pierrotto12138-code/balance-car-inspection-robot/hardware/eda_export_20261016/README.md

# EDA 制造 / 交付数据（2026-10-16 一次性导出）—— 角色 A1

> **来源**：嘉立创EDA 专业版（工程 `26测控系统设计`，板 `改` = `Schematic2` + `PCB2`）在 **2026-10-16 16:36–16:41**
> 一次性导出的一整套文件，**入档时逐个核对哈希**。
> ⚠️ **本目录是"脱敏版"**：凡含**组员姓名**的文字/图形都已处理（打码 / 删除文本实体 / 等长替换），见 §四；
> **未脱敏原件**在仓库外 `…\260921Task_私有资料\作业补充\A1\_未脱敏原件\`（提交作业用）。
> **与 [`../gerber/`](../gerber/) 的关系**：那里放**下单用的那份 Gerber**（脱敏）；本目录是"同一设计再导出的一整套标准交付/制造格式"，
> 重点是**给人看/给别的角色用**的那几种（PDF/PNG、STEP、DXF、iBOM、坐标、BOM）。

---

## 一、文件清单与"谁能用得上"

| 文件 | 是什么 | **谁能用** | 关键点 |
|---|---|---|---|
| [`Info_PCB_PCB2_2026-10-16.txt`](Info_PCB_PCB2_2026-10-16.txt) | **EDA 自己出的板信息报告** | **A1/A2/评阅** | ★ **"板子尺寸: 100mm x 65mm"** —— 板框口径的**第 5 路独立证据**；另含元件 52、焊盘 221（表贴 106/金属化孔 115）、网络 65（未布线 0）、过孔 76、铺铜 2、导线总长 2035.9 mm |
| [`SCH_Schematic2_2026-10-16.pdf`](SCH_Schematic2_2026-10-16.pdf)（265 KB） | ★ **原理图出图（PDF，矢量）** | **A1 交付 / 报告 / 答辩 / B 核对网络** | **任务书要的"电路原理图"的可读版**（此前只有 EDA 二进制 `.esch2`）。标题栏：原理图 `Schematic2` / 板子 `改` / 创建 2026-10-07 / 更新 2026-10-16；**绘制/审阅栏为空 = 无个人信息**（已核）|
| [`SCH_Schematic2_1-P1_2026-10-16.png`](SCH_Schematic2_1-P1_2026-10-16.png)（773 KB）、[`SCH_Schematic2_1-P1_2026-10-16.svg`](SCH_Schematic2_1-P1_2026-10-16.svg)（427 KB） | ★ **同一页原理图的位图 / 矢量图** | 报告插图（矢量图放大不糊）| 导出源是 `Schematic2_1`（`Schematic2` 的工作副本，**同一块"改"板**；标题栏亦写 `Schematic2`）；**无个人信息**（已核）。若要严格"出图源 = `Schematic2`"，可让 A1 再导一次覆盖 |
| [`PCB_PCB2_2026-10-16_脱敏.png`](PCB_PCB2_2026-10-16_脱敏.png)、[`PCB_PCB2_2026-10-16_脱敏.pdf`](PCB_PCB2_2026-10-16_脱敏.pdf) | **PCB 出图**（图片 / 图片型 PDF） | **A1 交付 / 报告插图 / A2 参考** | 人可读、不必装 EDA；★ **丝印文字块已打码**（姓名不可见）。PDF 由打码后的 PNG 生成（原矢量 PDF 在仓库外）|
| [`Gerber_PCB2_2026-10-16.zip`](Gerber_PCB2_2026-10-16.zip) | Gerber（本次导出） | A1 / 制板复现 | 与 [`../gerber/26测控系统设计_PCB2_20261008_170436.zip`](../gerber/26测控系统设计_PCB2_20261008_170436.zip) 同源；**下单用的是 10-08 那份**；★ 本次导出的 GTO 同样已脱敏 |
| [`FlyingProbeTesting_PCB2_2026-10-16.zip`](FlyingProbeTesting_PCB2_2026-10-16.zip) | 飞针测试点数据 | A1 / 制板 | 嘉立创可据此做飞针测试 |
| [`IPC_PCB2_26测控系统设计_2026-10-16.356a`](IPC_PCB2_26测控系统设计_2026-10-16.356a) | **IPC-356A 网表**（电气测试用） | A1 / 制板 | 与飞针配套的"该通/该断"清单 |
| [`Netlist_PCB2_2026-10-16.tel`](Netlist_PCB2_2026-10-16.tel) | 网表 | **B（核对引脚/网络）**、A1 | 与 [`../../docs/design_hardware/pin_assignment.md`](../../docs/design_hardware/pin_assignment.md) 可三方互证（源码 / PCB `PAD_NET` / 本网表）|
| [`BOM_改_PCB2_2026-10-16.xlsx`](BOM_改_PCB2_2026-10-16.xlsx) | EDA 导出的 BOM | **A1**、采购 | 与 [`BOM表.md`](../../docs/design_hardware/BOM表.md)（脚本离线导出）**互为独立实现** ⇒ 两者一致才敢下单 |
| [`PickAndPlace_PCB2_2026_10_16.xlsx`](PickAndPlace_PCB2_2026_10_16.xlsx) | **贴片坐标**（位号 + X/Y + 层 + 旋转）| A1 / 若将来上 SMT | 本板手焊（`isMadeSmt=false`），此件属留档 |
| [`TestPoint_PCB2_2026-10-16.xlsx`](TestPoint_PCB2_2026-10-16.xlsx) | 测试点表 | A1 | 与 `Info_*.txt` 里"测试点覆盖率 0%"对应（本板未专门放测试点）|
| [`InteractiveBOM_PCB2_2026-10-16.html`](InteractiveBOM_PCB2_2026-10-16.html) | **交互式 BOM**（网页版，点击位号高亮位置）| **A1 焊接 / A2 装配 / 排故** | ★ 手焊与查错时最顺手：浏览器打开即可"按图找件"（12 MB，内嵌器件图与封装图形；**不含丝印文字**，已核对）|
| [`DXF_PCB2_2026-10-16_AutoCAD2007.dxf`](DXF_PCB2_2026-10-16_AutoCAD2007.dxf) | **2D 外形/结构 DXF** | **A2（结构）** | ★ 做**装配图 / 外壳开孔**的二维输入：板框 100 × 65、R5 圆角、3 个 ⌀3.2 安装孔可直接量；★ **含姓名的 TEXT 实体已删除**，几何完整 |
| [`3D_PCB2_2026-10-16.step`](3D_PCB2_2026-10-16.step) | **3D STEP 模型**（整板 3D）| **A2（结构）** | ★ A2 做**外壳 / 干涉检查 / 效果图**的三维输入（31 MB，`Designed by EasyEDA Pro`，Open CASCADE / AP214；**不含丝印文字**，已核对）|
| [`ProPrj_26测控系统设计_2026-10-16.epro2`](ProPrj_26测控系统设计_2026-10-16.epro2) | **立创EDA 工程导出包**（可再导入）| A1 / 交作业 | 一个文件即可在另一台机器导入整个工程（内含 `26测控系统设计.epru`）；★ 工程内文字对象里的姓名已**等长替换**为"组员/组员甲/乙/丙" |

> **仓库外的同批文件**（按 §四 策略移出，**不要**拷进公开仓库）：
> `嘉立创生产稿_8942344A_Y2_未脱敏.zip`、`odb++_pcb_2026-10-16_未脱敏.tgz`、`PCB_PCB2_2026-10-16_未脱敏.pdf`，
> 以及含姓名/电话/地址的 `立创商城下单.png`、`送货单-1.pdf`、`送货单-2.pdf`、`立创商城订单详情-SO26101014446.xls`。
> 位置：`…\260921Task_私有资料\作业补充\A1\`（脱敏前后对照的同名 `_未脱敏*` 件在 `…\A1\_未脱敏原件\`）；
> 其中**非个人信息**的部分已摘录进 [`../bom/采购记录_立创商城_SO26101014446.md`](../bom/采购记录_立创商城_SO26101014446.md)。

> **原理图导出已补齐（2026-10-16 17:07 追加）**：`SCH_Schematic2_*.pdf` / `.png` / `.svg` —— 三件都在本目录，
> 均**不含个人信息**（标题栏"绘制/审阅"为空，已逐件核对）。至此"任务书 §二 A1：电路原理图"既有 EDA 工程源文件、
> 也有**人可读出图**。

---

## 二、这批导出对其它角色的意义（一句话备注）

| 角色 | 直接可用的文件 | 拿来做什么 |
|---|---|---|
| **A2 结构** | **`3D_*.step`** + **`DXF_*.dxf`** + `Info_*.txt` | 外壳建模、装配图、开孔（板框 100 × 65 / R5 / 3×⌀3.2 孔都能直接量）、干涉检查 |
| **B 固件** | `Netlist_*.tel`、`BOM_*.xlsx`、`IPC_*.356a` | 核对引脚与网络（与源码/`pin_check.py` 互证）、确认板上有哪些器件 |
| **C 上位机** | `PCB_*_脱敏.png`（界面/文档配图）、`BOM_*.xlsx` | 报告配图、器件清单引用 |
| **全组** | `InteractiveBOM_*.html`、`PCB_*_脱敏.pdf` | 排故、答辩讲解、交作业的可读附件 |

---

## 三、取材与溯源

| 项 | 位置 |
|---|---|
| 本目录 13 个脱敏件 | `hardware\eda_export_20261016\` |
| 未脱敏原件（提交作业用） | `…\260921Task_私有资料\作业补充\A1\_未脱敏原件\`（含生产稿、ODB++、矢量 PDF、未打码图、未脱敏 DXF/epro2 等）|
| 设计源头（EDA 工程） | `%USERPROFILE%\Documents\LCEDA-Pro\projects\26测控系统设计\`（另有 `参考01_copy` 工作工程）|
| 本地快照（被 gitignore） | [`../硬件工程_完工版_20261008_最终/`](../硬件工程_完工版_20261008_最终/) |
| 下单 Gerber 与工艺参数 | [`../gerber/`](../gerber/)（含 **1.6 mm / 1 oz / 有铅喷锡**）|
| 焊接与测试记录 | [`../../docs/design_hardware/上板测试记录.md`](../../docs/design_hardware/上板测试记录.md)、[`../test_records/`](../test_records/) |

---

## 四、★ 隐私处理（**脱敏双份**策略）

**策略**（用户 2026-10-16 明确）：**凡含组员个人信息的交付物，一律两份 —— 仓库放"脱敏版"，仓库外放"原件"（提交作业用）**。
本目录各件的处理方式与验证手段：

| 脱敏件 | 处理方式 | 验证 | 未脱敏原件 |
|---|---|---|---|
| `PCB_PCB2_2026-10-16_脱敏.png` | 丝印文字块**马赛克**（区域 (205,1255)-(715,1435)，块 34 px）| 目视复核（姓名不可读）| `_未打码原图\PCB_PCB2_2026-10-16_未打码.png` |
| `PCB_PCB2_2026-10-16_脱敏.pdf` | 由**已打码 PNG** 生成图片型 PDF（A4 横向）| 用 LibreOffice/pdfium 渲染回图片目视复核 | `_未脱敏原件\PCB_PCB2_2026-10-16_未脱敏.pdf` |
| `Gerber_PCB2_2026-10-16.zip` | GTO 丝印层移除姓名文字块笔画（4523 点）| **逐行比对**：非姓名行 2732 行完全一致 + bbox 内剩余点 = 0 | `_未脱敏原件\Gerber_PCB2_2026-10-16_未脱敏.zip` |
| `DXF_PCB2_2026-10-16_AutoCAD2007.dxf` | 删除含姓名的 `TEXT` 实体（1 个，其余几何全保留）| 全文再搜姓名为 0 命中 | `_未脱敏原件\DXF_…_未脱敏.dxf` |
| `ProPrj_26测控系统设计_2026-10-16.epro2` | 工程内姓名**等字节长度**替换为"组员/组员甲/乙/丙"（8 处）| zip 完整性 ok + `.epru` 字节数不变（2345729 B）+ 姓名 0 命中 | `_未脱敏原件\ProPrj_…_未脱敏.epro2` |
| `InteractiveBOM_*.html`、`3D_*.step`、`Netlist_*.tel`、`IPC_*.356a`、`FlyingProbeTesting_*.zip`、`BOM_*.xlsx`、`PickAndPlace_*.xlsx`、`TestPoint_*.xlsx`、`Info_*.txt` | **无需处理** | 多编码（UTF-8/GBK/UTF-16）全文检索姓名 **0 命中** | —（同一文件，无未脱敏版本）|
| **不在本目录**：`odb++_pcb_2026-10-16.tgz` | 内含丝印几何、**未脱敏** ⇒ 整体留仓库外（与 Gerber 同数据的另一格式）| — | `_未脱敏原件\odb++_pcb_2026-10-16_未脱敏.tgz` |

> **原件哈希、以及另一个目录（`hardware/gerber/`）里同类处理的完整清单**，统一记在
> [`../gerber/README.md`](../gerber/README.md) §八（含 SHA-256 前 16 位，便于"这份脱敏件对应哪个原件"对账）。

---

> **项目归属**：中国石油大学（华东） 专业生产实习课程项目<br>
> **范围说明**：本项目不涉及 MiniBalance 控制板（STM32F405RGT6 版本）的硬件设计与改版；控制板直接沿用，A1 仅重做主底板。<br>
> **许可**：原创代码与文档采用 MIT License；第三方组件遵循各自原始许可证。
