pierrotto12138-code/balance-car-inspection-robot/hardware/gerber/README.md

# Gerber / 制造数据（主底板「改」板）—— 角色 A1 交付物

> **对象**：MiniBalance V5.0 平衡小车**重做的底板**（EDA 里的板「改」= `Schematic2` + `PCB2`）
> **为什么在这里**：任务书 §二 要求 A1 提交"电路原理图、PCB 设计文件"，项目计划书另列 **Gerber**；
> 本目录把**下单用的那份**留档进仓库，避免"只存在于打样网站账号里"。
> ⚠️ **本目录放的是"脱敏版"**：丝印层里含**组员姓名**的笔画已被移除（见 §八）。
> **提交作业用的未脱敏原件**在仓库外 `…\260921Task_私有资料\作业补充\A1\_未脱敏原件\`。

---

## 一、文件

| 文件 | 出处 | 内容 | 用途 |
|---|---|---|---|
| [`26测控系统设计_PCB2_20261008_170436.zip`](26测控系统设计_PCB2_20261008_170436.zip)（**脱敏版**，141 KB） | **嘉立创EDA 专业版"一键导出 Gerber"**（导出时间 2026-10-08 17:04:35，工程名 `26测控系统设计`） | 14 项：9 个 Gerber 层（GTL/GBL/GTO/GBO/GTS/GBS/GTP/GKO/GDL/GDD）+ 2 个钻孔档 + **飞针测试点 `FlyingProbeTesting.json`** + `PCB下单必读.txt` | **★ 这是下单用的那一份**（与嘉立创工程档里的 `pcbFileName` 同名同源）；交作业的"Gerber"即此件 |

> **本目录不含"嘉立创生产稿"**：那份 9.4 MB 的生产包（`ok/` + `YG/4te.json`）里的丝印层同样含组员姓名，
> 且其内部还有 `.tgz`/`.ddw` 套封，**无法可靠脱敏** ⇒ 按隐私策略**整体留在仓库外**（原件与哈希见 §八）。
> 它提供的信息（**工艺参数**、生产口径钻孔对照）已逐项摘录到本文件 §三/§五，**结论不受影响**。

---

## 二、下单信息（可核对）

| 项 | 值 | 出处 |
|---|---|---|
| 工程/订单号 | **`8942344A_Y2`**（板上丝印亦为 `8942344A_Y2_261008`） | 生产包 `YG/4te.json` 的 `po`；实物丝印 |
| 下单时间 | **2026-10-08 17:28**（北京时间） | `4te.json` 的 `accountDate` |
| 交付时间 | **2026-10-10 20:00**（北京时间） | `achieveTime` |
| 制板费 | **¥53.00**（5 片，非 SMT 贴片） | `paiclMoney`、`isMadeSmt=false` |
| 软件/文件来源 | `softwareType = EasyEDA`，`pcbFileName = 26测控系统设计_PCB2_20261008_170436` | 同上 —— 与 §一 的 zip **同名同源** |
| 订单备注 | "本单 EasyEDA 设计，外形用 GKO 处理；元器件移植全额赔付" | `orderRemark` |
| 元件采购单 | 立创商城 **`SO26101014446`**（2026-10-10，17 项，商品 ¥71.07 + 运费 ¥17.00） | 见 [`../bom/采购记录_立创商城_SO26101014446.md`](../bom/采购记录_立创商城_SO26101014446.md) |

---

## 三、工艺参数（**权威出处：生产包 `YG/4te.json`，原件在仓库外**）

| 项 | 值 | 字段 |
|---|---|---|
| 板材 | **FR-4** | `board_type` |
| 层数 | **2 层** | `layers` |
| **成品板厚** | **1.6 mm** | `thickness` |
| **铜厚** | **1 oz**（内层 1.0 / 外层 1.0） | `cu_inner` / `cu_outer` |
| **表面处理** | **有铅喷锡**（HASL，有铅） | `finished` |
| 阻焊颜色 | **绿色** | `color_sm` |
| 丝印颜色 | **白色** | `color_ss` |
| 过孔处理 | **过孔盖油** | `via` |
| 板框尺寸（下单） | **10.0 × 6.5 cm** = **100 × 65 mm** | `size_x` / `size_y` |
| 拼版/阻抗/盲埋孔等 | 均未启用（`layeredFlag=false`、`blindViaHoleFlag=0`、`camImpedanceList=[]`） | 同上 |

> ★ 这三项（**板厚 1.6 mm、铜厚 1 oz、有铅喷锡**）此前在 [`../../docs/design_hardware/电路设计说明文档.md`](../../docs/design_hardware/电路设计说明文档.md) §10.1 是 `[待补]`，**现由本档闭合**。
> ⚠️ 表面处理是**有铅**喷锡（不是无铅）—— 报告与 BOM 表述按此写。

---

## 四、层清单（脱敏后的 zip）

| 文件 | 层 | 备注 |
|---|---|---|
| `Gerber_TopLayer.GTL` | 顶层线路 | |
| `Gerber_BottomLayer.GBL` | 底层线路 | |
| `Gerber_TopSilkscreenLayer.GTO` | 顶层丝印 | ★ **已脱敏**：移除了含组员姓名的文字块笔画（该块共 4523 个坐标点；其余 2730 行逐行核对与原件**完全一致**）|
| `Gerber_BottomSilkscreenLayer.GBO` | 底层丝印 | 空层（0 个坐标点）|
| `Gerber_TopSolderMaskLayer.GTS` | 顶层阻焊 | |
| `Gerber_BottomSolderMaskLayer.GBS` | 底层阻焊 | |
| `Gerber_TopPasteMaskLayer.GTP` | 顶层钢网 | 本板全手焊，仅作留档 |
| `Gerber_BoardOutlineLayer.GKO` | **板框外形** | 100 × 65 mm、四角 R5、3 个 ⌀3.2 安装孔（见 §五）|
| `Gerber_DocumentLayer.GDL` | 文档层 | 250 个坐标点，均不在姓名块内（未改动）|
| `Gerber_DrillDrawingLayer.GDD` | 钻孔图 | 钻孔标注图（非钻孔数据本身）|
| `Drill_PTH_Through.DRL` | **金属化孔（元件孔）** | 110 个元件孔（⌀0.9×14、⌀1.02×12、⌀1.1×84）|
| `Drill_PTH_Through_Via.DRL` | **过孔** | **76 个过孔**（⌀0.305×53、⌀0.508×23）|
| `FlyingProbeTesting.json` | 飞针测试点 | 嘉立创可据它做飞针测试 |
| `PCB下单必读.txt` | 说明 | EDA 自带的下单指引链接 |

---

## 五、可复核的几何数据（**独立解析本目录的 Gerber**，与 EDA 快照、嘉立创档多方一致）

| 项 | 结论 | 证据 |
|---|---|---|
| **板框** | **100.00 × 65.00 mm**（x ∈ [−6.000, 94.000]、y ∈ [−58.908, 6.092] mm，即 EDA 内部 mil 坐标 x ∈ [−236.22, 3700.79]、y ∈ [−2319.20, 239.85]）| ① `Gerber_BoardOutlineLayer.GKO` 外形坐标极值；② EDA 快照 `PCB2.epcb2` 的 `BOARD_OUTLINE` 路径极值；③ **嘉立创生产档 `ko`** + 下单尺寸 10.0 × 6.5 cm；④ **EDA 官方板信息报告**"板子尺寸: 100mm x 65mm"（[`../eda_export_20261016/Info_PCB_PCB2_2026-10-16.txt`](../eda_export_20261016/Info_PCB_PCB2_2026-10-16.txt)）|
| **四角圆角** | **R5.0 mm** | ① `GKO` 四段圆弧（radius 196.85 mil = 5.0 mm）；② 嘉立创 `ko` 的圆弧 `I/J = 196850`（10⁻⁶ 英寸 ⇒ 5.0 mm）|
| **安装孔** | **3 个 ⌀3.2 mm**（`BOARD_OUTLINE` 圆形图元，半径 62.9921 mil = 1.6 mm）<br>孔心（以板左下角为原点）：**(6.0, 6.1)、(94.0, 6.1)、(6.0, 58.9) mm** —— 即四角布局中**右上角无孔** | ① EDA 快照的 3 条 `path:["CIRCLE",…,62.9921]`；② `GKO` 的 Circle 段 3 个圆；③ 嘉立创钻孔档 ⌀3.25 mm × 3 孔，坐标 (94.0, 6.1) / (6.0, 6.1) / (6.0, 58.91)；④ PCB 渲染图逐孔核对 |
| 元件孔 / 过孔 | 110 个元件孔 + 76 个过孔（孔壁金属化） | `Drill_PTH_Through*.DRL` 逐刀具计数 |
| 走线 / 过孔 / 铺铜 | 523 走线段 / 76 过孔 / 双面实心 GND 铺铜 | 与完工快照的既有核验一致（[`../../docs/design_hardware/电路设计说明文档.md`](../../docs/design_hardware/电路设计说明文档.md) §10.2/§10.3）|

> ⚠️ **与旧文档的口径冲突（已更正）**：`电路设计说明文档` §10.1 与 `交接说明` §3.5 曾写"**100 × 60 mm、圆角 R2.5、4 个 ⌀1.6 mm 安装孔**"，
> 三处口径全错：尺寸把 y 跨度 65 读成 60、圆角把"圆形图元线宽 9.8425 mil"当成了弧半径、
> 孔径把 `path:["CIRCLE",x,y,**r**]` 的**半径** 62.9921 mil 当成了**直径**（1.6 mm 是半径 ⇒ ⌀3.2 mm），
> 孔数则把 4 条 `BOARD_OUTLINE` 记录（3 圆 + 1 个圆角矩形路径）数成了 4 个孔。
> 详见 [`../../docs/决策记录.md`](../../docs/决策记录.md) 决策 81 与 [`../../docs/design_hardware/上板测试记录.md`](../../docs/design_hardware/上板测试记录.md)。

### 嘉立创生产口径 vs EDA 设计口径（钻孔）

| 孔径 | EDA 导出（设计口径，**即本目录**） | 嘉立创 `ok/drl`（生产口径，原件在仓库外）|
|---|---|---|
| 过孔 | ⌀0.305 ×53、⌀0.508 ×23 = **76** | ⌀0.300 ×53、⌀0.500 ×23 |
| 元件孔 | ⌀0.900 ×14、⌀1.020 ×12、⌀1.100 ×84 = **110** | ⌀1.050 ×14、⌀1.150 ×12、⌀1.250 ×84 |
| 安装孔 | **⌀3.200 ×3**（画在外形层，走铣槽） | **⌀3.250 ×3** |
| 其它 | — | 还有**设计档里不存在**的 ⌀0.953 / ⌀1.451 / ⌀2.203 / ⌀2.651 等孔或铣槽（其文件大量使用**模态坐标**，逐孔用途未核对）——**判断"设计要几个孔"时只看 EDA 那份** |

> ⇒ **报孔径时用 EDA 设计口径**（本板元件孔径 0.9/1.02/1.1 mm），生产档的孔径是嘉立创归并到自家标准刀具后的结果。

---

## 六、怎么复现 / 重新导出

| 场景 | 做法 |
|---|---|
| 从 EDA 重新出 Gerber | 打开工程（`…\LCEDA-Pro\projects\26测控系统设计\`）→ 一键导出 Gerber，导出前**必须 `Ctrl+S`**（见 `AGENTS.md` 铁律 1/2）|
| 只想复核几何/网络，不装 EDA | 直接解析本目录的 zip（Gerber 是纯文本）；或解析完工快照 `hardware/硬件工程_完工版_20261008_最终/`（脚本见 [`../../tools/README.md`](../../tools/README.md)）|
| 核对板框/安装孔 | 解析 `Gerber_BoardOutlineLayer.GKO`：外形路径 + `Circle Start/End` 段的 3 个圆 |
| 核对钻孔 | 数 `Drill_PTH_Through.DRL` / `Drill_PTH_Through_Via.DRL` 的刀具表与命中数 |
| 再下一单 | 上传本目录的 zip（嘉立创支持 EDA 导出包），工艺按 §二/§三 选 —— ⚠️ 打出来的板**丝印上不会有组员姓名**（脱敏所致）；要带姓名的版本用 §八 的未脱敏原件 |
| 要"带姓名的完整原件" | 用仓库外 `…\260921Task_私有资料\作业补充\A1\_未脱敏原件\` 里的同名 `…_未脱敏.zip`（提交作业用）|

---

## 七、取材与溯源

| 项目 | 位置 |
|---|---|
| 本目录的脱敏 Gerber | `26测控系统设计_PCB2_20261008_170436.zip` —— **脱敏后 SHA-256 前 16 位 `19DA618BEDEE7DE5`**（原始件 `83352D2AF71EE3D0`，见 §八）|
| 未脱敏原件（提交作业用） | `…\260921Task_私有资料\作业补充\A1\_未脱敏原件\26测控系统设计_PCB2_20261008_170436_未脱敏.zip` |
| EDA 完工快照（设计源头） | [`../硬件工程_完工版_20261008_最终/`](../硬件工程_完工版_20261008_最终/)（`.eprj3` + `Schematic2` + `PCB2`，**被 gitignore，只在本机**）|
| 独立工程副本（交作业用） | `%USERPROFILE%\Documents\LCEDA-Pro\projects\26测控系统设计\` |
| 全套制造/交付导出（同日） | [`../eda_export_20261016/`](../eda_export_20261016/README.md) |
| 焊接与测试记录 | [`../../docs/design_hardware/上板测试记录.md`](../../docs/design_hardware/上板测试记录.md) |
| BOM 与采购记录 | [`../../docs/design_hardware/BOM表.md`](../../docs/design_hardware/BOM表.md)、[`../bom/采购记录_立创商城_SO26101014446.md`](../bom/采购记录_立创商城_SO26101014446.md) |

---

## 八、★ 隐私处理（**脱敏双份**策略，2026-10-16 定）

**策略**（用户 2026-10-16 明确）：**凡含组员个人信息的交付物，一律两份 ——
仓库里放"脱敏版"（供公开与协作），仓库外的 `260921Task_私有资料\作业补充\A1\_未脱敏原件\` 放"原件"（供提交作业）**。

| 仓库内的脱敏件 | 处理方式 | 未脱敏原件（仓库外） | 原件 SHA-256 前 16 位 |
|---|---|---|---|
| `26测控系统设计_PCB2_20261008_170436.zip` | GTO 丝印层**移除姓名文字块笔画**（4523 点），其余 2730 行逐行与原件一致 | `26测控系统设计_PCB2_20261008_170436_未脱敏.zip` | `83352D2AF71EE3D0` |
| [`../eda_export_20261016/Gerber_PCB2_2026-10-16.zip`](../eda_export_20261016/Gerber_PCB2_2026-10-16.zip) | 同上（该次导出同样处理） | `Gerber_PCB2_2026-10-16_未脱敏.zip` | `E15DDB03F4A28005` |
| （本目录不含）嘉立创生产稿 | **不可靠脱敏**（内含 `.tgz`/`.ddw` 套封）⇒ **整体留仓库外**；工艺参数已摘录进 §三 | `嘉立创生产稿_8942344A_Y2_未脱敏.zip` | `C0872833D86AFF16` |
| `…\hardware\photos\新版底板_*.jpg` | 丝印文字块**打码**（各图打码区坐标见 [`../photos/README.md`](../photos/README.md)）| `新版上车正面/俯视/背面.jpg`、`新版焊接重点处.jpg` | 见该 README |
| `…\docs\design_hardware\图\PCB2_最终.png`、`…\eda_export_20261016\PCB_PCB2_2026-10-16_脱敏.png` | 丝印文字块**打码**（马赛克） | `PCB2_最终_未打码.png`（`6E449B39D6D20F7F`）、`PCB_PCB2_2026-10-16_未打码.png`（`A969229ADED59987`）| 仓库内脱敏件：`64691358E7A4BCD6` / `A46FFADEC7EF0C29` |
| `…\eda_export_20261016\DXF_*.dxf` | **删除**含姓名的 `TEXT` 实体（保留全部几何）| `DXF_PCB2_2026-10-16_AutoCAD2007_未脱敏.dxf` | `C1077CEF1C4AB20C` |
| `…\eda_export_20261016\PCB_PCB2_2026-10-16_脱敏.pdf` | 由**已打码 PNG** 生成的图片型 PDF（页面内容同脱敏 PNG）| `PCB_PCB2_2026-10-16_未脱敏.pdf`（EDA 原始矢量出图）| `C2A9246D46A45608` |
| `…\eda_export_20261016\ProPrj_26测控系统设计_2026-10-16.epro2` | 工程内文字对象里的姓名**等字节长度替换**为"组员/组员甲/乙/丙"（8 处；`.epru` 字节数不变）| `ProPrj_26测控系统设计_2026-10-16_未脱敏.epro2` | `1ECA172AB47EF31F` |
| （本目录不含）`odb++_pcb_2026-10-16.tgz` | 内含丝印几何，**未脱敏** ⇒ 整体留仓库外（与 Gerber 同一套数据的另一格式）| `odb++_pcb_2026-10-16_未脱敏.tgz` | `4A6E7347A3019B18` |
| 含姓名/电话/地址的**订单与送货单** | **从不出现在仓库**（`立创商城下单.png`、`送货单-1/2.pdf`、`立创商城订单详情-SO26101014446.xls`）| 同上目录 | 见采购记录 §四 |

> **说明**：姓名在 Gerber/DXF/PDF 里是**图形或文本实体**（不是可搜索的元数据）——本表列的"脱敏"都是**逐个验证过**的：
> Gerber 用"逐行比对 + bbox 内剩余点=0"验证；DXF 用"全文再搜姓名为 0 命中"验证；epro2 用"zip 完整性 + 字节数不变 + 姓名 0 命中"验证。

---

> **项目归属**：中国石油大学（华东） 专业生产实习课程项目<br>
> **范围说明**：本项目不涉及 MiniBalance 控制板（STM32F405RGT6 版本）的硬件设计与改版；控制板直接沿用，A1 仅重做主底板。<br>
> **许可**：原创代码与文档采用 MIT License；第三方组件遵循各自原始许可证。
