pierrotto12138-code/balance-car-inspection-robot/hardware/photos/README.md

# 实物照片（`hardware/photos/`）—— 两批，别混用

> **本目录有两批性质完全不同的照片**：一批是**改板之前用来核对厂商原板**的（2026-09-22），
> 一批是**重做的底板打样回来、焊好、装车之后**的实拍（2026-10-16 入库）。
> A1 的交付证据（"焊接完成的实物板"）指的是**第二批**。

---

## 一、第二批：新版底板实拍（★ A1 交付证据）

拍摄于底板打样到货并焊接、装车之后；四张互补，覆盖"整车 / 焊接细节 / 顶视布局"。

| 文件 | 视角 | 看点 |
|---|---|---|
| [`新版底板_上车正面.jpg`](新版底板_上车正面.jpg) | 整车正前方 | 底板装车后的整机形态；`J1`/`J2` 60 针座上插着控制板；前方 HC-SR04 超声、左侧 MQ 气体模块（立柱抬高）；铜柱支撑 |
| [`新版底板_上车俯视.jpg`](新版底板_上车俯视.jpg) | 整车顶视 | **底板全貌**：电源区（`C1`/`C2` 220µF、`U2` LM2596、`L1` 330 电感、`SW2` 拨动开关、`J17` 电池座）、`J15` 2×6 座、右侧 `J2` 排座、`J18`(蜂鸣器)/`J9`(DHT11)/`J11`/`J14` 座、`J13`/`J10` MQ 座 |
| [`新版底板_上车背面.jpg`](新版底板_上车背面.jpg) | 整车后侧 | 底板背面与**焊点**、电池仓、电机线束 |
| [`新版底板_焊接重点处.jpg`](新版底板_焊接重点处.jpg) | 底板电源区特写 | **焊接重点件的近景**：`U1`(TB6612FNG，SSOP-24 引脚)、`U2`(LM2596S，TO-263)、`D1`(ES2D)、`C1`/`C2` 220µF/35V、`D2`~`D4` LED、`R1`~`R5`、`J15` 排座 —— 用来核"SSOP-24 有没有连锡/虚焊" |

### ⚠ 打码说明（隐私）

底板的**丝印**上有校名/组名/组员姓名（`J15` 旁的文字块）。本仓库是**公开仓库**，
按 `AGENTS.md` 的规定，**上述四张图中凡出现该丝印文字块的区域都做了马赛克处理**：

| 文件 | 打码区域（原图像素坐标，左上-右下） |
|---|---|
| `新版底板_上车俯视.jpg` | (840, 1755) – (1440, 1990) |
| `新版底板_上车背面.jpg` | (855, 835) – (1780, 1005) |
| `新版底板_焊接重点处.jpg` | (480, 3070) – (1610, 3410) |
| `新版底板_上车正面.jpg` | 未打码（该视角看不到丝印文字） |

> **未打码的原图**保存在仓库外：`…\260921Task_私有资料\作业补充\A1\新版上车正面/俯视/背面.jpg`、`新版焊接重点处.jpg`。
> 需要"丝印含姓名"的原图时从那里取，**不要**把原图放进本仓库。
>
> ★ **这是"脱敏双份"策略的一部分**（决策 83）：凡是含组员姓名的交付物（照片、PCB 渲染图、Gerber 丝印层、DXF、PDF、工程导出包）
> 一律**仓库放脱敏版 + 仓库外留原件**，且**两份成对登记哈希**。
> 完整清单（含各类件的脱敏手段、验证方式、原件 SHA-256）见
> [`../gerber/README.md`](../gerber/README.md) §八 与 [`../eda_export_20261016/README.md`](../eda_export_20261016/README.md) §四。

---

## 二、第一批：厂商原板核对照（2026-09-22，改板前）

**用途**：改板前逐项核对"车上这块板/这些模块到底长什么样"（座序、丝印、器件形态）。
**不是**本项目的作品，也**不是**改板后的实物。

| 文件 | 内容 |
|---|---|
| `1790078269895.jpg`、`1790078283359.jpg`、`1790078367419.jpg`、`1790078384616.jpg` | 车上**控制板**（STM32F405RGT6 + MPU6050 + CH340G）正反面与特写（可见 `C0 C15 C14 C13 3V3 GND` 的 OLED 座丝印）|
| `1790078508176.jpg` | **TB6612 拓展板**特写（SSOP-24 封装、`VM/VCC/GND` 丝印）|
| `1790078517444.jpg`、`1790078713292.jpg` | **电源稳压拓展板**（LM2596 + 电感 + 220µF）|
| `1790078728793.jpg`、`1790078829883.jpg` | **电压测量拓展板**（R1/R2/R3 + C1/C2，`L+`/`GND`）|
| `1790078838479.jpg` | 底面丝印 `GND / OUT / 7-13V / GND` 特写 |
| `f405rgt6拓展板正面背面(1).pdf`、`tb6612拓展板正面背面(1).pdf`、`电压测量拓展板正面背面(1).pdf`、`电源稳压拓展板正面背面(1).pdf` | 四块拓展板的正面/背面扫描件（实验室资料）|

> 文件名是**拍摄时间戳**（毫秒）而非描述，因此保留原名不改，靠本表对照。
> 相关结论见 [`../../docs/design_hardware/car_composition.md`](../../docs/design_hardware/car_composition.md)（整车三层解析）
> 与 [`../../docs/design_hardware/pin_assignment.md`](../../docs/design_hardware/pin_assignment.md)（逐脚引脚表）。

---

## 三、其它

- 原理图/模块图纸 PDF 在 [`../schematic/`](../schematic/)；4 块拓展板 PDF 同时存于本目录（实验室给的扫描件）。
- 新版底板的 **Gerber**（含丝印层）在 [`../gerber/`](../gerber/)。
- 新版底板的 **焊接与上板测试记录**在 [`../../docs/design_hardware/上板测试记录.md`](../../docs/design_hardware/上板测试记录.md)。
- 底板渲染图（非照片）：[`../../docs/design_hardware/图/PCB2_最终.png`](../../docs/design_hardware/图/PCB2_最终.png)。

---

> **项目归属**：中国石油大学（华东） 专业生产实习课程项目<br>
> **范围说明**：本项目不涉及 MiniBalance 控制板（STM32F405RGT6 版本）的硬件设计与改版；控制板直接沿用，A1 仅重做主底板。<br>
> **许可**：原创代码与文档采用 MIT License；第三方组件遵循各自原始许可证。
