pierrotto12138-code/balance-car-inspection-robot/docs/design_mechanical/A2_结构设计说明_初稿.md

# A2-11 结构设计说明（初稿 v1.0）

> **角色**：A2（结构）　｜　**日期**：2026-10-17　｜　**状态**：初稿，未标注处为**待确认**
> **依据**：`A2-10_整车装配_A2_v1.0_20261017.step`（253 实体 / 185,785 面）＋ SolidWorks 原色截图（正面/背面/左/右/俯视）
> **说明**：本稿只写能从模型/现有接口数据直接确认的内容；壁厚、公差、材料、开孔位置等**未实测项一律标 `[待确认]`**，不估算。

---

## 1. 任务与范围

A2 负责整车的结构方案、外观与人机界面、装配图与 3D 打印件。本文对应**整车装配**（底盘 + 轮组 + 电池 + 主控板 + 传感器/模块 + 外壳），不含电路原理与固件实现。

## 2. 坐标系与接口（与 A1/B/C 统一）

| 项 | 值 | 出处 |
|---|---|---|
| 基准 | **板左下角为原点，板面为 z = 0，元件面 +z** | A1/A2 统一口径 |
| 板框 | **100.00 × 65.00 mm，四角 R5.0，板厚 1.6** | `A2_接口坐标表_20261016.csv` |
| 安装孔 | **3 × ⌀3.2**，孔心 (6.0, 6.1) / (94.0, 6.1) / (6.0, 58.91)，跨距 **88.00 × 52.81**（对角 102.63）| A1 实测 |
| 第 4 孔 | 厂商原板 PCB1 有，改板取消；壳底留 Φ8 让位 | `A2_底盘接口对照图` |
| 单位 | mm | — |

> ⚠ 本 STEP 的**全局坐标原点不在板左下角**（网格中板面约在 z = −26.4），引用尺寸时以"板左下角 + 板面"重新定位，不要直接抄 STEP 全局坐标。

## 3. 总体尺寸与布局

| 项 | 值 | 说明 |
|---|---|---|
| 整车包围盒 | **181.0 × 134.5 × 90.5 mm**（X × Y × Z）| 网格顶点实测，含轮组 |
| 车轮 | **Φ65 × 27 mm**，两轮共轴（轴沿 X）| 两轮中心 x = −33 / 121，**轮距 154 mm**（外宽 181）|
| 电池包络 | **94.5 × 28.5 × 13.2 mm** | 与 `1900mah` 件一致 |
| 主控板 | **100 × 65 × 1.6 mm** | 水平置于腔内 |
| 外形特征 | **MiniBalance R1 通用车架** + 两侧轮组 + 前部传感器/模块；**无完整外壳** | 见六视图 |

**布局要点**

- 两轮共轴、装在车架两侧（±X）；前进方向按 **+Y**（以模型实际朝向为准，`[待确认]`）。
- 电池低位、居中偏后，降低重心。
- 主控板水平放在车架中下部，板上器件朝上；OLED/按键面朝上。
- 气体传感器（MQ）、超声波、DHT11、蓝牙分布在车架前部/侧部，需保证进气与声路不被遮挡。

## 4. 外壳

> **A2 确认（2026-10-17）：上下壳缺失。** 当前 STEP 只有 **MiniBalance R1 通用车架** + 电控 + 轮组；SolidWorks 截图中的透明圆角壳体是**参考件/包络**，不是本组设计的打印外壳。
> 因此本稿**不给出下壳/上盖尺寸，也不出外壳零件图/STL**。

| 项 | 现状 |
|---|---|
| 上下壳 | **未建模（缺失）** |
| 车架 | **MiniBalance R1 通用车架**（`Bottom` / `Top` / `Core` 等车架件）|
| 参考外壳 | 截图中的透明圆角壳体，仅用于看内部布局，**不作为交付** |
| 后续 | 若要做外壳，需先建下壳/上盖，再按"在对应位置开框"开孔 |

## 5. 装配与紧固

| 项 | 现状 |
|---|---|
| 板固定 | 3 × M3（穿过板 ⌀3.2 孔），柱高按板下净空 `[待确认]` |
| 上下壳 | **缺失**，无对拧结构（若后续补壳，按四角 M3 设计）|
| 轮组 | 两轮共轴，电机/轮轴固定方式 `[待确认]` |
| 电池 | 包络盒/压条 `[待确认]` |
| 拆装 | 换 MQ 模块、拔插 OLED、换电池的拆装层级 `[待确认]` |

## 6. 人机界面（对应 `人机界面设计说明.md §7` 的 12 项）

> **A2 决定（2026-10-17）**：人机开孔**不逐项测量**，统一按"**在对应位置开框**"处理 —— 位置以对应器件中心为准，尺寸在打印前用卡尺复核；因此**不单独出开孔坐标表**。

| # | 项 | 处理方式 |
|---|---|---|
| 1 | OLED 视窗 | 在对应位置开框 |
| 2 | 视窗与屏面 | 在对应位置开框；透明片/遮光不做要求 |
| 3 | OLED 固定 | 在对应位置开框；固定方式不做要求 |
| 4-5 | USER 按键 | 在对应位置开框（RESET & USER）|
| 6 | 蜂鸣器出声孔 | 在对应位置开框 |
| 7 | LED 导光 | 在对应位置开孔 |
| 8 | 丝印/标识 | 不做要求 |
| 9 | 气体进气 | 在对应位置开框/格栅 |
| 10-11 | 维修与公差 | 不做逐项公差；打印前复核 |
| 12 | 面板基准 | 板左下角 + 板面 |

> 原色俯视截图中保留了"此处应有按键 RESET&USER"的注记；按上述决定，**不落具体尺寸，只在对应位置开框**。

## 7. 材料与工艺（建议值，非实测）

| 件 | 建议 | 依据 |
|---|---|---|
| 车架（MiniBalance R1）| 成品/加工件（`[待确认]`）| 模型为通用车架 |
| 上下壳 | **未建模，不打印** | A2 确认 2026-10-17 |
| 轮 | 成品轮/打印轮（`[待确认]`）| 模型为 Φ65×27 |
| 紧固 | M3 不锈钢螺钉 + 铜柱 | 与 3 安装孔/四角柱一致 |
| 电池 | 18650 1900 mAh 组 | 模型 `1900mah` |
| 主控板 | FR-4 1.6 mm | A1 改板 |

## 8. 验证计划

> **A2 确认（2026-10-17）：仅理论设计，不做实物打印/试装**（课程内大家均未做实物）。下表只保留可离线完成的检查。
>
> **★ 2026-10-26 补充**：**仅作为作业提交的要求完成，未实际验证，大概率不支持落地**（即作者在这里有点糊弄，**你直接打印这个建模肯定不行**）——整机 STL 是单网格、上下壳未建模，无壁厚/公差/收缩补偿验证，也没有试印与装板记录。

| 项 | 方法 | 状态 |
|---|---|---|
| 孔位 | 3 安装孔跨距 88.00 × 52.81 与板对照 | ✅ 数据一致 |
| 干涉 | 离线几何求交（11 对关键件，不含公差）| ✅ 无穿透；PCB↔箱体 0 mm/712.94 mm³ 共面、模块 246↔箱体 0.69 mm 偏紧（`检查/`）|
| 试印 | — | —（不要求实物）|
| 装板 | — | —（不要求实物）|
| 强度/散热 | — | —（不要求实物）|

## 9. 遗留问题（按优先级）

1. **上下壳缺失**：当前 STEP 只有 MiniBalance R1 通用车架 + 电控 + 轮组；截图中的透明外壳是参考件，不是本组设计。
2. **人机开孔**：已按"在对应位置开框"处理，不逐项测量、不出坐标表。
3. **零件图/总装图**：不要求 SW `.SLDDRW`；已出 **A3 装配图 PDF 初稿**（原色四视图 + 明细栏草表 + 标题栏），零件图因上下壳缺失暂不出。
4. **明细栏**：已有 16 行草表，件号需与 SW BOM 对齐。
5. **爆炸图**：未做；需先定拆卸方向。
6. 本 STEP 的**装配原点**与"板左下角 + 板面"口径需在 SW 中复核（仅影响出图，不影响渲染）。

---

> **附**：渲染与网格数据见 `hardware/mechanical/A2-10_整车装配_20261017/README.md`；
> 交付清单与缺口见同目录 `00_A2_交付物清单（对照任务书）.md`；
> 原色六视图在仓库 `渲染/A2-10_整车_六视图_原色_20261017.png`（私人提交同名）。

---

> **项目归属**：中国石油大学（华东） 专业生产实习课程项目<br>
> **范围说明**：本项目不涉及 MiniBalance 控制板（STM32F405RGT6 版本）的硬件设计与改版；控制板直接沿用，A1 仅重做主底板。<br>
> **许可**：原创代码与文档采用 MIT License；第三方组件遵循各自原始许可证。
