pierrotto12138-code/balance-car-inspection-robot/docs/design_firmware/architecture.md

# 固件架构设计（角色 B）

> 基线：`Base/高配版平衡小车附送资料（STM32F405RGT6）/MiniBalanceV5.0【高配版】平衡小车库函数版源码（卡尔曼滤波版）`
> 架构决策：**混合式** —— 平衡控制保留在中断中，其余功能进 FreeRTOS 任务
> 更新日期：2026-09-22（**实施情况见下**）

> 📌 **实施情况（2026-10-09）**：本设计已落地到 [`../../firmware/`](../../firmware/)，
> 交付文档见 [`程序说明文档.md`](程序说明文档.md)，执行日志与踩坑见 [`B阶段开工准备.md`](B阶段开工准备.md)。
> 实施中与本文档的两处**偏差已回写**：① §3.3 的"I2C 互斥量"结论被实测推翻（本板 OLED 是软件 SPI、IMU 才是软件 I2C，**不共总线**）；
> ② 中断与任务的共享资源实际按"能分开就分开"处理（ADC1 给中断、ADC2 给任务），细节见程序说明文档 §3.3。

---

## 一、为什么选混合式架构

### 1.1 基线的现状（读源码得出）

| 项目 | 现状 |
|---|---|
| 调度 | **裸机超级循环**，无 RTOS |
| 控制节拍 | 由 **MPU6050 的 INT 引脚触发外部中断**（`EXTI15_10_IRQHandler`），用 `Flag_Target` 交替出两个节拍 |
| 节拍分工 | **5 ms**：读姿态 + 读遥控 + 读电池；**10 ms**：读编码器 + 三环 PID + PWM 输出 |
| 姿态 | `Get_Angle(Way_Angle)`，`Way_Angle=2` 时为卡尔曼 |
| 主循环 | `while(1)`：刷新 APP/OLED 或跑 DataScope，靠 `delay_flag` 等中断给节拍 |

### 1.2 两个方案的取舍

| 方案 | 优点 | 风险 |
|---|---|---|
| **全面 FreeRTOS 化**（控制也进任务） | 架构统一，报告好写 | 控制节拍从**硬件中断**变成 **RTOS 节拍**，抖动变大；现有已调好的 PID 参数可能要重调；调试周期明显变长 |
| **混合式（选定）** | 平衡控制的时序**完全不变**，现有参数可直接沿用；新功能天然并发 | 中断与任务共享数据需加保护 |

**决策理由**：平衡车对控制时序极其敏感，而项目只有三周。**不拿已调好的平衡去冒险**，
把 FreeRTOS 用在它真正有价值的地方（气体采集、通信、状态机、界面这些可以并发等待的功能）。

---

## 二、任务划分

### 2.1 保留不动（中断上下文）

| 功能 | 周期 | 说明 |
|---|---|---|
| **控制中断** | 5 ms / 10 ms 交替 | `EXTI15_10_IRQHandler`：姿态读取、三环 PID、PWM 输出、异常保护 |

> **本部分原则上不改**，只在其中**新增**一件事：把姿态/速度等数据快照到共享结构体，
> 供任务读取（见第三节）。

### 2.2 新增 FreeRTOS 任务

| 任务 | 优先级 | 周期 | 职责 | 依赖 |
|---|---|---|---|---|
| **GasTask** | 中 | 1000 ms 常态 / 200 ms 异常 | 读双路 MQ 的 ADC、读 DHT11、温湿度补偿、超阈值研判、更新采样档位 | ADC、DHT11 |
| **CommTask** | 中 | 20 ms（上行）/ 200 ms（心跳） | 按协议组包上行状态、解包下行指令、入队分发 | USART2（蓝牙） |
| **TaskTask**（状态机） | 中 | 100 ms | 巡检阶段迁移、巡检点管理、避障决策 | 编码器、超声波 |
| **UiTask** | 低 | 100 ms | OLED 刷新、按键扫描、蜂鸣器报警 | OLED、KEY、蜂鸣器 |

> **注**：`TaskTask` 与基线已有的 `Bi_zhang`（避障/跟随模式）逻辑有重叠，改造时应融合而不是并列。

### 2.3 任务间通信

| 通道 | 类型 | 用途 |
|---|---|---|
| `xQueueGas` | 队列 | GasTask → CommTask（气体数据） |
| `xQueueCmd` | 队列 | CommTask → TaskTask（下行指令） |
| `xQueueEvent` | 队列 | 各任务 → CommTask（事件告警上行） |
| `g_state` | **共享结构体 + 临界区** | 控制中断 → 各任务（姿态、速度快照） |
| `xMutexI2C` | 互斥量 | 保护 MPU6050 与 OLED 的 I2C 访问 |

---

## 三、中断与任务的数据共享（关键）

这是混合架构**唯一的风险点**，必须处理好。

### 3.1 问题

控制中断每 5 ms 更新 `Angle_Balance`、`Gyro_Balance`、`Gyro_Turn` 等 **32 位 float**。
任务若在中断写这些变量时读取，可能读到**半更新**的值（高位旧、低位新）。

### 3.2 做法

```c
/* 控制中断内：更新快照（放在中断末尾） */
void snapshot_state(void)
{
    taskENTER_CRITICAL_FROM_ISR();
    g_state.angle   = Angle_Balance;
    g_state.gyro    = Gyro_Balance;
    g_state.gyroTurn= Gyro_Turn;
    g_state.encL    = Encoder_Left;
    g_state.encR    = Encoder_Right;
    g_state.volt    = Voltage;
    g_state.seq++;              /* 序号，供任务判断是否更新 */
    taskEXIT_CRITICAL_FROM_ISR();
}

/* 任务内：整块读取 */
StateSnapshot get_state(void)
{
    StateSnapshot s;
    taskENTER_CRITICAL();
    s = g_state;
    taskEXIT_CRITICAL();
    return s;
}
```

**要点**：
- 快照用**整块结构体**拷贝，不要逐个字段读（逐个读仍可能跨两个节拍）；
- 临界区**必须极短**（只做赋值），否则会拉长中断、破坏控制时序；
- 若某数据更新频率低（如电压），可加**序号**让任务判断是否为新值。

### 3.3 共享资源的互斥（**2026-10-09 按实板核实后重写**）

> ⚠️ **修正**：本节原写"MPU6050 与 OLED 共用软件 I2C，需要 `xMutexI2C`"。
> 经 `firmware/` 源码核实，**这块板子上两者根本不共总线**：
> · OLED = **软件 SPI**（`PC0`(DC) / `PC13`(SCL) / `PC14`(SDA) / `PC15`(RST)，见 `Drivers/BSP/OLED/oled.h`）
> · MPU6050 = **软件 I2C**（`PB10`(SCL) / `PB11`(SDA)，见 `Drivers/BSP/IIC/ioi2c.h`）
> 引脚完全不重叠，**不存在总线冲突**，因此**不需要 I2C 互斥量**。
> （原判断来自旧基底 F103C8T6——那版 OLED 走 I2C，所以确实冲突；换基底后结论已不适用。）

**P4 落地时真正需要保护的共享资源**（已在 `firmware/` 中实现，见 `App/Task/app_tasks.c`）：

| 共享资源 | 谁写 | 谁读 | 保护方式 |
|---|---|---|---|
| USART2 发送 | CommTask（协议帧）、UiTask（`printf`） | — | **互斥量**（`CommLink_LockTx/UnlockTx`），否则两条报文交错成乱码 |
| USART2 接收 | USART2 中断 | CommTask | **SPSC 环形缓冲**（中断只塞字节，任务取；无需关中断） |
| 姿态/编码器/电压全局量 | 控制中断（5/10 ms） | CommTask | **短临界区整块读取**（只用于上报/显示，不参与控制） |
| PID 参数（`Balance_Kp` 等） | CommTask（0x24 调参） | 控制中断 | **短临界区写入**；对齐 float 写在 Cortex-M4 上是单指令，原子 |
| ADC | 控制中断用 **ADC1**（PB1 电池） | GasTask 用 **ADC2**（PA5/PA6） | **物理分开**（见决策 43）—— 任务侧临界区挡不住高优先级中断，只能拆硬件通道 |
| OLED（软件 SPI） | UiTask | — | 仅一个任务访问，无需保护 |

**原则**：能"不共享"就不共享（ADC 拆通道、串口收发分离），
实在要共享的用最短的临界区或一个互斥量；**中断里绝不调用 RTOS API**（由
`tools/fw_prep/check_isr_safety.py` 静态核验）。

---

## 四、改造清单（对照基线代码）

| 模块 | 基线文件 | 改造动作 |
|---|---|---|
| 入口 | `USER/main.c` | 加入 `osKernelInitialize()` / `osKernelStart()`，把 `while(1)` 的内容移入任务 |
| 控制 | `MiniBalance/CONTROL/control.c` | **保留**；末尾加 `snapshot_state()`；PID 参数支持在线修改（协议 0x24） |
| 姿态 | `MiniBalance/filter/filter.c` | **保留**卡尔曼；不改 |
| 显示 | `MiniBalance/show/show.c` | 改为 UiTask 调用；显示内容需扩展（气体浓度、任务阶段） |
| 通信 | `MiniBalance/DataScope_DP/` | **保留**作调试通道；**新增**自研协议组包/解包模块 |
| 蓝牙 | `SYSTEM/usart/usart.c` | `fputc` 重定向需改为**任务安全的发送**；接收改为环形缓冲 + 状态机解帧 |
| 气体采集 | **无** | **新增** `App/Sensor/gas.c`：ADC + DHT11 + 补偿 + 研判 |
| 任务状态机 | **无** | **新增** `App/Task/patrol.c`：巡检阶段管理 |

---

## 五、代码目录（**2026-10-13 按实现更新**）

> 本节原本是"目录建议"，现已按真实落地的结构重写；**唯一的规范来源是
> [`编码规范.md`](编码规范.md) §一（分层与依赖方向）**，这里只列目录。

```
firmware/
├── Drivers/                   # FWLIB 标准外设库 + CMSIS + BSP（各外设驱动）
├── Middlewares/FreeRTOS/      # FreeRTOS V11.1.0 + GCC/ARM_CM4F 移植 + heap_4
├── System/                    # 厂商移植层：sys / delay（已改 DWT + 回调钩子）/ usart
├── App/
│   ├── Board/                 # ★ 新增：**App 访问厂商全局量的唯一出口**
│   │   └── board_state.c      #   Board_ReadRaw / Read|WriteVendorStop / Board_LedSet / PID 同步
│   ├── Config/                # app_config.h：所有"要按实测调整"的量集中在此
│   ├── Control/               # PID 三环（沿用基线）+ param_pack/param_store（调参持久化）
│   ├── Sensor/                # gas / dht11(+_hw) / sensor_adc / sensor_report / MPU6050 / DMP
│   ├── Task/                  # app_tasks（4 个任务）/ patrol（状态机）/ odom（里程）/ app_api.h
│   ├── Comms/                 # protocol / crc16 / ringbuf / comm_link / DataScope
│   ├── Filter/                # 卡尔曼 / 互补滤波（沿用基线）
│   └── Ui/                    # pages（自研页 1/2）/ show（厂商页 0）/ buzzer
└── User/                      # main.c 启动 + stm32f4xx_it.c + FreeRTOSConfig.h + rtos_hooks.c
```

**两条新增的架构约定**（P2 结构整改，都是"防止同一个东西有多个出口"）：

| 约定 | 内容 | 为什么 |
|---|---|---|
| **厂商量单一出口** | App 层只能通过 `App/Board/board_state.h` 访问厂商全局量；App 层**零 `extern`** | 否则"同一个全局量在 N 个文件里各自读" → 换板/换厂商要满仓库找 |
| **依赖单向** | `App → System/BSP`，底层不许回指上层；底层需要上层能力时用**回调注入**（`Delay_SetMsHook()`） | `delay.c` 原先 `extern App_SchedulerRunning()` 属于依赖倒挂 |

> **CRC-16 必须是同一份实现**：上位机侧已实现并通过测试（`host/src/protocol/crc16.cpp`），
> 固件侧照它翻译成 C，并用协议文档第 2.1 节的用例交叉验证。

---

## 六、安全机制（沿用基线已有的）

基线已实现，**必须保留**：

| 机制 | 位置 | 阈值 |
|---|---|---|
| 倾角保护 | `Turn_Off()` | 超过 ±40°（相对机械中值）关电机 |
| 低电压保护 | `Turn_Off()` | 低于 11.1V 关电机 |
| PWM 限幅 | `Xianfu_Pwm()` | ±8200（满幅 8400） |
| 积分限幅 | `velocity()` | ±10000 |
| 拿起检测 | `Pick_Up()` | 三步状态机 |
| 放下检测 | `Put_Down()` | 两步状态机 |

**需新增**：

- **通信失联保护**：500 ms 未收到下行帧 → 安全停车（协议第 5 节）；
- **预热期保护**：气体传感器预热未完成时，不上报浓度真值，只报状态位 → 避免误导。

---

## 七、待确认事项（2026-09-22 晚更新）

### 7.1 ✅ 已确认（不再是阻塞）

- [x] **上位机链路**：蓝牙走 USART2（PA2/PA3），两种常见蓝牙模块（HC-05/HC-06 类）实测均可正常使用
- [x] **MPU6050 走软件 I2C（PB10/PB11），INT=PB15** —— 实物丝印与源码 `IOI2C.h`/`exti.c` 一致
      → 因此 **MPU6050 与 OLED 的 I2C 互斥保护方案（第 3.3 节）成立**
- [x] **底板与控制板接口 = 60 针（2×15 ×2）**，可对插
- [x] **控制板主控为 STM32F405RGT6**
- [x] **用户 LED = PB13，用户按键 = PB14**（实物丝印与源码一致）
- [x] **气体传感器候选引脚**（NRF24L01 座已禁用）：PA5/PA6/PA7/PC4/PC5 五路 ADC 均可物理引出

### 7.2 ⬜ 仍需现场实测（**2026-10-15 更新：多数已收口**）

- [x] ~~**蓝牙模块能否改到 115200**（基线代码为 9600）~~ → ✅ **模块侧已确认 115200**（JDY-33 已配 115200；另一颗 DX-Smart 克隆是老式 HC-06 方言、**纯从机、改不了**）。⚠️ 但 **Windows 蓝牙 SPP 能配对、建不出 COM 口**，`pybluez2` 在 Python 3.13 上编译不过 ⇒ **联调主线改用有线（USART1）**，不再依赖蓝牙
- [x] ~~**超声波接口的实际引脚**~~ → ✅ 改板已定为 **`PC4`(TRIG)/`PB0`(ECHO)（`J5`）**，固件初始化与发脉冲两处都已改（真机测距可用）
- [x] ~~**车上现跑固件是否为原始版本**~~ → ✅ 不是原始版本，且**已被本项目固件取代**（`0x16` 偏移 19 的固件版本字节 `0xAF` 可直接验证"烧的哪一版"）
- [ ] **各插座的实际通断**（排针排母接触是否可靠）
- [ ] **MQ 的 `RL` 与清洁空气 `R0`**、**轮径/编码器线数**（影响 ppm 与 mm/s 的绝对精度；台架目前只有 MQ-135 且插在 `J13`）

### 7.3 已解除的阻塞（存档）

- ~~控制板是沿用原厂还是自研~~ → 车上已有完整控制板，**沿用**；A1 的交付物最终定为**重做底板**（单底板方案，不做传感器转接板 —— 转接板只是早期备选）
- ~~MPU6050 接哪组 I2C~~ → 已确认软件 I2C（PB10/PB11）
- ~~协议能否冻结~~ → **v1.1 已冻结**（决策 57）；**当前版本 v1.2**（两轮真机联调新增 `0x15`/`0x16`，纯增量）

---

## 八、变更记录

| 日期 | 内容 |
|---|---|
| 2026-09-22 | 初版：依据基线源码（卡尔曼版）与混合架构决策，确定任务划分、数据共享方案与改造清单 |
| 2026-10-13 | §五 由"目录建议"改写为**按实现的实际目录**，并补两条架构约定（厂商量单一出口 `App/Board/board_state`、依赖单向 + 回调注入 `Delay_SetMsHook()`）—— 决策 53 |

---

> **项目归属**：中国石油大学（华东） 专业生产实习课程项目<br>
> **范围说明**：本项目不涉及 MiniBalance 控制板（STM32F405RGT6 版本）的硬件设计与改版；控制板直接沿用，A1 仅重做主底板。<br>
> **许可**：原创代码与文档采用 MIT License；第三方组件遵循各自原始许可证。
