pierrotto12138-code/balance-car-inspection-robot/docs/design_firmware/B阶段开工准备.md

# B 阶段开工准备（固件）

> **用途**：B 阶段（STM32 固件）开工前的 **view + prepare 记录**。
> 当时硬件侧已下单等货（**本文写于 2026-10-09**），因此**B 全离线推进** —— 编译、静态核验、协议交叉验证都不依赖实物；
> 到货后只剩"烧录 + 联调"。**板子已于 2026-10-13 / 10-15 完成两轮真机联调**（见 [`真机联调问题清单.md`](真机联调问题清单.md)）。
> 日期：**2026-10-09** ｜ 角色：**B（程序）** ｜ 上游文档：[`architecture.md`](architecture.md)、[`../protocol/communication_protocol.md`](../protocol/communication_protocol.md)、[`../handoff/交接说明.md`](../handoff/交接说明.md)

---

## 一、结论速览（TL;DR）

> **📌 当前状态（2026-10-15 更新）**：**B 阶段的"离线可完成部分"已全部完成** ——
> P0~P4 落地（`firmware/` 可一键构建出 `.hex`，四任务已在镜像里）、P5 文档已产出
> （[`程序说明文档.md`](程序说明文档.md)），并做了**第二轮代码复查与接口完善**（§十五）
> 以及**两轮真机联调修正**（2026-10-13 / 10-15，决策 60~64，见 [`真机联调问题清单.md`](真机联调问题清单.md)）。
> **离线核验 9 项全通过**，占用 **Flash 约 66.5 KB / RAM 约 32.8 KB**。
> ⚠️ 本文档是**执行日志**：§十~§十五 里出现的数字是**当时的实测值**（例如 P0 时的 Flash 50 KB）；
> **当前值**见 §十五-15.4、`firmware/README.md` 与真机联调问题清单。

| 项 | 结论 |
|---|---|
| 本地能不能开发固件 | ✅ **能** —— CubeCLT 1.22.0 的 `arm-none-eabi-gcc 14.3` 已实测可构建 F405 镜像 |
| 没有 Keil 怎么办 | ✅ **不需要 Keil**（决策 34）：本地 **GCC + Makefile**，产物含 **`.hex`**，用板载 CH340G 走 **FlyMcu 串口 ISP** 烧录 |
| 基线源码能不能直接用 | ✅ **57 个源文件里 54 个 arm-gcc 直接编译通过**，只有 **3 处**要改（见 §三-2） |
| FreeRTOS 从哪来 | ✅ 官方 `FreeRTOS-Kernel` **V11.1.0** 可 clone，CM4F 的 GCC port 已实测编译通过，**决定 vendor 入库**（决策 35） |
| 协议能不能冻结 | ✅ **已冻结**（v1.1，决策 57）；**当前版本 v1.2**，由两轮真机联调新增 `0x15`/`0x16`（决策 60/64），**纯增量不改已有帧** |
| 固件做完没有 | ✅ **离线部分完成 + 两轮真机联调修正**：**Flash 约 66.5 KB / RAM 约 32.8 KB**；**离线核验 9 项全通过**（4 套原生单测共 **1,461 条断言** + `tune.py --selftest` + 交叉编译 + 向量表 + 中断安全 + 引脚基线）|
| 有无"必须等人/等货"的阻塞 | ❌ 已无等货阻塞（板子已到货并焊好）。剩余：**PID 整定**、问题清单 §3 的待修项（含 **`USE_RTOS=0` 当前编不过**）|

---

## 二、view：现状与基线（已核实）

### 2.1 仓库与角色

| 位置 | 现状 |
|---|---|
| `firmware/` | **空目录** —— B 的交付物将从零建立（README 里"固件工程"一直指向它） |
| `docs/design_firmware/architecture.md` | 架构设计已定：**混合式**（平衡控制留中断 + 其余进 FreeRTOS） |
| `docs/protocol/communication_protocol.md` | 协议 **v1.0（当时）** —— 现已升到 **v1.2**（v1.1 冻结 + `0x15`/`0x16` 增量，决策 57/60/64）|
| `docs/research/MQ气体传感器开源实现.md` | 气体算法参数已逐行核实（Rs/R0、ppm 幂律、清洁空气系数、补偿公式） |
| `host/` | C 的协议层已完成（`crc16.cpp` / `codec.cpp` / `frame.h`，13 项测试通过）——**B 侧必须与它逐字段对齐** |

### 2.2 固件基线（厂商源码，只读）

`Base/高配版平衡小车附送资料（STM32F405RGT6）/MiniBalanceV5.0【高配版】平衡小车库函数版源码（卡尔曼滤波版）`

| 项 | 实测值 |
|---|---|
| 工程格式 | **Keil 4**（`USER/Minibalance.uvproj`）+ **FWLIB 标准外设库**（非 HAL、无 `.ioc`、无 Makefile） |
| 调度 | **裸机超级循环**，无 RTOS |
| 控制节拍 | `EXTI15_10_IRQHandler()`（MPU6050 INT / PB15）用 `Flag_Target` 交替：<br>**5 ms 分支**：`Get_Angle` + 遥控 + 电池电压（100 次平均）→ `return`；<br>**10 ms 分支**：读编码器 + 超声波 + 直立/速度/转向三环 PID + PWM + 保护 + 按键 |
| 姿态 | `Way_Angle=2` → 卡尔曼 |
| 保护 | `Turn_Off()`（±40°、**电压 < 1110 即 11.10 V**）、`Xianfu_Pwm()`（±8200/8400）、积分限幅 ±10000、拿起/放下检测 |
| 参数掉电保存 | `STMFLASH`（`Flash_Read/Flash_Write`，地址 `0x08020000`）—— **0x24 在线调参可直接复用** |
| 文件编码 | **GBK**（不是 UTF-8）—— 直接改会造成中文注释乱码，需统一转码 |
| 编译器耦合 | `SYSTEM/usart/usart.c` 用 ARMCC 专有 `#pragma import(__use_no_semihosting)` / `_sys_exit` / `FILE`；`SYSTEM/sys/sys.c` 用 ARMCC 专有 `__asm void MSR_MSP()` |

### 2.3 开发环境与工具链（实测）

| 工具 | 状态 |
|---|---|
| `arm-none-eabi-gcc` | ✅ **14.3.1**（随 STM32CubeCLT 一起安装；**装在哪都行**，只要其 `bin` 在 `PATH` 上，或用 `make PREFIX=`、环境变量 `FW_ARM_BIN` 指定 —— 见 `tools/fw_prep/toolchain.py`） |
| `make` / `cmake` / `ninja` | ✅ 4.4 / 4.3.1 / 1.13（同在 CubeCLT） |
| `STM32_Programmer_CLI` | ✅ 2.23（可烧录/读回校验） |
| ST-Link 调试器 | ✅ 可借（决策 22），`STLink-gdb-server` 在 CubeCLT 内 |
| **Keil MDK** | ❌ **不使用**，且按决策 34 **不作为交付形态**（交付 = GCC 工程 + `.hex`） |
| STM32CubeMX | ⚠️ 已装于任意目录，**但本阶段不建议用** —— 见 §五 决策点 3 |
| 网络 | ✅ GitHub 可达（已实测 clone / raw 下载成功） |
| **烧录路径** | ✅ **控制板板载 `CH340G` + MicroUSB，且带 `DTR/RTS` 自动 ISP 电路**；串口接 **USART1 = `PA9`/`PA10`**（读控制板原理图 PDF 核实）。厂商资料里自带 **`FlyMcu`** 与 `OBJ/Minibalance.hex` → **"hex + FlyMcu 串口烧录"本来就是这块板子的原厂流程** |

### 2.4 构建产物与两种烧录方式（已定：**必须出 `.hex`**）

| 产物 | 说明 |
|---|---|
| `firmware/build/*.elf` | 调试/查符号、`arm-none-eabi-size` 看占用 |
| **`firmware/build/*.hex`** | **★ 默认产物** —— 用 `arm-none-eabi-objcopy -O ihex` 生成，起始地址 `0x08000000`，可直接给 FlyMcu |
| `firmware/build/*.bin` | 备用（部分烧录器/OTA 用） |
| `firmware/build/*.map` | 排查"Flash 装不下/RAM 溢出" |

| 烧录方式 | 做法 | 备注 |
|---|---|---|
| **① 串口 ISP（FlyMcu）** | 控制板 **MicroUSB** 线接电脑 → 选 CH340 虚拟串口 → 载入 `.hex` → 开始编程 | 板上 `DTR/RTS` 经 `Q1(8550)` 驱动 **BOOT0**，属**自动 ISP**：正常不用手动拨跳线；若进不去 BootLoader，再手动把 BOOT0 拉高后复位 |
| ② SWD（ST-Link） | `STM32_Programmer_CLI -c port=SWD -d firmware\build\xxx.hex -v` | 该命令行工具随 CubeCLT/CubeProgrammer 提供（实测 2.23），另有可借的 ST-Link；**下载后可 `-v` 校验**，更适合调 PID 时的反复烧录 |

> ⚠️ 用 ST-Link/SWD 时不要占 `PA13`/`PA14`；用串口 ISP 时 `PA9/PA10` 即被占用（原本是 DataScope 调试口，二选一）。

---

## 三、prepare：已完成的 4 项环境核验（可复跑）

> 复跑命令：`python tools\fw_prep\smoke.py`（只读基线源码，不改任何原始文件）

### 3.1 工具链冒烟：最小 F405 镜像能构建 ✅

自写 GCC 启动文件 + 链接脚本（`tools/fw_prep/startup_min.S`、`stm32f405rg_flash.ld`），
配合基线自带的 `USER/system_stm32f4xx.c`：

```
[OK] startup_min.S   [OK] system_stm32f4xx.c   [OK] main.c → 链接成功
text 152 B / data 0 B / bss 1544 B
[OK] arm-none-eabi-objcopy -> smoke.hex  485 B     ← 第 1 行 :020000040800F2（载入地址 0x0800:0000 ✅）
[OK] arm-none-eabi-objcopy -> smoke.bin  152 B
```

**含义**：CubeCLT 的 GCC + 基线 CMSIS 头 + 自写启动/链接 = 能出镜像，**且能直接出 `.hex`**。**本地开发路径打通。**

### 3.2 基线可编译性扫描：**只有 3 处**需要改造 ✅

对基线（剔除 `OBJ/`、`DMP/`、`system_stm32f4xx.c` 后的）共 **57 个 `.c` 文件**逐个用 arm-gcc 编译
（同样的 `-DSTM32F40_41xxx -DUSE_STDPERIPH_DRIVER`）：

| 结果 | 数量 | 文件 |
|---|---|---|
| 直接通过 | **54** | 含 `control.c` / `filter.c` / `MPU6050.c` / `oled.c` / `encoder.c` / `motor.c` / `adc.c` / `stmflash.c` / `timer.c` / `main.c` … |
| 失败 | **3** | `FWLIB/src/stm32f4xx_fmc.c`（**F405 无 FMC 外设**，本来就该剔除，非缺陷）<br>`SYSTEM/sys/sys.c`（ARMCC 专有 `__asm void MSR_MSP`）<br>`SYSTEM/usart/usart.c`（ARMCC 半主机 `#pragma import` + `_sys_exit` + `FILE`） |

> **意义**：把厂商裸机代码搬到 GCC 工具链的成本**极低**（2 个文件各改十几行，或直接用自己的重定向实现替换）。
> 这是"混合式架构 + 保留原 PID 代码"这一决策在**工具链层面的可行性证据**。

### 3.3 FreeRTOS：官方内核可获取且可编译 ✅

| 项 | 实测 |
|---|---|
| 来源 | `https://github.com/FreeRTOS/FreeRTOS-Kernel`（MIT），浅克隆 **V11.1.0** 成功 |
| 需要的文件 | `tasks.c queue.c list.c timers.c event_groups.c stream_buffer.c croutine.c`<br>+ `portable/GCC/ARM_CM4F/port.c` + `portable/MemMang/heap_4.c` |
| 编译结果 | **9/9 全部编译通过**（`-mcpu=cortex-m4 -mfpu=fpv4-sp-d16 -mfloat-abi=hard`） |
| 前提 | 需自备 `FreeRTOSConfig.h`（冒烟用的是极其精简的版本，**不是最终配置**） |

### 3.4 CRC-16/MODBUS：B 侧独立复算通过 ✅

用 **Python 从零实现**（不看固件、也不看 `host/src/protocol/crc16.cpp`，属"独立方法"）复算协议 §2.1：

| 用例 | 输入 | 期望 | 实算 | 结果 |
|---|---|---|---|---|
| 算法自检（标准） | ASCII `123456789` | `0x4B37` | `0x4B37` | ✅ |
| 用例 1 | `10` | `0x8CBE` | `0x8CBE` | ✅ |
| 用例 2 | `10 0C` | `0x750C` | `0x750C` | ✅ |
| 用例 3 | `10 0C 00` | `0x0575` | `0x0575` | ✅ |

> **协议 §七 的第一条冻结条件（B/C 各自实现 CRC 并用 §2.1 用例互验）B 侧已满足**，
> 待 C 侧确认即可冻结。脚本：`tools/fw_prep/check_crc.py`。

---

## 四、★ 引脚与接口基线（**以最终"改"板为准**，与源码的差异在末列）

> 原则：**底板/插座是权威**（实物丝印已核）；源码只作参考。凡与源码不一致的，固件必须按本表改。

| 模块 | 座 | 最终引脚（板上） | 与基线源码的差异 → 固件动作 |
|---|---|---|---|
| **MQ-2** | `J13` | AO→**PA5**（ADC1_IN5，经 `R10/R11` 10k/15k 分压 ×0.6）<br>DO→**PB3** | 源码无 → **新增 ADC 通道**；`PB3` 可作数字阈值输入（可选） |
| **MQ-135** | `J10` | AO→**PA6**（ADC1_IN6，经 `R12/R13` 分压 ×0.6）<br>DO→**PC3** | 同上 |
| **DHT11** | `J9` | **PA7**（`R14` 4.7k 上拉至 +3.3V） | 源码无 → 新增单总线驱动 |
| **HC-SR04** | `J5` | TRIG→**PC4**、ECHO→**PB0**（TIM3_CH3 输入捕获） | ⚠️ **源码 TRIG 是 PC2** → 必须改 `TIM3_Cap_Init()` 里的 GPIO 配置 |
| **蓝牙** | `J7` | **PA2/PA3**（USART2） | ⚠️ 源码 `uart2_init(9600)` → 改 **115200**（并去掉单字节 APP 解释） |
| **蜂鸣器** | `J18` | **PC5**，**有源、低电平响**（直连，不走 `Q1/BZ1`） | 源码用 `BZ1+Q1` 且极性相反 → **改为 GPIO 低电平触发**（决策 26） |
| **红外避障 L/R** | `J11`/`J14` | `PB12` / `PC1`（**DNP：留焊盘不装排针**） | 源码用的是 PA4 等 → **改为 PB12/PC1**，且**默认编译期关闭**（实物未装） |
| 电池电压 | — | **PB1**（ADC1_IN9，`R3/R2` 10k/1k 0.1%） | **不变**；`Voltage` 单位为 **0.01 V**，低压阈值 **1110 = 11.10 V** |
| MPU6050 | 控制板板载 | **PB10/PB11** 软件 I2C，INT→**PB15** | **不变**（控制中断源） |
| OLED | 控制板 6 针座 | `PC0`(DC)/`PC13`(SCL)/`PC14`(SDA)/`PC15`(RST)，**软件 SPI** | **不变**；与 MPU6050 **不共总线**（一个是软件 SPI、一个是软件 I2C） |
| 电机 / 编码器 | `CN1`/`CN2` | PA11/PA8 PWM、PA15/PB5、PA12/PB4、PA0/PA1、PB6/PB7 | **不变**（电机与编码器可原样插新板，固件电机部分不用改） |
| SWD | — | PA13/PA14 | **不可占用** |

**新增 ADC 通道的技术要点**（写代码前必须记住）：

1. 基线 `adc.c` 只做了 **PB1 单通道、非扫描、软件触发、采样时间 480 周期**；要读 3 路（PB1/PA5/PA6），
   最稳的做法是**保留单次转换 + 逐通道切 `ADC_RegularChannelConfig()`**，或改用**扫描 + DMA**。
2. **采样时间必须放长**（MQ 分压源阻抗 ≈ 6 kΩ）—— 480 周期已在基线用过，沿用即可。
3. 分压比 **0.6**，`3.3 V / 4096` 量化；MQ 的 `Rs` 用 `Rs = (VCC·RL)/Vout − RL`（`VCC=5 V`，**RL 必须实测**，默认 10 kΩ）。

---

## 五、★ 开工前需要拍板的决策点

> **2026-10-09 已拍板 2 条**（决策 34/35，见 [`../决策记录.md`](../决策记录.md)）：
> **① 构建形态 = 本地 `arm-none-eabi-gcc` + Makefile，产物必须含 `.hex`（FlyMcu 串口 ISP 烧录），Keil 交付暂不考虑；
> ② FreeRTOS 内核 V11.1.0 vendor 进 `firmware/Middlewares/FreeRTOS/`。**

| # | 决策点 | 结论 / 备选 | 影响 |
|---|---|---|---|
| **1** | **交付与构建形态** | ✅ **已定（决策 34）**：本地 **GCC + Makefile** 开发，**保证出 `.hex`**（配 FlyMcu）；~~Keil `.uvprojx`~~ **暂不考虑**（用户 2026-10-09 明确） | 日常可编译、可复跑核验；报告里只写 GCC 工具链，不必解释 Keil |
| **2** | **FreeRTOS 是否 vendor 入库** | ✅ **已定（决策 35）**：内核 **V11.1.0** 源码放进 `firmware/Middlewares/FreeRTOS/` | 离线可编译、版本可复现（MIT，约 1–2 MB 源码） |
| **3** | **是否用 STM32CubeMX** | 🔶 **建议不用**（待确认） —— 它生成 HAL 工程，与 FWLIB 基线混用会造成 RCC/中断向量/HAL 句柄两套体系并存；`docs/setup/开发环境准备清单.md` A1 写的"CubeMX 生成两个工程"**已与 FWLIB 基线决策不符**，该条应作废 | 决定要不要装 F4 固件包（约 1 GB 下载） |
| **4** | **红外避障的固件处置** | 🔶 **建议**：写驱动但**编译期默认关闭**（实物 `J11`/`J14` 是 **DNP，未装排针**） | 任务书写明"HC-SR04 **与红外模块**负责避障与循迹"——**报告里要说明"座已预留、模块未装"**，别让验收时对不上 |

> 另有 2 个**留给 B/C 会签**的小项（不阻塞开工）：
> ① `0x23` 的**双路告警阈值默认值**与 `ppm×10` 量程是否够（uint16 上限 6553.5 ppm）；
> ② `0x12` 阶段枚举与 `0x13` 事件码是否需要增补（如"返航完成""通信恢复"）。

---

## 六、B 阶段工作分解（建议顺序，每步都有**离线可验证**的产出）

| 步骤 | 内容 | 离线验收判据 |
|---|---|---|
| **P0 骨架** | ✅ **已完成（2026-10-09）** —— 见 §十：GCC 构建跑通、FreeRTOS V11.1.0 入库接入、向量表核验通过、`.hex` 就绪 | `make` 出 **`.elf / .hex / .bin / .map`**；`arm-none-eabi-size` 打印 Flash/RAM 占用；基线裸机版本也能编过；hex 可直接喂 FlyMcu |
| **P1 协议层** | ✅ **已完成（2026-10-09）** —— 见 §十一：`crc16.c` / `protocol.c`（帧编解码 + 状态机 + 超时）/ `ringbuf.c`，**原生测试 97 条断言全过** | 与协议 §2.1 四条用例逐条一致；与 `host/` 的 13 项测试**同源用例**对齐；**可在 PC 上跑纯 C 单元测试** |
| **P2 传感器** | ✅ **已完成（2026-10-09）** —— 见 §十二：`gas.c`（Rs/R0+补偿+标定+迟滞）/ `dht11.c`+`dht11_hw.c` / `sensor_adc.c` / `sensor_report.c`，**原生断言 1235 条全过** | 用**注入的假 ADC 值**在 PC 上跑算法，比对 Python 独立实现；边界值（0、满量程、超时）逐条过 |
| **P3 状态机** | ✅ **已完成（2026-10-09）** —— 见 §十三：`App/Task/patrol.c` 状态机 + **事件队列** + **500 ms 失联安全停车（锁存）**，**脚本化时间线原生测试 67 条全过** | 状态迁移表逐条走查（PC 上跑桩）；失联/恢复、超阈值多帧确认可复现 |
| **P4 任务化** | ✅ **已完成（2026-10-09）** —— 见 §十四：`App/Task/app_tasks.c` 四个任务 + USART2 接环形缓冲 + `delay` 改 DWT + `Group_4`；**中断安全静态核验通过**（9 个 ISR 全不调 RTOS API） | 静态检查临界区长度；`g_state` 快照读写不撕裂（PC 桩可测）；原 5 ms/10 ms 节拍代码零改写 |
| **P5 文档** | ✅ **已完成（2026-10-09）**：[`程序说明文档.md`](程序说明文档.md) —— 总体结构 / 任务划分 / 关键流程图 / 协议实现 / 算法 / 安全机制 / 离线验证 / 编译烧录 / 资源占用 / 未完成项 | 任务书要求的"程序设计说明文档（含流程图、通信协议定义）" |
| **P5 联调** | ✅ **已上板并联调两轮**（2026-10-13 / 10-15）：§14.6 列的内容已完成（逐条结论见 [`真机联调问题清单.md`](真机联调问题清单.md)）；剩余为 PID 整定与待修项 | 问题清单 §3 的 A/B 组条目为验收清单 |

> **P0–P4 全部与实物无关**，等货期间已完整推进；**到货后 P5 已走完两轮联调**。

---

## 七、风险与坑（B 专属，先记下来）

| # | 风险 | 处置 |
|---|---|---|
| 1 | **基线文件是 GBK** | 入库/改造时**统一转 UTF-8**（或在 Makefile 里显式 `-finput-charset=GBK`）；避免中文注释乱码 |
| 2 | ARMCC 专有两处（`sys.c`、`usart.c`） | 用 GCC 版替换：`__asm` 改内联汇编；`printf` 重定向改 `_write`/自定义发送函数 |
| 3 | **`printf` 与协议抢 USART2** | 协议**必须有自己的组包发送函数**，不依赖 `printf`（协议 §六 已写明） |
| 4 | 蓝牙默认 **9600** | 协议要 115200：到货后用 AT 指令改实测；**若改不了，协议波特率要回退**（需同步 C） |
| 5 | 蜂鸣器文档曾自相矛盾 | 已按**决策 26（实测有源、低电平响）**为准；`交接说明` §1.2 第 9 条已修正（见其变更记录） |
| 6 | 任务书写"FreeRTOS 移植 + HAL"，实际是 FWLIB | **报告里说明**（交接说明 §3.6 已列 7 处不符，B 占其中 2 处） |
| 7 | ~~Keil 工程本地无法验证~~ | ✅ **已消解**：交付不做 Keil 工程（决策 34），本地 **GCC + `.hex`** 一条路走到底；烧录用 FlyMcu（串口 ISP）或 ST-Link |
| 8 | 硬件未到货，传感器无实测 | 所有阈值/PID/量程**先按文档默认值**，留出**在线可调**（0x24）与**可标定**（R0 存 Flash）接口 |

---

## 八、交付物清单（B 角色，对照任务书）

| 交付物 | 状态 |
|---|---|
| 完整源代码工程（`firmware/`） | ✅ **已完成** —— 197 个文件（含 FreeRTOS 与厂商基线）；本次新写 35 个文件 / 4,816 行 |
| 程序说明文档（流程图 / 任务划分 / 协议实现说明） | ✅ **已完成** —— [`程序说明文档.md`](程序说明文档.md)（12 章，含流程图与协议实现说明） |
| （本文件）开工准备、执行日志与核验记录 | ✅ 本文（P0~P4 见 §十~§十四，复查见 §十五） |

---

## 九、变更记录

| 日期 | 内容 |
|---|---|
| 2026-10-09 | 初版：B 阶段 view + prepare。含 4 项环境核验实测结果（工具链冒烟 / 基线可编译性扫描 / FreeRTOS 编译 / CRC 独立复算）、引脚基线差异表、4 个待拍板决策点、6 步工作分解与风险清单 |
| 2026-10-09 | 补：核实**烧录路径**（控制板板载 `CH340G` + 自动 ISP → 串口 ISP 烧 `.hex`，FlyMcu 即原厂流程）；冒烟测试加出 `.hex/.bin` 验证；**决策 34/35 拍板**（GCC+Makefile+hex；FreeRTOS V11.1.0 vendor 入库）；基线可编译性统计修正为 **57 个文件 / 54 通过 / 3 需改造**（原先 114/117 未去重） |
| 2026-10-09 | 补：**引脚基线文件层交叉核验**（PCB 的 `PAD_NET`）+ **协议测试向量三方交叉核验**（Python ↔ C 侧真实 C++ 代码），发现并修正协议 `0x11` 长度错误与 `J1/J2` 位号转置；**P0 完成**（见 §十） |

---

## 十、P0 执行记录（2026-10-09）：从厂商裸机源码移植到 GCC 工程

> 结果：`firmware/` 已可一键 `make` 出 `.hex`；细节见 [`../../firmware/README.md`](../../firmware/README.md)。

### 10.1 做了什么

| 步 | 内容 | 产物 |
|---|---|---|
| 1 | 把厂商基线 **129 个源文件** vendor 进 `firmware/`，同时 **GBK → UTF-8** 转码并统一文件名大小写 | `tools/fw_prep/vendor_baseline.py`（可复跑） |
| 2 | 新写 **GCC 启动文件**（98 个向量）—— 由 `User/stm32f4xx.h` 里的 **IRQn 枚举自动生成**，杜绝手抄中断名 | `Drivers/CMSIS/startup_stm32f405.S` + `tools/fw_prep/gen_startup.py` |
| 3 | 新写**链接脚本**（1 MB Flash / 128 KB RAM / 64 KB CCM，起始 `0x08000000`） | `Drivers/CMSIS/stm32f405rg_flash.ld` |
| 4 | 移植 2 个 ARMCC 专有文件：`sys.c`（`__asm` → CMSIS 内联）、`usart.c`（半主机 `fputc` → newlib `_write`） | 见 README §三 |
| 5 | 新增 newlib 系统调用桩，消掉 `nosys` 的 5 条链接警告 | `System/retarget/syscalls.c` |
| 6 | 写 **Makefile**（默认 `USE_RTOS=1`，可 `make USE_RTOS=0` 切纯裸机对照） | `firmware/Makefile` |
| 7 | FreeRTOS **V11.1.0** 子集 vendor 入库 + `FreeRTOSConfig.h` + 故障钩子 | `Middlewares/FreeRTOS/`、`User/FreeRTOSConfig.h`、`User/rtos_hooks.c` |
| 8 | 给 `it.c` 的 SVC/PendSV/SysTick 加 `USE_FREERTOS` 保护（否则与 `port.c` **重复定义**） | `User/stm32f4xx_it.c` |
| 9 | 写**向量表核验脚本**并跑通 | `tools/fw_prep/check_vector_table.py` |

### 10.2 实测结果

| 项 | 结果 |
|---|---|
| `make`（RTOS=1） | ✅ **Flash 50,084 B（4.78%）/ RAM 5,368 B（4.10%）**，链接近乎无警告（25 条告警全在厂商代码里，见 README §三） |
| `make USE_RTOS=0` | ✅ Flash 49,252 B / RAM 5,168 B（裸机对照） |
| `.hex` | ✅ 数据区 `0x08000000 ~ 0x0800C3A4`，首行 `:020000040800F2`、末行 `:00000001FF` → **可直接喂 FlyMcu** |
| 向量表核验 | ✅ 栈顶 `0x20020000`、入口 = `Reset_Handler`；`EXTI15_10_IRQHandler`（命脉）来自 `control.o`，`USART2` 来自 `usartx.o`，`TIM3/TIM8` 来自 `timer.o`；RTOS 模式下 SVC/PendSV/SysTick 来自 **`port.o`** |

### 10.3 本轮新发现（都已处置或记入待办）

| # | 发现 | 处置 |
|---|---|---|
| 1 | **协议 `0x11` 长度自相矛盾**：文档写 N=11，字段清单算出来是 **9**（2+2+2+2+1） | ✅ **已改文档为 9**（由 `gen_test_vectors.py` 的文档自洽性检查发现；这类错会让 B/C 互通直接崩） |
| 2 | **`交接说明` §3.2 的 `J1`/`J2` 位号与完工 PCB 是反的**（内容一致、只是名字对调；PCB 里 `J1` = 带 `+5V/PC13/PA5…` 的那个 30 针座） | ⚠️ **记入待办**：固件按**网络名**编程不受影响；但若照文档说"插 J1"会有歧义，建议 A1 对丝印确认后统一命名 |
| 3 | **FreeRTOS 与 ST 模板抢 SVC/PendSV/SysTick** | ✅ 已加 `USE_FREERTOS` 保护；核验脚本会专门检查这三条向量的归属 |
| 4 | **`delay_us/delay_xms` 直接用 SysTick** 与 FreeRTOS 节拍冲突 | ✅ **P4 已处理**：改用 **DWT CYCCNT**（见 §十四） |
| 5 | 基线 `NVIC_PriorityGroup_2`（2 位抢占）不满足 FreeRTOS | ✅ **P4 已处理**：改 `Group_4`，控制中断保持不调用 RTOS API（有静态核验脚本）|
| 6 | `main.c` 仍调用 `DMP_Init()`（`Way_Angle=2` 用卡尔曼，DMP 实际不用） | 🔶 **保留不动**（先与基线保持一致，避免引入未知差异）；若要剔除必须在到货后单独验证 |

### 10.4 协议冻结进展（§七 条件）

| 冻结条件 | 状态 |
|---|---|
| B/C 各自实现 CRC 并用 §2.1 用例互验 | ✅ **B 侧已过**：Python 独立实现 + **C 侧真实 C++ 代码**（编译 `host/src/protocol/*.cpp` 跑）双方与文档**完全一致** |
| 测试向量共享 | ✅ 新增 [`test_vectors.json`](../protocol/test_vectors.json) / [`.tsv`](../protocol/test_vectors.tsv)（CRC 4 + 帧 12 + 流式 6），B/C 都拿它自测 |
| 确认蓝牙可改 115200 | ⬜ 到货实测（P5） |
| 单位量程 / 枚举无遗漏 | 🔶 见 §五 会签项 |

---

## 十一、P1 执行记录（2026-10-09）：协议层落地 + 三方交叉验证

> 目标（对应决策 36）：把"协议"从文档变成**两端都跑得起来、且互相验得了**的代码。

### 11.1 写了什么

| 文件 | 内容 | 关键设计 |
|---|---|---|
| `firmware/App/Comms/crc16.c/.h` | CRC-16/MODBUS，并额外提供**增量版** `crc16_modbus_update()` | 增量版让解帧时**不必为"命令字+长度+数据"再开一块拼接缓冲**（省 259 B RAM，且没有 static 状态） |
| `firmware/App/Comms/protocol.c/.h` | 帧常量、命令字、阶段/事件/档位枚举 + `Proto_Encode()` + `Proto_Feed()` 流式解帧状态机 + 8 组字段打包/解包 | ① 时间基**由调用方注入**（`nowMs` 参数）→ 100 ms 超时逻辑**能在 PC 上被测到**；② 解帧用**回调投递**，不动态分配；③ 容错规则与上位机逐条一致（`AA AA 55`、校验失败丢整帧但保留 0xAA 候选、长度超限整帧作废） |
| `firmware/App/Comms/ringbuf.c/.h` | **SPSC 环形缓冲**（512 B，2 的幂）：中断里 `Push`、任务里 `Pop`，满时丢新字节并计数 | 单生产者/单消费者 + 16 位对齐读写原子 → **无需关中断**；索引最后发布，避免消费者看到半成品 |
| `firmware/tests/proto_test.c` | 原生（PC）单元测试：向量复现 + 超时/边界/环形缓冲 | **不依赖 STM32**（三个模块只 include `<stdint.h>`），因此可以在 PC 上秒级回归 |
| `tools/fw_prep/run_proto_test.py` | 用 PC 端 gcc（自动探测，见 `toolchain.py`）编译并运行上面那套测试 | 一条命令跑完，失败数 = 退出码 |

### 11.2 三方交叉验证结果（协议冻结的核心证据）

| 路径 | 实现 | 结果 |
|---|---|---|
| ① **Python 独立实现** | `gen_test_vectors.py`（不看固件、也不看上位机代码） | 生成 CRC 4 + 帧 12 + 流式 6；并检查协议文档 N 与字段清单自洽 ✅ |
| ② **C 侧真实代码** | `host/src/protocol/{crc16,codec}.cpp`（编译后运行） | **CRC 4 条、帧 12 条、流式 6 条全部一致** ✅ |
| ③ **固件侧实现** | `firmware/App/Comms/*`（MinGW 原生编译运行） | **97 条断言全过、0 失败** ✅ |

覆盖到的边界：逐字节喂入、一包多帧、垃圾字节+伪帧头重同步、坏 CRC 丢整帧、长度 32767 整帧作废、
`AA AA 55` 前缀容错、**100 ms 超时复位**、正常流不误触超时、增量 CRC ≡ 一次性 CRC、
环形缓冲写满丢弃/环绕顺序/`PushBuf-PopBuf` 计数、`Proto_Encode` 参数非法返回 0。

### 11.3 ★ 测试当场抓到的 bug（说明"可执行验证"的价值）

| # | 现象 | 根因 | 处置 |
|---|---|---|---|
| 1 | 12 条帧用例的**组帧字节全错**（数据段整体错位 1 字节） | `Proto_Encode()` 把数据段写在偏移 **4**，正确是 **5**（帧头2+命令字1+长度2）—— 长度字段被数据首字节覆盖 | ✅ 已修；这类错在板上只会表现为"上位机一直收不到帧"，极难查 |
| 2 | C 侧交叉验证程序**崩溃**（`std::stoul` 抛异常） | 向量文件新增 `STREAM` 分节后，C++ 解析器把中文名字段当十六进制解析 | ✅ 已修（按列内容判别分节，并容错空列）；顺带把流式用例也纳入 C 侧复算 |
| 3 | C 侧复算少算了 2 条流式用例 | `std::getline` 会丢掉**行尾的空列**（期望命令字为空的两条被跳过） | ✅ 已修（缺列按空串处理） |

### 11.4 固件交叉编译状态

`make` 后 `App/Comms/*.o` 均已生成、**零告警**；因业务代码尚未调用，链接器按 `--gc-sections`
把它们剔除了（Flash/RAM 占用与 P0 相同：50,084 B / 5,368 B）。P4 把 CommTask 接上后即进入镜像。

---

## 十二、P2 执行记录（2026-10-09）：传感器层 + 算法交叉验证

### 12.1 写了什么

| 文件 | 层次 | 内容 |
|---|---|---|
| `App/Sensor/gas.c/.h` | **纯算法**（可在 PC 测） | ADC→反分压电压→Rs→Rs/R0→温湿度补偿→ppm；R0 标定（多次平均）；8 点滑动平均；**多帧确认 + 90% 迟滞**的阈值研判 |
| `App/Sensor/dht11.c/.h` | **纯算法** | 40 bit 帧的**可信度判定**（校验和 / 全 0 / 全 0xFF / 超量程）与换算；**不碰硬件** |
| `App/Sensor/dht11_hw.c/.h` | STM32 硬件 | 单总线时序（18 ms 起始 → 响应 → 40 bit 按时长判 0/1），**读失败自动重试 3 次**，每步都有超时上限（传感器不在也不会死等） |
| `App/Sensor/sensor_adc.c/.h` | STM32 硬件 | 复用厂商 `Adc_Init()/Get_Adc()`，只补 **PA5/PA6** 的模拟输入配置（PB1 电池那路不动）；采样时间保持 **480 周期**（MQ 分压源阻抗 ≈ 6 kΩ） |
| `App/Sensor/sensor_report.c/.h` | **纯算法** | 组装协议 0x14 载荷 + **ppm×10 饱和钳位** + 采样档位决策（预热/常态/异常） |
| `firmware/tests/sensor_test.c` | 测试 | 读 CSV 逐级比对 + 不变量（参考点系数≈1.0、除零、未标定、迟滞、钳位…） |
| `tools/fw_prep/gen_sensor_vectors.py` | 参考实现 | **Python 独立实现**算出每一级中间量 → `firmware/tests/sensor_vectors.csv` |
| `tools/fw_prep/run_sensor_test.py` | 驱动 | 一条命令：生成向量 → MinGW 编译 → 运行 |

### 12.2 结果：**1235 条断言全过**

| 分节 | 条数 | 校验内容 |
|---|---|---|
| `GAS` | 280 | 两通道 × 量程两端与随机点 × 5 组温湿度/补偿组合：**AO 电压、Rs、ratio、补偿后 ratio、ppm 五级逐一比对**（相对误差 <1e-4，ppm <1e-3） |
| `CALIB` | 2 | R0 标定：多次采样平均 → `R0 = Rs_air / (Rs/R0)_clean` |
| `AVG` | 22 | 滑动平均窗口：逐次喂入 11 个值，逐次校验窗口均值（含窗口滚动） |
| `CORR` | 7 | 补偿系数公式（含参考点 ≈19.37 ℃/33 %RH 时 ≈1.0） |
| `PARSE` | 9 | DHT11：正常 / 校验错 / 全 0 / 全 0xFF / 超量程 / 湿度为 0（合法） |
| `ALARM` | 5 | 多帧确认（=阈值不算超）+ 90% 迟滞（含"掉到 27 不解除、掉到 20 解除"） |
| `REPORT`+不变量 | 其余 | ppm×10 四舍五入与**饱和钳位**、就绪位组合、DHT 无效时不置补偿位、档位决策、除零/未标定边界 |

### 12.3 ★ 测试抓出的问题（连"我自己写的断言"也一起抓了）

| # | 现象 | 根因 | 处置 |
|---|---|---|---|
| 1 | 两条不变量断言失败：以为"湿度越高补偿系数越大" | **断言的物理方向写反了**。公式是 `… − (h−33)·D`，湿度越高系数**越小**；除法修正后 ratio **变大**，正好抵消"湿度升高 → MQ 的 Rs/R0 下降"这一漂移。向量里的 7 条 CORR 全对，说明**实现是对的、我的断言是错的** | ✅ 改断言，并把"方向别记反"写进注释 |
| 2 | 固件交叉编译失败：`protocol.h: No such file` | Makefile 的 include 路径只加了 `App/Comms/DataScope`，没加 `App/Comms` | ✅ 补 `-IApp/Comms`（并顺手补 `-IApp/Sensor -IApp/Task` 备用） |

### 12.4 两个工程决策（已记入决策记录 39/40）

1. **温湿度补偿用"除法"而不是"叠加"**：两套开源用法（MQUnifiedsensor 叠加 / GeorgK 除法）用的是**同一个公式**，而该公式在参考点≈1.0 —— 按叠加用等于凭空给 ratio 加 1.0（MQ-135 清洁空气才 3.6，等于 +28%），物理上讲不通。故采用除法，且**默认关闭**（由 0x23 的"补偿使能"控制），打开前必须实测复核。
2. **ppm×10 必须饱和钳位**：`ppm = a·ratio^b` 是幂律，ratio 很小时 ppm 可到千万级；协议字段是 uint16，**不钳位会回绕成小数字 —— 恰好把危险工况报成"浓度很低"**。已钳到 65535 并单测。

---

## 十三、P3 执行记录（2026-10-09）：巡检状态机 + 事件上报 + 失联安全停车

### 13.1 写了什么

| 文件 | 内容 |
|---|---|
| `App/Task/patrol.c/.h` | 巡检状态机（**纯逻辑，时间由外部注入**）：阶段用协议 `PROTO_PHASE_*`；维护进度/巡检点/异常标志；**待发事件环形队列**（8 条，供 0x13 上报）；`Patrol_Command()` 处理 0x21/0x20/0x22/0x2F；`Patrol_FillTaskState()` 组 0x12 载荷 |
| `firmware/tests/patrol_test.c` | **脚本化时间线测试**：P3 时为 5 个场景 / 67 条断言（**现已增至 6 个场景 / 76 条**，新增里程计场景见 §十六）（完整任务链 / 失联 / 急停 / 硬件故障与超时 / 迁移表与上报） |
| `tools/fw_prep/run_patrol_test.py` | 一条命令编译并运行 |
| `tools/fw_prep/run_all_tests.py` | **一键跑完 B 阶段全部离线核验**（三个原生单测 + 交叉编译 + 向量表 + 引脚基线），输出汇总表 |

### 13.2 三条安全设计（决策 41）

| # | 设计 | 理由 |
|---|---|---|
| 1 | **500 ms 未收到任何下行帧 → 安全停车**（协议 §5） | 只在"曾经收到过下行帧"之后才判失联 —— 否则上电瞬间就停车，车根本没法用 |
| 2 | 安全停车**锁存**：链路恢复**不自动起步**，必须由指令（0x21 任务 / 0x20 使能）显式解除 | "信号一抖车就自己冲出去"在仓库里不可接受 |
| 3 | 急停（0x2F）与硬件故障（低电压/倾角）走**同一条**安全停车通道，且急停不能被 0x20 解除 | 一条通道好验证；急停需要更强的解除条件（重下任务，即人工确认） |

### 13.3 测试结果：**67 条全过**

| 场景 | 覆盖内容 |
|---|---|
| ① 完整任务链 | 初始化→（自检事件 0x01）→预热（时长未到不出）→待机（0x07）→收到 0x21 进巡航（0x02）→抵达巡检点累计进度 33%→**气体超阈值进研判（0x06）并请求 5 Hz**→报警未解除继续驻留→解除后回巡航并恢复 1 Hz→走完巡检点返航→到位完成（0x03、进度 100%） |
| ② 失联 | 从未收到下行帧**不误判**；349 ms 不停、501 ms 必停；停车原因=失联、电机禁用；**链路恢复仍停**；0x20 使能可解除；重下任务可再起步 |
| ③ 急停 | 立即停车并锁存；连发急停**不重复报事件**；0x20 **不能**解除；重下任务可解除 |
| ④ 故障/超时 | 低电压/倾角 → 停车 + 事件 0x05；任务总超时 → 任务失败停车；**DHT 一直无效不阻塞任务**（只置传感器失效标志）；每 400 ms 有下行帧则永不误判失联 |
| ⑤ 迁移表/上报 | 8 个阶段枚举与协议 §3.2 顺序一致；0x12 载荷字段正确；电机禁用逻辑（待机/完成不禁、故障禁）；事件队列**不溢出** |

### 13.4 ★ 测试抓到的问题

| # | 现象 | 根因 | 处置 |
|---|---|---|---|
| 1 | 报警解除的那一拍：阶段已回到"巡航"，但**异常标志仍是气体位** | 清标志的条件里多写了 `lastGasAlarm == 0`，导致要等到**下一拍**才清 | ✅ 改为当拍清除（去抖本来就由 `gas` 模块的 90% 迟滞负责）。否则上位机会看到"巡航 + 气体异常"这种自相矛盾的一拍，采样档位也会多保持 5 Hz 一个周期 |
| 2 | 编译不过：`&base_input(0)` 取函数返回值地址 | C 语言不允许 | ✅ 加 `tick_at()` 小helper（顺带让时间线更好读） |

### 13.5 留给 B/C 会签的一项（协议 §七 的小项之一）

**失联事件没有专用事件码**：现在失联时上报 0x04（任务失败/超时）+ 0x12 的异常标志 `PATROL_FLT_LINK`。
建议 C 侧确认是否**新增事件码**（如 `0x08 = 通信失联/恢复`），若要加则协议升版本并同步测试向量。
（本固件不强加：加了必须两端同时改，不然上位机会收到未知码。）

---

## 十四、P4 执行记录（2026-10-09）：FreeRTOS 任务化 —— 真正动到运行时的那一步

> 目标：把"可以并发等待"的部分（采集/通信/状态机/界面）交给 FreeRTOS，
> 同时**让 5 ms/10 ms 的控制中断时序一字不改**。

### 14.1 四个任务与两条中断的分工

| 上下文 | 频率 | 职责 | 约束 |
|---|---|---|---|
| `EXTI15_10_IRQHandler`（抢占优先级 **1**） | 5/10 ms | 姿态 + 三环 PID + PWM + 保护 | **代码零改动**；不调用任何 RTOS API |
| `USART2_IRQHandler`（抢占优先级 **0**） | 字节到达 | **只把字节推进环形缓冲** | 同样不调用 RTOS API；解帧交给 CommTask |
| `CommTask`（优先级 3，384 字栈） | 20 ms | 解帧下行 → 处理指令；排空事件队列（0x13）；20 Hz 上行姿态/运动/任务 + 5 Hz 心跳 | 唯一碰串口发送的任务 |
| `GasTask`（2，384） | 50 ms 轮询 / 1 s 或 200 ms 采样 | 双路 ADC + DHT11 + 换算 + 研判 | 采样周期由档位决定 |
| `TaskTask`（3，320） | 100 ms | 状态机推进（含 500 ms 失联停车） | 输入全部来自任务侧变量 |
| `UiTask`（1，512） | 100 ms | OLED 刷新 + 蜂鸣器报警 | 低优先级，慢也安全 |

### 14.2 ★ 共享资源清单与保护方式（"临界区/互斥保护"的落地）

| 共享资源 | 写 | 读 | 保护 |
|---|---|---|---|
| USART2 **发送** | CommTask（协议帧）、UiTask（`printf`） | — | **互斥量** `CommLink_LockTx/UnlockTx`（否则两条报文交错成乱码）|
| USART2 **接收** | USART2 中断 | CommTask | **SPSC 环形缓冲**（512 B，中断只塞字节，无需关中断）|
| 姿态/编码器/电压全局量 | 控制中断 | CommTask | **短临界区整块读取**（仅用于上报/显示；对齐 32 位读写本身原子）|
| PID 参数 | CommTask（0x24 调参） | 控制中断 | **短临界区写入** |
| ADC1（PB1 电池） | 控制中断 | — | 与任务**物理分开** |
| ADC2（PA5/PA6 气体） | — | GasTask | 同上（见 14.3 的坑）|
| OLED（软件 SPI） | UiTask | — | 仅一个任务访问，无需保护 |

> **修正了架构文档的一处旧结论**：原 `architecture.md` §3.3 说"MPU6050 与 OLED 共用软件 I2C，需要互斥量"。
> 实板核实：**OLED 是软件 SPI（PC0/13/14/15），MPU6050 才是软件 I2C（PB10/11）**，两者不共总线 →
> **不需要 I2C 互斥量**（旧结论来自 F103C8T6 那版基底）。已改写该节。

### 14.3 ★★ 本轮最要紧的一个发现：ADC 不能中断/任务共用

厂商的电池采样 `Get_battery_volt()` 是在**控制中断里**跑的，它每次都会重设 **ADC1** 的通道并软件触发。
如果 GasTask 也拿 ADC1 读 PA5/PA6，两者会互相打断：中断改了通道 → 任务拿到的转换结果属于另一个通道，
`Get_Adc()` 里"等 EOC"的循环也会被对方吃掉标志。
**任务侧的临界区挡不住它** —— 控制中断的优先级高于 FreeRTOS 的屏蔽阈值，临界区拦不住。

**处置（决策 43）**：利用 PA5/PA6 同时挂在 `ADC12_IN5/IN6` 这一事实，**把气体两路改到 ADC2**：
`ADC1 → PB1（电池，中断专用）`、`ADC2 → PA5/PA6（气体，任务专用）`。彻底不共享，比任何加锁都可靠。

### 14.4 其它关键改动

| 位置 | 改动 | 原因 |
|---|---|---|
| `System/delay/delay.c` | `delay_us/xms` 改 **DWT CYCCNT** 忙等；`delay_ms` 在调度器运行时用 `vTaskDelay` | 原版直接读写 **SysTick**，与 FreeRTOS 节拍互相破坏（任务里一次 `delay_us(40)` 就把内核节拍改了）|
| `User/main.c` | `Group_2 → Group_4`；`uart2_init(9600 → **115200**)`；末尾 `App_Start()` 启动调度器 | FreeRTOS 要求 4 位全作抢占优先级；协议要求 115200 |
| `Drivers/BSP/EXTI|USARTX` | ISR 保持原优先级（1 / 0）不变 | 这样它们**永远不会被调度器延迟**，控制节拍不受影响 |
| `App/Ui/buzzer.c` | 新增：PC5 **低电平响**（有源模块，决策 26） | 任务书要求超阈值声光报警 |
| `App/Control/control.c` | `turn()` 的局部常量 `Kp=52 / Kd=0.5` 改为全局 `Turn_Kp / Turn_Kd`（**默认值完全相同**） | 协议 0x24 要能在线调转向环；未调参时行为与基线逐位一致（决策 44）|

### 14.5 离线核验（不需要板子）

| 检查 | 结果 |
|---|---|
| 交叉编译 | ✅ **Flash 60,020 B（5.73%）/ RAM 31,256 B（23.85%）**（RAM 涨是因为 FreeRTOS 的 24 KB 堆 + 任务栈现在真的被链接进来了）|
| 内核真的进镜像 | ✅ `nm` 可见 `vTaskStartScheduler` / `xTaskCreate` / 四个任务函数 / `prvIdleTask` |
| 向量表 | ✅ SVC / PendSV / SysTick 均来自 **`port.o`**（FreeRTOS），控制中断来自 `control.o` |
| **中断安全静态检查**（新脚本） | ✅ **9 个中断处理函数全部不调用 FreeRTOS API**；并列出各中断抢占优先级，标明"高于 syscall 阈值 → 绝不能调 RTOS API（含 FromISR）" |
| 三个原生单测 | ✅ 协议 97 / 传感器 1235 / 状态机 76 条断言全过 |
| `USE_RTOS=0` 裸机对照 | ✅ 仍可编译（厂商超级循环与 APP 解析在 `#else` 分支里原样保留）|

> 新增脚本：[`tools/fw_prep/check_isr_safety.py`](../../tools/fw_prep/check_isr_safety.py) ——
> 从 `.map` 找出真正参与链接的 ISR，定位源码函数体，搜索 FreeRTOS API 名单。
> 这类错误**编译器不报、上板才炸**，所以必须做成可复跑的检查。

### 14.6 到货后必须实测的（P5）

1. 烧录后先看**能否正常平衡**（验证"未调参时与基线等价"这一承诺）；
2. 蓝牙波特率 115200 是否正常（基线原为 9600，模块需 AT 改）；
3. DHT11 单总线在任务上下文里能否稳定读到（20 ms 读窗会被控制中断打断，靠重试）；
4. MQ 的 `RL` 实测 + 清洁空气标定 `R0`；
5. 编码器 → 巡检点里程标定（`waypointReached` 目前恒为 0，是**已知待接线项**）。

---

## 十五、第二轮代码复查与接口完善（2026-10-09）

> 起因：用户要求"再检查一遍代码，确保理论上无误；尽可能规范；并为后续上位机开发与 PID 动态调参留出接口"。
> 本轮**通读了 P0~P4 的全部新代码**，抓到 4 个真实缺陷（其中 1 个会让整个巡检功能不可用），
> 并把"给上位机的数据接口"与"调参接口"补齐。

### 15.1 ★ 复查抓到的问题（都已修）

| # | 问题 | 后果 | 根因 |
|---|---|---|---|
| 1 | **R0 标定永远收不了尾 → 状态机卡在"预热"** | 车永远进不了待机，**整个巡检功能不可用** | 标定的收尾调用写在"已离开预热"的分支里，而离开预热又要求"标定完成" —— **逻辑死锁**。已改为：GasTask 按"采样次数够 或 预热时长到"自行收尾，状态机的 `calibrating` 由该标志驱动 |
| 2 | **超声波 TRIG 仍是 PC2**（初始化与发脉冲两处） | 新底板上超声波**永远测不到距离** | 基线源码是 PC2，改板把 TRIG 挪到了 PC4；此前只改了文档没改代码 |
| 3 | **0x11 上报的不是协议定义的量**：轮速给的是编码器脉冲、PWM 给常数 0 | 上位机画出的速度/占空比没有物理意义 | 首版只求"帧能发出去"，没对照协议字段定义 |
| 4 | **0x23 收到后没回 0x12 确认** | 上位机无法确认参数是否生效 | 协议 §4.1 明确要求"写入并回 0x12 确认"，实现时漏了 |

> 另修 2 处**接口/规范**问题：`0x14`（环境与气体）此前**根本没在周期上报里发送**；
> 配置量（轮径、线数、阈值、周期、栈、默认 PID、Flash 地址）散落各处 → 收进 `App/Config/app_config.h`。

### 15.2 给上位机（C）新增的接口

| 新增 | 内容 |
|---|---|
| **有线调试链路**（决策 45） | USART1（PA9/PA10）跑**同一套协议**，与蓝牙对等：收到帧就处理、**回复原路返回**；周期上报与事件告警**两条链路都发** |
| **`App/Task/app_api.h`** | 只读 getter：遥测（姿态/轮速/PWM/超声/电压）、气体（原始值、**Rs/R0**、R0、ppm×10、报警、就绪位、档位）、状态机（阶段/进度/停车原因）、**诊断**（两链路收字节/丢弃/ORE、解帧统计、**四任务心跳**、**FreeRTOS 剩余堆与历史最小值**）|
| **0x24 调参扩展**（决策 46） | `0xFF` 全量回读 7 个参数 / `0x00` 存 Flash / `0xFE` 重新载入 / `0xFD` **调参观测模式**（有线链路 **100 Hz** 上报 0x10+0x11）。**帧格式不变**，对 C 兼容 |
| **参数持久化** | `param_pack.c`（纯逻辑、**float 位型存储** + magic + 数值合理性校验）+ `param_store.c`（扇区 6 写入 + **当场回读校验**）；**不复用**厂商 `0x08020000` 的存储区 |

### 15.3 代码规范方面的整理

- 可调量集中到 `App/Config/app_config.h`（含 `[待实测]` 标注），联调只改一个文件；
- 任务周期/栈改为具名常量（不再有魔数 `20/50/100/384...`）；
- `param_pack.c` 拆成**不依赖任何厂商全局量**的纯逻辑（否则无法离线测）；
- 缓冲区用途与生命周期在注释里写明（`s_dec[]` 每链路一个解帧器、`payload` 与 `out` 分离）。

### 15.4 核验结果

| 检查 | 结果 |
|---|---|
| 协议层原生单测 | ✅ **117 条**（帧用例 12 → **16**，含 4 个扩展参数 ID）|
| 传感器算法原生单测 | ✅ 1235 条 |
| 巡检状态机原生单测 | ✅ 76 条 |
| **PID 参数打包原生单测（新增）** | ✅ **24 条**（往返逐位一致 / magic 与个数校验 / 离谱值拒绝 / 7 个 ID 无串位）|
| 固件交叉编译 | ✅ **Flash 62,968 B（6.01%）/ RAM 32,792 B（25.02%）** |
| 向量表 / 中断安全 / 引脚基线 | ✅ 全部通过（USART1 现为真实链路，ISR 同样**不调用 RTOS API**）|
| 三方交叉验证 | ✅ Python ↔ C 侧 ↔ 固件：CRC 4 + 帧 **16** + 流式 6 全部一致 |

### 15.5 当年"需要 C 会签的两项"（协议 v1.0-b）—— ✅ 均已关闭

1. **`0x24` 的 4 个扩展参数 ID**（`0xFF/0x00/0xFE/0xFD`）—— 帧格式不变，B 侧已实现并进了测试向量 →
   ✅ **已在 v1.1 会签通过并冻结**（决策 57，B 代拟）；
2. **失联事件是否新增专用事件码**（当时复用 0x04 + 0x12 异常标志）→
   ✅ **已新增 `0x08` 失联停车 / `0x09` 解除 / `0x0A` 急停**（决策 57）。

> 📌 **此后又发生的变化（2026-10-13 / 10-15）**：协议升 **v1.2**（新增 `0x15` 诊断帧、`0x16` 三环实况
> 与固件版本字节、`0x20` 运动实现 + 500 ms 看门狗、`0x24` 范围校验）；
> **当前核验值**：4 套原生单测 **117 / 1235 / 80 / 29 = 1,461 条断言**，
> 加 `tune.py --selftest`、交叉编译、向量表、中断安全、引脚基线 ⇒ **离线核验 9 项全通过**；
> 占用 **Flash 约 66.5 KB / RAM 约 32.8 KB**。逐条结论见 [`真机联调问题清单.md`](真机联调问题清单.md)。

---

## 十六、变更记录

> 本文档的逐条变更记录在 §九；P0 见 §十、P1 见 §十一、P2 见 §十二、P3 见 §十三、P4 见 §十四、复查见 §十五。

| 日期 | 内容 |
|---|---|
| 2026-10-09 | **P0 完成**：GCC 工程跑通（Flash 50 KB / RAM 5.4 KB）、FreeRTOS V11.1.0 接入、GCC 启动文件与链接脚本生成、`.hex` 核验可烧、向量表逐条核验通过；发现并处置 6 项问题（见 §10.3） |
| 2026-10-09 | **P1 完成**：协议层三模块（`crc16` / `protocol` / `ringbuf`）落地，**原生测试 97 条断言全过**；Python ↔ C 侧 ↔ 固件**三方交叉验证一致**（CRC 4 + 帧 12 + 流式 6）；测试当场抓到"组帧数据段错位 1 字节"的 bug（见 §11.3） |
| 2026-10-09 | **P2 完成**：传感器层（`gas` / `dht11` / `dht11_hw` / `sensor_adc` / `sensor_report`）落地，**原生断言 1235 条全过**（五级中间量逐一比对 Python 独立实现）；新增决策 39/40（补偿用除法且默认关、ppm×10 必须饱和钳位）；抓到"补偿方向断言写反"与"include 路径缺失"两处问题 |
| 2026-10-09 | **P3 完成**：巡检状态机（`App/Task/patrol.c`）+ 事件队列 + **500 ms 失联安全停车（锁存、不自动起步）**，**脚本化时间线测试 67 条全过**（完整任务链 / 失联 / 急停 / 硬件故障与超时 / 迁移表）；新增决策 **41**（安全停车策略）；新增 `run_all_tests.py` 一键核验；抓到"异常标志晚一拍清除"的问题 |
| 2026-10-09 | **P4 完成**（任务化）：新增决策 **42/43/44**（运行时共享资源策略、ADC 拆通道、转向环增益全局化）；四个任务 + USART2 环形缓冲 + `delay` 改 DWT + `Group_4` 落地；**Flash 60 KB / RAM 31.2 KB**，内核与四任务确认进镜像；新增 `check_isr_safety.py`，**9 个中断静态核验全部不调 RTOS API**；修正 `architecture.md` §3.3（OLED 是 SPI，不需要 I2C 互斥量）|
| 2026-10-09 | **P5 文档完成**：产出任务书要求的 [`程序说明文档.md`](程序说明文档.md)（12 章：需求对应 / 总体结构 / 任务划分 / **流程图** / **协议实现说明** / 算法 / 安全 / 离线验证 / 编译烧录 / 资源占用 / 未完成项 / 附录）。**B 阶段的"离线可完成部分"到此收尾**，其余为到货实测 |
| 2026-10-09 | **第三轮复查（本轮）**：抓到并修复 **安全停车没接到电机**（`Patrol_MotorsDisabled()` 无人调用 → 500 ms 失联时电机照转）、**两条绕过安全锁存的旁路**（按键启停、放下自动使能）；新增 **USER 按键双击切 OLED 页**（页 1 环境气体 / 页 2 巡检通信，决策 48）与 **有线调参工具 `tune.py`**（决策 47/48 见决策记录）；仓库通用化收尾（`.gitattributes` 统一 LF + `README.en.md`）|
| 2026-10-13 | **真机联调第一轮（决策 60/61）**：新增 `0x15` 诊断帧（任务 tick / OLED 写计数 / 电压 / 页号 / 剩余堆）；修低压误触发（三级判据）与厂商 `APP_Show()` 污染链路；DTR/RTS 陷阱；安全通道事件码 `0x08/0x09/0x0A`（状态机断言 76 → **80**）；**协议升 v1.2**；新增端口自动识别工具 `bt_scan.py`（决策 61）|
| 2026-10-15 | **真机联调第二轮（决策 62/63/64）**：修 `control.c` 缺 `app_config.h` 导致条件编译**静默失效**（AGENTS 铁律 35）、编码器**分侧**极性开关；`0x20` 运动链路真正实现 + **500 ms 无指令自动停**；`0x24` **范围校验**；新增 **`0x16` 三环实况**与**固件版本字节**（`0xAF`）；新增蓝牙 AT 工具 `bt_at.py`。**本文档 §一/§二/§15.4/§15.5 刷新为"当前值"口径**（离线核验 9 项全通过、约 66.5 KB / 32.8 KB），**§十~§十五 的当时实测数字原样保留** |
| 2026-10-09 | **第二轮复查 + 接口完善**：新增决策 **45/46**（USART1 有线调试链路；0x24 调参扩展与 Flash 持久化）；修 4 个真实缺陷（**R0 标定死锁**、超声波 TRIG PC2→PC4、0x11 上报的不是 mm/s/PWM、0x23 未回 0x12 确认）；补 `0x14` 周期上报、`app_api.h` 只读接口、`app_config.h` 集中配置；原生单测增至 4 套（117/1235/67/24），Flash 62,968 B / RAM 32,792 B |

---

> **项目归属**：中国石油大学（华东） 专业生产实习课程项目<br>
> **范围说明**：本项目不涉及 MiniBalance 控制板（STM32F405RGT6 版本）的硬件设计与改版；控制板直接沿用，A1 仅重做主底板。<br>
> **许可**：原创代码与文档采用 MIT License；第三方组件遵循各自原始许可证。
