pierrotto12138-code/balance-car-inspection-robot/docs/design_firmware/编码规范.md

# 编码规范（B 阶段固件）

> **为什么要有这份文件**：这个工程的"优雅"不是排版好看，而是三条硬约束 ——
> **① 同一件事只有一个真相；② 依赖单向；③ 能被 PC 单测**。
> 下面的规则都是从**实际踩过的坑**里总结的（每条都指向一个具体事故或复查发现），
> 新人照它写，就不会重复踩。
>
> 适用范围：`firmware/App/`、`firmware/User/`、`firmware/System/`、`firmware/tests/`
> （厂商 `Drivers/FWLIB`、`Middlewares/FreeRTOS` 保持原样，只做必要的移植改动并标 `★`）。
> 校验手段：`make strict`（严格告警，0 条）、`python tools/fw_prep/run_all_tests.py`（断言全过）。

---

## 一、分层与依赖方向（谁能 include 谁）

```
User/            启动、中断入口、内核配置           → 可以 include 任何层
App/Task/        任务编排与状态机                   → App/Board, App/Comms, App/Sensor, App/Control, App/Ui, System, Drivers/BSP
App/Board/       ★ 访问厂商全局量的唯一适配层        → System/sys（厂商量的声明处）、Drivers/BSP；**不允许被 System/Drivers 反向引用**
App/Comms/       协议、环形缓冲、串口胶水            → App/Config, System（不得反向依赖 App/Task）
App/Sensor/      气体/DHT11/ADC/组包                → App/Config, Drivers/BSP
App/Control/     PID 与参数持久化                   → App/Config, App/Board, Drivers/BSP
App/Ui/          显示页、蜂鸣器                     → App/Config, App/Task/app_api.h（只读接口）, Drivers/BSP
App/Config/      纯宏定义                           → 不 include 任何东西
System/          厂商移植层（sys/delay/usart）       → 不得 include App/**（见第四节"反例"）
Drivers/BSP/     外设驱动                           → 不得 include App/**
```

**规则 1（单向）**：箭头只能往下，**不许回指**。底层需要"上层才知道的事"时，用**回调/钩子注入**
（已落地：`System/delay/delay.c` 需要"让出 CPU 的延时" → 由 `App_Start()` 调
`Delay_SetMsHook(app_delay_ms)` 注入函数指针，`delay.c` 只认 `DelayMsHook` 类型，**不认识 App**）。

**规则 2（厂商全局量只有一个出口）**：厂商全局量（`Angle_Balance`、`Moto1/2`、`Voltage`、
`Flag_Stop`、PID 增益、`Zhongzhi`…）**对 App 层只能通过 `App/Board/board_state.h` 访问**：
`Board_ReadRaw()` / `Board_Read|WriteVendorStop()` / `Board_Sync|CapturePidParams()`。
`board_state.c` 是**唯一** include `sys.h` 去碰这些量的 App 文件。
> 为什么不是"每个文件各自 include sys.h 就行"：那样"同一个量在 N 处被读"依然存在 ——
> 表现在 `app_tasks.c` 用 `Voltage` 判低电压、`param_store.c` 写 `Balance_Kp`，
> 换板/换厂商实现时要满仓库找。收敛到一个出口后，**只改 `board_state.c`**。
> 代价：读一次姿态要经过一层函数调用（约十几条指令），对"上报/显示"这类 20 Hz 的用途可忽略。

---

## 二、"只有一个真相"（本项目最容易犯的错）

| 规则 | 说明与事故 |
|---|---|
| **同一计算只留一份实现** | 0x14 载荷（就绪位 + ppm×10）只由 `SensorReport_FillEnvGas()` 算；`App_GetGas()` **复用它**，不许另写一套。<br>事故：曾有两套等价实现，测试只覆盖了"没人调用"的那份 → **给死代码写了测试**。 |
| **校验必须真的比对** | 任何"写入后回读校验"都要**逐字段比较**，不能只判断"读得回来"。<br>事故：`ParamStore_Save()` 只 `Unpack` 一次、从不与源数据比对 —— 与铁律 29 同型的**假校验**。 |
| **使能/停车只有一个权威** | `App_MotorDisable`（任务侧锁存）是唯一权威，厂商 `Flag_Stop` 只是**执行器**（中断据前者强制置位）。<br>事故：`Put_Down()` 的"放下自动使能"曾能绕过安全锁存。 |
| **接口承诺必须兑现** | `app_api.h` 说"getter 自带短临界区"，那每个 getter 就都得有。<br>事故：4 个 getter 里只有 1 个加了临界区，属于**文档骗人**。 |
| **死代码零容忍** | 没人调用的函数：**要么删，要么在头文件注明它是"工具/调试器入口"**。<br>事故：`ParamStore_Current()`（参数镜像指针）与 `Buzzer_IsOn()`（影子状态）无人调用却被当成接口留着 → 已删（2026-10-13）。<br>反例（**保留**）：`App_GetTelemetry()`、`App_TaskTicks()` 固件内确实没人调，但它们是**上位机/调试器入口**，已在 `app_api.h`/`app_tasks.h` 注明用途 —— 关键差别是**有没有写清"给谁用"**。 |

---

## 三、可测试性（这是本项目最有价值的习惯）

1. **算法与硬件分离**：协议、气体换算、状态机、里程计、参数打包一律写成**只依赖 `<stdint.h>`** 的纯 C；
   时间由调用方注入（`Proto_Feed(..., nowMs, ...)`）、标定系数由外部注入（`Odom_SetScaleUmPerCount()`）。
2. **凡是"决策逻辑"都要有断言**：新增分支必须在 `firmware/tests/*.c` 里补断言，
   并且**同时覆盖边界与最坏值**（例如 ppm 饱和钳位 1e6 → 65535）。
3. **不用自己写的解析器验证自己的改动**（AGENTS 铁律 23）：协议正确性靠
   Python 独立实现 ↔ host C++ ↔ 固件 三方交叉验证（`docs/protocol/test_vectors.json`）。
4. **改完必须跑**：`python tools/fw_prep/run_all_tests.py` + `make strict`，两条都绿才算完。

---

## 四、中断与并发（混合式架构的命门）

1. **高于 `configLIBRARY_MAX_SYSCALL_INTERRUPT_PRIORITY`(5) 的中断里，绝不调用任何 FreeRTOS API**
   （含 `...FromISR`）。本项目 `EXTI15_10`(1)、`USART1/2`(0) 都属于这一类。
   校验：`python tools/fw_prep/check_isr_safety.py`。
2. **中断里只做"塞缓冲 / 读一个变量 / 纯整数加"**：解帧、格式化、字符串、浮点、除法一律留给任务。
3. **中断与任务不共用外设**（本项目把气体挪到 ADC2；临界区**挡不住**高优先级中断）。
4. **getter 要么加短临界区、要么只读单写者的原子量**；共享结构体跨任务读必须按前者。
5. **临界区里不调用函数**（除纯计算）：`App_GetDiag()` 把 `xPortGetFreeHeapSize()` 放在临界区外。
6. **临界区分两种，别把中断里的写法搬到任务里**（2026-10-13 补充）：
   - **中断上下文**（`EXTI15_10`/`USARTx`）→ 只能"读写单个 `volatile` 标量"（32 位对齐读写原子）；
     绝不能进临界区、绝不能调任何会切换上下文的接口。
   - **任务上下文**（含被任务调用的 getter）→ 共享**结构体/多字段**快照用 `taskENTER_CRITICAL()`；
     它保存并恢复 `BASEPRI`，**可以嵌套**（本项目 `Board_ReadRaw()` 与 `Board_WriteVendorStop()`
     内部各带一次，调用方即使在临界区里调用也安全）。
   - 判据：**"这一组数据必须来自同一拍吗？"** 是 → 任务侧上临界区；只读一个标量 → 不用。

---

## 五、命名与文件组织

| 对象 | 规范 | 例 |
|---|---|---|
| 模块前缀 | 与模块名一致，动词在前 | `Gas_Update`、`Patrol_Tick`、`Proto_Encode`、`Odom_AddCounts` |
| 文件内静态量 | `s_` 前缀 | `s_patrol`、`s_mq2RawAvg` |
| 常量/配置 | `CFG_` 前缀，集中在 `App/Config/app_config.h` | `CFG_WARMUP_MS`、`CFG_TX_ENV_FAST_MS` |
| 协议字面量 | `PROTO_` 前缀 | `PROTO_DOWN_PID_TUNE` |
| 公开接口 | 头文件成对，放对应模块目录 | `App/Task/app_api.h` |
| 类型 | `XxxCfg`（配置）/ `XxxState`（状态） | `PatrolCfg`、`GasChannelCfg` |

- **头文件守卫用 `模块前缀_文件名_H` 风格**（例：`APP_SENSOR_GAS_H`、`BSP_OLED_H`、`SYS_DELAY_H`）。
  - **不要 `__XXX_H`**：`__` 开头是 C 保留标识符（未定义行为）；而且本项目历史上真撞过名
    （`App/Sensor/MPU6050/mpu6050.h` 与 `System/usart/usart.h` 都写 `__USART_H`）——
    后果是**后 include 的那个头文件被整体静默跳过**。
  - 前缀规则：`App/**` → `APP_`、`Drivers/BSP/**` → `BSP_`、`System/**` → `SYS_`，
    其后接"相对路径去掉 `.h`"，非字母数字换 `_`、逐段大写。
  - ★ `User/stm32f4xx*.h` 是 **ST 官方文件**，守卫保持原样（不跟我们的规范走，便于将来对表 ST 版本）。
### 5.1 格式规范：**实际执行的是下面这张表**（不是 `.clang-format`）

> 仓库根有 `.clang-format`，但**当前不执行**（决策 55）：即使按 clang-format 23 校准过，
> 对既有文件跑一次仍会产生**数百处真实重排**，会把真实逻辑改动淹没在格式 diff 里。
> 所以"排版统一"的落点是**下面这些已落地、有工具保证的规则**：

| 规则 | 现状 | 谁保证 |
|---|---|---|
| 行尾 **LF** | ✅ 已统一 | `.gitattributes`（`text eol=lf`）+ `normalize_whitespace.py` |
| 行尾空白删除 / 文件末尾恰好一个换行 | ✅ 已统一 | 同上（幂等，可反复跑） |
| 混合缩进（Tab 后又跟空格）→ 纯 Tab | ✅ 已统一（37 个文件） | 同上；**纯空格缩进的行原样保留**，不动别人刻意对齐的地方 |
| 缩进用 **Tab**（显示宽度 4） | ✅ 既有代码即如此，新代码照办 | 人工遵守（评审时看） |
| 大括号 **Allman**（函数与控制语句另起一行） | ✅ 既有代码即如此 | 人工遵守 |
| 头文件守卫 `模块前缀_文件名_H` | ✅ 已全仓改名（46 个） | 人工 + 编译（同名守卫会导致头文件被静默跳过） |
| **行宽** | 🔶 **不强制**（建议新代码 ≤110 列） | 人工：长行多是注释里的推导依据，自动折行反而难读 |
| 括号前空格（`f (a)` vs `f(a)`） | 🔶 **不统一**（厂商风格是 `f (a)`，保留原样） | 不做改动 |
| include 排序 | 🔶 不强制 | 不做改动 |

> **一句话**：能机器保证的（空白/行尾）已经做了；需要审美判断的（折行、括号空格）**不做**，
> 代价是"看着不齐"，收益是 diff 干净、控制代码不被搅动。

- **空白统一**（2026-10-13 起交给脚本，不要手工纠结）：

  | 规则 | 做法 |
  |---|---|
  | 行尾 | 一律 **LF**（与仓库 `.gitattributes` 的 `*.c/*.h/Makefile text eol=lf` 一致） |
  | 行尾空白 | **删除**（Tab / 空格都不留） |
  | 文件结尾 | 恰好**一个**换行 |
  | 混合缩进 | "Tab 后面又跟空格"的行 → 折算成纯 Tab（`Tab 数 + ⌈空格数/4⌉`）；**纯空格缩进的行原样保留** |
  | 更细的排版 | 见仓库根 [`.clang-format`](../../.clang-format)（本机未装 clang-format，装了再跑） |

  执行（**作用域由脚本内的白名单硬限定**，绝不会碰到厂商目录；重复执行幂等）：
  ```powershell
  python tools\fw_prep\normalize_whitespace.py
  ```
  > 脚本自带安全阀：改写后会把"去掉所有空白字符"的内容与原文件比对，**只要有一个非空白字符变了就拒绝写入**。
  > 事故对照组：本脚本第一版**误把 `Drivers/FWLIB`、`App/Sensor/DMP` 等厂商目录也格式化了 136 个文件**
  > （违反"厂商代码保持原样"），已从快照整体回滚，并把白名单写进脚本 ——
  > **凡是批量改写脚本，第一件事是显式限定作用域，第二件事是加"非目标内容零变化"的校验。**
- **文件头写"这个文件负责什么、为什么这么设计"**，不要写"本文件实现了 X"这种废话。
- **注释写"为什么"，不写"是什么"**：`/* 用 ADC2 是因为中断占用 ADC1，临界区挡不住中断 */` ✅。

---

## 六、注释与文档同步

1. 改了行为 → 同步改注释与文档（`程序说明文档.md`/`README.md`），**注释与实现不一致按 bug 处理**。
2. 数值型参数（阈值、预热、周期）**必须在注释里写清"为什么是这个数"**（见 `app_config.h` §四/§五）。
3. 厂商文件被我们改过的地方，一律用 **`★ B yyyy-mm-dd（决策 N）`** 标注，便于区分原文与改动。

---

## 七、提交前自检（照抄执行）

### 7.0 大改动前先留"回滚点"（快照策略）

任何"结构性/大范围排版"改动之前，先把 `firmware/` 整目录快照到 `hardware/固件快照_<日期>_<时刻>/`
（已 gitignore，不进版本控制），并附一份 MD5 清单。保留策略（决策 56）：

- **只保留"最近一次大改之前"的那一份**（更早的、以及每个中间步骤的都删掉，避免堆积）；
- **上板验证通过后即可删除** —— 它的唯一用途是"改坏了能一键回滚"；
- 回滚后必须重跑 `make strict` + `python tools/fw_prep/run_all_tests.py` 再继续。

```powershell
cd <仓库根>/firmware
make                 # 正常构建（应无 error；厂商代码的历史告警允许存在）
make strict          # 严格告警：**自研代码必须 0 条**
cd ..
python tools\fw_prep\normalize_whitespace.py  # 空白/行尾规范化（幂等，只作用于白名单）
python tools\fw_prep\run_all_tests.py    # 4 套断言 + 交叉编译 + 向量表 + 中断安全 + 引脚基线
python tools\fw_prep\check_isr_safety.py # 动过中断/内核配置时
```

> 严格告警为什么重要：`-Wall -Wextra` 挡不住**类型窄化、隐式符号转换、缺原型**这类问题，
> 而它们往往在换编译器、换优化等级、或上板后才暴露。我们把它固化成 `make strict`（厂商头用 `-isystem` 屏蔽）。

---

## 八、变更记录

| 日期 | 内容 |
|---|---|
| 2026-10-09 | 初版：依据一次通读复查（发现假校验、重复实现、接口承诺未兑现、重复 extern、double 窄化等）总结成文，并把校验手段固化为 `make strict` |
| 2026-10-13 | 复查收尾（P0~P2 规整化）：删除 `ParamStore_Current()`/`Buzzer_IsOn()` 两处死代码与蜂鸣器的影子状态；把"工具入口 vs 死代码"的判定标准写进 §二；§一 补上 `App/Board/` 分层与 `Delay_SetMsHook()` 回调注入的落地结论；§四 补"中断侧 vs 任务侧临界区"的判据（P2.1~P2.4） |
| 2026-10-13 | **P3 排版统一**：① 46 个头文件守卫改成 `模块前缀_文件名_H`（`__` 开头是保留标识符，且本项目真撞过名）；② 新增空白规范化脚本 `tools/fw_prep/normalize_whitespace.py`（行尾 LF + 去尾随空白 + 混合缩进折算；白名单限定作用域 + "非空白零变化"安全阀），作用域内 37 个文件收敛为 0 尾随空白 / 0 混合缩进；③ 新增仓库根 `.clang-format` 作为更细排版的单一真相；④ 教训入库：第一版脚本误格式化厂商目录 136 个文件，已从快照回滚 |

---

> **项目归属**：中国石油大学（华东） 专业生产实习课程项目<br>
> **范围说明**：本项目不涉及 MiniBalance 控制板（STM32F405RGT6 版本）的硬件设计与改版；控制板直接沿用，A1 仅重做主底板。<br>
> **许可**：原创代码与文档采用 MIT License；第三方组件遵循各自原始许可证。
