pierrotto12138-code/balance-car-inspection-robot/docs/design_hardware/pin_assignment.md

# 引脚分配表（MiniBalance V5.0 高配版 / STM32F405RGT6）

> **数据来源与优先级**：小车有多个版本，原理图 PDF（2020 年）与源码（2016–2017 年）不完全一致
> （已实测到超声波引脚就对不上）。**本表以源码为准**，仅把原理图作为"引脚是否引出"的参考，
> 并明确标注哪些需要实物复核。
>
> 依据源码：`Base/高配版平衡小车附送资料（STM32F405RGT6）/MiniBalanceV5.0【高配版】平衡小车库函数版源码（卡尔曼滤波版）`
> 更新日期：2026-09-22

---

## 一、硬件与技术栈概况

| 项目 | 内容 |
|---|---|
| 主控 | **STM32F405RGT6**（Cortex-M4F，LQFP64，1MB Flash / 192KB RAM）<br>同一块板可换焊 STM32F103RC（**两者 pin-to-pin 兼容**） |
| 系统时钟 | 168 MHz（`delay_init(168)`） |
| 固件库 | **ST 标准外设库（FWLIB）**，非 HAL 库 |
| 工程格式 | **Keil 4 工程（`Minibalance.uvproj`）**，无 `.ioc`、无 CMake/Makefile |
| 调度方式 | **裸机超级循环（无 FreeRTOS）**；控制逻辑跑在 MPU6050 的 INT 外部中断里，10 ms 周期 |
| IMU | **MPU6050（板载集成）**，经**软件 I2C** 访问；INT 接 EXTI |
| 姿态算法 | 默认卡尔曼滤波（另有 DMP / 互补滤波版本源码） |
| 显示 | OLED，**软件 SPI**（4 线） |
| 通信 | 蓝牙 = USART2；调试/上位机 = USART1；另有 CAN、NRF24L01（源码中已注释禁用） |
| 上位机协议 | 厂商自有 **DataScope** 协议（`$` 帧头 + float 数组 + 长度尾字节） |

### 1.1 控制周期（源码实测）

`control.c` 的 `EXTI15_10_IRQHandler()` 由 MPU6050 INT 触发，内部用 `Flag_Target` 交替：

- **5 ms**：读姿态（`Get_Angle`）+ 读遥控 + 读电池电压
- **10 ms**：读编码器 + 平衡 PID + 速度 PID + 转向 PID + PWM 输出

> ⚠️ 这与旧基底（FreeRTOS + 5 ms 任务）完全不同，改造方案需相应调整。

---

## 二、已被占用的引脚（源码实测，勿动）

| 功能 | 引脚 | 外设/类型 | 源码出处 |
|---|---|---|---|
| 左编码器 A 相 | **PA0** | TIM2_CH1（编码器模式） | `ENCODER/encoder.c` |
| 左编码器 B 相 | **PA1** | TIM2_CH2 | 同上 |
| 蓝牙 RX（模块 RX ← MCU TX） | **PA2** | USART2_TX | `USARTX/usartx.c` |
| 蓝牙 TX | **PA3** | USART2_RX | 同上 |
| 电机 B 路 PWM | **PA8** | TIM1_CH1（`PWMB = TIM1->CCR1`） | `MOTOR/motor.c` |
| 调试/上位机 TX | **PA9** | USART1_TX | `SYSTEM/usart/usart.c` |
| 调试/上位机 RX | **PA10** | USART1_RX | 同上 |
| 电机 A 路 PWM | **PA11** | TIM1_CH4（`PWMA = TIM1->CCR4`） | `MOTOR/motor.c` |
| 电机 B 方向 | **PA12** | GPIO 输出（`BIN2 = PAout(12)`） | `MOTOR/motor.h` |
| 电机 A 方向 | **PA15** | GPIO 输出（`AIN2 = PAout(15)`） | 同上 |
| 超声波 ECHO | **PB0** | TIM3_CH3（输入捕获） | `TIMER/timer.c` |
| **电池电压 ADC** | **PB1** | **ADC1_IN9** | `ADC/adc.c` |
| 电机 B 方向（反相） | **PB4** | GPIO 输出（`BIN1 = PBout(4)`） | `MOTOR/motor.h` |
| 电机 A 方向（反相） | **PB5** | GPIO 输出（`AIN1 = PBout(5)`） | 同上 |
| 右编码器 A 相 | **PB6** | TIM4_CH1 | `ENCODER/encoder.c` |
| 右编码器 B 相 | **PB7** | TIM4_CH2 | 同上 |
| CAN1 RX | **PB8** | CAN1（`CAN1_Mode_Init(1,...)`，main 中已启用） | `CAN/can.c` |
| CAN1 TX | **PB9** | CAN1 | 同上 |
| **软件 I2C SCL**（MPU6050） | **PB10** | GPIO（`IIC_SCL = PBout(10)`） | `IIC/IOI2C.h` |
| **软件 I2C SDA**（MPU6050） | **PB11** | GPIO（`IIC_SDA = PBout(11)`） | 同上 |
| 板载 LED | **PB13** | GPIO 输出 | `LED/LED.H` |
| 用户按键 | **PB14** | GPIO 输入 | `KEY/key.h` |
| **MPU6050 INT** | **PB15** | EXTI15（控制中断源） | `EXTI/exti.c` |
| **OLED DC** | **PC0** | GPIO 输出 | `OLED/oled.h` |
| 超声波 TRIG | **PC2** | GPIO 输出 | `TIMER/timer.c` |
| 航模遥控 CH1 | **PC6** | TIM8_CH1（输入捕获） | `TIMER/timer.c` |
| 航模遥控 CH2 | **PC7** | TIM8_CH2 | 同上 |
| **OLED SCL** | **PC13** | GPIO 输出（软件 SPI） | `OLED/oled.h` |
| **OLED SDA** | **PC14** | GPIO 输出（软件 SPI） | 同上 |
| **OLED RST** | **PC15** | GPIO 输出 | 同上 |
| SWD 调试口 | **PA13 / PA14** | SWDIO / SWCLK | **不可占用** |

> **OLED 用的是软件 SPI（4 线）**，不是 I2C —— 这与旧基底（OLED 走 I2C）不同。
> MPU6050 才是走软件 I2C（PB10/PB11）。

---

## 三、★ 空闲资源（外挂模块的接入点）

### 3.1 空闲且支持 ADC 的引脚 —— 气体传感器必须用这些

以下 8 个引脚**源码中未被任何启用路径引用**，且具备 ADC 功能：

| 引脚 | ADC 通道 | 备注 |
|---|---|---|
| **PA4** | ADC12_IN4 | 空闲 |
| **PA5** | ADC12_IN5 | 仅出现在**已禁用**的 SPI1（NRF24L01）路径 |
| **PA6** | ADC12_IN6 | 仅出现在**已禁用**的 SPI1 路径 |
| **PA7** | ADC12_IN7 | 仅出现在**已禁用**的 SPI1 路径 |
| **PC1** | ADC123_IN11 | 空闲 |
| **PC3** | ADC123_IN13 | 空闲 |
| **PC4** | ADC12_IN14 | 仅出现在**已禁用**的 NRF24L01 路径 |
| **PC5** | ADC12_IN15 | 仅出现在**已禁用**的 NRF24L01 路径 |

> **为什么可用**：`main.c` 中 `NRF24L01_Init()` 与模块自检**均被注释掉**，SPI1 也随之不启用。
> 因此 PA5/PA6/PA7 与 NRF 的 PC4/PC5 实际处于空闲状态。

### 3.2 空闲的数字 IO

| 端口 | 空闲引脚 |
|---|---|
| GPIOA | PA4, PA5, PA6, PA7（**PA13/PA14 为 SWD，保留**） |
| GPIOB | PB2, PB3, PB12 |
| GPIOC | PC1, PC3, PC4, PC5, PC8–PC12 |
| GPIOD | PD0, PD1, PD2 |

### 3.3 原理图上的物理接口（**供参考，需实物复核**）

从主板原理图读到以下预留接口（该 PDF 为 2020 年版，与源码版本可能不一致）：

| 接口 | 丝印 | 引出信号 |
|---|---|---|
| **NRF24L01 无线模块接口** | Header 4X2 | **PC4、PA7、PB12、3V3** / **PA6、PA5、PC5、GND** |
| 超声波接口 | J2 | 5V、PB1、PB0、GND |
| 蓝牙接口 | Header 4 | 5V、PA3、PA2、GND |
| 拓展电源 | Header 4X2 | 5V / GND 多路 |
| PC6~9 | Header 4 | PC9、PC8、PC7、PC6 |
| 电机编码器接口 1 / 2 | J10 / J8 | 电机相线 + 编码器 + 5V + GND |
| SWD（STLINK/JLINK） | — | GND、IO、SCK、3V3 |
| CAN | Header 2 | CANH、CANL |
| 拓展 Arduino nano 接口 | — | 大量引脚（仅在改用 Arduino 控制时才用） |

> ⭐ **最重要的发现**：**NRF24L01 接口（2×4 排针）同时引出了 PA5、PA6、PA7、PC4、PC5 五路空闲
> ADC 引脚 + 3V3 + GND**。由于 NRF24L01 在源码中已禁用、本项目也不需要，**这个接口是两路气体
> 传感器模拟信号最理想的接入点**——插上杜邦线即可，**不需要改板**。

---

## 四、本项目外挂模块的引脚分配建议

| 模块 | 数量 | 信号 | 建议引脚 | 备注 |
|---|---|---|---|---|
| **MQ-2 气体传感器** | 1 | AO（模拟） | **PA5** | 经分压后接入；可选 NRF 接口第 4 脚 |
| **MQ-135 气体传感器** | 1 | AO（模拟） | **PA6** | 经分压后接入；可选 NRF 接口第 2 脚 |
| **DHT11 温湿度** | 1 | 单总线 | **PB3** 或 **PC1**（纯 GPIO） | 需 4.7k 上拉至 3.3V |
| **红外避障（左/右）** | 2 | GPIO 输入 | **PA4**、**PA7** | 或 PC3、PC8 |
| **蜂鸣器** | 1 | GPIO 输出 | **PB12** | 5V 蜂鸣器需三极管驱动 |
| 备用 | — | 模拟/数字 | **PC3、PC4、PC5、PC8–PC12** | 余量充足 |

**占用统计**：气体占用 PA5/PA6，数字占用 PB3、PA4、PA7、PB12，**仍余 PC1/PC3/PC4/PC5/PC8–PC12 等 8 个以上**。

### 4.1 供电

| 需求 | 方案 |
|---|---|
| 气体传感器加热丝 **5V / 约 300mA（两路）** | 从**拓展电源接口**或**超声波接口的 5V 脚**取电；**不可用 NRF 接口的 3V3**（电流与电压都不够） |
| 信号参考地 | 与主板共地（NRF 接口第 8 脚即为 GND） |

> **务必现场核算**：该车为 2S/3S 锂电 + 12V→5V 稳压模块。两路 MQ 加热丝约 300mA，
> 需确认 5V 稳压模块与走线的余量（见 `sensor_interface_notes.md` 的供电注意）。

---

## 五、实物复核进度（2026-09-22 更新）

### 5.1 ✅ 已确认（由实物照片与组员现场核对）

- [x] **主控**：车上为 **STM32F405RGT6**（照片可见主控丝印）
- [x] **底板控制板插座 = 60 针（2×15 ×2）**（组员实物确认）
- [x] **控制板对接排针 = 60 针（2×15 ×2）**（照片丝印 15 行 ×2 列 ×2 侧）
      → **两者可对插**，此前"48 针"的疑点解除（详见 `car_composition.md` 第 6.4 节）
- [x] **MPU6050 走软件 I2C**：实物丝印明确标注 `SCL=PB10` / `SDA=PB11` / `INT=PB15`
      ← 与源码 `IOI2C.h`（`IIC_SCL=PBout(10)`、`IIC_SDA=PBout(11)`）、`exti.c`（PB15）**完全一致** ✅
- [x] **用户 LED = PB13、用户按键 = PB14**（实物丝印 `USERLED-B13` / `USERKEY-B14`）← 与源码一致 ✅
- [x] **底板上未被启用的插座**（组员现场确认）：
      FOR NANO 排针、左下 4×2（J6）、蓝牙旁空位（推测可放 MPU6050）、右上"串口 4"、
      左上 IIC、开关右侧 J2（可插超声波）
- [x] **拓展板与底板通过排针排母连接**（非焊接）

> **重要结论**：源码的引脚分配与实物丝印**逐项吻合**，因此本文件第二节的"已占用引脚表"**可信**。

### 5.2 ✅ 已确认（2026-10-15 现场实测补齐）/ ⬜ 仍需确认

**✅ 已在真机上收口**（详见 [`../design_firmware/真机联调问题清单.md`](../design_firmware/真机联调问题清单.md) §6/§7）：

- [x] **蓝牙模块的实际波特率** → **115200 可用**（JDY-33 已配名 `Pie` / 密码 `6667` / 115200、当前从机 `AT+TYPE0`；另一颗是 DX-Smart 克隆、老式 HC-06 方言、**纯从机、改不了**）。
      ⚠️ 但 **Windows 蓝牙 SPP 能配对、建不出 COM 口**，`pybluez2` 在 Python 3.13 上编译不过 ⇒ **联调主线走有线（USART1）**
- [x] **NRF24L01 接口就是底板左下角的 `J6`（4×2）**，引脚定义与实物丝印逐项吻合（`PC4/PA7/PB12/3V3` + `PA6/PA5/PC5/G`）——**本项目已用它引出 PA5/PA6 做两路气体**
- [x] **车上现跑固件不是原始版本**（照片里 OLED 显示 `Angle_Balance/Gyro_*` 而非原版 Kalman 界面）→ 已由本项目自己的固件取代

**⬜ 仍需现场实测**：

- [ ] **NRF24L01 接口是否焊有排针**（照片中该位置需再看清；有座但未焊针的情况常见）
- [ ] **具体 5V 取电点的位置**（拓展电源口 / 超声波口的 5V 脚哪个更好接）
- [ ] **控制板 60 针接口的完整信号映射**（已按照片丝印整理，见 `car_composition.md` 第 5.4 节，需交叉验证）
- [ ] **MQ 模块的 `RL` 与清洁空气 `R0`**（关系到 ppm 精度；`Rs/R0` 相对量不受 `RL` 影响）
- [ ] **轮径与编码器线数**（`app_config.h` 暂定 ⌀67 mm / 1560 counts-per-rev，不实测则"轮速 mm/s"只是按假设换算）

> ⚠️ **第四节（外挂分配建议）是开工前的"建议值"，不是最终引脚** ——
> **最终引脚请看 [`../../AGENTS.md`](../../AGENTS.md) §7「关键网络与引脚（速查）」**（与完工快照一致）：
> 气体 `PA5`/`PA6`、DHT11 **`PA7`（`J9`）**、红外 L/R **`PB12`/`PC1`（`J11`/`J14`，DNP）**、
> 蜂鸣器 **`PC5`（`J18`，有源低电平响）**、超声波 **`PC4`(TRIG)/`PB0`(ECHO)（`J5`）**。

---

## 六、与立项文档的差异（需同步修订）

本项目任务书（已提交）中关于 B 角色的描述与本基底存在一处**实质差异**：

| 项目 | 任务书中的描述 | 本基底实际情况 | 处置 |
|---|---|---|---|
| RTOS | "Keil 开发环境搭建、**FreeRTOS 移植**" | **无 FreeRTOS**，为裸机超级循环 | **已决策**：采用**混合架构**——平衡控制保留在 MPU6050 中断中（5ms/10ms 节拍不变），新增气体采集、通信、任务状态机、界面进 FreeRTOS 任务。详见 `design_firmware/architecture.md` |
| 固件库 | 未明确 | **标准外设库**（非 HAL） | 报告技术选型需相应表述 |
| 姿态算法 | 未明确 | 默认**卡尔曼滤波**（已选定沿用） | 与用户决定一致 ✅ |
| IMU | MPU6050 | **MPU6050 板载** | 一致 ✅ |
| 上位机 | Qt C++ 自行开发 | 本基底自带 DataScope 协议与厂商上位机 | 可参考其协议，但 C 仍自研（维持原决定） |

---

## 七、变更记录

| 日期 | 内容 |
|---|---|
| 2026-09-22 | 初版：以 MiniBalance V5.0 高配版（F405RGT6）**卡尔曼滤波版源码**为准，逐脚扫描全部用户代码；原理图仅作物理接口参考 |

---

> **项目归属**：中国石油大学（华东） 专业生产实习课程项目<br>
> **范围说明**：本项目不涉及 MiniBalance 控制板（STM32F405RGT6 版本）的硬件设计与改版；控制板直接沿用，A1 仅重做主底板。<br>
> **许可**：原创代码与文档采用 MIT License；第三方组件遵循各自原始许可证。
