pierrotto12138-code/balance-car-inspection-robot/docs/design_hardware/上板测试记录.md

# 上板测试记录（焊接 · 上电 · 自检 · 遗留项）—— 角色 A1 交付物

> **对应任务书**：§二 A1「提交材料：电路原理图、PCB 设计文件、电路设计说明文档、BOM 表、**电路焊接、测试**」；
> 项目计划书 A1 成果里另列「**焊接完成的实物板、供电与信号测试记录**」。
> **本文件就是那份"焊接 + 测试"记录**：把"板子怎么来的 → 怎么焊的 → 上电做了什么检查 → 逐项自检结论 → 还剩什么没测"写成可核对的一条链。
> **写法约定**：只写**有出处**的数（谁测的、在哪份文件里能查到）；**没有测量记录的一律标"未留痕 / 待补"，不填估值**。
> 判据与操作步骤不重复抄，直接引用 [`上板自检清单.md`](上板自检清单.md) 的对应小节。

---

## 1. 板子是怎么来的（制板 + 采购）

| 项 | 值 | 出处 |
|---|---|---|
| PCB 打样 | 嘉立创订单 **`8942344A_Y2`**：2 层 / FR-4 / **板厚 1.6 mm** / **1 oz 铜** / **有铅喷锡** / 绿油白字 / 过孔盖油；下单 **2026-10-08 17:28**，交付 **2026-10-10 20:00**，制板费 ¥53（5 片，非 SMT） | [`hardware/gerber/README.md`](../../hardware/gerber/README.md) §二/§三（源自嘉立创工艺档 `YG/4te.json`）|
| Gerber（下单件，**脱敏版**） | [`hardware/gerber/26测控系统设计_PCB2_20261008_170436.zip`](../../hardware/gerber/26测控系统设计_PCB2_20261008_170436.zip)（EDA 一键导出；丝印姓名笔画已移除，未脱敏原件在仓库外 `…\260921Task_私有资料\作业补充\A1\_未脱敏原件\`）| 同上 |
| 元件采购 | 立创商城订单 **`SO26101014446`**（2026-10-10，17 项，商品 ¥71.07 + 运费 ¥17.00） | [`hardware/bom/采购记录_立创商城_SO26101014446.md`](../../hardware/bom/采购记录_立创商城_SO26101014446.md) |
| 设计 BOM | 52 位号 / 27 行 / 52 个立创料号 | [`BOM表.md`](BOM表.md) |

---

## 2. 焊接

| 项 | 内容 |
|---|---|
| 焊接方式 | **手工焊接**（本板非 SMT 贴片单，`isMadeSmt=false`）；贴片用 0805 阻容 + SSOP-24 芯片 |
| 重点件 | `U1` **TB6612FNG（SSOP-24，0.65 mm 脚距）**、`U2` **LM2596S（TO-263，需大面积散热铜）**、`D1`（ES2D，注意极性）、`C1`/`C2`/`C13`（**电解，有极性**）、`J1`/`J2`（2×15 共 60 针，**须与 60 针控制板对插顺畅**）|
| 焊接要点与踩过的坑 | 见 [`焊接调试手册.md`](焊接调试手册.md)（飞线预案、验证清单）；SSOP-24 连锡/虚焊是本板最需要放大镜检查的地方 |
| **实物证据（4 张实拍）** | [`新版底板_焊接重点处.jpg`](../../hardware/photos/新版底板_焊接重点处.jpg)（电源区 + `U1`/`U2` 近景）、[`新版底板_上车俯视.jpg`](../../hardware/photos/新版底板_上车俯视.jpg)（整板全貌）、[`新版底板_上车正面.jpg`](../../hardware/photos/新版底板_上车正面.jpg)、[`新版底板_上车背面.jpg`](../../hardware/photos/新版底板_上车背面.jpg)（背面焊点/走线）<br>⚠ 丝印文字块（校名/组名/组员姓名）已在仓库内打码，说明见 [`hardware/photos/README.md`](../../hardware/photos/README.md) |
| 焊接结论 | ✅ **焊好后整机可上电、可烧录、可平衡、可跑巡检**（见 §4）——即"焊接完成且功能可达" |

---

## 3. 上电与供电检查

> 判据与操作见 [`上板自检清单.md`](上板自检清单.md) §1（上电前，万用表）与 §2（上电检查，先不下载程序）。
> **本节如实区分「有测量记录」与「只有间接证据」**。

| 检查项 | 判据 | 实测/证据 | 状态 |
|---|---|---|---|
| 上电前 `+12V`/`+5V`/`+3.3V` 对地短路检查 | 万用表电阻不为 0 | **无书面留痕**（当时未记录）；板子长期正常工作可作为"无短路"的旁证 | ⬜ **未留痕** |
| `+12V` / `+5V` / `+3.3V` 三轨电压值 | 12 V 电池经 LM2596→5 V→AMS1117→3.3 V，误差在器件容差内 | ✅ **2026-10-16 由 A1 实测确认"三轨电压正常"**（口头确认，**未记具体数值**）；另有**机内实测**：`0x15` 电池 **11.53 V**（2026-10-16，`hardware/test_records/03_probe_readback.txt`）；间接证据：**OLED 三页正常**（⇒3.3 V 稳）、DHT11/MQ 读数正常（⇒5 V 稳）、电机能驱动（⇒12 V 通路正常）| ✅ **正常**（数值未留痕）|
| 电池电压 | 正常 11.1~12.6 V | **11.8 V 实测**（2026-10-15 台架） | ✅ |
| 指示灯 `D2`(3V3)/`D3`(12V)/`D4`(5V) | 上电即亮 | 未逐项记录（照片中可辨） | ⬜ 未留痕 |
| 上电后有无异常发热/冒烟 | 无 | 无（否则不可能完成两轮联调） | ✅ |
| 板载 CH340G 串口枚举 | 设备管理器出现 `USB-SERIAL CH340 (COMx)`（本机 **COM3**） | ✅ 实测枚举成功（真机联调即经它通信） | ✅ |

> ⚠️ **要补的动作**（只需万用表，5 分钟）：上电后测 `J15` 的 `5V`/`GND`、`+3V3`/`GND` 与 `J17` 的 `12V`/`GND` 三处电压，**把数值填回上表**。
> 2026-10-16 A1 已确认"三轨正常"，但**没有把数值写下来** ⇒ 本文件只能记到"✅ 正常（数值未留痕）"。

---

## 3.5 真机测试记录（2026-10-16，只读）

> **原始输出全部在 [`hardware/test_records/`](../../hardware/test_records/README.md)**（`tune.py` 与 `host.exe` 的 stdout + 观测 CSV，
> 入库时不手工誊抄）。环境：板载 CH340G → **COM3**、115200 8N1、固件版本字节 **`0xAF`（10-15）**、
> 台架只有 MQ-135（插 `J13`）、**车处于非平衡位（俯仰 ≈ −79°）且已安全锁存**。
> ⚠️ 因此这批数据**只证明"链路 / 协议 / 传感器 / 参数回读"是好的**，不能用于评价平衡或运动性能。

| 项 | 实测 | 出处 |
|---|---|---|
| 有线链路 | 收 9401 B / 发 426 B · **解帧 611 · 丢帧 0** · 格式错帧 0 · 协议外命令 0 · 重复帧 0 | `03_probe_readback.txt` |
| 上行帧率 | `0x10/0x11/0x12` ≈ **14.8 Hz**（12 s 内 177~178 条）；`0x14/0x15/0x16` ≈ 0.75 Hz；`0x1F` 心跳 45 条；`0x13` 事件 0 条 | 同上 |
| 观测模式 | `--observe 20` 收 **1560 帧 ≈ 77 Hz**（工具标称 100 Hz 观测）；20 s 内**俯仰标准差 0.02°、峰峰 0.09°、零穿越 0** | `02_observe_20s.txt` / `.csv` |
| 参数实际生效值 | **`300 / 1 / +80 / +0.4 / 0.5 / 52 / 0.5`**（7/7 回显、全部在范围内）——与决策 77/78 的本机定稿一致 | `01_param_dump.txt`、`03_probe_readback.txt` |
| 电源 | **11.53 V**（报警线 11.10 V） | `03_probe_readback.txt` |
| 安全状态 | **已安全锁存**（`0x16` bit0 `Flag_Stop=1`、bit1 电机被禁=1、bit2 `Set_pwm=0`）⇒ 车不会动，需重下任务解除 | 同上 |
| 气体 / 温湿度 | MQ-135：4.1 ppm、原始 ADC **122**、就绪 ✔；MQ-2：0.0 ppm、原始 ADC 1、就绪 ✘（`J10` 空）；DHT11 28.0 ℃ / 69.0 %RH ✔ | 同上 |
| **MQ-135 反推交叉验证** | `AO —10k—┬— PA5 —15k— GND`（分压比 0.600）⇒ `V(AO) ≈ 122/4095×3.3/0.6 ≈ **0.16 V**`，落在"MQ-135 洁净空气 0.1–0.3 V"区间（外部资料）⇒ **模块在测、分压通路与 ADC 通道都对** | 计算过程见 [`hardware/test_records/README.md`](../../hardware/test_records/README.md) §三 |
| **★ 平衡观测（车立起来后，`--enable` 保活）** | 20 s / 1561 帧 ≈ 77 Hz：**俯仰 均值 +0.86°、标准差 0.79°、峰峰 3.70°、过均值线 35 次 ≈ 0.86 Hz 摆动**；横滚 −1.05°±0.39° | [`hardware/test_records/05_observe_balance_20s.csv`](../../hardware/test_records/05_observe_balance_20s.csv) |
| **★ `CCR/\|Moto\|` 真机证实 = 1.17** | 带使能观测 30 s 里 **20 个"未保护"样点**的比例中位数 **1.168**（1.167–1.170）⇒ 既有口径"`CCR ≈ 1.17×\|Moto\|`"成立；⚠ **只在未保护时**可作判据（保护态下见到 0.057 / 0.408，是 `Moto` 为"算出来的值"所致）| [`hardware/test_records/07_observe_balance_enabled.csv`](../../hardware/test_records/07_observe_balance_enabled.csv) |
| 蓝牙（COM4/COM5） | 两个 SPP 端口**都能打开**（Windows 现在能枚举出"蓝牙链接上的标准串行"），但 **8 s 收 0 B** ⇒ **端口可建、数据未通** | `04_probe_bt_COM4/5.txt` |

**顺带发现并处置的问题**（详见 [`hardware/test_records/README.md`](../../hardware/test_records/README.md) §四）：
① `tune.py --observe` **会把正在平衡的车"探停"**（500 ms 无下行帧即锁存）⇒ 已加 `--keepalive`/`--enable` 两个开关，**观测运行中的车必须加 `--enable`**；
② "零穿越"统计**恒为 0**（重复样点使"极值乘积"恒为 0）⇒ 改为"**穿过均值线的次数**"，并修掉一处处 off-by-one；
③ `--probe-readback` 的"本机定稿值"表仍是旧值 ⇒ 已改为 7 个实际值并重编（`ctest` 7/7）；
④ **待 B 确认**：保护态下不该用 `CCR/|Moto|≈1.17` 判"已执行"（真机反证：未保护时该比例稳定 1.167–1.170）；`0x16` 的 `Bal` 与 `0x10` 俯仰量级不一致。

---

## 4. 逐项自检结论（按 [`上板自检清单.md`](上板自检清单.md) 的小节）

> 判据、操作与排障方向不在此重复；只记**结论 + 证据出处**。两轮真机联调的完整过程与根因分析见
> [`../design_firmware/真机联调问题清单.md`](../design_firmware/真机联调问题清单.md)（第一轮 2026-10-13 / 第二轮 2026-10-15）。

| 自检清单小节 | 结论 | 证据 |
|---|---|---|
| §1 上电前（不通电，万用表） | ⬜ 未留痕 | 见 §3 |
| §2 上电检查（先不下载程序） | 🔶 间接通过（OLED/传感器/电机工作） | 见 §3 |
| §3 烧录与"能不能跑起来" | ✅ 通过 | 两轮联调均完成烧录；`0x16` 可读**固件版本字节 `0xAF`（10-15）**，用于"一眼判断板上是哪版固件"（决策 79）|
| §4 人机界面（OLED + 按键 + 蜂鸣器） | ✅ 通过 | **OLED 页 0/1/2 + 厂商页均正常显示**（早期"乱码/压字"已修并复核，`人机界面设计说明.md` §3）；按键三手势（单击启停 / 双击切页 / 长按避障）可用 |
| §3.5 结构整改后的专项观察 | ✅ 已执行 | 问题清单 §7.1/§7.2（`Delay_SetMsHook` 注入、`board_state` 单一出口等上板确认项）|
| §5 双链路通信 | 🔶 **有线实测通过，蓝牙仍未通** | 有线（`USART1`/COM3）：**2026-10-16 实测** 解帧 611 / 丢帧 0 / 格式错帧 0（[`hardware/test_records/03_probe_readback.txt`](../../hardware/test_records/03_probe_readback.txt)）；此前两轮：解帧 375 条、318 条 + 7 条 `0x24` 回读。蓝牙：**模块侧 115200 已确认**、Windows **已能枚举出 SPP 端口（COM4/COM5）**，但打开后 **8 s 收 0 B** ⇒ 仍是"端口可建、数据未通"，联调/演示主线继续走**有线** |
| §6 电机 / 编码器 / 姿态 | ✅ 通过 | 编码器分侧极性与电机方向已定稿（决策 62/71）；`0x16` 三环实况可读（`Bal`/`Vel`/`Turn`、`Moto` 与 `CCR` 关系 `CCR≈1.17×|Moto|`）|
| §7 平衡验证 | ✅ 通过（2026-10-16 补了量化数据） | **真机可稳定平衡**，出厂参数定稿（`Balance 300/1`、`Velocity +80/+0.4`、`Zhongzhi 0.5`、`Turn 52/0.5`），见问题清单 §8.1 —— 注意 `-80/-0.4` 曾被参数下限拒绝、**实际生效是 `+80/+0.4`**（决策 77）。★ 2026-10-16 **带使能观测 20 s**：俯仰 **标准差 0.79°、峰峰 3.70°、摆动 ≈0.86 Hz**（[`hardware/test_records/05_observe_balance_20s.csv`](../../hardware/test_records/05_observe_balance_20s.csv)）|
| §8 传感器标定与告警验证 | 🔶 部分 | DHT11 正常（`statusBits` bit2 置位）；**台架只有 MQ-135（插在 `J13`，`J10` 空，MQ-2 模块已烧毁待补）** ⇒ 名为 `MQ2`(`PA5`) 的那一路才是真在工作的；**MQ 的 `RL` 与 `R0` 仍未实测**（`gas.c` 参数待填）|
| §9 排障速查 | —（工具性章节） | — |

---

## 5. 结构接口实测值（**A1 提供给 A2** 做装配图/外壳）

> 出处：**五路独立互证** —— ① EDA 完工快照 `PCB2.epcb2` 的 `BOARD_OUTLINE`；② 下单 Gerber 的 `Gerber_BoardOutlineLayer.GKO`；
> ③ 嘉立创生产档（`ko` + 钻孔档）；④ PCB 渲染图按预测坐标逐孔核对；⑤ **EDA 自己导出的板信息报告**
> [`Info_PCB_PCB2_2026-10-16.txt`](../../hardware/eda_export_20261016/Info_PCB_PCB2_2026-10-16.txt)（"板子尺寸: 100mm x 65mm"）。
> 详见 [`hardware/gerber/README.md`](../../hardware/gerber/README.md) §五。

| 项 | 实测值 |
|---|---|
| **板框外形** | **100.00 × 65.00 mm**（长 × 宽） |
| **四角圆角** | **R5.0 mm** |
| **成品板厚** | **1.6 mm**（±10 %） |
| **安装孔** | **3 个 ⌀3.2 mm**（通孔，走铣槽），孔心以**板左下角**为原点：**(6.0, 6.1) mm**（左下）、**(94.0, 6.1) mm**（右下）、**(6.0, 58.9) mm**（左上）——**右上角无孔**（该角落是 MQ 座 `J13`/`J10` 与 `J17` 区）|
| 60 针控制板插座位置 | `J1` @ (3106, 1785) mil、`J2` @ (1353, 1785) mil（板中部，两排 2×15）|
| 板上开孔/高器件（供开孔用） | OLED 在**控制板**上（不在本板）；USER 按键 `PB14`、LED `PB13` 在控制板上；蜂鸣器座 `J18`、MQ 座 `J13`/`J10`、DHT11 座 `J9`、超声座 `J5` 在本板 —— 具体坐标见 [`pin_assignment.md`](pin_assignment.md) 与渲染图 |
| 器件最高点 | ⬜ **待实测**（A2 需要"板面到最高器件的净高"来定外壳内部空间；本板最高的应是 `C1`/`C2` 电解 10.2 mm 与 `L1` 电感）|

> ⚠️ **口径更正**：此前 `交接说明.md` §3.5/§7 与 `电路设计说明文档.md` §10.1 写"**100 × 60 mm、圆角 R2.5、4 个 ⌀1.6 mm 安装孔**"**三处都错**（y 跨度 65 误读成 60；把圆形图元线宽当弧半径；把 `CIRCLE` 的半径 62.9921 mil 当直径；把 3 个孔数成 4）——**以本表为准**。原因与三处证据见 [`../../hardware/gerber/README.md`](../../hardware/gerber/README.md) §五。

---

## 6. 遗留待测项（截至 2026-10-16）

> 与 [`电路设计说明文档.md`](电路设计说明文档.md) §11.3「尚未闭环的验证项」同源，状态已按最新事实更新。

| # | 项 | 状态 | 谁能做/怎么做 |
|---|---|---|---|
| 1 | 三轨电压（12/5/3.3 V）与上电前短路检查 | ⬜ **待测** | A1：万用表，见 §3 提示 |
| 2 | 电机/编码器插上后方向与计数（`CN1`/`CN2` 座序实物确认） | ✅ **已闭环** | 座序已按实物丝印核实（[`电路设计说明文档.md`](电路设计说明文档.md) §4.3），真机方向已定稿（决策 62/71）|
| 3 | MQ 模块 `RL` 实测值 | 🔶 **仍无实测，但已确认不阻塞主判据**（详见 §6.1） | `firmware/App/Sensor/gas.c` 现用占位值 **10 kΩ**（源码注释里写明两个已知数据点：10 kΩ / 1 kΩ）；`RL` 只影响 **ppm 绝对值**，**`Rs/R0` 主链路的相对比较不受影响**（R0 同系数抵消）|
| 4 | 蓝牙模块波特率 115200 | ✅ **模块侧已确认**（JDY-33） | ⚠ 2026-10-16 实测：Windows **已能枚举出 SPP 端口 COM4/COM5**，但打开后 **8 s 收 0 B** ⇒ 端到端仍未验；联调主线走有线 |
| 5 | `J13.2`(DO)→`PB3` 是否与烧录冲突（`PB3`=JTDO） | ✅ **不冲突** | 判据：本板烧录只用**串口 ISP（板上 CH340G，FlyMcu）**或 **SWD（`make flash`）**，两者都不使用 JTAG 的 `JTDO` |
| 6 | 板厚 / 铜厚 / 表面处理 | ✅ **已闭环** | 1.6 mm / 1 oz / 有铅喷锡，出自嘉立创工艺档（[`hardware/gerber/README.md`](../../hardware/gerber/README.md) §三）|
| 7 | 电机额定/堵转电流（电源支路核算要用） | ✅ **已闭环（按型号规格，非本机实测）** | 电机铭牌型号 **MG513P3012V**（MG513 系列 / P30 减速 / 12 V）。同型号第三方规格：**额定 1.44 A、堵转 4 A**、额定扭矩 1.6 kg·cm、4 W、空载 330~366 RPM、编码器 13 ppr（四倍频 1560/圈）——见 §6.2 |
| 8 | MQ-2 模块补件后装回 `J10` | ⬜ **待采购** | 装回后**不需要**改固件（角色↔座的指派已按台架现状做过，装回 `J10` 后两路各自就位即可）；只需撤掉文档里"只有 MQ-135 有数"的限制语（决策 76）|
| 9 | **保护态下不要用 `CCR/\|Moto\|≈1.17` 判"已执行"** | ⏳ **待 B 确认判据** | 真机三组数据：未保护 **1.168**（20 样点）/ 锁存 `Moto −8200→CCR 471`（0.057）/ 锁存 `Moto −2055→CCR 838`（0.408）。建议 `host --probe-readback` 在 `Flag_Stop`/锁存位置位时**不按比例判**，只报"保护中"（与铁律 42 的"分级"同源）|
| 10 | `0x16` 的 `Bal` 与 `0x10` 的俯仰**量级不一致** | ⏳ **待 B 确认** | 同一次采样里 `Bal = −2055`、俯仰 = `−6.41°`；`host` 的 ±40° 判读用的是 `0x10`，`Bal` 的零点/标度需澄清 |
| 11 | 电机堵转电流（8 A 最坏情况）的**实测** | ⬜ 可选 | 现按同型号规格估算（额定 1.44 A / 堵转 4 A）；若报告要写"实测"，需串表测一次 |

### 6.1 关于 MQ 的 `RL`（负载电阻）—— 为什么"没实测"不影响结论

`RL` 直接进 `Rs` 的换算（`Rs = (VCC × RL)/Vao − RL`），所以 **`RL` 错 ⇒ `Rs` 错 ⇒ `ppm` 整体偏一个系数**；
但本项目**主链路判据用的是 `Rs/R0` 相对量**（决策 8），`R0` 与 `Rs` 同系数 ⇒ **相对比较不受 `RL` 影响**。
`gas.c` 的注释已经把这件事写清楚，并列出两个真实数据点（`MQUnifiedsensor` 默认 10 kΩ、`RobotnikAutomation` 改成 1 kΩ）。

**外部参考资料（A1 于 2026-10-16 检索，非本机实测，仅用于"量级参照"）**：

| 结论 / 场景 | 实测值（AOUT↔GND） | 来源类型 |
|---|---|---|
| "洁净空气"理论范围 | 0.1 V – 0.3 V | 厂商/模块商规格书 |
| 室内正常空气（Arduino ADC≈150） | ≈0.73 V | 高校实验文档 |
| 正常空气基线参考 | 0.208 V（对应约 398.55 ppm CO₂） | 学术论文标定 |
| 室外背景 CO₂（≈415 ppm） | Rs ≈ 82.25 kΩ（需自行换算电压） | 大学研究报告 |
| 酒精 / 打火机气体（污染空气） | ADC 700–750 ⇒ ≈3.4–3.7 V | 高校实验文档 |
| 实际 CO₂ 响应（440 ppm） | 1.29 V（该研究用特定电路，读数偏高） | 学术期刊 |

> **关键备注（来自该资料，与本项目结论一致）**：① "理论值不唯一"的根因就是模块 `RL` 不同（常见 1 kΩ / 10 kΩ / 20 kΩ）
> 且不同厂商标称的洁净空气基准不同 ⇒ **这些电压不能反过来当本机的 `RL` 依据**；
> ② 任何有意义的实测都要建立在**充分预热**（≥20 s 初步稳定，严格标定 24–48 h）之上。
> **本机交叉验证**：由 `0x14` 的 MQ-135 原始 ADC（122）按分压比 0.600 反推 **`V(AO) ≈ 0.16 V`**，
> 正落在"洁净空气 0.1–0.3 V"区间 ⇒ **模块在测、通路正确**（计算过程见 [`hardware/test_records/README.md`](../../hardware/test_records/README.md) §三）。
> **要真正闭合 `RL`**：看 MQ-135 模块上那颗负载电阻的丝印（`102`=1 k / `103`=10 k / `104`=100 k），或万用表量 `AOUT`↔`GND`（比较器输入高阻，几乎不并联影响）；
> 若板上有电位器且量值随旋钮变化，说明**电位器就是 `RL`**（`gas.c` 注释里的判据）。

### 6.2 电机规格与一处电源核算提示（`MG513P3012V`）

| 项 | 值 | 出处 |
|---|---|---|
| 型号（铭牌） | **MG513P3012V**（MG513 系列，P30 = 1:30 减速，12 V） | A1 现场读铭牌（2026-10-16）|
| 额定电压 / 减速比 / 空载转速 | 12 V / 1:30 / **空载 366 RPM** | 厂商使用手册（[`car_composition.md`](car_composition.md) §四）|
| 编码器 | 13 线霍尔，车轮一圈 390 脉冲、**四倍频 1560** | 同上 |
| **额定电流 / 堵转电流** | **1.44 A / 4 A**（同型号第三方规格） | [Robot-Maker：Moteur 12V MG513P30](https://www.robot-maker.com/shop/moteurs-et-actionneurs/617-moteur-12v-mg513p30-617.html)（`Courant 1.44A` / `Courant de blocage 4A`，扭矩 1.6 kg·cm、4 W、218 g）|
| ⚠ 对电源核算的意义 | 两路**同时堵转**时瞬时可达 **≈8 A**，而 12 V 主干走线按 **40~80 mil** 设计（[`电路设计说明文档`](电路设计说明文档.md) §3.3/§10.2）。**短时堵转**由电池与铜箔热容吸收通常没问题，但**长时间堵转/持续爬坡**需按此复核电池放电能力与走线温升 | 本条为**估算性提示**（堵转电流非本机实测），供 B 侧与报告复核，见 §6 第 11 项 |

---

## 7. 验收材料清单（对照 [`上板自检清单.md`](上板自检清单.md) §10）

> §10 要求"完成后留下 5 类记录"。逐类如实点名，**缺的直接写缺** —— 这几项是 A1 交付里最容易被打回的地方。

| # | §10 要求的记录 | 现状 | 在哪 / 缺什么 |
|---|---|---|---|
| 1 | 各表的**实测数据**（电压、现象、命令输出） | ✅ **主体齐备** | **三轨电压已由 A1 实测确认正常**（数值未留痕）；链路/帧率/电源/安全/传感器/参数回读的**原始输出**已入库 [`hardware/test_records/`](../../hardware/test_records/README.md)；仍缺"上电前对地短路检查"的书面记录 |
| 2 | `tune.py -p COMx --dump` 的**调参前后参数对比** | 🔶 **只有"前"（当前基线）** | `hardware/test_records/01_param_dump.txt` = 2026-10-16 的 7 个实际生效值；**"后"要等一次现场整定**（整定前后各 `--dump` 一次即可凑齐对比）|
| 3 | `tune.py --observe 20 --csv run1.csv` 的**观测 CSV** | ✅ **已留档（有效数据）** | 2026-10-16 **带使能观测**：[`hardware/test_records/05_observe_balance_20s.csv`](../../hardware/test_records/05_observe_balance_20s.csv)（8 列 × 1561 行，车在平衡中）+ 姿态统计（`05_…txt`）；另有 [`07_observe_balance_enabled.csv`](../../hardware/test_records/07_observe_balance_enabled.csv)（含 `0x16` 三环实况与 `CCR/\|Moto\|`）。⚠ 第一次没加 `--enable` 的跑是**无效数据**（车被探停），已按名保留为反例 `02_…_未加使能_车被锁存.csv` |
| 4 | 一条**完整任务链**记录（上电→预热→待机→下发任务→巡检〔含一次气体报警〕→返航→完成） | ⬜ **缺** | 需要车能站 + 场地 + 演示气源；目前只有分阶段结论（[`真机联调问题清单.md`](../design_firmware/真机联调问题清单.md) §8）|
| 5 | 三条**安全通道**验证记录（拔链路 500 ms 停 / 急停 `0x2F` / 低压·倾角保护） | 🔶 **逻辑已验；真机逐条留档仍缺** | 代码/事件码层已闭环（决策 47/57/64；事件码 `0x08` 失联 / `0x09` 解除 / `0x0A` 急停）；2026-10-16 只读到**当时正处于锁存态**（`Flag_Stop=1`、电机被禁），未主动制造三种触发 |

---

## 8. 变更记录

| 日期 | 内容 |
|---|---|
| 2026-10-16 | 初版：把 A1 的「电路焊接、测试」交付物落成可核对记录 —— 制板/采购（订单 `8942344A_Y2` + `SO26101014446`）、4 张实物照片索引、上电检查（区分实测与间接证据）、9 个小节的自检结论、**结构接口实测值（板框 100×65/R5/3×⌀3.2，供 A2）**、8 项遗留待测、§10 五类验收材料点名 |
| 2026-10-16（晚）| **v1.1：接入真机只读测试结果** —— ① §3 三轨电压改为"**A1 实测正常**（数值未留痕）"并补 `0x15` 机内实测 **11.53 V**；② **新增 §3.5 真机测试记录**（链路/帧率/参数回读/安全态/气体反推/蓝牙端口），原始输出入库 [`hardware/test_records/`](../../hardware/test_records/README.md)；③ §4 的 §5 行改为"有线实测通过、蓝牙端口可枚举但 0 B"；④ §5 结构接口补第 5 路证据（**EDA 官方板信息报告 `100mm x 65mm`**）与制造数据留档位置 [`hardware/eda_export_20261016/`](../../hardware/eda_export_20261016/README.md)；⑤ §6 更新：**MQ `RL` 说明 + 外部参考表 + 本机反推 0.16 V**（新增 §6.1）、**电机 `MG513P3012V` 额定 1.44 A / 堵转 4 A**（新增 §6.2，含两路同时堵转 ≈8 A 的核算提示）；⑥ §7 验收材料状态更新（观测 CSV ✅、三轨电压 ✅、参数对比只剩"后"）|
| 2026-10-16（夜）| **v1.2：真机"带使能"观测（车立起来后）** —— ① §3.5 新增两行：**平衡观测量化数据**（20 s：俯仰 均值 +0.86°、标准差 **0.79°**、峰峰 3.70°、摆动 ≈0.86 Hz）与 **`CCR/\|Moto\| = 1.168` 真机证实**（20 个未保护样点，1.167–1.170）；② §4 的 §7 平衡验证行补量化数据；③ §7 第 3 项（观测 CSV）改为 ✅ **有效数据**并说明"没加 `--enable` 的那次是无效数据"；④ §6 新增第 9~11 项（保护态比例判据、`Bal` 与俯仰量级、堵转电流实测）；⑤ 工具侧修复记入决策 84（`tune.py` 的 `--keepalive`/`--enable` 与"过均值线"振荡统计）|

---

## 9. 取材与溯源

| 内容 | 来源 |
|---|---|
| 工艺参数、订单号、钻孔统计、板框/安装孔几何 | [`hardware/gerber/README.md`](../../hardware/gerber/README.md)（解析自 Gerber 与嘉立创工艺档）|
| 元件采购 | [`hardware/bom/采购记录_立创商城_SO26101014446.md`](../../hardware/bom/采购记录_立创商城_SO26101014446.md) |
| 实物照片 | [`hardware/photos/`](../../hardware/photos/)（含打码说明）|
| **真机只读测试原始输出（2026-10-16）** | [`hardware/test_records/`](../../hardware/test_records/README.md)（`tune.py` / `host.exe` 的 stdout + 观测 CSV）|
| **正式作业提交包（角色 A1）** | 在**仓库外**：`…\260921Task_私有资料\正式作业提交\<组长姓名>+<项目名称>\A1_电路\`（**未打码原件**；含本说明文档的 **Word/PDF 交付版**、原理图 PDF/PNG/SVG、PCB 工程与 Gerber、BOM、焊接与测试原始记录、实物照片）—— 与仓库里的脱敏版成对（决策 83/85）|
| **EDA 一次性导出（制造与交付数据）** | [`hardware/eda_export_20261016/`](../../hardware/eda_export_20261016/README.md)（含 `Info_PCB` 板信息、PCB 出图 PDF/PNG、STEP、DXF、iBOM、坐标、网表）|
| 电机型号规格 | 铭牌 `MG513P3012V`（A1 现场读）+ [Robot-Maker MG513P30 规格页](https://www.robot-maker.com/shop/moteurs-et-actionneurs/617-moteur-12v-mg513p30-617.html)（额定 1.44 A / 堵转 4 A）|
| MQ 的 AOUT 参考区间（外部资料） | A1 于 2026-10-16 检索的公开资料汇总（见 §6.1；**非本机实测**）|
| 真机两轮联调过程与根因 | [`../design_firmware/真机联调问题清单.md`](../design_firmware/真机联调问题清单.md) |
| 判据与操作步骤 | [`上板自检清单.md`](上板自检清单.md)、[`焊接调试手册.md`](焊接调试手册.md) |
| 设计侧数据 | [`电路设计说明文档.md`](电路设计说明文档.md)（§10 PCB 设计说明 / §11 设计验证）|

---

> **项目归属**：中国石油大学（华东） 专业生产实习课程项目<br>
> **范围说明**：本项目不涉及 MiniBalance 控制板（STM32F405RGT6 版本）的硬件设计与改版；控制板直接沿用，A1 仅重做主底板。<br>
> **许可**：原创代码与文档采用 MIT License；第三方组件遵循各自原始许可证。
