pierrotto12138-code/balance-car-inspection-robot/docs/design_hardware/人机界面设计说明.md

# 人机界面设计说明

> 角色：**A2（结构）** —— 任务书要求的提交材料之一（依据：`../任务书_提取全文.md`
> 「外观与人机界面设计（造型、按键、显示器/语音界面）」→「…人机界面设计说明…」）。
> **写法**：软件侧**写实**（显示内容、页排布、按键语义、声光报警策略全部来自已实现的固件源码 `../../firmware/App/`，
> 坐标与代码逐条可查证）；硬件侧**留空**（开孔、视窗、按键实体布局、丝印见 §7 待补表，由 A2 实测/设计后填写）。
> 凡代码里查不到的尺寸/型号一律写 `[待补]`，**不做估算**（§7 结构项例外：2026-10-17 A2 已定统一按"在对应位置开框"处理）。

---

## 1. 概述

### 1.1 人机界面的三个通道

现场人机界面三条通道，全部由 STM32 固件独立完成，不依赖上位机：

| 通道 | 器件与位置（引脚） | 承担的职责 |
|---|---|---|
| **OLED 显示** | 0.96 寸 128×64 单色模块，**软件 SPI（4 线）**：`PC0`=DC、`PC13`=SCL、`PC14`=SDA、`PC15`=RST | 就地显示环境（双路气体浓度、Rs/R0、温湿度、报警标志）与巡检状态（阶段/任务/巡检点/通信统计） |
| **按键交互** | 板上 **USER 按键**（1 个），`PB14`（输入，上拉；丝印 `USERKEY-B14`） | 单击 = 启停；双击 = 切换 OLED 页；长按 = 普通/避障模式 |
| **声光报警** | 蜂鸣器 `PC5`（`J18`，**有源，低电平响**）；LED `PB13`（丝印 `USERLED-B13`） | 气体确认超阈值 / 进入故障阶段 → 蜂鸣器连续响；LED 指示避障模式 |

**边界**：PC 端界面（历史曲线、远程控制、数据落盘）由**角色 C** 负责，不属本文档范围；本机 OLED
是"现场界面"、C 的界面是"远程/历史界面"，两者**数据来源是同一套协议**（见 §6）。

---

## 2. 交互总体设计

"用户想做什么 → 怎么操作 → 得到什么反馈"：

| 我想…… | 操作 | 反馈 | 数据/实现来源 |
|---|---|---|---|
| 知道现场有没有气体异常 | 看页 1（双击切页） | 双路 ppm、`Rs/R0`、`ALM`/`A` 报警标志；蜂鸣器同时响 | `pages.c` `show_gas_page()`；`app_tasks.c` UiTask |
| 知道巡检跑到哪一步了 | 双击切到页 2 | 阶段文本、任务号、进度 %、巡检点、停车原因 | `pages.c` `show_patrol_page()` |
| 知道车为什么停着不动 | 看页 2 第 3 行的 `STOP nn` 与 `LOCK` | 停车原因位图 + 安全停车锁存标志 | `patrol.h` `PATROL_STOP_*`；`app_api.h` |
| 排查"上位机连不上" | 看页 2 第 4~6 行 | 两条链路各自的收字节数、有线丢弃数、`FR` 解帧数、`Hp` 剩余堆 | `app_api.h` `AppDiag` |
| 启停小车 | USER 按键**单击** | 电机使能状态翻转（`Flag_Stop`）；**安全停车锁存期间该操作无效** | `control.c` `Key()` |
| 切换显示页 | USER 按键**双击** | 页序 0 → 1 → 2 → 0 循环，右上角页码随之变化 | `pages.h` `Pages_Next()`；`pages.c` |
| 切普通/避障模式 | USER 按键**长按** | `Bi_zhang` 翻转（0 普通 ↔ 1 避障）；页 0 模式文本变化，LED 常亮 | `control.c` `Key()`；`led.c` `Led_Flash()` |
| 看历史曲线、远程下发任务 | 交上位机（角色 C），本机做不到 | 见 §6 | `../protocol/communication_protocol.md` |

**刷新节奏**（`app_config.h`）：UI 任务周期 `CFG_UI_TICK_MS = 100` ms（OLED 每 100 ms 重绘一次）；
气体每 `CFG_GAS_POLL_MS = 50` ms 采样，巡检状态每 `CFG_STATE_TICK_MS = 100` ms 推进
—— 页面上看到的数值最多滞后约 100 ms。

---

## 3. OLED 显示设计

### 3.1 硬件与绘制约定

| 项目 | 值 | 依据 |
|---|---|---|
| 屏 | 0.96 寸，**128×64** 单色，SSD1306 兼容（`OLED_Init()` 初始化序列）；刷新时全部写入显存 `OLED_GRAM[128][8]`，最后 `OLED_Refresh_Gram()` 一次性送出 | `Drivers/BSP/OLED/oled.c` |
| 接口 | **软件 SPI（4 线）**：`PC0`=DC、`PC13`=SCL、`PC14`=SDA、`PC15`=RST | `Drivers/BSP/OLED/oled.h` |
| 字形与行距 | `OLED_ShowChar()` 用 **6×12** 点阵（`oled_asc2_1206`）；6 行文本固定在 **y = 0/10/20/30/40/50**（行距 10 px） | `oled.c`、`pages.c` |
| 每行字符数 | **21 个字符**（128 ÷ 6 = 21.3，取整 21）；本设计按每行 ≤ 21 字符排布 | `pages.c` 注释 |
| 步距 | 字符串 `OLED_ShowString()` 每字符 **x += 8**（写死 8，不是 6）；数字 `OLED_ShowNumber(x,y,num,len,12)` 每位 **x += 6**，前导零显示为**空格** | `oled.c` |
| 排布口径 | 示意图以 **像素 x 为列号**逐格画出（`x` = 列号），所以图上的位置可以直接与代码里的 x 参数对照；图分两段（x=0~79 与 x=80~127）以便排版 | §3.6 |

### 3.2 页 0：厂商原始界面（`show.c` / `oled_show()`）

页 0 是厂商基线界面，RTOS 模式下**内容未改动**（用于显示姿态算法、平衡模式、编码器、电压、角度）；第 5 行末尾的 `F4` 为固定文本。

```
        x=0                  x=40                 x=80                 x=120
        |                    |                    |                    |
y=0 | DMP`````````````````````````````````````````````````````````PU TONG             
   |                                                 
y=10| T```````````25.`3`````C```````````````70`12345`mm                               
   |                                                 
y=20| EncoLEFT````````````````````````````````````````````````````````````````````````
   | +``````````````1234                             
y=30| EncoRIGHT```````````````````````````````````````````````````````````````````````
   | -``````````````1234                             
y=40| Volta````````````````````````````````````````12```````````.`````````34``````````
   | V````````````````````````F4                     
y=50| Angle````````````````````````````````````````123````````````````````````````````
   | XT-N                                            
```

每行分两段：第一段是 **x=0~79 像素**、第二段是 **x=80~127 像素**（`x` 就是列号）。
x 坐标速查：**(A)** 算法名 x=0、模式名 x=60；**(B)** 温度 x=0(2 位)/`.` x=14/小数 x=16、`` `C `` x=21、距离 x=38、`mm` x=47；
**(C)** 标题 x=0、符号 x=80、计数 x=95；**(D)** 整数 x=45、`.` x=58、小数 x=68、`V` x=80、`F4` x=105；**(E)** `Angle` x=0、角度 x=45、`XT-Y/N` x=80。

| 行 | 字段（代码位置） | 含义 | 数据来源 |
|---|---|---|---|
| A | 算法名 x=0、模式名 x=60 | `DMP`/`Kalman`/`Hubu`；`GEN SUI`/`BIZHANG`/`PU TONG` | `Way_Angle`(1/2/3)、`Bi_zhang`(2/1/0) |
| B | 温度 x=0（2 位）/`.` x=14/小数 x=16、`` `C `` x=21、距离 x=38、`mm` x=47 | MPU6050 内置温度（0.1 ℃）；超声波距离（mm） | `Temperature`、`Distance` |
| C | 标题 x=0、符号 x=80、计数 x=95（4 位） | 左/右编码器计数，带 `+`/`-` | `Encoder_Left`/`Encoder_Right` |
| D | `Volta` x=0、整数 x=45、`.` x=58、小数 x=68、`V` x=80、`F4` x=105 | 电池电压（0.01 V，如 `12.34V`）；行尾固定文本 `F4` | `Voltage` |
| E | `Angle` x=0、角度 x=45（3 位）、`XT-Y/N` x=80 | 平衡倾角（负值加 360）；斜坡悬停开关 | `Angle_Balance`、`Flag_Hover` |

### 3.3 页 1：环境与气体（`pages.c` `show_gas_page()`）

触发进入：USER 按键双击 1 次（页 0 → 页 1）；若 `App_GetGas()` 读取失败，则在 (x=0, y=10) 显示 `READ ERR` 并中止本页绘制。

```
        x=0                  x=40                 x=80                 x=120
        |                    |                    |                    |
y=0 | GAS ENV`````````````````````````````````````````````````````````````````````````
   | ````WARM````````````````````````````````1       
y=10| MQ2`````````````````````30``````````.```````0```````````````ppm`````````````````
   | ``````````ALM                                   
y=20| MQ135```````````````````````````````````````50``````````.```````0`````````````pp
   | m```````````````````````````A                   
y=30| T```````````25``````````.```````3```````````C```````````H```````````60``````````
   | .```````1```````%                               
y=40| Rs/R0```````````````````````````````````````9```````````.```````83``````````````
   | 3```````````.```````60                          
y=50| CAL OK``````````````````````````````````````````````````COMP OFF                
   |                                                 
```

图上**列号 = 像素 x**（第一段 x=0~79，第二段 x=80~127）；` ` 表示该格不显示。档位三种取值的坐标：`WARM` x=84 / `FAST` **x=88** / `1HZ` x=96（三者右边界都 ≤119，给页码 x=120 让位）。

> ✅ **已修正（2026-10-09）**：复核曾发现档位取 `FAST` 时占 x=90~121，与页码（x=120~127）**重叠 2 px**。
> 已把 `FAST` 由 x=90 改为 **x=88**（占 88~119），**页 1 现在无任何重叠**；属软件微调，不影响结构开孔尺寸。

| 行 | 字段（代码位置） | 含义 / 单位 | 数据来源 |
|---|---|---|---|
| 1 | 标题 x=0；档位 x=84/90/96；页码 `1` x=120（宽 8 px） | 气体采样档位：预热 / 异常加密 5 Hz / 常态 1 Hz | `AppGasSnapshot.gear`（`PROTO_GEAR_*`）、`Flag_Page` |
| 2 | `MQ2` x=0（3×8=24）；值 x=24、**宽 26 px**（整数 2 位 12 px → `.` x=36 → 小数 1 位 x=44）；`ppm` x=60（24 px，到 83）；`ALM` x=90（到 113，仅报警时显示） | MQ-2 估计浓度（ppm×10，用 `show_x1()` 拼小数点）；`ALM` = **已确认**超阈值 | `mq2PpmX10` / `mq2Alarm` |
| 3 | `MQ135` x=0（5×8=40）；值 x=44、宽 26（`.` x=56、小数 x=64）；`ppm` x=78（到 101）；报警 `A` x=108（仅报警时） | MQ-135 浓度与报警标志（该行位置紧张，报警只显示 1 个字符 `A`） | `mq135PpmX10` / `mq135Alarm` |
| 4 | `T` x=0；温度值 x=12、宽 26（`.` x=24、小数 x=32）；`C` x=44；`H` x=56；湿度值 x=68、宽 26（`.` x=80、小数 x=88）；`%` x=96；DHT 无效时整行改为 `T/H  N/A` x=0 | 温度 0.1 ℃ / 湿度 0.1 %RH；DHT 无效时明确显示 N/A，不含糊为 0 | `tempX10` / `humiX10` / `dhtValid` |
| 5 | `Rs/R0` x=0（5×8=40）；MQ-2 比值 x=44、**宽 32 px**（12+8+12）；MQ-135 比值 x=80、宽 32（到 111，各两位小数，用 `show_x2()`） | **主链路量**（未定标，反映敏感体电阻相对变化），比 ppm 更可靠 | `mq2Ratio` / `mq135Ratio`（浮点 ×100 取整） |
| 6 | `CAL OK`/`CAL...` x=0（6×8=48）；`COMP ON`/`COMP OFF` x=56（8×8=64，到 119） | R0 是否已标定完成；温湿度补偿是否启用 | `mq2R0 > 0.0f`、`readyBits & PROTO_RDY_COMP` |

### 3.4 页 2：巡检与通信（`pages.c` `show_patrol_page()`）

触发进入：USER 按键双击 2 次（页 1 → 页 2）；`App_GetPatrol()` / `App_GetDiag()` 读取失败时，对应整段留空（不显示错数据）。

```
        x=0                  x=40                 x=80                 x=120
        |                    |                    |                    |
y=0 | PATROL``````````````````````````````````````````PATROL``````````````````````````
   | ````````````````````````````````````````2       
y=10| TASK````````````````````````````1```````````````````PROG````````````````````````
   | ````40``````````````````%                       
y=20| WP``````````````2`````````````STOP``````````````````````````````04``````````````
   | ````````LOCK                                    
y=30| BT rx```````````````````````````````````````12345                               
   |                                                 
y=40| WR rx```````````````````````````````````````12345`````````````````````````````dr
   | ````````````````0                               
y=50| FR````````````````1234````````````````````````````````Hp````````````````8000````
   | ````````````````````K                           
```

图上**列号 = 像素 x**（第一段 x=0~79，第二段 x=80~127）。

| 行 | 字段（代码位置） | 含义 / 单位 | 数据来源 |
|---|---|---|---|
| 1 | 标题 `PATROL` x=0（6×8=48）；阶段文本 x=48（最长 6 字符 → 到 95）；页码 `2` x=120 | 阶段：`INIT`/`WARMUP`/`IDLE`/`PATROL`/`ANALY`/`RETURN`/`DONE`/`FAULT`（未知值 `?`） | `phase` 经 `phase_text()` 映射（`PROTO_PHASE_*`）、`Flag_Page` |
| 2 | `TASK` x=0（到 31）；任务号 x=32（2 位，到 43）；`PROG` x=52（到 83）；进度 x=84（3 位，到 101）；`%` x=104 | 任务号（0 空闲 / 1 巡检 / 2 返航）；进度 0~100 | `taskId`（`PROTO_TASK_*`）、`progress` |
| 3 | `WP` x=0（到 15）；点号 x=16（1 位）；`STOP` x=30（到 61）；原因 x=64（2 位，到 75）；`LOCK` x=88（到 119，仅安全停车锁存时显示） | 巡检点序号；停车原因位图（`0x01` 失联 / `0x02` 急停 / `0x04` 硬件故障，可组合）；`LOCK` = **安全停车锁存中**（人工确认前不自动恢复） | `waypoint`、`stopReason`（`PATROL_STOP_*`）、`safetyStop` |
| 4 | `BT rx` x=0（5×8=40）；字节数 x=44（5 位，到 73） | 蓝牙链路（USART2）累计收到字节数 | `AppDiag.rxBytesBt` |
| 5 | `WR rx` x=0（40）；字节数 x=44（5 位）；`dr` x=78（到 93）；丢弃数 x=96（3 位，到 113） | 有线链路（USART1）累计收到字节数；环形缓冲**丢弃**字节数（诊断缓冲够不够用） | `rxBytesWire` / `rxDroppedWire` |
| 6 | `FR` x=0（到 15）；解帧数 x=18（5 位，到 47）；`Hp` x=54（到 69）；剩余堆 x=72（4 位，到 95）；`K` x=100（到 107） | 协议解帧成功帧数；FreeRTOS 剩余堆 KB（`heapFreeBytes/1024`）—— 排障两件套 | `framesOk` / `heapFreeBytes` |

### 3.5 页切换机制

| 项目 | 设计 |
|---|---|
| 手势与页序 | USER 按键**双击**：`PAGE_VENDOR(0)` → `PAGE_GAS(1)` → `PAGE_PATROL(2)` → 回到 0（`PAGES_COUNT = 3`）；每页右上角写页码（`x=120, y=0`），页 0 是厂商页、无页码。原双击切 `Flag_Show`（APP ↔ DataScope），但 RTOS 模式下 USART1 已改作有线协议链路、该手势已无用途（决策 48） |
| 实现 | 中断里调 `Pages_Next()` **只自增 `volatile u8 Flag_Page`**（不碰 OLED、不调 RTOS API）；绘制在 UI 任务里由 `Pages_Show()` 完成（清屏 → 按页绘制 → 写页码 → `OLED_Refresh_Gram()`）；遇到 `PAGE_VENDOR` 直接 `return`，由 UiTask 调 `APP_Show()`+`oled_show()` 画厂商界面 |

### 3.6 排布约束与核算结论

1. **两条步距不一样**（照 `oled.c` 源码）：`OLED_ShowString()` 每字符 **8 px**（函数内 `x += 8`，`MAX_CHAR_POSX = 122`）→
   一行最多 **16 个字符**（0, 8, 16 … 120）；`OLED_ShowNumber(...,12)` 每个数字 **size/2 = 6 px**，前导零显示为空格。
   "每行 21 字符"（128 ÷ 6）只在"用满 128 像素"的意义上成立，**数字字段**能这么密，字符串字段不能。
2. **★ 2026-10-09 复核后已修正**：本次核对称发现 `pages.c` 的 `show_x1()`/`show_x2()` 把 `.` 与小数位**按"每字符 6 px"排**（`.` 压到数字上）、页 2 也有几处压字；现已改掉并同步到本文档。修正后的口径：整数 2 位（12 px）→ `.` 在 x+12（8 px）→ 小数从 x+20 起（每数字 6 px），即 `show_x1` 宽 **26 px**、`show_x2` 宽 **32 px**。
3. **核算结论**：逐字段相加后，页 1/页 2 **所有右边界最大 120 px（无越界）**、**无重叠** ——
   页 1 第 1 行的 `FAST` 已由 x=90 调至 **x=88**（88~119），与页码（x=120）不再相交（见 §3.3 提示）；
   其余均已排开：页 2 第 2 行 `PROG`(52..83) 与进度(84..101) 相邻、第 3 行原因值(64..75) 与 `LOCK`(88..119) 留 13 px 空档。
4. **不越界的前提**：各数字字段的**位数固定**（任务号 2 位、进度 3 位、字节数 5 位、剩余堆 4 位、丢弃 3 位、巡检点 1 位）
   —— 数值超过位数时 `OLED_ShowNumber` 只显示**低位**（丢弃高位），不会写出屏幕；若以后要显示更大的数，需 B 侧加位数。
5. **页 0（厂商页）未动**，其排布仍按厂商原始坐标（`show.c`），本文档 §3.2 只是记录现状。

---

## 4. 按键交互设计

### 4.1 语义表

| 操作 | 语义（RTOS 模式） | 反馈 | 实现位置 |
|---|---|---|---|
| **单击** | 启停（`Flag_Stop` 翻转），**厂商原语义** | 电机使能/关闭；页 2 的 `LOCK` 与 `STOP` 反映相关状态 | `control.c` `Key()`：`if(tmp==1 && App_MotorDisable==0) Flag_Stop=!Flag_Stop;` |
| **单击（安全锁存期间）** | **无效** —— 禁止用按键绕过安全停车锁存 | 无任何变化 | 同上，条件里的 `App_MotorDisable==0`（决策 47） |
| **双击** | **切换 OLED 显示页**（页 0/1/2 循环） | 整屏换页 + 右上角页码变化 | `control.c`：`if(tmp==2) Pages_Next();` |
| **长按** | 普通 ↔ 避障模式（`Bi_zhang` 翻转），**厂商原语义不变** | 页 0 的模式文本变化；LED 变为常亮 | `control.c`：`if(tmp2==1) Bi_zhang=!Bi_zhang;` |

> 裸机（`USE_RTOS=0`）对照：双击是切 `Flag_Show`、单击无安全锁存判断，长按相同（页 1/2 只在 RTOS 模式下编译）。

### 4.2 与安全策略、扫描实现的关系

- **安全停车是锁存的**：500 ms 失联 / 急停（0x2F）/ 硬件故障 / 任务超时都会置位锁存（`Patrol_MotorsDisabled()` → `App_MotorDisable`），
  控制中断每拍据此**强制** `Flag_Stop = 1`；**解除锁存的唯一人工路径是上位机重新下发任务或显式使能，不是按键**（决策 47）。
- 长按与双击在锁存期间**仍有效**（不改电机使能，只改显示/运动模式，属"查看/配置"类操作）；`Key()` 由 `EXTI15_10_IRQHandler()`
  在**每条控制拍**里调用，中断内不调 FreeRTOS API、不碰 OLED（只改变量），符合中断安全约束。
- **操作手感提示（给结构/演示）**：单击约 0.25 s 后才被确认 → **双击必须"快按两下"**；长按需**持续按住**（约 200 次扫描），松手过早会判成单击。

### 4.3 判定方式与阈值（`key.c`）

| 手势 | 判定方式 | 阈值（代码中的原始值） |
|---|---|---|
| 单击 | `click_N_Double(time)`：检测按下沿（`double_key`），松开后累计 `count_single`；超过 `time` 且期间未长按 → 返回 1 | 调用处 `time = 50`（扫描次数）→ 约 **0.25 s** 后确认单击 |
| 双击 | 同函数：检测到**第 2 次按下沿**立即返回 2（`double_key == 2`） | 两次按下沿的间隔必须小于上面的单击确认窗 |
| 长按 | `Long_Press()`：按住期间 `Long_Press_count` 累加；`> 200` 返回 1 | **200 次扫描**（连续按住，百 ms 量级）；长按期间单击计数被清掉（`Forever_count > time`），不会误判成单击 |
| 消抖 | 以"扫描周期判定"代替软件延时：同一按下沿只计一次（`flag_key`），松开（`KEY == 1`）才复位 | 无额外 RC / 延时消抖 |

---

## 5. 声光报警设计

### 5.1 蜂鸣器

| 项目 | 值 |
|---|---|
| 位置与类型 | 板上 `J18`（3 针 `+5V / PC5 / GND`），**PC5 直连**（不用三极管 `Q1`）；**有源**模块（自带振荡，**不需要 PWM**），5 V |
| 极性 | **低电平响**：`Buzzer_On()` → `PC5 = 0`；`Buzzer_Off()` → `PC5 = 1`；上电即置高，避免上电乱叫 |
| 驱动节拍 | UI 任务每 `CFG_UI_TICK_MS = 100` ms 判断一次并设置 GPIO |

**响的条件**（`app_tasks.c` UiTask，与源码逐字对应）：`beepOn = (s_mq2.alarm || s_mq135.alarm || s_patrol.phase == PROTO_PHASE_FAULT); Buzzer_Set(beepOn);`

即 **① MQ-2 确认超阈值，或 ② MQ-135 确认超阈值，或 ③ 状态机进入 `FAULT` 阶段** → 蜂鸣器**连续响**，否则停。
实现上是"电平跟随"，**没有软件间歇/变频鸣叫**（不是"滴滴"声，而是持续声）。

### 5.2 LED

| 项目 | 值 |
|---|---|
| 位置 | 板载 LED，`PB13`（**低电平点亮**：初始化时 `GPIO_SetBits(PB13)` = 灯灭） |
| 语义（普通模式 `Bi_zhang == 0`） | `Led_Flash(100)`：每 **100 次控制中断调用**翻转一次（源码注释表述为"1 s 改变一次状态"），做"程序在跑"的指示 |
| 语义（避障模式 `Bi_zhang == 1`） | `Led_Flash(0)`：`LED = 0` **常亮**，提示当前处于避障模式 |
| 故障指示（RTOS 钩子） | 任务栈溢出 / 堆耗尽时 **LED 常亮 + 关中断停住**，便于调试器定位（见 `../design_firmware/程序说明文档.md` §7 第 10 条） |

### 5.3 报警的现场含义（给装配/演示用）

| 现象 | 含义 / 现场处置 |
|---|---|
| 蜂鸣器连续响 + 页 1 出现 `ALM`/`A` | 气体确认超阈值（默认 MQ-2 30.0 ppm / MQ-135 50.0 ppm）→ 看 `Rs/R0` 趋势判断是尖峰还是持续上升 |
| 蜂鸣器连续响 + 页 2 阶段 `FAULT` | 状态机故障（硬件故障/任务超时等）→ 看 `STOP nn` 定位、看 `LOCK` 确认已锁存 |
| 蜂鸣器不响但有 `LOCK`；或 LED 常亮 | 锁存未进 `FAULT`（如 500 ms 失联）→ 查 `BT rx`/`WR rx` 是否还在增长；LED 常亮 = 避障模式（长按切回） |

---

## 6. 与上位机界面的分工

| 维度 | 本机 OLED（本文档，A2/B 侧现场界面） | 上位机 PC 界面（角色 C） |
|---|---|---|
| 屏幕 | 0.96 寸 128×64 单色，6 行 × 21 字符 | PC 显示器，图形化 |
| 内容 | 当前时刻的**实时值**：双路 ppm、`Rs/R0`、温湿度、阶段/任务/巡检点/链路统计 | **历史曲线、多通道趋势、日志与回放**、远程控制面板、参数设置 |
| 操作 | 1 个按键（单击/双击/长按） | 鼠标键盘：任务下发、使能、急停、在线调参 |
| 数据通道 | 无（本地显示，数据来自 `app_api.h` 只读接口） | 蓝牙 SPP（USART2，115200）/ 有线（USART1，115200），**同一套协议帧**（协议见 `../protocol/communication_protocol.md`） |

要点：OLED 上每个量都能在协议上行帧里找到对应字段（角度/浓度/状态/诊断），不会"口径不同"（接口约定见 `../design_firmware/程序说明文档.md` §5.5）；页 1/2 数据全部走 `app_api.h` 只读快照接口（`App_GetGas/GetPatrol/GetDiag`），**显示与业务解耦**；上位机侧的界面设计与操作手册由 C 负责，**不在本文档内**。

---

## 7. 结构与人机布局待补项（A2 已定：在对应位置开框）

> **2026-10-17 A2 定稿**：本节**不再逐项测量**。12 项统一按「**在对应位置开框**」处理 —— 开孔位置以对应器件中心为准，尺寸在打印前用卡尺复核；因此不单独出开孔坐标表，也不填具体尺寸。
> 下表保留为**设计输入清单**（约束条件仍有效），"处理方式"一列已按上述决定改写。

| # | 项目 | 需要的信息 | 备注 / 已知约束（来自代码或计划书） |
|---|---|---|---|
| 1 | OLED 视窗开孔 | 开孔尺寸（长×宽，mm）、圆角半径、开孔中心相对外壳基准的 X/Y | 按"在对应位置开框"处理。约束：屏为 0.96 寸、显示区 128×64（像素）；模块**外形尺寸待 A2 实测** |
| 2 | 视窗与屏面关系 | 是否加亚克力/透明片、厚度、屏面到视窗距离、遮光方式（防侧面漏光与眩光） | 在对应位置开框；透明片/遮光不做要求 |
| 3 | OLED 模块固定 | 固定方式（螺柱/卡扣/双面胶）、固定柱位置与高度、模块背面净空 | 按"在对应位置开框"处理。屏用 4 线接主板座，**线束需留弯折半径** |
| 4、5 | USER 按键开孔与可达性 | 开孔直径/形状与中心位置；按压行程（帽顶到外壳面）、是否加帽、是否防误触（凹陷/围边） | 按"在对应位置开框"处理。按键在**主板上**（`PB14`，丝印 `USERKEY-B14`），型号/高度待实测；三种手势都要能稳定复现，建议帽面 ≥ 孔径且外露 ≥ 1 mm |
| 6 | 蜂鸣器出声孔 | 孔径、孔数、排布与开孔区域位置；是否有防尘网 | 按"在对应位置开框"处理。模块在 `J18`（`+5V/PC5/GND`）上，**出声面朝向待 A2 定**（模块外形待实测） |
| 7 | LED 可见性 | 板载 LED（`PB13`）是否需要导光柱或开孔；导光柱尺寸与位置 | 按"在对应位置开框"处理。LED 用于模式与故障指示（§5.2），建议从外壳正面可见 |
| 8 | 丝印/标识 | 按键旁标注文字、蜂鸣器与视窗的标识符号、字号与工艺（丝印/贴纸/雕刻） | 按"在对应位置开框"处理。建议按键旁标注三种手势，避免演示时靠记忆 |
| 9 | 气体进气口 | 进气格栅/开孔位置与开孔率、与 MQ 敏感体的距离、是否加防尘网 | 按"在对应位置开框"处理。传感器在 `J13`(MQ-2)/`J10`(MQ-135)，**低位布置**（计划书要求降低重心） |
| 10、11 | 维修可达性与装配公差 | 换 MQ 模块 / 拔插 OLED / 换电池是否需拆壳、拆装顺序与螺钉规格；3D 打印收缩与装配间隙、视窗与按键的偏置公差 | 按"在对应位置开框"处理。功能模块走**插座**应保证免焊可换；视窗中心与显示区同轴度决定"字会不会被挡角" |
| 12 | 面板基准 | 以上所有尺寸的**基准面/基准边**（便于出图与检验） | 按"在对应位置开框"处理。建议以主板安装平面 + 主板定位孔为基准 |

> 与 A1 的接口：`OLED`、`J18`（蜂鸣器）、USER 按键、LED 都是**板载器件/座**（位置由 PCB 决定，
> 见 `pin_assignment.md` 与 `改板规格书_单底板方案.md`），结构开孔必须与**主板装配后的实际坐标**
> 对齐 —— 建议 A1 提供主板安装孔与器件高度的实测值。

> ★ **A1 已提供的结构输入（2026-10-16，可直接用于 §7 各行的基准）**：
> **板框 100.00 × 65.00 mm、四角 R5.0 mm、成品板厚 1.6 mm**；
> **安装孔 3 个 ⌀3.2 mm**，孔心以**板左下角**为原点 = **(6.0, 6.1) / (94.0, 6.1) / (6.0, 58.9) mm**（**右上角无孔**，该角落是 `J13`/`J10`/`R10`~`R13` 区）。
> 证据：EDA 快照 + 下单 Gerber 外形层 + 嘉立创生产档（[`../../hardware/gerber/README.md`](../../hardware/gerber/README.md) §五）；
> 单页版见 [`上板测试记录.md`](上板测试记录.md) §5。**§7 的"基准面/基准边"建议就以"板左下角 + 板面"为基准。**
> ⬜ **仍需 A1 实测**：板面上**最高器件的高度**（决定外壳内部净高；候选 `C1`/`C2` 电解 ≈10.2 mm、`L1` 电感）。

---

## 8. 变更记录

| 日期 | 版本 | 内容 | 作者 |
|---|---|---|---|
| 2026-10-09 | v1.0 | 初版：三条人机通道概述、交互总表、OLED 页 0/1/2 示意图（照 `pages.c` / `show.c` 坐标推导）、按键语义与判定阈值、声光报警条件、与上位机分工、结构待补表 | A2（结构），软件侧内容依据 B 的实现（决策 47/48） |
| 2026-10-09 | v1.1 | **排布复核**：核对发现 `OLED_ShowString()` 是 **8 px/字符**（不是 6），据此指出 `pages.c` 的 `show_x1/x2` 小数点重叠与页 2 字段压字；B 侧改好坐标后，本文档 §3.3/§3.4 示意图与字段表**同步到修正后的坐标**，§3.6 改为"核算结论"（右边界最大 121 px、无越界；**仅剩 1 处**：档位 `FAST` 与页码重叠 2 px） | A2（结构）复核、B（固件）修改 |
| 2026-10-15 | v1.2 | **真机确认**：**OLED 三页（页 0 厂商 / 页 1 环境气体 / 页 2 巡检通信）均正常显示**，早期"乱码/压字"现象未复现（见 [`../design_firmware/真机联调问题清单.md`](../design_firmware/真机联调问题清单.md) §6/§7）；**台架目前只有 MQ-135，插在 `J13`**（`J10` 空）⇒ §3.3 里"MQ2/MQ135 两行"当前只有 `MQ2` 行有真实读数 | B（固件）联调实测 |

> **遗留项（软件侧，非结构）**：① ~~档位 `FAST` 与页码重叠 2 px~~ → **已修**（`FAST` 改 x=88，见 §3.3 提示、§3.6 第 3 条）；
> ② 页 2 巡检点号为 **1 位数字**（`show_num(...,1)`），当前 4 个巡检点够用，扩容需 B 侧改位数；
> ③ 数字字段位数固定（超出只显示低位，见 §3.6 第 4 条）。三项都不影响结构开孔。

> **口径提醒**：`pin_assignment.md` §5"待确认引脚分配"表里蜂鸣器仍写 `PB12`（走三极管），那是**改板前的旧方案**；
> 本设计以 `改板规格书_单底板方案.md` §J18 与决策 26 为准 = **`PC5` 直连、低电平响**。

---

> **项目归属**：中国石油大学（华东） 专业生产实习课程项目<br>
> **范围说明**：本项目不涉及 MiniBalance 控制板（STM32F405RGT6 版本）的硬件设计与改版；控制板直接沿用，A1 仅重做主底板。<br>
> **许可**：原创代码与文档采用 MIT License；第三方组件遵循各自原始许可证。
