pierrotto12138-code/balance-car-inspection-robot/docs/design_hardware/原理图完善计划.md

# "改"板原理图完善计划

> **对象**：`%USERPROFILE%\Documents\LCEDA-Pro\projects\参考01_copy` → board **改**（Schematic2 + PCB2）
> **目标**：把"改"板原理图补成**完整、可生成网表、可直接同步到 PCB** 的状态，覆盖本项目全部功能接口
> **日期**：2026-09-29 制定 / 同日按 A1 拍板与模块实测更新 ｜ **负责人**：A1（电路）
>
> 📖 配套文档： [`改板规格书_单底板方案.md`](改板规格书_单底板方案.md) ·
> [`焊接调试手册.md`](焊接调试手册.md) ·
> [`../handoff/交接说明.md`](../handoff/交接说明.md)（总纲）

---

## 〇、★ 现状实测（2026-09-29，EDA 关闭时直接解析工程文件）

用只读脚本 `hardware/sch_netlist.py` 核对，**"改"板原理图与"原"板的差异**：

```
对方有、本图【缺】的位号（15）：
    BZ1  J6  J8  J9  J10  J11  J12  J13  J14  J15  J16  Q1  R6  R7  R8
本图有、对方没有的位号：无
网络名差异：无（58 个网络名两张图完全一致）
```

| 项 | "原"板 Schematic1 | "改"板 Schematic2 |
|---|---|---|
| 有位号元件 | 49 | **34**（★这是**开工时**的状态）|
| 现有位号 | — | C1–C13、D1–D4、J1、J2、J3、J4、J5、J7、J17、L1、R1–R5、SW2、U1、U2、U3 |

> **⚠️ 本节是"开工时"的现状快照，保留作为"缺口清单"的依据。**
> **终态请看 §6.5**：52 个位号、全部有封装与料号、DRC 致命错误 0。
> 其中 `J3/J4` 已更名为 **`CN1/CN2`**；`Q1/R7/R8` **最终不需要**（蜂鸣器走方案 A：`J18` + `PC5` 直连）。

### 缺口分类

| 类别 | 缺什么 | 后果 |
|---|---|---|
| 🔴 **功能必需** | **J9**(DHT11)、**J10**(MQ-135)、**J11**(红外L)、**J13**(MQ-2)、**J14**(红外R)、**J15**(传感器取电排) | 双路气体、温湿度、避障**全部接不上** |
| 🔴 **功能必需** | **Q1 + R7 + R8**（蜂鸣器驱动级） | **声光报警做不出来**（任务书明确的交付功能） |
| 🔴 **规格书要求新增** | **R10–R14**（2 路分压 + 1 路上拉）、C14–C19（去耦） | MQ 的 5V 模拟量直连 3.3V ADC → **会击穿引脚** |
| 🔴 **已存在但要改** | **J5**（TRIG/ECHO 反了）、**J7**（整体反了，直插会把 5V 灌进 PA2）、**J11**（OUT 从 `PA4` 换到 5V 容忍的 `PB12`） | 与实际模块不符，见 §〇之二 与 S1 |
| ⬜ 确定不要 | J6（循迹）、J8（串口 4/5）、J12（PC2 备用）、J16（PB8/9/13/14/12）、BZ1/R6（原 2 针蜂鸣器方案） | 已拍板删除 |

### ⚠️ 两处需要订正的文档（本计划执行时一并改）

1. **`改板规格书` §三 把 J8/J12/J15/J16 记为"保留"，实际精简时被一并删掉了**——文档与工程不一致。
2. **`交接说明` §3.5 与 §2.1 记有"底板已有 BZ1+Q1（蜂鸣器已集成）"，实际"改"板没有**
   （"原"板才有）。**这一条最危险**：若照文档做 PCB，会出现"以为有报警电路、实际没有"。

---

## 〇之二、★★ 模块引脚实测 —— 五处插座顺序与实际模块不符

**A1 实测的模块引脚丝印顺序**：

| 模块 | 实物引脚顺序（丝印） | 引脚数 |
|---|---|---|
| **MQ-2** | `AO` / `DO` / `G` / `VCC` | **4** |
| **MQ-135** | `AO` / `DO` / `G` / `VCC` | **4** |
| **DHT11** | `G` / `VDD` / `DO` | 3 |
| **ST018 红外避障** | `VCC` / `G` / `OUT` | 3 |
| **HC-SR04 超声波** | `VCC` / `TRIG` / `ECHO` / `GND` | 4 |
| **蓝牙模块** | `STATE` / `RXD` / `TXD` / `GND` / `VCC` / `PWRC` | **6** |
| **蜂鸣器模块**（**有源**、低电平触发） | `VCC` / `I/O` / `G` | 3 |

**把这些顺序与"原"板插座定义逐脚对齐**：

> 下表按"网表脚号 = 模块丝印从脚 1 数起"的对应关系比对。
> 实际插入方向还取决于插座在板上的摆放（可转 180°），
> **这正是下面那条"PCB 丝印必须印脚名"硬约束存在的原因。**

| 座 | "原"板插座定义 | 对上实际模块会怎样 | 判定 |
|---|---|---|---|
| **J13** (MQ-2) | `+5V / GND / PB3 / PA5` | 直插 → **VCC 撞上 PA5**；只有 180° 反插才对 | ❌ **必须重定义** |
| **J10** (MQ-135) | `+5V / GND / PA6`（**3 针**） | 模块是 **4 针**，3 针座**物理上插不了** | ❌ **必须改 4 针座** |
| **J9** (DHT11) | `+3.3V / PA7 / GND` | 直插 → **G 撞上 +3.3V**（反极性）；反插也错 | ❌ **必须重定义** |
| **J5** (HC-SR04) | `+5V / PB0(ECHO) / PC4(TRIG) / GND` | 与模块 `VCC/TRIG/ECHO/GND` 相比，**中间两脚 TRIG/ECHO 反了**（见 S2，且会造成两路输出顶在一起） | ❌ **必须重定义** |
| **J7** (蓝牙) | `NC / +5V / GND / PA3 / PA2 / NC` | 与模块 `STATE/RXD/TXD/GND/VCC/PWRC` 相比，**整体是反的**：直插会把 **5V 灌进 MCU 的 PA2、把 GND 灌进 PA3** | ❌ **必须重定义**（详见下节） |
| **J11** (红外 L) | `+5V / GND / PA4` | 顺序与 `VCC/G/OUT` **完全一致**；但 OUT 落在 `PA4`（`TC`，非 5V 容忍） | ⚠️ **顺序不动，只把 OUT 改接 `PB12`**（见 S1） |
| **J14** (红外 R) | `+5V / GND / PC1 / PC3` | 3 针模块插前 3 脚即可用（第 4 脚 PC3 空）；OUT 落在 `PC1`（`FT`，5V 容忍） | ✅ 保持 |

### ★ 设计原则（本次改板的定调）

> **底板是重做的，插座引脚顺序就按模块丝印来定义 —— 做到"直插、不用转接、不会插反"。**

"原"板是往届组按他们手上的模块定的，与我们的模块不一致。
既然我们从零画这块板，就没有必要迁就旧顺序，更不该留下"必须反插"这种隐患
（1×N 排针没有防呆，插反就是 5V 直进 MCU）。

#### ⚠️ 但"直插就对"必须配一条硬约束：**PCB 丝印要印出每脚的功能名**

蓝牙模块这一例说明问题：**1×N 排针没有防呆，"脚 1 在哪一端"完全取决于插座在板上的摆放方向**。
只看网表顺序无法判断"插进去对不对"，因为插座可以转 180° 摆放。

> **因此定一条规矩**：所有新增/改动的插座，
> **必须在 PCB 丝印上把每个脚的功能名印出来**（如 `VCC` / `G` / `OUT` / `TRIG` / `ECHO`），
> 而不是只印一个 `J11`。**方向由丝印决定，不靠记忆。**
>
> 顺带：也建议在插座旁留一个 `▲` 或 `1` 标记，标出模块丝印的第 1 脚那一侧。

### 修订后的插座引脚定义（**A1 按这张表放座、连线**）

| 座 | 模块 | 脚 1 | 脚 2 | 脚 3 | 脚 4 | 脚 5 | 脚 6 |
|---|---|---|---|---|---|---|---|
| **J13** | MQ-2 | **AO** → `MQ2_AO` | **DO** → `PB3` | **G** → `GNDREF` | **VCC** → `+5V` | — | — |
| **J10** | MQ-135 | **AO** → `MQ135_AO` | **DO** → `PC3`（可留空） | **G** → `GNDREF` | **VCC** → `+5V` | — | — |
| **J9** | DHT11 | **G** → `GNDREF` | **VDD** → `+3.3V` | **DO** → `PA7` | — | — | — |
| **J11** | 红外 L（ST018） | **VCC** → `+5V` | **G** → `GNDREF` | **OUT** → **`PB12`**（原 `PA4`，见下） | — | — | — |
| **J14** | 红外 R | **VCC** → `+5V` | **G** → `GNDREF` | **OUT** → `PC1` | — | — | — |
| **J5** | HC-SR04 | **VCC** → `+5V` | **TRIG** → **`PC4`** | **ECHO** → **`PB0`** | **GND** → `GNDREF` | — | — |
| **J7** | 蓝牙 | **STATE** → 空（可选接空闲 IO） | **RXD** → **`PA2`**（MCU TX） | **TXD** → **`PA3`**（MCU RX） | **GND** → `GNDREF` | **VCC** → `+5V` | **PWRC** → 空 |
| **J15** | 取电排 | `+5V/GND` 交替 ×6 | | | | | |

> **J5 相对"原"板的改动**：把中间两脚**互换** —— `PC4(TRIG)` 挪到脚 2、`PB0(ECHO)` 挪到脚 3。
> 这一步**必须做**，否则直插时 MCU 的 `PC4`（推挽输出）会与模块的 `ECHO`（输出）**顶在一起**，
> 两边对灌电流，有损坏风险。

> **J7 相对"原"板的改动**：整表按模块丝印重排。
> 原定义直插会把 **`+5V` 灌进 MCU 的 `PA2`、`GND` 灌进 `PA3`** —— 属于会烧板子的错误。

> **J7 的两个空脚可以顺手利用**（可选，不做也行）：
> `STATE` 是模块的连接状态输出，接一个空闲 IO（如 `PB12`）可以让固件知道"手机连上没有"；
> `PWRC`（使能/KEY 脚）接 IO 可用于进 AT 模式改波特率——**正好能解决"蓝牙默认 9600、协议要 115200"那个待确认项**。
> 若要用，请在阶段 1 一并把线连上；不用就留空。

> **J10 由 3 针升级为 4 针**（BOM 里把 3 针座换成 4 针座）。
> **J14 用 3 针座**（与 J11 同款）—— 两个红外座**可互换**，模块不悬空。

> ### ★ 复制来源小技巧（省事且不易错）
>
> 阶段 1 从"原"板复制时，**不要照位号一一对应地复制**，而是按"要的针数"挑来源：
>
> | 新座 | 要几针 | **从"原"板复制谁** |
> |---|---|---|
> | J9  | 3 | 原 **J9**（3 针，直接用） |
> | **J10** | **4** | **复制原 J13**（4 针）→ 粘贴后改名 J10 ⭐ |
> | J11 | 3 | 原 **J11**（3 针，直接用） |
> | J13 | 4 | 原 **J13**（4 针，直接用） |
> | **J14** | **3** | **复制原 J11**（3 针）→ 粘贴后改名 J14 ⭐ |
> | J15 | 12 | 原 **J15**（12 针，直接用） |
>
> 原因："原"板的 J10 是 3 针、J14 是 4 针，与我们要的针数相反；
> 直接复制它们还得换器件。**复制同针数的座**能直接继承已验证的库器件与封装。

### ⚠️ 两个安全项（画板前必须弄清）

> **依据**：`Base/高配版平衡小车附送资料（STM32F405RGT6）/STM32F4技术文档/STM32F405_datasheet.pdf`
> Table 6「STM32F40x pin and ball definitions」逐脚查证。I/O 结构含义：
> **`FT` = 5V 容忍**；**`TC` = 标准 3.3V I/O**；**`TTa` = 3.3V 容忍、直连 ADC**（两种写法都不是 5V 容忍）。

**查证结果（与本次设计相关的引脚）**：

| 引脚 | I/O 结构 | 5V 容忍 | 本项目用途 |
|---|---|---|---|
| **PA4** | **TC** | ❌ **否** | 红外 L 的 OUT |
| **PA5** | **TC** | ❌ 否 | MQ-2 AO（ADC） |
| PA6 | FT | ✅ 是 | MQ-135 AO（ADC） |
| PA7 | FT | ✅ 是 | DHT11 DATA |
| **PC1** | **FT** | ✅ **是** | 红外 R 的 OUT |
| PC3 | FT | ✅ 是 | 备用（MQ-135 DO） |
| PC4 / PC5 | FT | ✅ 是 | 超声波 TRIG / 蜂鸣器 |
| PB3 | FT | ✅ 是 | MQ-2 DO |
| PB12 | FT | ✅ 是 | 空闲 |

| # | 项 | 为什么要紧 | 处置 |
|---|---|---|---|
| **S1** | **红外模块 OUT 电平 vs `PA4`** | 红外模块（实验室清单里的 **ST018**，3 针 `VCC/G/OUT`）工作电压 **3.3–5V**，输出为 **TTL 电平**。这类模块是 **LM393 开集输出**，板上必然有一颗上拉电阻把 OUT 拉到 **模块自己的 VCC** —— 所以**模块接 5V，OUT 高电平就是 5V**，这是电路决定的，不必通电测量。<br>而 **`PA4` 是 `TC`，不是 5V 容忍引脚**（⚠️ 上一版我误写成"PA4–PA7、PC0–PC3 都不是 5V 容忍"，**经查手册这是错的**：`PC1` 是 `FT`，安全） | **★ 不必测量，直接从设计上消除**：把红外 L 的 OUT 从 `PA4` **改接到 `PB12`**（`J2.24`，数据手册确认 `FT` = 5V 容忍）。<br>这样**无论模块 OUT 是 3.3V 还是 5V 都安全**，不需要电源、不需要万用表。<br>红外 R 的 `PC1` 本身就是 `FT`，**保持不动**。 |
| **S2** | **J5 的 TRIG/ECHO 顺序（已确认需要改）** | A1 已确认 HC-SR04 实物顺序为 `VCC/TRIG/ECHO/GND`，而"原"板 J5 是 `+5V/ECHO/TRIG/GND` —— **中间两脚反了**。直插会让 MCU 的 `PC4`（推挽输出）与模块的 `ECHO`（输出）**顶在一起**，两边对灌电流 | **按 §〇之二 的表重定义 J5**：脚 2 = `PC4`(TRIG)、脚 3 = `PB0`(ECHO)。**只改插座连线，不动 MCU 引脚**（固件仍用 PC4） |

> **顺带的好处**：红外 L 挪走后 **`PA4` 就空出来了** —— 它是一路空闲 ADC，
> 将来若要加第三路气体传感器（实验室清单里有 **MQ-7 一氧化碳**、**MQ-5 液化气**，免费），
> 现成的位置。（**属于扩大范围，本次不做**，只是记一笔。）

> ⚠️ **一个必须澄清的误区**：`PA6`/`PA7` 虽然是 `FT`（5V 容忍），
> 但**做 ADC 模拟输入时仍然绝对不能超过 `VDDA`（3.3V）**。
> "5V 容忍"是**数字输入**的指标，模拟通道不受此保护 ——
> 所以 **MQ-135 的分压电阻（R12/R13）一只都不能省**，与 MQ-2 同样处理。

---

## 一、总原则（三条，先记住）

1. **"原"板只读**：Schematic1 / PCB1 是本项目的**基线参照与回退点**，全程不动。
2. **优先"复制"，不要从库里新建**：
   AI 自动改板失败的根因正是 **API 新建的元件缺 `DeviceName` / `FootprintName` 字段**（见 `决策记录.md` §六之补）。
   从"原"板选中现成元件**复制粘贴**过来，可保留库链接与封装，从源头避开这个坑。
   （座子顺序要改的，复制过来后**改连线网名**即可，不必换器件。）
3. **靠网名连接，不靠长线**：本图网络由导线上的网名（记录 `ATTR key="NET"`）决定，**同名即同网**。
   新增元件只需画**短导线 + 设网名**，不必把线拉到控制板座子上。

---

## 二、分阶段执行（共 7 阶段）

> ✅ **本节 7 个阶段已于 2026-10-05 全部执行完毕。**
> 完整施工过程（每阶段的判断依据、当时的截图与核对结果）已归档到
> [`../archive/原理图完善_施工过程.md`](../archive/原理图完善_施工过程.md)。
> 
> **当前状态请看 [§6.5 终态表](#65--原理图已完工2026-10-05-终态)。**

## 三、验收判据（原理图"完成"的定义）

全部满足才算完成：

- [ ] 有位号元件数 = **34 + 6（座）+ 3（Q1/R7/R8）+ 5（R10–R14）= 48**
      （+ J18 蜂鸣器座 = 49；再加 C14–C19 共 6 只去耦 = **54**）
- [ ] 全图无未标注位号（无 `?`）
- [ ] **§〇之二 的插座引脚定义逐脚吻合**（拿实物模块核对过）
- [ ] §二阶段 6 的连接点计数表**逐项吻合**
- [ ] `MQ2_AO` / `MQ135_AO` 与 `PA5` / `PA6` **确为不同网络**
- [ ] DRC 无新增错误、无新增单端网络
- [ ] 与"原"板对照，"本图缺"只剩**有意删除**的位号
- [ ] 原理图 PDF 已导出存档

---

## 四、风险与坑

| # | 风险 | 应对 |
|---|---|---|
| 1 | **★ 插座顺序按旧定义做 → 插上模块就烧** | 严格按 §〇之二 的表；做完拿实物比一比 |
| 2 | 红外 OUT 若是 5V，**`PA4` 不是 5V 容忍脚** | **已从设计上消除**：红外 L 的 OUT 改接 `PB12`（`FT`，5V 容忍）；红外 R 的 `PC1` 本身是 `FT` |
| 3 | 跨 board 复制粘贴**自动重编号位号** | 粘贴后逐个复查位号 |
| 4 | 粘贴带来**重复网名**造成意外短路 | 重点查 `PA5`/`PA6`/`PA7`/`PC5`/`+5V` 的连接点计数 |
| 5 | **EDA 覆写磁盘文件** | 改板在界面里做；跑核查脚本时先关 EDA |
| 6 | 误改"原"板 | 改板前确认当前 board 是**改**（Schematic2/PCB2） |
| 7 | `J15` 12 针占位大 | 放在图纸边缘；PCB 阶段再挪 |
| 8 | 分压电阻阻值填错 | R10/R12 = **10k（串入）**，R11/R13 = **15k（对地）** |
| 9 | 蜂鸣器模块接线错 | 模块 **VCC → `+5V`**、G 共地、**I/O → `PC5`**（★ 2026-10-09 订正：终态是**方案 A `PC5` 直连**，不是经 `Q1` 集电极；`Q1` 已删除）|

---

## 五、已拍板事项（2026-09-29）

| # | 事项 | 结论 |
|---|---|---|
| **D1** | `J8` / `J12` / `J16` 是否补回？ | **全部不补**。J8 = 蓝牙已足够；J12 = 无用途（PC2 在 `J2.8` 上）；J16 = A1 暂无用途（PB8/9 在基线源码里是 CAN1，PB13/14 是控制板 LED/按键） |
| **D2** | MQ-135 接口 | **改为 4 针座**（模块实际是 `AO/DO/G/VCC` 四针）；`DO` 可接 `PC3` 或留空 |
| **D3** | 蜂鸣器 | **有源、低电平触发、5V** 模块（已上电实测）；接法用阶段 2「**方案 A：`PC5` 直连**」（省掉 Q1/R7/R8）；新增 `J18`（`+5V`）作模块座；**固件只需 GPIO 开关，PWM 作废**，极性为**低=响** |
| **D7** | **J9 给谁** | **维持给 DHT11**（详见 §6.3）：J9 只有 `+3.3V`，而 DHT11 正好要 3.3V；5V 蜂鸣器模块插 J9 会供电不足 |
| **D4** | 去耦电容 | **C16–C19 做**；C14/C15 视 PCB 空间 |
| **D5** | 封装 | 电阻/小电容 = **0805**；100 µF = **直插电解 φ6.3×7** |
| **D6** | 插座引脚顺序 | **一律按模块丝印定义**（见 §〇之二），做到直插不错 |
| **D8** | **`U1` TB6612：芯片还是模块座？** | **保留 SSOP-24 芯片**（A1 定案）。理由：课程要求"**把 TB6612 功能集成到底板**"，改成外插模块座就**违背了这条初心**；与"电源（U2/U3）集成到底板"是同一条要求，不能自相矛盾。<br>**连带含义**：SSOP-24 手焊难度大 ⇒ **贴片（SMT）成为值得考虑的路线**，且至少 `U1` 需要补立创料号 |

> **J16 备注**（留档，暂不做）：若将来要**独立于 IMU 的第二路 I2C**，
> `J16` 的 `PB8/PB9` 是 STM32F405 的 `I2C1`，配上 **2 只 4.7 kΩ 上拉到 +3.3V** 即可用
> （I2C 是开漏，**上拉是必需项，不是优化**）。
> 若只是想再挂一个 I2C 器件，优先**复用 `J2.22`/`J2.23`（PB10/PB11，MPU6050 那条总线）**更省。

---

## 六、协作方式建议（人机分工）—— 已按 2026-09-29 干跑实测校正

先说结论（实测依据见 [`../research/Agent接入EDA实测验证.md`](../research/Agent接入EDA实测验证.md) §九）：

> ### **人放件，机器接线。**

| 谁 | 做什么 | 为什么 |
|---|---|---|
| **你（A1）· EDA 界面** | **放置元件**：6 个座、蜂鸣器支路、R10–R14、C14–C19 | **API 放不了件** —— `sch_PrimitiveComponent.create()` 四种参数写法**全部 30 s 超时**，`lib_Device.get()` 对工程内嵌元件返回 `null`。而界面原生复制粘贴**已证明有效**（你贴的 J9，`devUuid` 与原板 J9 完全相同） |
| **我 · EDA API** | **接线与改网名**：把每个座的各脚改到正确网络、补/删电源符号、批量核对 | `sch_PrimitiveWire.create(line, net)` 与 `modify(wire,{net})` **实测可用，约 200 ms 完成**。这正是最容易漏、最费眼的部分 |
| **我 · 离线脚本** | 用 `hardware/sch_netlist.py` + `tools/sch_watch.py` 解析 `.esch2` 做**独立核验** | 两条路径互证，避免"以为连上了" |

**流程**：你放件 → 我用 API 接线 → 我用文件解析复核 → 你关 EDA 我终检。

> **纪律**（上次 API 改板坏过工程）：**先备份 → 在废板干跑 → 才动真板**。
> 本次干跑已做，**零残留**（核验：板卡 2 / 原理图 2 / PCB 2）。

### 6.1 基线快照

| 时间 | 位置 | 内容 |
|---|---|---|
| 2026-09-29 **22:27** | `hardware/_备份_参考01_copy_20260929-2227/` | 改板 35 位号（**只有 J9**，早于其余 5 个座的复制） |
| 2026-09-29 **22:50** | `hardware/_备份_参考01_copy_20260929-2250/` | **★ 接线整改完成后的正确状态**：40 位号 / 60 网络 |

> **回退提示**：若要回退，须**先关闭 EDA**（EDA 打开工程时会覆写磁盘文件），再复制备份覆盖工程目录。

### 6.2 ★ 接线体检与整改结果（2026-09-29）

**6 个座放入后，用 API 逐脚解算，发现接线有两处短路 + 一处 5V 直连隐患。**

#### ✅ 整改完成 —— 8 个座逐脚全部吻合（2026-09-29 22:50 复核通过）

| 座 | 脚 1 | 脚 2 | 脚 3 | 脚 4 |
|---|---|---|---|---|
| **J9** DHT11 | `GNDREF` | `+3.3V` | `PA7` | — |
| **J13** MQ-2 | `MQ2_AO` | `PB3` | `GNDREF` | `+5V` |
| **J10** MQ-135 | `MQ135_AO` | `PC3` | `GNDREF` | `+5V` |
| **J11** 红外L | `+5V` | `GNDREF` | `PB12` | — |
| **J14** 红外R | `+5V` | `GNDREF` | `PC1` | — |
| **J5** HC-SR04 | `+5V` | `PC4`(TRIG) | `PB0`(ECHO) | `GNDREF` |
| **J7** 蓝牙 | 空 | `PA2` | `PA3` | `GNDREF` ｜ `+5V` ｜ 空 |
| **J15** 取电排 | `+5V/GND` 交替 ×6（原本就对，未动） | | | |

> **复核方式（两条独立路径）**：
> ① API 连通性解算（导线网名 + 电源符号，按几何走线）；
> ② 离线解析 `.esch2`（`hardware/sch_netlist.py`）—— 位号 40、网络名 60（新增 `MQ2_AO`/`MQ135_AO`）。
> 另做**全局防短路检查**：35 个电源符号两两之间无 `+5V ↔ GNDREF` 串通 ✅

#### 整改前查出的问题（留档）

1. J10 与 J13 撞网（`PB3`/`PA5` 完全相同）—— J10 是从"原"板 J13 复制的，老网一并带了过来
2. J11 与 J14 撞网（OUT 都是 `PA4`）
3. `J13.4 = PA5` / `J10.4 = PA5` —— MQ 的 5V 模拟输出当时**直连在 MCU 的 `PA5` 上**

#### ★★ 本次踩到的坑（写下来避免重犯）

**用 API 建导线时，两条规则必须遵守：**

| # | 规则 | 为什么 |
|---|---|---|
| 1 | **先删旧导线，再建新导线** | `create(line, net)` 传空网名时，新导线会**继承落在其坐标上的既有图元的网名**。旧线没删干净 → 新线继承了错网名 |
| 2 | **不要让多条新建导线共享端点** | EDA 会把它们**合并成一条导线**。我第一次把 4 条 +5V 走线都汇聚到同一个电源符号，结果 4 条被合并成一条 **42 个顶点的导线**，并继承了错误的网名（`PB3`），造成 `GND`/`+5V`/`PB3` 串接 |

> **正确做法**：删除区域内全部旧线 → 每条走线用**独立车道**（不同 x）→ 建完立即用连通性解算复核。
> 合并本身不是错（同网合并无害），**错的是合并后继承了别的网的网名**。

#### 网络规约（本次查明）

| 类型 | 由什么承载 | 网络名 |
|---|---|---|
| 信号网 | **带网名的导线** | `PA5`、`PB3`、`MQ2_AO`… |
| 电源网 | **电源符号**（元件，`componentType = netflag`） | `POWER_+5V`、`POWER_GNDREF`、`POWER_+3.3V`、`POWER_+12V` |

> ⚠️ **`createNetFlag('Power', net, x, y)` 可用**，但它产出的是 EDA 自带符号（`Power-5V`/`Ground-GND`），
> 与工程原有的 `power_+5V`/`power_GNDREF` **不是同一个库器件**，视觉不一致；
> 而 `setNetFlagComponentUuid_*` 想指定原器件时又会报"获取器件详情失败"。
> **所以电源符号挪不动也换不了库器件** —— 只能"保留原符号，改导线去接它"。
>
> ⚠️ 电源符号（网标）**不能用 `sch_PrimitiveComponent.modify` 移动**：
> 报错"仅当器件类型为元件时允许使用该函数进行修改"。**只能删（`delete` 可以）或新建。**

### 6.3 ⚠️ 「原」板丝印标注 —— 与我们的分配有冲突（J9）

**2026-09-29 用 API 读出"原"板（Schematic1）上的 15 条模块标注**（`sch_PrimitiveText.getAll()`）：

| 标注文字 | 位置 | 最近的座 | 距离 |
|---|---|---|---|
| **蜂鸣器** | 170,190 | **J9** | **90** |
| MQ传感器阵列 | 360,315 | J14（370,370 那一摞） | 65 |
| 蓝牙 | 590,190 | J7 | 70 |
| 超声波 | 575,450 | J6 / J5（两者都在 80 内，**有歧义**） | 75 |
| 六路接口 | 560,315 | J7 | 85 |
| 开关 | 430,10 | J17 | 95 |
| 电机驱动A / B | 155,10 / 225,10 | J3 / J4 | 100 / 120 |
| 拓展电源 | 810,190 | J15 | 105 |
| ex接口 | 695,190 | J16 | 105 |
| 电压采样 | 810,385 | — | 110 |
| 60pinRGT6拓展板 | 275,580 | J1 | 120 |
| 串口4、5 | 395,190 | J8 | 120 |
| TB6612 / 12Vto5V&5Vto3V3 | — | U1 / U2,U3 | 远 |

#### ★ 冲突点

| 项 | 「原」板丝印 | 本项目文档的分配 |
|---|---|---|
| **J9**（3 针，`+3.3V/PA7/GND`） | **蜂鸣器** | **DHT11**（`改板规格书` §三 写的是"**改用途** + 加上拉"） |
| MQ 座（J10~J14 那一摞） | MQ传感器阵列 | J13/J10 → MQ-2/MQ-135；**J11/J14 → 红外避障**（也是"改用途"） |

> **结论**：J9 在"原"板上**本来就是蜂鸣器座**，我们的方案把它改成了 DHT11。
> 这**不是错误**（底板是重做的，可以重新分配），但需要 A1 明确拍板。

#### ✅ 已拍板（2026-09-29）：J9 维持给 DHT11，蜂鸣器另用 +5V 座

**决定性的理由是电压**：

| 模块 | 需要 | J9 能提供 | 结论 |
|---|---|---|---|
| **DHT11** | `3.3V` + 1 路 GPIO | `+3.3V / PA7 / GND` | ✅ **正好** |
| **蜂鸣器模块** | **`5V`**（A1 已上电实测：5V 下"挺响亮"） | 只有 `+3.3V` | ❌ **供电不足**，必须另给 +5V 座 |

> **旁证**：往届把 J9 做成蜂鸣器座、且板上 `BZ1` 也是经 `R6` 接 **`+3.3V`** ——
> 说明**他们用的是 3.3V 蜂鸣器**。我们手上是 5V 模块，所以两者不通用。
> **J9 保持现状（已按 DHT11 接好），无需返工。**

#### 蜂鸣器接法：两条路（现在信息齐了，推荐改选 A）

模块引脚 `VCC / I/O / G`，**有源、低电平触发、5V**。新增 3 针座 `J18`（`+5V` / `Q1(C)` 或 `PC5` / `GNDREF`）。

| | 接法 | 固件语义 | 需焊元件 | 复位安全性 |
|---|---|---|---|---|
| **方案 A（现推荐）** | **`PC5` 直连模块 I/O** | **低 = 响**、高 = 静音 | **0 件**（可选 1 只 10 kΩ 上拉到 `+3.3V`） | 复位时 `PC5` 浮空 → 模块内部上拉 → 高 → **静音** ✅ |
| 方案 B（原推荐） | 经 `Q1` 反相级 | 高 = 响 | `Q1`(SOT-23) + `R7` + `R8` | `R8` 把 `PC5` 拉低 → `Q1` 截止 → 静音 ✅ |

> **为什么现在改推方案 A**：查数据手册确认 **`PC5` 是 `FT`（5V 容忍）**，
> 所以模块 I/O 上的 5V 上拉**不会伤到 `PC5`**（倒灌约 0.17 mA）。
> 模块自带驱动，**不必再加 Q1 反相级** —— 省掉 3 个件（其中 Q1 是 SOT-23，不好焊）。
>
> **代价**：固件极性反过来（`低 = 响`）。给 B 说一声即可。
>
> 若希望固件保持"高 = 响"的直观语义，就用方案 B，多焊 3 件。

### 6.4 封装与料号现状 —— 能不能"打板时顺带贴片"？

> 问题由 A1 提出："现在的原理图是不是没有封装，不能打板下单时顺带一起买？"
> **2026-09-29 用 API 实测（`tools/eda_parts_stats.js`）**：

| 检查项 | 结果 |
|---|---|
| 有位号元件 | 82（含 42 个电源符号 ⇒ **实体元件 40 个**） |
| **元件级"封装"字段**（`getState_Footprint`） | **0 个**（全为空） |
| **`Origin Footprint` 属性** | **40 / 40 全部有** ✅ |
| **供应商料号**（立创商城 C 编号，`getState_SupplierId`） | **0 个** ❌ |

#### 结论

| 问题 | 答案 |
|---|---|
| **有没有封装？** | **有。** 封装记在每个元件的 `Origin Footprint` 属性里（KiCad 命名），且 PCB1 里已是实际焊盘。**EDA 能正常同步到 PCB，这一步没问题。** |
| **能不能随板一起贴片？** | **不能一键下单。** 嘉立创 SMT 要求 BOM 带**立创编号（C 开头）**，而当前 **0/40 个元件有料号** —— 得先在 EDA 里逐个指定商品，或用下单页的"BOM 匹配"人工对。 |

**实测到的封装（节选，KiCad 命名）**：

| 位号 | Origin Footprint | 类型 |
|---|---|---|
| R1/R2/C3… | `Resistor_SMD:R_0603_1608Metric`、`Capacitor_SMD:C_0603_1608Metric` | 0603 贴片 |
| C1/C2 | `Capacitor_SMD:CP_Elec_8x5.4` | 贴片电解 |
| C13 | `Capacitor_THT:CP_Radial_D8.0mm_P2.50mm` | **直插**电解 |
| U1 | `Package_SO:SSOP-24_5.3x8.2mm_P0.65mm` | **0.65 mm 间距，最难焊** |
| U2 | `Package_TO_SOT_SMD:TO-263-5_TabPin3` | 贴片 |
| U3 | `Package_TO_SOT_SMD:SOT-223-3_TabPin2` | 贴片 |
| J3/J4 | `Connector_JST:JST_EH_B6B-EH-A_1x06_P2.50mm_Vertical` | JST EH 2.5 mm 座 |
| J7 | `Connector_PinSocket_2.54mm:PinSocket_1x06_P2.54mm_Horizontal` | 卧式排母 |
| J9/J13 | `Connector_PinHeader_2.54mm:PinHeader_1x03/1x04_P2.54mm_Vertical` | 2.54 排针 |

#### 建议（学生项目 / 自费 / 小批量）

1. **板上的大头是直插件** —— J 系列排针排母、J17、SW2、C13 直插电解。
   **SMT 只贴贴片**，这些直插件要么自己焊，要么另选"插件焊接"（人工报价，另收费）。
2. **贴片里只有 `U1`(TB6612, SSOP-24 / 0.65 mm) 手焊难度大**；
   其余是 0603 阻容 + TO-263/SOT-223，手焊不难。
   所以务实的路线是：**要么全自己焊**（省贴片工程费），**要么只把 `U1` 拿去做贴片**。
3. **现在就能做的一件事**：新增元件（`R10~R14`、`C14~C19`、`J18`）**从"立创商城"库里挑**，
   而不是从通用器件库挑 —— 这样它们**自带立创料号**，将来想贴片随时能导出合规 BOM。

> ✅ **`U1` 芯片 vs 模块座 —— 已定案：保留 SSOP-24 芯片**（见 §五 D8）。
> A1 的理由：课程要求"**把 TB6612 功能集成到底板**"，改成外插模块座就违背了这条初心
> （与"电源 U2/U3 集成到底板"是同一条要求）。
>
> **连带结论**：SSOP-24（0.65 mm 间距）手焊难度大 ⇒
> **贴片（SMT）从"可选项"变成"值得认真考虑的路线"**，至少应给 `U1` 补立创料号。

### 6.5 ✅✅ 原理图**已完工**（2026-10-05 终态）

> **★ 一句话结论**：`"改"板原理图 = 104 元件 / 52 位号 / 65 网络，全部有封装、全部有立创料号，
> DRC 致命错误 0，已经可以导入 PCB。**（网络数按完工快照 `Schematic2/P1.esch2` 实测口径为 65；
> 早前正文写的 60 是开工期中间口径，见 §〇 的说明。）**

| 终态指标 | 数值 |
|---|---|
| 元件总数 | **104**（52 位号 + 49 电源符号 + 1 A4 图框 + 2 当前无名） |
| 位号数 | **52** |
| 网络名 | **65** |
| **有封装的位号** | **52 / 52** ✅ |
| **有立创料号的位号** | **52 / 52** ✅ |
| **DRC 致命错误** | **0** ✅（仅剩 29 条警告：3 个"不用的空脚" + 单端网络一类，**不拦导入**）|
| 悬空引脚 | 3 个，**全部是该空着的**：`J7.1`(STATE)、`J7.6`(PWRC)、`SW2.3`(不用的档位) |
| 全局防短路 | 42 个电源符号，**零串通** ✅ |
| 8 个模块座逐脚 | `J5/J7/J9/J10/J11/J13/J14/J18` **全部吻合** ✅ |

**本轮（9-30 ~ 10-05）新增/变更的元件**：

| 位号 | 器件（立创商城库） | 封装 | 值 | 立创编号 | 来源 |
|---|---|---|---|---|---|
| **J18** | 3 针排针座 | `HDR-TH_3P-P2.54-V-F` | — | `C54973828` | A1 手工放置 |
| **R10 / R12** | `RC0805BR-0710KL`（YAGEO） | `R0805` | 10 kΩ | `C6752026` | **Agent 用 API 放置** |
| **R11 / R13** | `CRG0805F15K`（TE） | `R0805` | 15 kΩ | `C3929039` | 同上 |
| **R14** | `RMC08054.7K1%N` | `R0805` | 4.7 kΩ | `C269746` | 同上 |
| **C14–C17** | `CT41G-0805-2X1-50V-0.1uF` | `C0805` | 0.1 µF | `C126469` | 同上 |
| **C18 / C19** | 100 µF/25V 贴片电解 | `CAP-SMD_BD6.3` | 100 µF | `C9900004126` | 同上 |
| **D1**（替换） | `ES2D_C212758`（DIOTEC） | `SMB_L4.6-W3.6` | ES2D | `C212758` | A1 替换（封装原来是错的）|
| **C1 / C2**（替换） | `RVT220UF35V67RV0024` | `CAP-SMD_BD8.0` | 220µF/35V | `C2836441` | A1 替换 |
| **C6 / C10**（替换） | `CA45A-B-25V-10uF-M` | `CAP-SMD_L3.5-W2.8` | 10 µF | `C20617242` | A1 替换 |
| **C13**（替换） | `220uF35V6.3x14GF` | `CAP-TH_BD6.3-P2.50` | 220 µF | `C49332886` | A1 替换 |
| **L1**（替换） | `STWRH105R-330MT` | `IND-SMD_L10.2-W10.0` | 33 µH | `C9900014639` | A1 替换 |
| **SW2**（替换） | `SS-12D10L5` | `SW-TH_SS-12D10L5` | — | `C319012` | A1 替换 |
| **J17**（替换） | `AM-1015B-M` | `CONN-TH_AM-1015B-M` | — | `C90631` | A1 替换 |
| **U1**（替换） | `TB6612FNG(O,C,8,EL` | `SSOP-24_L8.3` | — | `C141517` | A1 替换（**保留实芯 SSOP-24**）|
| **U2**（替换） | `LM2596S-5.0` | `TO-263-5_L10.1` | — | `C2980820` | A1 替换 |
| **U3**（替换） | `AMS1117-3.3` | `SOT-223-3_L6.5` | — | `C2891839` | A1 替换 |
| **CN1 / CN2** | `LAIL-PHC2.54-6P-01-XH-L` | `CONN-TH_AXH-6A-11` | — | `C54905977` | **原 `J3`/`J4` 更名** |

> §6.5.1 / §6.5.2 / §6.5.3 里那些"候选替换件"（`D5`、`C20~C24`、`L2`、`SW3`）
> **已全部被 A1 消化并删除**，现工程里**没有候选件残留** ✅

#### 6.5.0 元件已补齐（2026-09-30 00:19，历史记录）

**"改"板原理图元件已全部到位，接线全部核验通过。**

| 位号 | 器件（立创商城库） | 封装 | 值 | 来源 |
|---|---|---|---|---|
| **J18** | `Connector_Conn_01x03_Socket` | 2.54 排针 | — | A1 手工放置 |
| **R10 / R12** | `RC0805BR-0710KL`（YAGEO） | `R0805` | 10 kΩ | **Agent 用 API 放置** |
| **R11 / R13** | `CRG0805F15K`（TE） | `R0805` | 15 kΩ | 同上 |
| **R14** | `RMC08054.7K1%N`（Tyohm） | `R0805` | 4.7 kΩ | 同上 |
| **C14–C17** | `CT41G-0805-2X1-50V-0.1uF` | `C0805` | 0.1 µF | 同上 |
| **C18 / C19** | `100uF25v电解电容` | `CAP-SMD_BD6.3` | 100 µF | 同上 |

**终态核验（三条独立路径）**：

| 检查 | 结果 |
|---|---|
| 元件总数 | **109** = 52 有位号 + 43 电源符号 + 14 无名（A4 图框 + 13 个新建电源符号） |
| 网络名 | **62** |
| 逐脚网络（API 连通性解算） | 8 个座 + R10~R14 + C14~C19 + J18 **全部吻合** |
| 全局防短路（36 个电源符号） | **`+5V ↔ GND` 零串通** ✅ |
| 文件层解析（`hardware/sch_netlist.py`） | 与 API 结果一致 ✅ |

> **蜂鸣器按方案 A（`PC5` 直连）**，所以 **`Q1`/`R7`/`R8` 都不需要**。
> 原理图元件层面**已无缺口**。

#### ★★ 本轮新踩的四个坑（都已解决，写下来避免重犯）

| # | 坑 | 正确做法 |
|---|---|---|
| 1 | **API 放元件一直超时** | 传 `{libraryUuid, uuid}` **引用**会卡死；必须传 **`lib_Device.search()` 返回的完整器件对象** —— 这样不仅成功，**封装也齐全** |
| 2 | **按引脚端点删导线会误伤** | 一条"导线"可能已被 EDA **合并**成含多个插座的多分支折线；按端点匹配删除会连带干掉别人的线。**必须要求"所有顶点都落在指定区域内"才删** |
| 3 | **桥有 30 秒超时** | 一次请求里塞 30+ 个 create 会超时（**但 EDA 侧其实已经执行完**）。**每批控制在 ~10 个操作** |
| 4 | **`PCB1` 标签打开时，原理图写入全部失败** | 表现为 `create failed!` 或 30 s 挂起，而**读仍正常**。**改原理图前先关掉 PCB 标签** |

> 另有两条早前已记录：① 建导线**先删旧线**，否则新线会继承落在其坐标上的既有网名；
> ② **多条新线不要共享端点**，否则被合并后可能继承错误网名。

> ③ **挪动元件会弄断接线**：A1 手工挪动 R11/R13/R14 后，
> 出现 `PA5 短接到 GND`、`R13 接错到 PA5`、`R14 两脚被短路`（PA7 直吊 3.3V）。
> **挪完元件务必重跑逐脚核验**（`tools/eda_verify_all.js`）。

#### 6.5.1 封装统一为 0805 —— 只能在 EDA 界面做（2026-09-30）

A1 要求把 0603 换成 0805（0603 手焊太小）。**API 做不到**，两条路都试过：

| 路径 | 结果 |
|---|---|
| 直接改封装属性 | ❌ 原理图与 PCB 的组件接口**都只有 `getState_Footprint()`，没有 setter** |
| 用 0805 器件**原位替换** | ❌ 引脚几何不同，替换会把导线全弄断 |

**实测引脚几何**：

| 元件 | 引脚偏移 | 间距 |
|---|---|---|
| 0603 电阻（`Device_R`） | `(0,−15) (0,+15)` → **垂直** | 30 |
| **0805 电阻** | `(-20,0) (+20,0)` → **水平** | **40** |
| 0603 电容 | `(0,+15) (0,−15)` → 垂直 | 30 |
| **0805 电容** | `(0,−20) (0,+20)` → 垂直 | **40** |

**需要改的 16 件**（其余本来就够大）：

| 现封装 | 位号 | 数量 |
|---|---|---|
| `Resistor_SMD:R_0603_1608Metric` | R1 R2 R3 R4 R5 | 5 |
| `Capacitor_SMD:C_0603_1608Metric` | C3 C4 C5 C7 C8 C9 C11 C12 | 8 |
| `LED_SMD:LED_0603_1608Metric` | D2 D3 D4 | 3 |

**不用动的**：`R10~R14`(R0805)、`C14~C17`(C0805)、`C18/C19`(贴片电解 6.3)、
`C1/C2`(CP_Elec_8x5.4)、`C6/C10`(钽 3528)、`C13`(直插 8 mm)、`L1`、`U1/U2/U3`、各连接器。

> **操作**：界面里选中元件 → 右侧「属性」面板的**封装**一行 → 替换为 0805 封装。
> （或右键「替换器件」选一个 0805 器件。）
> 改完可用 `tools/eda_fp_list.js` 复核封装是否都对了、并重跑核验确认接线没被碰坏。

#### 6.5.2 ⚠️ `D1` 的封装是错的 —— 已备好替换件 `D5`

**问题**：`D1` 是 `ES2D` 二极管（LM2596 的续流二极管），但封装写的是
**`Capacitor_Tantalum_SMD:CP_EIA-6032-15_Kemet-U`（钽电容焊盘）** ——
ES2D 实际是 **SMB / DO-214AA（4.3×3.6 mm）**，与 6032 钽电容焊盘**脚距不同，装不上**。
（往届板带来的问题。）

**已在原理图空白处放好替换件**（2026-09-30，供手工替换）：

| 位号 | 器件（立创商城库） | 封装 | 立创编号 | 位置 |
|---|---|---|---|---|
| **D5** | **`ES2D_C212758`**（DIOTEC 德欧泰克） | **`SMB_L4.6-W3.6-LS5.3-L-FD`** | **`C212758`** | 图纸 (526, 650) |

**★ 极性（务必按这个接）**：实测 `D5` 的 **pin 1 = `A`（阳极）**、**pin 2 = `K`（阴极）**。
而原 `D1` 是 **pin 1 → 开关节点**（网名 `NET-(D1A-K)`，即 `L1.1`/`U2.2` —— 续流二极管的**阴极**侧）、
**pin 2 → `GNDREF`**（阳极）。

> **所以替换时是"反"的**：
> `D5` 的 **pin 2（K／阴极）→ 开关节点**，`D5` 的 **pin 1（A／阳极）→ `GNDREF`**。

**替换步骤（手工）**：
1. 删掉 `D1`
2. 把 `D5` 拖到 `D1` 的位置 **(690, 710)**，旋转到引脚竖直
3. 位号改成 **`D1`**
4. 接线：**阴极端 → 开关节点那根线**（原来 `D1.1` 的 `690,725` 处），**阳极端 → `GNDREF`**（原来 `D1.2` 的 `690,695` 处）

> 也可以右键 `D1` →「替换器件」搜 `ES2D_C212758`。但符号会从 3 脚变 2 脚，
> **导线可能脱开，改完必须重跑核验**（`tools/eda_verify_all.js`）。

> **备选器件**（同为 SMB，若想用肖特基效率更好）：
> `1N5824-SMB`(C9900006358, 5A/40V，LM2596 手册推荐) · `SS34-B`(C9900002114, 3A/40V)。

#### 6.5.3 大件替换候选件（已放好，供手工替换）—— 2026-09-30

原来没有立创料号的 7 个"大件"，已在各自原件旁边放好带料号的候选件，
**脚数已逐一核对一致**，供 A1 手工替换（与 `D5 → D1` 同样的做法）。

| 候选位号 | 用途 | 器件（立创商城库） | 封装 | **立创编号** | 位置 |
|---|---|---|---|---|---|
| **C20** | 替 `C1` | `RVT220UF35V67RV0024`（科尼盛）**＝原板 PCB1 同款** | `CAP-SMD_BD8.0-L8.3-W8.3` | **`C2836441`** | (419,755) |
| **C21** | 替 `C2` | 同上 | 同上 | **`C2836441`** | (809,588) |
| **C22** | 替 `C6` | `CA45A-B-25V-10uF-M` | `CAP-SMD_L3.5-W2.8-FD`（B型/3528） | **`C20617242`** | (1000,633) |
| **C23** | 替 `C10` | 同上 | 同上 | **`C20617242`** | (855,414) |
| **C24** | 替 `C13` | `220uF35V6.3x14GF`（米朗电子） | `CAP-TH_BD6.3-P2.50` | **`C49332886`** | (270,150) |
| **L2** | 替 `L1` | `STWRH105R-330MT`（33 µH） | `IND-SMD_L10.2-W10.0`（原设计 10.4×10.4 ✅） | **`C9900014639`** | (769,651) |
| **SW3** | 替 `SW2` | `SS12D00G3`（3 脚拨动开关） | `SW-TH_SS-12D01-GX` | **`C9900018735`** | (400,171) |

##### ★ 顺带查实的一件事：**电机不走 5V，`L1` 的"5A"是过设计**

实测 `U1`(TB6612) 的电源脚：

| 脚 | 名 | 接到 |
|---|---|---|
| 13 / 14 / 24 | `VM2` / `VM3` / `VM1` | **`+12V`**（电机功率直接走 12V，不经 LM2596）|
| 20 / 19 | `VCC` / `STBY` | `+5V`（只有逻辑）|

**接在 `+5V` 上的负载**（共 34 个脚）：MCU 拓展座(J1/J2)、蓝牙、超声波、
4 个 MQ/红外座、蜂鸣器座、AMS1117 输入、TB6612 的 VCC/STBY 与去耦电容 ——
**全部是逻辑/传感器，合计约 0.5 A**。

> 所以 `L1` 的电流规格**不需要 5 A**：0.5 A 负载 + 0.6 A 纹波 → 峰值约 **1.1 A**，
> **2 A 电感已够，3 A 有充裕余量**。`L2` 若标称电流偏低也不用担心。
> 想更稳的话可换 `33uH/3A,CD1005,10X10`（**C9900018751**，10×10 mm，明确标 3 A）。
>
> **面积代价**：16 件从 0603 换 0805，占板面积约增加 **1%** —— 可以忽略。

---

## 七、待确认项（开工前最好弄清）

| # | 项 | 影响 |
|---|---|---|
| 1 | ~~红外模块 OUT 的高电平~~ | ✅ **已在设计上消除**：红外 L 改接 `PB12`（5V 容忍），R 的 `PC1` 本身安全 —— **不需要测量、不需要电源** |
| 2 | ~~蜂鸣器有源/无源~~ | ✅ **已确认有源**（上电实测）→ 固件 GPIO 开关，`决策记录` 第 9 条要改 |
| 3 | **插座在板上的摆放方向** | 决定 PCB 丝印上"脚 1"标在哪一端。**必须在 PCB 丝印上印出每脚功能名**（见 §〇之二 的硬约束） |
| 4 | 蓝牙 `STATE` / `PWRC` 两个空脚是否利用 | 利用 `PWRC` 可进 AT 模式改波特率（解决"默认 9600 vs 协议 115200"）；`STATE` 可让固件知道连接状态。不用就留空 |
| 5 | 控制板 `PB10/PB11` 是否已有 I2C 上拉 | 只影响将来扩 I2C |
| 6 | `J13.2`(DO) → `PB3`：烧录是否用 SWD（PB3 = JTDO） | 若用 JTAG 则冲突；用 SWD 则无问题（`PB3` 本身是 5V 容忍的 `FT`） |

---

## 八、变更记录

| 日期 | 内容 |
|---|---|
| 2026-09-29 | 初版：实测"改"板原理图缺口（15 个位号，含被漏记的蜂鸣器支路），给出 7 阶段完善计划、连接点验收表与待决事项 |
| 2026-09-29 | 按 A1 拍板更新：`J8`/`J12`/`J16` 不补；蜂鸣器改为"低电平触发模块"方案 A/B；新增件封装定 **0805**、大电容定 **直插电解** |
| 2026-09-29 | **按 A1 实测的模块引脚顺序重做插座定义**：查出 J13/J10/J9 三处顺序与实际模块不符（直插会烧器件）；J10 由 3 针升为 4 针；确立"插座按模块丝印定义"原则；新增 S1（红外 OUT 电平）/S2（J5 顺序）两个安全项；蜂鸣器确认**有源** |
| 2026-09-29 | **按 STM32F405 数据手册 Table 6 逐脚查证 5V 容忍度**：更正上一版误判 —— `PA4`=`TC`（非 5V 容忍）但 `PC1`=`FT`（5V 容忍），故风险只在红外 L 一路；补充"FT 引脚做 ADC 仍不得超 3.3V"的澄清 |
| 2026-09-29 | **补入 HC-SR04 与蓝牙模块的引脚顺序**：确认 J5 中间两脚（TRIG/ECHO）反了、J7 整体反了（直插会把 5V 灌进 `PA2`），两者均列入必修项并给出新定义；因 J7 一例发现"必须靠 PCB 丝印标脚名"这条硬约束 |
| 2026-09-29 | **消除红外电平的不确定性（不需要电源测量）**：红外 L 的 OUT 由 `PA4`（`TC`）改接 **`PB12`**（`FT`，5V 容忍），红外 R 的 `PC1` 本身安全；查实验室模块清单确认红外为 **ST018**（3.3–5V / TTL 输出） |
| 2026-09-29 | **蜂鸣器上电实测确认「有源」**（此前与实验室清单 ST042"无源"冲突，已澄清）→ 固件用 GPIO 开关、**PWM 作废**，`决策记录` 第 9 条列为待改 |
| 2026-09-29 | **API 干跑实测（在临时废板，零残留）**：`create()` 放件 4 种写法全部 30 s 超时、`lib_Device.get()` 返回 null → **API 不能放件**；但**导线与网名的建/改完全可用（约 200 ms）**。据此把分工校正为「**人放件、机器接线**」；确认已备份基线（35 位号/58 网络，J9 已补齐）；用 API 查出 **J9 引脚仍是老顺序、需重排** |
| 2026-09-29 | **6 个座已全部放入**（J10/J11/J13/J14/J15 到位）。API 逐脚解算接线，查出 **J10↔J13 撞网（PB3/PA5）、J11↔J14 撞网（PA4）** 两处短路，以及 `J13.4=PA5` 的 5V 直连隐患（**改完前勿通电**）；查明网络规约：**电源网靠电源符号承载（`POWER_+5V`），不能用导线网名代替**；新增 §6.2 接线体检表 |
| 2026-09-29 | **★ 接线整改完成**：8 个座逐脚全部吻合（API 连通性解算 + 离线解析双路径复核），全局防短路检查通过（35 个电源符号无 `+5V↔GND` 串通）。过程中踩到 **EDA 合并新建导线** 的坑（4 条 +5V 走线汇聚同一端子 → 合并成 42 顶点导线并继承错网名 `PB3` → 造成短路），已修复并沉淀两条 API 使用规则到 §6.2；新增 22:50 正确状态备份 |
| 2026-09-29 | **A1 发现 J9 原本是蜂鸣器座**（读"原"板 15 条丝印标注证实）。查电压后定案：**J9 维持给 DHT11**（只有 `+3.3V`，正合 DHT11；5V 蜂鸣器插它会供电不足；旁证：往届 `BZ1` 也是 +3.3V 供电，说明他们用的是 3.3V 蜂鸣器）。蜂鸣器改用新增 `J18`（`+5V`）；因确认 **`PC5` 是 5V 容忍 `FT`**，接法**改推方案 A（`PC5` 直连模块 I/O，省掉 Q1/R7/R8）**，固件极性为**低 = 响**。新增 §6.3 |
| 2026-09-29 | **实测封装与料号现状**（回应"能否打板顺带贴片"）：`Origin Footprint` **40/40 齐全**（封装没问题），但**立创料号 0/40** → **不能一键贴片下单**，需先指定商品或用 BOM 匹配。记录封装清单与务实建议。新增 §6.4 |
| 2026-09-29 | **`U1` 定案：保留 SSOP-24 芯片**（A1：课程要求"把 TB6612 集成到底板"，改模块座违背初心；与"电源集成到底板"同一条要求）。连带：**SMT 从可选项变为值得考虑的路线**，至少 `U1` 需补立创料号。新增 §五 D8；§6.4 相应改为已定案 |
| 2026-09-30 | **★ 原理图元件补齐、接线全部核验通过**：Agent 用 API 放入 R10~R14（0805）、C14~C19（0805/贴片电解），与 A1 放入的 J18 一并接线；逐脚解算 + 全局防短路 + 文件层解析**三路径复核通过**（109 元件 / 52 位号 / 62 网络 / 零短路）。过程中修掉两处自己造成的缺陷（J13/J10/J11/J14 断路、C18/C19 的 `+5V` 与地短路），并沉淀四个新坑到 §6.5 |
| 2026-09-30 | **A1 挪动元件后复核**：查出 `PA5 短接 GND`（R11）、`R13 接错到 PA5`、`R14 两脚短路`（PA7 直吊 +3.3V），**已全部修复**并复核通过（防短路检查 41 个电源符号无串通）。补充坑 #3「挪动元件会弄断接线」。另：**封装统一 0805 一事确认 API 无法完成**（无 footprint setter；原位替换会因引脚几何不同而弄断导线），改为界面操作，清单见 §6.5.1 |
| 2026-09-30 | 16 个封装全部换成 0805（A1 界面操作），悬空引脚普查通过（仅 3 个应空脚），**补 `U1/U2/U3` 立创料号**（`C88224`/`C2980820`/`C2891839`，用 `modify` 写 `supplierId`，**不换器件所以不弄断导线**）|
| 2026-10-05 | **★ 原理图完工**：A1 补齐 18 个缺封装（DRC 致命错误 18→0）；替换 `D1`（原封装是钽电容焊盘，已改 SMB）、`C1/C2/C6/C10/C13/L1/SW2/J17/U1/U2/U3`；`J3/J4` → **`CN1/CN2`**。Agent 复核并改名 `U5→U2`、`U6→U3`。终态 **104 元件 / 52 位号 / 65 网络 / 52 个封装齐全 / 52 个料号齐全 / DRC 致命 0 / 零短路**。文档全面对齐 |

---

> **项目归属**：中国石油大学（华东） 专业生产实习课程项目<br>
> **范围说明**：本项目不涉及 MiniBalance 控制板（STM32F405RGT6 版本）的硬件设计与改版；控制板直接沿用，A1 仅重做主底板。<br>
> **许可**：原创代码与文档采用 MIT License；第三方组件遵循各自原始许可证。
