pierrotto12138-code/balance-car-inspection-robot/docs/design_hardware/改板规格书_单底板方案.md

# 改板规格书 —— 单底板方案（方案 2）

> 📖 **动手改板请看** → [`焊接调试手册.md`](焊接调试手册.md)（原理图 3 步 + PCB 4 步 + 飞线预案）
> 📌 **完整背景与现状** → [`../handoff/交接说明.md`](../handoff/交接说明.md)
>
> ⚠️ **AI 自动改板已实测失败**（2026-09-24）：通过 EDA API 创建的原理图元件缺少
> `DeviceName`/`FootprintName` 字段，且新走线难以收敛 DRC。**结论：改板请手工做。**
>
> **进度（2026-10-15）**：`参考01_copy` 工程下"改"板（Schematic2 + PCB2）**已完工**、
> 已打样、**已焊好并完成两轮真机联调**（2026-10-13 / 10-15，见
> [`../design_firmware/真机联调问题清单.md`](../design_firmware/真机联调问题清单.md)）。
> 早前"已精简掉用不上的座（J6/J8/J9~J16）、**尚未加入 MQ 分压与 DHT11 上拉**"的说法
> 是 2026-09-29 的中间状态：**`J9`/`J10`/`J11`/`J13`/`J14`/`J15`/`J18` 已全部补回**，
> `R10~R14` 分压/上拉与 `C14~C19` 去耦**均已加入**（终态见
> [`原理图完善计划.md`](原理图完善计划.md) §6.5）。

> **基线工程**：`%USERPROFILE%\Documents\LCEDA-Pro\projects\参考01_copy`（`.eprj3` 文件夹格式）
> **原始蓝本**：中国石油大学（华东）第 14 组往届底板（`.eprj2` → 已转 `.eprj3` 并清理）
> **方案**：**只改这一块底板**，把气体分压网络与 DHT11 直接做在底板上，不另做转接板
> **平台**：保留车上 STM32F405RGT6 控制板 + TB6612/电压检测拓展板，仅重做底板
> **日期**：2026-09-24（2026-09-29 更新进度）
>
> ⚠️ **与任务书的偏差**：任务书写的是"主板 + 传感器转接板两块板"，本方案是**单底板**。
> 已决定**不动任务书**，在最终报告与答辩中说明基底复用情况。

## ✅ 接口兼容性已核实（2026-09-29）

改板前的三项核对**全部通过**，可以放心改：

| 检查项 | 结论 |
|---|---|
| **电机控制信号**（PWMA/方向/STBY/VM/VCC） | ✅ 与车上 OEM 底板**完全一致** |
| **编码器接口**（6 针顺序 + 引脚） | ✅ **完全一致** |
| **60 针核心板接口** | ✅ 与 OEM 底板 **STM1/STM2 逐行 30 行全对** |

> ⚠️ **编号陷阱**：OEM 底板用**顺序编号**（1→60），参考01 用 `Conn_02x15_Odd_Even` **奇偶交错**（1,2 / 3,4 / …）。
> **物理位置一致，但脚号叫法不同**——核对时**按行（物理位置）对，不要按脚号对**。
> 网络名（PB9/PA13/PA5…）是准的。

---

## 一、设计目标（对照任务书）

| 任务书要求 | 本方案落实 |
|---|---|
| 双路气体（MQ-2 + MQ-135）模拟量采集 | 底板新增 2 路分压网络 + 接口（**J13/J10 座序也改了**）|
| DHT11 温湿度（含在线补偿） | 底板新增单总线接口 + 上拉（**J9 座序改了**）|
| 红外避障 | **J11 改接 PB12**（原 PA4 非 5V 容忍）+ **J14 改序** |
| HC-SR04 超声波 | **J5 改序**（`+5V/PC4/PB0/GND`，原 TRIG/ECHO 是反的）|
| 蜂鸣器声光报警 | **新增 J18**，有源模块 **PC5 直连**（不用 Q1/BZ1/R7/R8）|
| 12V→5V→3.3V 电源集成 | **复用底板现有 U2 + U3**（正是老师要求集成的部分）|
| 60 针控制板接口 | 复用 J1 + J2（已三方互证） |
| 电机/编码器 | **`CN1`/`CN2`（原 J3/J4 更名）** + U1(TB6612 **实芯 SSOP-24**)|

---

## 二、★ 两处需要澄清的引脚问题（结论：都不必改板）

### 问题 1：超声波 TRIG —— 用 PC4 还是 PC2？

| | 往届底板 J5 | 我们控制板 | 我们源码 |
|---|---|---|---|
| ECHO | PB0 | J2.20 = **PB0** ✅ | PB0 |
| TRIG | **PC4** | J2.18 = **PC4** ✅ | PC2 |

**实测网表**：`/PC4` 同时连到 **J2.18 与 J5.3** —— 也就是说，
底板 J5 的 TRIG 脚**已经直连到控制板的 PC4 引脚**，通路现成。

**处置**：**不改板**。固件里把 TRIG 定义成 **PC4** 即可
（我们的 B 角本来就要重写固件；PC4 也是空闲的 ADC/GPIO）。
这比"改成 PC2 再删 J12"更省事、风险更低。

> 若将来确实要用 PC2，则需把 J5.3 的网络从 `/PC4` 改为 `/PC2`，
> 并处理 J12（其第 3 脚也是 `/PC2`）——**本方案不做**。

### 问题 2：J12 与 PC2

`/PC2` 连到 **J2.8（控制板 PC2）与 J12.3**。J12 是 **3 针备用座**（`+5V/GND/PC2`）。

**处置**：**保留**。它等于把 PC2 引出来备用（红外避障 R 若嫌 PC1 不够用，可改用此座）。

---

## 三、改后接口总表

> **★ 本节已于 2026-10-05 按"改"板 EDA 工程实测重写。**
> 本文其余章节是**早期方案稿**（当时结论是"不必改板"），
> 而实际执行中为了**安全**（避免 5V 直灌非容忍脚）**改了 8 个座的引脚顺序**。
> **引脚定义的最终依据 = EDA 工程 `Schematic2` + 《原理图完善计划》§6.5。**

| 位号 | 脚数 | 用途 | 引脚 1→n 的网络 | 处置 |
|---|---|---|---|---|
| **J1** | 30 | 控制板插座（上） | 见 §六 | 保留原样 |
| **J2** | 30 | 控制板插座（下） | 见 §六 | 保留原样 |
| **CN1** | 6 | 电机 A + 编码器 | `MA_OUT1 / GND / PB6 / PB7 / +5V / MA_OUT2` ★ | **原 J3 更名 + 座序按实物修正** |
| **CN2** | 6 | 电机 B + 编码器 | `MB_OUT1 / GND / PA0 / PA1 / +5V / MB_OUT2` ★ | **原 J4 更名 + 座序按实物修正** |
| **J5** | 4 | 超声波 HC-SR04 | `+5V / PC4(TRIG) / PB0(ECHO) / GND` | ★ **改序**（原为 `+5V/PB0/PC4/GND`，TRIG·ECHO 是反的）|
| **J7** | 6 | 蓝牙串口 | `NC / PA2 / PA3 / GND / +5V / NC` | ★ **改序**（原直插会 5V→PA2、GND→PA3）|
| **J9** | 3 | DHT11 温湿度 | `GND / +3.3V / PA7` | ★ **改序**（原直插会反极）+ R14 4.7k 上拉 |
| **J10** | 4 | MQ-135 | `MQ135_AO / PC3 / GND / +5V` | ★ **改序**（原为 3 针）+ R12/R13 分压 |
| **J11** | 3 | 红外避障 L | `+5V / GND / PB12` | ★ **改序 + 改引脚**（原 PA4 非 5V 容忍）|
| **J13** | 4 | MQ-2 | `MQ2_AO / PB3 / GND / +5V` | ★ **改序**（原直插会把 VCC 灌到 PA5）+ R10/R11 分压 |
| **J14** | 3 | 红外避障 R | `+5V / GND / PC1` | ★ **改序** |
| **J15** | 12 | 电源引出排（6 组 5V/GND） | `+5V/GND` 交替 ×6 | 保留原样 |
| **J18** | 3 | 蜂鸣器（**有源 5V 模块**） | `+5V / PC5 / GND` | **新增**（方案 A：PC5 直连，不用 Q1/R7/R8）|
| **J17** | 2 | **12V 电源输入座**（`AM-1015B-M`, `C90631`） | 电源正 / GND | 保留（**用途澄清**：是**输入**不是输出）|
| **SW2** | 3 | 电源总开关（`SS-12D10L5`, `C319012`） | `J17.1 / +12V(公共) / NC` | 保留（中间脚=公共端→`+12V`）|

**已删除/替换的座**：`J3`→`CN1`、`J4`→`CN2`；`J6`/`J8`/`J12`/`J16` 未保留（原方案即不补）。
**已删除的器件**：`BZ1`、`Q1`、`R6`、`R7`、`R8`（蜂鸣器走方案 A）。

### 传感器 → 引脚 对应（最终，按实测）

| 模块 | 座 | VCC | GND | 信号 |
|---|---|---|---|---|
| MQ-2 | J13 | +5V(4) | GND(3) | AO→**PA5**（经 R10/R11 分压）、DO→PB3(2) |
| MQ-135 | J10 | +5V(4) | GND(3) | AO→**PA6**（经 R12/R13 分压）、DO→PC3(2) |
| DHT11 | J9 | +3.3V(2) | GND(1) | DATA→**PA7**(3)（R14 4.7k 上拉） |
| 红外避障 L | J11 | +5V(1) | GND(2) | OUT→**PB12**(3) |
| 红外避障 R | J14 | +5V(1) | GND(2) | OUT→PC1(3) |
| 超声波 | J5 | +5V(1) | GND(4) | TRIG→**PC4**(2)、ECHO→PB0(3) |
| 蜂鸣器 | J18 | +5V(1) | GND(3) | I/O→**PC5**(2)（有源，低电平响） |

---

## 四、新增电路

### 4.1 气体传感器分压网络 ×2

MQ 模块在 **5V** 供电下 AO 最高接近 5V，而 STM32 ADC 上限 **3.3V**，**直连会击穿引脚**。

| 位置 | R 上（串入） | R 下（对地） | 分压比 | 5V 时输出 |
|---|---|---|---|---|
| PA5（MQ-2） | 10 kΩ | 15 kΩ | 0.600 | **3.00 V** ✅ |
| PA6（MQ-135） | 10 kΩ | 15 kΩ | 0.600 | **3.00 V** ✅ |

**接线（以 MQ-2 为例）**：
```
J13.pin4 ──[R 10k]──┬── PA5
        (MQ2_AO)    │
                  [R 15k]
                    │
                   GND
```
> 即：切断 J13.pin4 → PA5 的直连，串入 10k；PA5 对地接 15k。
> 网络名建议：座侧叫 `MQ2_AO` / `MQ135_AO`，MCU 侧保持 `PA5` / `PA6`。

**就近去耦**：PA5、PA6 各加 **0.1µF** 陶瓷电容对地（靠近 MCU 端）。

### 4.2 加热丝供电去耦 ×2

MQ 加热丝约 **150 mA/路**（两路 300 mA），是**脉冲负载**，会污染 ADC 与 IMU。

- 在 J10、J13 的 `+5V–GND` 就近各加 **100µF 电解 + 0.1µF 陶瓷**；
- 加热丝走线加宽（每路 300 mA 建议 ≥40 mil）；
- 加热丝供电线**避免与 I2C / 编码器线并行**。

### 4.3 DHT11 上拉

- `+3.3V ──[4.7k]── PA7`（单总线上拉，必需）；
- 数据线尽量短，远离电机走线。

---

## 五、BOM 增量（自费项）

| 位号（建议） | 器件 | 封装 | 数量 | 用途 |
|---|---|---|---|---|
| R10 | 10 kΩ | **0805** | 1 | MQ-2 分压（串入） |
| R11 | 15 kΩ | **0805** | 1 | MQ-2 分压（对地） |
| R12 | 10 kΩ | **0805** | 1 | MQ-135 分压（串入） |
| R13 | 15 kΩ | **0805** | 1 | MQ-135 分压（对地） |
| R14 | 4.7 kΩ | **0805** | 1 | DHT11 上拉 |
| C14 / C15 | 0.1 µF | **0805** | 2 | ADC 就近去耦 |
| C16 / C17 | 0.1 µF | **0805** | 2 | 加热丝去耦 |
| C18 / C19 | 100 µF | 电解（贴片/直插） | 2 | 加热丝储能 |

> 现有位号已用到 R8、C13，故新增从 **R10**、**C14** 起编（R9 留空，避免与后续调整冲突）。

> 座子全部复用现有（J9/J10/J11/J13/J14），**不新增接插件**。
> 自费总计约 **11 个无源件**，成本极低。

---

## 六、60 针控制板接口（J1 + J2，已互证，勿改）

### J1（30 脚）
| 脚 | 网络 | 脚 | 网络 | 脚 | 网络 |
|---|---|---|---|---|---|
| 1 | PB9 | 11 | PC10 | 21 | PA8 |
| 2 | PB8 | 12 | PA15 | 22 | PC9 |
| 3 | PB7 | 13 | PA14 | 23 | PC8 |
| 4 | PB6 | 14 | CANL | 24 | PC7 |
| 5 | PB5 | 15 | CANH | 25 | PC6 |
| 6 | PB4 | 16 | PA13 | 26 | PB15 |
| 7 | PB3 | 17 | PA12 | 27 | PB14 |
| 8 | PD2 | 18 | PA11 | 28 | PB13 |
| 9 | PC12 | 19 | PA10 | 29 | +5V |
| 10 | PC11 | 20 | PA9 | 30 | +5V |

### J2（30 脚）
| 脚 | 网络 | 脚 | 网络 | 脚 | 网络 |
|---|---|---|---|---|---|
| 1 | +5V | 11 | PA1 | 21 | PB1 |
| 2 | +5V | 12 | PA2 | 22 | PB10 |
| 3 | PC13 | 13 | PA3 | 23 | PB11 |
| 4 | PC14 | 14 | PA4 | 24 | PB12 |
| 5 | PC15 | 15 | PA5 | 25 | GND |
| 6 | PC0 | 16 | PA6 | 26 | +3.3V |
| 7 | PC1 | 17 | PA7 | 27 | GND |
| 8 | PC2 | 18 | PC4 | 28 | +3.3V |
| 9 | PC3 | 19 | PC5 | 29 | GND |
| 10 | PA0 | 20 | PB0 | 30 | +3.3V |

---

## 七、供电核算

| 负载 | 电流 | 来源 |
|---|---|---|
| MQ-2 + MQ-135 加热丝 | ~300 mA @5V | 底板 +5V |
| 控制板 + OLED + 蓝牙 + 超声波 + 编码器 | ~100 mA | 底板 +5V |
| DHT11 + 红外 ×2 | ~5 mA @3.3V | 底板 +3.3V |
| **5V 合计** | **~400 mA** | U2(LM2596S) 输出能力充足 |

> 底板 5V 走线容量约 0.9–1.2 A（1 oz 铜），现有负载 + 新增气体传感器仍在 **50% 以内**，
> **无需独立降压支路**。

---

## 八、⚠️ 待核实（写入报告前必须确认）

| # | 项 | 说明 |
|---|---|---|
| 1 | ~~L1 实际电感量~~ | ✅ **已确认 = 33µH 5A**（文档此前误记 10µH，已订正） |
| 2 | ~~D1 实际型号~~ | ✅ **已确认 = ES2D**（文档此前误记 SS34，已订正） |
| 3 | ~~U2 实际器件~~ | ✅ **已确认 = LM2596S-5.0(UMW)**，3A / 7–40V 入 / 5V 出 |
| 4 | **J13 的 PB3 是否被 SWO/JTAG 占用** | 若用 SWD 调试则 PB3 空闲；若用 JTAG 则 PB3=JTDO 会冲突 → **需确认烧录方式** |
| 5 | **红外避障模块电平** | 若 OUT 为 5V 电平，需确认 PA4/PC1 可容忍（STM32 多数 IO 为 5V 容忍，仍建议核对） |
| 6 | **MQ 模块引脚顺序** | VCC/GND/DO/AO 的实际排列，需与 J13/J10 逐脚对上 |
| 7 | **板框尺寸与安装孔** | 需与车架实测比对（往届板未必与我们车架完全一致） |
| 8 | **MQ-135 是否需要 DO** | 本方案 MQ-135 只走 AO（J10 是 3 针）；若要用 DO 需换 4 针座 |

> 已确认的实测参数（来自 `参考01_copy` PCB 元件属性）：
> **U1** = TB6612FNG(O,C,8,EL)、**U2** = LM2596S-5.0(UMW)、**U3** = AMS1117、
> **L1** = 33µH 5A、**D1** = ES2D、
> **R1** = 1.5K、**R2** = 1K/0.1%、**R3** = 10K/0.1%、
> **C1/C2/C13** = 220µF 35V、**C6/C10** = 10µF、**D2/D3/D4** = **0805** 红色 LED（`GL0805UR01`）。
>
> ⚠️ **订正（2026-10-09）**：本行原列 `Q1`/`BZ1`/`R6`/`R7`/`R8` —— 这些**在"改"板中已删除**
> （蜂鸣器走方案 A：`J18` + 有源模块 `PC5` 直连，见决策 26）；`D2/D3/D4` 原写 `0603`，
> 实测为 **0805**（见 [`BOM表.md`](BOM表.md)）。位号以 `BOM表.md` 的实测导出为准。

---

## 九、⚠️ 改板必须在 EDA 里进行（实测结论）

**实测（2026-09-24）**：把 `参考01_copy` 在 EDA 中打开后，直接修改其 `.eprj3` 源文件**会被 EDA 覆写**：

```
① 关闭 EDA 里的文档标签（Schematic + PCB）
② 直接改文件（加一个换行）
③ 8 秒后复查 → 我加的换行消失了，文件被 EDA 按内存状态重写
```

**原因**：`.eprj3` 虽然是纯文本，但 EDA 对该工程启用了**文件夹监听 + 持久化**
（日志里可见 `[folder-watch] chokidar degraded, snapshot takes over`）。
只要工程在 EDA 中处于打开状态，磁盘文件就是 EDA 的**输出**，不是输入。

**推论（对改板方式的影响）**：

| 方式 | 可行性 |
|---|---|
| 关 EDA → 脚本改文件 → 开 EDA | ✅ 可行（但每次都要关 EDA） |
| EDA 开着 → 脚本改文件 | ❌ **会被覆写** |
| 在 EDA 界面里手动改 | ✅ 推荐（A1 的画板工作） |
| 通过 EDA API 改（`eda.sch_Primitive*`） | ✅ 可行（EDA 负责落盘） |

> **给 A1 的建议**：正常用 EDA 界面改（放置元件、连线、铺铜），
> 这是最直观也最不易出错的方式；本规格书就是给这个界面操作做的图纸。

---

## 十、原理图改动清单（按顺序执行）—— 📜 历史作业稿

> ⚠️ **本节是完工前的作业稿**（板子已是终态、已焊好并完成两轮真机联调），
> **保留仅为理解当时的判断依据**；终态请对照 [`原理图完善计划.md`](原理图完善计划.md) §6.5。

> **关键机制**：本原理图的网络**靠名字连接**，不是靠物理连续性 ——
> 每段导线上挂一个 `ATTR key="NET"`，同名即同网。
> 因此"插入分压"只需**改网络名 + 新增元件与短导线**，不必切断既有连线。

### 步骤 1：改网名（把直连拆成两段网）

| 位置 | 原网名 | 改为 | 说明 |
|---|---|---|---|
| J13 第 4 脚那一段导线 | `/PA5` | **`/MQ2_AO`** | 座子侧改名 |
| J10 第 3 脚那一段导线 | `/PA6` | **`/MQ135_AO`** | 座子侧改名 |

> 控制板侧（J2.15、J2.16）的网名**保持 `/PA5`、`/PA6` 不变**。
> 这样 ADC 引脚仍是 `/PA5`、`/PA6`，而座子侧变成原始信号网。

### 步骤 2：新增 MQ-2 分压（2 只电阻）

| 元件 | 值 | 一端接 | 另一端接 |
|---|---|---|---|
| R10 | 10 kΩ | `/MQ2_AO`（J13.4 侧） | `/PA5`（ADC 侧） |
| R11 | 15 kΩ | `/PA5` | `GNDREF` |

### 步骤 3：新增 MQ-135 分压（2 只电阻）

| 元件 | 值 | 一端接 | 另一端接 |
|---|---|---|---|
| R12 | 10 kΩ | `/MQ135_AO`（J10.3 侧） | `/PA6`（ADC 侧） |
| R13 | 15 kΩ | `/PA6` | `GNDREF` |

### 步骤 4：新增 DHT11 上拉（1 只电阻）

| 元件 | 值 | 一端接 | 另一端接 |
|---|---|---|---|
| R14 | 4.7 kΩ | `/PA7`（J9.2 侧） | `+3.3V` |

> DHT11 是开漏单总线，必须上拉。J9 已提供 `+3.3V / PA7 / GND`。

### 步骤 5：新增去耦（可选但建议）

| 元件 | 值 | 位置 |
|---|---|---|
| C14 / C15 | 0.1 µF | `/PA5`→GND、`/PA6`→GND（就近去耦） |
| C16 / C17 | 0.1 µF | J10、J13 的 `+5V`→GND（加热丝去耦） |
| C18 / C19 | 100 µF | J10、J13 的 `+5V`→GND（加热丝储能） |

### 步骤 6：PCB 侧

1. 把新增元件同步到 PCB（`设计 → 更新/转换 PCB`）；
2. 布置在 J10/J13/J9 附近（分压电阻**尽量靠近 MCU 端**）；
3. 走线：`+5V` 加宽（≥40 mil）、`GND` 就近打过孔到底层地平面；
4. `MQ2_AO`/`MQ135_AO` 与 `I2C`/编码器线**分开走**；
5. 重新铺铜（底层 GNDREF）；
6. **DRC** → 导出 Gerber。

---

## 十一、变更记录

| 日期 | 内容 |
|---|---|
| 2026-09-24 | 初版：确定单底板方案；实测网表确认超声波 TRIG 已通 PC4（不必改板）；给出 5 路传感器接口分配、2 路分压网络与 BOM 增量 |
| 2026-09-24 | 补：实测确认 EDA 会覆写文件（改板須在 EDA 内进行）；补原理图 6 步改动清单与 PCB 侧要求 |

---

> **项目归属**：中国石油大学（华东） 专业生产实习课程项目<br>
> **范围说明**：本项目不涉及 MiniBalance 控制板（STM32F405RGT6 版本）的硬件设计与改版；控制板直接沿用，A1 仅重做主底板。<br>
> **许可**：原创代码与文档采用 MIT License；第三方组件遵循各自原始许可证。
