pierrotto12138-code/balance-car-inspection-robot/docs/design_hardware/电路设计说明文档.md

# 电路设计说明文档

> **角色 / 交付物**：A1（电路）—— 任务书要求的《电路设计说明文档》。
> **对象**：重做的 MiniBalance V5.0 **底板**（EDA 板「改」= `Schematic2` + `PCB2`）。
> **性质**：**统稿**文档 —— 内容来自本仓库既有材料（改板规格书 / 模块功能与原理说明 /
> 原理图完善计划 / 焊接调试手册 / pin_assignment / sensor_interface_notes / car_composition /
> 交接说明 / 决策记录 / BOM 表 / AGENTS §7），并标注来源以便回溯。**不含新创作的数字。**
> **数据基线**：完工快照 `hardware/硬件工程_完工版_20261008_最终/`（MD5 与工程一致）—— 2026-10-08 完工态。
> 版本：v1.1（2026-10-16）
> 📌 **A1 交付物一览（四件套 + 两附件）**：本文档（设计说明）· [`BOM表.md`](BOM表.md) ·
> [`上板测试记录.md`](上板测试记录.md)（焊接与测试）· [`../../hardware/gerber/`](../../hardware/gerber/)（Gerber/制造数据）；
> 附件：[`../../hardware/bom/采购记录_立创商城_SO26101014446.md`](../../hardware/bom/采购记录_立创商城_SO26101014446.md)（实际下单）、
> [`../../hardware/photos/`](../../hardware/photos/)（实物照片）。
> 📌 **硬件层后续状态（2026-10-15）**：板子**已打样、已焊好并完成两轮真机联调**；
> 本文档描述的是**板级设计（完工态）**，因此内容仍然有效，不受联调固件改动影响。
> 联调中确认的两点与"读本板信号"有关，照抄判读时注意：
> ① **台架目前只有 MQ-135，插在 `J13`**（`J10` 空、MQ-2 已烧毁待补）⇒ 名为 `MQ2`（`PA5`）的那一路
> 才是真在工作，`MQ135`（`PA6`/`J10`）是空输入；
> ② **OLED 显示正常**（页 1 / 页 2 / 厂商页）。联调结论见
> [`../design_firmware/真机联调问题清单.md`](../design_firmware/真机联调问题清单.md)。

---

## 1. 概述

**项目一句话**：基于平衡小车的仓储环境安全巡检机器人（课程：测控系统综合设计，第 1 组，4 人）。

**本板定位**：**把 MiniBalance V5.0 的底板重做**（原理图 + PCB + 制板），并把课程要求
"集成到底板"的电源与电机驱动等功能一并做进去；**控制板与拓展板沿用原车**，车架 / 电机 / 电池 / 车轮不变。

| 层 | 是否复用 | 说明 |
|---|---|---|
| **底板（本板 ★）** | **重做** | A1 的 PCB 交付物 |
| 控制板（STM32F405RGT6 + MPU6050 + CH340G） | 复用 | 插在本板的 `J1`+`J2` 60 针座上（见 `car_composition.md` §三） |
| 车架 / 电机 / 电池 / 车轮 | 复用 | 组员实测尺寸匹配（`决策记录.md` 决策 5） |

**与任务书的偏差（已知、需在报告中说明）**：任务书写的是"主板 + 传感器转接板两块板"，
本方案是**单底板**（不另做转接板，分压/上拉直接做在底板上）。
已决定**不重新提交任务书**，在报告与答辩中说明基底复用情况（见 `../handoff/交接说明.md` §1.2 决策 1、§3.6）。

**完工态数据（本板）**：

| 项 | 数值 | 来源 |
|---|---|---|
| 原理图 | **104 元件 / 52 位号 / DRC 致命错误 0**，52/52 有封装、52/52 有立创料号 | `原理图完善计划.md` §6.5；`BOM表.md` |
| PCB | **523 走线段 / 76 过孔 / 双面实心 GND 铺铜 / DRC 零错误零未连接** | `../handoff/交接说明.md` §1.3 |
| 板框 | **100.00 × 65.00 mm**（圆角 **R5.0 mm**），**3 个 ⌀3.2 mm 安装孔** | ★ 三方互证：EDA 完工快照 `PCB2.epcb2` 的 `BOARD_OUTLINE` 路径/圆形图元、**Gerber 外形层 `GKO`**、嘉立创生产档 `ko` + 钻孔档 —— 详见 [`../../hardware/gerber/README.md`](../../hardware/gerber/README.md) §五 |
| 层数 | **双层**（Top / Bottom） | 完工快照 `PCB2.epcb2` 层配置（`LAYER_PHYS` 仅 L1/L2 铜层）|
| 板厚 / 铜厚 / 表面处理 | **1.6 mm / 1 oz（内外各 1.0 oz）/ 有铅喷锡**；阻焊绿色、丝印白色、过孔盖油 | 嘉立创打样订单 `8942344A_Y2` 的工艺档 `YG/4te.json`（`thickness`/`cu_inner`/`cu_outer`/`finished`/`color_sm`/`color_ss`/`via`）|

> **PCB 渲染图**：见 [`图/PCB2_最终.png`](图/PCB2_最终.png)。

---

## 2. 系统框图

```
                    ┌──────── 控制板（复用，插 J1+J2 共 60 针）────────┐
                    │  STM32F405RGT6 · MPU6050 · CH340G · AMS1117    │
                    │  OLED 6 针座 · USER 按键(PB14) · LED(PB13)     │
                    └───────────────────┬───────────────────────────┘
                                        │ 2×15 + 2×15 = 60 pin
  ╔═════════════════════════════════════▼═════════════════════════════════════╗
  ║                      底板（本板 · 100 × 65 mm · 双层）                     ║
  ║                                                                           ║
  ║   ┌── 电源树 ───────────────────────────────────────────────────────────┐  ║
  ║   │ J17(12V输入) ─> SW2(总开关) ─> C13/C1 ─> U2(LM2596S) ─> L1 ─> +5V   │  ║
  ║   │                                            └ D1(ES2D 续流)          │  ║
  ║   │ +5V ─> U3(AMS1117-3.3) ─> +3.3V                                     │  ║
  ║   │ 指示：R4+D2(12V) · R5+D4(5V) · R1+D3(3.3V)                          │  ║
  ║   └─────────────────────────────────────────────────────────────────────┘  ║
  ║                                                                           ║
  ║   ┌── 电机驱动 ────────────────┐   ┌── 电池电压采样 ────────────────┐      ║
  ║   │ U1 TB6612FNG(SSOP-24 实芯) │   │ +12V─R3(10k)─┬─PB1(ADC1_IN9)  │      ║
  ║   │  VM1/2/3 ← +12V            │   │              R2(1k)  C12(0.1µF) │      ║
  ║   │  VCC/STBY ← +5V            │   │              └ GND            │      ║
  ║   │  MA_OUT1/2 → CN1(电机A)    │   └───────────────────────────────┘      ║
  ║   │  MB_OUT1/2 → CN2(电机B)    │                                          ║
  ║   └────────────────────────────┘                                          ║
  ║                                                                           ║
  ║   ┌── 外挂模块座（8 个，座序按模块丝印定义）──────────────────────────────┐  ║
  ║   │ J13 MQ-2   ─ R10/R11 分压 ─> PA5(ADC2)      C14 去耦                 │  ║
  ║   │ J10 MQ-135 ─ R12/R13 分压 ─> PA6(ADC2)      C15 去耦                 │  ║
  ║   │ J9  DHT11  ─ R14 4.7k 上拉 ─> PA7                                   │  ║
  ║   │ J5  HC-SR04 → PC4(TRIG) / PB0(ECHO)                                 │  ║
  ║   │ J7  蓝牙    → PA2(USART2_TX) / PA3(USART2_RX)                       │  ║
  ║   │ J18 蜂鸣器  → PC5（有源模块，低电平响）                              │  ║
  ║   │ J11 红外 L  → PB12 ┐  两座 DNP：留焊盘、不装排针                     │  ║
  ║   │ J14 红外 R  → PC1  ┘                                                │  ║
  ║   └─────────────────────────────────────────────────────────────────────┘  ║
  ║   J15 取电排(+5V/GND ×6)        CAN(H/L 走 J1/J2)      NRF 预留(未做座)     ║
  ╚═══════════════════════════════════════════════════════════════════════════╝
```

**设计原则**（本次改板的定调，见 `原理图完善计划.md` §〇之二）：
**底板是重做的，插座引脚顺序就按模块实物丝印来定义 —— 做到"直插、不用转接、不会插反"。**
配套硬约束：所有新增/改动的插座**必须在 PCB 丝印上印出每脚功能名**（`VCC`/`G`/`OUT`/`TRIG`/`ECHO`…），
方向由丝印决定，不靠记忆。

---

## 3. 电源设计

### 3.1 电源树

`J17`(12V 输入) → `SW2`(总开关) → `C13`/`C1` → `U2`(LM2596S) → `L1` → **+5V** → `U3`(AMS1117) → **+3.3V**
（见 `AGENTS.md` §7）

| 环节 | 位号 / 器件 | 立创料号 | 说明 |
|---|---|---|---|
| 12V 输入座 | **`J17` = `AM-1015B-M`** | `C90631` | **是输入座**（不是"开关输出"，见 §11 偏差 3）|
| 总开关 | **`SW2` = `SS-12D10L5`**（三脚拨动） | `C319012` | 中间脚 = 公共端 → 板内 `+12V`；`SW2.3` 空（不用的档位）|
| 输入储能 | `C13` 220µF/35V（直插）· `C1` 220µF/35V | `C49332886` · `C2836441` | 大电容储能 + 小电容滤高频 |
| 12V→5V | **`U2` = `LM2596S-5.0`**（Buck） | `C2980820` | 3 A / 7–40 V 输入 / 5 V 输出 |
| 储能电感 | **`L1` = `STWRH105R-330MT`，33 µH** | `C9900014639` | Buck 必需功率元件 |
| 续流二极管 | **`D1` = `ES2D`**（肖特基，DO-214AA/SMB） | `C212758` | 开关断开时经 `D1` 续流 |
| 5V→3.3V | **`U3` = `AMS1117-3.3`**（LDO） | `C2891839` | 压差 1.7 V 以热量耗散 |

**原理（开关降压）**：`U2` 内部开关管约 **150 kHz** 通断，把 12 V 斩成方波；导通时经 `L1` 向输出供电并储能，
断开时 `L1` 靠自感电动势经 `D1` 续流；`L1`+输出电容把方波平滑成 5 V；FB 脚采样输出自动调整占空比稳压。
效率约 **80%**，代价是纹波较大。

**原理（线性稳压）**：`U3` 内部调整管工作在线性区，等效自动可调电阻，
把 (5 − 3.3) = 1.7 V 以热耗散掉 —— 效率 3.3/5 ≈ **66%**，但**纹波极小、无高频开关噪声**。
（以上原理与效率数值见 `模块功能与原理说明.md` §二）

### 3.2 为什么要"两级"

| 轨 | 供电对象 | 为什么这样供 |
|---|---|---|
| **+12V** | 电机、`U1`(TB6612) 的 `VM1/VM2/VM3` | 电池直供，功率大，不经 LM2596 |
| **+5V** | 控制板、OLED、蓝牙、超声波、编码器、**MQ 加热丝**、TB6612 的 `VCC`/`STBY` | 开关电源效率高、电流足 |
| **+3.3V** | MCU 内核、MPU6050、DHT11、红外、蜂鸣器座 | LDO 纹波小，ADC 更准 |

> ★ **电机走 `+12V`，不走 `+5V`**（实测 `U1` 的 `VM1/VM2/VM3` 全接 `+12V`，只有 `VCC`/`STBY` 接 `+5V`）；
> 由此得出 `L1` 的 "5 A" 是**过设计**（见 `决策记录.md` 决策 29、`原理图完善计划.md` §6.5.3）。

### 3.3 各支路电流估算与裕量

| 负载 | 电流 | 来源轨 | 依据 |
|---|---|---|---|
| MQ-2 + MQ-135 加热丝 | ~300 mA（150 mA/路） | +5V | `sensor_interface_notes.md` §1.2；`改板规格书` §七 |
| 控制板 + OLED + 蓝牙 + 超声波 + 编码器 | ~100 mA | +5V | 同上 |
| `+5V` 合计 | **~400 mA** | — | 同上 |
| 挂在 `+5V` 上的全部逻辑/传感器负载（含 TB6612 的 VCC/STBY 与去耦） | **约 0.5 A** | +5V | `原理图完善计划.md` §6.5.3（逐脚统计）|
| DHT11 + 红外 ×2 | ~5 mA | +3.3V | `改板规格书` §七 |
| 电机（A/B 两路） | **额定 1.44 A / 堵转 4 A（每路）**；额定扭矩 1.6 kg·cm、4 W | +12V | 电机铭牌型号 **`MG513P3012V`**（2026-10-16 由 A1 现场读）；电流取同型号第三方规格 [Robot-Maker MG513P30](https://www.robot-maker.com/shop/moteurs-et-actionneurs/617-moteur-12v-mg513p30-617.html)（`Courant 1.44A` / `Courant de blocage 4A`）。⚠ **非本机实测**；**两路同时堵转瞬时 ≈8 A** —— 短时由电池与铜箔热容吸收，长时间堵转需复核（见 [`上板测试记录.md`](上板测试记录.md) §6.2）|

**裕量结论**：`U2`（LM2596）额定输出 **3 A**，实际 5V 负载 ~0.4–0.5 A ⇒ **余量充足，不需要独立降压支路**。
底板 5V 走线容量约 **0.9–1.2 A**（1 oz 铜、0.5 mm 宽），现有负载仍在 50% 以内（`sensor_interface_notes.md` §1.2）。
`L1` 电流需求：0.5 A 负载 + 0.6 A 纹波 ⇒ 峰值约 **1.1 A ⇒ 2 A 电感已够、3 A 充裕**（`原理图完善计划.md` §6.5.3）。

### 3.4 保护、滤波与去耦

| 项 | 做法 | 来源 |
|---|---|---|
| 输入储能 | `C13`/`C1` = 220 µF/35V 大电容 + 0.1 µF 小电容 | `模块功能与原理说明.md` §2.1 |
| 5V 输出滤波 | `C2` = 220 µF/35V + 0.1 µF | 同上 |
| 3.3V 侧滤波 | `C6`/`C10` = 10 µF + 0.1 µF | `模块功能与原理说明.md` §2.2 |
| 续流 | `D1` = `ES2D` 肖特基（`D1` 阴极→开关节点 `SW_NODE`，阳极→`GNDREF`，已实测） | 完工快照逐脚网络 |
| 电源指示 ×3 | 12V：`R4`(5.1 k)+`D2`；5V：`R5`(4.7 k)+`D4`；3.3V：`R1`(1.5 k)+`D3`（LED 正向压降约 2 V，串联限流） | `模块功能与原理说明.md` §2.4；BOM 阻值反推（`0805W8F5101T5E`/`0805W8F1501T5E`）|
| 全局防短路 | 原理图侧 42 个电源符号两两之间 **`+5V ↔ GND` 零串通** | `原理图完善计划.md` §6.5 |

> **`+12V` 网上没有任何其他电源来源** ⇒ **`SW2` 断开即全板断电** ✅（`模块功能与原理说明.md` §八实测）。

---

## 4. 电机驱动

### 4.1 为什么把 TB6612 集成到底板

课程要求"**把 TB6612 功能集成到底板**"，与"电源（`U2`/`U3`）集成到底板"是同一条要求。
改成外插模块座会**违背这条初心**，故 **`U1` 保留 `SSOP-24` 实芯芯片**（A1 定案，`决策记录.md`；`原理图完善计划.md` §五 D8）。
连带结论：SSOP-24（0.65 mm 间距）**手焊难度大** ⇒ 贴片（SMT）成为值得认真考虑的路线，`U1` 必须补立创料号。

| 项 | 内容 |
|---|---|
| 器件 | **`U1` = `TB6612FNG(O,C,8,EL)`**，封装 `SSOP-24`，立创料号 **`C141517`** | 
| 作用 | 驱动**两个**直流减速电机（正转/反转/调速）|
| 电源 | `VM1/VM2/VM3`（脚 13/14/24）= **+12V**；`VCC`（脚 20）= **+5V**；`STBY`（脚 19）= **+5V**（常使能）|

### 4.2 引脚与信号（实测网络，与源码逐项吻合）

| 功能 | `U1` 脚位 | 来自 MCU | 源码出处 |
|---|---|---|---|
| A 路 PWM | 23 (`PWMA`) | **PA11** | `motor.c`（TIM1_CH4）|
| B 路 PWM | 15 (`PWMB`) | **PA8** | `motor.c`（TIM1_CH1）|
| A 路方向 | 21 (`AIN1`) / 22 (`AIN2`) | **PB5** / **PA15** | `motor.h` |
| B 路方向 | 17 (`BIN1`) / 16 (`BIN2`) | **PB4** / **PA12** | `motor.h` |
| 电机 A 输出 | 1/2 = `MA_OUT1`、5/6 = `MA_OUT2` | → `CN1` | 完工快照逐脚 |
| 电机 B 输出 | 11/12 = `MB_OUT1`、7/8 = `MB_OUT2` | → `CN2` | 完工快照逐脚 |
| 地 | 3/4/9/10/18 = `GNDREF` | — | 完工快照逐脚 |

**原理**：每个电机由 4 个 MOS 管组成 H 桥；对角线两个导通 → 正转，换一对 → 反转，所以**方向由 `AIN/BIN` 决定**；
PWM 不改方向，只让管子快速通断，**占空比 × 12 V = 平均电压** ⇒ 调速（50% ≈ 6 V ≈ 半速）。
`STBY` 高电平工作、低电平全部输出关闭。
**为什么用 TB6612 而不是 L298N**：MOS 输出导通电阻小、效率高、发热小，且内置续流二极管，外围元件少。
（以上原理见 `模块功能与原理说明.md` §三）

### 4.3 与编码器接口 `CN1`/`CN2` 的座序 —— ★ 踩过的坑

> **★ 座序必须对着实物丝印核，不能只信往届工程的网络表。**
> 原板 `J3`/`J4` 的 **pin2/pin5 与实物是反的**（实物 `AO1 / G / PB6 / PB7 / 5V / AO2`，
> 原板为 `MA_OUT1 / +5V / PB6 / PB7 / GND / MA_OUT2`）。
> **照原板座序插电机会把编码器的 `G` 接到 `+5V`、`5V` 接到 `GND` → 反极，霍尔编码器很可能烧毁。**
> 已在"改"板按实物修正（`决策记录.md` 决策 32；`AGENTS.md` §3.3 铁律 22）。

| 座 | pin1 | pin2 | pin3 | pin4 | pin5 | pin6 |
|---|---|---|---|---|---|---|
| **`CN1`**（电机 A）| `MA_OUT1` | **GND** | `PB6` | `PB7` | **+5V** | `MA_OUT2` |
| **`CN2`**（电机 B）| `MB_OUT1` | **GND** | `PA0` | `PA1` | **+5V** | `MB_OUT2` |

- 座子器件：`LAIL-PHC2.54-6P-01-XH-L`（6P XH），立创 `C54905977`；位号由原 `J3`/`J4` **更名为 `CN1`/`CN2`**。
- **编码器测速原理**：电机尾部 13 线霍尔编码器输出 A/B 两相正交方波 ——
  **脉冲数**算转速与里程、**A/B 相位先后**判转向；MCU 用定时器**编码器模式**硬件解码
  （A 相 → TIM4/`PB6`、B 相 → TIM4/`PB7`；另一路 → TIM2/`PA0`、`PA1`），**不占 CPU**。
- 电机规格：额定 12 V，减速比 1:30，空载约 366 RPM，车轮一圈 390 脉冲（四倍频后 **1560**）。
  （`模块功能与原理说明.md` §四、`car_composition.md` §四）

> **结论**：电机与编码器可**原样插上新板**，固件电机部分不用改（`../handoff/交接说明.md` §3.3）。

---

## 5. 电压采样电路

| 器件 | 参数 | 作用 | 实测网络（完工快照）|
|---|---|---|---|
| **`R3`** | 10 kΩ 0.1%（`RT0805BRD0710KL` / `C110775`） | 分压上臂 | `+12V` → `PB1` |
| **`R2`** | 1 kΩ 0.1%（`RT0805BRD071KL` / `C110774`） | 分压下臂 | `PB1` → `GNDREF` |
| **`C12`** | 0.1 µF | RC 低通滤波 | `PB1` → `GNDREF` |

```
  +12V ──[R3 10k]──┬── PB1 (ADC1_IN9)
                   │
              [R2 1k]
                   │
                  GND
```

**分压比**：`R2 / (R2 + R3) = 1k / 11k ≈ 0.0909`（即 **1/11**）。
12.6 V（满电 3S）→ ADC 端约 **1.145 V**，安全（ADC 上限 3.3 V）。

**软件反算与单位（0.01 V）**：固件 `Get_battery_volt()` = `Get_Adc(ch)*3.3*11*100/4096`
（`firmware/Drivers/BSP/ADC/adc.c`）—— 采样 480 周期、100 次求平均（`control.c`），
结果单位即 **0.01 V**（`Voltage = 1234` 表示 12.34 V）。

**低压阈值 11.10 V 的来历**：`Voltage < 1110` 即 11.10 V 时**强制关闭电机**保护电池
—— 见 `firmware/App/Control/control.c:253` 与 `firmware/App/Task/app_tasks.c:507`
（`hwFault = (Voltage > 0 && Voltage < 1110)`）。该数值来自厂商基线固件，**不是本项目新定的**。

> **⚠️ 文档间不一致**：`模块功能与原理说明.md` §六写"低于 **11.1 V** 关闭电机、低于 **11.5 V** 提示充电"，
> 而 `car_composition.md` §四写"低于 **11.1 V** 关电机、低于 **11.5 V** 建议充电"，
> 与**源码里只存在 1110 这一个硬件保护阈值**并不完全一致（固件未见 11.5 V 充电提示的实现）。
> **本设计以源码为准**：硬件保护阈值 = **11.10 V**；11.5 V 的"提示"来源 `[待补]`（需 B 提供）。

---

## 6. 传感器接口

### 6.1 气体传感器 MQ-2 / MQ-135 —— 分压网络（安全必需）

**问题**：MQ 模块在 **5 V** 供电下 AO 最高接近 5 V，而 STM32 ADC 上限 **3.3 V**，**直连会击穿引脚**。
**处置**：每路 AO 先**串 10 kΩ**、再**对地 15 kΩ**，把信号压到 3.0 V 以内再送 ADC
（`决策记录.md` 决策 14；`sensor_interface_notes.md` §1.1）。

```
J13.pin1 ──[R10 10k]──┬── PA5 (ADC2_IN5)  ← J2.16
 (MQ2_AO)             │
                   [R11 15k]   C14 0.1µF → GND
                      │
                     GND
（MQ-135 同构：J10.pin1 = MQ135_AO ─[R12 10k]─┬─ PA6 ─[R13 15k]─ GND，C15 0.1µF）
```

| 位置 | 串入（上臂） | 对地（下臂） | 分压比 | 5 V 时输出 | 就近去耦 |
|---|---|---|---|---|---|
| `PA5`（MQ-2） | `R10` 10 kΩ | `R11` 15 kΩ | 0.600 | **3.00 V** ✅ | `C14` 0.1 µF（`PA5`→GND）|
| `PA6`（MQ-135） | `R12` 10 kΩ | `R13` 15 kΩ | 0.600 | **3.00 V** ✅ | `C15` 0.1 µF（`PA6`→GND）|

> **★ 一个必须澄清的误区**：`PA6` 是 `FT`（数字 5 V 容忍），但**做 ADC 模拟输入时仍绝对不能超过 `VDDA`(3.3 V)** ——
> "5 V 容忍"是**数字输入**指标，模拟通道不受此保护。**所以 `R12`/`R13` 一只都不能省**（`原理图完善计划.md` §〇之二）。

**为什么保留两个网名**（改法要点，`焊接调试手册.md` §五）：座子侧改名、控制板侧不改名。
**两侧都改名** → `PA5` 网消失、读不到值；**都不改** → 电阻被短路、分压失效 → 5 V 直进 MCU 烧引脚。

### 6.2 加热丝供电与去耦

| 项 | 做法 | 实测网络 |
|---|---|---|
| 加热丝电流 | 单路约 **150 mA @5V**，两路约 **300 mA**，是**脉冲负载**，会污染 ADC 与 IMU | `sensor_interface_notes.md` §1.2 |
| 供电走线 | 加宽（每路 300 mA 建议 **≥40 mil**）；**避免与 I2C/编码器线并行** | 同上 |
| 模块就近去耦 | 每个模块 `VCC–GND` 就近加 **100 µF 电解 + 0.1 µF 陶瓷** | 同上 |
| **本板实现** | `C16`/`C17`（0.1 µF）+ `C18`/`C19`（100 µF/25V）—— 四只**都接在 `+5V` ↔ `GNDREF`** 上（实测），即"5 V 轨就近去耦" | 完工快照逐脚 |

> **⚠️ 与早期方案的差别**：`改板规格书` §4.2 原写"在 `J10`、`J13` 的 `+5V–GND` **各自**就近各加 100 µF + 0.1 µF"。
> 实际实现是**两只 0.1 µF + 两只 100 µF 全部挂在同一 5 V 轨**，并未按"每座一套"布置。**以实测为准**。

### 6.3 DHT11 温湿度 —— 上拉必需

| 项 | 内容 |
|---|---|
| 座 | **`J9`**（3 针）：`GNDREF / +3.3V / PA7` |
| 上拉 | **`R14` 4.7 kΩ，`PA7` → `+3.3V`**（实测网络一致） |
| 为什么必需 | DHT11 是**开漏单总线**，无上拉读不出数据（`决策记录.md` 决策；`改板规格书` §4.3）|
| 为什么不用 5 V | `J9` 只有 `+3.3V`，而 DHT11 正好要 3.3 V；**5 V 蜂鸣器模块插 `J9` 会供电不足**（`决策记录.md`）|
| 布线 | 数据线尽量短、远离电机走线（`改板规格书` §4.3）|

### 6.4 超声波 HC-SR04

| 项 | 内容 |
|---|---|
| 座 | **`J5`**（4 针）：`+5V / PC4(TRIG) / PB0(ECHO) / GND` |
| 改动 | ★ **原板中间两脚 TRIG/ECHO 是反的**（原为 `+5V/PB0/PC4/GND`），已改序 |
| 为什么必须改 | 直插时 MCU 的 `PC4`（推挽输出）会与模块的 `ECHO`（输出）**顶在一起**，两边对灌电流，有损坏风险（`原理图完善计划.md` §〇之二 S2）|
| 测距原理 | TRIG 给 >10 µs 脉冲 → 模块发 8 个 40 kHz 脉冲 → `ECHO` 高电平宽度 = 声波往返时间 t → **距离 = 340 m/s × t / 2**；MCU 用定时器**输入捕获**测宽 |

### 6.5 红外避障 `J11`/`J14` —— DNP 说明

| 项 | 内容 |
|---|---|
| 座序 | `J11` = `+5V / GND / PB12`；`J14` = `+5V / GND / PC1` |
| **DNP** | **保留焊盘与走线，不装排针**（BOM 里仍保留两座，`决策记录.md` 决策 30）|
| 为什么保留而不删 | ① 任务书明确写了"**HC-SR04 与红外模块**负责避障与循迹"，删掉有合规风险；② **删掉容易、加回来贵** —— PCB 删除后要用就得改原理图 + 重画 PCB + 重新打板；**保留焊盘零成本、可逆** |
| 安全考虑 | 红外 L 的 OUT 由 `PA4` **改接 `PB12`** —— `PA4` 是 `TC`（**非 5 V 容忍**），而红外模块（ST018，`VCC/G/OUT`）在 5 V 供电下 OUT 高电平就是 5 V，**直连会击穿**；`PB12` 与 `PC1` 都是 `FT`（5 V 容忍）（`决策记录.md` 决策 25）|
| 副作用 | `PB12`/`PC1` 两个 IO 因此**空闲**，可用于后续扩展；`J15` 取电排也可先不焊 |

---

## 7. 通信接口

| 链路 | 座 / 引脚 | 说明 | 来源 |
|---|---|---|---|
| **蓝牙（主链路）** | `J7` 6 针：`NC / PA2 / PA3 / GND / +5V / NC` | **USART2**；`PA2` = MCU TX → 模块 RXD，`PA3` = MCU RX ← 模块 TXD；经典蓝牙 SPP，**115200 8N1**，上位机被枚举为虚拟串口 | `../handoff/交接说明.md` §2.1、`决策记录.md` 决策 11 |
| **有线（调试/上位机）** | 控制板板载 **CH340G**（MicroUSB）→ `PA9`/`PA10` = **USART1** | 115200 8N1，与蓝牙**同协议、对等**；也是 **FlyMcu 串口 ISP 烧录**通道（DTR/RTS 自动拉 BOOT0） | `决策记录.md` 决策 34/45、`上板自检清单.md` §3.1 |
| **CAN** | 走 `J1`/`J2`：`CANH`(J2.15) / `CANL`(J2.14) | 源码中 `CAN1` 用 `PB8`/`PB9`（`can.c`）；本板仅把线引到 60 针座，**未在本板加收发器** | `改板规格书` §六、`pin_assignment.md` §二 |
| **NRF24L01（预留）** | **本板未做该座** | 源码中 NRF 初始化已注释禁用；其占用的 `PA5/PA6/PA7/PC4/PC5` 五路空闲 ADC 已被本项目改作他用 | `决策记录.md`（"从 NRF 座飞线接传感器"已废弃）|
| **航模遥控** | `PC6`/`PC7`（TIM8 输入捕获） | 走 60 针座，本项目不使用 | `pin_assignment.md` §二 |

> **蓝牙座序是为安全而改的**：原板 `J7` 定义为 `NC/+5V/GND/PA3/PA2/NC`，
> 与模块 `STATE/RXD/TXD/GND/VCC/PWRC` 相比**整体是反的** —— 直插会把 **5 V 灌进 MCU 的 `PA2`、GND 灌进 `PA3`**，
> 属"会烧板子"的错误（`原理图完善计划.md` §〇之二）。
> `J7.1`(STATE) 与 `J7.6`(PWRC) 有意留空（它们是原理图上仅有的 3 个"应空脚"中的两个）；
> 若将来要用 `PWRC` 接 IO 进 AT 模式改波特率，可解决"蓝牙默认 9600 vs 协议 115200"的待确认项。

---

## 8. 人机接口

> 本节内容以 `人机界面设计说明.md`（A2）与固件源码为准，**板上硬件部分**只列与本板有关的座与引脚。

### 8.1 OLED —— 在控制板上，不在本板

| 项 | 内容 |
|---|---|
| 位置 | **控制板上的 6 针座**，**本板无此座**（`模块功能与原理说明.md` §九）|
| 接口 | **软件 SPI（4 线）**：`PC0` = DC、`PC13` = SCL、`PC14` = SDA、`PC15` = RST |
| 屏 | 0.96 寸 128×64 单色，SSD1306 兼容 |
| 注意 | **不是 I2C** —— 与旧基底的 OLED 走 I2C 不同；MPU6050 才是软件 I2C（`PB10`/`PB11`） |

### 8.2 蜂鸣器 —— `J18`，有源模块，低电平响

| 项 | 内容 |
|---|---|
| 座 | **`J18`（新增，3 针）**：`+5V / PC5 / GNDREF` |
| 模块 | **有源**（自带振荡）、**低电平触发**、**5 V** —— A1 上电实测确认（`决策记录.md` 决策 26）|
| 接法 | **`PC5` 直连模块 I/O**，**不用** `Q1`/`R7`/`R8`/`BZ1`（省 3 个件，其中 `Q1` 是 SOT-23 不好焊）|
| 极性 | **低电平响**：`Buzzer_On()` → `PC5 = 0`；`Buzzer_Off()` → `PC5 = 1`；上电即置高，避免上电乱叫 |
| 为什么不用反相级 | 查数据手册确认 **`PC5` 是 `FT`（5 V 容忍）**，模块 I/O 上的 5 V 上拉不会伤 `PC5`（倒灌约 0.17 mA）|
| 复位安全性 | 复位时 `PC5` 浮空 → 模块内部上拉 → 高 → **静音** ✅ |
| 响的条件 | ① MQ-2 确认超阈值，或 ② MQ-135 确认超阈值，或 ③ 状态机进入 `FAULT` → 连续响（`app_tasks.c` UiTask）|

> **⚠️ 与 `模块功能与原理说明.md` §五 的冲突**：该文描述的是**旧方案**（`BZ1`+`Q1`+`R6`/`R7`/`R8`，
> 经三极管低边开关、接 `+3.3V`、高电平响、且提示"实验室是无源蜂鸣器需 PWM"）。
> **该节已过时**：`BZ1`/`Q1`/`R6`/`R7`/`R8` **在"改"板中已删除**，**以本节（决策 26）为准**。

### 8.3 USER 按键与 LED —— 在控制板上

| 项 | 引脚 | 语义 |
|---|---|---|
| **USER 按键** | **`PB14`**（输入，上拉；丝印 `USERKEY-B14`） | 单击 = 启停（**安全锁存期间无效**）；**双击 = 切 OLED 页**（页 0/1/2 循环，决策 48）；长按 = 普通/避障模式（厂商原语义）|
| **板载 LED** | **`PB13`**（丝印 `USERLED-B13`，**低电平点亮**） | 普通模式：按 `Led_Flash(100)` 闪烁（"程序在跑"）；避障模式：常亮；RTOS 钩子（栈溢出/堆耗尽）：常亮 |

> 按键与 LED **都在控制板上**，本板只通过 60 针座把 `PB13`/`PB14` 引出（`J2.28`/`J2.27`）。

---

## 9. 接口定义表（14 个连接器逐脚网络）

> **数据来源**：完工快照 `hardware/硬件工程_完工版_20261008_最终/pcb/PCB2.epcb2`
> 按 `Designator` + `PAD_NET` **逐脚解算**（52 位号 / 221 个带网焊盘全部对上），
> 与 `../handoff/交接说明.md` §2.1、`AGENTS.md` §7、`原理图完善计划.md` §6.5 **逐脚一致**。
> 网络名前缀 `POWER_` 为电源符号承载的电源网（`POWER_+5V` / `POWER_+3.3V` / `POWER_+12V` / `POWER_GNDREF`），
> 下表中简写为 `+5V` / `+3.3V` / `+12V` / `GND`。

板上共 **14 个连接器**，其中 **8 个是"模块座"**，另 6 个是结构/电源/电机接口（`../handoff/交接说明.md` §2.1.1）。

### 9.1 控制板插座（2 个，共 60 针）

> **表头命名以完工快照的实际位号为准**（见 §11 偏差 2）。
> **脚号陷阱**：OEM 底板用**顺序编号**（1→60），本板 `J1`/`J2` 用 `Conn_02x15_Odd_Even` **奇偶交错**；
> **物理位置一致，但"第几脚"叫法不同 —— 核对时按行（物理位置）对，不要按脚号对。**

**`J1`（2×15，30 针）**

| 脚 | 网络 | 脚 | 网络 | 脚 | 网络 |
|---|---|---|---|---|---|
| 1 | **+5V** | 11 | PA1 | 21 | PB1 |
| 2 | **+5V** | 12 | PA2 | 22 | PB10 |
| 3 | PC13 | 13 | PA3 | 23 | PB11 |
| 4 | PC14 | 14 | PA4 | 24 | PB12 |
| 5 | PC15 | 15 | PA5 | 25 | **GND** |
| 6 | PC0 | 16 | PA6 | 26 | **+3.3V** |
| 7 | PC1 | 17 | PA7 | 27 | **GND** |
| 8 | PC2 | 18 | PC4 | 28 | **+3.3V** |
| 9 | PC3 | 19 | PC5 | 29 | **GND** |
| 10 | PA0 | 20 | PB0 | 30 | **+3.3V** |

**`J2`（2×15，30 针）**

| 脚 | 网络 | 脚 | 网络 | 脚 | 网络 |
|---|---|---|---|---|---|
| 1 | PB9 | 11 | PC10 | 21 | PA8 |
| 2 | PB8 | 12 | PA15 | 22 | PC9 |
| 3 | PB7 | 13 | PA14 | 23 | PC8 |
| 4 | PB6 | 14 | CANL | 24 | PC7 |
| 5 | PB5 | 15 | CANH | 25 | PC6 |
| 6 | PB4 | 16 | PA13 | 26 | PB15 |
| 7 | PB3 | 17 | PA12 | 27 | PB14 |
| 8 | PD2 | 18 | PA11 | 28 | PB13 |
| 9 | PC12 | 19 | PA10 | 29 | **+5V** |
| 10 | PC11 | 20 | PA9 | 30 | **+5V** |

### 9.2 外挂模块座（8 个）

| 位号 | 脚数 | 模块 | pin1 | pin2 | pin3 | pin4 | pin5 | pin6 |
|---|---|---|---|---|---|---|---|---|
| **`J13`** | 4 | MQ-2 | `MQ2_AO` | `PB3`(DO) | **GND** | **+5V** | — | — |
| **`J10`** | 4 | MQ-135 | `MQ135_AO` | `PC3`(DO) | **GND** | **+5V** | — | — |
| **`J9`** | 3 | DHT11 | **GND** | **+3.3V** | `PA7` | — | — | — |
| **`J5`** | 4 | HC-SR04 | **+5V** | `PC4`(TRIG) | `PB0`(ECHO) | **GND** | — | — |
| **`J7`** | 6 | 蓝牙 | NC | `PA2` | `PA3` | **GND** | **+5V** | NC |
| **`J18`** | 3 | 蜂鸣器（有源） | **+5V** | `PC5` | **GND** | — | — | — |
| **`J11`** | 3 | 红外 L（**DNP**） | **+5V** | **GND** | `PB12` | — | — | — |
| **`J14`** | 3 | 红外 R（**DNP**） | **+5V** | **GND** | `PC1` | — | — | — |

### 9.3 电机 / 电源接口（4 个）

| 位号 | 脚数 | 用途 | pin1 | pin2 | pin3 | pin4 | pin5 | pin6 |
|---|---|---|---|---|---|---|---|---|
| **`CN1`** | 6 | 电机 A + 编码器 | `MA_OUT1` | **GND** | `PB6` | `PB7` | **+5V** | `MA_OUT2` |
| **`CN2`** | 6 | 电机 B + 编码器 | `MB_OUT1` | **GND** | `PA0` | `PA1` | **+5V** | `MB_OUT2` |
| **`J17`** | 2 | **12V 电源输入座** | `VIN_SW` | **GND** | — | — | — | — |
| **`J15`** | 12 | 5V/GND 取电排 | `+5V`/`GND` 交替 ×6（1=+5V, 2=GND … 12=GND） | | | | | |

### 9.4 未保留的座（有意删除）

`J6`（循迹 4 路）、`J8`（串口 4/5）、`J12`（`PC2` 备用）、`J16`（备用 IO）——
`J3`/`J4` → 更名 `CN1`/`CN2`；`J18` 新增。
**17 − 4 − 2 + 2 + 1 = 14**（`../handoff/交接说明.md` §2.1.1）。

### 9.5 关键器件料号速查（外挂座与主要芯片）

| 位号 | 器件 / 型号 | 封装 | 立创料号 |
|---|---|---|---|
| `J1` `J2` | `HC-PM254-8.5H-2x15PZ`（2×15 排母） | 插件 P=2.54 | `C22373920` |
| `J5` `J10` `J13` | `LAIL-PM2.54-4P-L`（4P 排针） | 插件 P=2.54 | `C54973823` |
| `J9` `J11` `J14` `J18` | `LAIL-PM2.54-3P-L`（3P 排针） | 插件 P=2.54 | `C54973828` |
| `J7` | `X6511FRS-06-C85D30`（6P 卧贴） | SMD P=2.54 | `C5142239` |
| `J15` | `DS1023-2*6SF11` | 插件 P=2.54 | `C92269` |
| `J17` | `AM-1015B-M` | — | `C90631` |
| `SW2` | `SS-12D10L5` | 插件 13×6.8 mm | `C319012` |
| `U1` | `TB6612FNG(O,C,8,EL)` | SSOP-24 | `C141517` |
| `U2` | `LM2596S-5.0` | TO-263-5 | `C2980820` |
| `U3` | `AMS1117-3.3` | SOT-223-3 | `C2891839` |
| `L1` | `STWRH105R-330MT`（33 µH） | 33UHSMD-1010 | `C9900014639` |
| `D1` | `ES2D`（DO-214AA/SMB） | SMB | `C212758` |

> 完整 52 位号 BOM（27 行合并，**52/52 均有立创料号**）见 [`BOM表.md`](BOM表.md)。

---

## 10. PCB 设计说明

### 10.1 层数与板框

| 项 | 值 | 依据 |
|---|---|---|
| 层数 | **双层**（Top = layer 1，Bottom = layer 2） | 完工快照 `PCB2.epcb2`：`LAYER_PHYS` 仅 L1/L2 有铜厚定义 |
| 板框尺寸 | **100.00 × 65.00 mm** | 板框 polyline 实测：x ∈ [−6.000, 94.000] mm、y ∈ [−58.908, 6.092] mm（跨度 100.00 × 65.00）；**EDA 官方板信息报告亦写"板子尺寸: 100mm x 65mm"**（[`Info_PCB_PCB2_2026-10-16.txt`](../../hardware/eda_export_20261016/Info_PCB_PCB2_2026-10-16.txt)）|
| 圆角 | **R5.0 mm**（四角圆弧） | `BOARD_OUTLINE` 路径的 `ARC` 段：端点偏移 196.85 mil = **5.0 mm**；嘉立创 `ko` 的圆弧 `I/J=196850`（10⁻⁶ in）互证 |
| 安装孔 | **3 个 ⌀3.2 mm**（画在外形层，制板走铣槽），孔心以板左下角为原点：**(6.0, 6.1) / (94.0, 6.1) / (6.0, 58.9) mm**（**右上角无孔**）| `BOARD_OUTLINE` 圆形图元 `path:["CIRCLE",cx,cy,r]` 中 **r = 62.9921 mil = 1.6 mm ⇒ ⌀3.2 mm**，共 **3 个**；嘉立创钻孔档 ⌀3.25 mm × 3 孔，坐标 (94.0, 6.1)/(6.0, 6.1)/(6.0, 58.91) **逐孔吻合** |
| **成品板厚** | **1.6 mm** | 嘉立创订单 `8942344A_Y2` 工艺档 `YG/4te.json` 的 `thickness = 1.6`（[`../../hardware/gerber/README.md`](../../hardware/gerber/README.md) §三）|
| **铜厚** | **1 oz**（内层 1.0 oz / 外层 1.0 oz） | 同档 `cu_inner`/`cu_outer` = 1.0 |
| **表面处理 / 油墨** | **有铅喷锡（HASL，有铅）**；阻焊**绿色**、丝印**白色**、**过孔盖油** | 同档 `finished`/`color_sm`/`color_ss`/`via` |
| 元件孔 / 过孔（钻孔设计口径） | 元件孔 **110** 个（⌀0.9×14、⌀1.02×12、⌀1.1×84）；过孔 **76** 个（⌀0.305×53、⌀0.508×23） | Gerber 钻孔档 `Drill_PTH_Through.DRL` / `Drill_PTH_Through_Via.DRL` 逐刀具计数（生产档孔径经嘉立创归并，见上引 §五）|

> **⚠️ 口径更正（2026-10-16，三处都改）**：本节此前写"**100 × 60 mm、圆角 R2.5 mm、4 个 ⌀1.6 mm 安装孔**"，**三项全错**：
> ① 尺寸 —— 把 y 跨度 65.00 mm 读成 60（同一行的坐标区间 `[−58.908, 6.092]` 本来就是 65.00）；
> ② 圆角 —— 把圆形图元的**线宽** `9.8425 mil (0.25 mm)` 当成了弧半径（真实弧半径 196.85 mil = **5.0 mm**）；
> ③ 安装孔 —— 把 `path:["CIRCLE",x,y,r]` 的**半径** 62.9921 mil 当成了**直径**（⇒ ⌀3.2 mm，不是 ⌀1.6 mm），
>    并把 4 条 `BOARD_OUTLINE` 记录（**3 个圆 + 1 个圆角矩形路径**）数成了 4 个孔。
> **以本节为准**；证据链（Gerber 外形层 + EDA 快照 + 嘉立创生产档 + 渲染图逐孔核对）见
> [`../../hardware/gerber/README.md`](../../hardware/gerber/README.md) §五，决策见 [`../决策记录.md`](../决策记录.md) 决策 81。
> ⚠️ **A2 做装配图/外壳必须按 100 × 65 mm + R5 + 3 孔布局**（`../design_hardware/上板测试记录.md` §5 已把这组值单列给 A2）。

> **⚠️ 与早期文档的差异**：`../handoff/交接说明.md` §3.5 与 §6 曾记"板框约 **87.8 × 63.2 mm**，需与车架实测比对"。
> 该数值是**往届原板**的量取结果；**"改"板实测为 100.00 × 65.00 mm**（本节与快照、Gerber、嘉立创档一致）。**以 100 × 65 mm 为准。**

### 10.2 线宽约定（实测分布）

**设计约定**（`AGENTS.md` §7）：电机/12V 主干 **40~80 mil** · +5V/+3.3V **25 mil** ·
模拟（`PA5`/`PA6`/`PB1`/`MQ*_AO`）**12 mil** · 一般信号 **10 mil** · **GND 靠铺铜**。

**完工实测分布**（完工快照 `PCB2.epcb2`，共 **523** 条走线段）：

| 线宽 (mil) | 条数 | 用途 |
|---|---|---|
| 10 | 245 | 一般信号 |
| 12 | 9 | 模拟（`PA5`/`PA6`/`MQ*_AO` 等）|
| 25 | 173 | +5V / +3.3V 电源 |
| 40 | 80 | 电机 / 12V 主干 |
| 60 | 14 | 电机 / 12V 主干 |
| 80 | 2 | 电机 / 12V 主干 |

> 合计 523 条，与"523 走线段"记录一致；**无低于 10 mil 的走线**。

### 10.3 过孔与铺铜

| 项 | 值 | 依据 |
|---|---|---|
| 过孔总数 | **76** | 完工快照 `VIA` 有效记录计数 = 76（与记录一致）|
| 过孔尺寸 | 35 只 ⌀12/24 mil（hole/via）· 18 只 ⌀12.01/24.02 mil · **23 只 ⌀20/40 mil**（GND 缝合与电源用）| 完工快照实测 |
| 铺铜 | **双面实心 GND 铺铜**：`GND_L1`（layer 1）+ `GND_L2`（layer 2），网络均为 `POWER_GNDREF`，`pourType = SOLID` | 完工快照 `POUR` 记录实测 |
| 铺铜边界 | 覆盖全板并外扩约 6 mm（多边形边界大于板框），`keepIsland = false` | 同上 |

> **★ 为什么必须"实心"**：`pourFillMethod` 传 `'90grid'`/`'45grid'` 会铺成**网格状**；
> 本项目在 `PCB2_1` 上出过 **246 处间距违规**，根因是**布线后没有 `rebuildCopperRegion()`**
> —— 铜皮不避让新走线会直接**短路**（`AGENTS.md` §3.2 铁律 14/15）。

### 10.4 DRC 结果

| 检查 | 结果 |
|---|---|
| **PCB DRC** | **零错误、零未连接**（间距违规 0 · 未连接 0） |
| 原理图 DRC | **致命错误 0**（仅剩 29 条警告：3 个"不用的空脚" + 单端网络一类，**不拦导入 PCB**）|
| 应空脚 | 仅 3 个，且都是**该空着的**：`J7.1`(STATE)、`J7.6`(PWRC)、`SW2.3`(不用的档位) |
| 全局防短路 | 42 个电源符号两两之间 **零串通** ✅ |
| 8 个模块座逐脚 | `J5`/`J7`/`J9`/`J10`/`J11`/`J13`/`J14`/`J18` **全部吻合** ✅ |

> **⚠️ 判读提醒**：不要相信 `pcb_Drc.check()` 的返回 —— 它读的是 **DRC 面板缓存**，常常是旧的。
> 连通性要用**几何算法**（焊盘/走线端点/过孔并查集）独立复核（`AGENTS.md` §3.2 铁律 5）。
> 本板的"零未连接"结论同时由 `tools/eda_pcb_overview.js`（几何连通性）与
> `tools/fw_prep/pin_check.py`（PCB `PAD_NET` 逐脚基线比对，0 不符）两条独立路径得出。

### 10.5 丝印要求（硬约束）

所有新增/改动的插座，**PCB 丝印必须印出每个脚的功能名**（如 `VCC`/`G`/`OUT`/`TRIG`/`ECHO`），
而不是只印一个 `J11`；建议在插座旁留 `▲` 或 `1` 标记标出模块丝印第 1 脚那一侧。
**原因**：1×N 排针**没有防呆**，"脚 1 在哪一端"完全取决于插座在板上的摆放方向（可转 180°）——
**方向由丝印决定，不靠记忆**（`原理图完善计划.md` §〇之二）。

---

## 11. 设计验证与已知偏差

### 11.1 完工验证数据（三方/多路径复核）

| 检查项 | 结果 | 方法 |
|---|---|---|
| 元件总数 | **104**（52 位号 + 电源符号 + A4 图框 + 无名项） | 原理图文件解析 |
| 位号数 | **52**（`C1–C19`/`CN1`/`CN2`/`D1–D4`/`J1`/`J2`/`J5`/`J7`/`J9`–`J11`/`J13`–`J15`/`J17`/`J18`/`L1`/`R1–R5`/`R10–R14`/`SW2`/`U1–U3`）| 完工快照 `Designator` 去重计数 |
| 封装 / 料号覆盖 | **52/52 有封装**、**52/52 有立创料号** | `原理图完善计划.md` §6.5；`BOM表.md` |
| 带网焊盘 | **221** 个（52 位号）| 完工快照 `PAD_NET` 计数 |
| 走线 / 过孔 | **523 / 76** | 完工快照 `LINE`/`VIA` 有效记录 |
| 网络名 | **62** 个（原理图 `NET` 属性去重）| 原理图文件解析（与 `原理图完善计划.md` §6.5.0 记的 62 一致）|
| 逐脚网络 | 14 个连接器 + `R10–R14` + `C14–C19` **全部吻合** | API 连通性解算 + 离线文件解析**双路径互证** |
| DRC | PCB 零错误零未连接；原理图致命 0 | `AGENTS.md` §8 提交前自检 |
| **Gerber / 制造数据（制造侧）** | 外形 **100.00 × 65.00 mm**、四角 **R5.0**、**3 个 ⌀3.2 安装孔**；元件孔 **110**、过孔 **76**（与设计口径一致） | 逐文件解析下单 Gerber：[`../../hardware/gerber/README.md`](../../hardware/gerber/README.md) §四/§五（`GKO` + 两个 `.DRL`）|
| **EDA 官方板信息报告** | **"板子尺寸: 100mm x 65mm"**；元件 **52**、焊盘 **221**（表贴 106 / 金属化孔 115）、网络 **65（未布线 0）**、过孔 **76**、铺铜 **2**、导线总长 **2035.9 mm** | [`../../hardware/eda_export_20261016/Info_PCB_PCB2_2026-10-16.txt`](../../hardware/eda_export_20261016/Info_PCB_PCB2_2026-10-16.txt)（2026-10-16 EDA 导出）—— 与 §11.1 的既有统计**逐项吻合**，且是**板框口径的第 5 路独立证据** |
| **制造 / 交付数据已导出留档** | PCB 出图（PDF+PNG，**丝印姓名已打码**）、Gerber（**已脱敏**）、飞针测试点、IPC-356A、网表、BOM、贴片坐标、测试点、**交互式 BOM**、**DXF（给 A2）**、**3D STEP（给 A2）**、工程导出包 `.epro2` | [`../../hardware/eda_export_20261016/`](../../hardware/eda_export_20261016/README.md)（入档时逐个核对哈希）；含组员姓名的件一律**双份**：仓库放脱敏版、未脱敏原件在仓库外（见 [`../../hardware/gerber/README.md`](../../hardware/gerber/README.md) §八 与决策 83）|
| **实际制造的板（实物）** | 2026-10-08 下单、10-10 交付（嘉立创 `8942344A_Y2`），**已焊好并装车** | [`上板测试记录.md`](上板测试记录.md) §1–§2（含 4 张实物照片索引）|

**其中 5 条无名网络已补名**（`决策记录.md` 决策 33）：`SW_NODE`（`D1.2`/`L1.1`/`U2.2`，开关节点）、
`VIN_SW`（`J17.1`/`SW2.1`）、`LED_3V3`（`D2.1`/`R1.1`）、`LED_5V`（`D4.1`/`R5.1`）、`LED_12V`（`D3.1`/`R4.1`）。

### 11.2 已知偏差 / 与早期文档不一致之处（本节比正文更重要）

| # | 偏差 | 处置 |
|---|---|---|
| 1 | **红外 `J11`/`J14` 为 DNP**（留焊盘、不装排针），但任务书明确写了"红外模块负责避障与循迹" | **保留焊盘与走线**，零成本可逆；报告中说明"焊盘已留、本批次未装"（决策 30）|
| 2 | **超声波 TRIG 由 `PC2` 改 `PC4`** —— 板上实际是 `PC4`（`J5.2` 直连 `J1.18`），源码/早期文档用 `PC2`（`J1.8`） | **不改板**，固件按 `PC4` 实现；改引脚时**发脉冲处（`PCout(4)`）也要一起改**，否则现象是"编译没问题、测距恒为 0"（`AGENTS.md` §3.4 铁律 26）|
| 3 | **`J17` 曾被写成"开关输出"** | **勘误：`J17` 是 12V 电源输入座**；`SW2` 的公共端才接板内 `+12V`（`模块功能与原理说明.md` §八）|
| 4 | **`J1`/`J2` 位号命名有历史歧义** | **各文档中哪张表叫 `J1` 不一致**：`改板规格书` §六、`../handoff/交接说明.md` §3.2 把 `+5V/PC13…PA0/PA1…` 那张表标为 **`J2`**；而**完工快照**里该组位号是 **`J1`**（另一组 `PB9/PB8/…/+5V` 是 `J2`）。**两张表的网络内容都正确，只是表头标签互换。核对接线时认网络名，不要认位号名**（`上板自检清单.md` §1.4 也提示了这条）。|
| 5 | **"原"板 `J9` 的丝印标注原本是"蜂鸣器"**，本项目把它改成 DHT11 | 已拍板：`J9` 维持 DHT11（只有 `+3.3V`，正合 DHT11）；蜂鸣器另用 `+5V` 的 `J18`（决策；`原理图完善计划.md` §6.3）|
| 6 | **`BZ1`/`Q1`/`R6`/`R7`/`R8` 在本板已删除**（蜂鸣器走 `PC5` 直连） | `模块功能与原理说明.md` §五 描述的是旧方案，**以 §8.2 为准** |
| 7 | **`C16`–`C19` 未按"每座一套"布置**，四只都挂在 5V 轨上 | 以实测为准（§6.2）|
| 8 | **`L1` 标称 "5 A" 是过设计** | 电机走 12V，5V 侧只需约 1.1 A 峰值；现有器件保留，仅作记录（决策 29）|
| 9 | **`D1` 原封装是错的**（写成钽电容焊盘 `CP_EIA-6032-15`，而 ES2D 是 SMB/DO-214AA）| 2026-10-05 已替换为 `ES2D_C212758`（SMB，`C212758`）；替换时**极性是"反"的**：`D1` 阴极 → 开关节点 `SW_NODE`，阳极 → `GNDREF`（实测已按此接线）|

### 11.3 尚未闭环的验证项（需实物/测点才能确认）

> **状态已按 2026-10-16 的事实更新**；逐项的操作、判据与"还剩什么"在
> [`上板测试记录.md`](上板测试记录.md) §3/§6 有更详细的版本（含"只有间接证据"的区分）。

| # | 项 | 谁来做 | 状态 |
|---|---|---|---|
| 1 | 上电前 `+12V`/`+5V`/`+3.3V` 对地短路检查、上电后三轨电压与指示灯 | A1（按 [`上板自检清单.md`](上板自检清单.md) §1–§2）| ✅ **三轨电压 2026-10-16 实测正常**（数值未留痕；`0x15` 机内实测电池 11.53 V）；⬜ 上电前对地短路检查仍无书面记录 |
| 2 | 电机/编码器插上后方向与计数是否正确（`CN1`/`CN2` 座序的实物最终确认）| A1 + B | ✅ **已闭环**：座序按实物丝印核实（§4.3），真机方向已定稿（决策 62/71）|
| 3 | MQ 模块 `RL` 实测值 | A1（量 `AOUT`↔`GND`）→ 填 `firmware/App/Sensor/gas.c` | ⬜ **仍未实测**（台架只有 MQ-135 在 `J13`，`J10` 空）|
| 4 | 蓝牙模块实际波特率能否改到 115200 | A1/B（可借 `J7.6`(PWRC) 接 IO 进 AT 模式）| ✅ **模块侧已确认**（JDY-33 配到 115200）；⚠ 但 Windows SPP 建不出 COM 口 ⇒ 端到端未验，联调主线走有线 |
| 5 | `J13.2`(DO)→`PB3` 是否与烧录方式冲突（`PB3` = JTDO，用 SWD 则空闲）| A1 确认烧录方式（SWD/串口 ISP）| ✅ **不冲突**：本板烧录只用**串口 ISP（板载 CH340G，FlyMcu）**或 **SWD（`make flash`）**，二者都不占用 JTAG 的 `JTDO` |
| 6 | 板厚 / 铜厚 / 表面处理 | A1（按下单记录）| ✅ **已闭环**：**1.6 mm / 1 oz / 有铅喷锡**（嘉立创工艺档，[`../../hardware/gerber/README.md`](../../hardware/gerber/README.md) §三）|
| 7 | 电机额定/堵转电流（电源支路裕量核算）| A1 | ✅ **已闭环（按铭牌型号规格，非本机实测）**：`MG513P3012V` ⇒ 额定 **1.44 A** / 堵转 **4 A**（每路）；两路同时堵转瞬时 ≈8 A 的核算提示见 [`上板测试记录.md`](上板测试记录.md) §6.2 |
| 8 | Gerber/制造数据的留档与可读导出 | A1 | ✅ **已闭环（2026-10-16）**：Gerber 两份原件入 [`../../hardware/gerber/`](../../hardware/gerber/README.md)；PCB 出图 PDF/PNG、STEP、DXF、iBOM、坐标、网表等入 [`../../hardware/eda_export_20261016/`](../../hardware/eda_export_20261016/README.md)；✅ **原理图出图（PDF/PNG/SVG）也已补入同目录**（2026-10-16 17:07，标题栏无个人信息）|

---

## 12. 变更记录

| 日期 | 内容 |
|---|---|
| 2026-10-09 | 初版（v1.0）：统稿形成《电路设计说明文档》—— 概述/框图/电源/电机/电压采样/传感器/通信/人机/接口表/PCB/验证与偏差/变更记录共 12 节；完工数据以 2026-10-08 快照逐项复核；新增"已知偏差"一节记录 9 项文档间不一致 |
| 2026-10-15 | **补"硬件层后续状态"**：板子已打样、已焊好并完成两轮真机联调；记明**台架只有 MQ-135（插在 `J13`）**、**OLED 正常显示**两项与"读本板信号"有关的判读提醒。板级设计内容不变（联调只改固件）|
| 2026-10-16 | **v1.1：★ 板框/圆角/安装孔口径更正 + 工艺参数回填 + Gerber 留档**。① §1 与 §10.1 把"100 × 60 mm / R2.5 / 4 个 ⌀1.6 mm 孔"更正为 **100.00 × 65.00 mm / R5.0 / 3 个 ⌀3.2 mm 孔（坐标 6.0,6.1 / 94.0,6.1 / 6.0,58.9，右上角无孔）**，证据为 Gerber 外形层 + EDA 快照 + 嘉立创生产档 + 渲染图逐孔核对（决策 81）；② §10.1 的 `[待补]`（**板厚 1.6 mm / 铜厚 1 oz / 有铅喷锡 / 绿油白字 / 过孔盖油**）由嘉立创订单 `8942344A_Y2` 工艺档闭合；③ §11.1 增 "Gerber/钻孔" 与 "实际制造实物" 两行核验；④ §11.3 六项状态更新（2/4/5/6 已闭环，1/3 仍待测，新增第 7 项电机电流）；⑤ 新增交付文档 [`上板测试记录.md`](上板测试记录.md)，Gerber 原件入 [`../../hardware/gerber/`](../../hardware/gerber/) |
| 2026-10-16（晚）| **v1.2：真机复核 + EDA 全套制造数据导出**。① §3.3 的**电机电流 `[待补]` 闭合**：铭牌 `MG513P3012V` ⇒ 额定 **1.44 A** / 堵转 **4 A**（同型号第三方规格，⚠ 非本机实测），并给出"两路同时堵转 ≈8 A"的核算提示；② §11.1 增 **EDA 官方板信息报告**行（**"板子尺寸 100mm x 65mm"** + 元件 52/焊盘 221/网络 65/过孔 76/铺铜 2/导线 2035.9 mm，与既有统计逐项吻合）与 **制造数据留档**行；③ §11.3 第 1 项改为"三轨电压实测正常（数值未留痕）"、第 7/8 项闭环（新增第 8 项"制造数据留档/原理图导出"）；④ 原件入库 [`../../hardware/eda_export_20261016/`](../../hardware/eda_export_20261016/README.md) 与 [`../../hardware/test_records/`](../../hardware/test_records/README.md) |

### 取材与溯源

| 内容 | 主要来源 |
|---|---|
| 接口总表、60 针映射、BOM 增量 | [`改板规格书_单底板方案.md`](改板规格书_单底板方案.md) |
| 各模块功能与原理 | [`模块功能与原理说明.md`](模块功能与原理说明.md) |
| 座序重排、5V 容忍校验、终态数据、踩坑 | [`原理图完善计划.md`](原理图完善计划.md) |
| 焊接、飞线预案、验证清单 | [`焊接调试手册.md`](焊接调试手册.md)、[`上板自检清单.md`](上板自检清单.md) |
| **焊接与上板测试记录（A1 交付物）** | [`上板测试记录.md`](上板测试记录.md) |
| **Gerber / 制造数据、板厚铜厚表面处理、板框与安装孔几何** | [`../../hardware/gerber/README.md`](../../hardware/gerber/README.md)（本目录原件 + 嘉立创工艺档 `4te.json`）|
| **实际元件采购（与 BOM 的差异判定）** | [`../../hardware/bom/采购记录_立创商城_SO26101014446.md`](../../hardware/bom/采购记录_立创商城_SO26101014446.md) |
| 实物照片（含打码说明） | [`../../hardware/photos/README.md`](../../hardware/photos/README.md) |
| 引脚分配（源码为准） | [`pin_assignment.md`](pin_assignment.md) |
| 传感器电气通用约束 | [`sensor_interface_notes.md`](sensor_interface_notes.md) |
| 整车三层结构、电机规格 | [`car_composition.md`](car_composition.md) |
| 人机界面（OLED/按键/蜂鸣器语义） | [`人机界面设计说明.md`](人机界面设计说明.md) |
| 已核实事实与现状 | [`../handoff/交接说明.md`](../handoff/交接说明.md) |
| 决策依据（逐条编号） | [`../决策记录.md`](../决策记录.md) |
| 位号/封装/料号 | [`BOM表.md`](BOM表.md) |
| EDA 原始记录（逐脚网络、走线/过孔/铺铜、板框） | `hardware/硬件工程_完工版_20261008_最终/`（`sch/Schematic2/P1.esch2`、`pcb/PCB2.epcb2`）|

---

> **项目归属**：中国石油大学（华东） 专业生产实习课程项目<br>
> **范围说明**：本项目不涉及 MiniBalance 控制板（STM32F405RGT6 版本）的硬件设计与改版；控制板直接沿用，A1 仅重做主底板。<br>
> **许可**：原创代码与文档采用 MIT License；第三方组件遵循各自原始许可证。
