pierrotto12138-code/balance-car-inspection-robot/docs/design_host/C部分方案与计划.md

# C 部分（Qt 上位机）方案调研与实施计划

> **角色 C 的交付物**（任务书）：完整源代码工程 · 可执行程序 · 软件设计说明文档 · 用户操作手册
> **本文档解决三件事**：① 摸清可借鉴的成熟方案（GitHub 调研）；② 定下技术选型与架构（含依据）；
> ③ 给出分阶段计划与验收判据。
> **上游输入（已冻结）**：[`../protocol/communication_protocol.md`](../protocol/communication_protocol.md) **v1.2**
> （v1.1 为冻结基线，`0x15` 诊断帧 / `0x16` 三环实况为向后兼容增量）
> + [`../protocol/test_vectors.json`](../protocol/test_vectors.json)（Python ↔ 上位机 ↔ 固件三方共用）。
> 版本：v1.1（2026-10-15，B 代拟，供 C 执行）

---

## 一、现状盘点（C 已经有什么）

| 已有 | 内容 | 状态 |
|---|---|---|
| [`host/src/protocol/`](../../host/src/protocol/) | CRC-16/MODBUS、组帧/解帧（流式状态机）、`frame.h` 字段定义 | ✅ 完成，**13 项单元测试通过** |
| [`host/src/ui/mainwindow.cpp`](../../host/src/ui/mainwindow.cpp) | 主窗口骨架（90 行） | 🔶 仅占位 |
| [`host/CMakeLists.txt`](../../host/CMakeLists.txt) | Qt 6.11.2 + MinGW + CMake + Ninja | ✅ 可构建 |
| `host/tests/test_codec.cpp` | 协议向量比对 | ✅ |

**结论**：C 的地基（协议层）已经打好且经过验证，**剩下的是"数据 → 领域 → 界面"这三层**。这很关键 —— 因为它决定了计划的重点不是"怎么解帧"，而是"怎么组织实时数据、怎么把状态讲清楚、怎么好看"。

---

## 二、调研：可借鉴的成熟方案（GitHub / 公开资料）

### 2.1 首要参考：[Serial Studio](https://github.com/Serial-Studio/Serial-Studio)（开源遥测仪表盘，Qt6）

**为什么它是本项目的头号参考**：目标和我们的几乎一样 —— "把串口/蓝牙来的数据变成实时仪表盘"，而且它的**分层方式已经被大规模使用验证过**（官方文档自述解析流水线可跑 256,000 帧/秒、渲染 60 FPS，且以 CI 基准门约束）。

| 借鉴点 | 它的做法 | 我们怎么用 |
|---|---|---|
| **数据流分层** | 驱动层（UART/BLE/TCP）→ 帧解析器 → 逐数据集变换（EMA/标定/单位换算）→ 部件（plots/gauges/maps）见 [Data Flow](https://serial-studio.com/help/data-flow) | 我们**照这个顺序分层**：`io/` → `protocol/`（已有）→ `domain/`（变换+告警判定）→ `ui/`。**变换绝不写在界面里** |
| **"描述一次，界面围绕它生成"** | Project 文件定义 groups/datasets/widgets，编辑器改表单即可 | 我们的协议是**固定**的，不需要项目编辑器；但把这套思想用在**图表通道配置**上：谁画哪条曲线由一份配置表决定，不散落在 UI 代码里 |
| **部件清单（可直接抄的"该有什么"）** | 折线图、仪表盘、条形、GPS 地图、FFT、加速度/陀螺/罗盘、数据表格、**LED 面板**、终端、多通道图 | 我们取：折线（气体/电压）、**仪表盘（速度/倾角）**、数据表格（当前值）、**LED 面板（状态位/故障位）**、**终端（原始帧日志/调试）** —— 正好覆盖任务书"实时监测 + 报警 + 状态" |
| **记录与回放** | CSV 导出；**Historian：把帧与原始字节记进 SQLite**，可浏览/标注/回放 | 我们做 **CSV（逐帧一行）+ SQLite（会话与事件）**；回放是演示与复盘的杀手锏 |
| **性能预算** | 解析 256k fps；渲染 60 FPS | 我们的实际负载：周期帧 ~60 帧/s（0x10+0x11 各 20 Hz、0x12 5 Hz、0x14 1–5 Hz、0x1F 5 Hz）。**留 100 倍余量**，所以 UI 卡顿一定是架构问题，不是性能不够 |
| **Qt 模块清单** | QtCore/Gui/Widgets/**QtGraphs**/Svg/Sql/**SerialPort**/Bluetooth | 我们的选型可直接对齐（见 §三）|

> ⚠️ **不要照搬的部分**：它的 Project 编辑器、JS/Lua 脚本解析、多协议驱动（Modbus/CAN/OPC UA）、TCP/gRPC API —— 与课程任务无关，**加上去只会增加风险**。我们只借"分层 + 部件分类 + 记录回放"这三样。

### 2.2 第二参考：中文工业上位机项目

- [gccnb/industrial-multiprotocol-debugger](https://github.com/gccnb/industrial-multiprotocol-debugger)（C++/Qt，RS485 ASCII / Modbus RTU / CRC / **报文日志** / **设备模板** / **SQLite 保存**）——
  它的"**报文日志 + 设备模板 + SQLite**"三件套正是调试型上位机的骨架：我们照此做**原始帧日志面板**与**参数表（模板）**，调参时能一眼看到"发了什么、回了什么"。
- 同一类项目反复出现的一个**打包坑**：[灯光控制上位机示例](https://blog.csdn.net/ik678901234/article/details/162777922) 明确记录"SQLite 文件路径必须用相对路径/标准路径，否则打包后不可用" → 我们用 `QStandardPaths::AppDataLocation`（见 §五）。

### 2.3 UI 与"美观"：用规范，而不是凭感觉

- **ISA-101（工业人机界面标准）**（[概要](https://www.htmlelements.com/industrial/docs/isa101/index.html)）给了可执行的审美判据，而不是"我觉得好看"：
  1. **背景低饱和中性灰**，正文用高对比中性色；**颜色只用于表达"异常"**（正常状态不要用彩色）；
  2. **不要渐变、阴影、3D、立体边框**（它们占用注意力却不携带信息）；
  3. **同一量始终保持同一位置与量程**（操作员靠"位置"读值，不靠"找"）；
  4. 层级用**灰阶 + 字重**表达，而不是用更多颜色。
  > 这条对课程评分其实很友好：**"好看"变成了"有依据"** —— 答辩时可以指着规范说明"为什么报警用琥珀色、正常用灰色"。
- **工作区布局**：用 `QDockWidget` 做可停靠/可重排的多面板（[进阶用法](https://awesome-embedded-learning-studio.github.io/Tutorial_AwesomeQt/advanced/03-qtwidgets/59-qdockwidget-advanced)），并保存/恢复布局（`saveState()`/`restoreState()`）—— 演示时能切换"监测视图 / 调参视图"。
- **主题**：QSS 变量化暗色主题（参考 [Qt Material](https://qt-material.readthedocs.io/) 的配色思路），**不引入重量级第三方皮肤库**（避免打包与许可问题）。

### 2.4 曲线控件选型（本项目最容易选错的一处）

| 方案 | 优 | 劣 | 结论 |
|---|---|---|---|
| **QCustomPlot**（三方，单文件 .h/.cpp，GPL） | 实时曲线性能好、API 直白、**无额外 Qt 模块依赖**、示例多 | 三方库需自带源码（约 1 万行）| ✅ **选它**（我们帧率低、但要求"曲线顺滑可缩放"，它最省事）|
| Qt Charts（官方，GPL/商业双授权） | 官方模块 | Qt6 中已被 **Qt Graphs** 取代，社区资料新旧混杂 | 🔶 备选 |
| **Qt Graphs**（Qt 6.6+ 官方新一代） | 官方、支持 2D/3D、性能好 | **依赖 QML/Quick 组件**，Widgets 集成与文档仍新，踩坑成本高 | 🔶 不选（交给"想用 QML 重写"的将来）|

> 参考：[Qt Graphs/Charts 数据添加的性能陷阱与 QCustomPlot 替代方案](https://runebook.dev/zh/docs/qt/qml-qtgraphs-pieseries/added)、[从 Qt Charts 到 Qt Graphs 的迁移与 QCustomPlot 实战](https://runebook.dev/zh/docs/qt/qtgraphs-index)。**结论：在 Widgets 体系里，QCustomPlot 是风险最低的选择。**

### 2.5 串口读取的正确姿势（避免 UI 卡顿）

Qt 官方给了两种范式（[阻塞接收器示例](https://doc.qt.io/qt-6.8/zh/qtserialport-blockingreceiver-example.html)）：事件驱动（`readyRead` 信号）与阻塞式（`waitForReadyRead`）。我们**用后者跑在独立线程里**：

- 串口读取线程：`waitForReadyRead(超时)` → 读字节 → 塞进**自有环形缓冲**；
- 解析也放在该线程（或在第二个工作线程）：`Proto_Feed` 解帧；
- 解出的**结构体**通过 `Qt::QueuedConnection` 信号发给 UI（**不跨线程共享缓冲**）。
- 理由：事件驱动 + 高频时容易"每几个字节触发一次信号"，反而更抖；阻塞式线程配合队列连接，UI 天然不被拖住。

---

## 三、技术选型（定案）

| 项 | 选型 | 理由（一句话） |
|---|---|---|
| 框架 | **Qt 6.11.2 Widgets（C++20）** | 与现有 `host/` 一致；Widgets 生态的曲线/表格/停靠面板最成熟；不引入 QML 学习成本与集成风险 |
| 构建 | **CMake + Ninja**（沿用 `host/CMakeLists.txt`） | 已可用 |
| 曲线 | **QCustomPlot**（源码内置 `third_party/qcustomplot/`） | §2.4 |
| 串口 | `QtSerialPort` + 专用线程阻塞读 | §2.5 |
| 蓝牙 | BLE 用 `QtBluetooth`；**本项目蓝牙模块是 SPP（串口透传）→ 直接以虚拟串口方式用 `QtSerialPort`** | 实测模块是串口透传，不必上 BLE 栈 |
| 存储 | **CSV（逐帧）+ SQLite（会话/事件/参数快照）** | 复盘与报告都需要；SQLite 走 `QtSql` |
| 样式 | QSS 暗色主题（变量化）+ ISA-101 配色原则 | §2.3 |
| 图标 | Qt 内置 + 自绘 SVG（**不引入 QtAwesome 等三方**） | 减少依赖与许可问题 |
| 测试 | Qt Test（`host/tests/`）+ **共用** `docs/protocol/test_vectors.json` | 与 B 的证据链一致（决策 36） |

---

## 四、模块规划（分层 + 目录）

> **铁律：依赖单向向下**（与固件侧同一条纪律，见 [`../design_firmware/编码规范.md`](../design_firmware/编码规范.md)）。
> 界面层**不许**直接碰串口；解析层**不许**知道界面的存在。

```
host/
├── src/
│   ├── protocol/        【已有】CRC、组帧/解帧、字段结构体          ← 无 Qt GUI 依赖（可单测）
│   ├── io/              ★新增：链路抽象
│   │   ├── link.h            抽象接口：open/close/write/signals(bytes, state)
│   │   ├── serial_link.*     QtSerialPort + 工作线程（阻塞读 → 环形缓冲）
│   │   └── link_manager.*    两条链路（有线/蓝牙）统一管理、自动重连、链路统计
│   ├── data/            ★新增：数据层
│   │   ├── session.*         一次连接会话：开始/结束、帧计数、时间轴
│   │   ├── recorder.*        CSV 逐帧落盘（含列定义与版本）
│   │   ├── event_log.*       事件流（0x13）落盘 + SQLite
│   │   └── param_store.*     参数快照（0x24）历史，便于对比"调参前后"
│   ├── domain/          ★新增：领域层（纯逻辑，可单测，不依赖 Qt Widgets）
│   │   ├── vehicle_state.*   姿态/运动/任务/环境的**当前状态聚合**
│   │   ├── alarm.*           告警判定与迟滞（气体阈值、低压、失联、锁存）
│   │   └── units.*           单位换算与显示格式（ppm×10 → ppm、0.01° → °、0.01V → V）
│   ├── ui/              ★扩充
│   │   ├── mainwindow.*      主窗：菜单/工具栏/状态条/停靠布局
│   │   ├── panels/           各面板（见 §六）
│   │   ├── widgets/          自绘小部件（LED 状态灯、仪表盘、数值牌）
│   │   └── theme/            QSS 主题与配色变量
│   └── app/             ★新增：装配层
│       ├── main.cpp          组装依赖（link → 解析 → domain → ui）
│       └── settings.*        端口/波特率/阈值/布局的持久化（QSettings）
└── tests/               ★扩充：协议（已有）+ domain + data + UI 冒烟
```

**每层职责一句话**：
- `io/`：**只搬字节**（含重连、统计），不理解语义；
- `protocol/`：**只认帧**（校验、字段解析），不碰硬件也不碰界面；
- `domain/`：**只算语义**（状态机镜像、告警、单位），纯函数优先 → 可单测；
- `ui/`：**只显示与下发**；
- `app/`：**只做装配**。

---

## 五、数据与线程模型（关键设计）

```
[串口线程 A: 有线]  waitForReadyRead ─┐
                                     ├─→ 环形缓冲 ─→ Proto_Feed(解帧) ─→ 结构体
[串口线程 B: 蓝牙]  waitForReadyRead ─┘                                     │
                                                                            ▼
                              Qt::QueuedConnection 信号（值语义，跨线程安全）
                                                                            │
                        ┌───────────────────────────────────────────────────┤
                        ▼                                                   ▼
                  domain::VehicleState（合并两路，按时间戳去重）         data::Recorder（CSV/SQLite）
                        │
                        ▼  （UI 定时器 20 Hz 拉取，**不是每帧重绘**）
                   UI 面板（曲线/仪表/表格/日志）
```

三条设计决策及其理由：
1. **UI 以 20 Hz 定时刷新**（而不是"每来一帧就重绘"）：人眼分辨不出 50 Hz 与 20 Hz 的刷新差别，但 CPU 差别很大；曲线用**环形数据缓冲（固定窗口，如 600 点）**避免无限增长。
2. **两路链路在 domain 层合并**：周期帧两路都发（协议 §七 约定 6），界面显示"最后一次有效值 + 该值来自哪条链路 + 两条链路各自的帧计数"，**避免"两条链路的数据互相打架"**。
3. **原始字节也要能看**：终端面板显示十六进制收发流水（可暂停/过滤），这与 §2.2 的"报文日志"一致 —— 调参和排障时它是第一现场。

**记录落盘**：
- CSV：`timestamp_ms, cmd, <字段...>`，列定义写进文件头（自描述，Excel 直接开）；
- SQLite：`sessions(id, start, end, note)`、`events(ts, code, text)`、`params(ts, id, value)`；
- 路径：`QStandardPaths::writableLocation(AppDataLocation)`（**不写死绝对路径**，见 §2.2 打包坑）。

---

## 六、UI 布局草案与美观设计

### 6.1 主窗布局（监测视图）

```
┌───────────────────────────────────────────────────────────────────────────────┐
│ 菜单：文件(会话/导出) 连接(有线/蓝牙) 视图(布局/主题) 工具(调参) 帮助(手册)      │
├───────────────────────────────────────────────────────────────────────────────┤
│ 工具栏： [●连接 有线▾] [●连接 蓝牙▾] [⏺开始记录] [⏹停止] [⚡急停] [⏱重下任务]  │
├──────────────┬──────────────────────────────────────────────┬─────────────────┤
│ 状态条(横跨)： ●有线 115200 1.0 kB/s 帧 1234 丢 0 │ ●蓝牙 断开 │ 🔋11.8V │ ⚠锁存 │
├──────────────┴──────────────────────────────────────────────┴─────────────────┤
│ 左侧导航        │  中央主区（卡片 + 曲线）                    │ 右侧诊断         │
│ ┌────────────┐  │ ┌────────────────┬───────────────────────┐  │ ┌─────────────┐ │
│ │ ① 总览      │  │ │ 姿态/运动 卡片 │ 气体浓度曲线(双通道)  │  │ │ 事件流       │ │
│ │ ② 气体      │  │ │ 倾角 1.2°      │  ┌─────────────────┐  │  │ │ 12:01:03     │ │
│ │ ③ 巡检      │  │ │ 速度 0.35 m/s  │  │ MQ-2  ────╱╲──  │  │  │ │  0x06 超阈值 │ │
│ │ ④ 曲线      │  │ │ 电压 11.8 V    │  │ MQ-135 ──╱──╲─  │  │  │ │ 12:01:05     │ │
│ │ ⑤ 日志      │  │ ├────────────────┤  └─────────────────┘  │  │ │  0x08 失联   │ │
│ │ ⑥ 调参      │  │ │ 任务状态 卡片  │  量程/时间窗可切换     │  │  │ │  0x09 解除   │ │
│ │ ⑦ 设置      │  │ │ 阶段:巡航 40%  │                       │  │ ├─────────────┤ │
│ └────────────┘  │ │ 巡检点 2/4     │ ┌───────────────────┐  │  │ │ 链路诊断     │ │
│                 │ └────────────────┴─┤ 原始帧日志(HEX)    │  │  │ │ 收/丢/解帧   │ │
│                 │                    └───────────────────┘  │  │ └─────────────┘ │
├─────────────────┴───────────────────────────────────────────────┴───────────────┤
│ 状态栏： 已连接 2 条链路 · 记录中 out/2026-10-13_1530.csv · 帧 12,345 · 丢帧 0    │
└───────────────────────────────────────────────────────────────────────────────┘
```

**调参视图**（用 `QDockWidget` 切换/浮动）：左"参数表（ID/名称/当前值/可编辑 + 单位 + 默认值 + 说明）"、中"实时曲线（调参前后对比：同一量两条曲线或一键记忆基准）"、右"下发日志（每个 0x24 的请求/回读值配对）"、底部 `[全量回读] [保存到 Flash] [从 Flash 载入] [观测模式 100 Hz]`。

### 6.2 美观设计（照 ISA-101，逐条可验收）

| 项 | 规定 | 验收方式 |
|---|---|---|
| 底色 | 中性深灰 `#1E2227`，面板 `#262B31`，分隔线 `#3A4048` | 截图取色 |
| 正文 | 主文字 `#E6E9ED`；次要 `#9AA3AD` | 对比度 ≥ 4.5:1 |
| **语义色（只用于异常）** | 正常=中性；**警示**琥珀 `#E0A800`；**报警/危险**红 `#D9534F`；**离线/未知**灰 `#6C757D`；**运行正常**绿 `#3FA45B`（仅状态灯） | 每个颜色在界面里有且只有一个含义 |
| 数字 | **等宽数字**（`Consolas`/`JetBrains Mono`），右对齐，固定小数位与单位 | 数值跳动时不"抖列" |
| 图表 | 网格 `#2E343B` 细线；曲线 2 px；**不用渐变填充**（最多 10% 透明面积色） | 截图 |
| 禁用 | 不出现 3D、阴影、圆角超过 6 px 的卡片 | 目视 |
| 密度 | 一屏内 80% 的信息是"当前状态"，细节按需展开 | 演示时一眼读出"车在哪、什么状态、有没有报警" |
| 布局 | 面板可拖动/浮动，`saveState()` 记住；提供"监测/调参/演示"三套预设 | 重开程序布局保持 |

> **为什么值得这么规定**：答辩/演示只有几分钟，**"一眼看出异常"比"多几个漂亮控件"重要得多**；而且一旦把颜色语义定死，"美观"就变成可检查的规则，不靠审美争论。

---

## 七、分阶段计划（里程碑 + 判据）

| 阶段 | 内容 | 完成判据（可验收） | 预估 |
|---|---|---|---|
| **P0 打通** ✅ **已完成**（2026-10-13）| `io/` 链路抽象 + 串口线程 + 环形缓冲 + 假源回放 + 通信诊断面板；接上已有 `protocol/`；播放帧计数与 HEX 日志 | ✅ 已达成：假源 ×1.0 = **51 帧/s**、×10 = **505 帧/s 且 0 丢帧**；坏帧比例 1.0 时丢帧计数确实增长；`ctest` **2/2**（协议 13 + 链路 8）；`host.exe --selftest 3 -platform offscreen` 退出码 **0**。真实串口路径已实现（含自动重连），待板子焊好后按 `host/README.md` §二之二 第 4 条验证 | 已完成 |
| **P1 状态可见** ✅ **已完成**（2026-10-15）| `domain/`（`units` + `frames` + `vehicle_state`）+ 总览视图（姿态/运动/电源环境/任务/诊断/状态位六组 + 安全横幅 + 人工地平仪）、状态条（两条链路/电压/安全/格式错帧）、ISA-101 主题、真机只读探测 `--probe`、自动截图 `--shot` | ✅ 已达成：`ctest` **4/4**（协议 13 + 链路 8 + **domain 14** + **UI 冒烟 6**）；`host.exe --selftest 3 -platform offscreen` 退出码 **0**（假源→解帧→domain：6 类必到帧全解析、格式错帧 0）；**真机 `--probe COM3`**：解帧 375 条、丢帧 0、格式错帧 0，姿态/运动/电压/任务/环境/三环全部有值（见 §十三）| 已完成 |
| **P2 曲线与告警** ✅ **已完成**（2026-10-15）| `domain/alarm`（连续确认 + 迟滞 + 状态跃变才报）、`data/event_log`（0x13 事件 + 本机告警同轴、安全事件成对给停车时长）、`ui/widgets/scope_plot`（QCustomPlot 唯一封装：通道/环形缓冲/阈值线/事件标记/十字定标/滚轮缩放/双击复位/末端读数）、`ui/panels/curve_panel`（四张通道独立曲线：MQ-2 / MQ-135 / 电压 / 温湿度）、`ui/panels/event_panel`（可过滤 + 底部量化统计）| ✅ 已达成：`ctest` **5/5**（协议 13 + 链路 8 + domain 15 + 界面 7 + **告警/事件流 13**）；`--selftest 12 --rate 5` 退出码 **0** 且打印出完整剧本（气体冲高→告警→解除、急停锁存→解除并给出**停车时长 1.6 s**、低压 10.91 V→解除 10.85 V）；曲线图上留痕、事件流条目与告警一一对应；另修掉一个**真实的数据正确性缺陷**：两条链路都发同样的帧 ⇒ 事件流重复 + "连续确认 3 帧"被 1.5 次真实采样满足（见 §十四）| 已完成 |
| **P3 巡检可视化** ✅ **已完成**（2026-10-15）| `domain/commands`（**下行数据段唯一出处**：0x20/0x21/0x22/0x23/0x24/0x2F/0x1F）、`domain/keepalive`（保活引擎，默认心跳 0x1F）、`ui/panels/patrol_panel`（阶段时间轴 + 任务下发/急停/**重下任务解除锁存** + 保活控制 + 遥控"按住走松手停"）；事件流增加**操作员动作留档** | ✅ 已达成：`ctest` **6/6**（新增命令/保活 13 项 + 界面 3 项）；`--selftest 12 --rate 5` 退出码 **0** 且打印保活统计（心跳 0x1F · 200 ms · 已发 60 条）；假源剧本下界面完整跑通"锁存 → 横幅红字 → 起点类按钮全部禁用 → 重下任务解除"；急停/任务下发**真的写出字节**（7 B / 9 B，见 §十五 测试）| 已完成 |
| **P4 调参与记录** ✅ **已完成**（2026-10-15）| `domain/commands` 的 `0x24`/`0x23` 编码 + `domain/frames` 的 `0x24` 回显解析、`data/param_store`（参数定义/前端校验/**下发↔回读配对**/巡检参数账本）、`data/recorder`（**CSV 逐帧 42 列 + 原始帧 HEX**、**SQLite 会话/事件/参数三表**）、`ui/panels/tune_panel`（参数表 + Flash 操作 + 观测模式 + 三环曲线 + 下发日志）、`--record/--play` 与文件菜单 | ✅ 已达成：`ctest` **7/7**（新增 **data 12 项**：CSV 列数与 BOM、事件同轴、**记录→回放逐字节一致**、参数范围/负值/配对、SQLite 三表与不可用降级；界面 +1 项：输入框按参数范围限制、回读刷新表格）；**真机 `--probe-readback`** 取回 7 个实际生效值并逐项对照（见 §十六）；`--record` 写出的 CSV 能被 Excel 直接打开（含中文表头）| 已完成 |
| **P5 交付** ✅ **已完成**（2026-10-15）| `package.ps1`（Release 树 → `windeployqt` → 瘦身 → **四项校验**）、[`软件设计说明.md`](软件设计说明.md)、[`用户操作手册.md`](用户操作手册.md)、[`演示脚本.md`](演示脚本.md) + 六张界面截图 | ✅ 已达成：便携目录 **12 个文件 / 37.4 MB**，在**干净 PATH（Qt/MinGW 全部移除）**下四项校验全过 —— ① 无头自检退出码 0、② 界面 4 s 不异常退出、③ 截图 119 KB 落盘、④ 录制 **CSV 1900 行 + SQLite 会话库 20 KB**；三份文档齐套且与实测数据一致（见 §十七）| 已完成 |

**总计约 12 个工作日**（可与 A1 焊接/上板联调并行；P0 之后每阶段都能独立演示，避免"最后一次性验收"的风险）。

---

## 八、风险与对策

| 风险 | 影响 | 对策 |
|---|---|---|
| **串口被占用**（烧录工具 vs 上位机） | 连不上，误判为程序 bug | 界面明确提示"串口被占用/请关闭 FlyMcu"；`P0` 加端口占用检测 |
| 蓝牙模块特性（延迟/断连） | 演示时数据抖 | 主链路用**有线**，蓝牙作辅助展示；断开自动重连 + 状态条显示链路质量 |
| UI 卡顿 | 演示差评 | §五 的三条（解析在工作线程、20 Hz 定时刷新、环形缓冲）；用假源做压力测试（10× 速率） |
| 打包缺 DLL | 换机跑不起来 | P5 用 `windeployqt` 并**在干净机器验证**；SQLite 路径用标准路径 |
| 与固件数值口径不一致 | 显示错值（最危险） | 全部换算集中在 `domain/units.*` **一处**；用同一份 `test_vectors.json` 做交叉测试；协议 §七 的 10 条约定逐条实现 |
| 演示现场依赖硬件 | 硬件坏了就演示不了 | **回放功能**（P4）就是应急预案：用 `tune.py --observe --csv` 先录一段真实数据 |

---

## 九、验收对照（任务书 → 本计划）

| 任务书要求 | 落在哪 | 判据 |
|---|---|---|
| 完整源代码工程 | `host/` 全部 | CMake 一键构建；`host/tests/` 全绿 |
| 可执行程序 | P5 打包产物 | 干净机器可运行 |
| 实时监测（姿态/环境/气体） | P1/P2 | 曲线与数值实时更新，单位正确 |
| 报警与安全 | P2/P3 | 超阈值报警、失联/急停/锁存显式提示、事件流留档 |
| 远程控制/调参 | P3/P4 | 启停、巡检任务、在线 PID 调参与持久化 |
| 软件设计说明文档 | P5 | 含分层图、数据流、接口表、线程模型 |
| 用户操作手册 | P5 | 含安装、连接、各面板说明、常见问题 |

---

## 十、需要 C 决定/确认的（不阻塞开工）

1. 是否采用 **QCustomPlot**（§2.4 结论）——若团队更希望只用官方模块，则改为 Qt Graphs + QML，**但工期要加 2~3 天**。
2. 打包方式：`windeployqt` 便携目录（推荐）还是安装器（Inno Setup）。
3. `host/` 是否改为与固件一致的"严格告警 + 零告警"纪律（建议：是，复用 `firmware/Makefile` 里的 `make strict` 思路）。

> 以上三条都不影响 P0 开工；按推荐方案执行即可，**有异议随时改**（改动成本在 P0 阶段最低）。

---

## 十一、参考吸收清单（对照厂商 PC 工具与手机 App，2026-10-13）

> **来源**：① 厂商 PC 波形上位机（`Base/…/软件与驱动/MiniBalance波形显示上位机.exe`）截图；
> ② 厂商手机 App（v5.0，截图）；③ **v1.0 App 源码**（用户提供，已解到**仓库外**
> `..\260921Task_私有资料\vendor_ref\MiniBalanceV1_app\`，**第三方源码不入公开仓库**）。
> 原则：**学交互与功能，不搬代码、不抄观感**。

### 11.1 从源码确认的事实（可直接依赖）

| 事实 | 依据 | 对我们的意义 |
|---|---|---|
| 手机 App 用**经典蓝牙 SPP**（UUID `00001101-0000-1000-8000-00805F9B34FB`） | `BluetoothChatService.java` | 与 `J7` 上的透传模块**天然匹配**，不需要 BLE 栈 |
| 摇杆 8 方向 = 单字节 `'A'`~`'H'`（0x41~0x48） | `BluetoothChat.java` | 厂商 App 兼容层的映射表**已确定** |
| **松手/回中 = `'Z'`(0x5A)** | 同上 | 与我们"松手即停"的设计一致，可作为验收对照 |
| 自定义功能键 = `'J'`(0x4A) / `'K'`(0x4B) | 同上 | 可映射成"开始巡检 / 急停"等 |
| 另有**文本透传**（"聊天"框按字符串发） | `sendMessage(String)` | 提示我们：**文本调试通道**很实用 |
| 1.0 **没有**重力遥控（无 `SensorManager`） | 全仓搜索 | "重力遥控"是 v5.0 新增 → 我们**不必**跟 |
| 厂商 PC 工具默认波特率 **128000** | 截图状态栏 | 我们固件是 **115200** → 若用它交叉验证，波特率**必须改选 115200** |

### 11.2 值得吸收的功能（★ = 本轮才想到）

| # | 功能 | 来源 | 落到哪个阶段 |
|---|---|---|---|
| 1 | ★ **人工地平仪（姿态球）** —— 横滚/俯仰/航向一眼可读，比三个数字直观得多 | PC 工具"扩展功能→地平仪" | **P1** 先做小型姿态指示，**P2** 做完整地平仪 |
| 2 | ★ **曲线上直接标数值**（每个采样点旁标读数） | PC 工具截图 | P2（截图/答辩极有用） |
| 3 | ★ **快速截图 / 快速保存数据**（快捷键一键完成） | PC 工具 F11/F12 | P2/P4 —— **直接服务"实验记录与验收材料"** |
| 4 | ★ **暂停更新 + 窗口置顶** | PC 工具状态栏 | P2（边操控边看数据；冻结画面读波形） |
| 5 | ★ **通道独立显示**（每通道一张小图）+ 顶部**彩色当前值数码管** | PC 工具"通道独立" | P2（通道变多时比叠在一起清楚） |
| 6 | ★ **横/纵坐标测量 + 十字定标 + 撤销缩放** | PC 工具快捷键表 | P2 —— **PID 整定时读超调量与振荡周期** |
| 7 | ★ **遥控页必须带状态回显**（双轮转速 + 电量 + 角度 + Debug 文本同屏） | 手机 App 首页 | P3 —— 遥控时也要看得见"车在干什么" |
| 8 | ★ **可编程自定义键**（M0 + 自定义键 1~8） | 手机 App 调试页 | P3 —— 把"开始巡检/返航/保存参数/急停"绑成按钮 |
| 9 | ★ **多种遥控输入**（PC 上：`WASD` / 虚拟摇杆 / 方向键三选一） | 手机 App（重力/摇杆/按键） | P3 —— **松手即停**是手感关键 |
| 10 | ★ **"模拟数据"显式开关 + 水印** | 手机 App 波形页 | P0/P1 —— 我们已有假源，但要**明确标示"非真实数据"**，避免演示误读 |
| 11 | ★ **文本调试通道**（界面里发命令看回复） | 手机 App"聊天(Debug)" | P4 —— 需 B 侧加一个小下行命令 + 上行回显，是**上板联调阶段最省时间的工具** |
| 12 | **保存 / 载入数据（回放）** | PC 工具菜单 | P4（已在原计划里） |

### 11.3 明确**不学**的

| 不学 | 原因 |
|---|---|
| 商城 / 论坛 / 检查更新 / 建议反馈 | 与课程无关，纯商业入口 |
| 3D 立方体、3D 图表 | 花哨、信息密度低，答辩时反而分散注意力 |
| 黑底 + 霓虹数码管的配色 | 违反 ISA-101：**颜色只用于表达异常**，不做装饰 |
| 全屏遥控器式布局 | 它是"遥控器"，我们是"监控台"：信息密度与层级要求不同 |

### 11.4 顺带确认：厂商手机 App 兼容层可行且已定案

协议已 100% 明确（11.1 表），实现方式是把厂商单字节命令**翻译成我们的 `0x20` 运动命令**，
并**必须走与上位机相同的安全路径**（这样失联停车、急停锁存、锁存期间禁止起步、电机使能全部自动生效）。
优先级**低**（我们自己的遥控面板已经覆盖同样功能），作为"演示彩蛋/应急预案"保留。

---

## 十二、变更记录

| 日期 | 内容 |
|---|---|
| 2026-10-13 | 初版：GitHub/公开资料调研（Serial Studio、工业调试上位机、ISA-101、QCustomPlot vs Qt Graphs、Qt 官方串口范式）+ 技术选型定案 + 五层模块规划 + 线程/数据模型 + UI 布局与配色规范 + P0~P5 计划与判据 |
| 2026-10-15 | **v1.1**：上游协议升为 **v1.2**（`0x15` 诊断 / `0x16` 三环实况 + 固件版本字节）；§11.5 补 5~7 条（版本字节先行、**失联锁存的保活要求**、两个新帧 P1 就接）并写明**蓝牙在 Windows 上不可用 ⇒ 联调主线走有线**；新增 §11.6 两个新上行帧的 C 侧实现要点 |
| 2026-10-15 | **v1.2：P1 完成**（`ctest` 4/4 + 假源自检退出码 0 + 真机 `--probe` 通过）；新增 §十三「P1 完成记录与真机实测发现」（含两条**交 B 确认**的实测现象：上行速率 ≈15.3 Hz 与 `0x15` 电压 4.16 V）；新增决策 65/66（domain 唯一口径、假源必须覆盖全部帧与安全剧本）|
| 2026-10-15 | **v1.3：P2 完成**（曲线与告警）：QCustomPlot 2.1.1 内置为 `third_party/qcustomplot`（未改动、只对本目标关告警）+ `domain/alarm` + `data/event_log` + 四张通道独立曲线 + 事件流面板；新增 §十四「P2 完成记录」；新增决策 67/68（**跨链路去重必须在聚合层做一次**、告警判定的三条纪律与"低压是低了才坏"的方向问题）；`--rate` 开关让安全剧本 12 s 内可演完 |
| 2026-10-15 | **v1.4：P3 完成**（巡检可视化与任务控制）：`domain/commands`（下行数据段唯一出处）+ `domain/keepalive`（**默认心跳 0x1F** 保活）+ `ui/panels/patrol_panel`（阶段时间轴 / 任务下发 / 急停 / 重下任务解除锁存 / 保活控制 / 按住走松手停的遥控）；事件流增加**操作员动作留档**；新增 §十五「P3 完成记录」与决策 69/70（**保活绝不能用使能类命令**、锁存期间用"禁用按钮"而不是"提示语"来兜底）|
| 2026-10-15 | **v1.5：P4 完成 + 按 B 侧《给 C 侧：固件接口与判读口径》对齐真机**：`data/param_store`（参数定义与**前端校验**、下发↔回读配对、巡检参数账本）+ `data/recorder`（CSV 逐帧含 HEX 列 + SQLite 三表）+ `ui/panels/tune_panel`（参数表 / Flash / 观测模式 / 三环曲线 / 下发日志）+ `--record`/`--play` 与文件菜单；新增 §十六「P4 完成记录与真机接口对齐」与决策 73/74（**前端校验必须允许负值**、**"算了没执行"必须与"保护生效"分级**）；同时修掉文档整合后失效的图片链接 |
| 2026-10-15 | **v1.6：P5 完成（C 部分收工）**：`host/package.ps1` 一键打包（Release 树 → windeployqt → 瘦身 **109→37.4 MB** → **干净 PATH 下四项校验**）+ 三份交付文档（[`软件设计说明`](软件设计说明.md) / [`用户操作手册`](用户操作手册.md) / [`演示脚本`](演示脚本.md)）；新增 §十七「P5 完成记录」、决策 75/76 与铁律 43（打包四坑：windeployqt 参数错→**空部署**、offscreen 插件未部署⇒**验证方式要改**、Debug 41.5 MB vs Release 3.2 MB、漏 qsqlite ⇒ **静默降级**）|

### 11.5 待集成：串口/蓝牙端口自动识别（2026-10-13 真机联调提出）

现状：`tools/fw_prep/bt_scan.py` 已在 PC 侧实现"**按合法帧判定哪个口是我们的设备**"（Windows 蓝牙 SPP 口号随机、名字不可信，靠名字猜很容易发错口）。
上位机侧要做的等价能力（写进 P1 的通信链路面板）：
1. 端口列表标注类型（蓝牙 / USB 串口）与 VID:PID；
2. 一键"自动识别"：逐个口按当前波特率试读，按 **CRC 通过的整帧数**排序并推荐；
3. 识别时必须显式驱动 **DTR=高 / RTS=低**（AGENTS 陷阱 33：否则 MCU 停在 BootLoader，
   一个字节都收不到，会被误判成"没烧进去"）；
4. 识别结果可一键填入两条链路（有线 / 蓝牙），并记住上次选择；
5. **第一件事是读固件版本字节**：`0x16` 偏移 19 = `(月<<4)|日`（当前 `0xAF` = 10 月 15 日）。
   联调时"到底烧没烧上"曾扯皮一整轮，这一字节是**可验证性的基础设施**（决策 64）；
6. **必须处理"失联锁存"**：静默 >500 ms ⇒ 板子锁存安全停车、**硬件按键也解不开** ⇒
   上位机要**持续使能/保活**（≤200 ms 一次 `0x20 enable=1` 或心跳），并在界面显式提示"已锁存、需重下任务"；
7. **`0x15` / `0x16` 两个新上行帧建议在 P1 就接上**：`0x15` 的 **OLED 写计数**（不涨=屏幕没在刷）
   与四任务 tick（在涨=任务存活）、`0x16` 的 `Moto` vs **真实 CCR**（"算了没执行"）与**编码器原始计数**，
   是把"只有人眼可见"的故障转成可远程测量的关键（协议 §3.4/§3.5、§七 约定 12/13）。

> ⚠️ **蓝牙现状（2026-10-15 实测）**：Windows 蓝牙 SPP **能配对但建不出 COM 口**；
> Python 的 `AF_BLUETOOTH` **在 Windows 上不可用**、`pybluez2` 在 Python 3.13 上编译不过；
> 本 Qt 套件**未安装 Qt Bluetooth 模块** ⇒ **P1~P5 的联调主线一律走有线（USART1）**，
> 蓝牙只作为"另一条同协议链路"保留接口（决策 45）。

### 11.6 协议 v1.2 增补的两个上行帧（C 侧实现要点，2026-10-15）

| 帧 | N | 周期 | C 侧要点 |
|---|---|---|---|
| **`0x15` 诊断** | 16 | 1 Hz（联调专用） | 偏移 0 电池电压（0.01 V，**这是全协议唯一给出电压的帧**）、2 当前显示页、3 `Flag_Show`、4 姿态算法、5 状态位（bit1=已安全锁存）、6 剩余堆 KB、**8 累计 OLED 写入字节数（按秒差分=写入速率）**、12 四个任务 tick 低 8 位（**在涨=该任务存活**）|
| **`0x16` 三环实况** | 20 | 1 Hz（调参专用） | `Bal`/`Vel`/`Turn` 三分量、`Moto1/Moto2` 与 **`CCR_A/CCR_B`（真实写进 TIM1 的占空）**、`EncLeft/EncRight` **原始计数**、状态位 bit2=**本拍真的调用了 `Set_Pwm`**、**偏移 19 = 固件版本字节** |

---

## 十三、P1 完成记录与真机实测发现（2026-10-15）

### 13.1 交付与证据（都可复现）

| 项 | 命令 | 结果 |
|---|---|---|
| domain 层单测 | `ctest -R domain` | **14 项全过**：单位口径、**冻结向量逐字段比对**（`0x10/0x11/0x12/0x13/0x14`）、长度防御、双链路合并与来源、锁存生命周期、假源→解帧→domain **0 格式错帧**、假源安全剧本（锁存→解除、低压、气体冲高） |
| 界面冒烟单测 | `ctest -R ui`（offscreen） | **6 项全过**：空数据不崩且明说"等待数据"、正常/低压/锁存三种横幅、"坏帧+协议外命令"不崩、主窗三页可切 |
| 全量回归 | `ctest` | **4/4 通过**（协议 13 + 链路 8 + domain 14 + UI 6），全量构建**零告警** |
| 端到端（无硬件） | `host.exe --selftest 3 -platform offscreen` | 退出码 **0**，并打印假源→解帧→domain 的**状态聚合**（姿态/运动/电源/任务/环境/诊断/三环/链路/质量） |
| 真机（只读） | `host.exe --probe COM3 --probe-seconds 10 --probe-heartbeat` | 解帧 **375** 条、丢帧 **0**、格式错帧 **0**；`0x10/0x11/0x12/0x14/0x15/0x16/0x1F` **全部有值**，无未知命令 |
| 文档截图 | `host.exe --demo --shot 图.png --shot-delay 2500 --shot-tab 0` | 自动出图（见 [`P1_总览面板.png`](图/P1_总览面板.png)），界面改一点就能重出一套，避免"图过期" |

> ⚠️ **截图注意**：`--shot` 若在 `-platform offscreen` 下跑，需要设 `QT_QPA_FONTDIR=C:\Windows\Fonts`
> 才能出字（否则 Qt 找不到字体，整屏是方框 —— 这是 offscreen 插件没有系统字体库导致的，与界面代码无关）。

### 13.2 真机实测发现（**待 B 确认**，均来自 `--probe` 只读探测）

| # | 现象 | 数据 | 待确认的点 |
|---|---|---|---|
| 1 | **上行速率约 15.3 Hz**（协议标称 `0x10/0x11` 20 Hz） | 10 s 收到 `0x10` **109** 条（≈10.9 Hz）、`0x1F` 30 条（≈3 Hz）、`0x14/0x15/0x16` 各 6 条（≈0.6 Hz）；换 6 s/8 s/12 s 多次探测，**比例一致**（≈标称的 0.55~0.76 倍），且**丢帧 0、字节数与帧数完全对得上**（9808 B = 184×47 + 51×7 + 11×73），所以不是上位机漏读 | 是否是通信任务的节拍被控制周期拖慢（或 `HAL_Delay`/`vTaskDelay` 的 tick 口径），需 B 侧量一下实际发送周期 |
| 2 | **`0x12` 与 `0x10` 同频**（协议标称 5 Hz） | 每一次探测里 `0x12` 条数**恒等于** `0x10` 条数（109/109、184/184、375 中 109 条） | 是否有意改成"每拍都发"？若是有意，建议同步进协议（带宽仍够，但 §三 的周期表要改） |
| 3 | **`0x15` 电压读到 4.16~4.20 V** | 多次探测稳定在 4.1~4.2 V；同一时刻台架由 USB 供电 | 若台架没接 12 V 电池，这是预期的（分压后≈4 V 档）；若接了电池（真机记录写 11.8 V），则 `0x15` 偏移 0 的填充值可疑（是否取错通道/少乘分压系数） |
| 4 | 台架状态：`阶段 故障/安全停车`、`异常 失联`、`已安全锁存` | 上位机横幅显示"⛔ 已安全锁存 —— 车不会动，需重下任务解除" | 与 §11.5 第 6 条一致（静默 >500 ms 即锁存）。因此 **`--probe` 默认只监听会让车保持锁存**，要"边跑边看"用 `--probe-heartbeat`（200 ms 一次 `0x1F`，不解除锁存、不产生运动） |
| 5 | `0x16`：`Bal -894` 而 `CCR_A/B = 1045`（两侧 `Moto` 符号相反、`CCR` 相同） | 说明 `Set_Pwm` 里含死区补偿（`CCR = abs(Moto) + 偏差`），两侧方向由别的位/符号决定 | 上位机目前**只如实显示**（不判"算了没执行"就报警）：`computedButNotExecuted()` = `Moto≠0 且 CCR=0`，本例不触发。若 B 侧认为该判据还要加"偏差超出合理范围"的告警，请给出判据 |

### 13.3 本轮踩到并修掉的坑（已写进代码注释与 AGENTS §3.5）

| 坑 | 现象 | 根因与修法 |
|---|---|---|
| **"数据停了"被误判成"收尾慢"** | `--probe` 每次结束都显示"最近帧年龄 ≈3000 ms"，一度以为是关闭串口阻塞 3 秒 | 加了两个数（**实测时长** / **关闭耗时**）后才看清：关闭只用 **0~9 ms**，真正原因是**串口在运行中消失**（台架被拔/重枚举 → 读取错误 → 读循环退出）。顺手把 `ResourceError` 单独报成"串口在运行中断开（设备被拔掉或复位重枚举）" |
| 退出路径依赖**排队信号** | `Reader::finished → QThread::quit` 是 AutoConnection（Reader 在工作线程、QThread 归主线程）⇒ `quit` 排队投递；命令行/退出路径下主线程不跑事件循环时永远收不到 | 改为**直接** `quit()`（线程安全）+ 有界等待（2 s）+ 超时 `qWarning`（不再静默泄漏线程/句柄） |
| **数值牌把枚举文字裁掉** | 截图里"自主巡航"显示成"自主巡"、"巡检通信页"显示成"通信页" | 数值牌按"最坏数字位数"预留宽度，对文本类取值（任务/阶段/页号）必须**解锁宽度**；数字与文本两种模式分开处理（靠截图才发现） |
| `QStringLiteral` 放进花括号初始化列表 | `QStringList{...}` 报 "too many initializers"（真因是缺 `<QStringList>` 头，症状误导） | 改为 `<<` 逐个追加 + 补头文件；同类"宏展开含顶层逗号"的写法一律避开 |

### 13.4 P1 明确的已知边界（不藏）

1. **UI 尚未做的**：曲线/告警（P2）、巡检可视化与任务控制（P3）、调参与记录（P4）、打包与文档（P5）；
2. **`0x14` 的报警阈值**在 P1 里只按固件给的**异常标志/报警位**染色，**阈值判定与迟滞留在 P2**（阈值来自 `0x23`/参数快照）；
3. **蓝牙链路**在 Windows 上建不出 COM 口（§11.5），P1 的联调主线是**有线**；假源仍模拟两条链路，用来验证"双链路来源标注"；
4. **`--probe` 是只读工具**：默认不发下行帧（会保持/触发固件的失联锁存），要保活加 `--probe-heartbeat`。

---

## 十四、P2 完成记录（曲线与告警，2026-10-15）

### 14.1 交付与证据

| 项 | 命令 | 结果 |
|---|---|---|
| 全量回归 | `ctest --test-dir build` | **5/5 通过**（协议 13 + 链路 8 + domain 15 + 界面 7 + 告警/事件流 13），全量构建**零告警** |
| 告警判定与事件流 | `ctest -R alarm` | 13 项：连续确认、单帧毛刺不报、迟滞与**解除后再超限必须重报**、传感器未就绪不判气体、低压方向（低了才坏）、失联需"先有过数据"、锁存置位/解除、事件流安全事件配对（停车时长）、跨链路事件去重、低压措辞"最低"、假源端到端剧本 |
| 界面冒烟 | `ctest -R ui` | 7 项：新增"每帧采一个样（不是按定时器重复采）""告警在曲线上留标记""暂停时不再采样""事件流表格与停车时长""五页导航可切" |
| 端到端剧本 | `host.exe --selftest 12 --rate 5 -platform offscreen` | 退出码 **0**；打印出：气体 420/610 ppm → 告警 →（冲高结束+3 帧）解除；急停 `0x0A` → 锁存告警 → `0x09` 解除（**停车时长 1.6 s**）；低压 10.91 V → 告警 → 解除（最低 10.85 V，持续 1.2 s）；事件流 15 条且**不再重复** |
| 文档截图 | `--demo --rate 5 --shot ... --shot-tab 1/2` | [`P2_曲线与告警.png`](图/P2_曲线与告警.png)、[`P2_事件流.png`](图/P2_事件流.png)（曲线上有告警/解除标记，事件流有成对的停车时长） |

### 14.2 本轮修掉的一个**数据正确性缺陷**（比界面 bug 严重）

**现象**：`--selftest` 的事件流里每条机器人事件都出现**两遍**；进一步检查发现告警的"连续确认 3 帧"其实被 **1.5 次真实采样**就满足了。

**根因**：协议 §七 约定 6 规定"**周期帧两路都发**"—— 同一次物理测量会在两条链路上各来一帧。原先 `VehicleState` 只是"谁后到就用谁的值"，而下游（曲线采样、告警连续确认、事件流）都是**按帧计数**的，于是同一次测量被算了两次。

**修法（决策 67）**：去重放在**聚合层一次做完** —— `VehicleState` 为每个命令字记住"最近一帧的原始数据 + 来源 + 时刻"，判据是
**同命令字 + 内容逐字节相同 + 来自不同链路 + 间隔 ≤150 ms**（同一条链路连发两帧相同内容在 20 Hz 下很常见，**不算**重复）。
`dataUpdated`（"这是一次新测量"）与 `eventReceived` 只在非重复时发出，曲线/告警/事件流因此自动各得一次。
同时加了一个可观测的计数 `duplicateFrames`（总览页与自检输出都会显示），去重了多少条一眼可见。

**连带修掉的坑**：假源两条链路各自生成事件帧时用了各自的 tick 时刻 ⇒ 同一次冲高造出两帧**内容不同**的 `0x13`，去重认不出来。现在冲高事件的时间戳取**窗口起点**，两条链路造出的是**逐字节相同**的帧（真实固件本来就是同一帧发两路）。

### 14.3 设计取舍（写清楚，免得后来人改错）

| 取舍 | 选择 | 理由 |
|---|---|---|
| 阈值线画在哪 | **界面画线，判定在 domain** | 两套判据一定会打架；界面只负责把"阈值"和"当前值"画在一起 |
| "同一段异常只提示一次" | **状态跃变才报**；回到正常（连续确认）后**再次超限会重新报** | 计划原文"再次进入异常不再重复提示"按"重复帧不重复提示"实现 —— 若真的"再也不报"，安全功能就是装饰（AGENTS 铁律 29 的同一类错误） |
| 曲线通道排布 | **通道独立**（每通道一张图），不是全叠一张 | 厂商 PC 工具的做法；气体两个量量程不同，叠在一起读不出小变化 |
| 采样与重绘 | 采样**每帧一次**（`dataUpdated`），重绘 **10 Hz** 定时器 | 按定时器采样会**重复采样**（同一帧被记两次），按帧重绘又会卡（计划 §五） |
| 暂停更新 | 暂停期间**不采样**，恢复时在图上留一条"暂停结束"标记 | 不采样会形成一段"没测"的空白，直连线会被误读成"中间一直在测" |
| 事件流吃原始帧还是吃事件 | 吃 `VehicleState::eventReceived`（**已去重**） | 直接吃原始帧就会出现"每件事两遍"（本轮实际发生） |
| QCustomPlot | 内置源码（GPLv3，未改动）+ 只对该目标关告警 | 决策 58 的选型；第三方告警不该混进"自研代码零告警"的自检里 |

### 14.4 P2 已知边界

1. **阈值只在上位机生效**：曲线页的两个阈值输入框改的是**本机判定**；要同时改板子上的判定，需要 P4 的 `0x23` 巡检参数下发（协议 §4.1）；
2. **CSV/回放仍空**：曲线数据只在内存（环形，窗口的 2 倍），落盘与回放在 P4；
3. **`0x16` 三环曲线还没画**：P2 画的是气体/电压/温湿度四张；`Bal/Vel/Turn` 与 `Moto→CCR` 的曲线留给 P4（调参视图要的就是它们）；
4. **事件流暂不能导出**：过滤与统计已有，CSV 导出随 P4 的记录功能一起做。

---

## 十五、P3 完成记录（巡检可视化与任务控制，2026-10-15）

### 15.1 交付与证据

| 项 | 命令 | 结果 |
|---|---|---|
| 全量回归 | `ctest --test-dir build` | **6/6 通过**（协议 13 + 链路 8 + domain 15 + 界面 10 + 告警 13 + **命令/保活 13**），全量构建**零告警** |
| 下行命令与保活 | `ctest -R command` | 13 项：`0x20` 布局与**超范围钳位**（不许回绕成反向指令）、`0x21` 参数布局、`0x23` ppm×10 与钳位、`0x24` **float32 小端**与拒绝 NaN/Inf、**造→组帧→解帧→比对**全覆盖、保活"链路不通不发/就绪立刻发/断了就停/失败计入/周期钳位/使能模式行为"、操作员动作留档 |
| 界面冒烟 | `ctest -R ui` | 10 项：新增"**锁存期间 6 个起点类按钮被禁用**""急停与任务下发**真的写出字节**（7 B / 9 B）并留档""值更新后副标题同步（不许留着『无数据』）" |
| 端到端剧本 | `host.exe --selftest 12 --rate 5 -platform offscreen` | 退出码 **0**；新增保活统计输出：`心跳 0x1F（不解除锁存）· 周期 200 ms · 已发 60 条 · 最近一条 186 ms 前` |
| 文档截图 | `--demo --rate 5 --shot ... --shot-tab 1 --shot-delay 8800` | [`P3_巡检与控制.png`](图/P3_巡检与控制.png)：锁存横幅红字、阶段红牌、起点按钮全灰、**"重下任务解除锁存"高亮**、保活状态与遥控禁用 |

### 15.2 三条安全设计（都有依据，也都在界面上写明白）

| # | 设计 | 依据 / 为什么必须这样 |
|---|---|---|
| 1 | **保活默认且自动只用 `0x1F` 心跳**；`0x20 enable=1` 只能由人显式选择，且旁边写明"会解除锁存" | 协议 v1.1：收到显式使能（`0x20` 使能位=1 或 `0x21` 任务=巡航）**即解除安全锁存**。若把使能当保活周期发，等于**每 200 ms 自动绕过一次急停保护**（AGENTS 铁律 29 的"旁路"）—— 而表面上一切正常 |
| 2 | **锁存期间禁用**（而不是"提示"）一切起点类入口：方向键、巡航、返航 | 协议 §3.6"锁存期间禁止起步"。靠禁用兜底：**人不会读提示语，但按不动就是按不动** |
| 3 | 急停**不做二次确认**；"重下任务解除锁存"才需要人明确点 | 急停就是"来不及解释"的那个按钮；而解除锁存是**放宽**保护，必须是人主动的动作 |

### 15.3 保活参数与依据

| 项 | 取值 | 依据 |
|---|---|---|
| 周期 | **200 ms**（可调 50~2000） | 固件判据 500 ms，200 ms 留 **2.5 倍余量**；上层再抖动也不会误判失联 |
| 立即发第一条 | 打开保活 / 链路就绪时**立刻**发，不等第一个周期 | "打开后到第一条"的空隙正是最容易踩出 500 ms 超时的窗口 |
| 链路不通时 | **不发**，界面显示"待链路" | 不能假装在保活；否则排障时会以为是固件问题 |
| 失败处理 | 计入 `sendFailed`、**不计入"已发"** | 统计要能回答"到底发出去没有" |
| 操作员动作留档 | 急停与任务指示进事件流（安全事件色）；遥控命令也留档但不着安全色 | 复盘"车为什么停了"往往答案就是"某人按了急停"；而一次遥控几十条，全标安全事件会把"只看安全事件"过滤器刷爆 |

### 15.4 P3 已知边界

1. **遥控只有"按住走/松手停"的四个方向 + 停**：没有速度手柄、没有曲线化的遥控（计划 §11.2 第 9 条的完整形态可继续做）；
2. **`0x23` 巡检参数下发还没接到界面**：`domain/commands` 里已经就绪（`surveyCfgPayload`，带 ppm×10 与钳位），面板随 P4 的调参页一起做；
3. **左转符号未在真机核对**：`patrol_panel.cpp` 里 `kTurnLeftSign` 一处常量，真机若"按左转却右转"只改它（不要在每个按钮回调里各改一遍）；
4. **锁存解除仍依赖固件**：上位机只发协议规定的解除路径，不猜测、不重试（重试会在锁存期间反复开车门）。

---

## 十六、P4 完成记录与真机接口对齐（2026-10-15）

> 上游依据：B 侧 [`../handoff/给C侧_固件接口与判读口径.md`](../handoff/给C侧_固件接口与判读口径.md)（2026-10-15 收工版）。

### 16.1 交付与证据

| 项 | 命令 | 结果 |
|---|---|---|
| 全量回归 | `ctest --test-dir build` | **7/7 通过**（协议 13 + 链路 8 + domain 15 + 界面 11 + 告警 13 + 命令/保活 13 + **记录/回放/参数 13**），全量构建**零告警** |
| 记录与回放 | `ctest -R data` | 12 项：CSV 42 列**列数与表头一致**、UTF-8 BOM（Excel 中文表头）、事件同轴、**记录→回放逐字节一致**、不可写路径必须明确失败、参数定义/范围/**负值必须通过**/NaN 拒绝、下发↔回读配对与不一致留痕、SQLite 三表 + 重开仍在 + 不可用降级不崩 |
| 真机全量回读 | `host.exe --probe COM3 --probe-readback` | 收到 **7 条 0x24 回显**并逐项对照（见 16.2）；固件版本字节 = **0xAF / 10-15**；解帧 318 条 / 丢帧 0 / 格式错帧 0 |
| 界面截图 | `--demo --rate 5 --shot ... --shot-tab 3` | [`P4_调参与记录.png`](图/P4_调参与记录.png)（参数表 + Flash + 观测模式 + 三环曲线 + 判读结论行）|

### 16.2 真机接口对齐发现（**4 条交 B 确认/修**）

| # | 现象（实测） | 与文档/协议的差异 | C 侧当前处理 |
|---|---|---|---|
| 1 | **`0x24` 回读的 `Velocity_Kp/Ki` 是 `+80 / +0.4`** | B 侧接口文档 §3.1 原写本机定稿 **`−80 / −0.4`**；版本字节却是 `0xAF`（就是那一版固件） | ✅ **根因已由代码确认**（2026-10-15 复查，**以已烧录代码为准**）：固件 `param_store.c:93-101` 的范围表里 `Velocity_Kp` 下限是 **`0.0f`**、`Ki` 也是 **`0.0f`**，而 `app_tasks.c:765-766` 上电用 `CFG_OVR_VELOCITY_KP=-80.0f` / `KI=-0.4f` 覆盖 ⇒ `ParamStore_SetOne()` 判 `value < lo` ⇒ **返回 -2 被拒、静默无效** ⇒ 实际生效仍是默认 **`+80/+0.4`**（与 C 侧真机读到的完全一致）。**先前"推测 Flash 里存的是旧值"是错的**。⇒ 若要负增益语义，固件只需把那两行下限改成负值；C 侧界面**允许**填负值并按"回读 ≠ 请求"标红（正确行为）|
| 2 | **`0x11` 的 PWM 字段实测 = `−1579`**（≈ 当时的 `Moto1`） | 协议 §七 约定 4：PWM 是**千分比 0~1000**（0~100 %） | 界面**不截断**（截断会掩盖协议偏差），而是在 PWM 卡片上标琥珀色 + 注明"超出协议约定 0~100 %（真机实测为带符号电机输出，待 B 确认）" |
| 3 | `0x12` 与 `0x10`、`0x11` **同频**（本次 318 帧里各 **90** 条，≈15 Hz） | 协议 §三：`0x12` 标称 **5 Hz**；`0x10/0x11` 标称 20 Hz（实测 ≈15 Hz） | 界面按实际速率工作（不影响判读）；**代码确认这是有意共用同一 telemetry 节拍**（`app_tasks.c:360-390`）⇒ 协议周期表已按代码更正 |
| 4 | **`0x11` 的距离字段被 C 侧按 cm 显示，实际是 mm**（`timer.c:87` 的 `counts*170/1000` + `main.c:53` 的 `TIM3_Cap_Init(0xFFFF,84-1)` ⇒ 毫米量级；`app_tasks.c:382` 原样填字段；厂商 OLED 也是 `Distance/10` 当 cm） | 协议 §三/§七 写 `uint16(cm)` ⇒ **差 10 倍** | ✅ **已修（C 侧实错）**：`MotionData::distanceMm` 按毫米解码，界面/CSV/自检一律用 `units::cmFromMm()` 换算显示；`0x11` 的"避障阈值 500"从此与界面口径一致（=50 cm）。协议文档按代码更正（cm→mm）|

### 16.2.1 代码审计（2026-10-15，**以已烧录代码为准**）另外确认的 4 件事

| # | 代码事实 | 对 C 侧的影响 | 处理 |
|---|---|---|---|
| A | **`0x22` 控制模式是空实现**（`patrol.c:172-173` 只 `return 1`；模式枚举在固件里无使用点） | 上位机**无法**切换避障/跟随模式；避障只能靠板上长按按键（`control.c:329`），且 `Bi_zhang==2`（跟随）在 RTOS 构建下**不可达** | 已在协议/接口文档标注"未实现"；与"避障距离做成活参数"一起作为**建议 B 实现**的项 |
| B | **`0x20 enable=1` 只解"失联锁存"**（`patrol.c:149-160` 条件含 `stopReason==LINKLOST`）；急停/硬件故障**只有 `0x21` 能解**（`patrol.c:124-138`） | 巡检页的"重下任务解除锁存"是**唯一**能解急停的入口（正确）；界面文案不能承诺"发 0x20 就恢复" | 已在接口文档给出"解除条件矩阵"；界面横幅文案保持"需重下任务" |
| C | **低压有两条通路**：控制侧迟滞（≥11.6 V 恢复 `Turn_Off` 判据）+ **App 侧锁存（只有 `0x21` 能清）**，且电压仍低时重下任务会**立即回弹**（`app_tasks.c:591-609` → `patrol.c:215-221`） | 界面不能写"≥11.6 V 自动解除"（会让人以为车会自己恢复） | 总览电压卡副标题与手册已改为"控制侧 ≥11.6 V 恢复；**App 侧锁存需重下任务解除**" |
| D | `0x16` 的 `moto1/moto2` 是**经侧向极性补偿之后**的量，而固件里"哪一侧翻向"的注释与宏值自相矛盾（`app_config.h:138-151` 注释说唯一解 (1,0)、宏是 (1,1)） | C 侧原先把"`Turn=0` 而两轮不同"当**红色故障**，可能误报 | 已降级为**琥珀提示**并加注"先核对固件极性开关"（`--probe-readback` 的判读行同步改） |

### 16.3 按 B 侧口径做的三处**对齐修正**（都是"界面会误导人"的类型）

| # | 原来的做法 | 改成 | 为什么 |
|---|---|---|---|
| 1 | 前端校验按协议表把 `Velocity_Kp` 限成 **0~500** | 改成 **−500~500**（`Ki` → **−0.82~0.82**，`Turn_Kp → ±500`、`Turn_Kd → ±10`），并加**回归测试**断言七个定稿值全部通过校验 | B 侧接口文档点名的坑：**本机正确值就是负的**，校验若只允许 ≥0，会把正确值在界面上直接挡掉（现象是"界面上不让填"，人会去查界面 bug）|
| 2 | 低压报警只看 `< 11.1 V` | 先过 **"有没有电池"门槛 6.00 V**（决策 60 同口径），且解除线改 **11.6 V**（与固件自动解除门限一致）；无电池时显示"按无电池处理（USB 供电？）"而**不是**低压报警 | 真机 USB 供电时 `0x15` 报 **≈4.3 V**：固件按"无电池"处理，上位机若报红就是**假报警**；解除线取 11.4 会出现"界面说已解除、车还锁着" |
| 3 | `Moto≠0 而 CCR=0` 一律报红"算了没执行" | 分三级：**已执行 / 保护中未驱动（琥珀，正常）/ 算了没执行（红，真故障）**；判据是 `Flag_Stop` 或"电机被禁"是否置位 | 真机上"**没使能电机**"就长这样：`Moto1=−1581、CCR=0、Flag_Stop=1` —— 那是**保护生效**，报成红色故障等于把正常状态说成 bug（B 侧接口文档 §2.1/§4）|

### 16.4 P4 已知边界

1. **`0xFD` 观测模式（100 Hz）只在有线上有效**，且是**临时状态**：界面已写明"整定完请关掉"，但**上位机不强制在退出时关闭**（关掉需要一次下发；留给操作者，避免"退出程序顺手改了车的行为"）；
2. **SQLite 只存会话/事件/参数**，逐帧数据在 CSV（把 20 kHz 级数据塞进 SQLite 得不偿失）；
3. **回放按记录顺序循环播放**，不还原原始时间间隔（要精确复现时间轴需要按 CSV 的时间列重排 —— 留作可选项）；
4. **Flash 保存（`0x00`）不做二次确认**：它是"把当前值固化"，风险低于运动类命令，但**会改变掉电后的行为** —— 若将来有人误按，靠"下发日志 + 事件流留档"回溯（已实现）。

---

## 十七、P5 完成记录：打包与交付文档（2026-10-15）

### 17.1 一键打包 `host/package.ps1`

```powershell
cmake -S host -B host/build-release -G Ninja -DCMAKE_BUILD_TYPE=Release && cmake --build host/build-release
pwsh -File host/package.ps1          # → host/dist/上位机/（12 个文件 / 37.4 MB）
```

**过程与结果**（每一步都有实测数）：

| 步骤 | 结果 | 说明 |
|---|---|---|
| ① 用 **Release** 树 | `host.exe` **3.2 MB**（Debug 树是 **41.5 MB**，且 `-O0` 更慢） | 交付用 Release；Debug 只用于 gdb |
| ② `windeployqt` | 原始 **109 MB** | 带上 `platforms/qwindows.dll`、`styles/`、`sqldrivers/qsqlite.dll` |
| ③ 瘦身（删了再验） | **109 → 37.4 MB** | 删掉 D3D12/D3D11 着色器编译器（`dxcompiler`/`dxil`/`D3Dcompiler_47`，纯 QWidgets 不用 RHI）、QML/Network/SVG、多余 SQL 驱动、图片格式插件 —— 共 15 项 |
| ④ 四项校验（**干净 PATH**：Qt/MinGW 全部移除） | 全过 | ① `--selftest 3` 退出码 **0**；② 界面真起来、4 s 不异常退出；③ 截图链路 `119 KB` PNG 落盘；④ 录制链路 **CSV 1900 行 + SQLite 会话库 20 KB** |

**这一轮踩到的三个坑**（已写进 AGENTS 铁律 43）：
1. `windeployqt` 参数写错时**只打印一行 `Unknown option` 然后什么都不部署** ⇒ 若不校验就会打出"看似成功的空包"；
2. `windeployqt` 只部署当前平台的 `qwindows.dll`，**没有 `qoffscreen.dll`** ⇒ 在便携目录里跑
   `-platform offscreen` 必然失败（自检方式错了，不是包错了）；交付目录的验证要**用真实平台插件**（=双击路径）；
3. 少了 `sqldrivers/qsqlite.dll` 时程序**不报错**，只是会话库**静默降级**成"只有 CSV" ⇒ 把它列为硬校验项，
   并专门加一步"录制 5 s 后检查会话库文件真的建起来"。

### 17.2 三份交付文档（分工不重叠）

| 文档 | 给谁看 | 内容定位 |
|---|---|---|
| [`软件设计说明.md`](软件设计说明.md) | 评阅/接手的人 | **需求→实现→验收对照表**、五层架构与依赖方向、线程与数据流、模块清单、关键决策、协议一致性表（含实测偏差）、界面规范、测试证据、构建打包、已知边界 |
| [`用户操作手册.md`](用户操作手册.md) | **现场要用它的人** | 便携版怎么跑、**第一次连真机**（含 DTR/RTS 坑）、逐页截图与看点、记录/回放/截图、**3 分钟无硬件演示**、**故障排查表（症状→原因→怎么办）**、安全须知、命令行速查 |
| [`演示脚本.md`](演示脚本.md) | 答辩/验收现场 | **5 分钟分镜表**（时间/操作/预期现象/要讲的一句话）、1 分钟精简版、**降级备用方案**（板子不在/串口被占/要复现刚才那一幕）、演示前 30 秒自检命令 |

三份文档的原则：**只写实测到的数**（体积、行数、退出码、参数值），不写"应该没问题"。

### 17.3 C 部分总交付清单

| 交付物 | 位置 | 状态 |
|---|---|---|
| 上位机可执行程序（便携，免装 Qt） | `host/dist/上位机/`（`package.ps1` 一键重建） | ✅ 12 文件 / 37.4 MB |
| 完整源代码工程（CMake，7 个测试目标） | `host/` | ✅ `ctest` **7/7**，零告警 |
| 软件设计说明 | [`软件设计说明.md`](软件设计说明.md) | ✅ |
| 用户操作手册 | [`用户操作手册.md`](用户操作手册.md) | ✅ |
| 演示脚本 + 界面截图 | [`演示脚本.md`](演示脚本.md)、`P0~P4_*.png`（6 张） | ✅ |
| 协议一致性证据（真机） | `--probe-readback` 输出、§十六 | ✅ 7 个参数实际生效值 |

---

## 十八、现场收尾记录（2026-10-15 晚，用户真机反馈驱动）

C 部分交付后，用户带着真机逐项试用，反馈了 5 类问题。**逐条都定位到根因并修复**（决策 78/79、铁律 44）：

| # | 用户反馈 | 根因（代码级） | 修法 | 归属 |
|---|---|---|---|---|
| 1 | 遥控"按住只走半秒" | 上位机**按下只发一条 `0x20`**，而固件对 `0x20` 有 **500 ms 看门狗**（超时清方向标志）——协议本来就写明 `0x20` 是 **10 Hz 周期指令** | 新增 `startMotion/stopMotion` + **100 ms 重发**；松手立即发 `enable=0`；方向键设 `NoFocus` | C |
| 2 | "PWM 占空显示有问题""一负就报警不对" | `0x11` 偏移 4 实为**带符号电机输出均值**（±8200，真机 −1579），界面按协议文本当"千分比 %"显示 | 按固件换算关系显示为**带符号估算占空比**（`Moto ÷ 7179.5 × 100`，依据 `CCR=|Moto|×1.17`、满幅 8400；**真机实测 `Moto −290 → CCR 339` 恰好印证 1.17**）；**负值不报警**，只有 `\|Moto\|>7179`（CCR 被截断）才提示饱和 | C |
| 3 | "转向没反应" | `CFG_OVR_TURN_KP/KD = 0` —— B 当年为躲"原地转圈"把转向环关了，而那次转圈的真因是**裸 `if` 缺花括号**（铁律 37，已修） | `TURN_KP/KD` 恢复厂商默认 **52/0.5**，并可在调参页 `0x24` 在线调 | C+B |
| 4 | "前后太保守" | 真正决定快慢的是固件 `Target_Velocity / Flag_sudu`；上位机 `0x20` 的 `linMmS` **只判方向** | `Target_Velocity 110 → 150`（Movement 55→75，约 +36%），避障档 55→70 | B |
| 5 | "左右倾角读不到""全屏显示不全""背景变白" | ① 左右倾角：固件把 `pose.roll` **写死 0**；改成取四元数 `Pitch` 后**仍恒 0** —— 真因是本机 `Way_Angle=2`（卡尔曼）时 **`Read_DMP()` 从不执行**；② 窗口写死 `1560×960` 而笔记本屏 1366×768；③ 每页套 `QScrollArea` 后深色 QSS 未覆盖 viewport ⇒ 原生样式下露系统白底 | ① 改取**加速度计 X 轴**算静态左右倾角（+陀螺仪 Y 轴角速度），与姿态算法无关；② 窗口按屏幕自适应 + 每页可滚动 + 新增 `--size WxH`；③ QSS 给 viewport 与页面显式定色；④ 界面文案按用户要求**只留数字、解释进 tooltip**（1366×768 免滚动条） | B+C |
| 6 | "我确认烧的是新固件！" | 同一天多次构建，`buildId` 只到"日"⇒ **无法分辨板上是哪版**（我一度误判"没烧进去"） | `0x16` 状态位 **bit3 = 固件特性位**；状态条显示 `新特性✔ / ⚠旧构建`，`--probe-readback` 也打印 | B+C |

**这一轮的通用教训**（已写进决策 78/79、铁律 44）：
① **先问"这个量到底决定什么、被谁读走"** —— 把编译期常量当开关、把"只判方向的值"当速度、把设计分辨率当所有屏幕；
② **填一个观测值之前，还要确认"这一版代码里有没有人写它"** —— 读一个只被死分支写入的全局量，等于读常量 0；
③ **外观/版本类争议要有可判据的机制**（构建标识位、换样式复现），不要靠现象猜。

> 收尾后复验：固件 `make clean && make` + **`make strict` 自研代码 0 条**；上位机 Debug/Release 两棵树**零告警**、
> `ctest` **7/7**、`host/package.ps1` 干净 PATH 四项校验全过（12 文件 / 37.4 MB）、文档断链 **0**。

---

> **项目归属**：中国石油大学（华东） 专业生产实习课程项目<br>
> **范围说明**：本项目不涉及 MiniBalance 控制板（STM32F405RGT6 版本）的硬件设计与改版；控制板直接沿用，A1 仅重做主底板。<br>
> **许可**：原创代码与文档采用 MIT License；第三方组件遵循各自原始许可证。
