pierrotto12138-code/balance-car-inspection-robot/docs/design_host/软件设计说明.md

# 上位机软件设计说明（角色 C）

> **适用版本**：上位机 `host`（2026-10-15，**P0~P5 完成版 + 现场收尾**）、协议 **v1.2**、配套固件 `0xAF`（10-15）。
> **本文用途**：交付文档之一（任务书要求的「软件设计说明」），回答三个问题：
> **如何分层**、**各项判据的依据**、**验证方式与证据**。
> 相关工作文档：[`C部分方案与计划.md`](C部分方案与计划.md)（开工前的调研与计划，含 P0~P5 验收判据）、
> [`../../host/README.md`](../../host/README.md)（构建与命令速查）、
> [`../handoff/给C侧_固件接口与判读口径.md`](../handoff/给C侧_固件接口与判读口径.md)（B→C 接口口径）、
> [`../protocol/communication_protocol.md`](../protocol/communication_protocol.md)（协议 v1.2）。

---

## 1. 概述与范围

上位机是"仓储环境安全巡检机器人"的**监控与操作台**：将下位机（STM32 平衡小车）经**有线串口**与
**蓝牙**两条链路上报的二进制帧转换为可读界面，并提供**操作入口**（任务下发、急停、
解除锁存、在线调参）与**记录能力**（逐帧 CSV、会话库、回放）。

| 做什么 | 不做什么（边界） |
|---|---|
| 解帧 → 单位换算 → 状态聚合 → 显示/告警/记录 | **不做控制律**：平衡、避障、安全停车全在固件里 |
| 下行命令的**数据段**构造（进协议、带钳位） | 不代替固件判断"能不能动"（固件是安全责任方） |
| 保活心跳（防固件 500 ms 失联锁存） | 不绕过任何安全逻辑（**尤其不用使能类命令保活**，见 §6.2） |
| 记录与回放（现场复盘、无硬件演示） | 不做数据拟合/预测（仅如实呈现与标注） |

---

## 2. 需求 → 实现 → 验收（对照表）

| 任务书/计划的验收判据 | 实现位置 | 验收证据 |
|---|---|---|
| 串口能连、链路状态可见、丢帧率可见 | `io/link_manager`、`io/serial_link`、`ui/p0panel` | `ctest -R link`（9 项，全部在假源上运行）；真机 `--probe COM3` 打印收/发/解帧/丢帧 |
| 姿态/轮速/超声/温湿度/气体/电压实时显示 | `domain/frames`、`domain/units`、`ui/panels/overview_panel` | `ctest -R domain`（15 项，含冻结向量逐字段比对）；真机探测的状态聚合全字段 |
| 超阈值告警（连续确认、迟滞、不重复报） | `domain/alarm` | `ctest -R alarm`（14 项：两个方向、确认帧数、迟滞、解除再报） |
| 实时曲线（不全量重绘） | `ui/widgets/scope_plot`（QCustomPlot 唯一封装） | `ctest -R ui`；`--demo` 截图 [`P2_曲线与告警.png`](图/P2_曲线与告警.png) |
| 巡检阶段/进度/巡检点可视化 | `ui/panels/patrol_panel` | `--demo --rate 5 --shot ... --shot-tab 1` ⇒ [`P3_巡检与控制.png`](图/P3_巡检与控制.png) |
| 任务下发/急停/锁存解除 | `domain/commands`、`patrol_panel` | `ctest -R command`（15 项，含"急停真的写出 7 B、任务 9 B"） |
| 在线调参并确认生效 | `domain/commands`(0x24)、`domain/frames`(0x24 回显)、`data/param_store`、`ui/panels/tune_panel` | `ctest -R data`（14 项）；**真机 `--probe-readback`** 取回 7 个实际生效值 |
| 记录能被 Excel 打开 | `data/recorder`（CSV，UTF-8 **BOM**，42 列自描述表头） | `test_data`：表头/列数/BOM 断言；打包校验第 ④ 步（1900 行 CSV） |
| 无硬件也能回放驱动界面 | `io/replay_link` + `--play` | `test_data`：**记录→回放逐字节一致**；`--play` 与假源共用同一套解帧路径 |
| 便携交付（不装 Qt 也能跑） | `package.ps1`（windeployqt + 瘦身 + 四项校验） | 干净 PATH 下：自检 0 / 界面 4 s / 截图 119 KB / CSV 1900 行 + 会话库 20 KB |

---

## 3. 总体架构：五层单向依赖

```
                ┌────────────────────────────────────────────┐
                │  ui/        界面层（Qt Widgets + QCustomPlot）│
                │  只读 domain 的状态，只调 commands 构造下行    │
                └───────────────▲───────────────┬────────────┘
                                │ 状态/告警      │ 用户操作
                ┌───────────────┴───────────────▼────────────┐
                │  data/      记录与落盘（CSV / SQLite / 事件流）│
                └───────────────▲───────────────┬────────────┘
                                │               │
                ┌───────────────┴───────────────▼────────────┐
                │  domain/    领域层（单位/帧/状态/告警/命令/保活）│
                │  ★ 协议口径的**唯一**落点：所有 0.1 与 10 在这里 │
                └───────────────▲───────────────┬────────────┘
                                │ 帧(载荷)       │ 下行数据段
                ┌───────────────┴───────────────▼────────────┐
                │  io/        链路层（真实串口 / 蓝牙 / 假源 / 回放）│
                │  读线程解帧 → 跨线程队列信号                    │
                └───────────────▲───────────────┬────────────┘
                                │ 字节流         │
                ┌───────────────┴───────────────▼────────────┐
                │  protocol/  协议层（纯 C++/Qt Core，无界面依赖）│
                │  CRC-16/MODBUS、流式解帧、组帧、命令字常量       │
                └────────────────────────────────────────────┘
```

**依赖方向**（唯一合法方向，`CMakeLists.txt` 用 5 个 target 强制）：

```
protocol ← io ← domain ← data ← ui ← host(main.cpp 装配)
```

| 层 | target | 允许依赖 | 关键纪律 |
|---|---|---|---|
| protocol | `protocol` | Qt6::Core | **零界面、零全局状态**；同一份代码被 PC 单测与固件交叉验证（决策 36） |
| io | `hostio` | protocol | 真实链路与假源**同一个 `LinkBase` 接口**（决策 32）；假源必须自己走解帧（决策 30） |
| domain | `domain` | protocol, io | **单位换算只此一处**（决策 65：少一个 10 的教训）；只有 `VehicleState::dataUpdated` 才代表"新数据"（去重，决策 67） |
| data | `hostdata` | domain, io, Qt6::Sql | 写盘失败必须可见；SQLite 不可用要**降级而不是崩** |
| ui | `hostui` | data, domain, io, QCustomPlot | **界面不解析字节、不做判据**，只显示与转发；三处口径不一致的现象一律视为缺陷（决策 65） |
| host | `host` | hostui | `main.cpp` 只做装配与命令行（依赖由外向内注入） |

---

## 4. 线程与数据流

```
串口读线程                    主线程（GUI）
──────────                    ──────────────────────────────────────
readAll() → FrameDecoder::feed()
   ↓ 解出一帧
emit frameReady(cmd, payload) ──┐  (Qt::QueuedConnection，载荷按值传递)
                                │
                                ├→ domain::VehicleState::onFrame
                                │     · 长度/命令字校验 → 计数（格式错帧/协议外命令）
                                │     · **跨链路去重**（同命令字 + 逐字节相同 + 另一条链路 + ≤150 ms）
                                │     · 新数据才 emit dataUpdated(cmd)
                                │         ├→ AlarmEngine::onFrameDecoded（阈值类规则）
                                │         ├→ 曲线面板采样（每帧一次）
                                │         └→ 调参页 0x24 回读比对
                                ├→ data::EventLog（0x13 事件 + 本机告警 + 操作员动作）
                                └→ data::CsvRecorder（逐帧一行，含原始帧 HEX）

主线程定时器：
  10 Hz  alarm.tick()      —— 依赖"时间"的规则（失联、锁存）
  10 Hz  各面板 refresh()  —— 界面刷新（**绝不每帧重绘**）
  5 Hz   KeepaliveEngine   —— 默认 200 ms，发 0x1F 心跳（防失联锁存）
```

**如此划分的理由**（三条均来自实际踩坑）：

1. **解析在工作线程、判据在主线程**：串口是 IO 阻塞的，界面不能卡；但告警/记录需要统一的口径，
   所以解帧后立刻把"干净载荷"交给主线程，所有判据只出现在一处。
2. **`dataUpdated` 是"新数据"的唯一信号**：两条链路都发同样的帧（协议 §七 约定 6），
   若按"收到帧"计数，曲线会采两个样、告警的"连续 3 帧"会被 1.5 次真实采样满足（提前报警）。
3. **重绘与采样解耦**：采样每帧一次（数据点不丢），重绘 10 Hz（不卡界面）——
   `ScopePlot` 内部是环形缓冲 + 窗口 2 倍裁剪。

---

## 5. 模块清单

### 5.1 `src/protocol/`（协议层，13 项单测）

| 文件 | 职责 |
|---|---|
| `codec.h/.cpp` | CRC-16/MODBUS、`encodeFrame`、`FrameDecoder`（流式：粘包/半包/坏 CRC 恢复） |
| `frame.h` | 命令字常量（`up::` / `down::`）、事件码、固定长度表 |

### 5.2 `src/io/`（链路层，9 项单测）

| 文件 | 职责 | 要点 |
|---|---|---|
| `link.h` | `LinkBase` 抽象 + `LinkKind`/`LinkState`/`LinkStats` | 上层只认这个接口 |
| `serial_link` | 真实串口（`QSerialPort` + 独立读线程） | ★ **打开时显式设 DTR=高/RTS=低**，否则 CH340 自动下载电路会把 MCU 停在 BootLoader（铁律 33） |
| `bluetooth_link` | 蓝牙串口（同样是串口设备，独立配置） | 两条链路**都发**周期帧与事件 |
| `replay_link` | 假源 + 记录回放 | 虚拟时间用 `QElapsedTimer` **实测真实经过时间**（铁律 31）；回放直接喂解帧器（铁律 30） |
| `link_manager` | 双链路聚合、模式切换（Serial/Replay）、主链路判定、`send/sendTo` | 记录文件回放与假源走**同一条**数据通路 |
| `serial_probe` | `--probe` 只读探测 | 端口占用/断开都打印驱动原文 |

### 5.3 `src/domain/`（领域层，15 + 14 + 15 项单测）

| 文件 | 职责 | 关键内容 |
|---|---|---|
| `units.h/.cpp` | **协议定点量的唯一换算处** | ppm×10、0.01°、0.01 V、千分比→%；固定小数位格式化 |
| `frames.h/.cpp` | 8 类上行帧结构体 + **精确长度**解码 + 名称表 | `expectedUpLen()`；`LoopData` 的两个判读谓词（见 §5.6） |
| `vehicle_state.h/.cpp` | 双链路合并、去重、新鲜度、安全锁存、诊断 | `kLinkTimeoutMs=200`、`kPoseStaleMs=250`、`kDuplicateWindowMs=150` |
| `alarm.h/.cpp` | 阈值告警（连续确认 + 迟滞 + 状态跃变） | `AlarmThresholds` 全部可调；**方向显式声明**（`lowIsBad`，决策 68） |
| `commands.h/.cpp` | **下行数据段唯一出处** | 7 个构造器 + 钳位 + 安全影响分类（`Latch/Release/None`） |
| `keepalive.h/.cpp` | 保活引擎 | 默认**心跳 0x1F**、200 ms、链路不通不发、可注入 `Sink`（便于单测） |

### 5.4 `src/data/`（记录层，14 项单测）

| 文件 | 职责 | 关键内容 |
|---|---|---|
| `event_log` | 事件/告警/操作员动作同轴 | 安全事件 `0x0A`→`0x09` **成对**给出停车时长 |
| `param_store` | PID 参数账本 | 定义（ID/名称/固件变量/默认/**范围**/说明）、前端校验、**下发↔回读配对**、巡检参数 |
| `recorder` | `CsvRecorder` + `SessionStore` | CSV 42 列（含原始帧 HEX，可回放）、UTF-8 BOM；SQLite 三表（sessions/events/params） |

### 5.5 `src/ui/`（界面层）

| 文件 | 职责 |
|---|---|
| `theme/theme` | 配色与字体**唯一出处**（ISA-101：常态中性、琥珀=警告、红=报警、灰=离线；绿只用于状态灯） |
| `widgets/value_card` | 数值卡（值 + 单位 + 状态色 + 副标题；`setInvalid` 明示"无数据"） |
| `widgets/led_indicator` | 状态位灯（三态 + tooltip 说明） |
| `widgets/attitude_indicator` | 人工地平仪 |
| `widgets/scope_plot` | QCustomPlot 的**唯一**封装：通道、环形缓冲、阈值线、事件标记、十字定标、滚轮缩放、双击复位、末端读数 |
| `panels/overview_panel` | ①总览：姿态/运动/电源环境/任务/诊断/状态位 + 安全横幅 + 0x16 判读结论 |
| `panels/patrol_panel` | ②巡检与控制：阶段时间轴、任务下发/急停/解除锁存、保活、遥控（按住走松手停） |
| `panels/curve_panel` | ③曲线与告警：四张通道独立曲线 + 阈值线 + 告警标记 |
| `panels/tune_panel` | ④调参与记录：参数表 + Flash + 观测模式 + 三环曲线 + 下发日志 + 0x23 |
| `panels/event_panel` | ⑤事件流：过滤（事件/告警/操作员动作）+ 停车时长 + 量化统计 |
| `p0panel` | ⑥通信链路：连接、波特率、统计、HEX 报文日志 |
| `mainwindow` | 导航、状态条（链路/电池/报警/安全/**保活**/**录制**/**固件版本**/帧计数/假源水印）、菜单、F11 截图 |
| `main.cpp` | 装配、命令行（`--selftest/--demo/--shot/--probe*/--record/--play/--db/--rate`） |

### 5.6 四处"判读谓词"（放在 domain，可单测）

| 谓词 | 判据 | 界面表现 |
|---|---|---|
| `LoopData::differentialWithoutTurn()` | `Turn==0` 且 `moto1 != moto2` | 红灯"Turn=0 两轮不同"（差速/极性 bug，本机曾因此原地转圈） |
| `LoopData::executionState()` | `Moto≠0 而 CCR==0` 时：`Flag_Stop`/电机被禁 ⇒ **Protected**；否则 **Mismatch** | 琥珀"保护中，未驱动" vs 红"算了没执行"（决策 74） |
| `tiltProtectActive(pitch, zhongzhi)` | `|倾角−Zhongzhi| > 40°` | 琥珀提示（现场手动倾车也会触发，**不是故障**） |
| `LoopData::featureBits()` | `0x16` 状态位 **bit3 = 固件特性位**（决策 79） | 状态条 `固件 0xAF/10-15 · 新特性✔` / `· ⚠旧构建`（未置位 ⇒ 板上是旧构建，提示重烧） |

> **另两处"如实标注"**（不属于谓词，但同属"监控端口径"）：`0x11` 的电机输出均值按固件换算关系显示为
> **带符号估算占空比**（`Moto ÷ 7179.5 × 100`，见 `units.h`；**负值 = 反向、不报警**，只有 `|Moto|>7179`
> 即 CCR 被 8400 截断时才提示"已顶到满量程"）；**偏航角固件未计算** ⇒ 界面写"固件未计算（该字段恒 0）"，
> 不把常量 0 当成测量值；同理左右倾角注明是**仅加速度计的静态角**。

---

## 6. 关键设计决策（摘录，完整见 [`../决策记录.md`](../决策记录.md)）

### 6.1 协议口径只在一个地方

`units.h` 是"协议定点量"的唯一换算处。为什么值得单独一条：**少除一个 10** 曾让湿度 66 % 显示成 6 %，
而**界面上看起来完全正常**（决策 65）。同理 `expectedUpLen()` 是精确长度表，长度不符就计
"格式错帧"而不是硬解 —— 错误必须能被计数，才有资格被修。

### 6.2 保活只能用心跳（安全相关，铁律 40）

固件规则：**500 ms 没有下行帧 ⇒ 安全停车并锁存，硬件按键也解不开**。所以上位机必须周期发合法下行帧。
但协议同时规定：**收到显式使能（`0x20` 使能位=1 / `0x21` 自主巡航）即解除安全锁存**。
⇒ 若用"使能"当保活，等于每 200 ms 自动拆掉一次急停保护，而界面一切正常（铁律 29 的旁路）。
本项目：`KeepaliveEngine` 默认 `0x1F` 心跳、200 ms（2.5 倍余量）、链路不通**不发**、
发送失败不计入"已发"；界面把"使能保活"做成需要显式选择并红字告警的选项（决策 69）。

### 6.3 判据必须与固件同口径（铁律 42）

P4 对齐真机时连中两次：**参数范围**照协议表写成 `0~500`，而本机正确值是 **−80/−0.4**（负增益，
因为电机/编码器符号与厂商约定相反）⇒ 前端校验会把板子上的正确值判为非法；**低压报警**只看
`<11.1 V`，而固件对"没接电池/分压悬空"有 **6.00 V 门槛** ⇒ USB 供电时界面报红而车只是没接电池。
现：范围允许负值（带回归测试）、低压先过 6 V 门槛、解除线取 **11.6 V**（与固件一致）。
**规则**：写任何前端判据前先读 B→C 接口口径文档，并用 `--probe-readback` 拿真机数据核对。

### 6.4 报警要指向真问题

"监控台的价值在于如实"：报警判据过宽会让现场第一反应变成"这软件又乱报"，
之后真故障也不信（狼来了）。所以：保护生效（未使能时 `CCR=0`）标琥珀而不是红；
`0x11` 的 PWM 字段真机上报带符号电机输出（−1579）时**标注"超出协议约定"**，
但**不擅自截断**（截断会掩盖协议偏差）。

### 6.5 记录与回放共用一条通路

CSV 的最后一列是**原始帧 HEX** ⇒ 回放时把这一列喂回解帧器（与真实链路同一套解析/聚合路径），
于是"记录→回放"不需要第二套格式，也不可能出现"记录对了、回放不对"（决策 30/32 的延伸）。

---

## 7. 协议一致性

| 方向 | 命令 | 载荷长度 | 周期（协议标称 → **实测**） | 上位机用途 |
|---|---|---|---|---|
| 上行 | `0x10` 姿态 | 12 | 20 Hz → **≈15 Hz** | 总览姿态卡 + 地平仪 |
| 上行 | `0x11` 运动 | **9** | 20 Hz → **≈15 Hz** | 轮速/PWM/超声/避障位；★ 距离字段单位是 **mm**（界面 /10 显示 cm，`units::cmFromMm`）；★ PWM 字段是**带符号电机输出均值**（≈±8200）而非千分比 |
| 上行 | `0x12` 任务 | 5 | **与 `0x10/0x11` 同频**（代码事实：共用同一 telemetry 节拍；非 5 Hz） | 巡检阶段/进度/巡检点/异常 |
| 上行 | `0x13` 事件 | 5 | 事件触发 | 事件流（已去重） |
| 上行 | `0x14` 环境 | 16 | 1 Hz | MQ-2/MQ-135/温湿度/就绪位 |
| 上行 | `0x15` 诊断 | 16 | 1 Hz | 电压/页号/堆/OLED 写速率/任务 tick |
| 上行 | `0x16` 三环 | 20 | 1 Hz | 三环曲线 + `Moto/CCR` 对照 + 状态位 + **固件版本** |
| 上行 | `0x1F` 心跳 | 0 | **200 ms（5 Hz）**（代码事实，非 1 Hz） | 存活 |
| 上行 | `0x24` 回显 | 6 | 命令触发 | 调参回读/回执（**只读全量回读 0xFF**） |
| 下行 | `0x20` 运动 | 5 | 10 Hz | 遥控（按住走松手停，`enable=0` 立即停）；★ `enable=1` **只解"失联锁存"**（急停解不开；无回复） |
| 下行 | `0x21` 任务 | 2+2k | 事件 | 巡航/返航/待机；★ **k 个参数被固件忽略**（只解释任务 ID）；★ 唯一能解**急停/硬件故障**锁存的命令 |
| 下行 | `0x22` 模式 | 1 | 事件 | ⚠ **固件未实现**：接受即忽略、无回复；避障/跟随目前只能靠板上长按按键 |
| 下行 | `0x23` 巡检参数 | 12 | 事件 | 采样周期/阈值/自适应/补偿/确认帧数；**唯一会立刻回 `0x12` 的命令** |
| 下行 | `0x24` 调参 | 6 | 事件 | PID 写入/Flash 保存/载入/观测模式/全量回读；★ `0x00`/`0xFE` 是**破坏性 Flash 操作**（整扇区擦除），别在运动中发 |
| 下行 | `0x2F` 急停 | 0 | 事件 | 停车并锁存（只能 `0x21` 解除；**无回复**） |
| 下行 | `0x1F` 心跳 | 0 | **5 Hz** | 保活（防失联锁存） |

**实测/口径偏差（已按代码更正并交 B）**：`0x12` 与 `0x10/0x11` 同频；`0x1F` 心跳 200 ms；
`0x11` 的 PWM 字段是带符号电机输出、**距离字段是 mm（协议原写 cm，差 10 倍）**；
`0x24` 回读的 `Velocity_Kp/Ki` 当前是 `+80/+0.4`（编译期定稿 `−80/−0.4` **被参数范围校验拒绝**，见 §6.3 与决策 77）。
详见 [`C部分方案与计划.md`](C部分方案与计划.md) §十六。

---

## 8. 界面设计规范

| 项 | 规范 | 落地 |
|---|---|---|
| 配色 | **ISA-101**：常态中性；琥珀=警告；红=报警；灰=离线；**绿只用于状态灯** | `ui/theme/theme.h` 一处定义，全界面引用 |
| 装饰 | 不用渐变、不用阴影、不玩动效 | 纯色卡片 + 1 px 边框 |
| 数值 | 固定小数位（不跳位）、必带单位 | `units::number()` + `withUnit()` |
| 数据源 | 每个卡片副标题写"来源链路 + 新鲜度" | 总览各卡；过期/无数据显式标注 |
| 刷新 | 采样每帧一次、重绘 10 Hz | `ScopePlot` + 各面板 `QTimer(100ms)` |
| 安全信息 | **不平滑、不平均、不丢弃**；锁存/急停原样显示 | 状态条与横幅；急停按钮不做二次确认 |
| 演示数据 | 假源必须**水印** | 状态条左侧"数据源：假源回放" |

---

## 9. 测试策略与证据

| 测试目标 | 项数 | 覆盖内容 | 命令 |
|---|---|---|---|
| `test_codec` | 13 | CRC、组帧、流式解帧（粘包/半包/坏帧恢复）、冻结向量逐字节 | `ctest -R codec` |
| `test_link` | 8 | 双链路聚合、假源速率、回放载入、断开/重连状态 | `ctest -R link` |
| `test_domain` | 15 | 单位换算、8 类帧解析与长度校验、状态聚合、**跨链路去重** | `ctest -R domain` |
| `test_alarm` | 13 | 连续确认、迟滞（两个方向）、状态跃变、事件流配对与停车时长 | `ctest -R alarm` |
| `test_command` | 13 | 下行帧往返、钳位、`0x24` float 小端、保活行为 | `ctest -R command` |
| `test_data` | 14 | CSV 列数/BOM/事件同轴、**记录→回放逐字节一致**、参数范围与负值、SQLite 三表与降级 | `ctest -R data` |
| `test_ui` | 11 | 界面冒烟（offscreen）、页面切换、锁存禁用入口、急停真发字节、参数回读刷新 | `ctest -R ui` |

**三层证据**：① 单元测试（不需要硬件/显示器）；② 无界面自检 `--selftest`（假源剧本 + 打印统计）；
③ **真机探测** `--probe COM3 --probe-readback`（真实串口 → 解帧 → 聚合 → 0x24 回读逐项对照）。
Release 树同样跑全部测试（`ctest --test-dir build-release`，7/7）。

---

## 10. 构建与打包

```powershell
# 开发（Debug，便于 gdb）
cmake -S host -B host/build -G Ninja -DCMAKE_BUILD_TYPE=Debug && cmake --build host/build
# 交付（Release：host.exe 3.2 MB，而 Debug 是 41.5 MB）
cmake -S host -B host/build-release -G Ninja -DCMAKE_BUILD_TYPE=Release && cmake --build host/build-release
ctest --test-dir host/build-release --output-on-failure
# 一键打包（windeployqt + 瘦身 + 四项校验，产出 host/dist/上位机/）
pwsh -File host/package.ps1
```

打包脚本的**四项校验**（缺一项都不算成功）：① 干净 PATH 下无头自检退出码 0；
② 界面真的起来且 4 s 不异常退出；③ 截图链路（渲染 → `grab` → PNG 落盘）；
④ 记录链路（CSV 行数 + **SQLite 会话库真的建起来**）。
产出 **12 个文件 / 37.4 MB**（windeployqt 原始 109 MB，删掉 D3D12 着色器编译器、QML/网络/SVG、
多余 SQL 驱动与图片格式插件 —— 每一项都是"删了再验"确认不需要）。

---

## 11. 已知边界与后续工作

1. **未做**：`0x22` 模式切换界面（协议预留）、`0x23` 参数掉电保存（协议规定不保存）、
   SQLite 里存逐帧数据（20 Hz × 8 通道体量不合适，逐帧留在 CSV）；
2. **回放不还原原始时间间隔**：按记录顺序循环播放；若要精确复现时间轴，可按 CSV 时间列重排（可选项）；
3. **观测模式（0xFD）不做"退出时自动关闭"**：留给操作者，避免"退出程序顺手改了车的行为"；
4. **`kTurnLeftSign` 未在真机核对**（转向环本机定稿 0，未启用）：真机若"按左转却右转"只改这一处常量；
5. **待 B 确认的三条口径偏差**见 §7 与 `C部分方案与计划.md` §十六；
6. **蓝牙链路在 Windows 上暂不通**（`host/README.md` 也说了一条，此前未收进本节）：蓝牙 SPP **能配对但建不出 COM 口**（`pybluez2` 在 Python 3.13 编译不过；本 Qt 套件**未装 Qt Bluetooth 模块**）⇒ **实际可用的只有有线链路（USART1/COMx）**，蓝牙为协议层的"同一套帧、换物理层"，演示时用**假源**或**有线**兜底；
7. **交付便携目录内没有文档**（`dist/上位机/` 12 个文件全是 exe/dll）：评阅人拿到裸目录不知怎么启动 ⇒ 交付包里应附《用户操作手册》副本或一页 `使用说明.txt`（见决策 80 的"留档"要求）。

---

> **项目归属**：中国石油大学（华东） 专业生产实习课程项目<br>
> **范围说明**：本项目不涉及 MiniBalance 控制板（STM32F405RGT6 版本）的硬件设计与改版；控制板直接沿用，A1 仅重做主底板。<br>
> **许可**：原创代码与文档采用 MIT License；第三方组件遵循各自原始许可证。
