pierrotto12138-code/balance-car-inspection-robot/docs/design_mechanical/A2_结构进展与待办.md

# A2 结构进展与待办

> 角色：**A2（结构）**　｜　更新：2026-10-17
> 本文只写结论与接口口径；模型文件在交付包内，生成方式见 [`tools/README.md`](../../tools/README.md)。

## 1. 已完成

| 项 | 结果 |
|---|---|
| 外壳（下壳 / 上壳） | 建成 **B-rep 实体**，可导出 STEP/STL 打印；下壳 110.8 × 75.8 × 12.2，上壳 110.8 × 75.8 × 38.9（内腔 36.5）|
| 装配结构 | 下壳 3 个板安装柱 + 4 个 M3 外凸耳；上壳 4 个 Φ3.4 对接孔 → 上下壳可用 **M3×35 自攻** 对拧 |
| 立墙开孔 | 9 处（电源/超声波/两路气体/蓝牙/蜂鸣器/DHT11 等），**顶高按 PCB 3D 里器件真实高度自动确定** |
| 超声波净空 | 上下壳同尺寸**口袋 20（左右）× 15（前后）** mm |
| OLED 预留 | 控制板 `J1`/`J2` 之间上半部分（板坐标 48~96 × 29~65）**不设筋**，净高 35 mm |
| 垂直空间 | 板面向上 **35 mm**（筋下）/ 板下净空 6.6 mm / 壳底到车底盘 **M3 铜柱 25 mm** / 板面到地面 69 mm |
| 整车 | 底盘 110×116×4 + 两轮 Φ67×26（**窄侧 ±X 共轴**）+ 参考电机 + 电池包络；整车包络 171.8 × 116.0 × 109.6 mm |
| 图纸 | 旧壳曾出零件图 / 爆炸图 / 装配效果图；**文件已于 2026-10-17 清理**（见 §8），新模型图纸待出 |
| 试印件 | `A2-05_孔位试印件`（110.8×75.8 底板段 + 3 安装柱 + 4 外凸耳，水密 STL 20 cm³）—— 打整壳前先验孔位 |

## 2. 关键接口（与 A1/B/C 统一口径）

- 原点 = **板左下角**，板面 **z = 0**，元件面 **+z**，单位 mm。
- 板框 **100 × 65**、R5.0、厚 1.6；安装孔 **3 × Φ3.2**，跨距 **88.00 × 52.81**（对角 102.63）。
- 板底最低器件 **5.60**（`SW2`）、板面最高器件 **13.00**（`J17`）——均取自 PCB 3D 模型，非估算。
- 第 4 安装孔位 (94.00, 58.91) 属**厂商原板 PCB1**，改板已取消；壳底留 Φ8 让位。

## 3. 相关工具

| 工具 | 用途 |
|---|---|
| [`tools/a2_shell.py`](../../tools/a2_shell.py) | 生成外壳（参数集中在文件顶部）|
| [`tools/a2_print_coupon.py`](../../tools/a2_print_coupon.py) | 孔位试印件（打整壳前验孔位/铜柱/M3 自攻，~30 min）|
| [`tools/a2_car_assembly.py`](../../tools/a2_car_assembly.py) | 整车装配与视图 |
| [`tools/a2_car_step.py`](../../tools/a2_car_step.py) | 整车导出 STEP（`--light` 轻量 / `--xcaf` 带名字装配）|
| [`tools/a2_explode.py`](../../tools/a2_explode.py) | 爆炸图 + 明细栏 |
| [`tools/mesh_tools.py`](../../tools/mesh_tools.py) | 读 STEP/STL、量尺寸、检孔位、出零件图 |
| [`tools/step_intake.py`](../../tools/step_intake.py) | 外来 STEP/IGES 体检与对照 |
| [`tools/mech_export.py`](../../tools/mech_export.py) | 从 `.epcb2` 导出机械接口坐标 |

## 4. 待办

| # | 事项 | 谁 | 状态 |
|---|---|---|---|
| 1 | 装配树核对（14 件名）+ 干涉检查 | 我 / 用户（GUI） | 🔶 **离线已核到结构层**（PRODUCT 25 / NAUO 24 / 14 个命名件）；`A2-00_外壳装配.step` 反向修正过（原本是布尔并成一个实体）。**真 CAD 侧目前无通道**（集成已卸载），干涉检查只能在 SolidWorks GUI 里手跑。本机 SW 打不开任何 STEP 的实测另见 §7 |
| 2 | 实测"板面 → 控制板顶面"→ 回填上壳内腔高 | 卡尺 | ⏳ 待做（模型里 `ctrl_board_env` 是**包络估算**，不是实测，别当数据用）|
| 3 | 上壳开窗：OLED 显示屏窗、USER 按键孔、LED 导光孔 | A2 | ⏳ 等 #2 + 人机界面测量 |
| 4 | 外观造型：圆角/倒角/分模线/防滑纹/配色 | A2 | ⏳ 用户决定自己在 SolidWorks 里做 |
| 5 | 打印试装（先打安装柱阵列验孔位，再打整壳）| A2 | 🔶 **试印件已出**：`A2-05_孔位试印件.step/.stl`（20 cm³ / 约 30 min，含 3 安装柱 + 4 外凸耳 + 内腔轮廓），`tools/a2_print_coupon.py` 可重出；**待打印 + 拿铜柱/M3 自攻实测** |
| 6 | 总装图（三视图 + 轮距/离地间隙/总高 + 明细栏）| 我 | ⏳ 出图链路仍是 `tools/mesh_tools.py drawing`；SW 侧 `drawing_workflow` 随集成一起下线 |
| 7 | A2 交付物按任务书命名规则整理打包 | 我 | 🔶 **三维模型已按 A1 口径命名并入库存档**（2026-10-17，见 §8）；工程图/装配图/说明/打印记录仍缺 |

## 5. SolidWorks 集成现状：**已卸载**（2026-10-17）

原先挂的 `dsh-solidworks`（第三方 SolidWorks × DSH 桥）**当天就卸掉了** —— 用户判断它不符合 DSH 插件规范
（peer 依赖锁在 `dsh-tools ^0.1.0-rc.6`，本机运行时是 `0.2.0-rc.2`，预设层整块用不上），
计划按规范重做。**不要再照旧记录里的方式启动它**。

- 卸载范围：`~/.dsh/profiles/solidworks`、`~/.dsh/plugins/solidworks-policy`、`~/.dsh/.agent-presets/solidworks-cad`、
  `~/.dsh/profiles/desktop/node_modules/dsh-solidworks`、`…\260921Task_私有资料\_tools\dsh-solidworks`（96.6 MB）；
  桌面与 web 两个 profile 里的 MCP 行**已撤掉**，YAML 已复核。
- 留下来的只有**小配置归档**（0.2 MB）：`…\_tools\_归档_dsh-solidworks_集成配置_20261017\`，
  与那份安装记录（`…\正式作业提交\_A2审阅\SW集成_安装记录.md`，含当时的 5 个坑与自证方法），**重做时直接照它避坑**。
- 因此 A2 现在**没有**"在真 CAD 里点一下"的通道；能用的是本仓库 `tools/`（OCC 内核）+ 人手在 SolidWorks GUI 里操作。

> 判据纪律（沿用全仓库口径）：`工具调用成功 ≠ 尺寸/拓扑已验证`；没做过的检查写"未做"。

## 6. 已知约束

- 任务书要求 **SolidWorks/Keil** 类环境；本项目 A2 侧用**离线几何内核（OpenCASCADE）+ 任何 CAD 可打开的标准 STEP**，属**工具偏差**，需在结构设计说明里写清。
- 外壳为**功能性起点模型**：外形、开窗、电池仓尚需按实测与人机界面需求补齐。

## 7. 2026-10-17 实测：两处"名不副实"，已修

> 注：本节所述 `A2-00_外壳装配.step` 等旧壳文件已于 2026-10-17 随旧壳目录一并删除，仅保留结论与判据。

| 缺陷 | 证据 | 修法 |
|---|---|---|
| **"装配"STEP 没有装配树** | `A2-10_整车_装配_轻量.step` 里 `NEXT_ASSEMBLY_USAGE_OCCURRENCE` = **0**（14 个 PRODUCT 各自独立）；根因是 `AddShape(shape, False)` 只加"自由件" | 新增 [`tools/step_assembly.py`](../../tools/step_assembly.py)：复合体 → `makeAssembly=True` → 逐组件 `GetReferredShape` 命名。修后 **PRODUCT 25 / NAUO 24**（14 个命名件，电机各 5 个子实体）|
| **`A2-00_外壳装配.step` 其实是 1 个实体** | 旧版 `fuse(下壳, 上壳)`，文件里 `MANIFOLD_SOLID_BREP` = 1（"2 实体"是错的）| 改写成真装配：**PRODUCT 3 / NAUO 2 / 实体 2**（`shell_assembly` → `lower_shell` + `upper_shell`）|

**顺带定下的判据**：`STEPControl_Writer.Write()` 返回 `RetDone` 只说明**文件写完了**，
不说明结构对 ⇒ 一律再按文本数 `PRODUCT(` / `NAUO` / `MANIFOLD_SOLID_BREP`，
断言"PRODUCT = 件数+1、NAUO = 件数"（`step_assembly.describe()`）。

**★ 2026-10-17 更正（此前的"SW 打不开 STEP"结论是错的）**：
`errors=2097152`（本机类型库确认 = `swFileRequiresRepairError`）**只出现在自动化调用**（`ISldWorks::OpenDoc6` 开外来格式）时；
**GUI 里双击/文件→打开完全正常**。实测：

| 文件 | 双击后的结果 |
|---|---|
| `A2-00_外壳装配.step` | 打开为**装配**（`.step.SLDASM`），组件 **2** 个：`upper_shell` + `lower_shell` ✅ |
| `A2-10_整车_装配_轻量.step` | 打开为**装配**，**14 个命名件**（`lower_shell`/`upper_shell`/`pcb_board_outline`/`ctrl_board_env`/`battery_pack`/`chassis_plate`/`wheel_1..2`/`motor_1..2`/`standoff_1..4`）+ 电机下 10 个子实体 ✅ |
| 40×30×10 长方体 STEP（对照）| 双击能开；**自动化**一律 2097152（连 SW 自己导出的 STEP 也一样）|

原因：SW 2026 对外来格式走 **3D Interconnect**，生成 `xxx.step.SLDPRT/.SLDASM` 的**链接**文档；
这条路只有 GUI/内部路径走得通，`OpenDoc6` 返回"需要修复"。

> ⚠️ **链接态的坑**：这种文档**依赖原 STEP**，且在 SW 里只能做配合/移动、不能特征编辑。
> 要编辑或交付，先在装配树**根节点右键 → 断开链接**（转成普通 `.SLDASM`/`.SLDPRT`）。

## 8. 2026-10-17 晚：SolidWorks 整车装配归档

A2 在 SolidWorks 里完成的整车装配已按 A1 命名口径归档，**两处逐字节一致**（19/19 文件 SHA-256 校验）：

| 位置 | 用途 |
|---|---|
| [`hardware/mechanical/A2-10_整车装配_20261017/`](../../hardware/mechanical/A2-10_整车装配_20261017/README.md) | 仓库留存（全套：SLDASM + 16 个零件 + 零件版 + STEP，约 174 MiB）|
| `…\260921Task_私有资料\正式作业提交\…\A2_结构\01_三维模型\` | 作业提交（同一套 + 交付清单）|

| 交付名 | 原名 |
|---|---|
| `A2-10_整车装配_A2_v1.0_20261017.SLDASM` | `装配体2.SLDASM` |
| `A2-10_整车装配_零件版_A2_v1.0_20261017.SLDPRT` | `1\车.SLDPRT`（装配体另存为的零件）|
| `A2-10_整车装配_A2_v1.0_20261017.step` | `1\装配体2.STEP` |

**核实**（读 STEP 文本）：**15 PRODUCT / 20 NAUO / 247 实体**，14 个命名件；包围盒 **203.31 × 130.76 × 128.33 mm**（整车级，非仅上下壳）。
**注意**：旧 OCC 程序壳（`_A2审阅\外壳起点件\` 及备份）已于 2026-10-17 删除；本模型与它不是同一套几何，旧图纸不能混用。
**仍缺**：本模型的工程图、总装图/爆炸图/明细栏、效果图、人机界面 §7 十二项、STL 与打印记录、结构设计说明
（清单见归档目录 [`00_A2_交付物清单（对照任务书）.md`](../../hardware/mechanical/A2-10_整车装配_20261017/00_A2_交付物清单（对照任务书）.md)）。

### 8.1 已补：STEP 离线渲染（2026-10-17 晚）

本机 **SolidWorks 2026 在 17:11 / 17:18 两次 `AppHangB1` 挂起**（事件日志可查），COM 通道不可用；
改用 **OpenCASCADE + PyVista/VTK** 直接从 STEP 出图，不依赖 SolidWorks：

| 项 | 结果 |
|---|---|
| 读取/细分 | `STEPControl_Reader` 9–70 s（冷/热）→ `BRepMesh` 10 s → **253 实体 / 185,785 三角面** |
| 包围盒 | **181.0 × 134.5 × 90.5 mm**（X × Y × Z，网格顶点实测）|
| 产物 | `硬件/mechanical/A2-10_整车装配_20261017/渲染/` 四张：等轴测、背面等轴测、四视图初稿、透明底 |
| 原色视图 | 用 A2 提供的 5 张 SolidWorks 截图（正面/背面/左/右/俯视，含尺寸箭头与注记）+ 等轴测拼成**六视图**；按 A2 同意已放进公开仓库 `渲染/`（图内无姓名，含校名/组号/注记）|
| 导出 | 整机单网格 STL **8.86 MB**（185,785 面）+ 253 实体索引 CSV + 9 个候选分件 STL（8/9 水密；151=MiniBalance R1 通用车架、252=箱体候选）|
| 明细栏 | `A2_明细栏_整车_草表_20261017.csv`：14 个 STEP 件 + 2 个备用件；材料/实际颗数待核 |
| 装配图 | `图纸/A2-10_整车_装配图_理论设计_20261017.pdf`（A3：原色四视图 + 明细栏草表 + 标题栏 + 说明，1.54 MB）|
| 间隙/干涉 | `检查/A2_间隙干涉检查_20261017.md/.csv`：11 对关键件，**无穿透**；轮↔架 4.00 mm、PCB↔箱体 0 mm/712.94 mm³（共面）、模块 246↔箱体 0.69 mm 偏紧 |
| 爆炸示意 | `渲染/A2-10_整车_爆炸示意图_20261017.png`：仅箱体 +Z 220 mm，其余件保持装配位置；完整自动分层因 STEP 丢件名不可靠 |
| 说明文档 | [`A2_结构设计说明_初稿.md`](A2_结构设计说明_初稿.md)：尺寸/布局/接口/材料/验证/遗留，未实测项标 `[待确认]` |
| 工具 | 仓库外 venv `…\_tools\venv_render`（cadquery-ocp / pyvista / vtk / pillow / trimesh / reportlab）|
| 边界 | **几何着色**，不含外观造型/材质/配色；装配图无尺寸驱动/公差/孔表，不能替代正式工程图；整机 STL 不能直接分件打印 |

### 8.2 A2 确认的决定（2026-10-17 晚，覆盖此前假设）

| # | 事项 | 决定 |
|---|---|---|
| 1 | **上下壳** | **缺失**，不补；当前 STEP 只有 **MiniBalance R1 通用车架** + 电控 + 轮组；截图中的透明外壳是参考件 |
| 2 | 人机开孔 | **不逐项测量**，统一按"在对应位置开框"；`人机界面设计说明.md §7` 已按此改写 |
| 3 | 车架 | **MiniBalance R1 通用车架**（候选实体 151）|
| 4 | 实物/打印 | **仅理论设计**，不要求打印/试装/实物照片 |
| 5 | SW 工程图 | **不要求** `.SLDDRW`；用装配图 PDF 初稿 + 原色六视图替代 |

> **影响**：此前的"下壳/上盖 110.8×75.8…""3D 打印件"等旧口径**不再适用**；正式零件图、壁厚、开孔尺寸均随上下壳缺失而暂不出。

---

> **项目归属**：中国石油大学（华东） 专业生产实习课程项目<br>
> **范围说明**：本项目不涉及 MiniBalance 控制板（STM32F405RGT6 版本）的硬件设计与改版；控制板直接沿用，A1 仅重做主底板。<br>
> **许可**：原创代码与文档采用 MIT License；第三方组件遵循各自原始许可证。
