pierrotto12138-code/balance-car-inspection-robot/hardware/eda_export_20261016/Info_PCB_PCB2_2026-10-16.txt

工程标题: 		26测控系统设计
板子标题: 		改
PCB 标题: 		PCB2
时间: 		2026-10-16 16:40:50

板子尺寸: 		100mm x 65mm
板子面积: 		...
铜箔面积: 		顶层 ... 利用率 ...
露铜面积: 		总计 ... 利用率 ...
层: 		总计 22, 铜箔层 2

器件: 		27
封装: 		20
元件: 		总计 52,顶层 52,底层 0
焊盘: 		总计 221, 顶面表贴 106,底面表贴 0,金属化孔 115, 非金属化孔 0
网络: 		总计 65, 未布线 0
测试点: 		网络总数 65, 有测试点的网络 0, 测试点覆盖率 0%
 		总计 0, 顶面测试点 0, 底面测试点 0

挖槽区域: 		0
过孔: 		总计 76, 通孔 76, 盲埋孔 0
铺铜区域: 		2
导线长度: 		2035.904mm
