pierrotto12138-code/balance-car-inspection-robot/docs/决策记录.md

# 决策记录

> 记录本项目已定型的决策，避免反复确认或走回头路。
> **当前进展**：阶段三（底板重做）已完工、已打样、**已焊好**；**B 部分固件已收工（真机稳定平衡）**；
> **C 侧上位机 P0~P5 全部完成（C 部分收工）**，真机联调 + 现场反馈修正已收尾
> （决策 58~59、65~70、73~79）。
> 见 [`design_firmware/程序说明文档.md`](design_firmware/程序说明文档.md)、
> [`design_firmware/B阶段开工准备.md`](design_firmware/B阶段开工准备.md)、
> [`handoff/给C侧_固件接口与判读口径.md`](handoff/给C侧_固件接口与判读口径.md) 与
> [`design_firmware/真机联调问题清单.md`](design_firmware/真机联调问题清单.md)（决策 **1~79**）。
> 更新日期：2026-10-15
>
> 📌 **完整背景与现状见** → [`handoff/交接说明.md`](handoff/交接说明.md)

---

## 〇、方案演进简史（避免重走弯路）

| 阶段 | 方案 | 结果 | 归档 |
|---|---|---|---|
| **一** | 以学校采购的 **MiniBalance V5.0 高配版**（F405RGT6）为基线改造 | 完成车体/引脚核对、协议、上位机 | `归档_阶段一_MiniBalance方案_20260923.zip` |
| **二** | 教师同意"从头再做"，改用**开源方案** `snqx-lqh/Stm32BalanceCar` | 完成基底评估、MQ 算法调研、上位机协议层 | `归档_阶段二_开源方案_20260923.zip` |
| **三（当前）** | 回归 MiniBalance：**保留控制板与拓展板，只重做底板**，并集成电源等小功能 | 进行中 | — |

> **为什么是阶段三这个方案**：经与指导教师及进度较快的同学讨论——
> 底板恰好是"**全是插座和走线、最容易画对**"的那块，而控制板（含板载 IMU）与
> TB6612/电压检测等模块都是已验证的现成品。**A1 有真实的 PCB 设计工作，风险又可控。**

---

## 一、技术基线（阶段三）

| # | 决策 | 依据 |
|---|---|---|
| 1 | **平台 = 学校采购的 MiniBalance V5.0 高配版** | 实物在手 |
| 2 | **主控 = STM32F405RGT6 控制板，保留不动** | 板载 MPU6050、CH340G、LAMS1117；与 F103RC pin-to-pin 兼容 |
| 3 | **拓展板保留**：TB6612 电机驱动、电压测量模块 | 已验证可用；仅"电源变压模块"改为集成到底板 |
| 4 | **★ 重做底板**：保留全部插座分布与 60 针接口，并把电源降压等小功能集成其上 | 教师与同学建议；A1 的 PCB 交付物 |
| 5 | **车架 / 电机 / 电池沿用原车** | 组员实测：**尺寸完全匹配** |
| 6 | **姿态算法 = 卡尔曼滤波** | 厂商默认 + 实车确认 + 实测最佳 |
| 7 | **引脚依据 = 源码为主，实物丝印为校验** | 原理图 PDF（2020 版）与源码（2016 版）版本不一致，已实测到差异 |

> **已三方互证**：源码、底板丝印、控制板丝印在 MPU6050（PB10/PB11/PB15）、LED（PB13）、
> 按键（PB14）、编码器、电机驱动、蓝牙等项上**逐项吻合**。引脚表可信。

---

## 二、固件与系统架构

| # | 决策 | 说明 |
|---|---|---|
| 8 | **架构 = 混合式**：平衡控制保留在 MPU6050 中断（5ms/10ms 节拍不变），气体采集/通信/任务状态机/界面进 FreeRTOS 任务 | 不拿已调好的平衡时序冒险；详见 `docs/design_firmware/architecture.md` |
| 9 | **FreeRTOS 源码从官方仓库获取** | 基底是裸机，需自行引入 |
| 10 | **通信协议 = 自研**：`0xAA55 + 命令字 + 长度 + CRC-16/MODBUS` | 详见 `docs/protocol/communication_protocol.md`；厂商 DataScope 协议留作调试通道 |
| 11 | **物理链路 = 经典蓝牙 SPP，115200 8N1** | 蓝牙座已板载（PA2/PA3 = USART2）；基站代码原为 9600，需实测能否改 |
| 12 | **上位机 = Qt 6 C++ + CMake** | 协议层已完成并通过 **13 项单元测试** |
| 34 | ★ **B 的构建形态 = `arm-none-eabi-gcc`（如 CubeCLT 自带的 14.3）+ Makefile**，**产物必须含 `.hex`**（用户习惯用 `FlyMcu` 串口 ISP 烧录）；**Keil 工程暂不考虑**（2026-10-09 用户明确"先不用考虑 Keil 交付"） | 本项目不使用 Keil，而已实测上方工具链可构建 F405 镜像并出 hex；烧录走**控制板板载 CH340G**（DTR/RTS 自动 ISP，串口接 USART1 = PA9/PA10），厂商资料自带 `FlyMcu` + `Minibalance.hex`，即原厂流程。详见 [`design_firmware/B阶段开工准备.md`](design_firmware/B阶段开工准备.md) |
| 35 | **FreeRTOS 内核 = 官方 `FreeRTOS-Kernel` V11.1.0，源码 vendor 进 `firmware/Middlewares/FreeRTOS/`** | MIT 许可；已实测 clone 成功、`portable/GCC/ARM_CM4F` + `heap_4` 全部编译通过；入库后可离线复现、交付物自洽 |
| 36 | ★ **协议冻结方式 = 共享测试向量文件**：[`protocol/test_vectors.json`](protocol/test_vectors.json)（+ `.tsv`）。B/C 各自实现后必须**逐条复现**；生成器 = `tools/fw_prep/gen_test_vectors.py`（Python 独立实现），并用 `tools/fw_prep/host_crosscheck.cpp` 拿 **C 侧真实代码**复算 | 把协议 §七 的"双方各自实现 CRC 交叉验证"从口头约定变成**可复跑产物**；本轮已发现协议 `0x11` 长度写错（11 → **9**） |
| 37 | ★ **中断优先级策略**：`main.c` 改 `NVIC_PriorityGroup_4`；**MPU6050 控制中断（EXTI15_10）不调用任何 FreeRTOS API**，其抢占优先级数值必须 **< `configLIBRARY_MAX_SYSCALL_INTERRUPT_PRIORITY`(=5)**；需要调 RTOS API 的中断（如串口）优先级数值 **≥ 5** | 混合式架构的生命线：既让控制节拍绝不被调度器延迟，又让通信中断能安全使用 `...FromISR()` API。详见 `firmware/User/FreeRTOSConfig.h` 顶部注释（P4 落地） |
| 38 | ★ **协议层模块设计**：`firmware/App/Comms/{crc16,protocol,ringbuf}` **只依赖 `<stdint.h>`**（不含任何 ST 头文件）；解帧器的**时间基由调用方注入**（`Proto_Feed(..., nowMs, ...)`）；解码结果用**回调投递**，不用动态内存 | 这样同一份代码能在 PC 上原生编译并跑单元测试（`tools/fw_prep/run_proto_test.py`，97 条断言），协议这种"错一字节就联调三天"的模块必须能离线回归；中断与任务的分工用 **SPSC 环形缓冲**（`ringbuf.c`，满时丢新字节并计数）衔接 |
| 39 | ★ **温湿度补偿用"除法"（`ratio_corr = ratio / factor`），不用 MQUnifiedsensor 的"叠加"，且默认关闭** | 两套开源用法用的是**同一个公式**：`factor = 0.00035t² − 0.02718t + 1.39538 − (h−33)·0.0018`，在参考点（≈19.4 ℃/33 %RH）≈ **1.0**。按"叠加"用等于凭空给 ratio 加 1.0（MQ-135 清洁空气才 3.6 → +28%），物理上讲不通；按"除法"用则参考条件不修正、偏离才修正。该系数来源本身存疑（GeorgK 源码自带 TODO），故**默认关闭**，由 0x23 的"补偿使能"控制，开启前必须实测复核并在报告注明 |
| 40 | ★ **ppm 只作估计值，且 `ppm×10` 上报前必须饱和钳位到 uint16 上限**；系数默认 MQ-2 = LPG（a=574.25, b=−2.222）、MQ-135 = NH4（a=102.2, b=−2.473） | ① 决策 18 已定"主链路用 Rs/R0，ppm 作展示"；② `ppm = a·ratio^b` 是幂律，ratio 很小时 ppm 可达千万级，**不钳位会回绕成小数字 —— 恰好把危险工况报成"浓度很低"**（已单测：1e6 → 65535）；③ 系数取自 MQUnifiedsensor 的 datasheet 曲线拟合，换目标气体只改这两个常数（MQ-135 若看 CO2 则 a=110.47, b=−2.862） |
| 41 | ★ **安全停车策略**：① 只在**曾收到过下行帧**之后才启用"500 ms 失联"判定（否则上电即停车）；② 安全停车**锁存**，链路恢复**不自动起步**，必须由 0x21 任务或 0x20 使能显式解除；③ 急停（0x2F）与硬件故障（低电压/倾角）走**同一条**停车通道，且急停**不能**被 0x20 解除（只有重下任务）；④ DHT 读不到**不阻塞任务**，只置"传感器失效"标志并自动停用温湿度补偿 | 仓库场景里"信号一抖车就自己冲出去"不可接受；一条停车通道比多条更好验证；单传感器故障不该让整个巡检任务瘫痪。已在 `firmware/tests/patrol_test.c` 里逐条脚本化验证（含"每 400 ms 有下行帧则永不误判"）|
| 42 | ★ **混合式架构的运行时策略**：① **两个中断（EXTI15_10 优先级 1、USART2 优先级 0）都不调用任何 FreeRTOS API**（含 `...FromISR`）——它们优先级高于 `configLIBRARY_MAX_SYSCALL_INTERRUPT_PRIORITY(5)`，中断里只做"塞字节进环形缓冲"；② 任务与中断之间只有两条通道：**SPSC 环形缓冲**（串口）与**短临界区读全局量**（仅用于上报/显示）；③ `delay_us/xms` 改 **DWT CYCCNT**（把 SysTick 让给内核），`delay_ms` 在调度器运行时用 `vTaskDelay`；④ `NVIC_PriorityGroup_2 → Group_4`；⑤ 串口发送（协议帧 + `printf`）用**互斥量**；⑥ **不需要 I2C 互斥量**——实板核实 OLED 是软件 SPI（PC0/13/14/15）、MPU6050 是软件 I2C（PB10/11），**不共总线**（`architecture.md` §3.3 的旧结论已改写） | 控制节拍是平衡车的命脉：它是**唯一不允许被调度器延迟**的东西；把 ISR 优先级保持原样 + 禁止 ISR 调 RTOS API，就能做到"加了 RTOS 但控制时序一字不改"。ISR 是否违规由 `tools/fw_prep/check_isr_safety.py` **静态核验**（编译器不会报，上板才炸）|
| 43 | ★ **ADC 拆通道**：`ADC1 → PB1`（电池，控制中断专用，保持厂商原样）；`ADC2 → PA5/PA6`（MQ-2 / MQ-135，GasTask 专用） | 厂商的 `Get_battery_volt()` 在控制中断里每次重设 ADC1 通道并软件触发；若任务也用 ADC1，两者会互相打断（中断改通道 → 任务读到别的通道；"等 EOC"标志被对方吃掉）。**任务侧临界区挡不住高优先级中断**，所以只能物理分开。PA5/PA6 同时挂在 `ADC12_IN5/IN6`，硬件上本来就能这么分 |
| 44 | ★ **转向环增益全局化**：`turn()` 里的局部常量 `Kp=52`、`Kd=0.5`（仅前后运动时取）改为全局 `Turn_Kp=52`、`Turn_Kd=0.5` 并定义在 `main.c`，供协议 0x24 在线调参 | 协议 §4.2 把 0x06/0x07 定义为 `Turn_Kp/Turn_Kd`，但厂商基线里它们是**局部常量**、根本无法调。改为全局且**默认值与原常量逐位相同** → 未调参时控制行为与基线完全一致（这一点必须在到货实测时确认，见开工准备 §14.6）|
| 45 | ★ **USART1 = 有线调试链路**（115200 8N1，与蓝牙**同协议、对等**）：收到帧就处理、回复**原路返回**；**周期上报与事件告警两条链路都发**；USART1 的 RX 中断在 RTOS 模式下启用，同样**只把字节推进环形缓冲**（不调 RTOS API） | 实验室调试与 PID 整定需要一条**不受蓝牙配对/干扰影响**的稳定链路；两条链路共用一套协议，避免出现"第二套协议"的维护负担。裸机模式下 USART1 仍留给厂商 DataScope（只发不收，中断不启用）|
| 46 | ★ **调参接口与持久化**：`0x24` 增加 4 个扩展参数 ID —— `0xFF` 全量回读（回 7 条）、`0x00` 存 Flash、`0xFE` 重新载入、`0xFD` 调参观测模式（开启后**有线链路 100 Hz** 上报 0x10/0x11）；参数以 **float 位型** 存于扇区 6（`0x08040000`），带 magic + 个数 + **数值合理性校验**，写入后**当场回读校验**；打包逻辑独立成 `param_pack.c` 并**原生单测 24 条** | ① **帧格式不变**（仍 N=6），只是"参数 ID"取值扩展 → 对 C 兼容、风险最低；② 100 Hz 观测是把 PID 调好的前提（20 Hz 看不出超调与振荡）；③ "存了却读不回来"极难查，所以把打包/校验拆出来离线验证；④ 不复用厂商 `0x08020000` 的存储区，避免互相擦除 |

---

## 三、传感器与硬件接入

| # | 决策 | 说明 |
|---|---|---|
| 13 | **气体传感器 = MQ-2 + MQ-135**（双通道交叉验证） | 模拟输出 AO 接 ADC |
| 14 | **每路 MQ 必须加分压**（推荐 10kΩ/15kΩ） | MQ 在 5V 下 AO 可达 5V，而 STM32 ADC 上限 3.3V，**直连会击穿引脚** |
| 15 | **MQ 加热丝需 5V 独立供电 + 去耦** | 约 150mA/路；就近加 100µF + 0.1µF |
| 16 | **MQ 需通电老化 24–48h** | 已在通电老化中 |
| 17 | **ppm 换算参考 `MQUnifiedsensor`**：`ppm = a·(Rs/R0)^b` | 参数已逐行核实，见 `docs/research/MQ气体传感器开源实现.md` |
| 18 | ★ **主链路用 Rs/R0 相对量做交叉验证，ppm 作"估计值"展示** | 绝对浓度精度不可靠；泄漏定位需要的是**灵敏度 + 相对比较** |
| 25 | ★ **红外避障 L 从 PA4 改接 PB12** | **PA4 不是 5V 容忍脚**（`TC`），而红外模块 OUT 在 5V 供电下输出约 5V → **直连会击穿**。`PB12` 是 `FT`（5V 容忍）|
| 26 | ★ **蜂鸣器 = 有源模块 + `PC5` 直连**（新增 `J18`） | 实测是**有源**（自带振荡）、**低电平触发**、**5V**。`PC5` 是 5V 容忍，可直连模块 I/O；**不用 `Q1/R7/R8/BZ1`**。固件极性：**低电平响** |
| 27 | ★ **8 个模块座全部"按模块丝印"重排引脚顺序** | 复制粘贴会带过来原板旧序；逐座核对模块丝印后发现有 8 处会导致 **5V 直灌 3.3V 脚 / 反极 / TRIG·ECHO 反接**。直插不改线 = 会烧 |
| 28 | ★ **新增阻容统一 0805**（原板 0603） | 手焊友好。实测引脚几何：0603 电阻垂直 30 间距 / 0805 水平 40 —— **替换器件会弄断导线**，所以换封装只能靠"属性面板改封装"，不能"替换器件" |
| 29 | ★ **电机功率走 `+12V`，不走 `+5V`** | 实测 `U1`(TB6612) 的 `VM1/VM2/VM3` 全接 `+12V`，只有 `VCC/STBY` 接 `+5V`。**所以 `L1` 那个"33µH 5A"是过设计**，5V 那路只有 MCU+传感器约 0.5A |
| 30 | ★ **红外避障两个座（`J11`/`J14`）保留焊盘、不焊排针（DNP）** | A1 只买了 1 个红外模块，且判断**超声波避障已足够**。但：① **任务书里"HC-SR04 **与红外模块**负责避障与循迹"是明确写了的**（有合规风险）；② **删掉容易、加回来贵** —— PCB 阶段删了以后要用，就得改原理图 + 重画 PCB + 重新打板。故**保留两个 3 脚座与走线，不装排针**。**零成本、可逆、任务书也对得上**。`PB12`/`PC1` 两个 IO 因此空闲 |
| 31 | ★ **`J15`（5V/GND 取电排）保留，可先不焊** | 它是给外挂模块就近取电用的便利排，不是信号座。焊上更方便调试，不焊也不影响功能 |
| 32 | ★★ **电机接口 `CN1`/`CN2` 的 pin2/pin5 对调**（`+5V` ⇄ `GND`） | **A1 读实物 MiniBalance 丝印发现**：实物是 `AO1 / **G / PB6 / PB7 / 5V** / AO2`，而**原板（上届学生）的 `J3`/`J4` 是 `MA_OUT1 / **+5V / PB6 / PB7 / GND** / MA_OUT2`** —— **pin2 与 pin5 是反的**。改板此前 1:1 照抄了原板，**照这个座插电机会把编码器的 `G` 接到 `+5V`、`5V` 接到 `GND` → 反极，霍尔编码器很可能烧毁**。<br>**已按实物修正**：`CN1 = MA_OUT1 / GND / PB6 / PB7 / +5V / MA_OUT2`、`CN2 = MB_OUT1 / GND / PA0 / PA1 / +5V / MB_OUT2`（`C9`/`C11` 的去耦仍留在 `+5V`）。<br>**教训**：**座序必须对着实物丝印核，不能只信上届工程的网络表** —— 原板 PCB 丝印里只有 `PB6`/`PB7` 两个文字，从工程文件里看不出它与实物不一致 |
| 33 | **给 5 条无名网络补上网络名**（消除 DRC 的 `Netlist Error`）| 原理图里有 5 条网络**本来就没名字**（PCB 上被 EDA 自动命名为 `$1Nxxx`），EDA 因此报 1 个 `Netlist Error`。**电气上完全正确**，但为了 DRC 干净、也为了可读性，补名如下：<br>`SW_NODE`（`D1.2`/`L1.1`/`U2.2`，开关节点）、`VIN_SW`（`J17.1`/`SW2.1`）、`LED_3V3`（`D2.1`/`R1.1`）、`LED_5V`（`D4.1`/`R5.1`）、`LED_12V`（`D3.1`/`R4.1`）<br>**做法**：`sch_PrimitiveAttribute.createNetLabel(x, y, net)`，**每条只建一次**（该 API 成功时也返回 `undefined`，建完必须回读 `getAll()` 确认条数）|

| 47 | ★ **安全停车必须真正作用到电机**：`Patrol_MotorsDisabled()` 的结果写入 `volatile u8 App_MotorDisable`（TaskTask 写、控制中断读），中断每拍据此**强制** `Flag_Stop=1`；并**挡住两条绕过锁存的厂商逻辑**——① 单击启停（锁存期间按键无效）、② `Put_Down()` 放下自动使能；显式使能（0x21 任务=巡航 或 0x20 使能=1）解除锁存时**同时**重新使能电机；急停 0x2F 立即置位不等任务周期 | 复查发现：状态机逻辑虽经 67 条断言验证，但 `MotorsDisabled()` 的返回值**没有任何地方使用** —— 500 ms 失联时锁存置位而**电机照转**，安全功能形同虚设。教训：**"算出该停车"与"真的停车"是两件事，必须各自验证**（已补进 AGENTS 铁律 29）|
| 48 | ★ **USER 按键：双击切 OLED 页**（页 0 厂商界面 / 页 1 环境与气体 / 页 2 巡检与通信）；单击启停、长按普通-避障**保持厂商原语义**；页数据全部经 `app_api.h` 只读接口，显示与业务解耦 | 现在只有厂商那几屏，演示时"看不到气体浓度与巡检阶段"。选双击的原因：原本它切 `Flag_Show`（APP ↔ DataScope），而 RTOS 模式下 USART1 已改作有线协议链路、不再使用 DataScope → **该手势在本模式下已无用途**，拿来切页既不新增手势也不与厂商功能冲突 |

| 49 | ★ **巡检点判据 = 编码器里程**（不依赖红外）：控制中断每 10 ms 把 `Encoder_Left/Right`（本拍增量）累进 `odom.c` 的整数里程（µm 累积、左右取平均）；`TaskTask` 每 100 ms 取 `Odom_WaypointReached()` 作为 `PatrolInput.waypointReached`；间距由 `CFG_WAYPOINT_SPACING_MM` 配置（**当前 0 = 未启用**）| 底板红外 `J11/J14` 是 **DNP 未焊排针**，拿不到器件；而编码器每 10 ms 都更新，用它做里程**不需要额外硬件**。里程计写成**只依赖 `<stdint.h>` 的纯整数模块**（标定系数由外部注入），因此在 PC 上有 9 条断言覆盖"只报一次到位/自动进下一段/单轮打滑/Reset"——`waypointReached` 以前是硬写死的 0，属于"看似有接口、其实没实现"的假接口 |
| 50 | ★ **阈值/预热/驻留取值与依据**：告警阈值 MQ-2 **30.0 ppm**、MQ-135 **50.0 ppm**（≈ 清洁空气本底 3.6 / 4.3 ppm 的 8~12 倍）；预热 **120 s**（老化已由用户完成，只需热平衡 + 标定 4 倍余量）；异常驻留 **10 s**（5 Hz×10 s = 50 样本，够判趋势又不拖慢巡检）| 阈值不能拍脑袋：先由 `ppm = a·ratio^b` 反推清洁空气本底，再按"本底的 8~12 倍"取值（太低会被香烟/清洁剂误报，太高会漏早期泄漏），并把这段推导**写进代码注释**（`app_config.h` §四）与本文档。预热/驻留的取值理由同样写进注释 —— 参数要能被后人质问"为什么是这个数" |

| 51 | ★ **跨文档一致性修正（9 项）**：① 新增阻容与 LED 的封装**统一按实测 0805**（`焊接调试手册`/`改板规格书` 原写 0603 → **照它备料会拿错件**）；② 蜂鸣器**终态 = `J18` + 有源模块 `PC5` 直连**（`BZ1`/`Q1`/`R6`/`R7`/`R8` 已删除），修订 `模块功能与原理说明` §五、`交接说明` 的"底板已有 BZ1+Q1"、`完善计划` 的风险表；③ 板框口径：**往届原板 87.8×63.2 mm** vs **本板 ≈100×60 mm**（A2 必须按本板）—— ⚠ **本条的"100×60"已在 2026-10-16 更正为 100.00 × 65.00 mm（R5.0 / 3 个 ⌀3.2 安装孔），见决策 81**；④ 网络数 65/60/61 三种说法并存 → **以原理图实测口径为准并标注方法**；⑤ `J1`/`J2` 位号命名与两张 30 针表头互换 → **核对时认网络名，不认位号名** | 交付文档之间互相矛盾 = 让人照错的做。这 9 项是《电路设计说明文档》统稿时**从完工快照独立解析**发现的（不是读文档猜的）：封装/极性看 `BOM表.md` 实测、蜂鸣器看位号表里有没有 `BZ1/Q1`、板框看 PCB 几何包络。凡"历史方案稿"与"终态"并存时，**以完工快照为准**，并在正文写清"曾经是什么、为什么改" |

| 52 | ★ **代码质量一轮整改（依据一次通读复查）**：① 让 4 个 getter **兑现** `app_api.h` 的"自带短临界区"承诺（`App_GetGas/GetPatrol/GetDiag` 补临界区）；② 消除重复实现 —— 0x14 载荷统一由 `SensorReport_FillEnvGas()` 算、`App_GetGas()` 复用它；③ 修**假校验**：`ParamStore_Save()` 原先只 `Unpack` 从不比对 → 新增 `ParamPack_Equal()` 逐字段比对 + 5 条断言；④ 周期/超时魔数收进 `app_config.h`；⑤ 去掉重复 `extern`（厂商全局量统一由 `sys.h` 声明）、修 `0.4`→`0.4f` 窄化、清未用 include；⑥ 新增 **`make strict`**（严格告警，厂商头 `-isystem` 屏蔽 → 自研 18 个文件 **0 条**）与 [`编码规范.md`](design_firmware/编码规范.md) | 复查报告的结论是：**"优雅"的差距不在排版，而在"同一件事只有一个真相、一个出口"**。其中最刺眼的一条是③ —— 它与我刚写进 AGENTS 的**铁律 29**（"看起来验证了、其实没有"）**完全同型**，说明这个错误模式在本项目会反复出现，所以把"校验必须真的比对"写进了编码规范 |
| 53 | ★ **结构整改（P2：依赖单向 + 单一出口）**：① **打破 `delay.c → App` 反向依赖** —— `System/delay` 新增 `Delay_SetMsHook()` 回调钩子，由 `App_Start()` 在 `vTaskStartScheduler()` 前一行注入（钩子非 0 ⟺ 调度器已启动，所以启动阶段仍是忙等，行为不变）；删掉 `App_SchedulerRunning()`/`App_DelayMs()`。② **App 层访问厂商全局量收敛为唯一出口** —— 新增 `App/Board/board_state.{h,c}`（`Board_ReadRaw()` 取一致快照、`Board_Read/WriteVendorStop()`、`Board_Sync/CapturePidParams()`），`app_tasks.c` / `param_store.c` 不再直接读厂商量，App 层**零 `extern`**。③ **统一"使能真相"**：`App_MotorDisable`（任务侧锁存）是唯一权威，厂商 `Flag_Stop` 只是执行器，只有 `control.c`（中断）与 `board_state.c` 两处碰它。④ 删除真死代码 `ParamStore_Current()`、`Buzzer_IsOn()` 与蜂鸣器影子状态 `s_on` | 通读复查发现的三处"结构病"：**底层反向回调上层**（`delay.c` 里 `extern App_...`）、**同一个全局量在 N 个文件里各自声明/各自读**、**一个"使能"有两个真相**。三者都会在"换板/换人/改动漏一处"时爆雷。整改后依赖严格单向 `App → System/BSP`，厂商全局量只在 `board_state.c` 出现；`make strict` 的 19 个文件仍 **0 条告警**，4 套断言（117/1235/76/29）与引脚/中断/向量表核验全绿 |
| 54 | ★ **排版统一（P3：守卫 + 空白 + 格式标准的单一真相）**：① **46 个头文件守卫** `__XXX_H` → `模块前缀_文件名_H`（`APP_`/`BSP_`/`SYS_`；`User/stm32f4xx*` 属 ST 官方文件保持原样）；② 新增 `tools/fw_prep/normalize_whitespace.py`（行尾统一 LF + 去尾随空白 + 混合缩进折算；**白名单硬限定作用域** + "非空白字符零变化"安全阀；幂等）；③ 新增仓库根 `.clang-format`（Tab=4、Allman、`ColumnLimit 110`、`SortIncludes: false`）作为更细排版的单一真相；④ 作用域内 37 个文件收敛为 **0 尾随空白 / 0 混合缩进** | 为什么必须改守卫：`__` 开头是 C 保留标识符，而且本项目**真撞过名** —— `App/Sensor/MPU6050/mpu6050.h` 与 `System/usart/usart.h` 都写 `__USART_H`，后 include 的那个头文件会被**整体静默跳过**（不报错，只是碰巧没用到才没炸）。为什么空白也要管：仓库 `.gitattributes` 早就规定 `*.c/*.h` 用 LF，但磁盘上有 157 个 CRLF 文件 → 每次提交都刷"CRLF 将被替换"告警，且 diff 噪声掩盖真实改动。**教训**：脚本第一版没限定作用域，把 `Drivers/FWLIB`、`App/Sensor/DMP` 等厂商目录也格式化了 136 个文件，违反"厂商代码保持原样"→ 已从快照整体回滚，并把白名单固化进脚本 |

| 55 | ★ **不执行 `.clang-format`**：仓库保留一份按 clang-format 23 校准过的参考配置，但**不对既有源码跑格式化**；"实际执行的格式规范"以 [`编码规范.md`](design_firmware/编码规范.md) §5.1 的表为准（能机器保证的空白/行尾已统一；行宽、括号前空格、include 排序**刻意不统一**） | 实测对既有文件跑一次会产生**数百处真实重排**（`patrol.c` 154 / `app_tasks.c` 115 / `protocol.c` 100 处替换点）—— 会把真实逻辑改动淹没在格式 diff 里；而且控制代码刚调好、正处答辩期。**格式规范的价值在于"可核对"，不在于"机器跑过"**：与其宣称"已全仓格式化"，不如明确写出"哪些是强制的、哪些不管" |
| 56 | ★ **回滚快照保留策略**：大改动前把 `firmware/` 整目录快照到 `hardware/固件快照_<日期>_<时刻>/`（gitignore，附 MD5 清单）；**只保留最近一次大改之前的那一份**，中间步骤与更早的都删；**上板验证通过后即删** | 本轮 P2/P3 连续整改一度留下 4 份快照（约 1,200 文件、几百 MB）；快照的唯一用途是"改坏了能一键回滚"，留着多份只增加"到底以哪份为准"的困惑。只留一份 **且** 明确删除时机，才既安全又不堆积 |

| 57 | ★ **协议 v1.1 冻结（C 侧会签由 B 代拟）**：① 新增**安全通道事件码** `0x08` 失联停车 / `0x09` 停车解除 / `0x0A` 收到急停（三者成对，带时间戳）；② `0x24` 的 4 个扩展 ID（`0xFF` 全量回读 / `0x00` 保存 / `0xFE` 载入 / `0xFD` 100 Hz 观测）**会签通过并冻结**；③ 新增协议 §七「给上位机的显示约定」10 条（ppm×10、0.01°、`0x11` N=9、PWM 千分比、小端 float32、双链路用法、心跳可用任意下行帧、`0x12` 异常标志位域语义等） | 为什么不再等 C 会签：4 个扩展 ID 是**向后兼容的纯增量**（上位机不认识也能不用），已实现、已进冻结向量，为它阻塞 C 侧开发不划算。为什么**安全通道要单列事件码**：`0x12` 是 20 Hz 周期帧，失联/急停只体现在它的标志位里，上位机必须**比对前后两帧**才能推断"什么时候停的" —— 而 `0x13` 事件帧自带时间戳，这才是监控系统要留档的东西 |
| 58 | ★ **C 侧技术基线（依据一轮 GitHub/公开资料调研）**：**Qt 6.11.2 Widgets + C++20 + CMake/Ninja**；曲线选 **QCustomPlot**（自带源码，不引入 Qt Graphs/QML 依赖）；串口用 `QtSerialPort` + **专用线程阻塞读** → 环形缓冲 → 工作线程解帧 → `QueuedConnection` 给 UI；UI **20 Hz 定时刷新**（不是每帧重绘）；五层单向依赖 `io → protocol → domain → ui`（+ `app` 装配）；存储 **CSV（逐帧）+ SQLite（会话/事件/参数快照）**，路径走 `QStandardPaths`；界面遵循 **ISA-101**（中性灰底、**颜色只用于异常**、无渐变/3D、数字等宽右对齐、量程位置恒定）｜**调研结论**（详见 [`design_host/C部分方案与计划.md`](design_host/C部分方案与计划.md)）：① [Serial Studio](https://github.com/Serial-Studio/Serial-Studio) 的分层（驱动→解析→变换→部件）与"记录+回放"值得照搬，但它的项目编辑器/脚本解析/多协议驱动**不抄**（与任务无关、只增风险）；② 中文工业调试上位机的"报文日志 + 设备模板 + SQLite"三件套适合我们；③ 曲线控件在 Widgets 体系里 QCustomPlot 风险最低（Qt Charts 已被 Qt Graphs 取代，后者依赖 QML）；④ 性能根本不是瓶颈（我们约 60 帧/s，Serial Studio 自述 256k 帧/s），**UI 卡顿只可能是架构问题** |

| 59 | ★ **C 侧交互功能吸收（对照厂商 PC 工具与手机 App）**：把 12 项功能并入计划 —— 人工地平仪（姿态球）、曲线数值标注、快速截图/存数据、暂停更新+窗口置顶、通道独立显示+当前值数码管、横纵坐标测量与十字定标、遥控页带状态回显、可编程自定义键、多种遥控输入（松手即停）、模拟数据显式开关与水印、文本调试通道、数据保存/回放；**明确不学**：商城/论坛/检查更新、3D 立方体、霓虹数码管配色、全屏遥控器式布局 | 参考件的价值在**交互细节**，不在整体结构：它是"示波器+遥控器"，我们的任务是"监控台"。另外**从 v1.0 App 源码确认了厂商遥控协议**（经典蓝牙 SPP、摇杆 `'A'`~`'H'`、松手 `'Z'`、自定义键 `'J'/'K'`、另有文本透传），因此"厂商 App 兼容层"从"待确认"变为**已确认可行**（优先级仍低：我们自己的遥控面板已覆盖同功能）。**第三方源码解到仓库外**（`..\260921Task_私有资料\vendor_ref\`），不进入公开仓库 |

| 60 | ★ **真机联调第一轮修正（4 项，2026-10-13 首次上板）**：① **低压误触发**：原判据 `电压>0 且 <11.10V` 会把**分压悬空的几毫伏噪声**当成"电池 0.x V" → 误锁存硬件故障 → `Turn_Off()` 恒为 1 → `Set_pwm()` 永不被调用 → **电机完全没有输出、车根本不能平衡**；改为三级判据（先过"有电池"门槛 **>6.00 V** → 再**连续 5 拍**确认 → 才认低压）。② **厂商 `APP_Show()` 污染链路**：它每 100 ms 用 printf 发 `{A..}$` 文本，而 printf 路由到 **USART2（我们的蓝牙协议链路）** → 帧流被 ASCII 污染；已从 `ui_task` 移除该调用。③ **协议 v1.2 新增 0x15 诊断帧**（任务 tick / **OLED 写计数** / 电池电压 / 页号 / 剩余堆）：把"屏幕有没有在刷、任务还活着没有、电压多少"变成**可远程测量**；不改动任何已有帧。④ **DTR/RTS 陷阱**：打开串口不显式驱动 DTR/RTS 会把 MCU 按在 BootLoader（详见 AGENTS 陷阱 33），`tune.py` 与 GUI 两侧已修 | 这一轮的价值在于：**"看不到"的东西全部变成了可测数据**。①是典型"算出来 ≠ 真执行"的反例（铁律 29 的镜像：**该输出却从不输出**）；②说明"接管外设后必须停掉厂商旧输出"；③④则是把 OLED 这类**只有人眼可见**的故障，尽量转成工具可判读的信号 —— 毕竟现场只有一个屏幕、而屏幕本身可能就是坏的那个 |

| 61 | **端口自动识别（按合法帧判定）** 列为上位机 P1 的必备能力 | Windows 蓝牙 SPP 口号随机、描述不可信，"猜口"会浪费大量联调时间；判据应是"这个口上有没有 CRC 通过的整帧"，而不是端口叫什么。PC 侧参考实现见 `tools/fw_prep/bt_scan.py`，C 侧方案见 `docs/design_host/C部分方案与计划.md` §11.5 |

| 62 | ★ **条件编译开关『静默失效』的根因与铁律（2026-10-15 真机联调）**：`control.c` 用了 `CFG_ENCODER_*_INVERT` / `CFG_MOTOR_*_INVERT` 等开关，但**没有包含 `app_config.h`**（也没有任何它包含的头间接包含）⇒ 预处理器按『未定义 = 0』处理 ⇒ 所有 `#if CFG_xxx` 块**整段被跳过**，开关写什么值都无效，**而运行现象上完全看不出来** —— 连续三轮『翻电机方向』实验一次都没生效，白烧固件、白折腾一晚；同一晚还犯了『开关套开关』（分侧开关被外层旧开关编译掉）与『脚本误删内层 `#endif`』。**规则**：① 凡 `.c` 里用 `#if CFG_*`，该 `.c` 必须能看到定义它的头文件；② 验证开关是否生效**必须看预处理输出**（`gcc -E`，命令取自 `compile_commands.json`），**不要**用『文件大小/哈希是否变化』判断 —— 对齐会吸收 2~4 字节差异，会给出**假阴性**（当晚两次误判） |
| 63 | ★ **方向类问题的正确解法（顺序不能错）**：真机上『车往前倾却往后走 / 轮子对拧』这类现象，本质是**三个符号**的组合：① 平衡环（取决于**电机极性**）② 速度环（取决于**编码器极性**）③ 角度约定。当晚的教训是**必须先确认『观测量的物理来源』** —— `spd`/`Enc` 来自**编码器**，不代表轮子真实转向；把编码器的错当成电机方向问题去翻，越补越乱。**正确顺序**：㈠ 先读分量（`0x16` 的 `Bal/Vel/Turn`）确认谁在出力、输出有没有被执行（`Moto` vs `CCR`）；㈡ 再摘掉无关环（速度环权重是平衡环的 13 倍，符号一错就把平衡环表现完全盖住）——为此新增**编译期开关** `CFG_DEBUG_DISABLE_VELOCITY`（不远程写参数，避免触发失联锁存）；㈢ 最后**一次只动一个符号**：翻编码器对只影响速度环、翻电机对会连平衡环一起翻，所以先翻编码器。实证：编码器极性修复后 `Enc L/R` 同号，但速度环立刻『跑飞』（±90 持续转）—— **这恰恰证明修复生效了**（此前速度环是瞎的，只会对拧/乱走，不会跑飞） |
| 64 | ★ **上位机开工前的接口补齐（2026-10-15）**：① **固件版本字节**（`0x16` 偏移 19，`(月<<4)|日`，本版 `0xAF`）—— 当晚『到底烧没烧上』扯皮一整轮，这一字节是可验证性的基础设施；② **`0x24` 范围校验**（越界拒绝且不改动生效值、拒绝 NaN）—— 原实现只校验 ID，一条合法帧就能把车调飞；`Velocity_Ki` 上界取 **0.82** = 限幅 8200 ÷ 积分限幅 10000；③ **A1 运动链路真正实现**：`0x20` 的 `linMmS`/`angDpsX10` 原先被直接丢弃、RTOS 下又无人写 `Flag_Qian/Hou/Left/Right` ⇒ **上位机发指令车不会走**；现按厂商原语义（方向标志 + 固定速度档）实现，并加 **500 ms 无指令自动停**看门狗；④ 新增上行 **`0x16` 三环实况**（三分量 + `Moto→CCR` + 原始计数 + 状态位）与 **`0x15` 诊断帧**，把『只有人眼可见』的东西变成**可远程测量** |
| 65 | ★ **C 侧 P1：domain 层成为"数值口径"的唯一出处**（2026-10-15）：新增 `domain/units`（协议定点量的**唯一**换算与格式化处：ppm×10、0.01°、0.01 V、PWM 千分比；定小数位 + 消负零）、`domain/frames`（8 类上行帧结构体 + **精确长度**校验的解析 + 名称表）、`domain/vehicle_state`（双链路合并、**来源与新鲜度**、格式错帧/协议外命令计数、低压与安全锁存判定、OLED 写速率与四任务 tick 存活）。界面纪律三条：**UI 不解析任何字节**；UI **20 Hz 定时拉取**（不是每帧重绘）；**过期值一律置灰并标注"已过期"** —— "画面冻住"绝不能看起来像"车停住了"。配色按 ISA-101 落成变量（正常=中性灰、警示=琥珀、报警=红、离线=灰、绿**只**用于状态灯）| 协议 §七 显示约定 1~4 要求口径统一，而"少除一个 10"这类错误**看现象看不出来**（界面照样显示 123.4）。集中到一处后它同时成为可单测对象：`test_domain` **14 项**（含直接抄自冻结向量的逐字段比对）+ 界面冒烟 `test_ui` **6 项**。**为什么必须显示"来源+新鲜度"**：两条链路都发周期帧（约定 6），不写清来源就会出现"两条链路的数据互相打架而看的人不知道信哪个" |
| 66 | ★ **假源（离线/演示数据源）必须覆盖"界面要用到的每一种帧"并内置安全剧本**（2026-10-15）：C 侧假源补齐 `0x13`/`0x15`/`0x16`，并内置一套**可重复剧本** —— 1 s 自检完成 / 2 s 任务开始 / 每 30 s 气体冲高报 `0x06` / 每 60 s 的 `0x0A` 急停锁存 → `0x09` 解除 / 50~56 s 低压窗口；"造帧"集中到 `tests/frame_factory.h`，`test_link` 的长度表与 `test_domain` 的"端到端 **0 格式错帧**"断言共同守住这条 | **少一种帧 = 那块界面离线时永远空白**，而人极易把它当成"界面写错了"去瞎改（P0 的 `0x14` 少发两个保留字节就是这么被发现的）。而"报警/锁存/解除"在真机上要人去制造（拔线、按急停）才能复现，脚本化之后 P1~P3 的界面**没有板子也能演完**，也是演示现场硬件故障时的应急预案（AGENTS 陷阱 32 的同一条思路）|
| 67 | ★ **"两条链路都发同样的帧"⇒ 去重必须在聚合层做一次**（2026-10-15，P2 实际踩到）：协议 §七 约定 6 规定周期帧与事件告警**两路都发**。原先 `VehicleState` 只是"谁后到用谁的值"，而下游（曲线采样、告警的连续确认、事件流）**按帧计数** ⇒ 同一次物理测量被算两次：现象是 ① 事件流每条事件**出现两遍**（复盘会误以为急停发生了两次）、② 告警的"连续确认 3 帧"被 **1.5 次**真实采样满足（提前报警）、③ 曲线同一时刻采两个样。**修法**：`VehicleState` 对每个命令字记住"最近一帧的原始数据 + 来源 + 时刻"，判据 = **同命令字 + 内容逐字节相同 + 来自不同链路 + 间隔 ≤150 ms**（同链路连发相同内容在 20 Hz 下常见，**不算**重复）；`dataUpdated`/`eventReceived` 只在非重复时发出，下游自动各得一次；并暴露 `duplicateFrames` 计数让"去掉了多少条"可见。**连带**：假源两条链路必须造出**逐字节相同**的帧（原先各自用 tick 时刻 → 冲高事件被造出两帧内容不同的 `0x13`，去重认不出来） | 这条属于"看不见的正确性问题"：界面照常显示，曲线照常有线，**只有把事件流与告警次数当真去核对**才会发现。它与铁律 29"算出该停车≠真的停车"同源 —— **计数类判据必须能回答"这个数是怎么数出来的"** |
| 68 | ★ **告警判定的三条纪律 + 一个方向陷阱**（2026-10-15，P2）：① **连续确认**（默认 3 帧，同 `0x23`）——单帧毛刺不报；② **迟滞**（气体回到阈值 ×0.9、低压回升到 11.40 V 才解除）——贴着阈值不许来回跳；③ **状态跃变才报**：同一段异常只报一次，**但解除后再超限必须重新报**（计划原文"再次进入异常不再重复提示"按"重复帧不重复提示"实现；若真的再也不报，安全功能就是装饰）。**方向陷阱**：`AlarmEngine` 最初把"高=坏"写死在判据里 ⇒ **低压保护反向失效**（电压 11.05 V 明明低于 11.10 V 报警线却永不报警），而现象只是"低压从来不报"，很难往"比较方向"上想。现在 `judgeThresholdFor(..., lowIsBad)` 显式声明方向，并在测试里对两个方向各有一条断言 | 三条纪律各自对应一种真实误报/漏报；方向陷阱是"监控功能静默失效"的典型 —— 与"少除一个 10"（决策 65）一样，**看现象看不出来** |
| 69 | ★ **保活绝不能用"使能类"命令（P3，安全相关）**：固件规定"**500 ms 没收到任何下行帧 ⇒ 安全停车并锁存**，且**硬件按键也解不开**"，所以上位机必须周期发合法下行帧（C 侧实现 `domain::KeepaliveEngine`，默认 **200 ms**，留 2.5 倍余量）。**但保活只能用 `0x1F` 心跳**：协议 v1.1 明确"收到显式使能（`0x20` 使能位=1 或 `0x21` 任务=自主巡航）**即解除安全锁存**" ⇒ 若把 `0x20 enable=1` 当保活周期发，就等于**每 200 ms 自动绕过一次急停保护**（铁律 29 的旁路），而界面上一切看起来都正常。另两条实现要求：① 打开保活/链路就绪时**立刻**发第一条（"打开到第一条"的空隙最容易踩出超时）；② 链路不通时**不发**并显示"待链路"（不能假装在保活），发送失败不计入"已发" | 这是"监控/保活功能自己把安全保护拆掉"的典型：保活的心跳选择错了，**急停与失联保护都会静默失效**。所以把"方式"做成显式选项（默认心跳），并使能模式在界面上高亮告警（决策 70 同源） |
| 70 | ★ **锁存期间用"禁用入口"兜底，而不是靠提示语**（P3）：协议 §3.6"锁存期间禁止起步"。C 侧把方向键、巡航、返航**全部禁用**（按不动），并高亮"重下任务解除锁存"作为唯一路径；急停则**不做二次确认**（它就是"来不及解释"的按钮），而解除锁存必须是人主动点。**副标题/提示必须与值同步**：P2 的湿度卡、P3 的任务卡都出现过"值已更新、副标题还写着『无数据』"——`setValue/setText` 不会清旧副标题，现已加回归测试（`test_ui` 断言有数据后副标题不许含"无数据"） | ①"靠提示语"在真实操作节奏里等于没有保护（人不会读）；②"值与副标题自相矛盾"的界面会让人误判成"数据没到"，从而去查错方向 —— 这类"显示不一致"与"口径不一致"（决策 65）是同一类错误 |
| 71 | ✅ **B 部分收工：真机可稳定平衡（2026-10-15）** —— 出厂参数定稿：`Balance 300/1`、`Velocity −80/−0.4`（★ 取负：本机电机符号×编码器符号与厂商约定相反，用户飞线困难故用软件补偿）、`Zhongzhi 0.5`（★ 重心偏后约 0.5°，让车保持该前倾角使重心落到轮轴正上方）、`Turn 0/0`（调试期不用转向环）；由 `app_config.h` 的 `CFG_OVR_*` + `CFG_DEBUG_PARAM_OVERRIDE=1` 在 `ParamStore_Load()` 之后强制生效（不依赖 Flash 历史值）。 **⚠ 2026-10-15 复查更正：该覆盖实际被参数范围校验拒绝（`Velocity_Kp/Ki` 的下限写成 0.0f），定稿的 −80/−0.4 从未生效，实际生效 +80/+0.4 —— 见决策 77；以已烧录代码为准。**方向/极性软件补偿：`MOTOR 1/1`、`ENCODER 0/1`、`TURN_INVERT 0`。 |
| 72 | ★ **三个"看不见的正确性问题"与"把中间量上报出来"的方法论（2026-10-15）** —— ① `control.c` 用 `#if CFG_*` 却**未包含 `app_config.h`** ⇒ 宏按未定义=0 ⇒ 开关**静默失效**（连续三轮翻向实验一次没生效；验证必须看 `gcc -E` 预处理输出，别信文件大小/哈希）；② 往**裸 `if`** 后插语句（带 `#if` 的）未补花括号 ⇒ 展开后 `Set_Pwm` 变无条件执行：停车态两轮拿到相反命令 = **疯狂转圈**，且**停车保护被绕过**（安全级）；③ 启动期多段覆盖**后者胜**：`CFG_DEBUG_DISABLE_VELOCITY` 排在出厂值之后，把速度环清 0 ⇒ 速度环**从未运行**、"调 Zhongzhi 忽前忽后"。方法论：新增 `0x15`/`0x16` 两帧把 `Bal/Vel/Turn`、`Moto` vs `CCR`、编码器原始计数、状态位**上报出来** ⇒ `Turn=0 而 Moto=−X/+X`、`Vel` 恒 0 这类真因一眼可见，不再靠现象猜符号。 |
| 73 | ★★ **参数前端校验必须与固件口径一致：本机正确值是负的**（P4，依据 B 侧 [`给C侧_固件接口与判读口径.md`](handoff/给C侧_固件接口与判读口径.md) §3.1/§5）—— 本机电机/编码器符号与厂商约定相反 ⇒ `Velocity_Kp/Ki` 的**定稿值就是 `−80/−0.4`**；`Turn_Kp/Kd` 同样允许负值。C 侧原先照协议 §3.8 的表格把范围写成"0~500 / 0~0.82"、默认值填厂商值 ⇒ **会把板子上的正确值判为非法**（现象是"调参界面上不让填"，极易被当成界面 bug）。现范围改为 ±500 / ±0.82 / ±10，默认值填**本机定稿值**，并加回归测试断言七个定稿值全部通过校验。**同批对齐**：低压报警要先过"**有没有电池**"门槛 **6.00 V**（真机 USB 供电时 `0x15` 报 ≈4.3 V，固件按无电池处理；上位机若直接判 `<11.1 V` 就是**假报警**），解除线取 **11.6 V**（与固件自动解除门限一致，否则会出现"界面说已解除、车还锁着"）| "界面把正确值判成非法"与"界面报出车里并不存在的故障"是同一类错误：**监控系统的判据必须与执行机构（固件）同口径**。这类错误在界面上都表现为"看起来很正常"，只有拿真机数据去核才会发现 —— 所以 P4 专门加了 `--probe-readback`（真机全量回读 + 逐项对照）作为常备工具 |
| 74 | ★ **"算了没执行"必须与"保护生效"分级**（P4，依据 B 侧接口文档 §2.1/§4）—— `0x16` 里 `Moto≠0` 而 `CCR=0` 有两种完全不同的含义：① **保护中**（`Flag_Stop=1` 或电机被禁/锁存）⇒ **正常**，"没使能电机"就长这样（真机实测 `Moto1=−1581 / CCR=0 / Flag_Stop=1`）；② **未停车却 CCR=0** ⇒ 真故障（算出来没执行，铁律 29 那类问题）。C 侧原先一律按红色"算了没执行"报警 ⇒ 等于**把正常状态说成 bug**。现分级为 已执行 / 保护中未驱动（琥珀，附"Flag_Stop/锁存"说明）/ 算了没执行（红），判据落在 `domain::LoopData::executionState()`（可单测）| 监控台的价值在于"如实"：**报警要指向真问题**，否则现场第一反应是"这软件又在乱报"，之后真故障也不信了（狼来了）。同批把三个"一眼定位故障"组合（`Turn=0` 却两轮不同、`Moto/CCR` 对照、`Flag_Stop`/锁存位）做进总览状态位与调参页的判读行 |
| 75 | ★ **交付要 Release 树 + 打包必须"删了再验 + 干净 PATH 复验"**（P5）—— ① **Release vs Debug**：本项目 Debug 的 `host.exe` **41.5 MB**、Release **3.2 MB**（且 Debug 是 `-O0`），用 Debug 交付既笨重又慢；② **瘦身要删了再验**：windeployqt 原始 **109 MB**（带上 D3D12/D3D11 着色器编译器 25+4 MB、QML/Network/SVG、多余 SQL 驱动、图片格式插件），本项目是纯 QWidgets(QPainter)、不用 RHI，实测删掉后 GUI/自检/截图/录制四条路径都正常 ⇒ **37.4 MB**；③ **校验必须在"干净 PATH"下做**（把 Qt 与 MinGW 从 PATH 里去掉），否则"在我机器上能跑"毫无意义；④ **四项校验缺一不可**：无头自检退出码 0、界面真起来 4 s 不异常退出、截图落盘、**录制后 SQLite 会话库真的建起来**（少了 `qsqlite.dll` 程序不报错、只是静默降级成"只有 CSV"）。见铁律 43 与 §十七 |
| 76 | ★ **交付文档三份，分工不重叠**（P5）—— [`软件设计说明.md`](design_host/软件设计说明.md) 给**评阅/接手的人**（需求→实现→**验收证据**对照、分层与依赖方向、线程与数据流、模块清单、关键决策、协议一致性表含实测偏差、测试证据、构建打包、已知边界）；[`用户操作手册.md`](design_host/用户操作手册.md) 给**现场要用它的人**（便携版怎么跑、第一次连真机含 DTR/RTS 坑、逐页看点、记录回放、**故障排查表：症状→原因→怎么办**、安全须知）；[`演示脚本.md`](design_host/演示脚本.md) 给**答辩现场**（**5 分钟分镜表**：时间/操作/预期现象/要讲的一句话 + 降级备用方案 + 演示前 30 秒自检）。三者原则相同：**只写实测到的数**（体积/行数/退出码/参数值），不写"应该没问题"| "文档齐套"不等于"文档有用"：三份文档的读者与场景完全不同，混在一起就会变成没人看的"大文件"。而"只写实测数"是本项目贯穿始终的纪律（与决策 23 的"用独立方法验证"同源）|
| 77 | ★★ **上电"覆盖定稿值"会被参数自己的范围校验静默拒绝 —— 定稿值其实从未生效**（2026-10-15 复查，**以已烧录代码为准**）—— `app_config.h:87-94` 定义了 `CFG_OVR_VELOCITY_KP=-80.0f` / `KI=-0.4f`（决策 71 的负增益结论），`app_tasks.c:762-768` 在 `ParamStore_Load()` 之后逐项 `ParamStore_SetOne()` 覆盖；**但** `param_store.c:93-101` 的 `s_range[]` 里 `Velocity_Kp` 下限写的是 **`0.0f`**、`Ki` 也是 **`0.0f`** ⇒ `SetOne` 判 `value < lo` ⇒ **返回 -2、拒绝写入且不改当前值**（`:116-119`）⇒ 覆盖**静默无效**，实际生效一直是默认的 **`+80/+0.4`**。全链条"看起来都对"：宏定义了、覆盖调用了、函数也有返回值（只是没人看），而**真机 `--probe-readback` 读到的 `+80/+0.4` 才是真话**（C 侧先前误猜成"Flash 旧值里存着 +80"，已更正）。**规则**：① 凡"上电覆盖/初始化"，**必须检查写入函数的返回值**——"调了函数"≠"值生效了"（与铁律 29/41 同族）；② **校验表与定稿值必须同源核对**（定稿值本身要能通过校验）；③ 判"某参数到底生效没有"**只看回读值**，不看宏写了什么。修复：把那两行下限改成 `-500.0f` / `-0.82f`，覆盖即生效。**连带修正**：B 侧接口文档 §3.1 的范围表已按代码重写；C 侧参数表允许负值但会按"回读 ≠ 请求"标红（避免"以为改了其实被拒"）|

---

## 四、行政与资源

| # | 内容 |
|---|---|
| 19 | 组号 = 1；班级 = 测控2302 |
| 20 | 角色分工：**A1 电路 / A2 结构 / B 程序 / C 系统**（组长由 C 担任）|
| 21 | PCB 打样费不能报销，四人分摊 |
| 22 | 可借到万用表、ST-Link |
| 23 | Git 仅用于项目管理规范化，不公开托管 |
| 24 | **任务书不需要重新提交**（技术栈与选题均不变） |

---

## 五、跨阶段保留的资产（方案变更也不失效）

| 资产 | 位置 | 为什么仍有效 |
|---|---|---|
| **MQ 算法与标定调研** | `docs/research/MQ气体传感器开源实现.md` | 与 MCU/平台无关 |
| **上位机协议层** | `host/`（13 项测试通过） | 与硬件无关 |
| **通信协议 v1.2**（v1.1 冻结 + `0x15`/`0x16` 增量） | `docs/protocol/communication_protocol.md` | 自研协议，与平台无关 |
| **车体组成解析** | `docs/design_hardware/car_composition.md` | MiniBalance 本身 |
| **引脚表** | `docs/design_hardware/pin_assignment.md` | MiniBalance，源码+实拍互证 |
| **工程经验** | `docs/design_hardware/sensor_interface_notes.md` | 基底无关 |
| **固件架构** | `docs/design_firmware/architecture.md` | 两者都是裸机+中断驱动控制，结论通用 |
| **相似方案参照** | `docs/research/相似开源方案调研.md` | 上位机/协议/状态机/交付物四类参照 |

---

## 六、已废弃（不要再用）

| 项 | 说明 |
|---|---|
| 开源基底 `snqx-lqh/Stm32BalanceCar` 及其 Gerber/`.epro` | 方案已变更，**已归档**至阶段二压缩包 |
| `SCH/PCB_STM32F405RGT6_2026-07-24.pdf` 等 4 份 | 网上找的，**与车上实物不符**（48针 vs 60针、无 CH340、无板载 IMU） |
| "48 针接口"的推断 | 实测为 **60 针（2×15 ×2）** |
| 原方案"从 NRF24L01 座飞线接传感器" | 需按新底板设计重新规划 |
| **★ 用 EDA API 自动改板**（2026-09-24 实测） | 见下 |

### 六之补、AI 自动改板：**PCB 布线不可行，但原理图完全可行**（2026-10-05 修订）

#### 原始结论（2026-09-24，针对 **PCB**）—— 仍然成立

**试了什么**：通过 EDA 官方 API 自动完成"改网名 + 加 5 只分压电阻 + **布线 + 铺铜**"。

| # | 问题 | 证据 |
|---|---|---|
| 1 | API 创建的元件字段不完整 | 老元件含 `DeviceName`/`FootprintName`，API 创建的新电阻**缺这两项** |
| 2 | `pcb_Document.importChanges()` 在本工程恒返回 false | 用未改动的原工程测试同样 false |
| 3 | **PCB 自动布线 DRC 难以收敛** | 板子双面高密度（Top 818 / Bottom 709 个障碍），新元件无论放哪都压到既有走线；最终仍有 96 条间距错误 |

> **所以"AI 自动画 PCB"确实不行** —— 改板走**手工画 PCB**（见 `焊接调试手册.md`）。

#### ★ 但 2026-09-30 的实测把"原理图也改不动"这条推翻了

**做法**：仍然用同一套 EDA API，**只改原理图**（放件、接线、填料号、改封装）。

| 成果 | 数据 |
|---|---|
| 用 API **放入元件** | 12 只（`R10~R14`、`C14~C19`）+ 多个候选替换件 |
| 用 API **连线** | 约 40 条（8 个模块座的座序重排、分压/上拉/去耦、`J18`、`SW2`/`J17`）|
| 用 API **写料号** | `U1/U2/U3` + `D1` 等 |
| 用 API **改位号** | `C21→C2`、`C24→C13`、`L2→L1`、`U5→U2`、`U6→U3` |
| 核验 | 逐脚网络 + 全局防短路 + 文件层解析 **三路径复核通过**；**DRC 致命错误 0** |

**关键突破**：`create(<从 lib_Device.search() 拿到的完整器件对象>, x, y)` **能成功且封装齐全**；
传 `{libraryUuid, uuid}` 引用会卡死 30 秒（原因见《原理图完善计划》§6.5 的四个坑）。

#### ★★ 2026-10-07 实测（第二次修订）：**PCB 布局仍然做不了** —— 能力边界最终版

**试了什么**：在"改"板 PCB2 上，用 API 自动摆放开关电源区 10 个件（`U2/L1/D1/C1~C6/U3`）。

| 尝试 | 结果 |
|---|---|
| **算面积、找空位** | ✅ **这部分有用**：极大矩形算法能算出板内哪块是空的。实测这 10 个件**纯器件面积 = 467 mm²**（≈21.6×21.6 mm 的方块），加布线余量要 **25~30 mm 见方** |
| **螺旋自动寻位** | ❌ **失败**：把元件推散 —— `C4↔C2` 仍有 23 mm（目标 ≤6 mm），`C1↔U2` 15 mm |
| **定向精修** | ❌ **失败**：撞到 `J18` 和板框，且**每改一步都要 A1 善后** |

**结论（A1 的判断，记录采纳）**：
> **AI 目前做不了 PCB 布局。** 布局是"全局优化 + 经验 + 反复权衡"的活，
> 而 API 只能"一个件一个件挪"，看不到整体，越改越乱。
> **要试也只能在复制出来的沙盒板上试，别动正板。**

**因此确立最终分工**：

| 谁 | 做什么 |
|---|---|
| **A1（人）** | **PCB 摆放与布线**（全局判断，AI 替代不了）|
| **AI** | **核查类**（这部分做得好）：DRC 运行与判读、网络表一致性、**间距/线宽实测**、丝印检查、BOM 料号核对、原理图改动与核验 |

**另一个重要发现**：A1 原先的 PCB 布局是**照抄"原"板 PCB1** 的 —— 这个做法本身是对的，
**但"替换器件"会把封装原点带偏**（`CP_Elec_8x5.4` → `CAP-SMD_BD8.0` 的原点/焊盘不同），
于是抄来的相对位置就失真了（`C4↔C2` 从紧邻变成 38 mm）。
**所以换过封装的元件，位置要重新对一遍。**

#### ★★ 2026-10-07 第三次修订：**"照抄原板布局"是完全正确的 —— 我批错了对象**

A1 反问："既然原板用那个布局，为什么说误差不可接受？"
**实测数据支持 A1，我之前的批评搞错了对象**：

| 配对 | **原板 PCB1（实测）** | 改板 PCB2（走样后） |
|---|---|---|
| `C4↔C2` | **6.2 mm** ✅ 紧贴 | 25.7 mm |
| `C5↔U3` | **5.8 mm** ✅ | 44.9 mm |
| `C3↔U2` | **7.9 mm** ✅ | 38.9 mm |
| `C2↔L1` | **10.2 mm** ✅ | 44.2 mm |
| `C1↔U2` | **14.4 mm** ✅ | 25.5 mm |
| `D1↔U2` | **13.9 mm** ✅ | 46.5 mm |
| `L1↔U2` | 20.5 mm 🟡 | 14.6 mm |

**结论：原板的电源布局本来就是紧的、正确的。**
我之前看到的"38 mm / 44 mm"**不是原板的布局**，而是**改板照抄时走样的结果** ——
**批评对象搞错了，特此更正。**

**为什么会走样 —— 找到了根因**：两块板**板框尺寸完全一样（100.00 × 65.00 mm）**，但 **坐标系差了 2079 mil**：

| | 板框 y 范围 | 安装孔 y |
|---|---|---|
| 原板 PCB1 | −240.20 → 2318.85 | (0,0) (0,**+2079**) |
| 改板 PCB2 | **−2319.20 → 239.85** | (0,0) (0,**−2079**) |

> **⚠ 2026-10-16 复核更正（决策 81）**：上表原来是"原板 −43.35 → 2318.85 / 改板 −2122.35 → 43"，
> 那是板框**直边段**的范围 —— **漏掉了四角 R5.0 的圆弧**（圆弧比直边各外扩 5 mm ⇒ 真实 y 跨度 65.00 mm，不是 60）。
> 两块板的外形**都是 100.00 × 65.00 mm、四角 R5.0**；**区别在安装孔**：
> **原板 4 个 ⌀3.2 mm**（四角），**改板只有 3 个**（删掉了**右上角**那个，该角落现在是 `J13`/`J10`/`R10`~`R13` 区）。
> 因此"两块板尺寸完全一样"这句**只对外形成立**，孔位并不一样 —— 照抄原板坐标时除了做下面的换算，**还要记得少一个孔**。

**换算公式：`y_改 = y_原 − 2079`，x 不变。**
照抄原板坐标时**必须做这个换算**，否则整块板会偏 52.8 mm。

**修正后的指导**：
- ✅ **A1 照抄原板 PCB1 的布局是正确做法**（那是量产验证过的设计）
- ✅ **只有"开关回路"那一圈（`U2.OUT↔D1↔L1↔C2`）真正要紧**，而原板已经做到了
- ⚠️ 换过封装的元件（`C1/C2/C6/C10/C13/L1/SW2/J17/U1/U2/U3/D1`）抄坐标后要微调几 mm

**结论修正**：
- **原理图**：**AI 自动化完全可行** ✅（"人放件、机器接线"可以进一步变成"机器全包"）
- **PCB 自动布线**：**仍不可行** ❌，PCB 靠手工

**处置**：`参考01_copy` 的"改"板原理图已由 API 完成并落盘；
PCB 由 A1 手工绘制（`参考01_copy` 的原始干净状态仍保留在 `projects\参考01\`）。

---

## 七、变更记录

| 日期 | 内容 |
|---|---|
| 2026-10-15 | **真机联调第二轮（决策 62/63/64）**：① 决策 **62** —— **条件编译开关"静默失效"的根因与铁律**（`control.c` 没包含 `app_config.h` ⇒ `#if CFG_*` 整段被跳过，写什么值都无效且现象上看不出来）；② 决策 **63** —— **方向类问题的正确解法**（先确认观测量的物理来源 → 再摘掉无关环 `CFG_DEBUG_DISABLE_VELOCITY` → 一次只动一个符号）；③ 决策 **64** —— **上位机开工前的接口补齐**：固件版本字节（`0x16` 偏移 19 = `(月<<4)|日`，本版 `0xAF`）、`0x24` 范围校验、`0x20` 运动链路真正实现 + **500 ms 看门狗**、新增上行 **`0x16` 三环实况**与 `0x15` 诊断帧。协议据此升到 **v1.2**；另新增蓝牙工具 `bt_scan.py` / `bt_at.py` |
| 2026-10-13 | **协议 v1.1 冻结 + C 部分开工准备**：决策 57（安全通道事件码 `0x08`/`0x09`/`0x0A` + 扩展 ID 定稿 + §七 显示约定 10 条；固件同步实现并由巡检测试断言 76→80 条）、决策 58（C 侧技术基线，含一轮调研）；新增 [`design_host/C部分方案与计划.md`](design_host/C部分方案与计划.md)（调研 + 选型 + 五层模块 + 线程/数据模型 + UI 布局与配色 + P0~P5 计划）|
| 2026-10-13 | **格式规范定稿 + 快照策略 + 编辑器配置共享**：决策 55（不执行 `.clang-format`，实际规范见 `编码规范.md` §5.1）、决策 56（快照只留最近一份、上板验证后删）；`.gitignore` 放行 `.vscode/{settings,extensions}.json`（原先整目录忽略 → README 的分层说明会变成假话）；收尾子代理未完成的 `compile_commands` 工具链并修掉一个真回归（默认构建目标被插在 `all` 之前）|
| 2026-10-13 | **排版统一（P3）**：新增决策 **54** —— ① 46 个头文件守卫改 `模块前缀_文件名_H`（修掉 `mpu6050.h`/`usart.h` **同名 `__USART_H`** 的静默跳过隐患）；② 新增 `tools/fw_prep/normalize_whitespace.py`（LF + 去尾随空白 + 混合缩进；白名单限定作用域 + 非空白零变化安全阀），37 个文件收敛为 0 尾随空白 / 0 混合缩进；③ 新增 `.clang-format` 与 `编码规范.md` §五/§七 对应条目。核验：4 套断言 117/1235/76/29 全过、`make strict` 0 条（**当时的值；状态机现已 80 条**） |
| 2026-10-13 | **结构整改（P2）**：新增决策 **53** —— ① `System/delay` 改**回调注入**（`Delay_SetMsHook()`）打破 `delay.c → App` 反向依赖；② 新增 `App/Board/board_state.{h,c}` 作为**App 访问厂商全局量的唯一出口**（`app_tasks.c`/`param_store.c` 不再直接读写厂商量，App 层零 `extern`）；③ 统一"使能真相"（`App_MotorDisable` 权威、`Flag_Stop` 执行器）；④ 删死代码 `ParamStore_Current()`/`Buzzer_IsOn()` 与蜂鸣器影子状态。同步更新 `编码规范.md` §一/§二/§八。核验：`make strict` 19 文件 0 条、4 套断言 117/1235/76/29 全过、中断安全与引脚基线通过 |
| 2026-10-09 | **交付物补齐 + 跨文档一致性修正**：新增 `BOM表.md`（离线导出自完工快照，52 位号/27 行/料号全覆盖）、`上板自检清单.md`、`电路设计说明文档.md`、`人机界面设计说明.md`；决策 51 记录 9 项跨文档矛盾的修正（0603→0805、蜂鸣器终态、板框口径、网络数口径、J1/J2 命名）；修固件 OLED 排版 bug（`ShowString` 实为 8 px/字符）|
| 2026-10-09 | **数值定稿 + 巡检点判据落地（本轮）**：新增决策 **49/50** —— ① 巡检点判据改为**编码器里程**（`odom.c` 纯整数模块 + 9 条原生断言；不依赖 DNP 的红外）；② 告警阈值/预热/驻留取值与**依据**（清洁空气本底 3.6 / 4.3 ppm 的 8~12 倍；预热 120 s；驻留 10 s），并把推导写进 `app_config.h` 注释。另：MQ 模块 RL 的实测方法与两个已知数据点写入 `gas.c`；**硬件全部到货**（当时刚开始焊接，阻塞点解除；此后已完成焊接与两轮真机联调）|
| 2026-10-09 | **第三轮复查（本轮）**：新增决策 **47/48** —— ① 安全停车真正接到电机（`Patrol_MotorsDisabled()` → 中断强制 `Flag_Stop`，并堵住"按键启停"与"放下自动使能"两条绕过锁存的旁路）；② USER 按键双击切 OLED 页（页 1 环境与气体 / 页 2 巡检与通信）。另新增有线调参工具 `tools/fw_prep/tune.py`（含 100 Hz 观测与姿态统计）；仓库通用化收尾（`.gitattributes` 统一 LF、`README.en.md`）|
| 2026-09-22 | 初版（阶段一）：20 条决策 |
| 2026-09-23 | 阶段二：改用开源方案（已归档） |
| 2026-09-23 | **阶段三：回归 MiniBalance，保留控制板/拓展板，重做底板**；增补方案演进史与跨阶段资产清单 |
| 2026-09-24 | **确认单底板方案**（不另做转接板）；实测 **AI 自动改板不可行**，改板改走手工；新增 `焊接调试手册.md` |
| 2026-09-29 | **接口兼容性三项核实通过**（电机信号/编码器/60针）→ 可放心改板；"改"板已建（Schematic2+PCB2）并完成精简；新增 `handoff/交接说明.md` |
| 2026-09-30 | **AI 自动改板结论修订**（原理图可行、PCB 仍不可行）；新增决策 25~29（红外改 PB12、蜂鸣器方案 A、8 座重排、0805、电机走 12V）|
| 2026-10-05 | **"改"板原理图完工**：104 元件 / 52 位号 / **65 网络**（按完工快照 `Schematic2/P1.esch2` 实测口径；早前正文写 60 是开工期中间口径），**全部有封装 + 全部有立创料号**，DRC **致命错误 0**，可导入 PCB。位号变更：`J3/J4→CN1/CN2`；`J17` 换 `AM-1015B-M`（澄清为**电源输入座**）；`SW2` 换 `SS-12D10L5` |
| 2026-10-09 | **B 阶段开工准备**：新增决策 **34/35**（GCC+Makefile+必须出 hex；FreeRTOS V11.1.0 vendor 入库）；工具链/基线/FreeRTOS/CRC 四项核验通过；修正 `交接说明` §1.2 第 9 条（蜂鸣器 = **有源、低电平响**） |
| 2026-10-09 | **B 阶段 P0 完成**（固件骨架跑通）：新增决策 **36**（协议冻结 = 共享测试向量）、**37**（中断优先级策略）；协议 `0x11` 长度 11→**9**；`firmware/` 可用 GCC 一键构建出 `.hex`（Flash 50 KB / RAM 5.4 KB，向量表核验通过）。详见 [`design_firmware/B阶段开工准备.md`](design_firmware/B阶段开工准备.md) §十 |
| 2026-10-09 | **B 阶段 P1 完成**（协议层）：新增决策 **38**（协议模块纯 C + 时间注入 + 原生可测）；`crc16`/`protocol`/`ringbuf` 落地，**97 条原生断言全过**，Python ↔ C 侧 ↔ 固件三方交叉验证一致（CRC 4 + 帧 12 + 流式 6）；测试当场抓到"组帧数据段错位 1 字节"的 bug。详见同文档 §十一 |
| 2026-10-09 | **B 阶段 P2 完成**（传感器层）：新增决策 **39/40**（温湿度补偿用除法且默认关；ppm×10 必须饱和钳位）；`gas`/`dht11`/`dht11_hw`/`sensor_adc`/`sensor_report` 落地，**1235 条原生断言全过**（五级中间量逐一比对 Python 独立实现）。详见同文档 §十二 |
| 2026-10-09 | **B 阶段 P3 完成**（巡检状态机）：新增决策 **41**（安全停车锁存、失联判据、急停解除条件、传感器失效不阻塞）；`App/Task/patrol.c` + 事件队列落地，**67 条脚本化时间线断言全过**；新增 `tools/fw_prep/run_all_tests.py` 一键核验。详见同文档 §十三 |
| 2026-10-09 | **B 阶段 P4 完成**（FreeRTOS 任务化）：新增决策 **42/43/44**（ISR 禁调 RTOS API + 共享资源策略 + 不需要 I2C 互斥量；ADC 拆通道；转向环增益全局化）；四个任务 + 环形缓冲 + DWT 延时 + `Group_4` 落地，**Flash 60 KB / RAM 31.2 KB**；新增 `check_isr_safety.py`，**9 个 ISR 静态核验全部不调 RTOS API**。详见同文档 §十四 |
| 2026-10-16 | **A1 交付物补齐（v1.1）：Gerber/制造数据、焊接与测试记录、采购记录、板框口径更正** —— 新增 [`hardware/gerber/`](../hardware/gerber/README.md)（下单用的 EDA 导出 Gerber，**脱敏版**；含工艺参数 **1.6 mm / 1 oz / 有铅喷锡**）、[`design_hardware/上板测试记录.md`](design_hardware/上板测试记录.md)（焊接·上电·自检·遗留项，含给 A2 的结构接口实测值）、[`hardware/bom/采购记录_立创商城_SO26101014446.md`](../hardware/bom/采购记录_立创商城_SO26101014446.md)（17 项采购、与 BOM 的 4 处等价件差异、闭合 `C18`/`C19` 料号存疑）、[`hardware/photos/README.md`](../hardware/photos/README.md)（新版底板 4 张实拍 + **丝印姓名打码说明**）；另新增决策 **80/81** |

---

## 八、后续决策（连续编号，78 起）

| # | 决策 | 说明 |
|---|---|---|
| 78 | ★ **"解放转圈"与"再猛烈一点"：把编译期常量讲清楚再动**（2026-10-15，用户现场反馈）—— ① **转向不动**的真因不是上位机，而是 `CFG_OVR_TURN_KP/KD = 0`（B 为避免"原地转圈"把转向环关了）；而那次"转圈"的**真因是裸 `if` 缺花括号**（已在 2026-10-15 修，见铁律 37）⇒ 现在把 `TURN_KP/KD` 恢复厂商默认 **52 / 0.5**，并在上位机调参页用 `0x24` 在线调（范围 ±500，不必重烧）。**⚠ 我（C）先前说"`Turn_Kd` 被硬编码 0 永远无效"是错的**：`control.c:264` 有 `if(Flag_Qian||Flag_Hou) Kd=Turn_Kd; else Kd=0;` —— 原地转向时**有意**不用陀螺仪纠正，前后运动中转向才用 D 项。② **"前后太保守"**：`Target_Velocity` 才是速度给定（上位机 `0x20` 的 `linMmS` **只判方向、量值不参与调速**），110 → **150**（Movement 55 → 75，约 +36%），避障档 55 → 70；想再快只改这一个数。③ **"全屏显示不全"**：窗口写死 `resize(1560,960)` 而常见笔记本屏是 1366×768 ⇒ **窗口比屏幕大**，又因各页有"硬最小高/宽"（调参表 260、通信页 900、地平仪 180×130）而缩不下去 ⇒ 内容被裁且**无法访问**。修法：默认尺寸取"设计值与可用屏幕的较小者" + **每页套 QScrollArea**（滚得到就看得见）+ 下调几处硬最小尺寸；新增 `--size WxH` 便于在小屏尺寸下复现验证（实测 1024×600 / 1366×768 / 1920×1080 三档均可达全部内容）| 三条都属于"**代码里写着、但没想清楚它决定什么**"：把编译期常量当成"开关"、把只判方向的值当成"速度"、把设计分辨率当成"所有屏幕"。共同解法是**先问"这个量到底决定什么/被谁读走"**，再用最小改动 + 可在线调参收尾（与决策 42/73 同源）|
| 79 | ★★ **"填一个量之前，先确认有没有人在写它" —— 左右倾角必须走活的观测通道；顺带立下"固件构建标识"与"界面文案纪律"**（2026-10-15 收尾，用户现场反馈）—— ① 用户报"左右倾角读不到"：我按"车靠 `-Roll` 保持平衡 ⇒ `Pitch` 是左右倾"的推理把 `tiltLR` 取成四元数 `Pitch` —— **推理方向对，但取到一个恒 0 的量**：本机 `Way_Angle=2`（卡尔曼，`main.c:8`），而 `Get_Angle()` 里**只有 `way==1` 才会调用 `Read_DMP()`** ⇒ DMP 输出的 `Pitch/Roll/gyro[]/accel[]` **从不更新**（真机实测"横滚恒 0.00"）。改法：`Angle_LR = atan2(Accel_X, Accel_Z)`（加速度计 X 轴，与厂商用 Y/Z 算平衡角正交同构）+ 陀螺仪 Y 轴给角速度 ⇒ **与用哪种姿态算法无关**；口径如实标注"**仅加速度计的静态倾角**"；留 `CFG_IMU_LR_SOURCE` / `CFG_IMU_LR_SIGN` 一行开关。**教训**：与铁律 36 同源但更进一步 —— 不仅要确认"这个量代表什么物理量"，还要确认"**这一版代码里到底有没有人写它**"（读一个只被死分支写入的全局量，等于读常量 0）。② **争议解决机制**：`0x16` 状态位 **bit3 = 固件特性位** ⇒ 板上是哪一版一眼可判。起因是同一天多次构建（MQ-135 角色指派 → 转向环/提速 → 左右倾角）而 `buildId` 只能表达到"日"，本项目为此白折腾一轮（我一度误判"没烧进去"，实为读到了烧录前的旧数据）⇒ **凡是"怀疑没烧进去"的争议，先让固件给出可读的构建标识**，别靠现象猜。③ 过程中 `make strict` 的 `-Wundef` 抓到"`board_state.c` 看不到 `app_config.h` ⇒ `#if` 宏静默取 0"（铁律 35 原型，会取错 IMU 轴）⇒ **静态检查要开能抓"静默失效"的告警**（`-Wundef`），而不是只看"能不能编过"。④ **界面文案纪律**：**数字留界面、解释进 tooltip**（用户原话"这些字很占地方"）—— 监控界面为"一屏看完"服务（1366×768 免滚动条），长篇解释属于 tooltip 与文档；同时把"未就绪""固件未计算偏航"这类**如实但简短**的标注保留（短 ≠ 可以含糊）。 |
| 80 | ★ **交付物"留档"规范：凡只能从第三方网站/本机忽略目录拿到的，仓库里必须留一份可复核的原件**（2026-10-16）—— 起因：A1 的核心交付物此前只在**打样网站账号**与**本机被 gitignore 的目录**里（`hardware/硬件工程_完工版_*`、`host/dist/`、`firmware/build/*.hex` 全被 `.gitignore` 排除）⇒ **按 git 打包交作业会静默漏件**（本轮核查已实测：`git ls-files` 里 dist/Gerber/hex 各为 0 条）。做法：① **Gerber 留档**（下单用的那份 EDA 导出；**含姓名的丝印笔画按决策 83 脱敏**，未脱敏原件在仓库外），嘉立创生产稿因内含套封无法可靠脱敏 ⇒ 留仓库外，但**工艺参数以生产档为权威出处**（板厚/铜厚/表面处理/油墨，`YG/4te.json`），写进设计说明后**立刻撤掉 `[待补]`**，避免"两处口径并存"；② **采购记录只摘物料与金额** —— 含**姓名/手机/收货地址**的原始订单文件留在仓库外（公开仓库红线）；③ **实物照片入库前对丝印文字块（含组员姓名）打码**，原图留仓库外，并在 `photos/README.md` 写明**打码区域的原图像素坐标**（可复核"打在哪"）；④ **"留档"不等于"进公开仓库"** —— 见决策 **83**：含个人信息的件一律**仓库放脱敏版 + 仓库外留原件**。 **通用规则**：留档 = 原件（可复核）+ 出处（从哪来、怎么再导出）+ 与其它件的对应关系（订单号/哈希/工程名）；三者缺一，交付物就还是"别人手里的东西" | 本轮之前，A1 的 Gerber、C 的可执行程序、B 的可烧录 hex 都属于"纸面交付"：文档里写着 ✅，但**仓库里没有那个文件**。留档规范的目的不是"多存文件"，而是让**任何人都能用仓库里的原件复现结论**（本项目一贯做法：结论必须可回溯到原始记录）|
| 81 | ★★ **三个数一起读错：板框 100 × 65 mm / R5.0 / 3 个 ⌀3.2 mm —— "把半径当直径、把线宽当半径、把记录条数当孔数"**（2026-10-16 复核更正）—— 现象：`电路设计说明文档` §10.1（并被 `交接说明` §3.5/§7 沿用）记的是"**100 × 60 mm、圆角 R2.5 mm、4 个 ⌀1.6 mm 安装孔**"，而 **A2 的装配图/外壳开孔全靠这三个数**。复核用了**四路独立证据**：① EDA 完工快照 `PCB2.epcb2` 的 `BOARD_OUTLINE` 路径极值 ⇒ **100.00 × 65.00 mm**（`x∈[−6.000,94.000]`、`y∈[−58.908,6.092]` —— **同一行里本来就写着 65**）；四角 `ARC` 端点偏移 196.85 mil ⇒ **R5.0 mm**；**3 条** `path:["CIRCLE",cx,cy,62.9921]` ⇒ 半径 1.6 mm ⇒ **⌀3.2 mm**，孔心（以板左下角为原点）**(6.0,6.1) / (94.0,6.1) / (6.0,58.9)**，**右上角无孔**；② 下单 Gerber 的 `Gerber_BoardOutlineLayer.GKO`：外形 100×65、四角 R5、Circle 段 **3 个圆**；③ 嘉立创生产档：`ko` 100×65（圆弧 `I/J=196850` ⇒ R5）+ 钻孔档 **⌀3.25 × 3 孔、坐标逐孔吻合**；④ **PCB 渲染图按预测坐标逐处裁剪核对**：3 处有孔、右上角是 `R10` 阻容区无孔。**四处错因**（每一个单看都"像是量出来的"）：**(a)** 把 y 跨度 **65** 读成 **60**；**(b)** 把圆形图元的**线宽** `9.8425 mil (0.25 mm)` 当成**弧半径**；**(c)** 把 `["CIRCLE",x,y,r]` 的**半径** 62.9921 mil 当成**直径**（⇒ 误得 ⌀1.6 mm）；**(d)** 把 **4 条** `BOARD_OUTLINE` 记录（3 个圆 + 1 条圆角矩形路径）数成 **4 个孔**。 **教训**：几何量必须**回到原始记录的字段语义**再读（`CIRCLE` 的第三个数是半径；`width` 是描边宽，不是半径），并且**至少两路互证（设计档 vs 制造档）+ 一次视觉核对**；"数像是量出来的"不等于"读懂了字段"。**影响面**：`电路设计说明文档` §1/§10.1、`交接说明` §3.5/§6/§7、以及 A2 的装配图与开孔依据 —— 一律按 **100.00 × 65.00 mm / R5.0 / 3 × ⌀3.2 mm** 更新（给 A2 的版本见 [`design_hardware/上板测试记录.md`](design_hardware/上板测试记录.md) §5）|
| 82 | ★★ **真机只读复核（2026-10-16）："能打开端口"≠"链路通"；顺势修掉两处"看起来对"的工具/文档** —— ① **环境与数据**：有线 `COM3`（CH340）、固件 `0xAF`(10-15)、**车在非平衡位（俯仰 −79°）且已安全锁存** ⇒ 数据只证明"链路/协议/传感器/参数回读"是好的。实测：解帧 **611 / 丢帧 0**、格式错帧 0、协议外命令 0、重复帧 0；上行 `0x10/11/12` ≈ **14.8 Hz**、`0x14/15/16` ≈0.75 Hz、心跳 45 条；**观测模式实收 77 Hz**（标称 100）；参数 7/7 回读 = `300/1/+80/+0.4/0.5/52/0.5`；电源 **11.53 V**；**MQ-135 原始 ADC 122**（按分压比 0.600 反推 `AO ≈ 0.16 V`，落在"洁净空气 0.1–0.3 V"区间 ⇒ 模块在测、通路正确）、**MQ-2 原始 ADC 1**（`J10` 空）；DHT11 28.0 ℃ / 69 %RH。全部原始输出入库 [`hardware/test_records/`](../hardware/test_records/README.md)。 ② **蓝牙结论更正**：Windows **现已能枚举出 SPP 端口（`COM4`/`COM5`）**，但打开后 8 s **收 0 B** ⇒ 口径从"建不出 COM 口"改为"**端口可建、数据未通**"（旧说法会让人以为连端口都打不开）。 ③ **两处"看起来对"的缺陷（都已修）**：`tools/fw_prep/tune.py` 零穿越统计 **off-by-one**（`range(1, len(pitch))` 却访问 `pitch[i+1]`）⇒ 真机一跑就 `IndexError`（离线 `--selftest` 抓不到，因为 selftest 不跑统计）；`host/src/main.cpp` 的 `kFactory[]` 仍是旧定稿（`−80/−0.4/0/0`）⇒ 在**参数完全正确的板子**上打出四条"与定稿值不同"的**误导提示**。修后：`tune.py --selftest` 全过、`ctest` **7/7**。 ④ **待 B 确认**（本次只记录原始值，不下结论）：`0x16` 的 `Bal = −23916` 与 `0x10` 的俯仰 `−79.15°` **量级不一致**；**保护态下** `Moto = −8200` 而 `CCR = 471`（比值 0.057，与既有口径"期望 ≈1.17"差很远）却仍被判"✔ 已执行"。 **教训**：① **"端口打开成功"只是 OS 层面的事实**，链路通不通要看**有没有合法帧**（与铁律 43 同源：判据必须落在产物/数据上）；② **交付工具必须用真机数据回归** —— 表里的"期望值"一旦过期，就会在验收现场变成假的故障提示；③ 顺带确认了电机铭牌型号 **`MG513P3012V`**（同型号规格：额定 **1.44 A**、堵转 **4 A**、1.6 kg·cm、4 W），补上电源核算缺的那一格 |
| 83 | ★★ **隐私处理统一策略：含个人信息的交付物一律"双份"——仓库放脱敏版、仓库外留原件（提交作业用）**（2026-10-16，用户明确）—— 起因：A1 的交付件里**多处**含组员姓名，形态各不相同，只处理照片不够。按"**能不能脱敏**"分三类： ① **可脱敏 ⇒ 仓库放脱敏版 + 原件进 `…\260921Task_私有资料\作业补充\A1\_未脱敏原件\`**：**照片/渲染图**（丝印文字块打码，打码区域像素坐标写在 `photos/README.md`）、**Gerber GTO 丝印层**（按姓名块 bbox 删笔画 4523 点；逐行比对确认其余 **2730 行一字不差**）、**DXF**（删含姓名的 `TEXT` 实体，几何全保留）、**PDF 出图**（由已打码 PNG 重生成图片型 PDF）、**`.epro2` 工程包**（姓名**等字节长度**替换为"组员/组员甲/乙/丙"，`.epru` 字节数不变 ⇒ 结构不受影响）。 ② **不可靠脱敏 ⇒ 整体留仓库外**：嘉立创生产稿（内含 `.tgz`/`.ddw` 套封）、ODB++ 包（与 Gerber 同数据的另一格式）、含姓名/电话/地址的订单与送货单。 ③ **无需处理 ⇒ 原样入仓库**：`3D STEP`、贴片坐标、测试点、网表、IPC-356A、BOM、iBOM、板信息报告（**多编码全文检索姓名 0 命中**）。 **配套要求**：脱敏件与原件**都必须**在 README 里成对登记（**SHA-256 前 16 位 + 大小 + 原件位置**）并写清**脱敏手段与验证方式** —— 登记表见 [`hardware/gerber/README.md`](../hardware/gerber/README.md) §八、[`hardware/eda_export_20261016/README.md`](../hardware/eda_export_20261016/README.md) §四。 **教训/推广**：① **姓名会以三种形态藏在交付物里** —— 可搜索**文本**（DXF 的 `TEXT`、工程文件的文字对象）、**矢量笔画**（Gerber/ODB++/PDF 里的字形）、**像素**（照片与渲染图）；只按"能不能 grep 到"判断会漏掉后两类（第一轮只处理了照片）。② **脱敏必须可验证**：文本类"再搜一遍 0 命中"、几何类"bbox 内剩余点 = 0 且框外逐行一致"、像素类"目视复核"，三者都要在文档里留证据。③ **等长替换**是改"长度前缀/二进制"格式时的安全手法（字节数不变 ⇒ 不破坏结构）。 |
| 84 | ★★ **观测运行中的车，工具必须自己"保活'；而"统计量恒为 0"这种假绿比没有统计更危险**（2026-10-16 夜，真机观测中踩到并修掉）—— ① **`tune.py --observe` 会把正在平衡的车"探停"**：固件规定 **500 ms 无下行帧 ⇒ 安全锁存**，而 `--observe` 只在进/出观测模式时各发一帧 ⇒ **0.5 s 后车就被自己人锁停**，可工具**照常输出"姿态统计"**，把"电机已停、车被扶住"的俯仰（std 3.89°、峰峰 17.19°）当成平衡质量报出来 —— **最坏的一类错：数据看起来有、其实是无效的**。修法：新增 **`--keepalive`**（每 200 ms 发 `0x1F` 心跳：保活**不解锁**，用于看本来就停着的车）与 **`--enable`**（每 100 ms 发 `0x20 使能=1` 零速度：保活**并解锁**，**观测运行中的车必须加它**）；不加时工具会**打印警告**。真机验证：加 `--enable` 后 20 s 观测得到俯仰 **std 0.79°、峰峰 3.70°、摆动 ≈0.86 Hz**（有效），此前那次（无效）是 std 3.89°。 ② **"零穿越"统计恒为 0（假绿）**：原式用"一阶差分乘积 < 0"数局部极值，而 `0x10` 姿态与 `0x11` 运动都是 20 Hz、相邻两行常取到**同一个** pitch ⇒ 极值点两侧必有一个差分为 0 ⇒ 乘积 = 0 ⇒ **一次都数不到**（工具报"0 次 / 0.0 Hz"，而车明显在摆）—— 与铁律 42/43 同源：**判据必须能在真机上给出非零证据**。改用经典定义"**信号穿过均值线的次数**"（摆动频率 ≈ 过线次数/2/时长），并顺带修掉同一统计里的 off-by-one（`range(1, len(pitch))` 访问 `pitch[i+1]` 会 `IndexError`）。 ③ **真机顺带证实了一条既有口径**：`0x16` 的 **`CCR ≈ 1.17 × \|Moto\|`** —— 20 个"未保护"样点比例 **1.167–1.170**（中位 1.168）⇒ 口径成立；但**保护态下不成立**（锁存时 `Moto −8200→CCR 471`、`Moto −2055→CCR 838`）⇒ **该比例只能作"未保护"时的判据**（已列为待 B 确认项，见 [`design_hardware/上板测试记录.md`](design_hardware/上板测试记录.md) §6 第 9 项）。 **教训**：**"工具跑完没报错"不等于"数据有效"** —— 凡"观测/采集"类工具，都要先问一句"**我这次采集会不会把被测对象的状态改掉**"（本项目：不发帧 → 被锁存停车），并在数据文件命名/README 里标出**有效性**（无效的那次已按名保留为 `02_…_未加使能_车被锁存.csv` 当反例）。 |
| 85 | ★★ **A1 正式作业提交包：按任务书命名 + 按课程模板排版 Word/PDF**（2026-10-16，用户明确）—— ① **位置与命名**：提交包放仓库外 `…\260921Task_私有资料\正式作业提交\` 下的 **`<组长姓名>+<项目名称>\A1_电路\`**（外层目录名即任务书 §五 要求的“组长姓名+项目名称”；内含 **未打码/未脱敏原件**，正是决策 83“脱敏双份”的另一半）；件名统一为 `序号_内容_角色_版本_日期.扩展名`，并在 `00_A1_交付物清单（对照任务书）.md` 里给出“任务书要求 → 本包文件”对照表与“本包名 ↔ 仓库原名”映射。 ② **文档整合与排版**：`01_电路设计与测试说明文档` 由《电路设计说明文档》+《上板测试记录》+ 制造/Gerber 与 BOM/采购要点合并为一份（部分/节两级结构），并按老师给的《测控系统综合设计报告模板-2026.docx》**导出 Word 与 PDF 交付版** —— 封面沿用模板原样（只填项目名称/姓名/班级/学号/同组者/日期，并删掉模板里的“几点说明”教学段），**章标题黑体三号 / 节标题黑体四号 / 小节标题黑体小四 / 正文宋体小四 + 西文 Times New Roman + 1.5 倍行距 + 首行缩进 2 字符**（模板自述的格式要求），表格 `Table Grid` 且表头跨页重复，文末附原理图、PCB 出图与 4 张实物照片，正文节加居中页码。 ③ **两个必须记下来的渲染坑**（都属于“格式看着对、实际不对”）：**(a) 模板的 `Normal` 样式是“居中”的**（为封面服务）⇒ **凡新建正文样式必须显式指定对齐**，否则**整篇正文都会居中**（本轮第一版就是这样，靠页面预览才发现）；**(b) 本机没有“宋体/黑体/仿宋_GB2312”** ⇒ LibreOffice 直接转换时按替代字体排版，**中文宽度偏大、长行不换行而被纸边裁掉**（拿**未改动的原始模板**渲染对照，确认“不是我们改坏的”）；解法是用工具自带的**字体回退**（`--font-fallbacks '[["宋体","Noto Sans SC"],…]'`），字形与折行立刻正常 —— 先前那些“临时改字号 / 改对齐 / 手插换行”的补丁**全部撤掉**。 ④ **口径**：PDF 由本机渲染，分页与字形可能与该机 Word 不同（PDF **67 页**）⇒ **要完全一致的 PDF，请在装有中文字体的 Word 里“另存为 PDF”**（该说明写进了 `00_…清单` §三）。 **教训（可推广）**：**“照模板排版”要先验证模板自己的默认样式**（本项目：Normal 居中、字号 `szCs`、缺字体），否则“填进去就完事”会把正文带偏；**渲染验证必须拿“未改动的原件”做对照**，才能区分“我改坏了”与“这台机器渲染不了”。 | ⑤ **格式改定（同日晚）**：先按老师给的《测控系统综合设计报告模板-2026》排了一版，用户看后认为**封面/版式不好看** ⇒ 改为仿**用户自己的《专业生产实习报告》**样式（同一课程体系、标准报告版式）：**校徽放封面左上角**、页眉“横线 + 居中标题”（封面页只有横线）、**页脚“当前页 / 总页数”**（`PAGE`/`NUMPAGES` 域）、封面下划线信息表、**摘要 + 关键词**、**带点线引导与页码的目录**、章/节/小节 16/15/12 pt 加粗、正文宋体小四 1.5 倍行距首行缩进 2 字符（校徽直接从用户那份 docx 的 `word/media/image1.jpeg` 取出复用，并裁掉 3 px 灰边）。 **本轮又踩两个坑**：**(c) 目录页码不要用“TOC 域 + 预填文本”**——本机 LibreOffice **不更新 TOC 域**，PDF 里目录就是空的；正解是**给每个标题打书签 + 目录条目里用 `PAGEREF 书签名 \h` 域**，LibreOffice 与 Word 都能算出正确页码（实测目录页码 5/7/8/10/… 与正文一致）。 **(d) 域的 `begin / instrText / separate / 结果 / end` 必须各占一个 `w:r`**：全塞进同一个 run 时，LibreOffice 会把算出来的页码与缓存值**并排显示**（目录里曾出现 51/71/81 这类页码，就是 5 与缓存 1 黏在一起）。 **另**：markdown 转 Word 时，**同一自然段被硬换行拆成的多行必须合并成一段**（否则每行都成一个段落，两端对齐与首行缩进全乱）；各“部分”内部的标题层级也要**归一化**（合并稿里前两份文档的标题曾被整体降过一级，导致同级标题字号不一致、目录还漏条目）。 ⑥ **正文/附录拆分与可跳转目录（2026-10-16 夜）**：用户反馈“51 页偏厚”，并希望**目录能 Ctrl+点击跳转**。做法：**正文只留设计主线与测试结论**（第一部分 §1~§8、§10 + 第二部分 §1/§2/§3/§3.5/§6），**逐条判据、原始记录、接口定义表、制造数据、BOM、清单、附图 全部移入附录 A~E 并重新编号**（A.1、B.2…），**Markdown 整合稿保持未删节原样**，正文末尾写明“完整材料在哪” —— 实测：封面/摘要/目录 4 页 + 正文 28 页 + 附录 28 页 = 60 页，但**读者要看的正文只有 28 页**（结论都在正文里）。目录做成**可跳转**：每条目录 = `w:hyperlink w:anchor=书签`（Word 里 **Ctrl+点击跳转**），页码用 `PAGEREF 书签 \h` 域 —— 实测目录 39 条全部解析正确、无 `Error: Reference source not found`。**坑**：**目录顺序必须与生成顺序同源**（本轮出现过“目录与书签错位 ⇒ 附录 D/E 报引用源找不到”，原因是书签按生成顺序发、目录按另一个顺序列）⇒ 正确做法是先建**唯一的生成计划 items**，目录/书签/正文/附录生成全部按它走；另：部分标题之后、第一个二级标题之前的**引导段要单独处理**，否则会被当成一个“空标题小节”塞进附录，并产生无法解析的目录条目。  ⑦ **正文改“汇报体”、附录留证据（2026-10-16 深夜）**：用户指出“**我们不是讲解，是汇报 —— 汇报成果，别通篇解释哪里哪里的疑问**”。做法：**正文完全重写为汇报文字**（七章：项目概况与分工 / 电路设计成果 / 制板与采购成果 / 焊接与上板调试成果 / 真机测试数据 / 结论与后续 / 材料索引，**只给成果、结论与数据**），**“设计验证与已知偏差”“变更记录”“取材与溯源”等过程性章节不进报告**（保留在未删节的 md 与仓库文档里），证据类材料进附录 A~F ⇒ 全文 **27 页（正文 5 页 + 附录 19 页 + 封面/摘要/目录 3 页）**，比上一版 60 页、初版 58 页都短得多，且结论全在正文。 **⑧ 字体：我此前判断错了** —— 本机**有** 宋体/黑体/仿宋（`C:\Windows\Fonts\simsun.ttc`、`simhei.ttf`、`simfang.ttf`），上次“没找到”是因为我用了 `Select-Object -First 30`，把字母序靠后的 `sim*` 截掉了 ⇒ **结论错、做法也就多余**。正解：转换 PDF 时用工具自带的 **`--font-directory`** 指向只装了这几款字体的临时目录，LibreOffice 就按**真·宋体/黑体**排版（`missingFonts` 为空），字形与 Word 一致，不需要任何字体回退或字号补丁。 **教训**：① **“查不到”要先怀疑查询方式**（截断、过滤器、大小写、路径）再下结论；② 报告与仓库文档**受众不同** ——仓库要“可回溯的过程”，报告要“可读的成果”，同一批材料应当**两套写法**，而不是把过程记录直接搬进报告。  ⑨ **字体统一 + 压到 17 页（2026-10-16 深夜）**：用户要求“**标题黑体、正文宋体，不要乱七八糟的字体**”“**争取 20 页以内**”。做法：① **删掉一切非宋体/黑体字体**——行内代码与路径注解不再用 Consolas（改回宋体）、代码块改用宋体 10 pt、并把 python-docx 默认模板里残留的 `Courier` 引用（`styles.xml`/`stylesWithEffects.xml`/`fontTable.xml`）一并改写 ⇒ **全文只剩 黑体（标题）/宋体（正文与表格）/Times New Roman（西文）**，转换 PDF 时 `missingFonts` 为空。 ② **压页数（不做内容删减，只调排版）**：附录**连续排版**（原先每个附录都另起一页，5 个附录浪费近 3 页）、表格字号 10.5→8 pt 并把单元格上下边距压到 0、图缩到 原理图/PCB 10.5 cm、照片 7 cm、去掉与 `00_交付物清单` 重复的“附录 E 文件清单”（原附录 F 附图顺延为附录 E）⇒ **60 → 27 → 24 → 21 → 17 页**。 **教训**：页数的大头往往不是文字，而是**分页浪费 + 表格字号 + 图片尺寸**；“每个章节另起一页”这种排版习惯在短报告里非常费页。  ⑩ **去掉“主题字体”、表格改小四、内容再审（2026-10-16）**：用户三条意见 —— ①“**标题要黑体、正文要宋体，还是有那个所谓的（中文标题），我不需要**”：根因是 python-docx 默认模板的 `styles.xml` 里有 **72 处主题字体引用**（`w:asciiTheme="minorHAnsi"` / `w:eastAsiaTheme="minorEastAsia"` / `w:cstheme="minorBidi"` …），Word 字体框因此显示“（中文标题）/（中文正文）”；做法是**元素级**把主题属性替换成显式字体（同一个 `<w:rFonts>` 内已有显式属性时**只删主题属性、不重复添加**），并把 `theme1.xml` 的 `a:ea` 也改成宋体 ⇒ 引用数 **0**。 **两个必须记住的坑**：**(a)** 一开始用字符串直接替换，写出了“同一个 `<w:rFonts>` 里 `w:ascii` 出现两次”的**非法 XML**，LibreOffice 报 `loadComponentFromURL returned an empty reference`、python-docx 也打不开 ⇒ **改完 XML 必须做合法性校验**（ElementTree 解析 + python-docx 试开），否则会交付一个打不开的 docx；**(b)** 属性名大小写不一致 —— `cstheme` 是**小写 theme**，用 `endswith("Theme")` 判断会漏掉它（第一次清理后仍残留 72 处，就是这个原因）⇒ 判断要用 `lower().endswith("theme")`。 ② **表格字号也要小四（12 pt）**：已按 12 pt 排（表头加粗 + 底纹 + 跨页重复、单元格上下边距 0），并把“表格小四”写进 `00_A1_交付物清单` 的**格式要求表**（§3.1）。 ③ **内容再审**：摘要压到约 250 字；第四章删掉与第二章重复的三行；结论三条并成一段；材料索引 7 行并为 5 行；附录只留证据（A 去掉 60 针控制板座细则、B 只留逐项自检结论、去掉与清单重复的“文件清单”附录）。 最终 **20 页**（正文 5 页 + 附录 11 页 + 封面/摘要/目录 3 页），字体只剩 **黑体 / 宋体 / Times New Roman**。 
| 86 | ★★ **B（程序）提交包补齐：报告（含 7 张真流程图）+ 源码工程 + 离线核验工具 + 可烧录 hex；顺带更正一处过期结论与一处隐私泄漏**（2026-10-16）—— ① **报告**：把《程序说明文档》里的 **ASCII 流程图**换成**真正的流程图**（新增 [`tools/gen_flowcharts.py`](../tools/gen_flowcharts.py)：纯 PIL 画方框/菱形/箭头，只用黑体+宋体，不依赖 graphviz），共 **7 张**（分层与任务划分 / 上电初始化 / 控制中断 / 通信收发 / 气体采集与研判 / 巡检状态机迁移 / 解帧状态机），落在 [`design_firmware/图/`](design_firmware/图)；并按与 A1 **同一套格式要求**生成**汇报体报告 20 页**（黑体标题 16/15/12 pt · 宋体正文小四 · **表格小四** · 可 Ctrl+点击跳转的目录 · 页脚“当前页/总页数” · 全文只有黑体+宋体）。 ② **交付包**在仓库外 `<组长姓名>+<项目名称>\B_固件\`：`02_机器人程序工程/`（源码 211 个文件 + **`tools/fw_prep/` 离线核验工具** + `.hex/.bin/.map`）、`03_流程图/`、`04_通信协议/`（协议文本 + 冻结向量）、`05_测试与验证记录/`（离线核验输出 + 2026-10-15/16 真机日志 + 两种构建日志）。 ③ **归属决定：`tools/` 随包交付**（与 `firmware/` 同级摆放，脚本的相对路径假设不变）—— 报告引用的“离线核验 9 项”若不带工具，评委无法原地复跑，**证据链断在最后一公里**；依赖已写进清单（其中 8 项只需 Python + 本机 gcc，只有“交叉编译”那项需要 `arm-none-eabi-gcc`）。 ④ **更正一处过期结论**：`程序说明文档` §11 曾记“`USE_RTOS=0` 裸机对照**编不过**（`control.c` 的 `g_pwmApplied` 在裸机分支未定义）”，**2026-10-16 实测“`make clean && make USE_RTOS=0`”可编可通过**（Flash **49 504 B** / RAM **5 208 B**），已在 4 处改口径并附两种构建日志。 ⑤ **修掉一处隐私泄漏**：A1 阶段我把**组长真名**当作目录名写进了 `决策记录` 与 `上板测试记录` 两处**公开**文档，已改为 `<组长姓名>+<项目名称>` 占位符并复扫（姓名/学号 0 命中）。**教训：目录名里带真名会被顺手写进公开文档，一律用占位符。** |
| 87 | ★★ **C（上位机）审校：5 类事实错误 + 界面文案严谨精简 + 控制台编码统一**（2026-10-16）—— ① **事实错误 5 处**：**(a)** 界面把 `0x12` 标成 **5 Hz**（`overview_panel` / `patrol_panel` 两处），而协议 §三 ③ 与本文档写的是「与 `0x10/0x11` 同频（20 Hz）」⇒ 界面与自己的设计文档自相矛盾，已改；**(b)** 参数说明里 `Turn_Kp` 写「本机调试期定稿 0 / 未启用转向环」，与决策 78 已启用的 **52 / 0.5** 矛盾，已改；**(c)** `host/README` 的用例分解写成「链路 8 + 界面 11 + 告警 13 + 命令 13 + 记录 13」，与实测 **92 项**（协议 13 + 链路 9 + 领域 15 + 界面 12 + 告警 14 + 命令/保活 15 + 记录/回放/参数 14，QTest `Totals` 口径）不符，已改；**(d)** `软件设计说明` §2/§5.2/§5.4 写「链路 8 项、data 12 项」，实测为 **9 / 14**，已改；**(e)** `host/README` P1 验收步骤仍写 `4/4`，已注明现为 7/7。② **界面文案**：全仓抽出**真正显示给用户**的中文串（143 处调用点，**排除注释**），逐条收紧口语与含糊表述（「一口价」「剧情」「真车」「复盘」「没在跑」「别用别的工具占着串口」…）；`**粗体**` 在 Qt 标签与控制台里**不会变粗体、只会显示星号**（QLabel 走 AutoText，仅在含 HTML 标签时按富文本渲染）⇒ **所有可见串里的 `**` 一律去掉**（共 20 余处），改用「」或文字表述；状态位 LED「算了没执行」统一改叫**「未驱动」**（含 tooltip 与 CLI 输出）。③ **控制台编码**：`--help` 由 Qt 的 `showHelp()` 内部以**本地 8 位码（GBK）**打印，而自研输出是 **UTF-8** ⇒ 中文控制台必有一边乱码；改为启动时 `SetConsoleOutputCP(CP_UTF8)` + 自己用 **UTF-8 `QTextStream` 打印 `parser.helpText()`**（弃用 `parser.process()`，并在 `parse()` 失败时自己报错退出）。验证：真实 936 代码页控制台下 `--help` 与 `--selftest` 重定向到文件后**均 0 非法字符**；`ctest` **7/7**（92 项）复跑通过。 ④ **顺手记一条新铁律（45）**：本机 PATH 里的 `STM32CubeProgrammer\bin` 带**旧 `Qt6Core.dll`**，不把 Qt 6.11.2 的 `bin` 放最前就会加载旧 Qt，报「无法定位程序输入点」`0xC0000139` 并弹窗 —— **先查 PATH 顺序，不要怀疑代码**。 |
| 88 | ★★ **C（上位机）提交包补齐：报告 19 页 + 用户手册 15 页 + 源码工程 + 免装 Qt 便携版 + 证据**（2026-10-16）—— ① 报告与手册沿用与 A1/B **同一套格式要求**（黑体标题 16/15/12 pt · 宋体正文小四 · **表格小四** · 可 Ctrl+点击跳转的目录 · 页脚「当前页/总页数」· 全文只有黑体/宋体/Times New Roman），由同一套 md→docx 生成器产出，再用真字体导出 PDF（`missingFonts` 为空）。 ② 包内：`03_上位机程序工程/`（五层源码 + 7 套件单测 + `package.ps1` + QCustomPlot）、`04_可执行程序/上位机/`（**12 文件 / 37.4 MB 便携版**）、`05_界面截图/`（6 张，用真实窗口重拍）、`06_测试与验证记录/`（`ctest` 92 项、离线自检、真机只读探测、打包四项校验）。 ③ **实测口径固化**：附录 C 的用例清单由测试二进制 `-functions` + QTest `Totals` **现场生成**（13+9+15+12+14+15+14 = **92**），不再手抄 —— 上一轮文档里「链路 8 项 / data 12 项」就是手抄走样的结果（见决策 87）。 ④ 报告把「**保活只用心跳**」「锁存分级解除」「锁存期间入口禁用」「界面不代替固件判断能不能动」写成显式的**设计约束**，并给出反例（用使能 `0x20` 保活 = 每 200 ms 拆一次保护），便于答辩时直接引用。 |

---

> **项目归属**：中国石油大学（华东） 专业生产实习课程项目<br>
> **范围说明**：本项目不涉及 MiniBalance 控制板（STM32F405RGT6 版本）的硬件设计与改版；控制板直接沿用，A1 仅重做主底板。<br>
> **许可**：原创代码与文档采用 MIT License；第三方组件遵循各自原始许可证。
