pierrotto12138-code/balance-car-inspection-robot/docs/文档索引.md

# 文档索引

> 本项目全部文档的导航。
> **👤 人（新读者）** → [`handoff/交接说明.md`](handoff/交接说明.md)；
| **给 C 侧：固件接口与判读口径** | [`docs/handoff/给C侧_固件接口与判读口径.md`](handoff/给C侧_固件接口与判读口径.md) | B→C 接口交接：0x15/0x16 判读口径、负增益语义、保护状态、待办分配 |
> **🤖 AI 编码代理** → [`../AGENTS.md`](../AGENTS.md)。

## 📌 项目当前状态（2026-10-15）

| 阶段 | 状态 |
|---|---|
| 原理图（板「改」） | ✅ 完工 —— 104 元件 / 52 位号 / 65 网络 / 全有封装与料号 / DRC 致命 0 |
| PCB（板「改」） | ✅ 完工 —— 523 走线段 / 76 过孔 / **双面实心 GND 铺铜** / **DRC 零错误零未连接** |
| 打样与采购 | ✅ **全部到货、已焊好，进入真机联调**（2026-10-15 第二轮）|
| 真机台架 | 🔶 **只有 MQ-135，插在 `J13`**（`J10` 空、MQ-2 模块已烧毁待补）；DHT11 正常；电池 **11.8 V**；**OLED 正常显示**（页1/页2/厂商页）——"传感器全未就绪""OLED 乱码"等**旧现象均已解决** |
| 固件（B）/ 上位机界面（C） | ✅ **B：完成**（真机稳定平衡、出厂参数定稿）· **C：P0~P5 全部完成（C 部分收工）** —— 工程可用 GCC 构建出 `.hex`（**离线核验 9 项全通过**：协议 117 + 传感器 1235 + 状态机 80 + 调参 29 条断言 + `tune.py --selftest` + 交叉编译 + 向量表 + 中断安全 + 引脚基线；**Flash 约 66.5 KB / RAM 约 32.8 KB**）；上位机 `ctest` **7/7**（协议 13 + 链路 9 + domain 15 + 界面 12 + 告警 14 + 命令/保活 15 + 记录/回放/参数 14 = 92 项用例）、便携包 **12 文件 / 37.4 MB**；**真机 `--probe-readback` 已取回 7 个实际生效值**；**协议 v1.2 为当前版本**。★ 2026-10-15 收尾（现场反馈）：转向环启用（`Turn 52/0.5`）、前进档 110→150、**左右倾角/角速度上报**（加速度计静态角）、`0x16` 状态位 **bit3 = 固件特性位**（一眼判断板上是哪版固件）、遥控按住 10 Hz 重发、界面一屏自适应（免滚动条）|

最终渲染图：[`design_hardware/图/PCB2_最终.png`](design_hardware/图/PCB2_最终.png)

---

## 🎯 按用途查

### 🤖 给 AI 编码代理 → 看这份

| 文档 | 内容 |
|---|---|
| [`../AGENTS.md`](../AGENTS.md) | **★ AI 入场须知**：关键路径、EDA 桥接怎么起、**45 条踩坑铁律**、能力边界、常用命令、关键引脚速查 |

### 要动手改板 / 焊接调试 → 看这些

| 文档 | 内容 |
|---|---|
| [`design_hardware/原理图完善计划.md`](design_hardware/原理图完善计划.md) | **★ 活文档**：座序定义表、验收判据、**§6.5 完工终态**、风险与坑（施工过程已归档）|
| [`design_hardware/BOM表.md`](design_hardware/BOM表.md) | **★ A1 交付物**：主底板 BOM（**由完工快照离线导出**，52 位号 / 27 行 / 料号全覆盖），可直接下单或交作业；§四 附**实际下单与打样记录**（元件 `SO26101014446` + PCB `8942344A_Y2`）与 4 处料号差异判定 |
| [`design_hardware/上板测试记录.md`](design_hardware/上板测试记录.md) | **★ A1 交付物（焊接与测试）**：制板/采购 → 焊接（4 张实物照片索引）→ 上电与供电检查（区分实测/间接证据）→ 逐项自检结论 → **给 A2 的结构接口实测值（板框 100×65 / R5 / 3×⌀3.2）** → 8 项遗留待测 → 验收材料点名 |
| [`../hardware/gerber/README.md`](../hardware/gerber/README.md) | **★ A1 交付物（Gerber / 制造数据）**：下单 Gerber 的**脱敏版**（丝印姓名笔画已移除）；**工艺参数**（1.6 mm / 1 oz / 有铅喷锡 / 绿油白字 / 过孔盖油）、层与钻孔清单、板框几何五路互证、生产口径 vs 设计口径；**§八 隐私处理表**（脱敏件 ↔ 未脱敏原件位置与哈希）|
| [`../hardware/eda_export_20261016/README.md`](../hardware/eda_export_20261016/README.md) | **★ A1 交付物（制造/交付数据全套）**：EDA 一次性导出 —— **原理图出图 PDF/PNG/SVG**、**PCB 出图 PDF/PNG（已打码）**、Gerber（已脱敏）、飞针测试点、IPC-356A、网表、BOM、贴片坐标、测试点、**交互式 BOM**、**DXF（给 A2，姓名实体已删）**、**3D STEP（给 A2）**、工程导出包 `.epro2`（姓名已等长替换）；含"谁能用得上"对照表与 §四 隐私处理 |
| [`../hardware/test_records/README.md`](../hardware/test_records/README.md) | **★ A1 交付物（真机测试原始记录，2026-10-16）**：`tune.py` / `host.exe` 的 stdout + 观测 CSV；含链接统计（解帧 611/丢帧 0）、参数回读、安全锁存态、MQ 原始值与反推、蓝牙端口现状、以及 5 项"仍需人或场地"的清单 |
| [`../hardware/bom/采购记录_立创商城_SO26101014446.md`](../hardware/bom/采购记录_立创商城_SO26101014446.md) | **A1 附件**：立创商城 17 项采购明细（**只摘物料与金额，不含个人信息**），与 BOM 逐项对齐（闭合 `C18`/`C19` 料号存疑） |
| [`../hardware/photos/README.md`](../hardware/photos/README.md) | **A1 附件**：两批实物照片说明（新版底板实拍 = 焊接证据；厂商原板 = 改板前核对照）+ **丝印姓名打码说明（含打码区域坐标）** |
| [`design_hardware/上板自检清单.md`](design_hardware/上板自检清单.md) | **★ 焊接完成后按它逐项做**：上电前 → 上电 → 烧录（裸机/RTOS 对照）→ 界面 → 双链路 → 电机/姿态 → 平衡 → 标定 → 排障速查 |
| [`design_hardware/焊接调试手册.md`](design_hardware/焊接调试手册.md) | **★ 板子到货后按它焊**：飞线预案 + 验证清单 + 焊接要点 |
| [`design_hardware/改板规格书_单底板方案.md`](design_hardware/改板规格书_单底板方案.md) | 接口总表（**§三 已按实测重写**）、60 针映射、BOM 增量、待核实项 |
| [`handoff/交接说明.md`](handoff/交接说明.md) | **★ 总纲**：现状、决策、已核实事实、资产位置、踩坑、下一步 |
| [`../tools/README.md`](../tools/README.md) | **核查脚本清单**：桥接执行器、逐脚解算、防短路、PCB 总览、网表比对、渲染 + 使用须知 |

### 要写报告 / 答辩 → 看这些

| 文档 | 内容 |
|---|---|
| [`design_hardware/模块功能与原理说明.md`](design_hardware/模块功能与原理说明.md) | 各模块功能与原理（电源/驱动/传感器逐块讲解） |
| [`design_hardware/pin_assignment.md`](design_hardware/pin_assignment.md) | 引脚分配表（**以源码为准**，已与实物丝印互证） |
| [`protocol/communication_protocol.md`](protocol/communication_protocol.md) | 通信协议 **v1.2**（帧格式、上行/下行帧、事件码、§3.4 `0x15` 诊断 / §3.5 `0x16` 三环实况 / §3.6 `0x20` 运动 / §3.8 `0x24` 范围校验） |
| [`protocol/test_vectors.json`](protocol/test_vectors.json) | **★ 协议测试向量**（CRC 4 + 帧 12 + 流式 6）—— B/C 双方实现必须逐条复现（决策 36） |
| [`design_firmware/architecture.md`](design_firmware/architecture.md) | 固件架构（混合式：中断 + FreeRTOS 任务划分） |
| [`design_firmware/B阶段开工准备.md`](design_firmware/B阶段开工准备.md) | **★ B 阶段开工准备**：工具链/基线/FreeRTOS/CRC 四项核验实测、引脚差异表、待拍板决策点、工作分解 |
| [`../host/README.md`](../host/README.md) | **C 的代码说明**：构建与测试命令、**没有板子时怎么用假源开发**、真机只读探测 `--probe-readback`、录制与回放、调参页用法 |
| [`design_host/C部分方案与计划.md`](design_host/C部分方案与计划.md) | **★ C 部分开工看这份**：GitHub/公开资料调研（Serial Studio、ISA-101、QCustomPlot 取舍）+ 技术选型定案 + 五层模块规划 + 线程/数据模型 + UI 布局与配色规范 + **P0~P5 计划与验收判据 + 各阶段完成记录（§十三~§十七，含真机接口对齐发现）** |
| [`design_host/软件设计说明.md`](design_host/软件设计说明.md) | **★ C 交付物（软件设计说明）**：需求→实现→**验收证据**对照表、五层架构与依赖方向、线程与数据流、模块清单、关键决策、协议一致性表（含实测偏差）、界面规范、测试策略与证据、构建与打包、已知边界 |
| [`design_host/用户操作手册.md`](design_host/用户操作手册.md) | **★ C 交付物（用户操作手册）**：便携版怎么跑、第一次连真机（含 DTR/RTS 坑）、逐页截图与看点、记录/回放/截图、3 分钟无硬件演示、**故障排查表**、安全须知、命令行速查 |
| [`design_host/演示脚本.md`](design_host/演示脚本.md) | **C 交付物（演示脚本）**：**5 分钟分镜表**（时间/操作/预期现象/要讲的话）+ 1 分钟精简版 + 降级备用方案 + 演示前 30 秒自检 |
| [`design_firmware/编码规范.md`](design_firmware/编码规范.md) | **★ 写代码前先看**：分层与依赖方向、"只有一个真相"、可测试性、中断与并发、命名规范、提交前自检（`make strict`）|
| [`design_firmware/程序说明文档.md`](design_firmware/程序说明文档.md) | **★ 程序设计说明文档**（任务书 B 交付物）：总体结构、任务划分、关键流程图、协议实现、算法、安全机制、离线验证与烧录 |
| [`design_firmware/图/`](design_firmware/图) | **★ B 报告的 7 张流程图**（软件分层与任务划分 / 上电初始化 / 控制中断 / 通信收发 / 气体采集与研判 / 巡检状态机迁移 / 解帧状态机）；由 [`../tools/gen_flowcharts.py`](../tools/gen_flowcharts.py) 生成，被 `程序说明文档.md` §4 与 B 的提交报告引用（替代原 ASCII 流程图）|
| [`任务书_提取全文.md`](任务书_提取全文.md) | 已提交任务书的纯文本（便于检索） |

### 要理解项目来龙去脉 → 看这些

| 文档 | 内容 |
|---|---|
| [`handoff/交接说明.md`](handoff/交接说明.md) | **★ 总纲**：现状、决策、已核实事实、资产位置、踩坑、下一步 |
| [`决策记录.md`](决策记录.md) | 全部已定型决策 + 方案演进史（阶段一→二→三） |
| [`design_hardware/car_composition.md`](design_hardware/car_composition.md) | 整车三层结构解析（底板/控制板/插接模块） |

### 📦 历史归档（`archive/`）—— 过程记录，不是当前交付物

| 文档 | 内容 |
|---|---|
| [`archive/README.md`](archive/README.md) | **归档说明**（为什么归档、当前有效文档在哪） |
| [`archive/原理图完善_施工过程.md`](archive/原理图完善_施工过程.md) | 原理图完善的 **§二 7 个施工阶段**（已全部执行完） |
| [`archive/实物核对拍照清单.md`](archive/实物核对拍照清单.md) | 当时待拍照核实的项（已完成） |

### 调研记录（阶段二遗留，部分仍有效）

| 文档 | 内容 | 是否仍有效 |
|---|---|---|
| [`research/MQ气体传感器开源实现.md`](research/MQ气体传感器开源实现.md) | MQ 算法与标定（`ppm=a·(Rs/R0)^b`） | ✅ 与平台无关 |
| [`research/相似开源方案调研.md`](research/相似开源方案调研.md) | 上位机/协议/状态机参照 | ✅ |
| [`research/github_repos.md`](research/github_repos.md) | 候选仓库清单 | 🔶 基底已换，仅供参考 |
| [`research/Agent接入EDA方案.md`](research/Agent接入EDA方案.md) | EDA API 桥接方案 | ✅ 桥接仍可用 |
| [`research/Agent接入EDA实测验证.md`](research/Agent接入EDA实测验证.md) | 桥接实测记录（含 API 能力边界） | ✅ **2026-09-30 起能力大幅扩展：原理图可全自动改** |
| [`design_hardware/sensor_interface_notes.md`](design_hardware/sensor_interface_notes.md) | 传感器接入通用电气注意 | ✅ 与基底无关 |
| [`archive/实物核对拍照清单.md`](archive/实物核对拍照清单.md) | 待拍照核实项 | 🔶 部分已完成 |

---

## 📁 目录结构

```
<仓库根>\
├── README.md                     项目总览
├── archive/                      阶段一/二 方案归档 zip
├── docs/
│   ├── handoff/交接说明.md        ★ 总纲（新对话先读）
│   ├── 文档索引.md                本文
│   ├── 决策记录.md               全部定型决策（1–64 条）
│   ├── 任务书_提取全文.md          已提交任务书纯文本
│   ├── task/                     课程任务书原文、分组统计（只读）
│   ├── proposal/                 项目计划书
│   ├── setup/                    环境配置、开发环境准备清单、实验室模块照片
│   ├── archive/                  📦 历史归档（施工过程、往届清理记录）
│   ├── design_hardware/          ★ 硬件设计文档
│   │   ├── 原理图完善计划.md       ★ 活文档（含 §6.5 完工终态）
│   │   ├── 焊接调试手册.md         动手/焊接调试看这个 ★ 到货后按它焊
│   │   ├── 改板规格书_单底板方案.md
│   │   ├── 模块功能与原理说明.md
│   │   ├── pin_assignment.md
│   │   ├── car_composition.md
│   │   ├── sensor_interface_notes.md
│   │   └── 图/                    ★ PCB 渲染图（PCB2_最终.png）
│   ├── design_firmware/          架构 / B 阶段开工准备 / 程序说明 / 编码规范 / **真机联调问题清单**
│   ├── design_host/              C 部分方案与计划、软件设计说明、用户操作手册、演示脚本、界面截图
│   ├── protocol/communication_protocol.md   （+ test_vectors.json/.tsv）
│   └── research/                 调研记录
├── hardware/
│   ├── 硬件工程_完工版_20261008_最终/   ★ 完工时点的 EDA 工程完整快照（本地保留，被 gitignore）
│   ├── gerber/                     ★ A1 交付物：Gerber/制造数据（**脱敏版** + 工艺参数；原件在仓库外）
│   ├── eda_export_20261016/        ★ A1 交付物：EDA 一次性导出全套（PCB 出图、STEP、DXF、iBOM、坐标、网表…）
│   ├── test_records/               ★ A1 交付物：真机测试原始输出（tune.py / host.exe + 观测 CSV）
│   ├── bom/                        BOM CSV + 实际采购记录
│   ├── photos/                     实物照片（新版底板实拍 + 厂商原板核对；见其 README）
│   ├── _参考存档/                 往届原始文件 + OEM/开源原理图渲染图
│   ├── clean_eprj3.py / clean_eprj3_meta.py / clear_eda_cache.py
│   │   / fix_eprj3_terminator.py / sch_netlist.py    EDA 辅助脚本
│   ├── _oem_pdf/                  OEM 原理图渲染图（核对端口用）
│   ├── _epro_pdf/                 开源方案原理图渲染
│   ├── photos/                    实物照片 + 4 块拓展板 PDF
│   ├── schematic/                原车各模块原理图 PDF
│   ├── pcb/                       原车各模块 PCB 文件
│   └── mechanical/                ★ A2 交付物：SolidWorks 整车装配（2026-10-17，见其 README）
├── firmware/                     ★ B：STM32 固件（GCC + Makefile，可构建 .hex）
│   ├── App/                      Comms（协议/环形缓冲）· Sensor（MQ/DHT11/ADC）
│   │                             Task（状态机 + 4 个 FreeRTOS 任务 + 只读 API）
│   │                             Control（三环 PID，厂商）+ Config（集中配置）+ Ui（蜂鸣器）
│   ├── Drivers/ CMSIS · FWLIB · BSP      Middlewares/FreeRTOS（V11.1.0）
│   ├── System/ sys · delay（DWT）· usart（printf + 有线链路）· retarget
│   ├── User/ main · FreeRTOSConfig.h · rtos_hooks · stm32f4xx_it
│   ├── tests/ 4 套原生单测（协议/传感/状态机/参数打包）
│   └── README.md                 构建 · 核验 · 烧录 · 两条链路与调参流程
├── host/                         C：Qt 上位机（ctest 7/7；package.ps1 一键打包便携目录）
├── tools/                        EDA API 桥接 + 核查脚本（`fw_prep/` 为固件核验脚本）
└── Base/                         学校原始资料（只读，不进版本控制）
    ├── 高配版平衡小车附送资料（STM32F405RGT6）/   ★ 厂商全套资料
    ├── easyeda-bridge/           EDA API 桥接
    └── 开源参考/                  已归档
```

**EDA 工程**（在用户文档目录，不在本仓库）：

```
%USERPROFILE%\Documents\LCEDA-Pro\projects\
├── 参考01_copy\                  ★★ 工作工程 —— 唯一有效来源
│   ├── 板「改」   = Schematic2  + PCB2     ★ 最终版（523 走线 / 76 过孔 / 双面铺铜 / DRC 0）
│   ├── 板「原」   = Schematic1  + PCB1     往届参考
│   └── 板「改_1」 = Schematic2_1+ PCB2_1   A1 的工作副本
└── 26测控系统设计\                ★ 板「改」的独立工程副本（交作业用）
```

> ⚠️ **EDA 工程索引（`.eprj3`）会不同步**：复制/删除板子后必须 `Ctrl+S` 并**关掉工程重开确认**。
> 本项目踩过一次 —— 关闭时**没保存的 144 段走线全丢**（文件级备份救不回）。
> **铁律：改一段存一次；重要节点另存快照。**

---

## 🔧 常用命令速查

### 固件（B）：构建与一键核验

```powershell
cd <仓库根>/firmware
make                     # 默认带 FreeRTOS；产出 build/MiniBalance.hex（FlyMcu 烧录）
make USE_RTOS=0          # 纯裸机对照（⚠️ 当前此类目编不过，见 firmware/README.md §六）
make size                # Flash / RAM 占用（当前约 66.5 KB / 32.8 KB）
make clean && make strict  # 严格告警：自研代码须 0 条 —— **必须先 clean**，否则增量编译下报"0 条"是假绿

cd <仓库根>
$env:PYTHONIOENCODING="utf-8"            # GBK 控制台下必须设，否则汇总表编码报错
python tools\fw_prep\run_all_tests.py    # ★★ 一键 9 项：4 套原生单测 + tune 自检 + 交叉编译 + 向量表 + 中断安全 + 引脚基线
python tools\fw_prep\bt_scan.py          # 蓝牙/串口端口自动识别（按合法帧判定）
python tools\fw_prep\bt_at.py            # 蓝牙模块 AT 配置（自动探波特率与方言）
```
> 详细说明（两条链路、有线 PID 调参流程、已知问题）见 [`../firmware/README.md`](../firmware/README.md)。

### 启动 EDA API 桥接

```bash
cd D:/260921Task/Base/easyeda-bridge/easyeda-api-skill
nohup node scripts/bridge-server.mjs > /tmp/eda-bridge.log 2>&1 &
curl -s http://127.0.0.1:49620/health     # edaConnected 需为 true
```

### 执行 EDA 内代码

```bash
curl -s -X POST http://127.0.0.1:49620/execute \
  -H "Content-Type: application/json" \
  -d '{"code":"var a=await eda.pcb_PrimitiveComponent.getAll(); return String((a||[]).length);"}'
```

### EDA 辅助脚本

```bash
cd D:/260921Task/hardware
python clear_eda_cache.py --project "<.eprj2 路径>"      # 清物化缓存（EDA 须关闭）
python fix_eprj3_terminator.py --project "<工程目录>"     # 补末行 |（导出后必跑）
python clean_eprj3.py --project "<工程目录>"             # 预演；加 --apply 执行
python clean_eprj3_meta.py --project "<工程目录>"
```

### 渲染原理图 PDF 为图片

```python
import pymupdf
doc = pymupdf.open(r"<PDF 路径>")
pix = doc[0].get_pixmap(matrix=pymupdf.Matrix(3, 3), alpha=False)
pix.save(r"<输出 PNG>")
```

---

## ⚠️ 三条铁律（踩过坑的）

1. **EDA 打开工程时会覆写磁盘文件** → 改板必须在 **EDA 界面里**做，或先关 EDA 再改文件。
2. **`.eprj2` 的"绿字"只在 EDA 缓存里**，`.eprj2` 文件本身是干净的 → 清缓存必须**关掉 EDA**。
3. **从 `.eprj2` 导出 `.eprj3` 后，检查 PCB 文件末行是否以 `|` 结尾** → 否则底层覆铜会丢。

详见 [`handoff/交接说明.md`](handoff/交接说明.md) §5。

---

> **项目归属**：中国石油大学（华东） 专业生产实习课程项目<br>
> **范围说明**：本项目不涉及 MiniBalance 控制板（STM32F405RGT6 版本）的硬件设计与改版；控制板直接沿用，A1 仅重做主底板。<br>
> **许可**：原创代码与文档采用 MIT License；第三方组件遵循各自原始许可证。
