pierrotto12138-code/balance-car-inspection-robot/docs/handoff/交接说明.md

# 项目交接说明（2026-09-29）

> **本文用途**：汇总本项目全部已确认的事实、决策、资产位置与待办，
> 供后续对话/AI 助手**快速接续**，无需重读历史。
>
> **阅读顺序建议**：先看 §1 现状 → §2 硬件改动 → §3 已核实事实 → §5 踩坑 → §7 下一步。

---

## §1 项目现状

### 1.1 基本情况

| 项 | 内容 |
|---|---|
| 课程 | 测控系统综合设计（3 周实践，测控 2302 班） |
| 选题 | **基于平衡小车的仓储环境安全巡检机器人**（自主命题） |
| 团队 | 4 人：**A1 电路 · A2 结构 · B 程序 · C 系统**（组长由 C 担任）|
| 技术基线 | **MiniBalance V5.0 高配版**：保留 STM32F405RGT6 控制板 + TB6612/电压检测拓展板，**重做底板** |
| 传感器方案 | **MQ-2 + MQ-135（双通道交叉验证）+ DHT11**，红外避障×2、HC-SR04、蓝牙 SPP |
| 里程碑 | 第 5 天方案检查 / 第 10 天子系统完成 / 第 14 天联调 / **第 15 天验收+个人答辩** |

### 1.2 关键决策（已定，勿反复）

| # | 决策 | 说明 |
|---|---|---|
| 1 | **任务书不重新提交** | 已提交版本；其中 7 处与实际不符（详见 §3.6），**改为在报告/答辩中说明** |
| 2 | **单底板方案** | 不另做传感器转接板；分压电阻直接做在底板上 |
| 3 | **AI 自动改板已放弃** | 实测不可行（详见 §5.4），改板走**手工** |
| 4 | 平衡控制**保留在 MPU6050 中断**（5ms/10ms 节拍不变），新增功能进 FreeRTOS | 不冒险动已调好的平衡时序 |
| 5 | 姿态算法 = **卡尔曼滤波** | 厂商默认 + 实车确认 |
| 6 | 通信 = 自研协议 `0xAA55+命令字+长度+CRC16/MODBUS`，经典蓝牙 SPP 115200 8N1（**若蓝牙建不出 COM 口则用有线链路**）| **协议 v1.2 为当前版本**（v1.1 冻结 + `0x15`/`0x16` 增量） |
| 7 | 上位机 = **Qt 6 C++ + CMake** | **C 部分收工（P0~P5）**：`ctest` **7/7**（协议 13 + 链路 9 + domain 15 + 界面 12 + 告警 14 + 命令/保活 15 + 记录/回放/参数 14 = 92 项用例，2026-10-16 实测）；便携包 **12 文件 / 37.4 MB**；真机 `--probe-readback` 已取回 7 个实际生效值 |
| 8 | 主链路用 **Rs/R0 相对量**做交叉验证，ppm 作估计值展示 | 绝对浓度精度不可靠 |
| 9 | 蜂鸣器用**有源模块**（新增 `J18`，`PC5` 直连，**低电平响**） | ⚠️ **2026-10-09 修正**：本条原写"无源、需 PWM"，与决策 26 的**实测结论**（有源、低电平触发、5V）冲突，且与本文件 §7"B — 固件"第 3 条自相矛盾。**以决策 26 为准**，固件极性 = **低电平响** |

### 1.3 底板工程当前状态

**工作工程**：`%USERPROFILE%\Documents\LCEDA-Pro\projects\参考01_copy`（`.eprj3` 文件夹格式）

工程里有**三个 board**：

| Board | 名称 | 原理图 | PCB | 内容 |
|---|---|---|---|---|
| `403fbd5918271263` | **原** | Schematic1（108 元件） | PCB1（49 元件，**原始未动**） | 往届底板原样 + 15 条模块标注 |
| `b46a7b3bb4340c01` | **改** ★ | **Schematic2（104 元件 / 52 位号 / 65 网络）** | **PCB2（★ 已完工）** | **唯一有效版本** |
| — | **改_1** | Schematic2_1 | PCB2_1 | A1 的复制工作副本（参照用） |

另有一份独立工程：`projects\26测控系统设计\`（板"改"的副本，交作业用）。

**"改"板最终状态（2026-10-08）**：

| 项 | 结果 |
|---|---|
| **原理图** | ✅ 完工 —— 104 元件 / 52 位号 / **65 网络**；**52 个位号全部有封装与立创料号**；DRC 致命错误 0 |
| **PCB** | ✅ **完工** —— **523 走线段 / 76 过孔 / 双面实心 GND 铺铜**；**DRC 零错误、零未连接** |
| 线宽 | 电机与 12V 主干 40~80 mil；+5V/+3.3V 25 mil；模拟 12 mil；信号 10 mil |
| 渲染图 | `docs/design_hardware/图/PCB2_最终.png` |
| **当前阻塞** | ✅ **已全部解除** —— 板子与元器件**已到货、已焊好**，并完成**两轮真机联调**（2026-10-13 / 10-15）|

**位号变更（务必注意）**：

| 旧位号 | 新位号 | 说明 |
|---|---|---|
| `J3` / `J4` | **`CN1` / `CN2`** | 换成 6P XH 座 `LAIL-PHC2.54-6P-01-XH-L`（`C54905977`）|
| `J17` | 不变 | 器件换成 **`AM-1015B-M`**（`C90631`）——**12V 电源输入座**（此前文档误写成"开关输出"）|
| `SW2` | 不变 | 器件换成 **`SS-12D10L5`**（`C319012`）三脚拨动开关 |

> ⚠️ **`CN1`/`CN2` 的 pin2/pin5 已按实物丝印修正**（`G` 与 `5V` 对调）——
> 照原板座序插电机会把编码器反极烧毁。详见《决策记录》决策 32。

**备份**：

- **`hardware\硬件工程_完工版_20261008_最终\`** —— ★ **完工时点的完整工程快照**（MD5 与当前工程一致）
- `projects\参考01_copy_backup\*.epro2` —— EDA 自带的每小时备份（最新一份可能较旧）
- **铁律：EDA 里改一段就 `Ctrl+S`** —— 工程索引（`.eprj3`）会不同步，
  且**没落盘的改动会随关闭彻底丢失**（本项目丢过一次 144 段走线）

---

## §2 ★ 硬件改动清单（A1 改板的核心依据）

### 2.1 本项目要用的接口（★ 座序已于"改"板重排，下表为**最终状态**）

| 模块 | 插座 | 引脚 1→n 的网络 | 改动 |
|---|---|---|---|
| **MQ-2** | **J13**（4 针） | `MQ2_AO / PB3(DO) / GND / +5V` | ★ **座序按模块丝印重排** + R10/R11 分压 |
| **MQ-135** | **J10**（4 针） | `MQ135_AO / PC3(DO) / GND / +5V` | ★ **3 针→4 针、座序重排** + R12/R13 分压 |
| **DHT11** | **J9**（3 针） | `GND / +3.3V / PA7` | ★ **座序重排（原直插会反极）** + R14 4.7k 上拉 |
| 红外避障 L | **J11**（3 针） | `+5V / GND / PB12` | ★ 座序重排 + 信号由 PA4 改 PB12；**不装排针（DNP）** |
| 红外避障 R | **J14**（3 针） | `+5V / GND / PC1` | ★ 座序重排；**不装排针（DNP）** |
| HC-SR04 | **J5**（4 针） | `+5V / PC4(TRIG) / PB0(ECHO) / GND` | ★ **TRIG·ECHO 原来是反的，已改序** |
| 蓝牙 | **J7**（6 针） | `NC / PA2 / PA3 / GND / +5V / NC` | ★ **座序重排**（原直插会把 5V→PA2、GND→PA3）|
| 蜂鸣器 | **J18**（3 针，新增） | `+5V / PC5 / GND` | ★ **有源模块，PC5 直连**（不用 `BZ1+Q1`）|
| 电源输入 | **J17**（2 针） | `电源正 / GND` | ★ **是输入座**（原文档误写成"开关输出"），经 `SW2` 后成板内 `+12V` |
| OLED | **控制板上的 6 针座** | `PC0/PC13/PC14/PC15` | 底板无此座 |
| 传感器取电 | **J15**（12 针） | `+5V/GND` 交替 ×6 | 已集成 |

> **为什么要重排座序**：`复制粘贴` 会把"原"板的旧顺序带过来。
> 逐座核对模块丝印后发现 **8 处**会导致「5V 直灌 3.3V 脚」或「反极」等**会烧板**的问题，故全部改序。
> 依据 = §6.2 的接线体检 + 模块丝印实测。

#### 2.1.1 ★ "模块 → 接口"对照（**常被数错**）

**板上共 14 个连接器，但只有 8 个是"模块座"** —— 另外 6 个是结构 / 电源 / 电机接口。

| 类别 | 数量 | 位号 | 用途 |
|---|---|---|---|
| **模块座 · 模拟** | 2 | `J13` `J10` | MQ-2 / MQ-135（含分压）|
| **模块座 · 数字** | 3 | `J9` `J7` `J18` | DHT11 / 蓝牙 / 蜂鸣器 |
| **模块座 · 避障** | 3 | `J5` `J11` `J14` | 超声波 / 红外L / 红外R |
| **控制板插座** | 2 | `J1` `J2` | 2×15 + 2×15 = **60 针**，STM32 控制板直接插 |
| **电机接口** | 2 | `CN1` `CN2` | 电机 A/B 的**电机线 + 编码器线** |
| **电源** | 2 | `J17` `J15` | 12V **输入**座 / 5V-GND **取电排** |

> **常见数错**：把 6 个"模块"数成 6 个座 —— 实际是 **8 个座**，因为
> **红外是 2 个座（L/R）**，外加**超声波 1 个座**
> （任务书里"**HC-SR04 与红外模块**负责避障与循迹"是明确要求的）。
>
> **"原"板有 17 个连接器**，改板**已精简**：删 `J6`/`J8`/`J12`/`J16`，
> `J3`/`J4`→`CN1`/`CN2`，新增 `J18` → **17−4−2+2+1 = 14**。

#### 2.1.2 不装排针的座（DNP，见决策 30）

| 位号 | 状态 | 原因 |
|---|---|---|
| **`J11`** 红外避障 L | **保留焊盘，不装排针** | A1 只买了 1 个红外模块，且判断**超声波避障已足够** |
| **`J14`** 红外避障 R | 同上 | 同上 |

**为什么保留而不删**：① 任务书里"**HC-SR04 与红外模块**负责避障与循迹"是明确写了的；
② **删掉容易、加回来贵** —— PCB 阶段删了，以后要用就得改原理图 + 重画 PCB + 重新打板。
**保留焊盘零成本、可逆。**

> 副作用：`PB12`（原红外L）、`PC1`（原红外R）两个 IO 因此**空闲**，可用于后续扩展。
> 同理 `J15`（取电排）也可以**先不焊**，不影响功能。

### 2.2 必须新增的 5 只电阻

```
MQ-2   J13.4 ──┬──[R10 10k]──┬── PA5 (ADC)      ← J2.15
               │             │
               │          [R11 15k]
               │             │
               │            GND（就近打过孔到地平面）
            (原始信号 MQ2_AO)

MQ-135 J10.3 ──┬──[R12 10k]──┬── PA6 (ADC)      ← J2.16
               │             │
               │          [R13 15k]
               │             │
               │            GND

DHT11  J9.2 ───┴───────────────── PA7           ← J2.17
                                  ↑
                               [R14 4.7k]
                                  ↑
                                +3.3V (J9.1)
```

| 位号 | 阻值 | 封装（最终） | 器件 / 立创编号 | 一端 | 另一端 |
|---|---|---|---|---|---|
| R10 | **10 kΩ** | **0805** | `RC0805BR-0710KL` / **`C6752026`** | `MQ2_AO`（J13.1 侧） | `PA5`（ADC 侧） |
| R11 | **15 kΩ** | **0805** | `CRG0805F15K` / **`C3929039`** | `PA5` | `GNDREF` |
| R12 | **10 kΩ** | **0805** | `RC0805BR-0710KL` / **`C6752026`** | `MQ135_AO`（J10.1 侧） | `PA6`（ADC 侧） |
| R13 | **15 kΩ** | **0805** | `CRG0805F15K` / **`C3929039`** | `PA6` | `GNDREF` |
| R14 | **4.7 kΩ** | **0805** | `RMC08054.7K1%N` / **`C269746`** | `PA7` | `+3.3V` |

> ✅ **已完成**（2026-09-30 由 API 放入并接线，逐脚核验通过）。
> 另外还补了去耦：`C14/C15`（`PA5`/`PA6` 对地 0.1µF）、`C16/C17`（`+5V` 对地 0.1µF）、`C18/C19`（`+5V` 对地 100µF）。

**原理**：MQ 在 5V 下 AO 最高接近 5V，STM32 ADC 上限 3.3V，**直连会击穿引脚**。
分压比 `15/(10+15)=0.6`，5V → 3.0V，留余量。

### 2.3 ★ 原理图改法的关键（最容易搞错）

**本原理图的网络靠"网名"连接**（网名挂在导线上，同名即同网）。

```
改前:  J13.4 ─────直连───── J2.15        两边都叫 PA5  → 5V 直进 MCU，会烧
改后:  J13.4 ─[MQ2_AO]─[R10]─[PA5]─ J2.15
                ↑改名            ↑不动
```

**必须：座子侧改名，控制板侧不改名。** 两侧都改 → 网断了读不到值；都不改 → 电阻被短路，烧引脚。

**操作**（3 步）：
1. 把 `J13.4` 那条线的网名 `PA5` → **`MQ2_AO`**；`J10.3` 的 `PA6` → **`MQ135_AO`**
2. 放 5 只电阻（建议放原理图左下方空白区）
3. 给每个脚画短导线并填网名（同名自动连通，**不必真连线到控制板**）

> **详细操作**见 `docs/design_hardware/焊接调试手册.md`（含 PCB 4 步 + 飞线预案 + 验证清单）

### 2.4 供电核算（够用）

| 负载 | 电流 |
|---|---|
| 两路 MQ 加热丝 | ~300 mA @5V |
| 控制板+OLED+蓝牙+超声波+编码器 | ~100 mA @5V |
| **5V 合计** | **~400 mA**（LM2596 输出 3A，余量充足） |

**结论：不需要额外降压支路。** MQ 加热丝就近加 100µF+0.1µF 去耦。

---

## §3 ★ 已核实的硬件事实（有出处，可直接写进报告）

### 3.1 MCU 引脚占用（源码为准，已与实物丝印互证）

| 功能 | 引脚 | 功能 | 引脚 |
|---|---|---|---|
| 左编码器 A/B | **PA0 / PA1** | 右编码器 A/B | **PB6 / PB7** |
| 蓝牙 TX/RX | **PA2 / PA3** | 调试串口 | PA9 / PA10 |
| 电机 B PWM | **PA8** | 电机 A PWM | **PA11** |
| 电机 B 方向 | **PA12 / PB4** | 电机 A 方向 | **PA15 / PB5** |
| 超声波 ECHO | **PB0** | 超声波 TRIG | **PC4**（板上）／PC2（源码） |
| 电池电压 ADC | **PB1** | 软件 I2C（MPU6050） | **PB10(SCL) / PB11(SDA)** |
| 板载 LED | PB13 | 用户按键 | PB14 |
| **MPU6050 INT** | **PB15** | OLED | **PC0(DC)/PC13(SCL)/PC14(SDA)/PC15(RST)** |
| 蜂鸣器 | **PC5** | SWD（不可占） | PA13 / PA14 |

**空闲 ADC 引脚**：PA4、PA5、PA6、PA7、PC1、PC3、PC4、PC5
**空闲数字 IO**：PB2、PB3、PB12、PC1、PC3、PC4、PC5、PC8–PC12、PD0–PD2

### 3.2 60 针控制板接口（**三方互证 + 与 OEM 底板逐行核对一致**）

**J1（30 针）**

| 脚 | 网络 | 脚 | 网络 | 脚 | 网络 |
|---|---|---|---|---|---|
| 1 | PB9 | 11 | PC10 | 21 | PA8 |
| 2 | PB8 | 12 | PA15 | 22 | PC9 |
| 3 | PB7 | 13 | PA14 | 23 | PC8 |
| 4 | PB6 | 14 | CANL | 24 | PC7 |
| 5 | PB5 | 15 | CANH | 25 | PC6 |
| 6 | PB4 | 16 | PA13 | 26 | PB15 |
| 7 | PB3 | 17 | PA12 | 27 | PB14 |
| 8 | PD2 | 18 | PA11 | 28 | PB13 |
| 9 | PC12 | 19 | PA10 | 29 | +5V |
| 10 | PC11 | 20 | PA9 | 30 | +5V |

**J2（30 针）**

| 脚 | 网络 | 脚 | 网络 | 脚 | 网络 |
|---|---|---|---|---|---|
| 1 | +5V | 11 | PA1 | 21 | PB1 |
| 2 | +5V | 12 | PA2 | 22 | PB10 |
| 3 | PC13 | 13 | PA3 | 23 | PB11 |
| 4 | PC14 | 14 | PA4 | 24 | PB12 |
| 5 | PC15 | 15 | PA5 | 25 | GND |
| 6 | PC0 | 16 | PA6 | 26 | +3.3V |
| 7 | PC1 | 17 | PA7 | 27 | GND |
| 8 | PC2 | 18 | PC4 | 28 | +3.3V |
| 9 | PC3 | 19 | PC5 | 29 | GND |
| 10 | PA0 | 20 | PB0 | 30 | +3.3V |

> ⚠️ **编号陷阱**：OEM 底板用**顺序编号**（1,2,…,60），参考01 用 **`Conn_02x15_Odd_Even` 奇偶交错**（1,2 / 3,4 / …）。
> **物理位置一致，但"第几脚"叫法不同**——核对时**按行（物理位置）对，不要按脚号对**。
> 网名（PB9/PC13/PA5…）是准的，因为它跟物理位置走。

### 3.3 电机接口（与 OEM 底板**完全一致**）

| 功能 | 引脚 | 功能 | 引脚 |
|---|---|---|---|
| PWMA | **PA11** | PWMB | **PA8** |
| AIN1 / AIN2 | **PB5 / PA15** | BIN1 / BIN2 | **PB4 / PA12** |
| STBY | 接 5V（常使能） | VM / VCC | +12V / +5V |
| 电机 A 输出 | `MA_OUT1/MA_OUT2`（**CN1**） | 电机 B 输出 | `MB_OUT1/MB_OUT2`（**CN2**） |

**编码器接口（6 针，顺序完全一致；位号 `J3`/`J4` → `CN1`/`CN2`）**：

```
CN1（电机A）: MA_OUT1 / GND / PB6 / PB7 / +5V / MA_OUT2   ★座序已按实物修正
CN2（电机B）: MB_OUT1 / GND / PA0 / PA1 / +5V / MB_OUT2   ★座序已按实物修正
```

> **结论**：电机与编码器可**原样插上新板**，固件**电机部分不用改**。

### 3.4 电源部分（"原"板已集成，正是老师要求的）

| 位号 | 实际器件 | 作用 |
|---|---|---|
| **U2** | **LM2596S-5.0(UMW)**（3A，7–40V 入/5V 出） | 12V→5V **开关降压** |
| **U3** | **AMS1117** | 5V→3.3V **线性稳压** |
| **L1** | **33µH 5A** | Buck 储能电感 |
| **D1** | **ES2D**（肖特基） | 续流二极管 |
| C1/C2/C13 | 220µF 35V | 储能滤波 |
| C6/C10 | 10µF | 3.3V 侧滤波 |
| R4/R5/R1 + D2/D4/D3 | 5.1k/4.7k/1.5k + LED | 12V/5V/3.3V 指示灯 |
| R3/R2 + C12 | 10k / 1k 0.1% + 0.1µF | 电池电压采样 → **PB1** |

> **对比开源方案（`Stm32BalanceCar`）**：开源方案用**外插 MP1584 模块**、无 3.3V 稳压、电机电源经 `D6` 单独隔离（`MOTOR_POWER`）。
> **我们采用往届的集成方案**（更符合老师"电源集成到底板"的要求）。

### 3.5 其余已确认

- **OLED 在控制板上**（不是底板），6 针座丝印 `C0 C15 C14 C13 3V3 GND`
- **TB6612 是焊在板上的芯片**（SSOP-24），不是模块座；引脚号：`PWMA=23 / PWMB=15 / AIN1=21 / AIN2=22 / BIN1=17 / BIN2=16 / STBY=19 / VCC=20 / VM=13,14,24`
- **板框**：往届**原板**约 87.8 × 63.2 mm（早期量取值）；**本板（改）100.00 × 65.00 mm，四角 R5.0 mm，3 个 ⌀3.2 mm 安装孔**（孔心以板左下角为原点 (6.0, 6.1) / (94.0, 6.1) / (6.0, 58.9) mm，**右上角无孔**）—— **A2 的装配图/开孔必须按本板**，不要沿用原板尺寸
  > ⚠ **2026-10-16 更正（决策 81）**：本条此前写"≈100 × 60 mm（几何包络 ≈95 × 61 mm，4 个 ⌀1.6 mm 安装孔）"，**尺寸/圆角/孔径/孔数四项全错**。
  > 权威出处与四路证据（EDA 快照 + 下单 Gerber + 嘉立创生产档 + 渲染图逐孔核对）见 [`../../hardware/gerber/README.md`](../../hardware/gerber/README.md) §五；
  > 给 A2 的单页版见 [`../design_hardware/上板测试记录.md`](../design_hardware/上板测试记录.md) §5。
  > **原板 PCB1 是 4 个 ⌀3.2 孔**，改板**删掉了右上角那个**（该角落改为 `J13`/`J10`/`R10`~`R13` 区）—— 照抄原板坐标时除了 `y_改 = y_原 − 2079`，**还要记得少一个孔**。
- 60 针插座位于底板中部（J1 @ x3106,y1785；J2 @ x1353,y1785）

### 3.6 任务书与实际的 7 处不符（**不改任务书，报告里说明**）

| # | 任务书写的 | 实际 |
|---|---|---|
| 1 | 主控 STM32F103C8T6 | **STM32F405RGT6** 控制板（保留复用） |
| 2 | 主板 + 传感器转接板（两块都从零画） | **单底板**（复用控制板+拓展板，重做底板） |
| 3 | 系统层"HAL 驱动" | **ST 标准外设库 FWLIB** |
| 4 | STM32CubeMX + arm-none-eabi-gcc | **Keil 4 + FWLIB** |
| 5 | MPU6050"互补滤波" | **卡尔曼滤波** |
| 6 | 主板带 MPU6050 模块座 | MPU6050 **板载在控制板上** |
| 7 | 蜂鸣器做在转接板 | ❌ **此说法有误，已订正**："改"板上 `BZ1`/`Q1`/`R6`/`R7`/`R8` **都已删除**，改为 `J18` + **有源模块 `PC5` 直连**（见 §2.1 与决策 26）|

---

## §4 关键资产位置

### 4.1 文档（`docs/`）

| 文档 | 内容 |
|---|---|
| **`handoff/交接说明.md`** | ← 本文 |
| `决策记录.md` | 全部已定型决策 + 方案演进史（**改板前必读**） |
| `任务书_提取全文.md` | 已提交任务书的纯文本（便于检索） |
| `design_hardware/` | |
| ├ `改板规格书_单底板方案.md` | 接口总表、60 针映射、BOM 增量、待核实项 |
| ├ `焊接调试手册.md` | **动手改板看这个**：原理图 3 步 + PCB 4 步 + 飞线预案 + 验证清单 |
| ├ `模块功能与原理说明.md` | 各模块功能与原理（写报告/答辩用） |
| ├ `pin_assignment.md` | 引脚分配表（**以源码为准**） |
| ├ `car_composition.md` | 整车三层结构解析 |
| ├ `sensor_interface_notes.md` | 传感器接入的通用电气注意 |
| └ `archive/实物核对拍照清单.md` | 待拍照核实项 |
| `design_firmware/architecture.md` | 固件架构（混合式：中断 + FreeRTOS） |
| `protocol/communication_protocol.md` | 通信协议 **v1.2**（当前版本；v1.1 冻结 + 0x15/0x16 增量） |
| `research/` | MQ 算法调研、相似方案、github 仓库、EDA 接入方案等 |

### 4.2 EDA 工程

| 路径 | 说明 |
|---|---|
| `%USERPROFILE%\Documents\LCEDA-Pro\projects\参考01_copy` | **工作工程**（"原"板 + "改"板） |
| `%USERPROFILE%\Documents\LCEDA-Pro\projects\参考01` | **原始干净基线**（101 元件，勿动） |
| `参考01_copy_backup\*.epro2` | 用户手动备份 |
| `<仓库根>\hardware\参考01.eprj2` | 旧格式（SQLite），已弃用，留档 |

### 4.3 参考资料（`Base/`）

| 路径 | 内容 |
|---|---|
| `Base/高配版平衡小车附送资料（STM32F405RGT6）/` | **厂商全套资料**：原理图 PDF×5、芯片 datasheet、源码（卡尔曼/DMP 两版）、使用说明 |
| `Base/开源参考/Stm32BalanceCar/` | 开源方案（已归档，仅供电源/隔离设计参考） |
| `Base/easyeda-bridge/` | EDA API 桥接（详见 §5.5） |
| `Base/1790078*.jpg` | 实物照片（底板正反、控制板正反、各拓展板） |
| `hardware/_oem_pdf/` | **OEM 原理图渲染图**（STM1/STM2 放大图，核对端口用） |
| `hardware/_epro_pdf/sch_p1.png` | 开源方案原理图渲染 |
| `hardware/photos/` | 实物照片副本 + 4 块拓展板 PDF |

### 4.4 归档

| 文件 | 内容 |
|---|---|
| `归档_阶段一_MiniBalance方案_20260923.zip` | 阶段一（10.3 MB） |
| `归档_阶段二_开源方案_20260923.zip` | 阶段二（2.9 MB） |

---

## §5 ★ EDA 操作要点与踩坑（重要，避免重复踩）

### 5.1 两种工程格式

| 格式 | 结构 | EDA 行为 |
|---|---|---|
| `.eprj2` | SQLite 单文件 | EDA 打开时**物化到 Service Worker 缓存**，改文件不生效 |
| `.eprj3` | 文件夹 + 纯文本 JSON | **EDA 直接读**；但工程打开时 EDA 会**覆写**文件 |

**`.eprj3` 记录格式**：每行 `{头部}||{载荷}|`，如
```json
{"type":"COMPONENT","ticket":2,"id":"e1"}||{...payload...}|
```
类型：`DOCHEAD / META / COMPONENT / ATTR / WIRE / NETLABEL / PORT / TEXT / OBJ`。
**空载荷 `|||` 是合法的"删除标记"**，不是错误。

### 5.2 ★ EDA 会覆写文件（改板必须在 EDA 内进行）

**实测**：工程在 EDA 中打开时，直接改磁盘上的 `.eprj3` 文件**会被 EDA 按内存状态重写**（8 秒内）。

**推论**：
| 方式 | 可行性 |
|---|---|
| 关 EDA → 脚本改 → 开 EDA | ✅ |
| EDA 开着 → 脚本改文件 | ❌ 被覆写 |
| **在 EDA 界面里改** | ✅ **推荐** |
| 通过 EDA API 改 | ✅ 可行（EDA 负责落盘） |

### 5.3 "绿字删不掉"的根因（第七轮定论）

往届板上的注释文字（`循迹模块`、`Generic connector` 等）**只存在于 EDA 的 V3 物化缓存**里：

```
缓存位置：%LOCALAPPDATA%\LCEDA-Pro\cache.x64.3\Service Worker\CacheStorage\
缓存键名：project_<sha256(工程绝对路径)>_v6
```

**`.eprj2` 文件本身是干净的**（`documents` 表里 TEXT=0）。清缓存**必须在 EDA 完全关闭时**做，否则 EDA 立刻用内存重建。
（脚本：`hardware/clear_eda_cache.py`）

### 5.4 ★ AI 自动改板：实测不可行（已放弃）

用 EDA 官方 API 试过完整自动化（改网名+加 5 只电阻+布线+铺铜），**三类硬伤**：

| # | 问题 | 证据 |
|---|---|---|
| 1 | API 创建的元件**字段不完整** | 缺 `DeviceName`/`FootprintName`（老元件都有） |
| 2 | **`pcb_Document.importChanges()` 恒返回 false** | **未改动的原工程**测试同样 false → 该 API 在文件夹格式下不可用 |
| 3 | **DRC 收敛不了** | 双面板高密度（Top 818 / Bottom 709 障碍），新元件放哪都压到既有走线；迭代 6 轮仍有 96 条间距错误 + 1 条网表错误 |

**结论：当前没有可用的自动画板方案，改板走手工。**

### 5.5 EDA API 桥接（`Base/easyeda-bridge/`）

**用途**：让 AI 能在 EDA 进程内执行 JS（读图元、导出渲染图等）。

```bash
# 启动桥（后台）
cd D:/260921Task/Base/easyeda-bridge/easyeda-api-skill
nohup node scripts/bridge-server.mjs > /tmp/eda-bridge.log 2>&1 &

# 健康检查（edaConnected 需为 true，即 EDA 已打开）
curl -s http://127.0.0.1:49620/health

# 执行 JS（代码会被包成 async function(eda){...}，要用 return 返回值）
curl -s -X POST http://127.0.0.1:49620/execute \
  -H "Content-Type: application/json" \
  -d '{"code":"var a=await eda.pcb_PrimitiveComponent.getAll(); return String((a||[]).length);"}'
```

**常用接口**：
| 目的 | API |
|---|---|
| 列出打开标签 | `eda.dmt_EditorControl.getSplitScreenTree()` |
| 打开文档 | `eda.dmt_EditorControl.openDocument(uuid)` |
| 关闭文档 | `eda.dmt_EditorControl.closeDocument(tabId)` |
| 读 PCB 元件 | `eda.pcb_PrimitiveComponent.getAll()` |
| 读原理图元件 | `eda.sch_PrimitiveComponent.getAll()` |
| 读焊盘网络 | `eda.pcb_PrimitivePad.getAll()` |
| 铺铜重建 | `eda.sys_MessageBus.publish("doCommand_ui",["RebuildAllCopperArea"])` |
| 导出渲染图 | `eda.dmt_EditorControl.getCurrentRenderedAreaImage()` → Blob→base64 |

**文件系统接口需"全离线模式"**，且被沙箱限制在 EDA 自己的 projects 目录内。

### 5.6 `.eprj3` 末行缺 `|` 会导致底层覆铜丢失

**实测**：从 `.eprj2` 导出 `.eprj3` 时，**PCB 文件最后一条记录可能漏掉结尾的 `|`**。
EDA 解析器会跳过该记录 → 若它恰好是地平面覆铜 → **底层铜箔消失**。

**判据**：文件最后一行应以 `|` 结尾。
（脚本：`hardware/fix_eprj3_terminator.py`）

### 5.7 可复用脚本（`hardware/`）

| 脚本 | 作用 |
|---|---|
| `clear_eda_cache.py` | 清 `.eprj2` 的 V3 物化缓存（EDA 关闭时用） |
| `fix_eprj3_terminator.py` | 补末行缺失的 `|`（**从 .eprj2 导出后必跑**） |
| `clean_eprj3.py` | 删注释文字/中文丝印/FONT/layer9 元数据 |
| `clean_eprj3_meta.py` | 删 DEVICE 库元数据键、`Attribute*=REF**` 占位符 |

> 全部带 `--apply` 预演/执行两档 + 自动备份。

---

## §6 已知未决 / 待确认项

| # | 项 | 说明 |
|---|---|---|
| 1 | **TB6612 用芯片还是模块座** | "改"板目前保留 U1 芯片方案；焊 SSOP-24 需热风枪或找实验室 |
| 2 | **板框尺寸与车架安装孔** | ✅ **已定**：本板 **100.00 × 65.00 mm、R5.0 圆角、3 个 ⌀3.2 mm 安装孔**（原板为同尺寸但 4 孔）；见 §3.5 与决策 81 |
| 3 | **OLED 装配位置** | OLED 在控制板上，A2 设计外壳时需确认不被遮挡、朝向可见 |
| 4 | **"改"板要加哪些传感器座** | 目前精简版删掉了所有传感器座，需补回 MQ/DHT11/红外 座（或按 §2.2 直接做分压） |
| 5 | 蓝牙模块实际波特率 | ✅ **已确认可到 115200**（第二颗 JDY-33 已配名 `Pie` / 密码 `6667` / 115200）。⚠️ 但 **Windows 端建不出 SPP COM 口**（见 §7 顶部），联调主链路改用**有线** |
| 6 | MQ 模块引脚顺序 | VCC/GND/DO/AO 的实际排列，需与 J13/J10 逐脚对上 |
| 7 | 红外避障模块电平 | 若 OUT 为 5V 电平，需确认 PA4/PC1 可容忍 |
| 8 | **MQ 老化** | 需 24–48h 通电老化，**尽早开始** |
| 9 | 电机连接器线序 | 插反会烧编码器，插前务必核对 |
| 10 | 编码器线数 | 13 线霍尔，四倍频后 1560 counts/圈 |

---

## §7 下一步任务

> **当前阻塞点已解除：板子与元器件全部到货、已焊好，已进入真机联调（2026-10-13 第一轮 / 2026-10-15 第二轮）。**
>
> **📌 真机台架现状（2026-10-15）**：**只有 MQ-135，插在 `J13`**（`J10` 空、MQ-2 模块已烧毁待补）；
> DHT11 正常；电池 **11.8 V**；**OLED 正常显示**（页 1 / 页 2 / 厂商页）——
> 本文档 §6 里"传感器未就绪""OLED 乱码"一类的旧现象**均已解决**，
> 详情与待修项见 [`design_firmware/真机联调问题清单.md`](../design_firmware/真机联调问题清单.md)。
>
> **📌 蓝牙链路结论（2026-10-15 实测）**：Windows 蓝牙 SPP **能配对但建不出 COM 口**；
> Python 的 `AF_BLUETOOTH` **在 Windows 上不可用**、`pybluez2` 在 Python 3.13 上编译不过；
> 本 Qt 套件**未安装 Qt Bluetooth 模块**。有两颗模块：**DX-Smart 克隆**（老式 HC-06 方言、**纯从机**、
> `AT+ROLE`/`AT+ADDR` 不回）与 **JDY-33**（经典 SPP + BLE、可读 `AT+LADDR`、已配名 `Pie` /
> 密码 `6667` / 115200、当前从机 `AT+TYPE0`）。工具：
> [`tools/fw_prep/bt_scan.py`](../../tools/fw_prep/bt_scan.py)（按**合法帧**识别端口）、
> [`bt_at.py`](../../tools/fw_prep/bt_at.py)（AT 配置，自动探波特率与方言）。
> **因此演示/联调以有线链路（板上 MicroUSB / USART1）为主链路。**
>
> **等货期间的进展（2026-10-09）**：**B 的离线部分已全部完成**（工程可构建 .hex、四任务跑起来、
> 协议三方交叉验证、4 套原生单测 **1,443 条断言全过**；**2026-10-13 复核实为 1,457 条**
> （参数套件补了 5 条 `ParamPack_Equal` 断言、状态机从 67 增至 76 条），
> **2026-10-15 状态机再增至 80 条 ⇒ 现为 1,461 条**）——
> 见 [`design_firmware/程序说明文档.md`](../design_firmware/程序说明文档.md) 与 [`design_firmware/B阶段开工准备.md`](../design_firmware/B阶段开工准备.md)；C 待推进。
> **2026-10-13 又做了一轮代码规整化（决策 52~54）**：P0 修 OLED 档位与页码重叠 + 魔数集中；
> P1 修 4 个 getter 的临界区承诺、消除 0x14 载荷双实现、`ParamStore_Save()` 的假校验；P2 新增 `App/Board/board_state` 单一出口、
> `System/delay` 改回调注入打破反向依赖、统一使能真相；P3 头文件守卫规范化 + 空白规范化器 + `.clang-format`。
> 规范见 [`design_firmware/编码规范.md`](../design_firmware/编码规范.md)；**这批改动只做了离线核验，上板请按
> [`design_hardware/上板自检清单.md`](../design_hardware/上板自检清单.md) §3.5 的专项观察项确认**。

### A1 — 电路
1. ~~原理图完善~~ ✅ **已完工**（2026-10-05）
2. ~~PCB 布局布线 + 重建覆铜 + DRC 清零~~ ✅ **已完成**（2026-10-08，DRC 零错误零未连接）
3. ~~导出 Gerber + BOM → 打样~~ ✅ **已下单** —— **且 Gerber 已留档进仓库**（2026-10-16）：[`hardware/gerber/`](../../hardware/gerber/README.md)（下单用的那份 EDA 导出，**脱敏版**：丝印姓名笔画已移除；含**工艺参数 1.6 mm / 1 oz / 有铅喷锡**）；**未脱敏原件在仓库外**（提交作业用，见决策 83）
4. ✅ **板子已到货、已焊好并完成两轮真机联调**（2026-10-13 / 10-15）：焊接按《[焊接调试手册](../design_hardware/焊接调试手册.md)》，逐项自检按《[上板自检清单](../design_hardware/上板自检清单.md)》**已走完**；结论与待修项见 [`design_firmware/真机联调问题清单.md`](../design_firmware/真机联调问题清单.md)
5. ✅ **正式 BOM 文档已补**：见 [`design_hardware/BOM表.md`](../design_hardware/BOM表.md) —— 由 `tools/bom_export.py` 从完工快照**离线导出**（52 位号 / 27 行 / 立创料号全覆盖），CSV 在 `hardware/bom/BOM_主底板.csv`。另：焊接与联调按 [`design_hardware/上板自检清单.md`](../design_hardware/上板自检清单.md) 走
6. ✅ **焊接与测试记录已补（2026-10-16）**：[`design_hardware/上板测试记录.md`](../design_hardware/上板测试记录.md) —— 制板/采购 → 焊接（4 张实物照片索引）→ 上电与供电检查 → 逐项自检结论 → **给 A2 的结构接口实测值** → 8 项遗留待测 → 验收材料点名
7. ✅ **实际采购记录已补（2026-10-16）**：[`hardware/bom/采购记录_立创商城_SO26101014446.md`](../../hardware/bom/采购记录_立创商城_SO26101014446.md)（17 项；与 BOM 的 4 处料号差异判为等价件；闭合 `C18`/`C19` 料号存疑）
8. ⬜ **仍待 A1 动手（要万用表/铭牌）**：三轨电压（12/5/3.3 V）与上电前短路检查的**测量记录**、MQ 模块 `RL` 实测、**电机额定/堵转电流**；以及 `上板自检清单` §10 要求的调参前后对比、观测 CSV、完整任务链与三条安全通道的留档

### A2 — 结构
1. 确认板框与车架安装孔匹配 —— ✅ **A1 已提供实测值**：板框 **100.00 × 65.00 mm、R5.0 圆角、3 个 ⌀3.2 mm 安装孔**（孔心 (6.0,6.1)/(94.0,6.1)/(6.0,58.9) mm，以板左下角为原点；**右上角无孔**）—— 见 [`design_hardware/上板测试记录.md`](../design_hardware/上板测试记录.md) §5
2. 传感器低位布置（降低重心）、OLED 视窗、按键开孔
3. 装配图 + 外观效果图
4. ✅ **整车 3D 模型已交付并归档（2026-10-17）**：SolidWorks 原生装配（14 个部件 / 20 条装配关系）+ 另存零件 + STEP，见 [`hardware/mechanical/A2-10_整车装配_20261017/`](../../hardware/mechanical/A2-10_整车装配_20261017/README.md)；提交副本在仓库外 `…\正式作业提交\…\A2_结构\01_三维模型\`
> ⚠️ 仍缺：**本模型的工程图 / 总装图 / 爆炸图 / 效果图、人机界面 §7 十二项、STL 与打印记录、结构设计说明**（旧 OCC 程序壳及其图纸已于 2026-10-17 删除，不能再引用）—— 这是 A2 目前最大的缺口

### B — 固件
> ✅ **B 阶段的"离线可完成部分"已全部完成（2026-10-09）** → [`design_firmware/程序说明文档.md`](../design_firmware/程序说明文档.md)（交付文档）
> ｜ 执行日志与踩坑：[`design_firmware/B阶段开工准备.md`](../design_firmware/B阶段开工准备.md)（P0~P4 见 §十~§十四、复查见 §十五）
>
> | 已完成 | 说明 |
> |---|---|
> | 工程骨架 | `firmware/` 用 **GCC + Makefile** 一键构建出 `.hex`（决策 34）；`USE_RTOS=0` 可切裸机对照 |
> | 架构 | **混合式**：控制中断（5/10 ms）**代码零改动**；采集/通信/状态机/界面进 FreeRTOS 四个任务 |
> | 协议 | CRC-16 + 帧编解码 + 环形缓冲解帧（含 100 ms 超时），**与上位机三方交叉验证一致**（CRC 4 + 帧 16 + 流式 6）|
> | 感知 | 双路 MQ（ADC2，PA5/PA6）+ DHT11（PA7）+ 温湿度补偿 + 多帧确认/迟滞 + 自适应 1↔5 Hz |
> | 任务 | 巡检状态机 + 事件上报 + **500 ms 失联安全停车（锁存）** |
> | 调参 | **有线链路（USART1）** 同一协议；`0x24` 全量回读/存 Flash/载入/**100 Hz 观测模式** |
> | 核验 | **离线核验 9 项全通过** —— 4 套原生单测 **1,461 条断言**（协议 117 + 传感器 1235 + 状态机 80 + 参数 29；状态机 67→76 是 §十六 里程计场景、76→80 是 2026-10-13 安全通道事件码，参数比 P5 时的 24 条多 5 条 `ParamPack_Equal` 逐字段比对断言）+ `tune.py --selftest` + 交叉编译 + 向量表 + 中断安全 + 引脚基线；`make strict` **19 文件 0 条**（**必须先 `make clean`**，否则增量编译下可能一条都不编、报"0 条"是假绿）；现占用 **Flash 约 66.5 KB / RAM 约 32.8 KB**（2026-10-15 实测）|
>
> **剩余（都要等硬件）**：① 到货后按 [`B阶段开工准备.md`](../design_firmware/B阶段开工准备.md) §14.6 逐项实测
> （能否正常平衡 / 蓝牙 115200 / DHT11 任务内稳定性 / MQ 的 `RL` 与 `R0` / **轮径与编码器线数** / 里程到位判据）；
> ② 与 C 会签 2 项协议提案（`0x24` 扩展 ID、失联事件码）。

1. 引入 FreeRTOS（官方仓库），保持平衡控制在 MPU6050 中断里
2. **超声波 TRIG 用 PC4**（板上实际，非源码的 PC2）—— 固件已改（初始化 + 发脉冲两处）
3. 蜂鸣器是**有源模块**（PC5 直连、低电平响），不是 PWM 驱动
4. MQ 采集（ADC + 分压换算）、DHT11 单总线、补偿算法、任务状态机、协议打包 —— 均已实现
5. ⚠️ **ADC 采样时间要放长**（MQ 分压源阻抗 ≈ 6 kΩ）—— 已用 480 周期，并把气体挪到 ADC2 避免与中断抢 ADC1
6. **MQ 通电老化必须尽早开始**（24–48h）

### C — 上位机

> 📋 **已完工（2026-10-16）**：P0~P5 全部完成 —— 五层架构（`protocol ← io ← domain ← data ← ui ← host`，`CMakeLists.txt` 用 5 个 target 强制依赖方向）、
> **7 页界面**（总览 / 巡检与控制 / 曲线与告警 / 调参与记录 / 事件流 / 通信链路 / 协议自检）、`0x24` 在线调参全流程、逐帧 CSV(42 列) + SQLite 会话库 + 回放、
> **免装 Qt 的便携版（12 文件 / 37.4 MB）**。交付文档：[`软件设计说明`](../design_host/软件设计说明.md)、
> [`用户操作手册`](../design_host/用户操作手册.md)、[`演示脚本`](../design_host/演示脚本.md)；过程文档：[`C部分方案与计划.md`](../design_host/C部分方案与计划.md)。
> **自检口径**：`ctest` **7/7（92 项用例）**、`host.exe --selftest 3` 退出码 0、真机**只读**探测解帧 611 / 丢帧 0 / 格式错帧 0 / 参数 `0x24` 全量回读 **7/7** 一致。
> ★ **提交包在仓库外**：`…\260921Task_私有资料\正式作业提交\<组长姓名>+<项目名称>\C_上位机\`
> （报告 docx/pdf + 用户操作手册 + 源码工程 + 便携版可执行程序 + 界面截图 + 测试与验证记录）。
1. **蓝牙 SPP 端到端仍未通**（能枚举端口但收 0 字节）⇒ 联调与演示走**有线**（USART1）；两侧共用同一解帧器，具备后补条件
2. 判据必须与固件同口径：先读 [`给C侧_固件接口与判读口径.md`](给C侧_固件接口与判读口径.md)；`--probe COMx --probe-readback` 是**只读**核对工具（不发运动指令、不写参数、不写 Flash）
3. ★ 跑 C 侧任何东西前把 **Qt 的 `bin` 置于 PATH 最前**：本机 PATH 中的 `STM32CubeProgrammer\bin` 自带旧 `Qt6Core.dll`，否则报「无法定位程序输入点」`0xC0000139`（铁律 45）

---

## §8 参考：任务书要求（摘要）

**三大交付功能**：
1. 机器人完成特定任务（我们的：自主巡检 + 双路气体/温湿度采集 + 超阈值声光报警 + 定点驻留）
2. 状态/进展/信息**上传**监控系统（姿态 20 Hz、气体环境 1 Hz→异常 5 Hz、事件即时）
3. 监控系统可**下发指令**远程控制（运动控制、任务指示、参数设置、紧急停机）

**关键指标**：巡检覆盖率 ≥90%、异常检出率 100%、告警延迟 ≤200 ms、上行丢帧 ≤1%、指令响应 ≤200 ms、平衡漂移 ≤±2°、续航 ≥60 min

**新质生产力三特征**（报告必写）：
- **高科技**：双通道气体传感+温湿度在线补偿、边缘研判、FreeRTOS、CRC-16 协议
- **高效能**：异常驱动自适应采样（1 Hz→5 Hz）、数据分层存储、机器人替代人工进危险环境
- **高质量**：全链路数据可追溯、心跳保活与失联安全停车、锂电驱动绿色低碳

---

## §9 变更记录

| 日期 | 内容 |
|---|---|
| 2026-09-29 | 初版：整合全部上下文，形成交接说明 |
| 2026-10-09 | **刷新 §7「B — 固件」与本节**：B 的离线部分完成（骨架/协议/感知/状态机/任务化/调参接口 + 程序说明文档），剩余为到货实测与 C 会签 |
| 2026-10-09 | **修正 §1.2 第 9 条**：蜂鸣器由"无源、需 PWM"改为"**有源模块、`PC5` 低电平响**"（与决策 26 实测一致，消除本文档自相矛盾） |
| 2026-10-13 | **第一轮真机联调**（决策 60/61）：新增 `0x15` 诊断帧、修低压误触发与 `APP_Show()` 污染链路、DTR/RTS 陷阱；**协议升到 v1.2**；同步 §1.2 第 6 条协议版本与 §4.1 文档表 |
| 2026-10-15 | **第二轮真机联调**（决策 62/63/64）：`control.c` 缺 `app_config.h` 导致条件编译**静默失效**、编码器分侧极性、`0x20` 运动链路真正实现 + 500 ms 看门狗、`0x24` 范围校验、固件版本字节、新增 `0x16` 三环实况；**刷新 §1.2/§3.5/§6/§7 的台架现状与核验数字，标注"OLED 乱码/传感器未就绪"等旧现象已解决** |

---

> **项目归属**：中国石油大学（华东） 专业生产实习课程项目<br>
> **范围说明**：本项目不涉及 MiniBalance 控制板（STM32F405RGT6 版本）的硬件设计与改版；控制板直接沿用，A1 仅重做主底板。<br>
> **许可**：原创代码与文档采用 MIT License；第三方组件遵循各自原始许可证。
