pierrotto12138-code/balance-car-inspection-robot/demo/README.md

# 演示视频

| 文件 | 时长 | 内容 |
|---|---|---|
| `videos/避障.mp4` | 9 s | 超声波避障：接近障碍物后停车/转向 |
| `videos/平衡.mp4` | 9 s | 两轮自平衡：松手后保持直立 |
| `videos/上位机.mp4` | 64 s | Qt 上位机：总览、曲线、调参、记录/回放 |

说明：`上位机.mp4` 为 1080p 转码版（4.2 MB），原始 2558×1526 录屏（125 MB）在私人交付包中；内容一致，仅为满足 GitHub 单文件 <100 MB 限制。

---

> **项目归属**：中国石油大学（华东） 专业生产实习课程项目<br>
> **范围说明**：本项目不涉及 MiniBalance 控制板（STM32F405RGT6 版本）的硬件设计与改版；控制板直接沿用，A1 仅重做主底板。<br>
> **许可**：原创代码与文档采用 MIT License；第三方组件遵循各自原始许可证。
