pierrotto12138-code/balance-car-inspection-robot/hardware/eda_export_20261016/PCB_PCB2_2026-10-16_脱敏.pdf

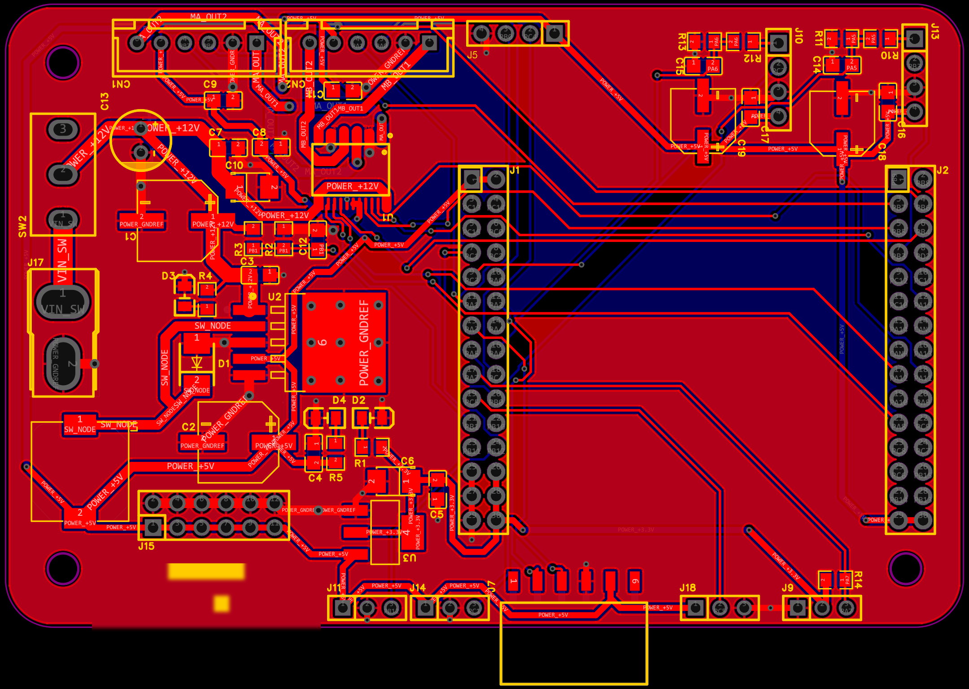
[picture p15: page 1]
