pierrotto12138-code/balance-car-inspection-robot/hardware/photos/f405rgt6拓展板正面背面(1).pdf

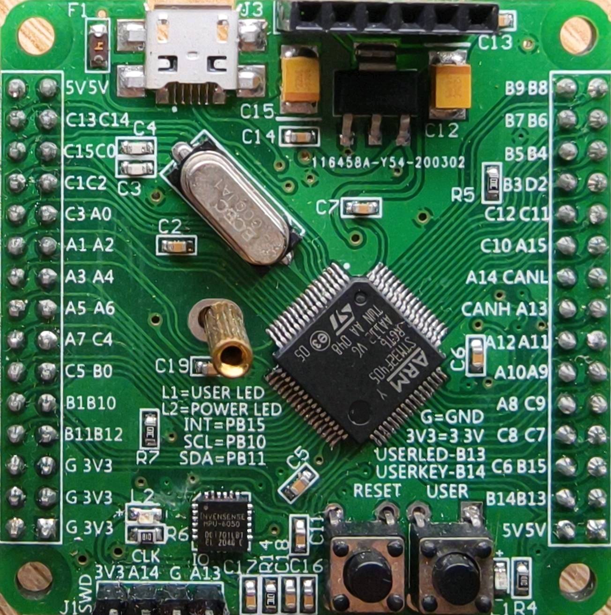
[picture p16: page 1]
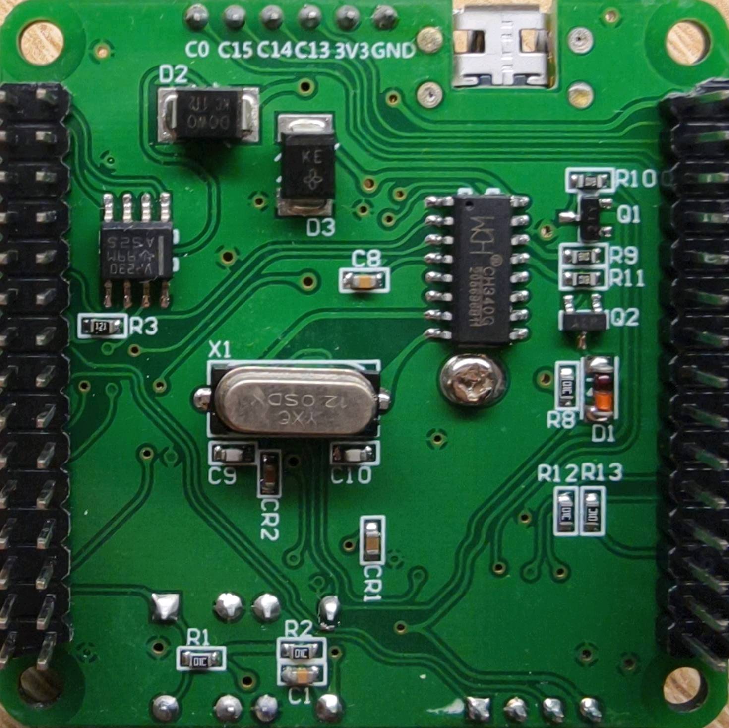
[picture p17: page 2]
