pierrotto12138-code/balance-car-inspection-robot/hardware/photos/tb6612拓展板正面背面(1).pdf

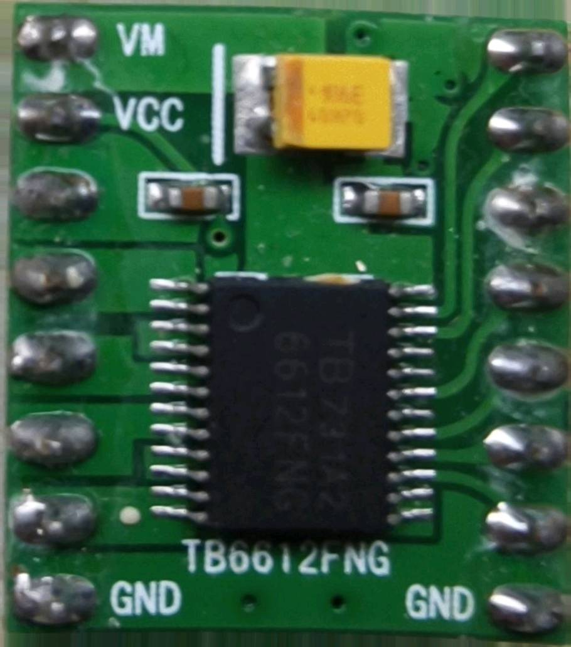
[picture p18: page 1]
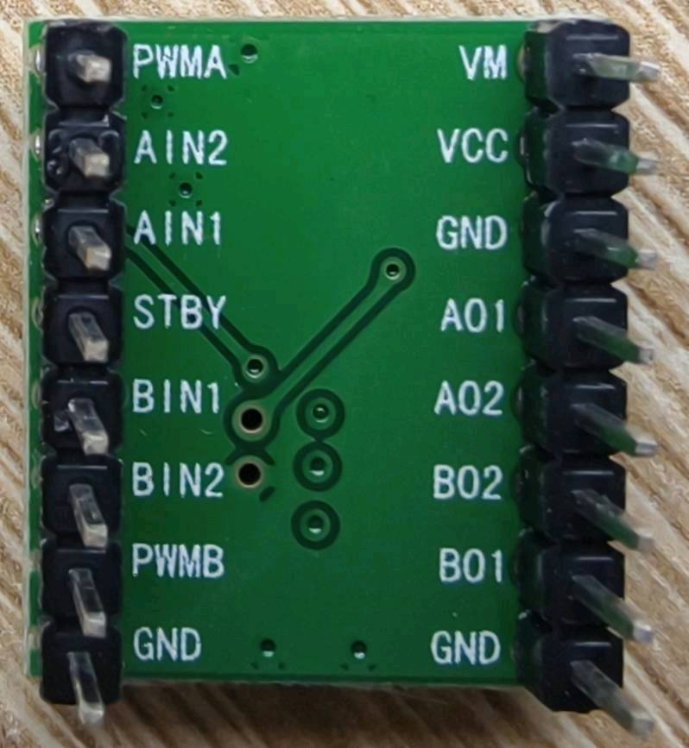
[picture p19: page 2]
