pierrotto12138-code/balance-car-inspection-robot/hardware/photos/电压测量拓展板正面背面(1).pdf

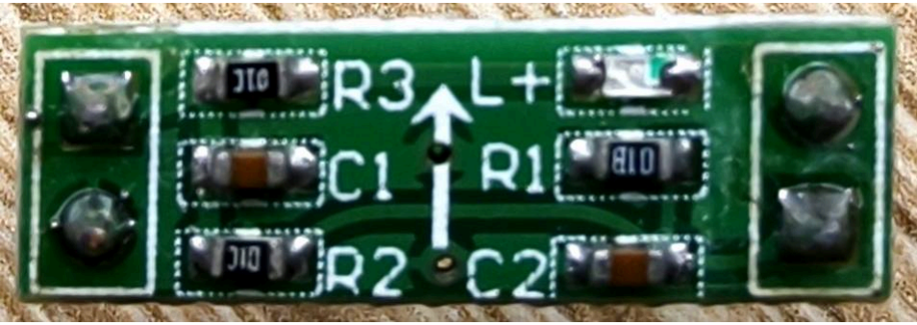
[picture p20: figure]

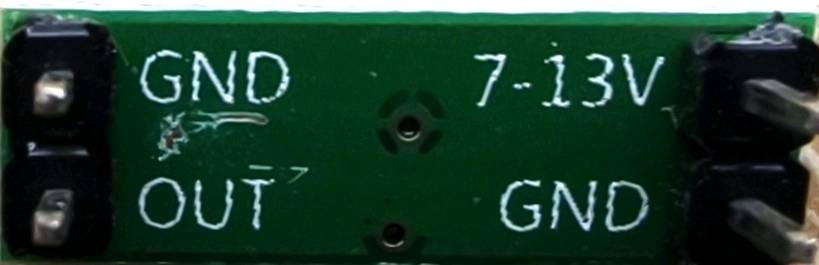
[picture p21: figure]
