pierrotto12138-code/balance-car-inspection-robot/hardware/photos/电源稳压拓展板正面背面(1).pdf

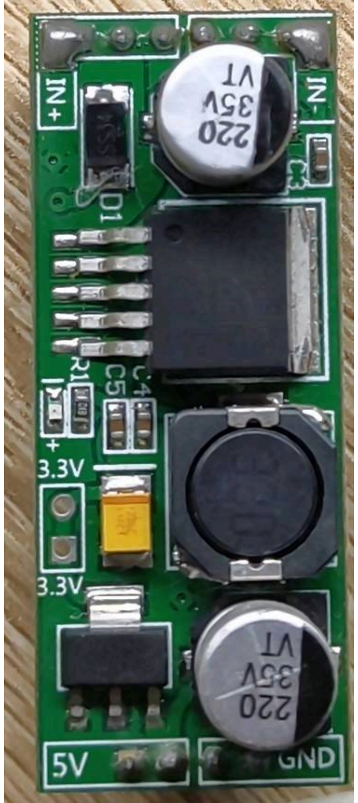
[picture p22: page 1]

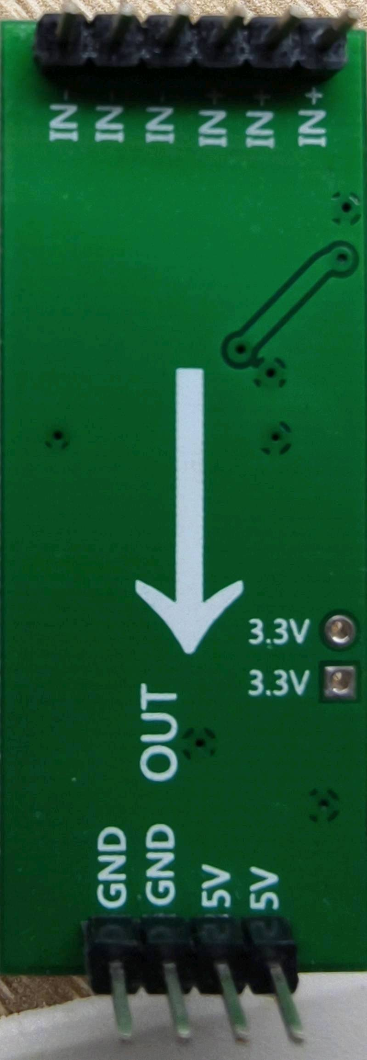
[picture p23: figure]
