pierrotto12138-code/balance-car-inspection-robot/docs/design_firmware/图/流程图_1_软件分层与任务划分.png

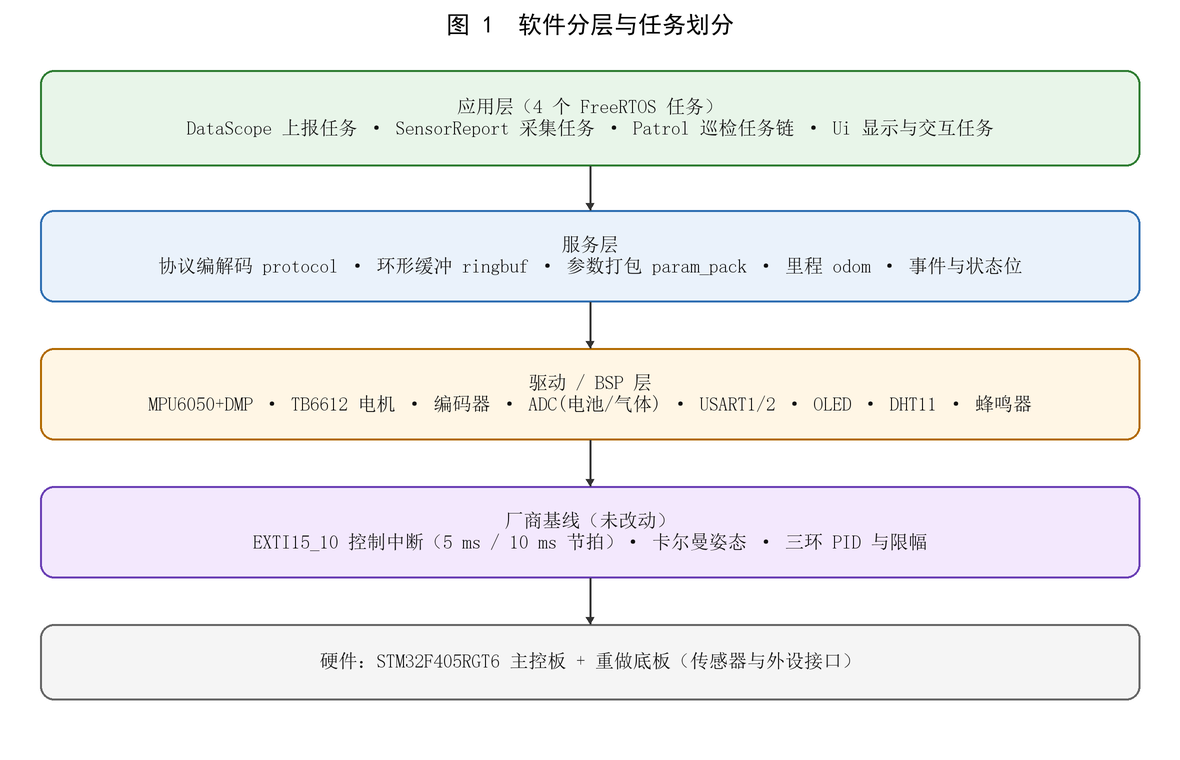
docs/design_firmware/图/流程图_1_软件分层与任务划分.png
