pierrotto12138-code/balance-car-inspection-robot/docs/design_hardware/小车实物_外观结构.png

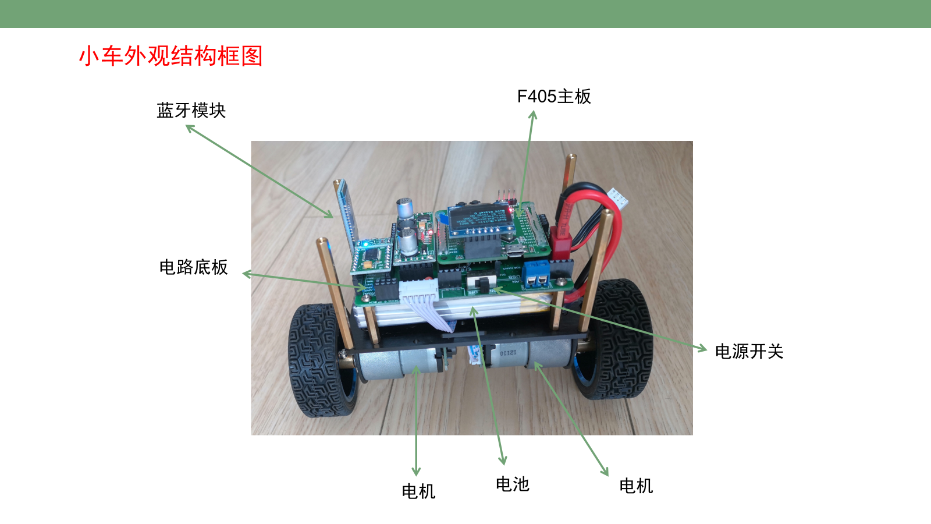
docs/design_hardware/小车实物_外观结构.png
