pierrotto12138-code/balance-car-inspection-robot/hardware/_参考存档/_epro_pdf/sch_p1.png

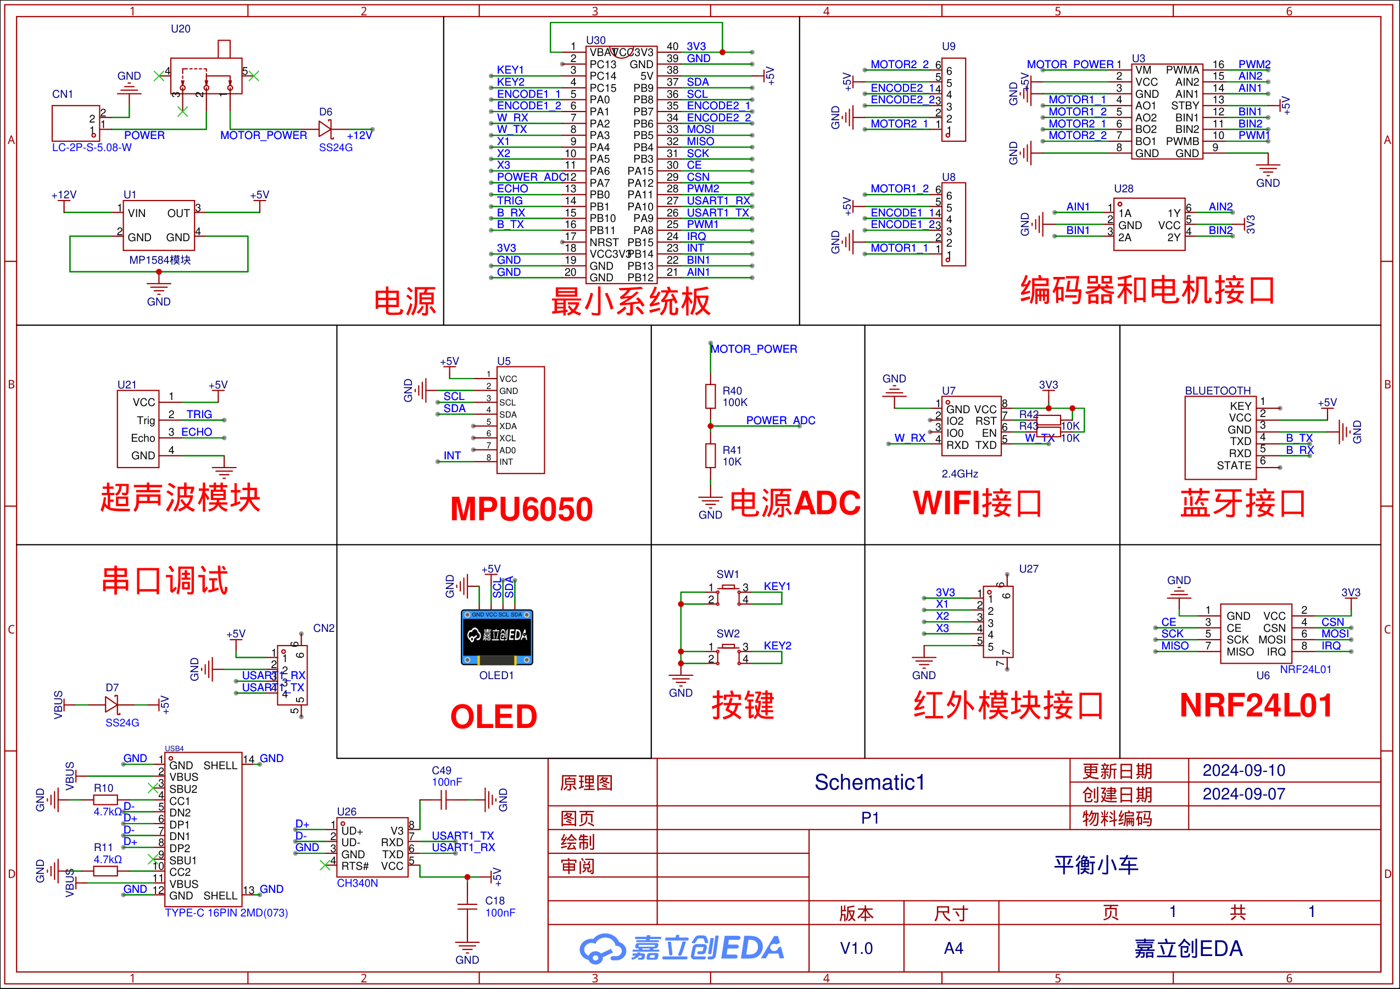
hardware/_参考存档/_epro_pdf/sch_p1.png
