pierrotto12138-code/balance-car-inspection-robot/hardware/_参考存档/_oem_pdf/oem_ctrl_p1.png

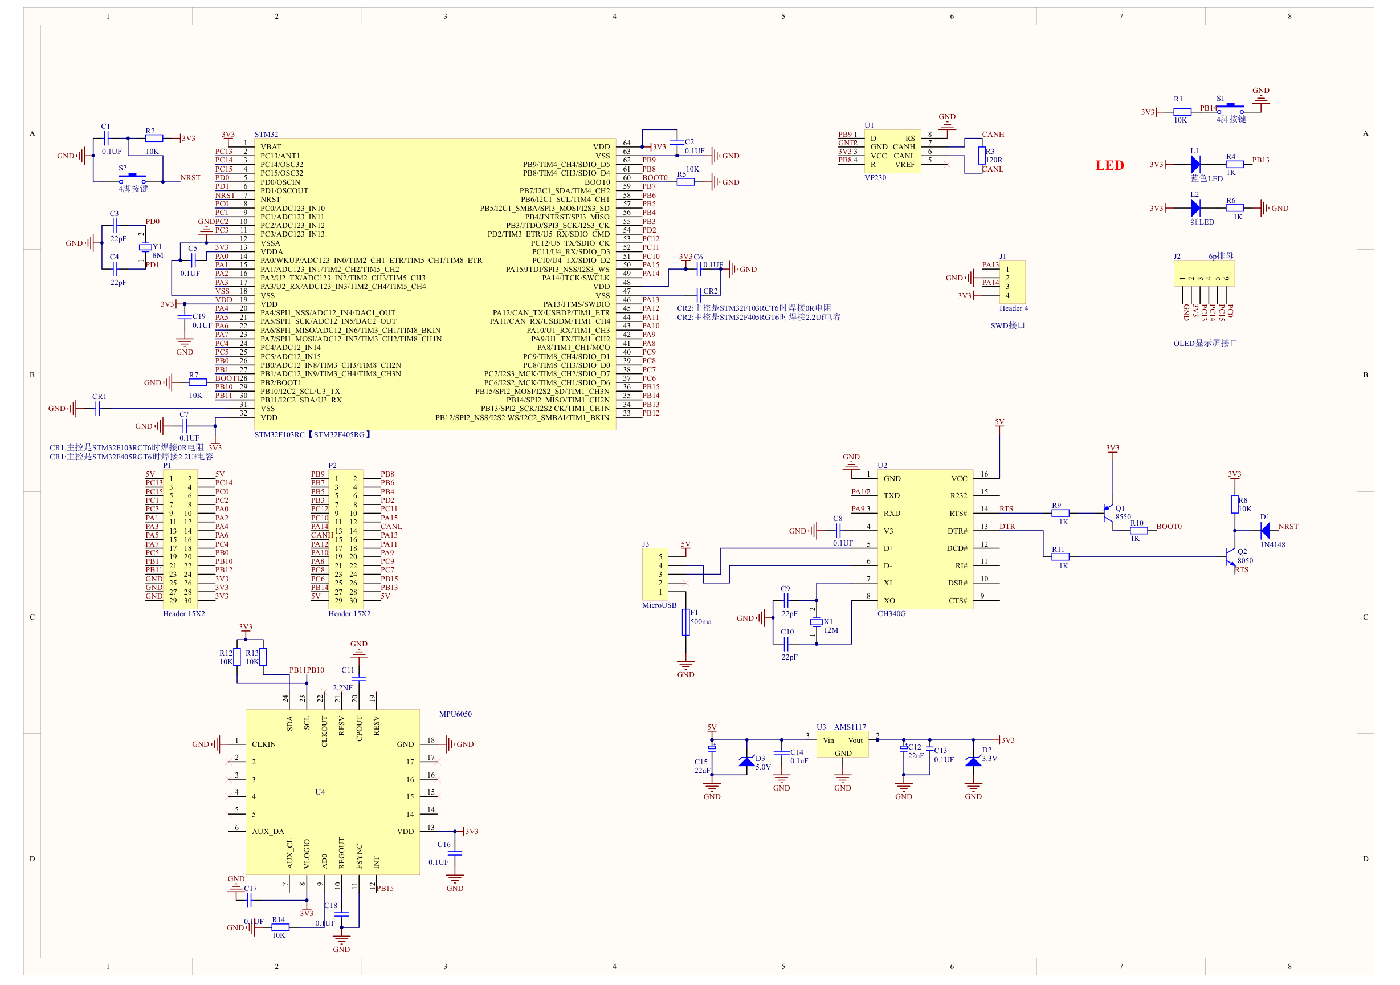
hardware/_参考存档/_oem_pdf/oem_ctrl_p1.png
