pierrotto12138-code/balance-car-inspection-robot/hardware/_参考存档/_oem_pdf/oem_stm_left.png

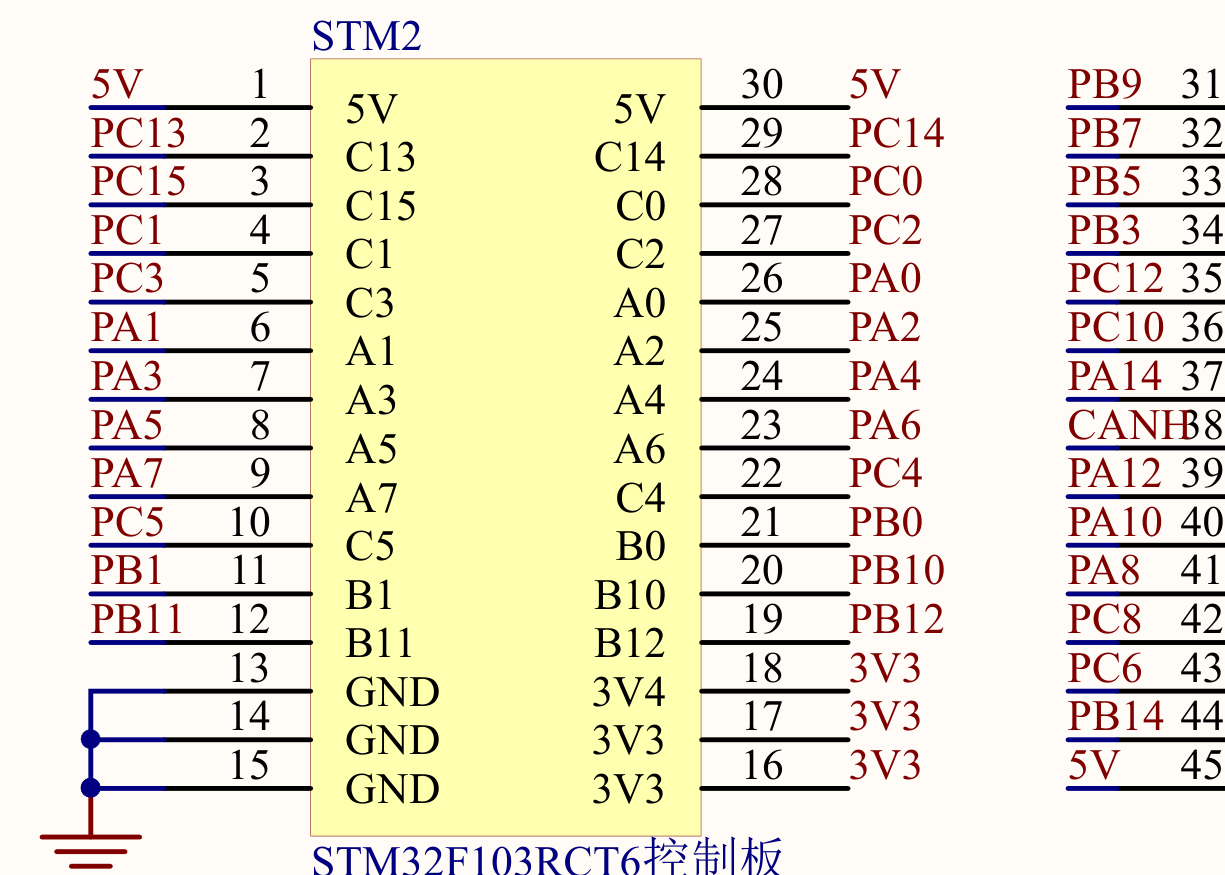
hardware/_参考存档/_oem_pdf/oem_stm_left.png
