pierrotto12138-code/balance-car-inspection-robot/hardware/eda_export_20261016/SCH_Schematic2_1-P1_2026-10-16.png

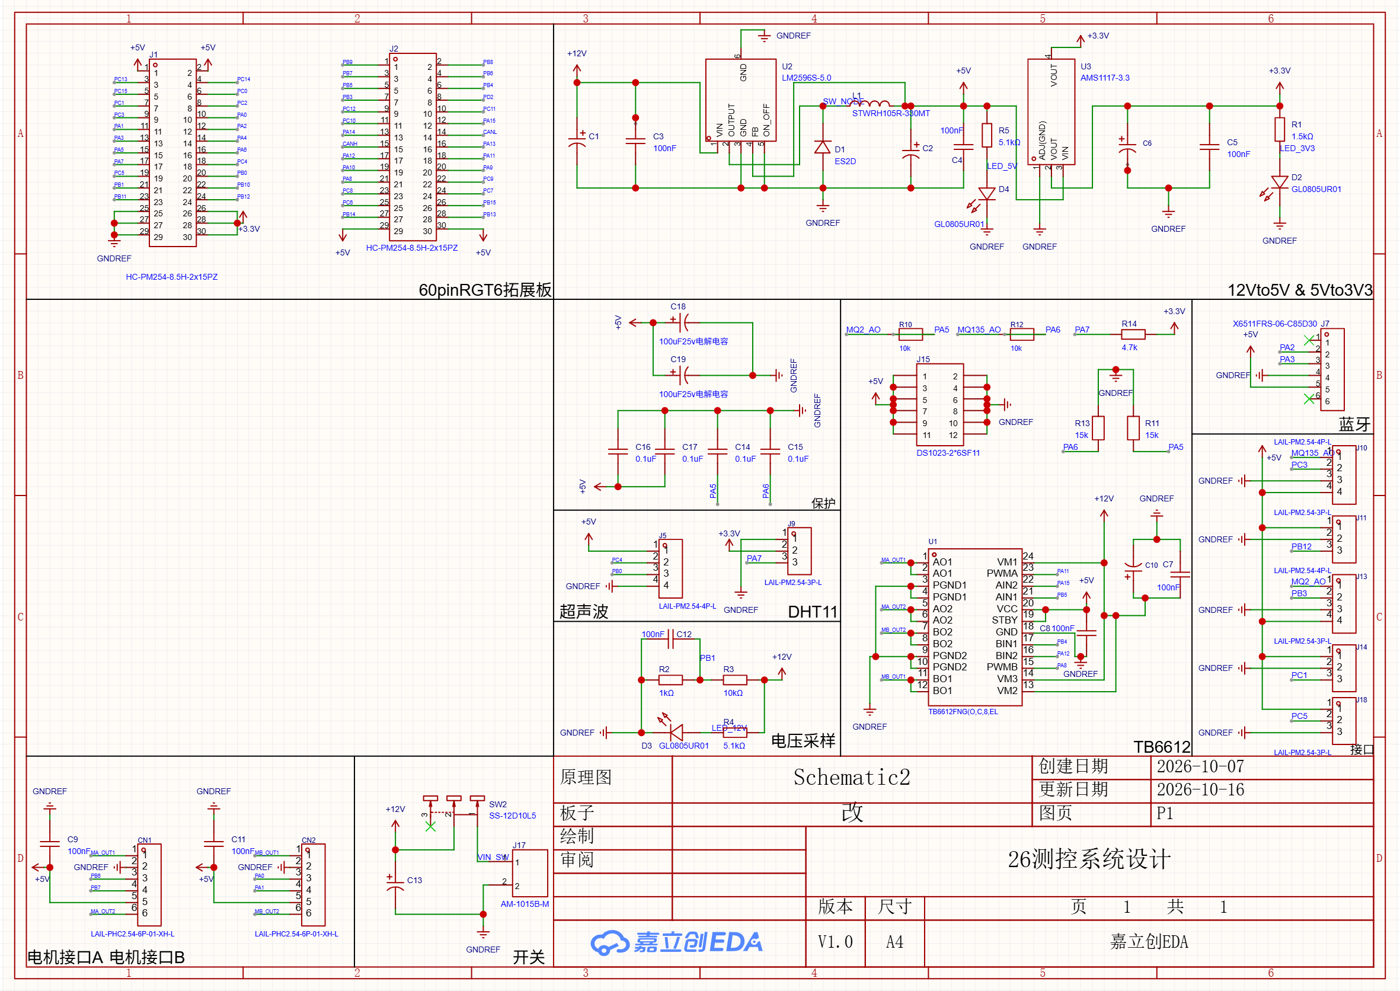
hardware/eda_export_20261016/SCH_Schematic2_1-P1_2026-10-16.png
