pierrotto12138-code/balance-car-inspection-robot/hardware/photos/1790078269895.jpg

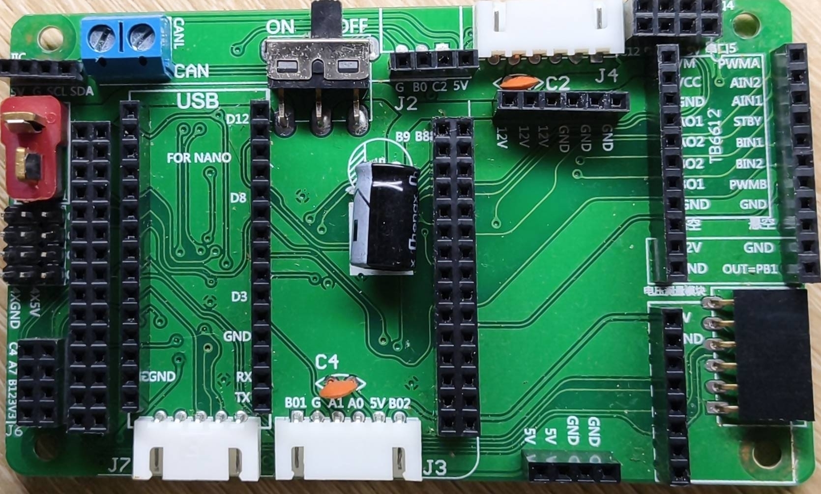
hardware/photos/1790078269895.jpg
