pierrotto12138-code/balance-car-inspection-robot/hardware/photos/1790078283359.jpg

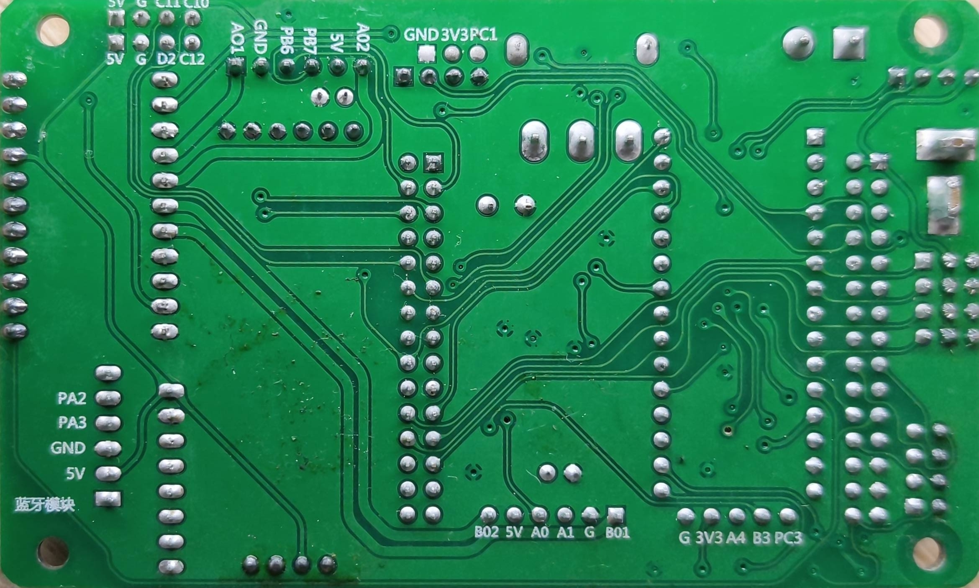
hardware/photos/1790078283359.jpg
