pierrotto12138-code/balance-car-inspection-robot/hardware/photos/新版底板_上车背面.jpg

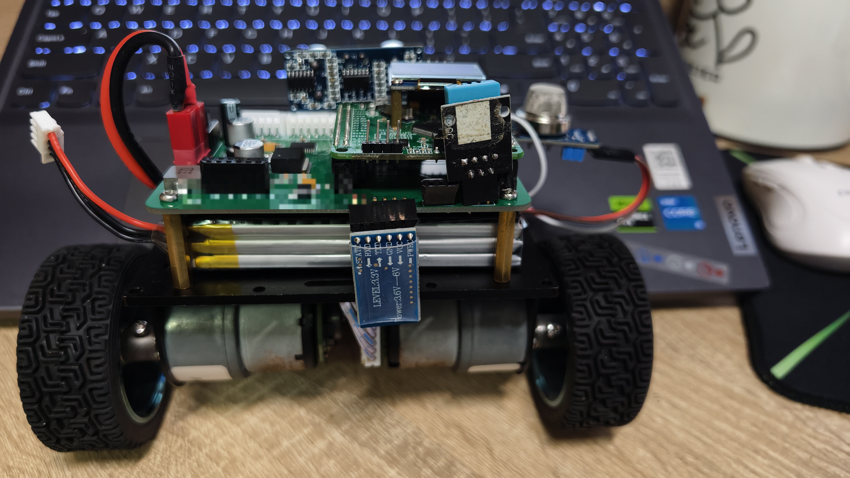
hardware/photos/新版底板_上车背面.jpg
