pierrotto12138-code/balance-car-inspection-robot/hardware/photos/新版底板_焊接重点处.jpg

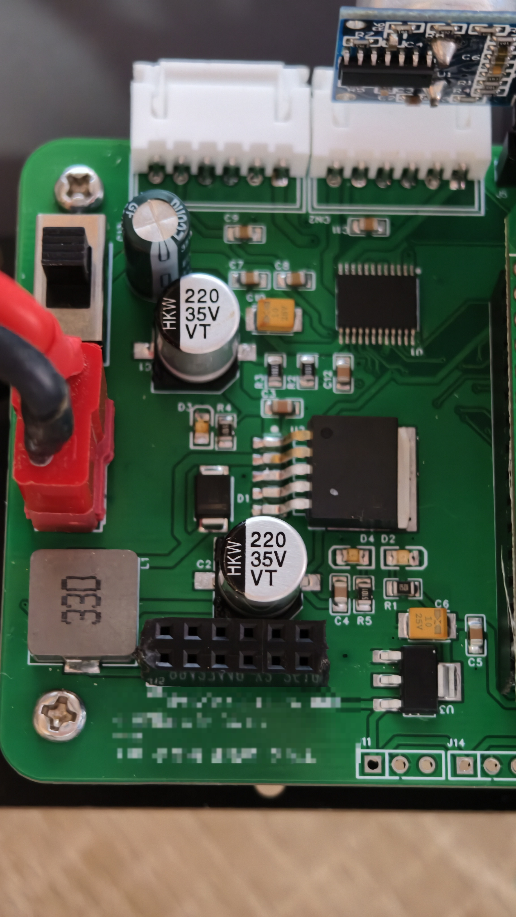
hardware/photos/新版底板_焊接重点处.jpg
