pierrotto12138-code/balance-car-inspection-robot/docs/design_firmware/真机联调问题清单.md

# 真机联调问题清单（第一轮 2026-10-13 首轮上板 / 第二轮 2026-10-15 晚）

> 本文是**全量正确性检查**的结论汇总，不是规范检查。方法见 §1，清单见 §3，动作顺序见 §4。
> 每条都带 `文件:行` 与证据；**已修**的条目同时记进了 [`docs/决策记录.md`](../决策记录.md)
> 决策 **60/61**（第一轮）与 **62/63/64**（第二轮）。
> 📌 **旧现象已解决、不要再按它排障**：OLED **已正常显示**（页 1 / 页 2 / 厂商页）、
> 传感器**不再"全未就绪"**（见 §6 台架现状）、`0x16` 里"算了没执行"已可量化。

---

## 1. 检查方法与一个必须先纠正的前提

**三路独立审计 + 一次自查**（各自只读、要求逐条给证据，不采信彼此结论）：

| 路 | 范围 | 方法 |
|---|---|---|
| ① 厂商文件差异 | 我们手改过的每个厂商文件 | 注释感知去注释 + GBK/UTF-8 解码 + 折空白 → 逐行序列比对，每个非平凡 hunk 人工读码 |
| ② 自研代码正确性 | `App/**`、`User/`、测试 | 并发/RTOS/时间回绕/安全通路/传感器算法/协议/持久化逐项过 |
| ③ 按上板症状反推 | 现象 → 代码 → 可测的量 | 每个症状给候选原因表 + "最少步骤证实/排除" |

**★ 纠正一个前提**：我们的厂商基线是**「库函数版源码（卡尔曼滤波版）」**，不是 DMP 版。
因此 `Way_Angle=2`、`Zhongzhi=1`、`stmflash.c` 的 `0X08020000`、`show.c` 的 `"F4"` **都是厂商原样**，
不是我们改的（此前"`Way_Angle` 从 1 改成 2"的说法**不成立**，特此更正）。

**★ 另一个必须记住的教训**：`make strict` 在**增量编译**下可能什么都不编 → 报"0 条"是假绿。
必须 `make clean` 后再跑。本次就是 clean 之后才暴露出 `show.c` 的几十条 `-Wpointer-sign`。

**★ 2026-10-15 收尾再补一条同样的教训**：`board_state.c` 用了 `#if CFG_IMU_LR_SOURCE` 却没包含
`app_config.h` ⇒ **宏静默取 0**（会取错 IMU 轴）。这次是 `make strict` 的 **`-Wundef`** 抓出来的
（`"CFG_IMU_LR_SOURCE" is not defined, evaluates to 0`）—— 说明"严格告警"要开**能抓静默失效**的那几项
（`-Wundef` 之类），而不是只看"能不能编过"。

---

## 2. 一句话结论

**安全停车锁存链本身是好的**（`safetyStop` → `Patrol_MotorsDisabled` → `App_MotorDisable` →
中断强制 `Flag_Stop=1` → `Turn_Off()` → 跳过 `Set_pwm()` + 清方向脚），
厂商的"放下自动使能"与"按键启停"两个旁路也都已堵上（铁律 29 那一类问题**已修好**）。
当前的危险不在锁存链，而在**三个外围环节 + 一个功能断链**（见 §3 的 A 组）。

---

## 3. 发现清单

### A 组：会炸 / 功能不可达（必须处理）

| # | 位置 | 问题 | 后果 | 状态 |
|---|---|---|---|---|
| A1 | `Drivers/BSP/USARTX/usartx.c:88-170`、`App/Task/patrol.c:149-160`、`board_state.c` | **运动指令断链**：RTOS 下**没有任何人能置位** `Flag_Qian/Hou/Left/Right`（厂商写者在 `#else` 里被编掉；另两个写者分别依赖未装的航模接收机与 CAN 帧）；0x20 的线/角速度 `data[0..3]` 在 `patrol.c` 被**直接丢弃**（只读 `data[4]` 使能位） | **车只会原地平衡、不会前进/转向** → 任务书"自主行进 / 覆盖率≥90%"不可达 | ✅ **已修（2026-10-15，§7.1 R4）**：按厂商原语义实现（方向标志 + 固定速度档）+ **500 ms 无指令自动停**看门狗；决策 64 |
| A2 | 审计 #3 + 症状反推 | **低压误触发**：`in.hwFault = (电压>0 且 <11.10V)` | 一上电即误锁存 FAULT → `Turn_Off()` 恒 1 → `Set_pwm()` 永不执行 → **电机毫无输出、车不能平衡** | **已修**（三级判据：>6.00 V 才算有电池 + 连续 5 拍确认） |
| A3 | `App/Sensor/dht11_hw.c` | **DHT11 位操作全程不屏蔽中断**，而控制中断每 5 ms 抢占 26~70 µs 的位窗口 | 校验失败 → 上百毫秒重试空转 → `T/H` 长期 N/A（**与实测现象一致**），且拖住 GasTask | **已修**（响应+40 位整段进临界段，所有出口都恢复中断；20/30 ms 等待留在开中断状态以免在关中断时调 `vTaskDelay`） |
| A4 | `App/Control/control.c:45` | **厂商 Flash 读路径保留、写路径被删**：`Flash_Read()` 读 `0x08020000`，而 RTOS 下无人写它（我们的持久化在 `0x08040000`）→ 空白判据恒真 → 把 4 个 PID 增益**静默写回 300/1/80/0.4**；且厂商把 10×u32(40 B) 读进 `u16[10]`(20 B) 本身越界 | **调好的参数被静默覆盖**（"存了却变回默认"） | **已修**（RTOS 构建下整段隔离，参数唯一权威 = `ParamStore`） |
| A5 | `App/Control/control.c:250-264` | `Turn_Off()` 每 5/10 ms 拿 `Voltage` 判 11.10 V，而 `Voltage` 是 **0.5 s 才更新一次**的均值，且无迟滞/无连续确认（与自研三级判据不是同一套） | 电池临界时**整段时间无输出** → 平衡车"突然软脚"→ 摔车 | **待修**（建议：复用 `s_lowBatCount` 的确认+迟滞，`1110` 改引用 `CFG_BAT_LOW_LIMIT`） |
| A6 | `App/Control/param_store.c:61` → `stmflash.c` → `stm32f4xx_flash.c` | **整扇区擦除**（0.4~4 s）在任务里同步执行，代码本身在 Flash 中跑（`.text > FLASH`），`FLASH_WaitForLastOperation()` **无超时** | 写参数期间控制中断被饿死 → 电机保持最后 PWM **数秒** | **待修**（保存前强制"安全停车 + 电机断电"；擦写函数搬到 RAM 并加超时） |

### B 组：会错（会静默给出错误结论）

| # | 位置 | 问题 | 后果 | 状态 |
|---|---|---|---|---|
| B1 | `App/Sensor/gas.c:196-216` + `sensor_report.c:39` | **R0 标定无有效性判据**：`Gas_VaoToRs` 在 `vao<=0` 时返回 0，`r0Sum += 0` 照样累加；`ready` 位只判 `r0>0` | 传感器未插/加热丝断时通道**静默失效、却仍报"就绪"**，状态机也不置 `PATROL_FLT_SENSOR` → 漏报 | **待修**（丢弃无效样本；样本数为 0 时不收尾并置故障位） |
| B2 | 症状反推 §2 | `fault=0x04` 的**真实原因尚未收口**：可能是①电池确实欠压 ②PB1/ADC 通路异常 ③判据过宽 | 决定"修判据"还是"查电池"的方向 | **待测**（**读电压**即可收口；0x15 诊断帧就为此而加） |
| B3 | `App/Task/app_tasks.c` + `control.c:69-70` | 自研 `in.hwFault` **只看低压**；"被拿起/倾角超限"由厂商在中断里直接关电机，**不经过锁存、不置 fault、不发事件** | 上位机看到"正常巡航"，实际电机已被关 → **监控与执行器脱节**（铁律 29 的另一半） | **待修**（用 `bs.vendorStop`/`bs.angle` 派生 `tiltFault`/`pickedUp` 进状态机） |
| B4 | `App/Task/app_tasks.c`（`s_cfg` 跨任务） | `s_cfg` 由 CommTask 整体覆盖，GasTask/TaskTask/UiTask 同时读，**无保护** | 0x23 下发那一拍可能出现字段新旧混搭 → 阈值/确认数用错 | **待修**（短临界区或双缓冲+序号） |
| B5 | `App/Task/app_tasks.c:731-758` | `App_GetGas/GetPatrol/GetDiag` 用 `taskENTER_CRITICAL` 包住**含浮点与几十个字段**的区间；而 `taskENTER_CRITICAL` **挡不住**优先级 0/1 的中断，真正竞态的写者也没被保护 | 临界区只贡献延迟（可能压后 USART 接收 → ORE 计数虚高），**同步是假象** | **待修**（生产者拍快照，getter 只读） |
| B6 | `App/Task/app_config.h:127` + `patrol.c:277-336` | `CFG_WAYPOINT_SPACING_MM=0` 使 `Odom_WaypointReached()` 恒 0，而 PATROL/RETURN **只靠它推进**、无时间兜底 | 永不返航；30 min 后超时 → 误报 HWFAULT | **待修**（加时间兜底，或明确"未配置"语义） |
| B7 | `App/Sensor/dht11_hw.c` 读失败路径 | 成功路径没有把 PA7 释放回输入（失败路径才释放） | PA7 长期推挽输出高，与传感器开漏并存 → 电平争用 | **已修**（随 A3 一并整段重构，`dht11_pin_in()` 在成功路径同样执行）|
| B8 | `System/usart/usart.c:32-49` | 新增的 TX 互斥**包住**厂商无超时的 `while(TXE)` | 一次 printf 卡死 → 永久持锁 → `CommLink_Send`(`portMAX_DELAY`) 阻塞 → **500 ms 失联安全停车失效**（当前无运行期 printf，属潜在） | **待修**（给 `_write` 加超时；RTOS 下禁止 printf 进链路）|

### C 组：隐患 / 一致性（记录在案，暂不动）

- **C1** `App/Sensor/sensor_adc.c`：起转换前不清 EOC，理论上可能读到上一拍的值（需实测确认）。
- **C2** `App/Task/odom.c:54`：中断 `+=` 与任务侧清零非原子（当前间距=0 未启用）。
- **C3** `App/Comms/comm_link.c:136`：发送超时是**循环次数**而非**时间预算**，取值可能达数十 ms/字节。
- **C4** `comm_link.c:44`：`xSemaphoreCreateMutex()` 失败时锁静默失效（两处同时写 USART）。
- **C5** `Drivers/BSP/NRF24L01/24l01.c:56`：把 `PC4` 配上拉输入；一旦启用 NRF，超声波 TRIG 会被改成输入 → 测距恒 0（**必须在启用前挪脚**）。
- **C6** `System/delay/delay.c`：`delay_us` 在 DWT 未使能时**静默返回**（无任何报错）。
- **C7** `control.c` 的 `Turn_Kp/Turn_Kd` 默认 52/0.5 与厂商逐位一致；`sys.h` 删掉的 `Roll` 已在 `mpu6050.h` 声明。
- **C8** `oled.c` 软 SPI 位间加可调延时（`OLED_BIT_DELAY_LOOPS`，默认 8）：GCC -O2 编出的翻转速度可能超过 SSD1306 的 SCL 上限（**现象正是"文字全挤进第 0 页"**）。**已在代码里预留**，待上板用 0x15 的写计数判别后再定值。

### D 组：已独立核对确认「没问题」

- **控制中断 `control.c`、OLED 驱动 `oled.c`、字库 `oledfont.h`**：与厂商原版**逐行相同**（去注释空白后 175/175/197 行全同）→ "规范改造把厂商逻辑改坏了"这个担心**不成立**。
- **参数映射链**：`ParamSet` 字段序 → `Board_SyncPidParams` 形参 → 厂商全局量 → 协议 ID `0x01~0x07`，**四处一致**，无静默串位。
- **安全链每一环都有真实读者**（含 `App_MotorDisable` 是 `volatile` 原子 store、急停有不等 100 ms 的立即通道）。
- **时间比较**：73 处 `Ms` 比较全部是无符号差值形式，未发现 `now > last + timeout` 写法。
- **协议解帧边界**：长度超限/为 0/数据段含 `0xAA`/CRC 失败重同步/环形缓冲溢出，均有断言覆盖。
- **持久化**：扇区不重叠（我们 `0x08040000` vs 厂商 `0x08020000`）、魔数+个数双校验、回读逐字段比对。
- **厂商文件 22 个归一化后 0 差异**（`motor.c`/`encoder.c`/`exti.c`/`adc.c`/`ioi2c.c`/DMP 全套…）；头文件只有守卫改名。

---

## 4. 上板动作顺序（每一步都"一次砍掉最多候选"）

> 本节是**第一轮（2026-10-13）**列的动作顺序，保留作为当时的判据依据；
> 第二轮（2026-10-15）的结论见 §7。

| # | 做什么 | 期望 | 能收口什么 |
|---|---|---|---|
| 1 | **烧含 0x15 的新 hex**，有线链路读 0x15：电压 / `flagShow` / `flagPage` / **OLED 写计数差分** / 四个任务 tick | 电压 900~1260、`flagShow=0`、写计数 ≈5120 B/s、四个 tick 都在涨 | OLED 是"没画"还是"画错"；哪个任务死了；B2 的电压值；B6 的进度 |
| 2 | 量 **PB1 与 J17/SW2** 的直流电压，与 0x15 的电压三方对照 | PB1 ≈ 电池/11 | B2 收口：真欠压 / ADC 通路异常 / 判据过宽 |
| 3 | 示波器看 **PC13(SCL)/PC0(DC)**；同时给 `J13` 的 AO 脚外接已知电压看 0x14 raw | 有连续时钟；外接 3.3 V → raw≈4095 | C8 定值；ADC2 通路是否无辜 |
| 4 | 倾斜车体看 **CN1 pin3/4、CN2 pin3/4** 是否有 PWM 变化 | 有占空比变化 | A5/A1：`Turn_Off` 是否挡住输出、解锁后能否恢复 |
| 5 | 按 ①②③④ 的结论**一次只改一处** | — | 避免把"本来就存在的"和"新引入的"混在一起 |

**★ 提醒**：即使修好 A2，`Flag_Stop` 上电默认仍是 1（厂商设计）——
**必须显式使能**（`0x20 enable=1` 或 `0x21 task=PATROL`）电机才会输出；否则会误以为"还是不动"。

---

## 5. 尚未收口的存疑项

| 存疑 | 缺什么 |
|---|---|
| A1 是"有意留空"还是"回归" | `docs/design_firmware/程序说明文档.md` 只写了 0x20 → `Patrol_Command`，没写"运动输出待接"；需确认 B 阶段计划里的意图（**但风险不变：不接就没有自主行进**） |
| DHT11 实际失败率 | 需要真机的成功/失败计数（建议顺手进 0x15 的 statusBits） |
| `CFG_TX_TIMEOUT_LOOPS` 真实耗时 | 需反汇编数该循环的指令数 |
| C1（EOC 陈旧） | 需上电后连续两帧 0x14 的 raw 对照 |
| 屏型号（SSD1306 / SH1106） | 屏排线丝印或换屏试验（SH1106 需把列低地址改为 `0x02`） |

## 6. 当前台架配置（2026-10-15 实测，随进度更新）

| 项 | 现状 | 备注 |
|---|---|---|
| 气体通道 | **只有 MQ-135，挂在 `J13`**（`J10` 未插模块） | `J10` 与 `J13` 四脚**电气相同**（`AO/DO/GND/+5V`），插错座不会损坏，只是**名字对不上**：现在 MQ-135 的读数被当成 `MQ2` 上报（走 `PA5`），而 `MQ135` 字段（`PA6`/`J10`）是空输入 |
| MQ-2 | ⚠️ **已烧毁待补**（原 `J10` 上那颗，模块内电阻烧了）；**`J10` 目前是空的** | 计划再买一颗新的装到 `J10`（即回到"J10=MQ-135、J13=MQ-2"的原始定义） |
| DHT11 | ✅ 正常（`statusBits` bit2 置位） | 中断屏蔽修复后 T/H 可用 |
| 蓝牙 | 模块 AT 通道正常；**广播名在手机/PC 上显示为 `?`**。**2026-10-15 结论**：Windows 蓝牙 SPP **能配对但建不出 COM 口**；Python 的 `AF_BLUETOOTH` **在 Windows 上不可用**、`pybluez2` 在 Python 3.13 上编译不过；本 Qt 套件**未安装 Qt Bluetooth 模块** | 手头两颗模块：一颗 **DX-Smart 克隆**（老式 HC-06 方言、**纯从机**、`AT+ROLE`/`AT+ADDR` 不回）；一颗 **JDY-33**（**经典 SPP + BLE**、可读 `AT+LADDR`、已配名 `Pie` / 密码 `6667` / 115200、当前从机 `AT+TYPE0`）。工具：[`bt_scan.py`](../../tools/fw_prep/bt_scan.py)（按**合法帧**识别端口）、[`bt_at.py`](../../tools/fw_prep/bt_at.py)（AT 配置，自动探波特率与方言）|
| OLED | ✅ **正常显示**（页 1 / 页 2 / 厂商页都能看） | 第一轮"OLED 乱码/怀疑没画"的现象**已解决**；写计数 8~9 KB/s（§7.3）|
| 电压 | 11.80~11.86 V（3S 已接） | `fault` 恒 0x00，未再出现误锁存 |

> ⚠️ 读数解释提醒：在 MQ-2 装回 `J10` 之前，上位机上**名为 `MQ2` 的那一路才是真正在工作的传感器**（因为它接的是 `J13`）。
> 文档与演示口径都要按这条注明，否则会把两路读反。

---

## 7. 第二轮真机联调（2026-10-15 晚）：根因与当前状态

### 7.1 找到并修掉的根因

| # | 根因 | 证据 | 状态 |
|---|---|---|---|
| R1 | **`control.c` 没有包含 `app_config.h`** ⇒ 它用的 `CFG_ENCODER_*_INVERT` / `CFG_MOTOR_*_INVERT` 被预处理器按『未定义 = 0』处理 ⇒ 所有 `#if CFG_xxx` **整段被跳过**，**开关写什么值都不生效，运行现象上完全看不出来** | 用 `compile_commands.json` 的精确编译命令做预处理：修复前 grep 不到 `Encoder_Left=-Encoder_Left`，修复后命中 | **已修**（AGENTS 铁律 35） |
| R2 | **开关套开关**：把『整体翻向』改成分侧时，分侧开关被外层旧开关 `#if CFG_ENCODER_DIR_INVERT`（=0）编译掉 | 同上 | **已修** |
| R3 | **编码器两侧极性不一致**（手推前进：`Enc L` 负 / `Enc R` 正）⇒ 速度环两侧和恒≈0（**瞎**）、转向环差值错（**对拧**） | `0x16` 的 `Enc` 列 + 手推测试，三轮日志一致 | **已修**（并进一步改为成对翻转以修速度环极性） |
| R4 | **A1 运动指令断链**：`0x20` 的连续量被丢弃、无人写 `Flag_Qian/Hou/Left/Right` ⇒ 车不会走 | 审计 F1 + 本次实现 | **已修**（`Board_WriteMotion` + 500 ms 看门狗） |

### 7.2 新增的可观测性设施（本轮最大价值）

- **`0x16` 三环实况**：`Bal / Vel / Turn` 三分量 + `Moto1/Moto2` + **真实 CCR** + 编码器原始计数 + 状态位（`Flag_Stop` / `App_MotorDisable` / **本拍是否真的调了 `Set_pwm`**）。它把铁律 29（『算出来 ≠ 真执行』）**可观测化**：`Moto` 大而 `CCR=0` 时工具会直接标『算了没执行』。
- **`0x15` 诊断帧**：电压 / 页号 / `Flag_Show` / 算法 / 状态位 / 剩余堆 / **OLED 写计数** / 四任务 tick。
- **固件版本字节**（`0x16` 偏移 19）= `(月<<4)|日` ⇒ 杜绝『烧没烧上』的扯皮。
- **`CFG_DEBUG_DISABLE_VELOCITY`** 编译期调试开关：上电即摘掉速度环，单独验平衡环方向（不远程写 `0x24` —— 会启动失联计时，工具静默 500 ms 即锁存安全停车、按键也解不开）。

### 7.3 当晚状态与下一步判据

- **已确认良好**：`fault=0x00`、电压 11.8 V、DHT11 有效、四任务 tick 正常、OLED 刷新 8~9 KB/s、`CCR = 1.17 × |Moto|`、`Enc` 修复后两侧**同号** ✅。
- **现象解释**：修好编码器后速度环第一次『看得见』速度，而『电机符号 × 编码器符号』此前未验证 ⇒ 乘积反 ⇒ **速度环正反馈 ⇒ 上电即跑飞（±90）**。**这恰恰证明修复生效**（此前速度环是瞎的，只会对拧/乱走）。另注：厂商 `Put_Down()` 每拍都跑，车平放即 `Flag_Stop=0` ⇒ **上电几拍内自动使能电机**是厂商设计。
- **下一步判据**（速度环已由编译期开关摘掉，安全）：手握车、轮子悬空、慢慢前倾 ~15° —— 轮子**往前追** ⇒ 平衡环方向对 ⇒ 关掉 `CFG_DEBUG_DISABLE_VELOCITY` 恢复速度环、进入 PID 微调；轮子**往后蹬** ⇒ 再把**电机成对**翻一次（只动平衡环）。
- **PID 微调顺序**：先 `Balance_Kd` 1 → 1.5 → 2（`0x24` 在线改，**不用再烧录**），再动 `Balance_Kp`（300 → 280 → 250）；`Velocity_Kp/Ki`（80/0.4，厂商默认）最后碰 —— 正反馈结构，错一点就失稳。

### 7.4 给上位机（C）的同步清单

1. ~~⚠️ `host/src/protocol/frame.h` 的 **`kMotion` 写成 N=11、实际 N=9** —— 必须改~~ →
   ✅ **已修**（现为 `kMotion = 0x11; // N=9（★ 不是 11，v1.1 已修正）`）；
2. ~~新增 `kDiag=0x15`（协议 §3.4）、`kInternals=0x16`（§3.5）~~ →
   ✅ **已补**（常量名为 `kDiag=0x15` / **`kLoop=0x16`**，见 `frame.h`）；
3. ~~补事件码 `0x08` 失联 / `0x09` 解除 / `0x0A` 急停~~ → ✅ **已补**（`LinkLostStop`/`SafetyReleased`/`EstopReceived`）；
4. **失联锁存必须处理**：上位机静默 >500 ms ⇒ 板子锁存安全停车，**硬件按键也解不开** ⇒ 需要『持续使能/保活』（≤200 ms 一次 `0x20 enable=1` 或心跳）；
5. `0x11.pwm` 语义 = `Balance + Velocity`（`±Turn` 求和时相互抵消），要分开看请用 `0x16`；
6. 新接口：`0x20` 运动（§3.6，带 500 ms 看门狗）、`0x24` 范围校验（§3.8）、版本字节（§3.7）。

---

## 8. B 部分收工：第二轮联调最终结论（2026-10-15 23:00）

> **给 C 侧（上位机）的接口与判读口径**：见 [`docs/handoff/给C侧_固件接口与判读口径.md`](../handoff/给C侧_固件接口与判读口径.md)（含 0x15/0x16 字段判读、负增益语义、保护状态与待办分配）。

> **状态：固件 B 部分完成** —— 小车可**稳定平衡**（用户确认"这一版 OK 了"）。
> 本节只留结论与依据；当晚的逐步过程见各次提交信息（`git log`）。

### 8.1 最终出厂参数（定稿）

由 `App/Config/app_config.h` 的 **`CFG_DEBUG_PARAM_OVERRIDE` + `CFG_OVR_*`** 在
`ParamStore_Load()` 之后**强制生效**（无论 Flash 里存了什么）：

| 参数 | 定稿值 | 厂商默认 | 说明 |
|---|---|---|---|
| `Balance_Kp` | **300** | 300 | 平衡环 P（未改） |
| `Balance_Kd` | **1** | 1 | 平衡环 D（过冲大时首选加它） |
| `Velocity_Kp` | **−80** | 80 | ★ **取负**：本机"电机符号 × 编码器符号"与厂商约定相反，负增益等效于翻符号（用户飞线困难，故用软件补偿） |
| `Velocity_Ki` | **−0.4** | 0.4 | 同上 |
| `Zhongzhi` | **0.5** | −4（卡尔曼版原码） | ★ 零点：重心偏后约 0.5°，需让车保持该前倾角使重心落到轮轴正上方 |
| `Turn_Kp` | **0** | 52 | 调试期置 0（转向环无权限 ⇒ 不可能原地转圈） |
| `Turn_Kd` | **0** | 0.5 | 同上 |

**方向/极性开关（软件现场补偿，用户明确"不改硬件"）**：

| 开关 | 值 | 含义 |
|---|---|---|
| `CFG_MOTOR_LEFT_INVERT` / `_RIGHT_` | **1 / 1** | 两个电机命令成对取反（平衡环作用方向） |
| `CFG_ENCODER_LEFT_INVERT` / `_RIGHT_` | **0 / 1** | 编码器成对取反（速度环反馈极性；手推前进时 `Enc` 两侧**同号**已实测） |
| `CFG_TURN_INVERT` | **0** | 转向环单独翻转（本轮未用上，保留开关） |
| `CFG_DEBUG_DISABLE_VELOCITY` | **0** | 调试用"上电摘速度环"；**定稿必须为 0**（见 §8.2 陷阱 D） |

### 8.2 当晚"难缠现象"的三个真因（都属"看不见的正确性问题"）

| # | 现象 | 真因 | 修法 | 铁律 |
|---|---|---|---|---|
| A | **"翻了方向却完全没变化"**（连续三轮） | `control.c` 用 `#if CFG_*_INVERT`，却**没有包含 `app_config.h`**（也无头间接包含）⇒ 宏按"未定义 = 0"处理 ⇒ 整段被预处理跳过，**现象上完全看不出** | `control.c` 补 `#include "app_config.h"`；**验证改用 `gcc -E` 预处理输出**（文件大小/哈希会被对齐吸收，给出假阴性） | 35 |
| B | **"USER 不使能后疯狂转圈"** | 主循环的 `if(Turn_Off(...)==0)` **没有花括号**，我在其后插入了两处 `#if` 翻转与 `Set_Pwm` ⇒ 展开后只有第一句受保护：`Moto2=-Moto2` 与 `Set_Pwm(...)` **无条件执行** ⇒ 停车态两轮拿到**相反命令**（且 `Turn_Off` 的**停车保护被绕过**，安全级） | 给该 `if` 补花括号；**插语句前先补花括号** | 37 |
| C | **"上电就跑飞"** | 厂商 `Put_Down()` 每拍都跑，"放下即启动"⇒ 上电几拍内自动使能 | 属厂商设计；调试期用 `CFG_DEBUG_DISABLE_VELOCITY` 摘掉速度环后再上电 | — |
| D | **"调 `Zhongzhi` 忽前忽后、漂移治不好"** | 启动期两段覆盖逻辑**顺序叠加**：`CFG_DEBUG_PARAM_OVERRIDE`（设 −80/−0.4）在前，`CFG_DEBUG_DISABLE_VELOCITY`（清 0）在后 ⇒ **后者把前者覆盖** ⇒ 速度环其实**从未运行**（`0x16` 日志：`Vel` 38 帧全 0） | 后者置 0；**凡"多段启动期覆盖"，必须核对叠加顺序** | 41 |

### 8.3 真正把问题"看"出来的方法（本轮最大经验）

**`0x16` 三环实况帧**（1 Hz，20 字节）：`Bal / Vel / Turn` 三分量 + `Moto1/Moto2` + **真实 CCR**
+ 编码器原始计数 + 状态位（`Flag_Stop` / `App_MotorDisable` / **本拍是否真的调了 `Set_pwm`**）。
它把铁律 29（"算出来 ≠ 真执行"）**变成可远程测量**：

- `Turn=0` 而 `Moto=-1159/+1159` ⇒ 一眼看出"两轮拿到相反命令"（真因 B）；
- `Vel` 全 0 ⇒ 一眼看出"速度环没在跑"（真因 D）；
- `Moto` 大而 `CCR=0` ⇒ 工具直接标"算了没执行"（保护态/未使能）。

**结论**：调车不要靠"看现象猜符号"，**把中间量上报出来**，让数据说话 —— 为此新增的两帧
（`0x15` 诊断 / `0x16` 三环）是本次联调性价比最高的投入。

### 8.4 遗留与待办（不影响 B 部分收工）

1. **缓慢漂移**：速度环已打开后可"站住"，但地面微斜/轮胎打滑仍会造成缓慢移动 —— 演示可接受；
   若要加强：`Velocity_Kp` −80 → −120 或 `Ki` −0.4 → −0.8（出厂值改一行即可）。
2. **`0x16` 的 `Moto` 是"翻向后"的值**（翻向代码直接改了厂商全局量）⇒ 与 `CCR` 对照时略有歧义；
   建议改为**局部变量翻向**（让 `Moto` 保持厂商语义），属显示口径优化。
3. **限幅越界**：`Xianfu_Pwm` 的 `Amplitude=8200`，而写寄存器 `×1.17` ⇒ 实际满幅在 **7179**，
   超过即 100% 占空（控制律失去分辨率）。厂商另一版（PID 学习源码）用 `6900/7200` 是**正确口径**，
   建议对齐为 **7179**（属优化项，非缺陷）。
4. **转向环未启用**：当前 `Turn_Kp/Kd=0`。启用前须先确认转向环极性（`CFG_TURN_INVERT` 或负增益），
   否则会回到"原地转圈"。
5. **MQ-2 模块待补**（`J10` 空），补件后需把文档里"名为 `MQ2` 的那路才是真在工作"的限制语撤掉。

---

> **项目归属**：中国石油大学（华东） 专业生产实习课程项目<br>
> **范围说明**：本项目不涉及 MiniBalance 控制板（STM32F405RGT6 版本）的硬件设计与改版；控制板直接沿用，A1 仅重做主底板。<br>
> **许可**：原创代码与文档采用 MIT License；第三方组件遵循各自原始许可证。
