pierrotto12138-code/balance-car-inspection-robot/docs/design_hardware/BOM表.md

# BOM 表（主底板「改」板） —— 角色 A1 交付物

> **对象**：MiniBalance V5.0 平衡小车**重做的底板**（EDA 里的板「改」= `Schematic2` + `PCB2`）
> **来源**：**由完工快照离线导出**，不是手抄 —— 见 [`tools/bom_export.py`](../../tools/bom_export.py)
> **生成命令**：`python tools/bom_export.py --csv hardware/bom/BOM_主底板.csv --md <表格>`
> **数据来源文件**：`hardware/硬件工程_完工版_20261008_最终/pcb/PCB2.epcb2`
> **统计**：位号 **52 个**；合并后 **27 行**；**52/52 均有立创料号**
> **按位号首字母**：C 21 个 / J 12 个 / R 10 个 / D 4 个 / U 3 个 / L 1 个 / S 1 个
> **实际下单**：见 §四（元件 `SO26101014446`、PCB 打样 `8942344A_Y2`）
> 更新日期：2026-10-16（初版 2026-10-09）

---

## 一、为什么这份 BOM 可信（可复跑、可交叉验证）

| 保障 | 说明 |
|---|---|
| **不是手抄** | 表格与 [`hardware/bom/BOM_主底板.csv`](../../hardware/bom/BOM_主底板.csv) 都由脚本从 EDA 完工快照直接生成，`--md/--csv` 一次性产出，改一处重跑即可 |
| **字段来自器件库，不是猜的** | 料号 `Supplier Part`（立创 C 编码）、厂商、厂商料号、封装、描述均取自 PCB 文件里的 `META` 器件库记录 |
| **位号数吻合** | 导出 **52 个位号**，与原理图/PCB 完工记录（104 元件 / **52 位号**）一致 |
| **料号全覆盖** | 52/52 都有立创料号 —— 与"元件已全有封装与立创料号"的既有结论一致（交叉印证）|
| **可交叉校验** | 位号集合可与引脚基线核验脚本 [`tools/fw_prep/pin_check.py`](../../tools/fw_prep/pin_check.py) 的期望表对照 |

> ⚠️ **离线导出的边界**：本表由 `.epcb2` 文件解析得到。若日后在 EDA 里改了元件，
> 需重新导出（或开 EDA 后用 `tools/eda_order_audit.js` / `eda_parts_stats.js` 复核）。

---

## 二、BOM（按器件合并，位号在同一行）

| # | 数量 | 位号 | 器件 | 型号 | 封装 | 立创料号 | 厂商 |
|---|---|---|---|---|---|---|---|
| 1 | 2 | C1 C2 | RVT220UF35V67RV0024 | RVT220UF35V67RV0024 | SMD,D8xL10.2mm | C2836441 | KNSCHA(科尼盛) |
| 2 | 8 | C3 C4 C5 C7 C8 C9 C11 C12 | FCC0805B104K500DT | FCC0805B104K500DT | 0805 | C5137467 | FOJAN(富捷) |
| 3 | 2 | C6 C10 | CA45A-B-25V-10uF-M | CA45A-B-25V-10uF-M | CASE-B-3528-19(mm) | C20617242 | XY(振华新云) |
| 4 | 1 | C13 | 220uF35V6.3x14GF | 220uF35V6.3x14GF | 插件,D6.3xL14mm | C49332886 | Econd(米朗电子) |
| 5 | 4 | C14 C15 C16 C17 | CT41G-0805-2X1-50V-0.1uF-K(N) | CT41G-0805-2X1-50V-0.1uF-K(N) | 0805 | C126469 | TORCH(火炬) |
| 6 | 2 | C18 C19 | 100uF25v电解电容 | 100uF25v电解电容 | CAP-SMD_BD6.3 | C9900004126 |  |
| 7 | 2 | CN1 CN2 | LAIL-PHC2.54-6P-01-XH-L | LAIL-PHC2.54-6P-01-XH-L | 插件,P=2.5mm | C54905977 | LAILAN(莱联) |
| 8 | 1 | D1 | ES2D_C212758 | ES2D | DO-214AA(SMB) | C212758 | DIOTEC(德欧泰克) |
| 9 | 3 | D2 D3 D4 | GL0805UR01 | GL0805UR01 | 0805 | C51933307 | Guiguang light(桂光光电) |
| 10 | 2 | J1 J2 | HC-PM254-8.5H-2x15PZ | HC-PM254-8.5H-2x15PZ | 插件,P=2.54mm | C22373920 | HC(虹成电子) |
| 11 | 3 | J5 J10 J13 | LAIL-PM2.54-4P-L | LAIL-PM2.54-4P-L | 插件,P=2.54mm | C54973823 | LAILAN(莱联) |
| 12 | 1 | J7 | X6511FRS-06-C85D30 | X6511FRS-06-C85D30 | SMD,P=2.54mm,卧贴 | C5142239 | XKB Connection(中国星坤) |
| 13 | 4 | J9 J11 J14 J18 | LAIL-PM2.54-3P-L | LAIL-PM2.54-3P-L | 插件,P=2.54mm | C54973828 | LAILAN(莱联) |
| 14 | 1 | J15 | DS1023-2*6SF11 | DS1023-2*6SF11 | 插件,P=2.54mm | C92269 | CONNFLY |
| 15 | 1 | J17 | AM-1015B-M | AM-1015B-M | - | C90631 | AMASS(艾迈斯) |
| 16 | 1 | L1 | STWRH105R-330MT | STWRH105R-330MT | 33UHSMD-1010 | C9900014639 |  |
| 17 | 1 | R1 | 0805W8F1501T5E | 0805W8F1501T5E | 0805 | C4310 | UNI-ROYAL(厚声) |
| 18 | 1 | R2 | RT0805BRD071KL | RT0805BRD071KL | 0805 | C110774 | YAGEO(国巨) |
| 19 | 1 | R3 | RT0805BRD0710KL | RT0805BRD0710KL | 0805 | C110775 | YAGEO(国巨) |
| 20 | 2 | R4 R5 | 0805W8F5101T5E | 0805W8F5101T5E | 0805 | C27834 | UNI-ROYAL(厚声) |
| 21 | 2 | R10 R12 | RC0805BR-0710KL | RC0805BR-0710KL | 0805 | C6752026 | YAGEO(国巨) |
| 22 | 2 | R11 R13 | CRG0805F15K | CRG0805F15K | 0805 | C3929039 | TE Connectivity(泰科电子) |
| 23 | 1 | R14 | RMC08054.7K1%N | RMC08054.7K1%N | 0805 | C269746 | Tyohm(幸亚电阻) |
| 24 | 1 | SW2 | SS-12D10L5 | SS-12D10L5 | 插件,13x6.8mm | C319012 | XKB Connection(中国星坤) |
| 25 | 1 | U1 | TB6612FNG(O,C,8,EL_C141517 | TB6612FNG(O,C,8,EL | SSOP-24 | C141517 | TOSHIBA(东芝) |
| 26 | 1 | U2 | LM2596S-5.0 | LM2596S-5.0 | TO-263-5 | C2980820 | Slkor(萨科微) |
| 27 | 1 | U3 | AMS1117-3.3 | AMS1117-3.3 | SOT-223-3 | C2891839 | YONGYUTAI(永裕泰) |

---

## 三、说明与核对要点

1. **数量列** = 使用该器件的位号个数；**位号列**是全部使用者，便于贴片时核对。
2. **加严/特殊器件**（下单与焊接时注意）：
   - `U1`（TB6612 电机驱动）为 **SSOP-24 实芯**，非模块座 —— 课程要求"集成到底板"；
   - `U2`（LM2596 降压）与 `U3`（AMS1117-3.3）构成 12V→5V→3.3V 电源树，**注意散热与电感 `L1`**；
   - 电解电容（`C1`/`C2`/`C13`/`C18`/`C19` 等）**有极性**，贴装方向必须按丝印；
   - `D1`（ES2D）为续流二极管，`D2`~`D4` 为指示 LED，均**有方向**。
3. **跨板/外购件不在本表内**：控制板、车架、电机、电池、车轮沿用原车；
   MQ-2 / MQ-135 / DHT11 / HC-SR04 / 蓝牙 / 蜂鸣器模块为**插接件**，不在本板 BOM（见 [模块功能与原理说明](模块功能与原理说明.md)）。
4. **DNP（留焊盘不焊/不装排针）**：红外两路 `J11`/`J14` —— 见 [改板规格书](改板规格书_单底板方案.md) 与决策记录。
5. **贴片 vs 插件**：`封装` 列里以 `0805`/`SMD` 开头的是贴片，`插件`/`CAP-SMD` 等按字面判断；
   下单时请按立创商城的实际封装核对。
6. ⚠️ **导出后建议人工复核的两处**（脚本如实导出，但**原始数据本身**可疑，不是我编的）：
   - **`C18`/`C19`**：器件名是中文「100uF25v电解电容」（本地自建器件、**厂商字段为空**），
     料号落在 `C9900004126` 这一段（立创的自编码区段）→ ✅ **已由采购记录闭合**：实际下单的是
     **`C46550402`**（JIERR 100 µF 25 V，SMD D6.3×L5.4），封装与本站的 `CAP-SMD_BD6.3` 相符
     （见 [`../../hardware/bom/采购记录_立创商城_SO26101014446.md`](../../hardware/bom/采购记录_立创商城_SO26101014446.md) §三）；
   - **`D1`**：器件名 `ES2D_C212758` 把料号写进了器件名里（于是"型号"列显示 `ES2D_C212758`、
     料号列显示 `C212758`）—— 这是**同一个器件**的两种写法，别当成两个料下单。
     ⚠️ 另：**实际下单买的是 `C698724`（扬杰 ES2D，SMB）**，与本站 `C212758`（德欧泰克）**型号/封装一致、仅厂商不同**（同为 ES2D + DO-214AA/SMB）。

---

## 四、实际下单与打样记录（**与设计 BOM 的差异都在这里**）

| 环节 | 单号 | 日期 | 金额 | 明细 |
|---|---|---|---|---|
| **元件采购**（立创商城）| `SO26101014446` | 2026-10-10 | 商品 ¥71.07 + 运费 ¥17.00 = **¥72.55** | 17 项 —— 见 [`../../hardware/bom/采购记录_立创商城_SO26101014446.md`](../../hardware/bom/采购记录_立创商城_SO26101014446.md) |
| **PCB 打样**（嘉立创）| `8942344A_Y2` | 2026-10-08 下单 / 10-10 交付 | **¥53.00**（5 片，非 SMT） | 2 层 / FR-4 / **1.6 mm** / **1 oz** / **有铅喷锡** / 绿油白字 / 过孔盖油 —— 见 [`../../hardware/gerber/README.md`](../../hardware/gerber/README.md) §二/§三 |

**与设计 BOM 的 4 处料号差异（均为等价件，已逐项核对）**：

| 本表（设计） | 实际下单 | 判定 |
|---|---|---|
| `D1` = `C212758`（德欧泰克 ES2D，SMB）| `C698724`（扬杰 **ES2D**，SMB）| ✅ 型号/封装一致，厂商不同 |
| `C18` `C19` = `C9900004126`（自建器件，⚠️见 §三-6）| `C46550402`（JIERR 100 µF 25 V，SMD D6.3×5.4）| ✅ **闭合存疑项**，封装相符 |
| `R10` `R12` = `C6752026`（YAGEO 10 kΩ ±0.1%）| `C161788`（PANASONIC 10 kΩ ±0.1% 250 mW）| ✅ 阻值/精度一致 |
| `R11` `R13` = `C3929039`（TE 15 kΩ ±1%）| `C5578723`（VISHAY 15 kΩ ±1% 500 mW）| ✅ 阻值/精度一致 |

> ⚠️ **本单未覆盖的位号**：`U1`(TB6612FNG)、`U2`(LM2596S-5.0)、`L1`、`CN1`/`CN2`、`J1`/`J2`、
> `J5`/`J7`/`J9`/`J10`/`J11`/`J13`/`J14`/`J15`/`J17`/`J18` —— 来源待 A1 补充说明。
> **本 BOM 仍是"设计要什么"的权威表**；"实际买了什么"以采购记录为准，两者不一致时按上表判定。

---

## 五、取材与溯源

| 项目 | 位置 |
|---|---|
| 完工快照（EDA 原始文件） | `hardware/硬件工程_完工版_20261008_最终/`（MD5 与工程一致）|
| 导出脚本 | [`tools/bom_export.py`](../../tools/bom_export.py) |
| CSV（Excel / 下单用） | [`hardware/bom/BOM_主底板.csv`](../../hardware/bom/BOM_主底板.csv) |
| **实际采购记录（17 项）** | [`../../hardware/bom/采购记录_立创商城_SO26101014446.md`](../../hardware/bom/采购记录_立创商城_SO26101014446.md) |
| **EDA 自己导出的 BOM（独立实现，可用于互证）** | [`../../hardware/eda_export_20261016/BOM_改_PCB2_2026-10-16.xlsx`](../../hardware/eda_export_20261016/BOM_改_PCB2_2026-10-16.xlsx) —— 本表是"脚本离线解析快照"，那份是"EDA 自己导出"，**两者一致才敢下单** |
| 贴片坐标 / 测试点 / 网表（同批导出） | [`../../hardware/eda_export_20261016/`](../../hardware/eda_export_20261016/README.md) |
| **Gerber / 打样工艺参数** | [`../../hardware/gerber/README.md`](../../hardware/gerber/README.md) |
| **焊接与上板测试** | [`上板测试记录.md`](上板测试记录.md) |
| 位号与网络逐脚核对 | [`tools/fw_prep/pin_check.py`](../../tools/fw_prep/pin_check.py)（PCB `PAD_NET` 逐脚比对，0 不符）|
| 器件功能说明 | [模块功能与原理说明](模块功能与原理说明.md) |

## 六、变更记录

| 日期 | 内容 |
|---|---|
| 2026-10-09 | 初版：由 `tools/bom_export.py` 从完工快照离线导出，52 位号 / 27 行 / 料号全覆盖 |
| 2026-10-16 | 新增 §四「实际下单与打样记录」：接入立创商城 `SO26101014446`（17 项明细）与嘉立创 `8942344A_Y2`（工艺参数）；列出**与设计 BOM 的 4 处料号差异**并判定为等价件；**闭合 §三-6 的 `C18`/`C19` 料号存疑项**（实买 `C46550402`）|

---

> **项目归属**：中国石油大学（华东） 专业生产实习课程项目<br>
> **范围说明**：本项目不涉及 MiniBalance 控制板（STM32F405RGT6 版本）的硬件设计与改版；控制板直接沿用，A1 仅重做主底板。<br>
> **许可**：原创代码与文档采用 MIT License；第三方组件遵循各自原始许可证。
