pierrotto12138-code/balance-car-inspection-robot/docs/design_hardware/上板自检清单.md

# 上板自检清单（焊接完成后逐项执行）

> **对象**：重做底板 + MiniBalance 控制板的整机联调
> **谁用**：A1（焊接与硬件自检）+ B（固件与联调）；每一项都给出**现象 → 命令 → 通过判据 → 不通过怎么查**
> **固件**：[`firmware/`](../../firmware/)；**调参工具**：[`tools/fw_prep/tune.py`](../../tools/fw_prep/tune.py)
> **前置**：`cd <仓库根>/firmware && make`（产出 `build/MiniBalance.hex`）
> 版本：v1.1（2026-10-15；v1.0 为 2026-10-09）
> 📌 **本清单的专项观察项已在 2026-10-13 / 10-15 两轮真机联调中执行过**，结论见
> [`../design_firmware/真机联调问题清单.md`](../design_firmware/真机联调问题清单.md)。
> 若要重新走一遍，**注意两条与本轮实测不符的地方**：
> ① **`USE_RTOS=0`（裸机对照）当前编不过**（`control.c` 的 `g_pwmApplied` 在裸机分支未定义）——
> §3.3 的"先烧裸机版对照"这一步暂时做不了，需 B 角先修；
> ② **OLED 已正常显示**、**DHT11 已正常**，早期"乱码/未就绪"现象不复现，不必再按旧现象排查。

---

## 0. 先读三句话

1. **先烧裸机版（`USE_RTOS=0`）再烧 RTOS 版（默认）** —— 前者与厂商原程序等价，
   一旦"裸机能平衡、RTOS 版不能"，问题一定出在我们的 RTOS 接入上，不用怀疑硬件。
2. **每一步都要记录数据**（电压、现象、命令输出），验收报告要用。
3. **不要在电机装车的情况下第一次上电** —— 先脱开电机或把车架垫起（见 §1.3）。

---

## 1. 上电前（不通电，万用表）

| # | 项目 | 命令/方法 | 通过判据 | 不通过怎么查 |
|---|---|---|---|---|
| 1.1 | **电源短路检查** | 万用表电阻档量 `+12V`↔`GND`、`+5V`↔`GND`、`+3.3V`↔`GND` | 无短路（几百 Ω 以上） | 逐段断开：先查 U2/U3 输入输出、再查 TB6612 的 VM/VCC |
| 1.2 | **焊接外观** | 目视 + 放大镜/手机微距 | 无连锡、无虚焊、电解电容方向正确 | 对照 [BOM 表](BOM表.md) §三 的"有极性/有方向"清单 |
| 1.3 | **电机与执行器脱开** | 拔掉 `CN1`/`CN2` 电机插头（或把车垫起让轮子悬空） | 电机不会在上电瞬间乱转 | — |
| 1.4 | **控制板就位** | 60 针接口插到底、方向正确 | 无偏移一列 | 对照 [改板规格书](改板规格书_单底板方案.md) 的座序表（`J1`/`J2` 命名有历史歧义，**认网络名不要认名字**）|

---

## 2. 上电检查（先不下载程序）

| # | 项目 | 方法 | 通过判据 | 不通过怎么查 |
|---|---|---|---|---|
| 2.1 | 12V 输入 | 万用表量 `J17` 输入 | 电池电压正常（>11.5 V，满电 ~12.6 V）| 电池/开关 `SW2`/保险 |
| 2.2 | **+5V 轨** | 量 `U2` 输出（LM2596） | 4.9~5.1 V | 若 12V 正常而 5V 无输出：查 `L1`、反馈分压、`U2` 焊接方向 |
| 2.3 | **+3.3V 轨** | 量 `U3` 输出（AMS1117） | 3.2~3.4 V | 查 `U3` 方向与输入 5V |
| 2.4 | 电源指示 | 看电源 LED（`D2`~`D4` 中对应者） | 亮 | 查 LED 方向（有极性）|
| 2.5 | 控制板供电 | 控制板 OLED 是否点亮/闪烁 | 上电后 OLED 亮 | 若底板 5V 正常但 OLED 不亮：60 针接触、控制板自身 |

> ⚠️ 上电时若 LM2596 或 TB6612 明显发热，**立即断电**再查（多半是连锡或方向错）。

---

## 3. 烧录与"能不能跑起来"

| # | 项目 | 命令 | 通过判据 | 不通过怎么查 |
|---|---|---|---|---|
| 3.1 | 串口 ISP 烧录（推荐） | 板上 MicroUSB → 电脑；FlyMcu 选串口、载入 `firmware/build/MiniBalance.hex`、开始编程 | 提示成功；车重启 | 串口被占用（关掉 `tune.py`/串口助手）；CH340 驱动；`BOOT0` 自动拉低电路（DTR/RTS）|
| 3.2 | SWD 烧录（备选） | `make flash`（内部 `STM32_Programmer_CLI -c port=SWD -d ... -v -rst`）| 下载并校验通过 | ST-Link 接线、`PA13/PA14` 未被占用 |
| 3.3 | **裸机版对照** | `make clean && make USE_RTOS=0` → 烧 `build/MiniBalance.hex` | 行为与厂商原程序一致（能平衡、OLED 显示）| ⚠️ **当前编不过**（`control.c` 的 `g_pwmApplied` 在裸机分支未定义）→ 需 B 角先修；修好后：若裸机也不正常 → 纯硬件/引脚问题，先别怀疑 RTOS |
| 3.4 | **RTOS 版** | `make clean && make`（默认带 FreeRTOS）→ 烧 | 同样能平衡；OLED 显示正常 | 见 §9 排障表 |

**为什么要这一步对照**：这次改造只动了三处与厂商基线不同（`delay` 改用 DWT、优先级组改 `Group_4`、转向环增益提为全局变量），
`USE_RTOS=0` 能把这些影响剥离出来 —— 是"二分定位"的第一刀。

---

## 4. 人机界面（OLED + 按键 + 蜂鸣器）

| # | 操作 | 期望现象 | 不通过怎么查 |
|---|---|---|---|
| 4.1 | 上电默认 | OLED 显示**页 0**（厂商界面：Kalman、温度、编码器、电压、角度）| 若花屏/黑屏：OLED 4 根线（PC0/PC13/PC14/PC15）与供电；对比裸机版是否同样 |
| 4.2 | **USER 键双击** | 切到**页 1**（GAS ENV：双路 ppm、Rs/R0、温湿度、报警、档位、CAL/COMP）| `Key()` 是否在执行（10 ms 分支）；按键是否接到正确引脚 |
| 4.3 | **USER 键再双击** | 切到**页 2**（PATROL：阶段/任务/进度/巡检点/两条链路字节数/剩余堆）| 同上 |
| 4.4 | 再双击 | 回到**页 0** | — |
| 4.5 | **USER 键单击** | 启停切换（与厂商一致）| 检查是否处于安全锁存（此时单击**故意无效**）|
| 4.6 | **USER 键长按** | 普通/避障切换（厂商原语义）| 长按判定是连续 200 次 10 ms 扫描 |
| 4.7 | **蜂鸣器** | 上电不响；用打火机气体（或设定低于本底的阈值）触发报警时**响** | PC5 低电平响、有源模块；若一直响 → 报警条件为真（看页 1）|

> 📌 页 1/2 的排版已按**真实步距**核算过（`OLED_ShowString` 每字符 **8 px**、数字 **6 px**，
> 见 [`人机界面设计说明.md`](人机界面设计说明.md) §3.6）：
> 所有字段右边界 ≤ 121 px、**无重叠无越界**。上板时只需目视确认一次；
> 若真出现压字，改 `firmware/App/Ui/pages.c` 里的坐标即可（坐标都写在注释里）。

---

## 3.5 结构整改后的专项观察（2026-10-13 P2/P3 新增）

> 这两项**只做了离线核验**（编译 + 断言 + 静态检查），上板时请重点确认一次。
> 它们都不改变控制时序，只影响"任务侧的延时与数据读取"。

| # | 观察项 | 期望现象 | 不通过怎么查 |
|---|---|---|---|
| 3.5.1 | **`Delay_SetMsHook` 注入是否生效**（P2.1） | 调度器跑起来后，任务里的 `delay_ms()` 走 `vTaskDelay`：表现为**其它任务照常运行**（OLED 仍在刷新、心跳仍在涨），而不是整机卡住一段时间 | 若表现为"每次 DHT11 读取（约 20 ms）期间 OLED/通信都停" → 钩子没注入成功。查 `App_Start()` 里 `Delay_SetMsHook(app_delay_ms)` 是否在 `vTaskStartScheduler()` **之前**、`System/delay/delay.c` 的 `s_msHook` 是否被清成 0 |
| 3.5.2 | **`board_state` 单一出口取数是否正确**（P2.2/P2.4） | 用调试器 `watch`：`Board_ReadRaw()` 返回的 `angle/voltage/encLeft` 与厂商量 `Angle_Balance/Voltage/Encoder_Left` **同拍一致**；`App_MotorDisable=1` 时 `Flag_Stop` 被强制为 1 | 若上报的角度/电压恒为 0 → 检查 `board_state.c` 是否正确 include `sys.h`、`Board_ReadRaw()` 的字段映射有没有漏 |
| 3.5.3 | **头文件守卫改名后无头文件被漏掉**（P3） | 编译期无 `implicit declaration`、无"某个模块的行为像没生效"（守卫撞名会导致**整个头文件被静默跳过**） | 用 `arm-none-eabi-gcc -H`（或 `-M`）看某个模块的头是否真的被包含；重点看 `MPU6050.h` 与 `usart.h`（历史上都叫 `__USART_H`）|
| 3.5.4 | **空白规范化未改动语义**（P3） | 功能与规范化前**完全一致** | 规范化脚本自带"非空白字符零变化"校验；如仍有疑虑，可与 `hardware/固件快照_20261013_1804` 逐文件 diff（只应有空白差异）|

---

## 5. 双链路通信（**这是与上位机联调的地基**）

| # | 项目 | 命令 | 通过判据 |
|---|---|---|---|
| 5.1 | **有线链路**（板上 MicroUSB → USART1，115200） | `python tools/fw_prep/tune.py -p COM<x> --dump` | 打印 7 个 PID 参数（Balance_Kp=300 等），说明**收发都通** |
| 5.2 | 有线：周期上报 | `python tools/fw_prep/tune.py -p COM<x> --monitor 5` | 每 50 ms 一行 pose/motion；5 Hz 心跳 |
| 5.3 | **蓝牙链路** | 手机/电脑配对蓝牙模块（115200 8N1），同样用 `tune.py`（换成蓝牙的虚拟串口）| 与有线一致 | 
| 5.4 | 蓝牙波特率 | **模块侧已确认可到 115200**（JDY-33 已配 115200）；若 5.3 仍全乱码 | ⚠️ **Windows 端 SPP 能配对、建不出 COM 口**（2026-10-15 实测）⇒ 联调主线用**有线**；先用 [`../../tools/fw_prep/bt_scan.py`](../../tools/fw_prep/bt_scan.py) 按**合法帧**确认口，再用 [`bt_at.py`](../../tools/fw_prep/bt_at.py) 探波特率/方言。⚠️ 老式 HC-06 方言的**纯从机**克隆模块改不了波特率 |
| 5.5 | 断链安全停车 | `--monitor` 时**拔掉**蓝牙/USB | **500 ms 内**车停止（页 2 出现 `LOCK`，蜂鸣器响）；重新连上**不会自动起步** |
| 5.6 | 解除安全停车 | `tune.py -p COM<x> --start`（下发 0x21 任务=巡航）| 锁存解除、电机重新使能 |

> ⚠️ **烧录与通信是同一个串口**（CH340G → PA9/PA10）：用 FlyMcu 烧录时要先关掉 `tune.py`/串口助手，
> 反之亦然。做 5.1~5.6 时不要再开 FlyMcu。

---

## 6. 电机 / 编码器 / 姿态

| # | 项目 | 方法 | 通过判据 | 不通过怎么查 |
|---|---|---|---|---|
| 6.1 | 编码器方向 | 用手推左轮向前，看页 0 的 `EncoLEFT` | 数值符号一致、两轮同向 | 若反了：编码器 A/B 相接反（硬件）或软件取反 |
| 6.2 | 电机方向 | 单击启用后**轻轻**给指令（或手扶车），看两轮是否同向驱动 | 同向、与编码器一致 | TB6612 的 AIN/BIN 与电机线序 |
| 6.3 | 姿态角 | 页 0 的 `Angle` | 静止时接近机械中值（`Zhongzhi`）；倾斜时符号正确 | MPU6050 软 I2C（PB10/PB11）、姿态算法 `Way_Angle=2`（卡尔曼）|
| 6.4 | **里程计**（新功能） | 页 2 看累计里程（或 `tune.py --monitor` 看轮速）| 前进时数值增长；与卷尺量出的距离大致吻合 | 标定系数在 `app_config.h`：`CFG_ENCODER_COUNTS_PER_REV`、`CFG_WHEEL_DIAMETER_MM` |
| 6.5 | 超声波 | 页 0 的 `Distance` | 前方挡板移动时数值跟着变（cm）| **TRIG 必须是 PC4**（改板实际；基线源码是 PC2，已改）；ECHO=PB0 |

---

## 7. 平衡验证（本项目最关键的一步）

| # | 步骤 | 通过判据 | 说明 |
|---|---|---|---|
| 7.1 | 车直立、单击启用 | 车能自主保持直立、轻微晃动后收敛 | **先确认"未调参时与厂商基线等价"** —— 这是本次移植的核心承诺 |
| 7.2 | 若 7.1 不过 | 用 `USE_RTOS=0` 版对照：裸机能平衡而 RTOS 版不能 → 问题在 RTOS 接入（优先查 `delay`/优先级/调度器启动）| — |
| 7.3 | 推向平衡点两侧 | 能自动回正、无持续单向跑 | `Zhongzhi`（机械中值）需按实车调整 |
| 7.4 | 记录初值 | 记下能平衡时的参数（`0x24 --dump` 输出存文件）| 作为调参基线 |

---

## 8. 传感器标定与告警验证

| # | 项目 | 方法 | 通过判据 |
|---|---|---|---|
| 8.1 | **MQ 负载电阻 `RL` 实测** | 断电，万用表量模块 `AOUT`↔`GND` 的电阻（约等于 RL；若随电位器变化，说明电位器就是 RL）| 得到具体阻值 → 填进 `firmware/App/Sensor/gas.c` 的 `cfg->rlOhm` 后重新烧录 |
| 8.2 | **清洁空气标定 R0** | 上电后在**洁净空气**中等待预热结束（120 s，页 1 从 `CAL...` 变 `CAL OK`）| 页 1 的 `Rs/R0` 接近 1.0（因为 R0 就是此刻标定的）；`0x24` 存 Flash 后可掉电保持 |
| 8.3 | 本底复核 | 稳定后看页 1 的 ppm 估计值 | 应在**几 ppm 量级**（MQ-2 ≈ 3.6、MQ-135 ≈ 4.3 是本项目的估计本底，见 `app_config.h` §四 的推导）|
| 8.4 | **阈值触发** | 用打火机（不点火）靠近 MQ-2，或酒精棉靠近 MQ-135 | 页 1 出现 `ALM`、蜂鸣器响、上报 0x13 事件；移开后**迟滞**生效（降到阈值 90% 才解除）|
| 8.5 | **自适应采样** | 触发报警时看页 1 档位 | 从 `1HZ` 变 `FAST`（5 Hz）；解除后回到 1 Hz |
| 8.6 | 温湿度 | 页 1 的 `T`/`H` | 与温度计/湿度计接近；若显示 `T/H N/A` → DHT11 通信失败（已内置 3 次重试）|
| 8.7 | 补偿开关 | 下发 `0x23`（补偿使能=1）| 页 1 变 `COMP ON`；★ 补偿默认关（决策 39），开启前应确认 `Rs/R0` 变化方向合理 |

---

## 9. 排障速查（现象 → 先查什么）

| 现象 | 优先检查 |
|---|---|
| 烧录失败 | 串口是否被占（`tune.py`/串口助手）→ CH340 驱动 → BOOT0/DTR 电路 |
| 裸机与 RTOS 行为不同 | `delay`（DWT）、`NVIC_PriorityGroup_4`、调度器是否启动、`configLIBRARY_MAX_SYSCALL_INTERRUPT_PRIORITY` |
| 车"不动但 OLED 正常" | 是否处于安全锁存（页 2 `LOCK`）→ 用 `tune.py --start` 解除；或 `Flag_Stop` 被倾角/低压保护置位 |
| 收不到任何帧 | 波特率（115200）、TX/RX 是否接反、是否用了同一个串口做烧录、页 2 的 `BT rx`/`WR rx` 是否在涨 |
| 帧时有时无 | 页 2 的 `dr`（丢弃数）在涨 → 环形缓冲溢出（提高任务优先级或减小上报率）|
| 气体读数不动 | ADC 通道（PA5/PA6 走 ADC2）、分压网络、模块供电 5V、`RL` 是否正确 |
| 测距恒为 0 | **TRIG=PC4**、ECHO=PB0、超声波模块 5V |
| 堆在减少 | 页 2 的 `Hp`（剩余堆 KB）持续下降 = 内存泄漏 → 检查任务/队列创建是否在循环里 |
| 某个任务不跑 | 页 2 只显示两条链路与堆；用调试器看 `App_TaskTicks()` 的四个计数 |

---

## 10. 完成后要留下的记录（验收材料）

1. 本节各表的**实测数据**（电压、现象、命令输出）；
2. `tune.py -p COMx --dump` 的**调参前后参数对比**；
3. `tune.py -p COMx --observe 20 --csv run1.csv` 的**观测 CSV**（含姿态统计：标准差/零振荡频率）；
4. 一条**完整任务链**的记录：上电 → 预热 → 待机 → 下发任务 → 巡检（含一次气体报警）→ 返航 → 完成；
5. 三条**安全通道**的验证记录：拔链路（500 ms 停）、急停 0x2F、低压/倾角保护。

---

## 11. 变更记录

| 日期 | 内容 |
|---|---|
| 2026-10-09 | 初版：按"上电前 → 上电 → 烧录 → 界面 → 通信 → 电机/姿态 → 平衡 → 标定 → 排障 → 记录"编排，每项给出通过判据与排查方向 |
| 2026-10-13 | 新增 **§3.5 结构整改后的专项观察**：P2 的 `Delay_SetMsHook` 注入、`board_state` 单一出口取数，以及 P3 的守卫改名/空白规范化的上板确认项；并把 §4 的页 1/2 排版说明从"估算 6 px"更新为"已按真实步距核算、无重叠无越界" |
| 2026-10-15 | **v1.1**：标注本清单的观察项已在两轮真机联调中执行、结论指向《真机联调问题清单》；§3.3 明示 **`USE_RTOS=0` 当前编不过**（裸机对照这条退路暂时断了）；§5.4 按实测改写（**模块侧 115200 已确认**，但 **Windows 建不出 SPP COM 口** ⇒ 联调主线走有线） |

---

> **项目归属**：中国石油大学（华东） 专业生产实习课程项目<br>
> **范围说明**：本项目不涉及 MiniBalance 控制板（STM32F405RGT6 版本）的硬件设计与改版；控制板直接沿用，A1 仅重做主底板。<br>
> **许可**：原创代码与文档采用 MIT License；第三方组件遵循各自原始许可证。
