pierrotto12138-code/balance-car-inspection-robot/docs/setup/开发环境准备清单.md

# 开发环境准备清单

> 配套文档：`项目计划书_仓储环境安全巡检机器人.md`
> 用法：按 A → B → C → D → E 顺序做，做完打勾。⏱ 标注为耗时估计。
> **最优先的两件事**：**A1**（装 CubeMX）和 **D1**（申请气体传感器模块）——因为 MQ 传感器需要 24–48 小时通电老化，越早领到手越好。

---

## A. 立刻要装的软件

### A1. STM32CubeMX　⏱ 约 30 分钟（含下载）

**为什么必需**：任务书举的是 Keil + FreeRTOS，但本项目交付**不使用 Keil**（决策 34）。CubeMX 可用来配置引脚 / 时钟 / FreeRTOS 并导出工程；**实际采用的路线**是 ST 标准外设库（FWLIB）+ `arm-none-eabi-gcc` + Makefile（见 `firmware/README.md`）。

**步骤**：
1. 打开 https://www.st.com/ ，搜索 **STM32CubeMX**
2. 注册一个 ST 账号（免费，邮箱即可）
3. 下载安装包（约 300 MB）并安装到任意目录（与 CubeCLT 放一起便于管理即可）
4. 首次运行会提示下载固件包，选 **STM32F1** 系列（约 500 MB），让它下载完

**装完告诉我**：安装路径。

---

### A2. Qt Serial Port 组件　⏱ 约 10 分钟

**为什么必需**：Qt 6.11.2（含 Charts / Sql / Widgets）已装，**唯独缺 SerialPort**——这是上位机做串口通信的核心组件。不用重装整个 Qt，只加装这一个组件。

**步骤**：
1. 运行 Qt 安装目录下的 `MaintenanceTool`（Windows 为 `MaintenanceTool.exe`）
2. 登录 Qt 账号 → 选「**添加或移除组件**」
3. 展开 `Qt` → `Qt 6.11.2` → 在 Additional Libraries 分类下勾选 **`Qt Serial Port`**
4. 顺手确认 **`MinGW 13.1.0 64-bit`** 已勾选（编译套件，应该已经装了）
5. 下一步，等下载安装完成

**装完告诉我**：Qt 的根目录路径（用于配置构建环境）。

**如果 MaintenanceTool 里找不到 Serial Port 选项**：告诉我，我改用 PySide6（已装且完整）或从源码编译，这两条路都通。

---

### A3. 嘉立创EDA **专业版**（LCEDA Pro）　⏱ 约 15 分钟

**⚠️ 必须是「专业版」，不能是标准版。**

**为什么必需**：我们选定的参考主板工程是**立创EDA 专业版格式**（`.epro`），标准版打不开。而且专业版官方支持「导入 Altium Designer 文件」，未来兼容性更好。

**步骤**：
1. 访问 https://pro.lceda.cn/ 或 https://lceda.cn/ （注意选**专业版**入口）
2. 下载 Windows 客户端并安装（免费，需注册立创账号）
3. 装完**先别急着画图**——等我把参考工程下载下来，你先试着打开那个 `.epro`，确认能正常显示原理图和 PCB

**装完告诉我**：能否正常打开参考工程（我会先给你文件路径）。

---

### A4. Fusion 360 学生版（A2 用）　⏱ 约 40 分钟 + 1–3 天审核

**为什么必需**：A2 要出结构方案、装配图、外观效果图。Fusion 360 建模与出图一体，国内高校通用、教程多、有学生免费授权。

**步骤**：
1. 访问 https://www.autodesk.com.cn/education/edu-software/overview
2. 用学校邮箱申请**教育版免费授权**
3. **注意：审核通常要 1–3 天，所以今天就要申请**，不要等到要用时才申请
4. 审核通过后下载安装

**备选（如果申请太慢）**：**FreeCAD**（https://www.freecad.org/ ）——完全免费、开源、离线可用，能读 STEP/STL、能出装配图，但没有 Fusion 好用。

**装完告诉我**：用哪个、以及导出格式（建议统一用 STEP + PDF）。

---

### A5. Cura 或 PrusaSlicer（3D 打印切片）　⏱ 约 15 分钟

**为什么可能需要**：A2 的外壳与传感器支架大概率要 3D 打印。**先问实验室**——如果实验室有自己的切片软件、或由实验室师傅代打，这项可以直接跳过。

- Cura：https://ultimaker.com/software/ultimaker-cura
- PrusaSlicer：https://www.prusa3d.com/prusaslicer/

---

### A6. VOFA+（B 调 PID 用）　⏱ 约 10 分钟

**为什么必需**：调平衡 PID 时要看实时波形。我们不做本地断点调试，全靠串口波形观测。VOFA+ 免费、协议简单（一串 float 数组发出去就能画图）。

**步骤**：
1. 访问 https://www.vofa.plus/ 下载 Windows 版
2. 装完不用配置，等 B 开始调 PID 时我告诉你怎么用

**可选**：**SSCOM** 或 **友善串口助手**（轻量串口终端，手测备用）。日常我用 Python 脚本收发，不用 GUI，所以这个非必需。

---

### ✅ 已经装好的，不用管

| 工具 | 状态 |
|---|---|
| STM32CubeCLT 1.22.0 | ✅ arm-none-eabi-gcc 14.3 / CMake 4.3 / Ninja 1.13 / Make 4.4 / STM32_Programmer_CLI 2.23 / arm-gdb / ST-LINK_gdbserver 全部可用 |
| Qt Creator 20.0.1 + Qt 6.11.2 MinGW | ✅ Charts / Sql / Widgets 已就绪，只缺 SerialPort（见 A2） |
| Python 3.13 + pyserial 3.5 + PySide6 | ✅ PySide6 含 QtSerialPort，可做协议联调脚本 |
| Git 2.55 | ✅ 但见 E1——**git 用户名邮箱还没配** |
| CH340 串口驱动 | ✅ 已装，插上 USB-TTL 即可用 |
| MSVC 14.44 Build Tools | ✅ 已装（当前 Qt 是 MinGW 套件，暂时用不上） |

### ❌ 明确不装的

- **Keil MDK**：按已定方案不装。代价是本地无 GUI 断点调试（调 PID 靠 VOFA+ 波形）；交付时用 CubeMX 生成的 `.uvprojx` 到机房 Keil 打开。

---

## B. 要问老师 / 助教的事

### B1. 关于交付物与工具（影响合规性，越早问越好）

- [ ] **B1-1**　B 角色必须用 **Keil** 吗？我们用 CubeMX 生成 `.uvprojx` 交付、但实际用 arm-gcc 编译调试，老师认可吗？
- [ ] **B1-2**　A1 的电路交付范围：我们计划做「**参考方案改版主板 + 无源传感器转接板**」两块板，是否满足"电路原理设计、PCB 设计、电路板制作与调试"的考核要求？
- [ ] **B1-3**　**PCB 打样费用**能否报销？或实验室是否有合作板厂渠道？（自费预算约 ¥100–150，两次打样）
- [ ] **B1-4**　上位机用 **Qt C++** 是否符合要求？（任务书写的是"VC++/Qt C++、labview"）
- [ ] **B1-5**　**考核细则与评分标准**——任务书说"将在宣讲导入课集中讲解"，能否提前拿到？这份文件直接决定我们该把精力放在哪。

### B2. 关于实验室条件

- [ ] **B2-1**　实验室的实际套件是什么？**主控型号、IMU 型号、无线模块、电机驱动芯片、编码器线数**——这是最关键的一问，决定固件怎么搭
- [ ] **B2-2**　实验室提供**整套车**（车架 + 电机 + 电池 + 主板），还是只有散件需要自己配？
- [ ] **B2-3**　能否借到：**ST-Link V2 调试器**、**万用表**、**示波器**（要测气体传感器的 5V 供电纹波）？
- [ ] **B2-4**　模块申请表的提交时间与流程？**MQ 传感器需 24–48 小时通电老化**，我们想尽早领到手通电
- [ ] **B2-5**　实验室是否有 **3D 打印机**？是否需要自己切片？
- [ ] **B2-6**　老师给的**网盘参考资料**链接能否再发一次？（本地没找到已下载的痕迹）

---

## C. 去实验室要核对的硬件

> 建议直接拿着这份清单去，边看边填。**这份清单的结果决定固件工程怎么建**——填错会导致大量返工。

### C1. 主控与开发板

| 项目 | 实测结果 |
|---|---|
| 主控型号 | ______（F103C8T6？F401RE？其他？） |
| 封装 | ______（LQFP48 / LQFP64 / 核心板？） |
| 开发板是**核心板插座式**还是**芯片直接焊在板上**？ | ______ |
| 如果是核心板：是不是标准 **2×20 排针（Blue Pill 规格）**？ | ______ |
| **板上有没有把 GPIO 引出来成排的排针/排母？** | ______（**这条最重要**，直接决定外挂模块的难易） |
| 有几路**空闲 ADC** 引到了排针？ | ______（我们需要 2 路接气体传感器） |
| SWD 调试口是否引出？ | ______ |

### C2. 传感器与外设

| 项目 | 实测结果 |
|---|---|
| IMU 型号 | ______（MPU6050？LSM6DS3？其他？） |
| IMU 是**模块插上去**还是**芯片焊死**？ | ______ |
| 无线模块型号 | ______（HC-05 经典蓝牙？BLE？ESP8266？） |
| 无线模块是**插座**还是焊死？ | ______（若是插座，我们可自行更换模块，通信方案更灵活） |
| 电机驱动芯片 | ______（TB6612？L298N？DRV8833？） |
| 电机型号与编码器线数 | ______ |
| 超声波、OLED、红外避障是否有现成接口座？ | ______ |

### C3. 电源

| 项目 | 实测结果 |
|---|---|
| 电池规格 | ______（几节？电压？容量？） |
| 有几路稳压输出？分别多少 V？ | ______ |
| **5V 轨能提供多大电流？** | ______（我们需要约 300 mA 给两路气体传感器） |
| 有没有现成的 5V / 12V 对外接口（接线端子/排针）？ | ______ |
| 板载 5V 走线情况（若能看到 PCB） | ______ |

### C4. 机械

| 项目 | 实测结果 |
|---|---|
| 车架 / 底盘型号 | ______ |
| 轮径、轴距 | ______ |
| 底盘上有没有预留安装孔 / 扩展空间？ | ______ |
| 主板与底盘的固定方式 | ______ |

### C5. 拍照留档

> **拿着手机把下面这些都拍下来**，我会根据照片判断接口与布局：

- [ ] 主板**正面**照片（能看清丝印）
- [ ] 主板**背面**照片
- [ ] 主板上的**排针 / 排母 / 接插件特写**
- [ ] 整车正视图与侧视图（看结构和重心）
- [ ] 如果有原理图 / 引脚表，**拍下来或要电子版**

---

## D. 要申请的实验室模块

### D1. 🔴 核心必申（7 类，优先提交）

> **提交理由要写清楚**：MQ 系列传感器需要 **24–48 小时通电老化**才能稳定读数，因此必须尽早领到、尽早通电。

| # | 模块 | 数量 | 在本项目中的用途 |
|---|---|---|---|
| 1 | **MQ-2** 烟雾 / 可燃气传感器 | 1 | 可燃气体与烟雾检测主通道 |
| 2 | **MQ-135** 空气质量传感器 | 1 | 有害气体与空气质量通道，与 MQ-2 构成双通道交叉验证 |
| 3 | **DHT11** 温湿度传感器 | 1 | 环境温湿度采集，用于气体传感器在线补偿 |
| 4 | **0.96" OLED** 显示屏（I2C 接口） | 1 | 车载就地显示巡检状态与浓度 |
| 5 | **5V 蜂鸣器**模块 | 1 | 超阈值声光报警 |
| 6 | **HC-SR04** 超声波模块 | 1 | 避障测距 |
| 7 | **红外避障模块** | 2 | 近距避障 + 沿边循迹（两个方向各一） |

### D2. 🟡 增强申请（4 类，备注写"若有余量"）

| # | 模块 | 数量 | 用途 |
|---|---|---|---|
| 8 | **振动传感器**模块 | 1 | 碰撞 / 跌落事件检测 |
| 9 | **人体红外感应**模块（HC-SR501） | 1 | 人员闯入检测（仓储安全附加功能） |
| 10 | **光线检测模块** | 1 | 仓储照明状态监测 |
| 11 | **DS18B20** 不锈钢封装温度探头 | 1 | 高精度温度基准（可作为温湿度补偿的验证对照） |

### D3. ❌ 不申请

以下模块与本项目 T2 方案无关，**申请了也用不上，避免占名额**：

- **MQ-3 酒精传感器**、**MQ-5 液化气传感器**、**MQ-7 一氧化碳传感器** —— 本方案只用 MQ-2 + MQ-135 双通道，不需要更多通道
- **雨滴检测传感器** —— 与仓储环境巡检题目无关
- **加热片**、**风扇驱动** —— 本方案不做气室恒温与主动吹扫

### D4. 自费 / 自行采购（题目需要但实验室可能没有）

**比多通道方案少很多——这是 T2 方案的核心优势：**

- [ ] **排针 / 排母 / 杜邦线** 若干（主板增加传感器接口、转接板连接用）
- [ ] **分压电阻**（如 10 kΩ 与 20 kΩ 各若干）与 **去耦电容**（100 µF、0.1 µF）——用于气体模块模拟输出的分压与滤波
- [ ] **洞洞板**若干（如果转接板先用手工板验证）
- [ ] **PCB 打样费**（约 ¥100–150，两次打样预算）

**不需要以下这些**（那是多通道阵列方案才要的）：
- ~~ADS1115 外置 ADC~~ —— 本方案只用 2 路 ADC，主板现成空闲通道够用
- ~~独立 12V→5V 降压模块~~ —— 两路气体传感器约 300 mA，主板 5V 余量充足
- ~~MOSFET 高边开关阵列~~ —— 不需要复杂的加热丝占空比控制

---

## E. 组内要确认和推进的事

### E1. 配置 git（我配置不了，需要你操作）⏱ 2 分钟

当前 git 的 `user.name` 和 `user.email` **都是空的**，不配置的话第一次提交会失败。在 Git Bash 里执行：

```bash
git config --global user.name "你的名字"
git config --global user.email "你的邮箱@example.com"
```

### E2. 确认四个角色的实际分工　⏱ 20 分钟

- [ ] 组里**谁是 A1（电路）/ A2（结构）/ B（程序）/ C（上位机）**？
- [ ] 把四个角色的**姓名、学号**填进计划书（现在还是空的）
- [ ] 确认**组号和组长姓名**
- [ ] 提醒全组：答辩是**个人独立答辩 8–10 分钟**，针对个人分工深度提问（任务书明确写了"个人差异度考核"）。**每人要对自己那块负责到底，不能只挂名**

### E3. 开一次协议冻结会（B + C 必须参加）　⏱ 40 分钟

> 我在计划书 5.5 节给了完整协议草案。这次会的目的是**让 B 和 C 当面确认字段**，然后冻结成独立的协议版本文件。

讨论要点：
- [ ] 物理链路确认：**经典蓝牙 SPP，115200 8N1**（如果实验室给的是 BLE 模块，这里要改）
- [ ] `0x14` 环境与气体帧里"补偿后浓度"的单位与量程（现在是 ppm×10 的 uint16）
- [ ] `0x23` 巡检参数里双路告警阈值的**默认值**定为多少
- [ ] 20 Hz 的状态上行是否合适？（20 Hz × 每帧约 20 字节 ≈ 400 B/s，115200 带宽完全够）
- [ ] 确认参考代码使用约定：**只读借鉴、不整段复制**，报告注明来源

### E4. 确认选题并交给老师审批

- [ ] 把 `项目计划书_仓储环境安全巡检机器人.md` 的内容填进任务书第七节的表格（补上姓名学号），交老师签字
- [ ] 交之前先问 B1-5（评分标准），如果评分细则对选题有限制，抓紧调整

---

## F. 可以提前动手的准备（可选）

吃完饭休息好之后，这几件事做了能明显加快进度：

- [ ] **F1**　读一遍参考工程的说明文档（等我把工程下载下来后给你本地路径）。**特别注意它自己写出的坑**，提前知道能省一周
- [ ] **F2**　看一眼参考项目的开源页面，对主板的实物形态有个印象
- [ ] **F3**　准备**演示气源**——演示时要用酒精棉球模拟泄漏（安全、易得、响应明显），提前想清楚安全措施与操作流程
- [ ] **F4**　把任务书再读一遍，特别是**第五节资料提交规范**（文件夹命名、每人的提交物），这些是硬性格式要求，漏了要返工

---

## 附：完成进度自检

| 阶段 | 完成情况 |
|---|---|
| **A. 软件安装** | ☐ A1 CubeMX　☐ A2 Qt SerialPort　☐ A3 立创EDA专业版　☐ A4 Fusion360　☐ A5 切片软件　☐ A6 VOFA+ |
| **B. 询问老师** | ☐ B1 交付与工具（5 问）　☐ B2 实验室条件（6 问） |
| **C. 实验室核对** | ☐ C1 主控　☐ C2 传感器外设　☐ C3 电源　☐ C4 机械　☐ C5 拍照 |
| **D. 模块申请** | ☐ D1 核心 7 类已提交　☐ D4 自费件已采购 |
| **E. 组内推进** | ☐ E1 配置 git　☐ E2 角色分工　☐ E3 协议冻结会　☐ E4 计划书审批 |
| **F. 提前准备** | ☐ F1 读参考工程　☐ F2 看实物图　☐ F3 演示气源　☐ F4 复读任务书 |

> **做完 A 和 D，就可以告诉我了**——我拿到 CubeMX 路径和实验室核对结果后，就开始建工程骨架、写协议文档、搭上位机框架。

---

> **项目归属**：中国石油大学（华东） 专业生产实习课程项目<br>
> **范围说明**：本项目不涉及 MiniBalance 控制板（STM32F405RGT6 版本）的硬件设计与改版；控制板直接沿用，A1 仅重做主底板。<br>
> **许可**：原创代码与文档采用 MIT License；第三方组件遵循各自原始许可证。
