pierrotto12138-code/balance-car-inspection-robot/hardware/bom/采购记录_立创商城_SO26101014446.md

# 元件采购记录（立创商城 `SO26101014446`）—— 角色 A1

> **用途**：把"实际买了什么"与 [`BOM表.md`](../../docs/design_hardware/BOM表.md)（设计要什么）对齐 ——
> 交付材料里"焊接/测试"的证据链需要这一环（计划书 A1 成果：*BOM 表、焊接完成的实物板、测试记录*）。
> **原始订单文件**（`.xls`，**含收货人姓名/手机/地址**）**不入公开仓库**，保存在
> `…\260921Task_私有资料\作业补充\A1\立创商城订单详情-SO26101014446.xls`；
> 本文件只摘录**物料与金额**，不含任何个人信息。

---

## 一、订单信息

| 项 | 值 |
|---|---|
| 下单平台 | 立创商城（WWW.SZLCSC.COM） |
| **订单编号** | **`SO26101014446`**（客户编号 `8942344A`，与 PCB 打样订单号同源） |
| 下单日期 | **2026-10-10 11:26** |
| 商品总额 / 运费 / 订单总额 | **¥71.07 / ¥17.00 / ¥72.55** |
| 发票 | 开取 |
| 商品条目 | **17 项**（明细见 §二） |
| 关联的 PCB 打样单 | 嘉立创 **`8942344A_Y2`**（2026-10-08 下单，¥53，工艺参数见 [`../../hardware/gerber/README.md`](../../hardware/gerber/README.md)）|

---

## 二、明细（17 项，按订单顺序）

| # | 立创料号 | 品牌 | 型号 | 封装 | 订购/发货 | 单价 | 金额 | 对应 BOM 位号 |
|---|---|---|---|---|---|---|---|---|
| 1 | `C319012` | XKB Connection | SS-12D10L5 | 插件,13×6.8 mm | 5 / 5 | ¥1.9703 | ¥9.85 | `SW2` |
| 2 | `C20617242` | XY(振华新云) | CA45A-B-25V-10uF-M | CASE-B-3528-19 | 5 / 5 | ¥1.5762 | ¥7.88 | `C6` `C10` |
| 3 | `C5137467` | FOJAN(富捷) | FCC0805B104K500DT | 0805 | 50 / 50 | ¥0.0426 | ¥2.13 | `C3` `C4` `C5` `C7` `C8` `C9` `C11` `C12` |
| 4 | `C126469` | TORCH(火炬) | CT41G-0805-2X1-50V-0.1uF-K(N) | 0805 | 50 / 50 | ¥0.0722 | ¥3.61 | `C14`~`C17` |
| 5 | `C698724` | YANGJIE(扬杰) | **ES2D** | SMB(DO-214AA) | 10 / 10 | ¥0.2452 | ¥2.45 | `D1` ⚠ 与 BOM 料号不同（见 §三）|
| 6 | `C51933307` | Guiguang light(桂光光电) | GL0805UR01 | 0805 | 100 / 100 | ¥0.0284 | ¥2.84 | `D2` `D3` `D4` |
| 7 | `C46550402` | JIERR(捷而瑞) | JVJ25V100M6x5 | SMD,D6.3×L5.4 | 10 / 10 | ¥0.2447 | ¥2.45 | `C18` `C19` ⚠ 与 BOM 料号不同（见 §三）|
| 8 | `C269746` | Tyohm(幸亚电阻) | RMC08054.7K1%N | 0805 | 100 / 100 | ¥0.0471 | ¥4.71 | `R14` |
| 9 | `C110774` | YAGEO(国巨) | RT0805BRD071KL | 0805 | 20 / 20 | ¥0.2631 | ¥5.26 | `R2` |
| 10 | `C4310` | UNI-ROYAL(厚声) | 0805W8F1501T5E | 0805 | 100 / 100 | ¥0.0212 | ¥2.12 | `R1` |
| 11 | `C27834` | UNI-ROYAL(厚声) | 0805W8F5101T5E | 0805 | 100 / 100 | ¥0.0339 | ¥3.39 | `R4` `R5` |
| 12 | `C110775` | YAGEO(国巨) | RT0805BRD0710KL | 0805 | 20 / 20 | ¥0.2429 | ¥4.86 | `R3` |
| 13 | `C2836441` | KNSCHA(科尼盛) | RVT220UF35V67RV0024 | SMD,D8×L10.2 | 5 / 5 | ¥0.4569 | ¥2.28 | `C1` `C2` |
| 14 | `C161788` | PANASONIC(松下) | ERJPB6B1002V（10 kΩ ±0.1% 250 mW）| 0805 | 10 / 10 | ¥0.4608 | ¥4.61 | `R10` `R12` ⚠ 与 BOM 料号不同 |
| 15 | `C2891839` | YONGYUTAI(永裕泰) | AMS1117-3.3 | SOT-223-3 | 10 / 10 | ¥0.3664 | ¥3.66 | `U3` |
| 16 | `C49332886` | Econd(米朗电子) | 220uF35V6.3x14GF | 插件,D6.3×L14 | 20 / 20 | ¥0.2066 | ¥4.13 | `C13` |
| 17 | `C5578723` | VISHAY(威世) | CRCW080515K0FKEAHP（15 kΩ ±1% 500 mW）| 0805 | 10 / 10 | ¥0.4840 | ¥4.84 | `R11` `R13` ⚠ 与 BOM 料号不同 |

> 位号列是本文件**按参数+封装**与 BOM 对应的结果（订单本身不带位号），可按参数复核。

---

## 三、与 BOM 的差异（**下单与设计不一致的 4 处，已逐项核对为"等价件"**）

| BOM 里写的 | 实际下单的 | 判断 |
|---|---|---|
| `D1` = `C212758`（DIOTEC 德欧泰克 ES2D，DO-214AA/SMB）| `C698724`（YANGJIE 扬杰 **ES2D**，SMB）| ✅ **型号与封装一致**，仅厂商/料号不同（应是缺货/起订量所致）|
| `C18` `C19` = 名为"100uF25v电解电容"的自建器件，料号 `C9900004126`（BOM §三 已标⚠️存疑）| `C46550402`（JIERR 100 µF ±20% 25 V，SMD D6.3×5.4）| ✅ **闭合了 BOM 里那条存疑项**：实测买的就是 `C46550402`，封装 `D6.3` 与 BOM 的 `CAP-SMD_BD6.3` 相符 |
| `R10` `R12` = `C6752026`（YAGEO RC0805BR-0710KL，10 kΩ ±0.1%）| `C161788`（PANASONIC ERJPB6B1002V，10 kΩ ±0.1% 250 mW）| ✅ **阻值与精度一致**（松下功率更大），仅料号不同 |
| `R11` `R13` = `C3929039`（TE CRG0805F15K，15 kΩ ±1%）| `C5578723`（VISHAY CRCW080515K0FKEAHP，15 kΩ ±1% 500 mW）| ✅ **阻值与精度一致**，仅料号不同 |

> **没在这张单里的位号**：`U1`(TB6612FNG `C141517`)、`U2`(LM2596S-5.0 `C2980820`)、`L1`(`STWRH105R-330MT`)、
> `CN1`/`CN2`、`J1`/`J2`、`J5`/`J7`/`J9`/`J10`/`J11`/`J13`/`J14`/`J15`/`J17`/`J18` ——
> 本单未包含，来源需 A1 补充说明（实验室库存 / 其他渠道 / 另一张订单）。

---

## 四、取材与溯源

| 项目 | 位置 |
|---|---|
| 原始订单详情（**含个人信息，仓库外**） | `…\260921Task_私有资料\作业补充\A1\立创商城订单详情-SO26101014446.xls` |
| 本文件的读取方式（可复跑） | `.xls` 用 LibreOffice 转 `.xlsx` 后按 sheet 读；订单号/日期/金额取自表头，明细取自"商品明细列表" |
| 设计 BOM | [`../../docs/design_hardware/BOM表.md`](../../docs/design_hardware/BOM表.md)、[`BOM_主底板.csv`](BOM_主底板.csv) |
| PCB 打样与工艺参数 | [`../gerber/README.md`](../gerber/README.md) |
| 焊接与上板测试 | [`../../docs/design_hardware/上板测试记录.md`](../../docs/design_hardware/上板测试记录.md) |

## 五、变更记录

| 日期 | 内容 |
|---|---|
| 2026-10-16 | 初版：从原始订单 `.xls` 摘录 17 项物料与金额，并与 BOM 逐项对齐（4 处料号差异判定为等价件；闭合 `C18`/`C19` 存疑项）|

---

> **项目归属**：中国石油大学（华东） 专业生产实习课程项目<br>
> **范围说明**：本项目不涉及 MiniBalance 控制板（STM32F405RGT6 版本）的硬件设计与改版；控制板直接沿用，A1 仅重做主底板。<br>
> **许可**：原创代码与文档采用 MIT License；第三方组件遵循各自原始许可证。
