pierrotto12138-code/balance-car-inspection-robot/hardware/mechanical/A2-10_整车装配_20261017/00_A2_交付物清单（对照任务书）.md

# A2（结构）交付物清单 —— 对照任务书

> **角色**：A2（结构）　｜　**更新**：2026-10-17 晚
> **任务书要求**（`docs/任务书_提取全文.md`）：结构设计图纸、装配图、人机界面设计说明、外观效果图、3D 打印件。
> **图例**：✅ 已有　🔶 部分　❌ 缺失　— 不适用（仅理论设计）
> **前置说明**：旧 OCC 程序壳（`_A2审阅\外壳起点件\` 及备份）已于 2026-10-17 删除（72 个文件 / 约 617 MiB，清单见 `_已删除_旧壳清单_20261017.md`）。当前唯一有效模型是本目录的 SolidWorks 整车装配。

---

## 1. 已归档的模型（不用再给）

| 文件 | 说明 |
|---|---|
| `A2-10_整车装配_A2_v1.0_20261017.SLDASM` | 原生装配（14 部件 / 20 条装配关系）|
| `A2-10_整车装配_零件版_A2_v1.0_20261017.SLDPRT` | 装配体另存为的零件（多实体）|
| `A2-10_整车装配_A2_v1.0_20261017.step` | STEP AP214，自包含（15 PRODUCT / 247 实体）|
| 16 个零件 SLDPRT | 装配引用件，文件名不可改 |

### 1.1 已有渲染（2026-10-17，我出）

| 文件 | 内容 |
|---|---|
| `渲染\A2-08_效果图_等轴测_A2_v1.0_20261017.png` | 电子/传感器面等轴测，带地面软阴影（1800×1350）|
| `渲染\A2-08_效果图_等轴测背面_A2_v1.0_20261017.png` | 车轮面等轴测 |
| `渲染\A2-10_整车_四视图_渲染初稿_20261017.png` | 俯视 / 端视（+X）/ 侧视（+Y）/ 等轴测 + 包围盒 |
| `渲染\A2-08_效果图_等轴测_透明底_20261017.png` | 透明底，供 PPT/文档排版 |

> 来源：STEP → OpenCASCADE 细分（253 实体 / 185,785 面）→ PyVista 离屏渲染；**几何着色**，未做外观/配色设计。
> 包围盒 **181.0 × 134.5 × 90.5 mm**。四视图是**渲染初稿**，不是带图框/公差/孔表的正式工程图。

### 1.2 已有导出与文档（2026-10-17 晚，我出）

| 文件 | 内容 |
|---|---|
| `导出\A2-10_整车_装配_A2_v1.0_20261017.stl` | 整机单网格 STL（8.86 MB / 185,785 面），**不是可分别打印的零件** |
| `导出\A2_实体索引_253.csv` | 253 实体序号 / 包围盒 / 体积 / 面数，供指认上下壳 |
| `导出\候选分件\` | 9 个候选件 STL（151=MiniBalance R1 通用车架 / 252=箱体候选 / 149·150 轮 / 183 电池包络 / 145 主控板 / 246·194·188 模块），**8/9 水密**；按包围盒命名 |
| `检查\A2_间隙干涉检查_20261017.md/.csv` | **11 对关键间隙/干涉**：轮↔架 4.00 mm；PCB↔箱体 0 mm / 712.94 mm³（共面）；模块 246↔箱体 0.69 mm；**无穿透** |
| `渲染\A2-10_整车_爆炸示意图_20261017.png` | **箱体分离示意**（仅箱体 +Z 220 mm；完整爆炸需件名/拆卸方向）|
| `A2_明细栏_整车_草表_20261017.csv` | 14 个 STEP 件 + 2 个备用件；数量 1 套、材料待定 |
| `…\docs\design_mechanical\A2_结构设计说明_初稿.md` | 结构设计说明初稿（私人提交同名 `A2-11_结构设计说明_A2_v1.0_20261017.md`）|
| `渲染\A2-10_整车_六视图_原色_20261017.png` | 正面/背面/左/右/俯视原色 + 等轴测；含 SW 标注，**已同意进公开仓库**（图内无姓名）|

---

## 2. 对照任务书（现状）

| # | 任务书要求 | 状态 | 现状 |
|---|---|---|---|
| 1 | 结构设计图纸（零件图） | ❌ | **上下壳未建模（A2 确认缺失）**；不要求 `.SLDDRW` |
| 2 | 装配图 | 🔶 | 已有六视图/四视图渲染 + **装配图 PDF 初稿**（`图纸\`）+ **箱体分离示意**；无尺寸标注 |
| 3 | 人机界面设计说明 | 🔶 | 已定：**按"在对应位置开框"**，不逐项测量、不出坐标表 |
| 4 | 外观效果图 | 🔶 | 已有 4 张几何渲染 + **原色六视图**；外观造型/配色未设计 |
| 5 | 3D 打印件 | 🔶 | **仅理论设计**；整机 STL + 9 个候选分件（151=MiniBalance R1 通用车架、252=箱体候选）；上下壳缺失 |
| 6 | 结构设计说明文档 | 🔶 | 已有**初稿**（`docs/design_mechanical/A2_结构设计说明_初稿.md`，私人提交 `A2-11…md`）|
| 7 | 明细栏 / BOM（整车） | 🔶 | 已有 **16 行草表**；材料、`m3_*` 实际颗数待核 |
| 8 | 干涉检查记录 | ✅ | 已做 **11 对关键几何检查**（`检查\`）：无穿透；PCB↔箱体 0 mm/712.94 mm³ 共面、模块 246↔箱体 0.69 mm 偏紧 |
| 9 | 装配与试装记录 | — | **不要求实物**（仅理论设计）|
| 10 | 交付清单 | ✅ | 本文件 |
| 11 | 人机开孔坐标表 | — | 不单独出；统一按"在对应位置开框" |

---

## 3. 已确认事项与剩余工作（2026-10-17）

| # | 事项 | 决定 |
|---|---|---|
| 1 | 上下壳 | **缺失**，不补；当前只有 **MiniBalance R1 通用车架** + 电控 + 轮组 |
| 2 | 人机开孔 | **不逐项测量**，统一按"在对应位置开框"；不出坐标表 |
| 3 | 车架 | **MiniBalance R1 通用车架** |
| 4 | 实物 / 打印 | **仅理论设计**，不要求打印、试装、实物照片 |
| 5 | SW 工程图 | **不要求** `.SLDDRW`；用渲染六视图 + 装配图 PDF 初稿替代 |

> **原"你出文件"清单作废。** 我这边继续做：
> 1. ✅ 装配图 PDF 初稿（`图纸\A2-10_整车_装配图_理论设计_20261017.pdf`）
> 2. ✅ 候选分件 STL 正名（151 = MiniBalance R1 通用车架；252 = 箱体候选）
> 3. ✅ 干涉 / 间隙检查（11 对，见 `检查\`）
> 4. ✅ 爆炸示意（仅箱体上移；完整分层需件名/拆卸方向）

---
## 4. SolidWorks 导出速查

| 要出的东西 | 操作 |
|---|---|
| 零件图 / 总装图 | 零件或装配 → **文件 → 从零件/装配体制作工程图** → 放三视图/剖视 → 标注 → **另存为 PDF**（同时保留 `.SLDDRW`）|
| 爆炸图 | 装配 → **爆炸视图** → 拉出各件 → 工程图里插入爆炸视图 + 明细表 → PDF |
| 明细栏 | 工程图 → **插入 → 表格 → 明细表** → 选模板 → 导出 xlsx/PDF |
| STL | 零件 → **另存为 → STL** → 选项里单位选 **mm**、不要勾"自定义"缩放 |
| 干涉检查 | 装配 → **评估 → 干涉检查** → 勾选"视重合为干涉" → 计算 → 截图/导出 |
| 效果图 | **PhotoView 360** 或 RealView 截图，分辨率 ≥1600 px |
| 质量属性 | **评估 → 质量属性** → 选项里单位设 mm/g → 截图或抄数 |

---

## 5. 已有可复用输入

- `A2_接口坐标表_20261016.csv`（52 器件 + 板框/孔位，原点 = 板左下角）
- `A2_空间确认_三项.md`（向上 35 / 铜柱 25 / 超声波 20×15 / OLED 预留区）
- `A2_底盘接口对照图_20261016.pdf`（3 孔 vs 厂商原板 4 孔）
- A1 实测板框：**100.00 × 65.00 mm、R5.0、3 × ⌀3.2，跨距 88.00 × 52.81**
- 本目录 `渲染\`：4 张 STEP 自动渲染（等轴测 / 背面 / 四视图 / 透明底）
- 本目录 `README.md`：结构核实、SHA-256、打开须知

---

## 6. 判据（评阅口径）

| 项 | 合格线 |
|---|---|
| 零件图 | 有图框/标题栏；关键尺寸与公差齐；基准明确；能照图复现 |
| 装配图 | 件号与明细栏齐全；爆炸图能看出装配关系；标注紧固件规格 |
| 效果图 | ≥2 张，能看出外观与人机界面，且与图纸不矛盾 |
| 人机界面说明 | §7 十二项全部填实，且与上壳图尺寸一致 |
| 打印件 | 装板成功（3 孔对位、无干涉）；按键三种手势稳定；视窗不挡角；MQ 进气通畅 |

---

> **项目归属**：中国石油大学（华东） 专业生产实习课程项目<br>
> **范围说明**：本项目不涉及 MiniBalance 控制板（STM32F405RGT6 版本）的硬件设计与改版；控制板直接沿用，A1 仅重做主底板。<br>
> **许可**：原创代码与文档采用 MIT License；第三方组件遵循各自原始许可证。
