pierrotto12138-code/balance-car-inspection-robot/hardware/bom/BOM_主底板.csv

序号 | 数量 | 位号 | 器件名 | 型号(厂商料号) | 封装 | 立创料号 | 厂商 | 描述
1 | 2 | C1 C2 | RVT220UF35V67RV0024 | RVT220UF35V67RV0024 | SMD,D8xL10.2mm | C2836441 | KNSCHA(科尼盛) | 220uF ±20% 35V
2 | 8 | C3 C4 C5 C7 C8 C9 C11 C12 | FCC0805B104K500DT | FCC0805B104K500DT | 0805 | C5137467 | FOJAN(富捷) | 100nF ±10% 50V
3 | 2 | C6 C10 | CA45A-B-25V-10uF-M | CA45A-B-25V-10uF-M | CASE-B-3528-19(mm) | C20617242 | XY(振华新云) | 10uF ±20% 25V
4 | 1 | C13 | 220uF35V6.3x14GF | 220uF35V6.3x14GF | 插件,D6.3xL14mm | C49332886 | Econd(米朗电子) | 220uF ±20% 35V
5 | 4 | C14 C15 C16 C17 | CT41G-0805-2X1-50V-0.1uF-K(N) | CT41G-0805-2X1-50V-0.1uF-K(N) | 0805 | C126469 | TORCH(火炬) | 100nF ±10% 50V
6 | 2 | C18 C19 | 100uF25v电解电容 | 100uF25v电解电容 | CAP-SMD_BD6.3 | C9900004126 |  | 100uF25v电解电容
7 | 2 | CN1 CN2 | LAIL-PHC2.54-6P-01-XH-L | LAIL-PHC2.54-6P-01-XH-L | 插件,P=2.5mm | C54905977 | LAILAN(莱联) | 1x6P 间距:2.54mm 直插 系列:XH
8 | 1 | D1 | ES2D_C212758 | ES2D | DO-214AA(SMB) | C212758 | DIOTEC(德欧泰克) | ES2D
9 | 3 | D2 D3 D4 | GL0805UR01 | GL0805UR01 | 0805 | C51933307 | Guiguang light(桂光光电) | 0805 红灯 高亮
10 | 2 | J1 J2 | HC-PM254-8.5H-2x15PZ | HC-PM254-8.5H-2x15PZ | 插件,P=2.54mm | C22373920 | HC(虹成电子) | 间距2.54mm 2x15Pin 直插 PC3.0 H8.5
11 | 3 | J5 J10 J13 | LAIL-PM2.54-4P-L | LAIL-PM2.54-4P-L | 插件,P=2.54mm | C54973823 | LAILAN(莱联) | 1x4P 间距:2.54mm 直插
12 | 1 | J7 | X6511FRS-06-C85D30 | X6511FRS-06-C85D30 | SMD,P=2.54mm,卧贴 | C5142239 | XKB Connection(中国星坤) | 1x6P 间距:2.54mm 卧贴
13 | 4 | J9 J11 J14 J18 | LAIL-PM2.54-3P-L | LAIL-PM2.54-3P-L | 插件,P=2.54mm | C54973828 | LAILAN(莱联) | 1x3P 间距:2.54mm 直插
14 | 1 | J15 | DS1023-2*6SF11 | DS1023-2*6SF11 | 插件,P=2.54mm | C92269 | CONNFLY | 黑色 2x6P 间距:2.54mm 直插
15 | 1 | J17 | AM-1015B-M | AM-1015B-M | - | C90631 | AMASS(艾迈斯) | AMASS(艾迈斯)电源连接器公头AM-1015B-M
16 | 1 | L1 | STWRH105R-330MT | STWRH105R-330MT | 33UHSMD-1010 | C9900014639 |  | STWRH105R-330MT
17 | 1 | R1 | 0805W8F1501T5E | 0805W8F1501T5E | 0805 | C4310 | UNI-ROYAL(厚声) | 厚膜电阻 1.5kΩ ±1%
18 | 1 | R2 | RT0805BRD071KL | RT0805BRD071KL | 0805 | C110774 | YAGEO(国巨) | 薄膜电阻 1kΩ ±0.1% 125mW
19 | 1 | R3 | RT0805BRD0710KL | RT0805BRD0710KL | 0805 | C110775 | YAGEO(国巨) | 薄膜电阻 10kΩ ±0.1% 125mW
20 | 2 | R4 R5 | 0805W8F5101T5E | 0805W8F5101T5E | 0805 | C27834 | UNI-ROYAL(厚声) | 厚膜电阻 5.1kΩ ±1%
21 | 2 | R10 R12 | RC0805BR-0710KL | RC0805BR-0710KL | 0805 | C6752026 | YAGEO(国巨) | 厚膜电阻 10kΩ ±0.1%
22 | 2 | R11 R13 | CRG0805F15K | CRG0805F15K | 0805 | C3929039 | TE Connectivity(泰科电子) | 厚膜电阻 15kΩ ±1% 125mW
23 | 1 | R14 | RMC08054.7K1%N | RMC08054.7K1%N | 0805 | C269746 | Tyohm(幸亚电阻) | 厚膜电阻 4.7kΩ ±1% 125mW
24 | 1 | SW2 | SS-12D10L5 | SS-12D10L5 | 插件,13x6.8mm | C319012 | XKB Connection(中国星坤) | 柄长5mm 直插双档 滑动开关
25 | 1 | U1 | TB6612FNG(O,C,8,EL_C141517 | TB6612FNG(O,C,8,EL | SSOP-24 | C141517 | TOSHIBA(东芝) | 1A 有刷直流电机驱动芯片 5.5V
26 | 1 | U2 | LM2596S-5.0 | LM2596S-5.0 | TO-263-5 | C2980820 | Slkor(萨科微) | 降压型 3A 5V~30V
27 | 1 | U3 | AMS1117-3.3 | AMS1117-3.3 | SOT-223-3 | C2891839 | YONGYUTAI(永裕泰) | 3.3V 1A 18V
