pierrotto12138-code/balance-car-inspection-robot/hardware/mechanical/A2-10_整车装配_20261017/A2_明细栏_整车_草表_20261017.csv

序号 | 件号 | 名称 | 数量 | 材料 / 规格 | 备注
1 | Bottom | 车架底板 | 1 | PLA/PETG（待定） | STEP 产品树
2 | Top | 车架顶板 | 1 | PLA/PETG（待定） | STEP 产品树
3 | Core | 车架中框 / 核心件 | 1 | PLA/PETG（待定） | STEP 产品树
4 | PCB_Pierrot | 主控板 | 1 | FR-4 1.6 mm | A1 改板
5 | 1900mah | 电池组 | 1 | 18650 1900 mAh | 待实测
6 | Oled | OLED 显示模块 | 1 | 0.96" I2C | 成品模块
7 | OledConnect | OLED 转接件 | 1 | 3D 打印（待定） | STEP 产品树
8 | DHT11 | 温湿度模块 | 1 | DHT11 | 成品模块
9 | HCSR04 | 超声波模块 | 1 | HC-SR04 | 成品模块
10 | MQall2WithPins | 气体传感器（带针） | 1 | MQ-2 / MQ-135 | 成品模块
11 | MQallWithoutPins | 气体传感器（无针） | 1 | MQ 系列 | 成品/备用
12 | Bluetooth | 蓝牙模块 | 1 | HC-05/06（待定） | 成品模块
13 | m3_24 | M3 螺钉/柱 24 mm | 1 | M3 不锈钢 | 实际颗数待核
14 | m3_60 | M3 螺钉/柱 60 mm | 1 | M3 不锈钢 | 实际颗数待核
15 | m3_1125 | M3 螺钉 11.25 mm | 1 | M3 不锈钢 | 未在 STEP 树，备用
16 | Bottom2 | 车架底板备用件 | 1 | PLA/PETG（待定） | 未在 STEP 树，备用
