pierrotto12138-code/balance-car-inspection-robot/hardware/mechanical/A2-10_整车装配_20261017/PCB_Pierrot.SLDPRT

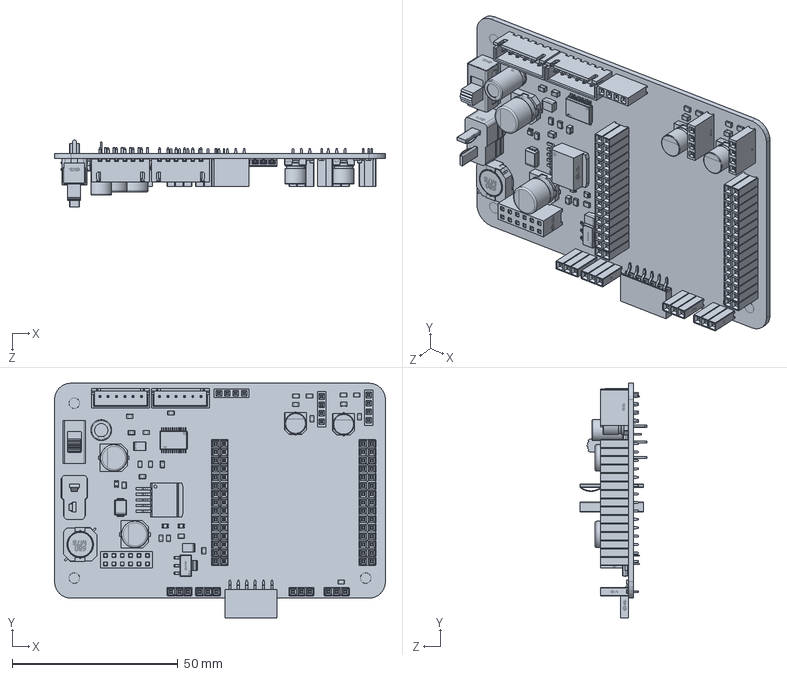
[picture p39: CAD file, 2026-10-17]
hardware/mechanical/A2-10_整车装配_20261017/PCB_Pierrot.SLDPRT
100.0 x 70.9 x 20.2 mm
