pierrotto12138-code/balance-car-inspection-robot/hardware/mechanical/A2-10_整车装配_20261017/导出/A2-10_整车_装配_A2_v1.0_20261017.stl

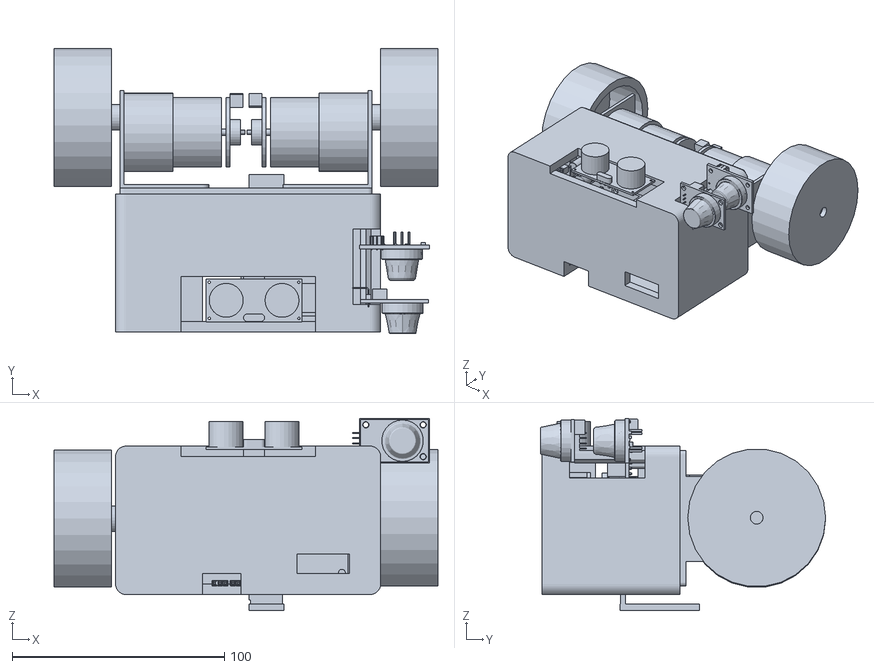
[picture p40: CAD file, 2026-10-17]
hardware/mechanical/A2-10_整车装配_20261017/导出/A2-10_整车_装配_A2_v1.0_20261017.stl
181.0 x 134.5 x 90.5
