pierrotto12138-code/balance-car-inspection-robot/hardware/mechanical/A2-10_整车装配_20261017/导出/候选分件/实体151_MiniBalanceR1通用车架.stl

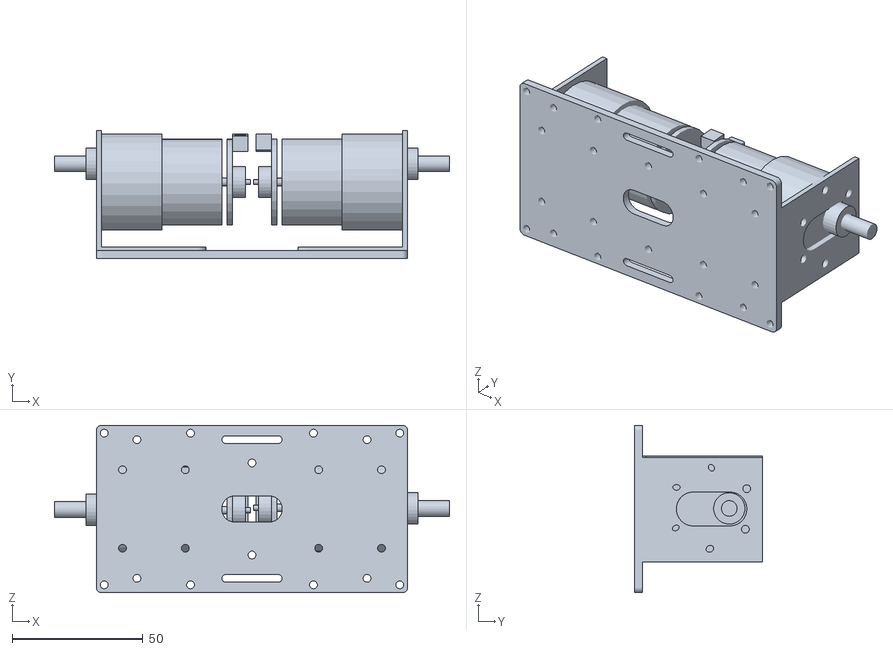
[picture p41: CAD file, 2026-10-17]
hardware/mechanical/A2-10_整车装配_20261017/导出/候选分件/实体151_MiniBalanceR1通用车架.stl
151.0 x 49.0 x 64.0
