pierrotto12138-code/balance-car-inspection-robot/hardware/mechanical/A2-10_整车装配_20261017/1900mah.SLDPRT

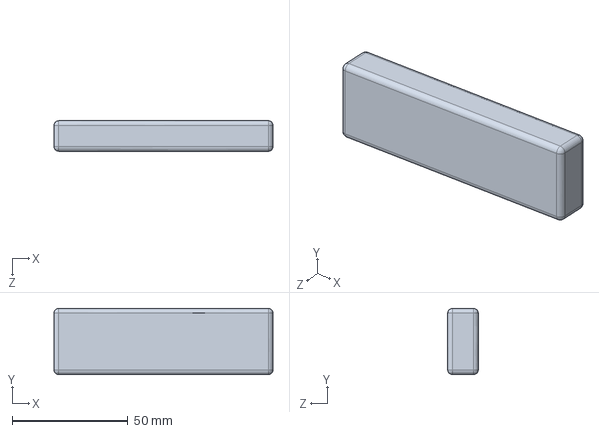
[picture p42: CAD file, 2026-10-17]
hardware/mechanical/A2-10_整车装配_20261017/1900mah.SLDPRT
94.5 x 28.5 x 13.2 mm
