pierrotto12138-code/balance-car-inspection-robot/hardware/mechanical/A2-10_整车装配_20261017/导出/候选分件/实体145_主控板.stl

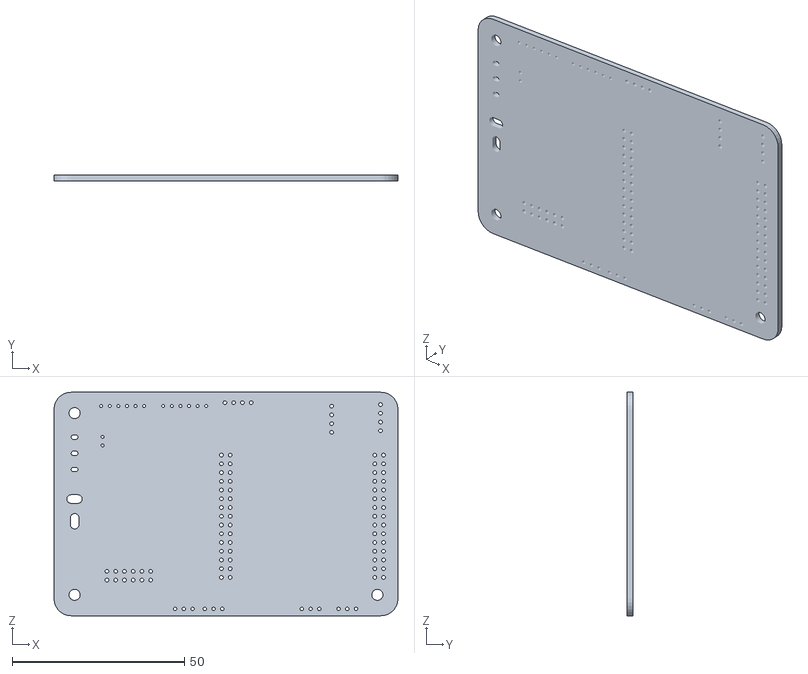
[picture p43: CAD file, 2026-10-17]
hardware/mechanical/A2-10_整车装配_20261017/导出/候选分件/实体145_主控板.stl
100.0 x 1.60 x 65.0
