pierrotto12138-code/balance-car-inspection-robot/hardware/mechanical/A2-10_整车装配_20261017/Oled.SLDPRT

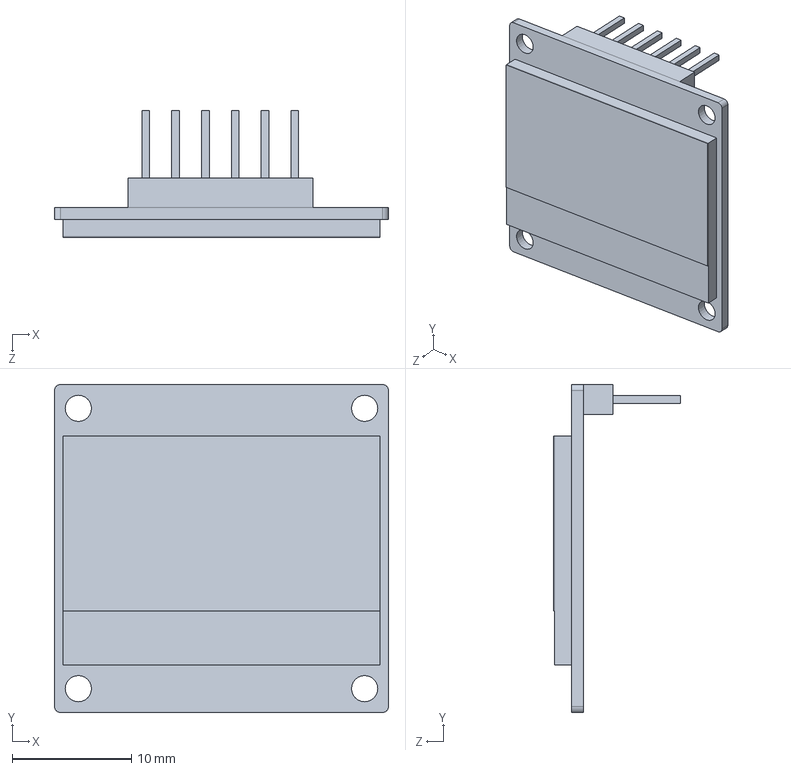
[picture p44: CAD file, 2026-10-17]
hardware/mechanical/A2-10_整车装配_20261017/Oled.SLDPRT
28.0 x 27.5 x 10.7 mm
