pierrotto12138-code/balance-car-inspection-robot/hardware/mechanical/A2-10_整车装配_20261017/导出/候选分件/实体183_电池包络.stl

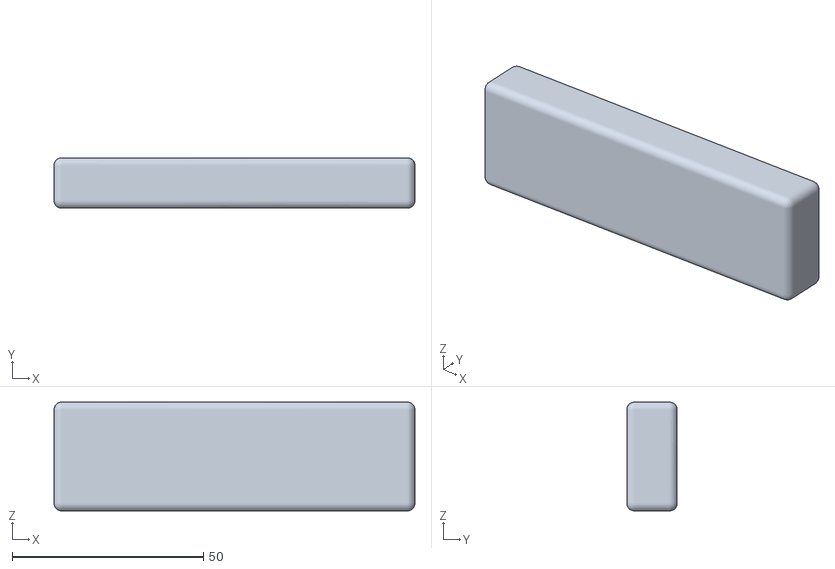
[picture p45: CAD file, 2026-10-17]
hardware/mechanical/A2-10_整车装配_20261017/导出/候选分件/实体183_电池包络.stl
94.5 x 13.2 x 28.5
