pierrotto12138-code/balance-car-inspection-robot/hardware/mechanical/A2-10_整车装配_20261017/Core.SLDPRT

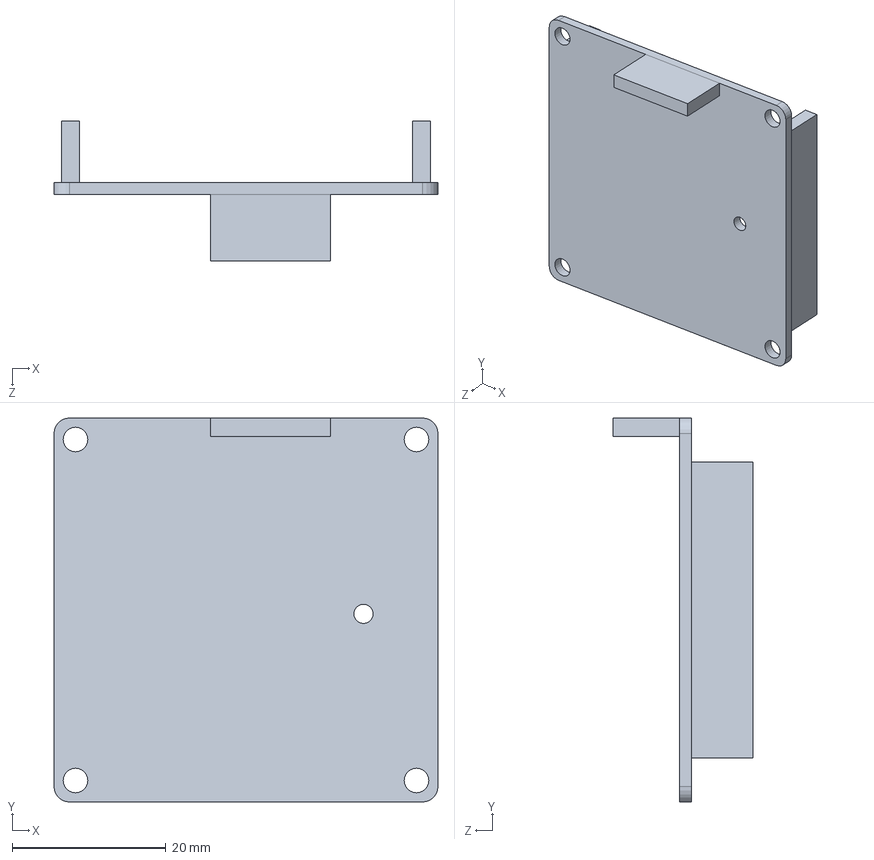
[picture p46: CAD file, 2026-10-17]
hardware/mechanical/A2-10_整车装配_20261017/Core.SLDPRT
50.0 x 50.0 x 18.2 mm
