pierrotto12138-code/balance-car-inspection-robot/hardware/mechanical/A2-10_整车装配_20261017/导出/候选分件/实体150_右轮候选.stl

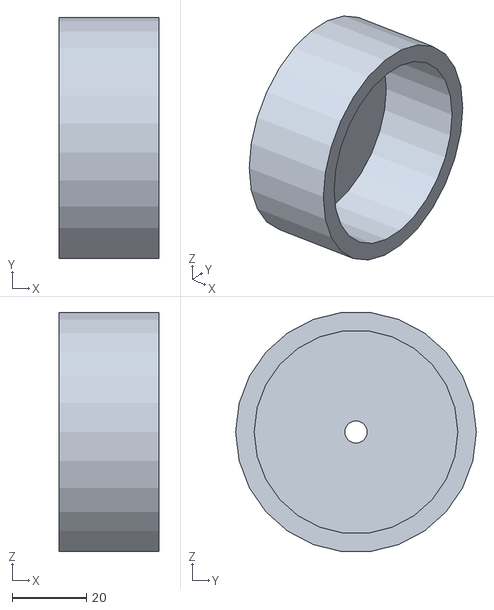
[picture p47: CAD file, 2026-10-17]
hardware/mechanical/A2-10_整车装配_20261017/导出/候选分件/实体150_右轮候选.stl
27.0 x 65.0 x 64.5
