pierrotto12138-code/balance-car-inspection-robot/hardware/mechanical/A2-10_整车装配_20261017/导出/候选分件/实体252_空腔体候选.stl

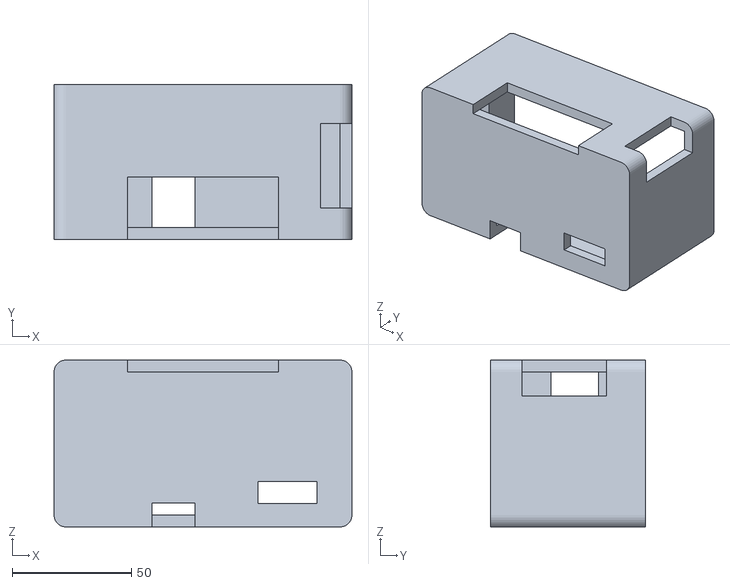
[picture p48: CAD file, 2026-10-17]
hardware/mechanical/A2-10_整车装配_20261017/导出/候选分件/实体252_空腔体候选.stl
125.0 x 65.0 x 70.0
