pierrotto12138-code/balance-car-inspection-robot/hardware/mechanical/A2-10_整车装配_20261017/MQall2WithPins.SLDPRT

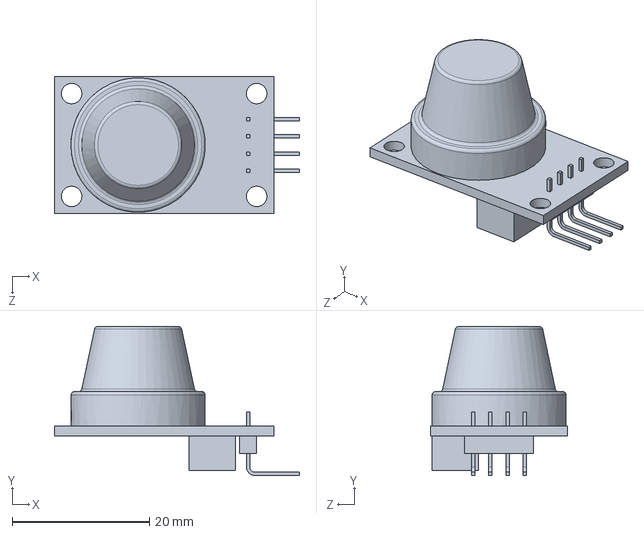
[picture p50: CAD file, 2026-10-17]
hardware/mechanical/A2-10_整车装配_20261017/MQall2WithPins.SLDPRT
35.8 x 21.8 x 20.0 mm
