pierrotto12138-code/balance-car-inspection-robot/hardware/mechanical/A2-10_整车装配_20261017/Bottom2.SLDPRT

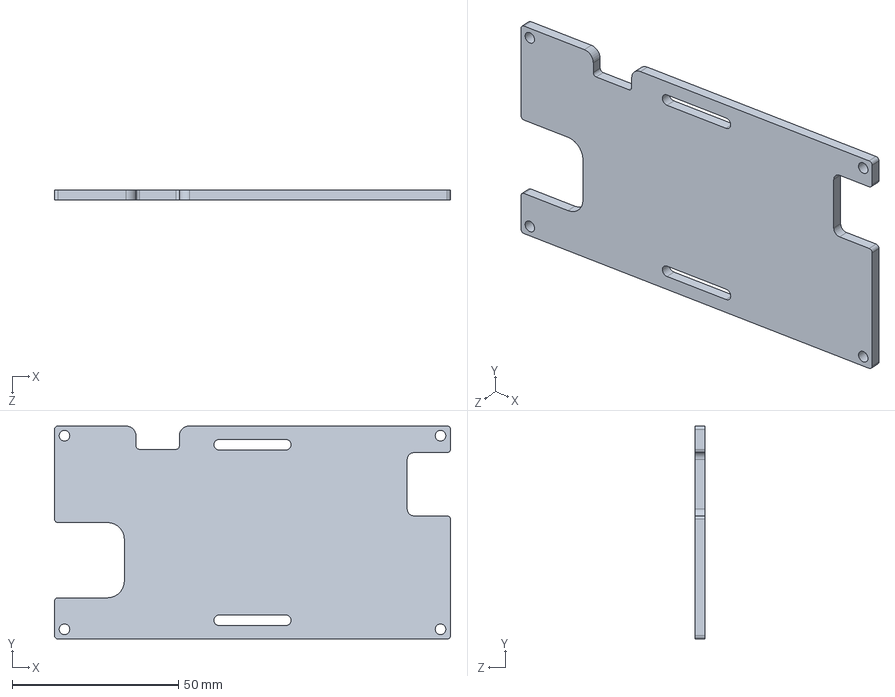
[picture p51: CAD file, 2026-10-17]
hardware/mechanical/A2-10_整车装配_20261017/Bottom2.SLDPRT
119.0 x 64.0 x 3.00 mm
