pierrotto12138-code/balance-car-inspection-robot/hardware/mechanical/A2-10_整车装配_20261017/Bluetooth.SLDPRT

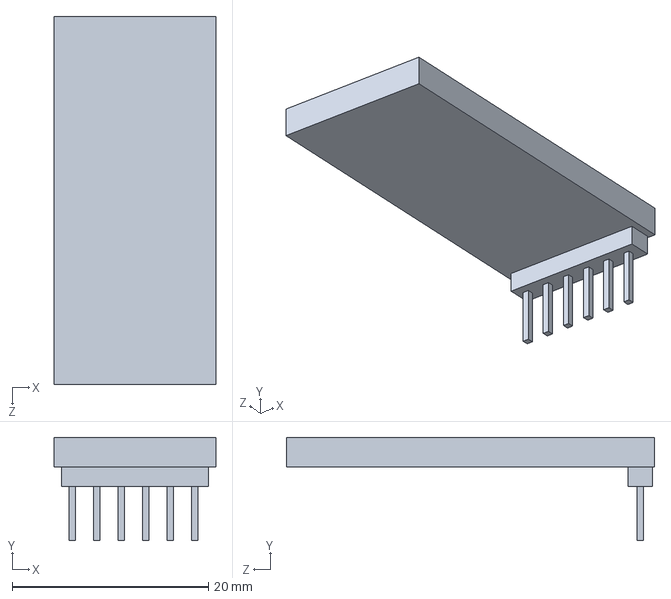
[picture p53: CAD file, 2026-10-17]
hardware/mechanical/A2-10_整车装配_20261017/Bluetooth.SLDPRT
16.5 x 10.5 x 37.5 mm
