pierrotto12138-code/balance-car-inspection-robot/hardware/mechanical/A2-10_整车装配_20261017/Top.SLDPRT

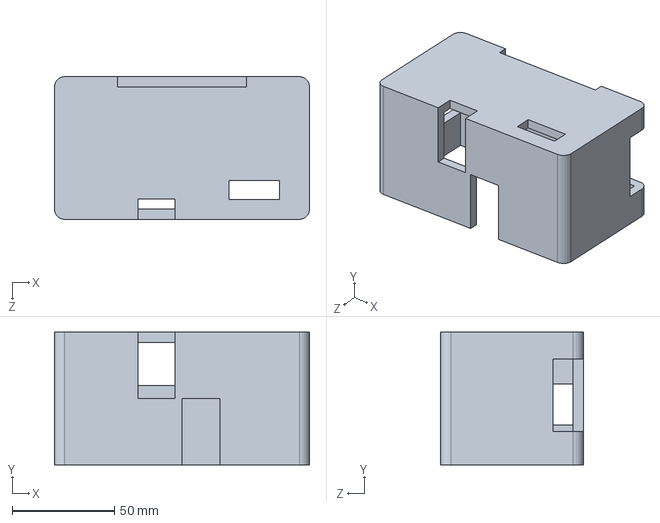
[picture p55: CAD file, 2026-10-17]
hardware/mechanical/A2-10_整车装配_20261017/Top.SLDPRT
125.0 x 65.0 x 70.0 mm
