pierrotto12138-code/balance-car-inspection-robot/hardware/mechanical/A2-10_整车装配_20261017/OledConnect.SLDPRT

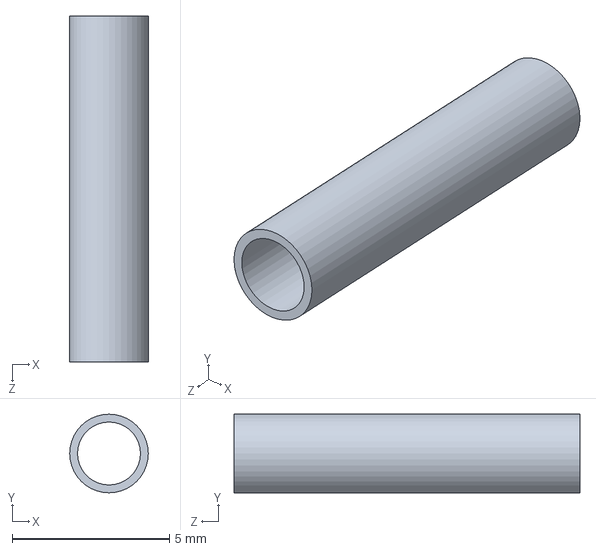
[picture p56: CAD file, 2026-10-17]
hardware/mechanical/A2-10_整车装配_20261017/OledConnect.SLDPRT
2.50 x 2.50 x 11.0 mm
