pierrotto12138-code/balance-car-inspection-robot/hardware/mechanical/A2-10_整车装配_20261017/HCSR04.SLDPRT

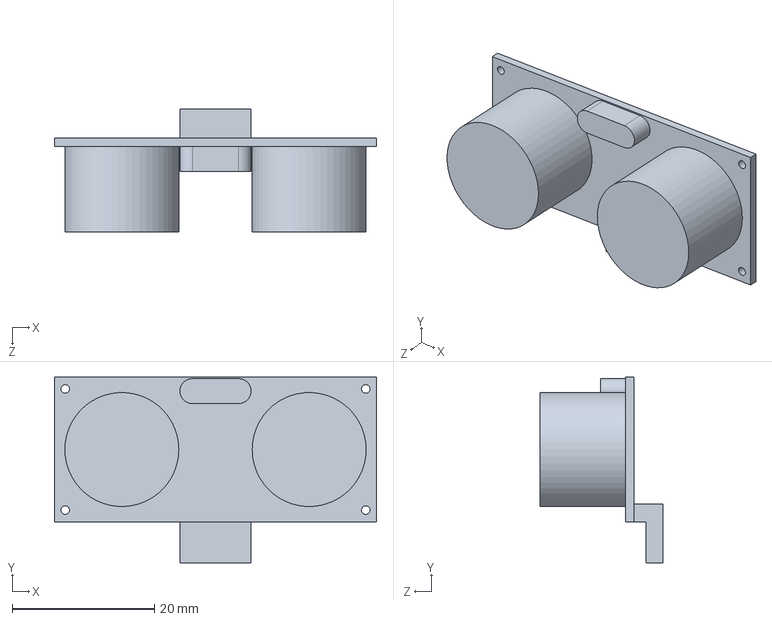
[picture p57: CAD file, 2026-10-17]
hardware/mechanical/A2-10_整车装配_20261017/HCSR04.SLDPRT
45.2 x 26.1 x 17.3 mm
