pierrotto12138-code/balance-car-inspection-robot/hardware/mechanical/A2-10_整车装配_20261017/DHT11.SLDPRT

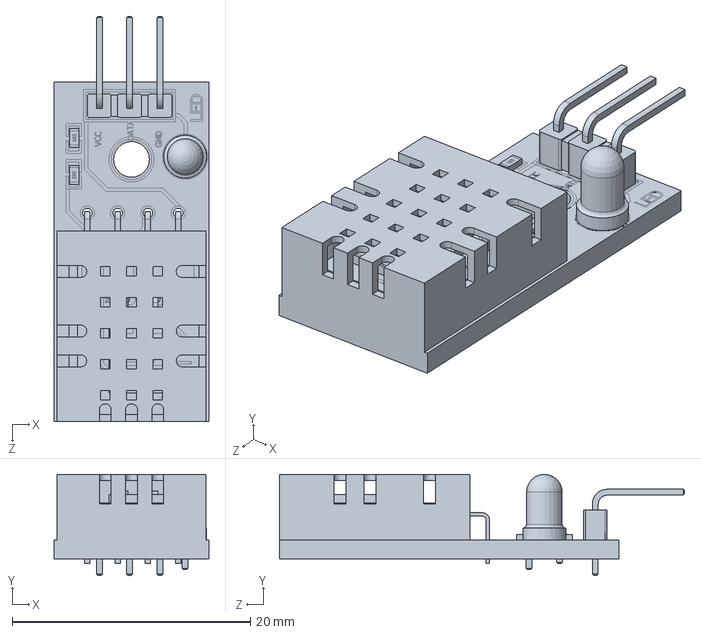
[picture p58: CAD file, 2026-10-17]
hardware/mechanical/A2-10_整车装配_20261017/DHT11.SLDPRT
13.0 x 8.50 x 34.0 mm
