pierrotto12138-code/balance-car-inspection-robot/hardware/mechanical/A2-10_整车装配_20261017/Bottom.SLDPRT

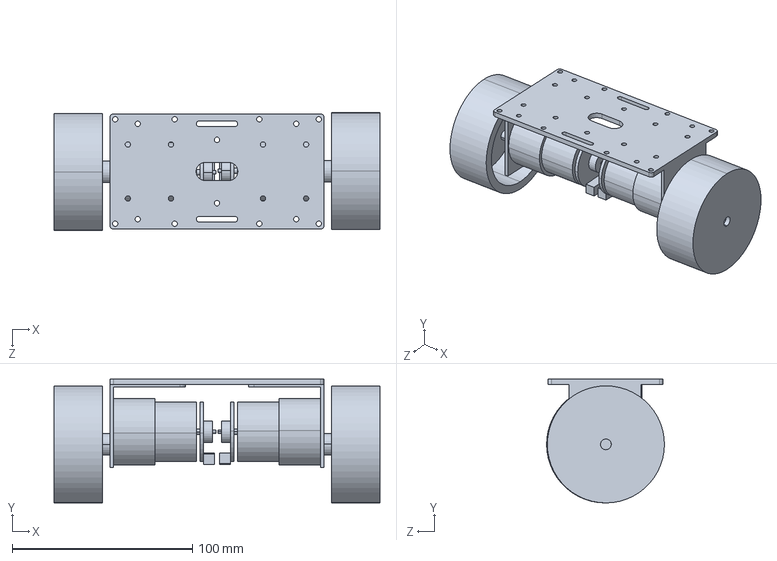
[picture p60: CAD file, 2026-10-17]
hardware/mechanical/A2-10_整车装配_20261017/Bottom.SLDPRT
181.0 x 68.8 x 65.4 mm
