pierrotto12138-code/balance-car-inspection-robot/hardware/mechanical/A2-10_整车装配_20261017/MQallWithoutPins.SLDPRT

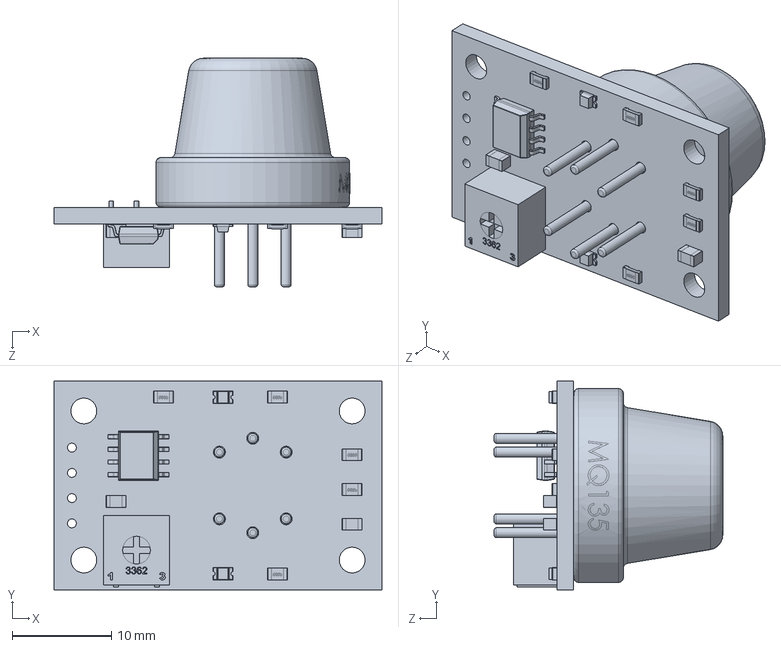
[picture p61: CAD file, 2026-10-17]
hardware/mechanical/A2-10_整车装配_20261017/MQallWithoutPins.SLDPRT
33.0 x 21.0 x 23.0 mm
