pierrotto12138-code/balance-car-inspection-robot/(list of files, cad)

Other CAD files:
hardware/eda_export_20261016/DXF_PCB2_2026-10-16_AutoCAD2007.dxf
hardware/eda_export_20261016/3D_PCB2_2026-10-16.step
hardware/mechanical/A2-10_整车装配_20261017/A2-10_整车装配_A2_v1.0_20261017.step
hardware/mechanical/A2-10_整车装配_20261017/导出/候选分件/实体149_左轮候选.stl
hardware/mechanical/A2-10_整车装配_20261017/A2-10_整车装配_A2_v1.0_20261017.SLDASM
hardware/mechanical/A2-10_整车装配_20261017/m3_1125.SLDPRT
hardware/mechanical/A2-10_整车装配_20261017/m3_24.SLDPRT
hardware/mechanical/A2-10_整车装配_20261017/m3_60.SLDPRT
