pierrotto12138-code/balance-car-inspection-robot/hardware/mechanical/A2-10_整车装配_20261017/README.md

# A2-10 整车装配（SolidWorks 原生）· 2026-10-17

> **角色**：A2（结构）　｜　**来源**：`…\260921Task_私有资料\作业补充\A2\test1\`（2026-10-17 18:45 保存）
> **性质**：一份**可直接打开的原生装配** —— 三件套 + 16 个零件必须**同目录**保存。
> **同步副本**：`…\260921Task_私有资料\正式作业提交\…\A2_结构\01_三维模型\`（与本目录逐字节一致）。

> **★ 2026-10-26 补充（先读）**：**仅作为作业提交的要求完成，未实际验证，大概率不支持落地**（即作者在这里有点糊弄，**你直接打印这个建模肯定不行**）。
>
> 展开说清楚：
> - 整机 STL 是**一整块单网格**，不是可分别打印的零件；要打印得先按实体拆分。
> - **上下壳没有建模**，模型里只有 MiniBalance R1 通用车架 + 电控 + 轮组。
> - 壁厚、公差、收缩补偿、装配间隙都**没有验证**；没做过试印、装板、强度与散热测试。
> - 渲染是**几何着色**，不是外观设计；装配图 PDF 也不是尺寸驱动的正式工程图。
>
> 所以：这份模型用于课程作业的“三维模型 / 装配关系 / 效果图”展示，**不能当作可制造的设计文件**。

---

## 1. 三件套（交付 / 留档用名）

| 文件 | 原名 | 大小 | 说明 |
|---|---|---|---|
| `A2-10_整车装配_A2_v1.0_20261017.SLDASM` | `装配体2.SLDASM` | 11.4 MiB | **原生装配**（14 个部件、20 条装配关系）|
| `A2-10_整车装配_零件版_A2_v1.0_20261017.SLDPRT` | `1\车.SLDPRT` | 36.7 MiB | **装配体另存为的零件**（多实体，便于单文件流转 / 打印前处理）|
| `A2-10_整车装配_A2_v1.0_20261017.step` | `1\装配体2.STEP` | 90.2 MiB | **STEP AP214 装配**（SolidWorks 2026 导出，自包含）|

命名口径对齐 A1：`NN_名称_角色_v版本_日期.扩展名`；`A2-10` 沿用既有"整车"图号。

## 2. 零件（16 个，文件名保持原样）

`Bottom` · `Bottom2` · `Top` · `Core` · `PCB_Pierrot` · `1900mah` · `DHT11` · `HCSR04` ·
`Bluetooth` · `MQall2WithPins` · `MQallWithoutPins` · `Oled` · `OledConnect` · `m3_1125` · `m3_24` · `m3_60`

> `Bottom2` / `m3_1125` **未被当前装配引用**（STEP 里只有 14 个命名件），作为备用件一并保留。
> **零件文件名不能改** —— SLDASM 按文件名找引用件。

## 3. 结构核实（2026-10-17，直接读 STEP 文本，未依赖 CAD）

| 项 | 值 |
|---|---|
| `PRODUCT` | **15**（根装配 + 14 个命名件）|
| `NEXT_ASSEMBLY_USAGE_OCCURRENCE` | **20**（真装配树，不是"自由件堆叠"）|
| `MANIFOLD_SOLID_BREP` | **247** |
| 14 个命名件 | `PCB_Pierrot` `Core` `DHT11` `Top` `m3_24` `HCSR04` `Bluetooth` `Bottom` `MQall2WithPins` `MQallWithoutPins` `m3_60` `1900mah` `OledConnect` 及根 `装配体2` |
| 包围盒 | **203.31 × 130.76 × 128.33 mm**（整车级，非仅上下壳）|
| STEP 头 | `STEP AP214` / `SolidWorks 2026` / 单位 mm |

## 4. 打开须知

1. **19 个文件放在同一目录**。SLDASM 只按文件名找同目录的 SLDPRT；缺一个就会弹"找不到零件"。
2. `车.SLDPRT` 是"装配体 → 另存为零件"的**衍生件**，不是独立设计零件；它不影响装配关系。
3. `.step` **自包含**，任何 CAD 都能单独打开；`.SLDASM` 必须带零件。
4. 源目录里的 8 个 `~$*.SLDASM/.SLDPRT` 是 SolidWorks 异常退出的**锁文件残留**，未收录。
5. 若打开时提示缺件，把搜索路径指向本目录即可（全部引用件都在这里）。

## 5. 与旧 A2 外壳件的关系（**已清理**）

旧 OCC 程序生成的外壳（`_A2审阅\外壳起点件\` 及 `_备份_外壳起点件_20261017_装配修复前\`，
共 72 个文件 / 约 617 MiB）已于 **2026-10-17 删除**，删除清单见
`…\正式作业提交\_A2审阅\_已删除_旧壳清单_20261017.md`。
它与本次 SolidWorks 原生整车装配**不是同一套几何**，旧零件图/爆炸图本来也不能当本模型图纸使用；
本模型的工程图、总装图、爆炸图、明细栏**尚未出**（见交付清单）。

## 6. 校验

- 源 → 仓库 → 私有提交：**19/19 个文件 SHA-256 全部一致**。
- 三件套 SHA-256 前 16 位：

| 文件 | SHA-256（前 16）|
|---|---|
| `A2-10_整车装配_A2_v1.0_20261017.SLDASM` | `6BC2BCCDD58AEA7B` |
| `A2-10_整车装配_零件版_A2_v1.0_20261017.SLDPRT` | `C0DE16E5BD189F5C` |
| `A2-10_整车装配_A2_v1.0_20261017.step` | `C6E0C7198346BB0B` |

## 7. 渲染（2026-10-17，由 STEP 自动出图）

`渲染\` 下四张图**直接由 STEP 生成**（不依赖 SolidWorks），另加一张 A2 提供的原色六视图：

| 文件 | 说明 |
|---|---|
| [`渲染/A2-08_效果图_等轴测_A2_v1.0_20261017.png`](渲染/A2-08_效果图_等轴测_A2_v1.0_20261017.png) | 电子/传感器面等轴测（带地面软阴影）|
| [`渲染/A2-08_效果图_等轴测背面_A2_v1.0_20261017.png`](渲染/A2-08_效果图_等轴测背面_A2_v1.0_20261017.png) | 车轮面等轴测 |
| [`渲染/A2-10_整车_四视图_渲染初稿_20261017.png`](渲染/A2-10_整车_四视图_渲染初稿_20261017.png) | 俯视 / 端视（+X）/ 侧视（+Y）/ 等轴测 + 包围盒 |
| [`渲染/A2-08_效果图_等轴测_透明底_20261017.png`](渲染/A2-08_效果图_等轴测_透明底_20261017.png) | 透明底，供 PPT / 文档排版 |
| [`渲染/A2-10_整车_六视图_原色_20261017.png`](渲染/A2-10_整车_六视图_原色_20261017.png) | **原色六视图**：A2 的 5 张 SolidWorks 截图（正面/背面/左/右/俯视）+ 等轴测拼版 |
| [`渲染/原色截图/`](渲染/原色截图/) | 5 张原色截图原始 JPG（含 SW 尺寸箭头、校名/组号与注记）|
| [`渲染/A2-10_整车_爆炸示意图_20261017.png`](渲染/A2-10_整车_爆炸示意图_20261017.png) | **箱体分离示意**：仅箱体 +Z 220 mm，其余件保持装配位置；完整爆炸需件名/拆卸方向 |

| 项 | 值 |
|---|---|
| 网格 | **253 个实体 / 185,785 个三角面**（线性偏差 0.6 mm）|
| 包围盒 | **181.0 × 134.5 × 90.5 mm**（X × Y × Z，网格顶点实测）|
| 工具链 | OpenCASCADE（STEP 读取 + BRepMesh）→ PyVista/VTK（离屏渲染）→ Pillow（软阴影与排版）；venv 在仓库外 `…\_tools\venv_render` |
| 性质 | **几何着色**：未做外观造型、材质、配色设计；四视图是**渲染初稿**，不是带图框/公差/孔表的正式工程图 |

## 8. 导出与文档（2026-10-17 晚）

| 文件 | 说明 |
|---|---|
| [`导出/A2-10_整车_装配_A2_v1.0_20261017.stl`](导出/A2-10_整车_装配_A2_v1.0_20261017.stl) | 整机单网格 STL（8.86 MB / 185,785 面）。**整机一件，不是可分别打印的零件**；要打印需先按实体拆分 |
| [`导出/A2_实体索引_253.csv`](导出/A2_实体索引_253.csv) | 253 个实体的序号 / 包围盒 / 中心 / 体积 / 面数，供指认"哪几个是上下壳" |
| [`导出/候选分件/`](导出/候选分件/候选分件_说明.csv) | 9 个候选件 STL：**151 = MiniBalance R1 通用车架** / **252 = 箱体候选** / 149·150 轮 / 183 电池包络 / 145 主控板 / 246·194·188 模块；**8/9 水密**（183 电池包络不水密，是包络不是实物）|
| [`A2_明细栏_整车_草表_20261017.csv`](A2_明细栏_整车_草表_20261017.csv) | 14 个 STEP 件 + 2 个备用件；数量按 1 套、材料待定，`m3_*` 实际颗数待核 |
| [`docs/design_mechanical/A2_结构设计说明_初稿.md`](../../../docs/design_mechanical/A2_结构设计说明_初稿.md) | 结构设计说明初稿（尺寸/布局/接口/材料/验证/遗留），未实测项标 `[待确认]` |
| [`图纸/A2-10_整车_装配图_理论设计_20261017.pdf`](图纸/A2-10_整车_装配图_理论设计_20261017.pdf) | **A3 装配图初稿**：原色四视图 + 明细栏草表 + 标题栏 + 说明（非尺寸驱动工程图）|
| [`图纸/A2-10_整车_装配图_预览_20261017.png`](图纸/A2-10_整车_装配图_预览_20261017.png) | 装配图 PDF 的 PNG 预览 |
| [`检查/A2_间隙干涉检查_20261017.md`](检查/A2_间隙干涉检查_20261017.md) | **11 对关键间隙/干涉**（B-rep + 网格）：轮↔架 4.00 mm；PCB↔箱体 0 mm / 712.94 mm³（共面）；模块 246↔箱体 0.69 mm；**无穿透** |
| [`检查/A2_间隙干涉检查_20261017.csv`](检查/A2_间隙干涉检查_20261017.csv) | 检查原始数值 |

> **原色六视图**（正面/背面/左/右/俯视 + 等轴测）已按 A2 同意放进公开仓库：
> 五张底图来自 SolidWorks 截图，含尺寸箭头、校名/组号与"此处应有按键"注记；**图中无个人姓名**。

## 9. 还缺什么

见同目录 [`00_A2_交付物清单（对照任务书）.md`](00_A2_交付物清单（对照任务书）.md)：
**装配图 / 新模型零件图 / 爆炸图+明细栏 / 效果图 / 人机界面 §7 十二项 / 打印记录 / 结构设计说明**均未完成。

---

> **项目归属**：中国石油大学（华东） 专业生产实习课程项目<br>
> **范围说明**：本项目不涉及 MiniBalance 控制板（STM32F405RGT6 版本）的硬件设计与改版；控制板直接沿用，A1 仅重做主底板。<br>
> **许可**：原创代码与文档采用 MIT License；第三方组件遵循各自原始许可证。
