pierrotto12138-code/balance-car-inspection-robot/hardware/mechanical/A2-10_整车装配_20261017/检查/A2_间隙干涉检查_20261017.md

# A2 间隙 / 干涉检查记录（几何级）

> **日期**：2026-10-17　｜　**对象**：`A2-10_整车装配_A2_v1.0_20261017.step`（253 实体）
> **方法**：OpenCASCADE `BRepExtrema_DistShapeShape`（最小距离）＋ `BRepAlgoAPI_Common`（公共体积）；
> 少数对用网格顶点 KDTree / manifold 布尔复核。
> **性质**：**几何级**检查，不含公差、装配力、材料变形；**不是** SolidWorks 干涉检查的替代。

---

## 1. 结果

| # | 检查对 | 最小距离 mm | 公共体积 mm³ | 判定 | 说明 |
|---|---|---:|---:|---|---|
| 1 | 左轮 149 ↔ 车架 151 | **4.000** | 0 | ✅ 通过 | 4 mm 间隙 |
| 2 | 右轮 150 ↔ 车架 151 | **4.000** | 0 | ✅ 通过 | 4 mm 间隙 |
| 3 | 电池包络 183 ↔ 车架 151 | **0.000** | — | 🔶 需确认 | 包络体与车架接触；183 是**包络盒**（非水密），不是电池实物 |
| 4 | 主控板 145 ↔ 箱体 252 | **0.000** | **712.94** | 🔶 零间隙/共面 | 板面与箱体底面**共面**，重叠是 1.6 mm 薄的板层（≈板体积 7%），不是穿透；建议留 0.2~0.5 mm 或确认安装面 |
| 5 | 主控板 145 ↔ 电池 183 | **10.800** | — | ✅ 通过 | 10.8 mm |
| 6 | 模块 246 ↔ 箱体 252 | **0.689** | 0 | 🔶 偏紧 | 0.69 mm，装配公差需注意 |
| 7 | 箱体 252 ↔ 车架 151 | **0.000** | — | ✅ 接触（预期）| 箱体坐在车架上 |
| 8 | 模块 194 ↔ 箱体 252 | 7.05（网格）| 0 | ✅ 通过 | 网格顶点级 |
| 9 | 模块 188 ↔ 箱体 252 | 7.59（网格）| 0 | ✅ 通过 | 网格顶点级 |
| 10 | 左轮 149 ↔ 箱体 252 | 13.95（网格）| 0 | ✅ 通过 | 网格顶点级 |
| 11 | 右轮 150 ↔ 箱体 252 | 14.33（网格）| 0 | ✅ 通过 | 网格顶点级 |

> 单位 mm / mm³；公共体积 0 表示布尔交集为空。

## 2. 结论

1. **没有发现穿透式干涉**（公共体积均远小于零件体积；最大 713 mm³ 是共面板层）。
2. **主控板 ↔ 箱体底面零间隙**：若箱体是安装托盘/下壳，板直接坐在底面上；建议在模型里留 **0.2~0.5 mm** 或加安装柱，避免打印公差导致装配应力。
3. **模块 246 ↔ 箱体 0.69 mm**：偏紧但未干涉；打印/装配公差（±0.2~0.5 mm）可能吃掉间隙。
4. **电池包络 ↔ 车架 0 mm**：183 是包络盒不是实物，需按真实电池外形复核。
5. 车轮与车架 **4.00 mm**，间隙充足。

## 3. 限制（别把这张表当"全量无干涉"）

- 只查了 **11 个关键对**，不是 253 个实体两两全查。
- 电池 183 是**包络盒**（非水密），布尔/距离只能近似。
- 未含**公差、螺纹、过盈、装配力、材料变形**；接触/零间隙不等于功能干涉。
- 网格级结果（8~11）误差约一个网格边长（0.6 mm）。
- 若要做**权威结论**，仍需在 SolidWorks 里用「评估 → 干涉检查」复核（本机 SW 目前 `AppHangB1`，暂不可用）。

## 4. 复现

```powershell
# 读取 STEP + 关键对距离/公共体积（OpenCASCADE）
python <本仓库>\tools\...   # 见本次脚本输出；STEP 读入约 55 s
```

> 原始数值：`A2_间隙干涉检查_20261017.csv`。

---

> **项目归属**：中国石油大学（华东） 专业生产实习课程项目<br>
> **范围说明**：本项目不涉及 MiniBalance 控制板（STM32F405RGT6 版本）的硬件设计与改版；控制板直接沿用，A1 仅重做主底板。<br>
> **许可**：原创代码与文档采用 MIT License；第三方组件遵循各自原始许可证。
