pierrotto12138-code/balance-car-inspection-robot/hardware/mechanical/A2-10_整车装配_20261017/图纸/A2-10_整车_装配图_理论设计_20261017.pdf

# A2-10 整车装配图（理论设计）

## MiniBalance R1 通用车架 + 电控 + 轮组｜仅理论设计，未制造/未打印｜单位 mm｜比例 1:2

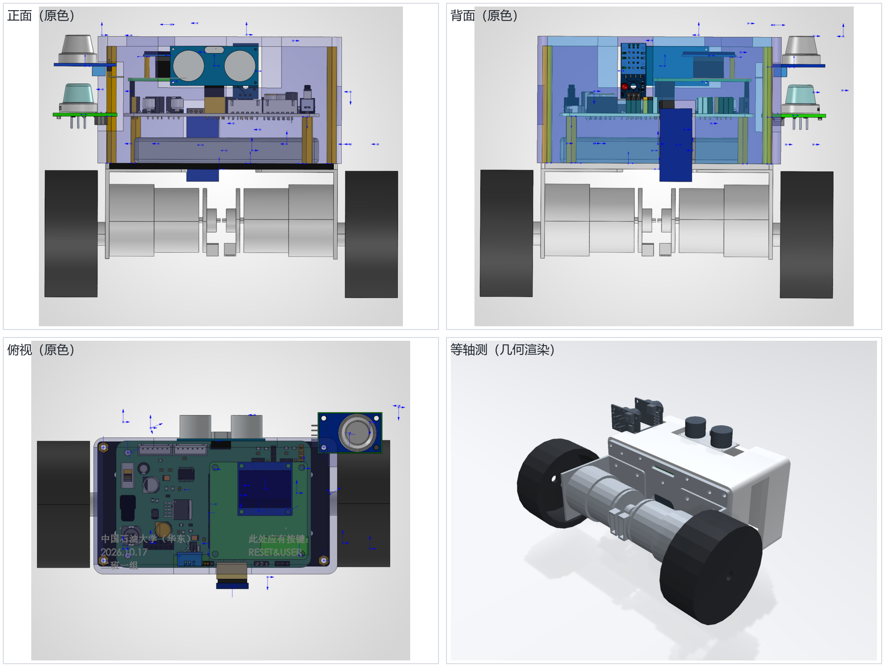
[picture p62: figure]

注：

1. 仅理论设计，未制造、未打印；上下壳（3D 打印外壳）未建模，图中透明外壳为参考件。
2. 人机开孔按“在对应位置开框”处理，不逐件标注尺寸/公差。
3. 总体包围盒 181.0 × 134.5 × 90.5 mm；轮 Φ65 × 27，轮距 154 mm；电池包络 94.5 × 28.5 × 13.2 mm。
4. 主控板 100 × 65 × 1.6 mm，3 × 3.2 安装孔，跨距 88.00 × 52.81（板左下角 + 板面为基准）。
5. 原色视图来自 SolidWorks 截图，含参考尺寸箭头；未注公差按 ±0.5 mm（参考）。
6. 左/右视图见附件《A2-10_整车_六视图_原色_20261017.png》。
序号 | 件号 | 名称 | 数量 | 材料 / 规格
1 | Bottom | 车架底板 | 1 | PLA/PETG（待定）
2 | Top | 车架顶板 | 1 | PLA/PETG（待定）
3 | Core | 车架中框 / 核心件 | 1 | PLA/PETG（待定）
4 | PCB_Pierrot | 主控板 | 1 | FR-4 1.6 mm
5 | 1900mah | 电池组 | 1 | 18650 1900 mAh
6 | Oled | OLED 显示模块 | 1 | 0.96" I2C
7 | OledConnect | OLED 转接件 | 1 | 3D 打印（待定）
8 | DHT11 | 温湿度模块 | 1 | DHT11
9 | HCSR04 | 超声波模块 | 1 | HC-SR04
10 | MQall2WithPins | 气体传感器（带针） | 1 | MQ-2 / MQ-135
11 | MQallWithoutPins | 气体传感器（无针） | 1 | MQ 系列
12 | Bluetooth | 蓝牙模块 | 1 | HC-05/06（待定）
13 | m3_24 | M3 螺钉/柱 24 mm | 1 | M3 不锈钢
14 | m3_60 | M3 螺钉/柱 60 mm | 1 | M3 不锈钢
15 | m3_1125 | M3 螺钉 11.25 mm | 1 | M3 不锈钢
16 | Bottom2 | 车架底板备用件 | 1 | PLA/PETG（待定）

## 明细栏（草表，16 项）

备注：m3_1125 / Bottom2 未在 STEP 树；m3_* 实际颗数待核；材料待定。

图号 | A2-10 | 名称 | 整车装配（理论设计）
材料 | 见明细栏 | 比例 | 1:2
日期 | 2026-10-17 | 设计 | A2
单位 | mm | 投影 | 第一角法
版本 | v1.0 | 审核 | —

A2（结构）· 2026-10-17 · 本图由原色视图 + 明细栏草表排版，非尺寸驱动工程图
