pierrotto12138-code/balance-car-inspection-robot/hardware/mechanical/A2-10_整车装配_20261017/检查/A2_间隙干涉检查_20261017.csv

序号 | 检查对 | 方法 | 最小距离_mm | 公共体积_mm3 | 判定 | 说明
1 | 左轮149 ↔ 车架151 | B-rep | 4.000 | 0 | 通过 | 4 mm 间隙
2 | 右轮150 ↔ 车架151 | B-rep | 4.000 | 0 | 通过 | 4 mm 间隙
3 | 电池包络183 ↔ 车架151 | B-rep | 0.000 | — | 需确认 | 包络体与车架接触；183 非水密，为包络盒
4 | 主控板145 ↔ 箱体252 | B-rep | 0.000 | 712.94 | 零间隙/共面 | 板面与箱体底面共面，1.6 mm 薄层；建议留 0.2~0.5 mm
5 | 主控板145 ↔ 电池183 | B-rep | 10.800 | — | 通过 | 10.8 mm
6 | 模块246 ↔ 箱体252 | B-rep | 0.689 | 0 | 偏紧 | 0.69 mm，装配公差需注意
7 | 箱体252 ↔ 车架151 | B-rep | 0.000 | — | 接触（预期） | 箱体坐在车架上
8 | 模块194 ↔ 箱体252 | 网格 | 7.05 | 0 | 通过 | 顶点级，误差约 0.6 mm
9 | 模块188 ↔ 箱体252 | 网格 | 7.59 | 0 | 通过 | 顶点级
10 | 左轮149 ↔ 箱体252 | 网格 | 13.95 | 0 | 通过 | 顶点级
11 | 右轮150 ↔ 箱体252 | 网格 | 14.33 | 0 | 通过 | 顶点级
