pierrotto12138-code/balance-car-inspection-robot/hardware/mechanical/A2-10_整车装配_20261017/导出/A2_实体索引_253.csv

实体序号 | dx_mm | dy_mm | dz_mm | cx_mm | cy_mm | cz_mm | 体积_mm3 | 三角面数
0 | 2.0 | 0.81 | 1.25 | 27.43 | -2.01 | -37.08 | 1.5 | 1376
1 | 1.25 | 0.81 | 2.0 | 12.7 | -2.01 | -24.38 | 1.5 | 1376
2 | 2.0 | 0.81 | 1.25 | 32.26 | -2.01 | -37.08 | 1.5 | 1376
3 | 15.65 | 11.7 | 5.0 | 15.75 | -4.15 | -47.24 | 617.3 | 2088
4 | 17.5 | 10.37 | 5.91 | 32.02 | -3.49 | 1.53 | 363.5 | 1640
5 | 17.5 | 10.37 | 5.91 | 13.99 | -3.49 | 1.53 | 363.5 | 1640
6 | 1.3 | 0.6 | 2.0 | 28.46 | -1.9 | -40.75 | 1.2 | 108
7 | 1.3 | 0.06 | 1.4 | 28.46 | -2.18 | -40.75 | 0.1 | 20
8 | 1.3 | 0.5 | 1.9 | 28.46 | -1.9 | -40.75 | 1.2 | 884
9 | 1.3 | 0.6 | 2.0 | 19.86 | -1.9 | -18.38 | 1.2 | 108
10 | 1.3 | 0.06 | 1.4 | 19.86 | -2.18 | -18.38 | 0.1 | 20
11 | 1.3 | 0.5 | 1.9 | 19.86 | -1.9 | -18.38 | 1.2 | 884
12 | 1.3 | 0.6 | 2.0 | 15.04 | -1.9 | -24.73 | 1.2 | 108
13 | 1.3 | 0.06 | 1.4 | 15.04 | -2.18 | -24.73 | 0.1 | 20
14 | 1.3 | 0.5 | 1.9 | 15.04 | -1.9 | -24.73 | 1.2 | 884
15 | 2.0 | 0.6 | 1.3 | 85.36 | -1.9 | 2.49 | 1.2 | 108
16 | 1.4 | 0.06 | 1.3 | 85.36 | -2.18 | 2.49 | 0.1 | 20
17 | 1.9 | 0.5 | 1.3 | 85.36 | -1.9 | 2.49 | 1.2 | 884
18 | 2.0 | 0.6 | 1.3 | 71.03 | -1.9 | 2.18 | 1.2 | 108
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
