pierrotto12138-code/balance-car-inspection-robot/hardware/mechanical/A2-10_整车装配_20261017/导出/候选分件/候选分件_说明.csv

实体序号 | 候选名称 | dx_mm | dy_mm | dz_mm | 体积_mm3 | 三角面数 | STL_KB | 水密
252 | 箱体候选 | 125.0 | 65.0 | 70.0 | 127574.5 | 304 | 14.9 | True
151 | MiniBalanceR1通用车架 | 151.0 | 49.0 | 64.0 | 127366.5 | 8408 | 410.6 | True
149 | 左轮候选 | 27.0 | 65.0 | 64.5 | 32606.9 | 312 | 15.3 | True
150 | 右轮候选 | 27.0 | 65.0 | 64.5 | 32606.9 | 312 | 15.3 | True
183 | 电池包络 | 94.5 | 13.2 | 28.5 | 35094.0 | 668 | 32.7 | False
145 | 主控板 | 100.0 | 1.6 | 65.0 | 10120.2 | 12908 | 630.4 | True
246 | 模块候选A | 32.0 | 16.0 | 20.0 | 4021.9 | 1648 | 80.6 | True
194 | 模块候选B | 19.5 | 23.0 | 19.4 | 3093.6 | 5002 | 244.3 | True
188 | 薄板候选 | 33.0 | 1.7 | 21.0 | 1126.1 | 1524 | 74.5 | True
