pierrotto12138-code/balance-car-inspection-robot/docs/setup/实验室可以白嫖的模块.png

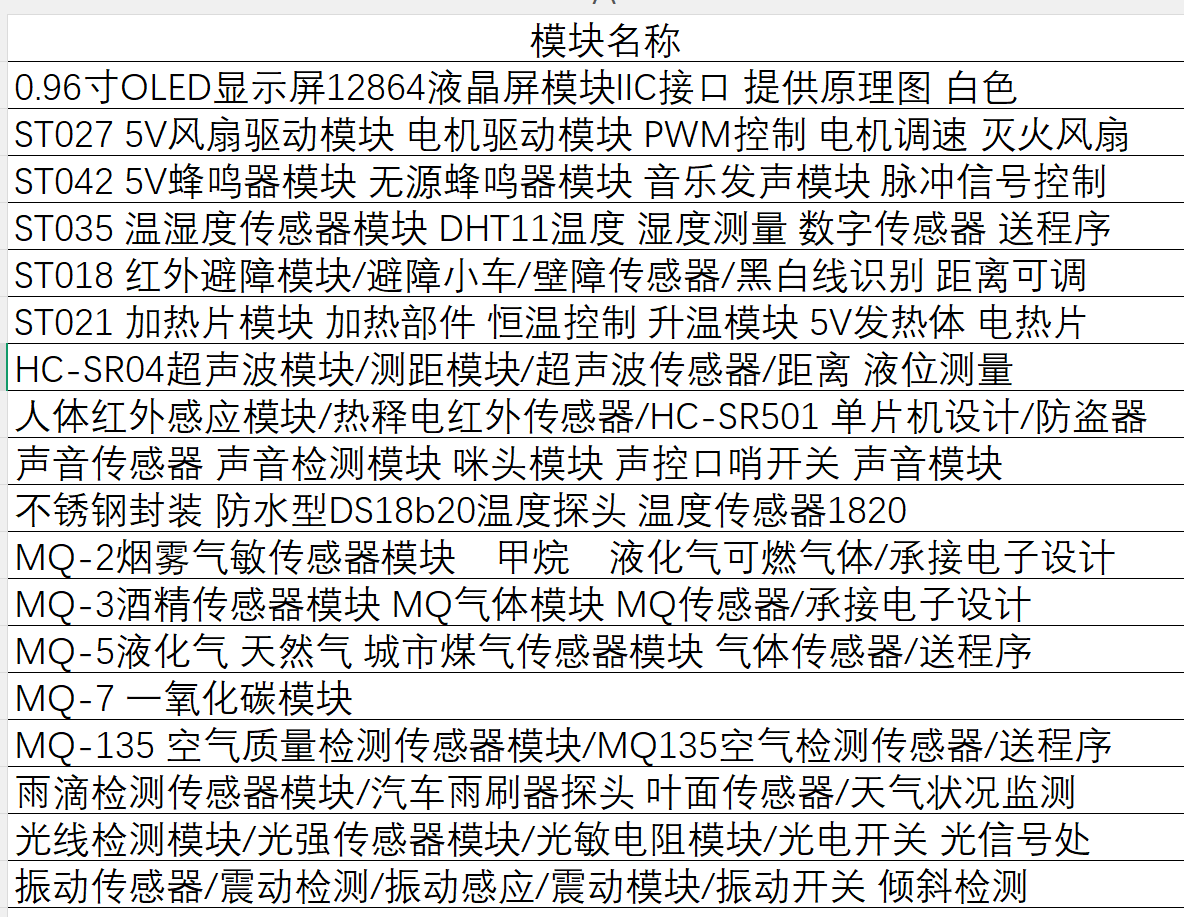
docs/setup/实验室可以白嫖的模块.png
