pierrotto12138-code/balance-car-inspection-robot/hardware/mechanical/A2-10_整车装配_20261017/图纸/A2-10_整车_装配图_预览_20261017.png

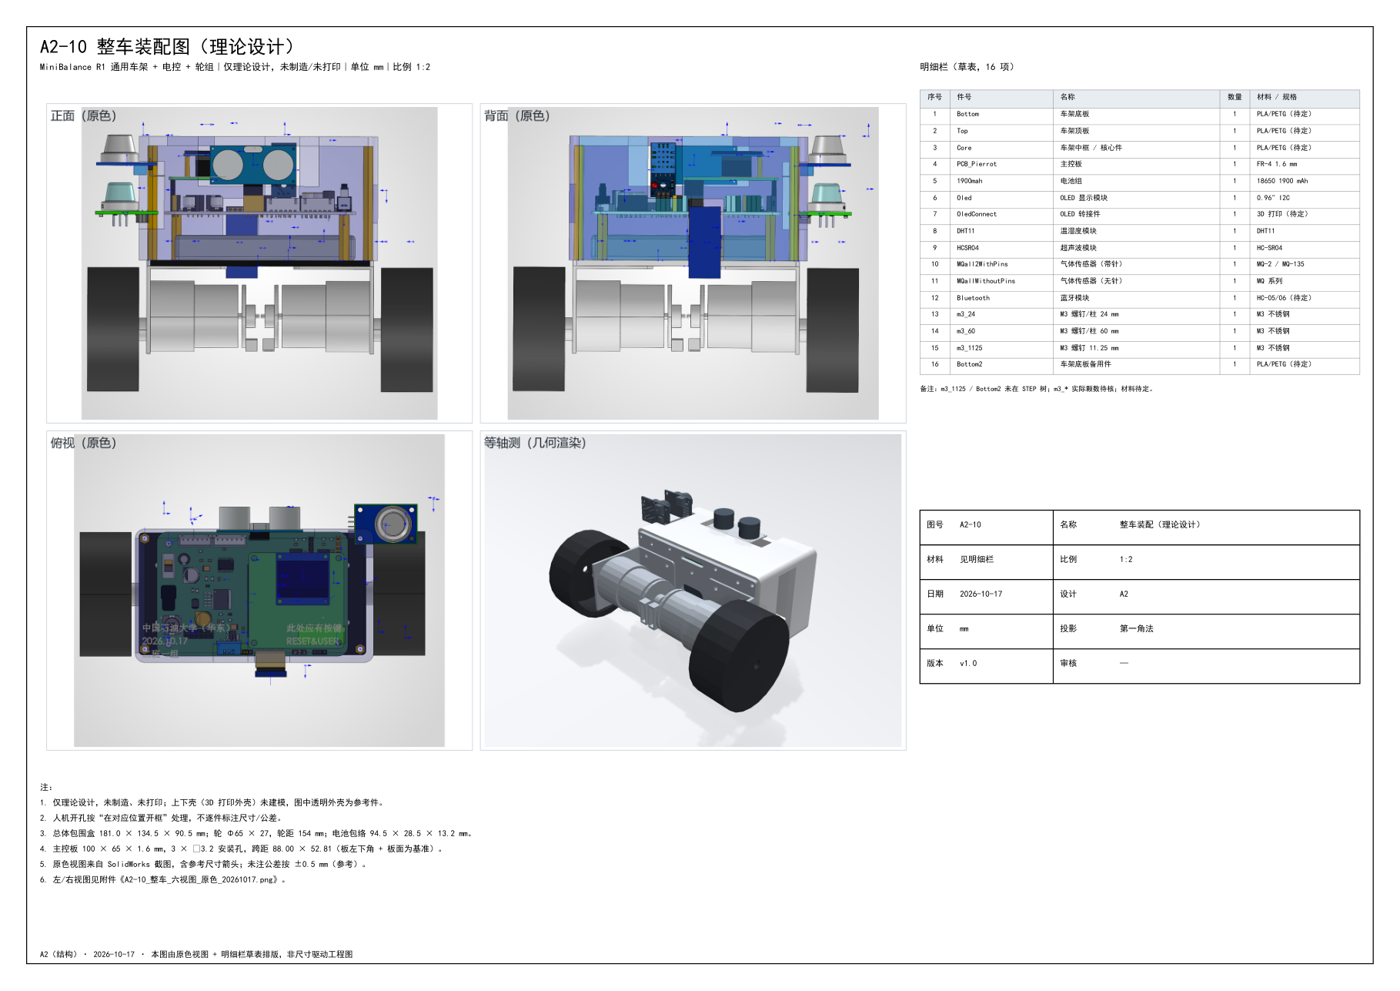
hardware/mechanical/A2-10_整车装配_20261017/图纸/A2-10_整车_装配图_预览_20261017.png
