pierrotto12138-code/balance-car-inspection-robot/hardware/mechanical/A2-10_整车装配_20261017/渲染/A2-08_效果图_等轴测_透明底_20261017.png

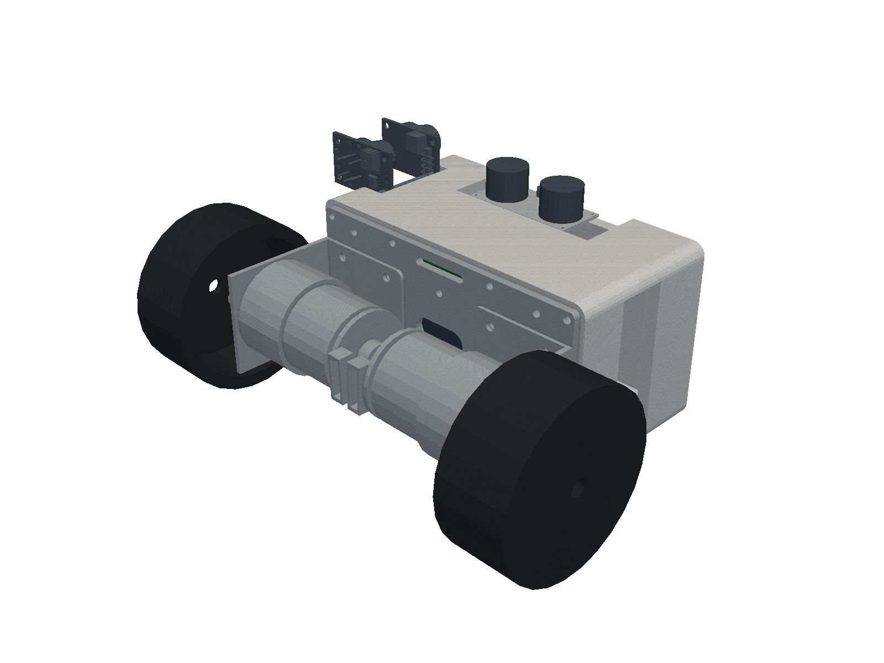
hardware/mechanical/A2-10_整车装配_20261017/渲染/A2-08_效果图_等轴测_透明底_20261017.png
