pierrotto12138-code/balance-car-inspection-robot/hardware/mechanical/A2-10_整车装配_20261017/渲染/A2-08_效果图_等轴测背面_A2_v1.0_20261017.png

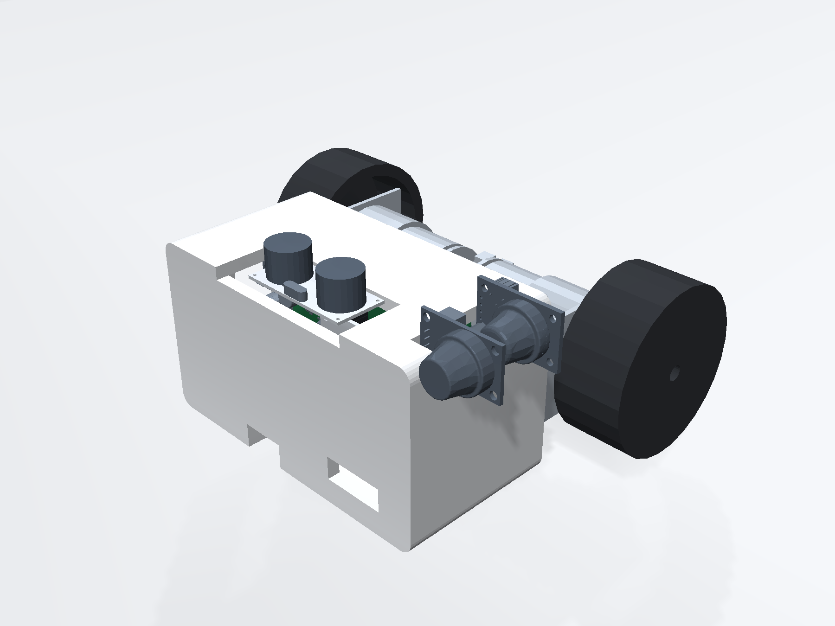
hardware/mechanical/A2-10_整车装配_20261017/渲染/A2-08_效果图_等轴测背面_A2_v1.0_20261017.png
