pierrotto12138-code/balance-car-inspection-robot/hardware/mechanical/A2-10_整车装配_20261017/渲染/A2-10_整车_六视图_原色_精简_20261017.png

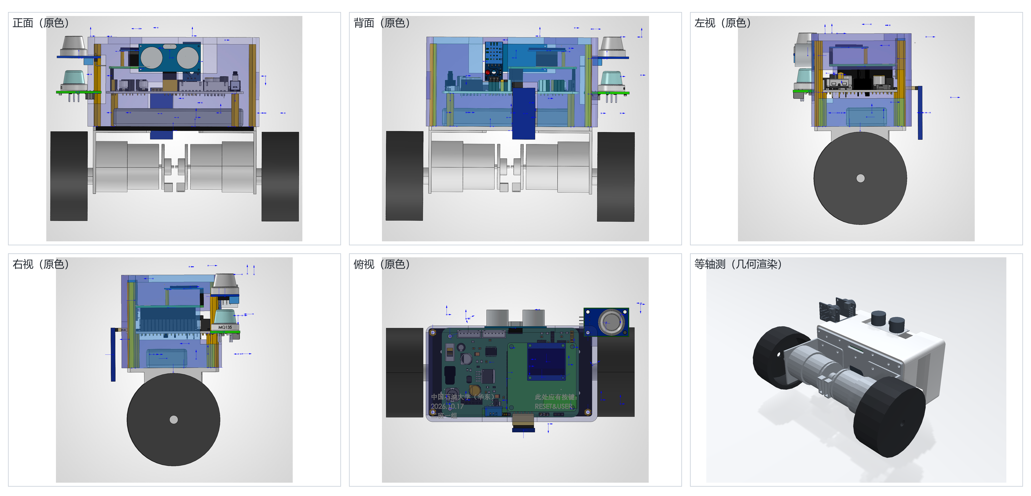
hardware/mechanical/A2-10_整车装配_20261017/渲染/A2-10_整车_六视图_原色_精简_20261017.png
