pierrotto12138-code/balance-car-inspection-robot/hardware/mechanical/A2-10_整车装配_20261017/渲染/原色截图/背面.JPG

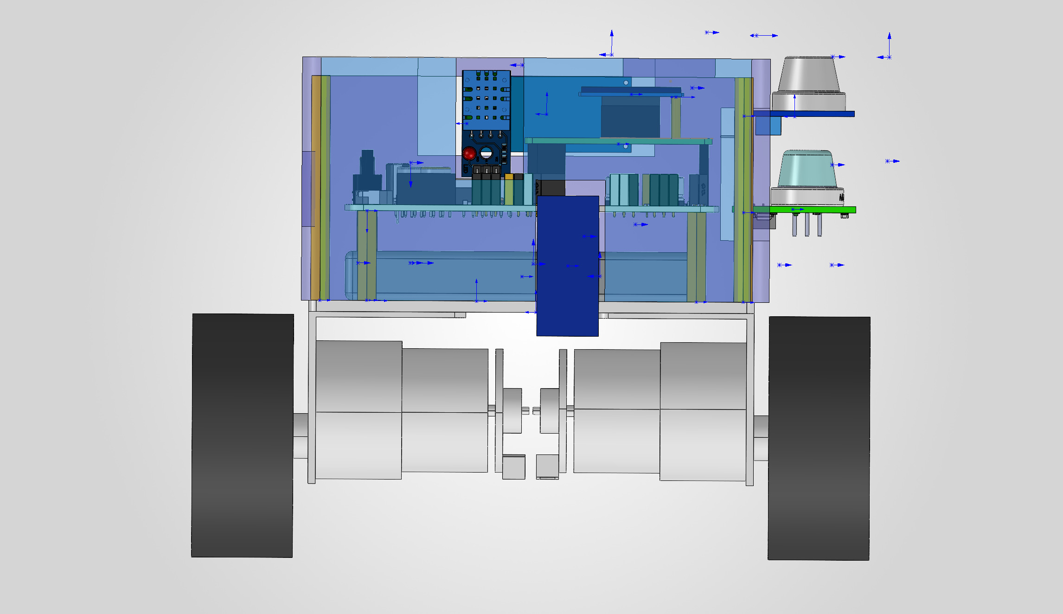
hardware/mechanical/A2-10_整车装配_20261017/渲染/原色截图/背面.JPG
