pierrotto12138-code/balance-car-inspection-robot/hardware/test_records/README.md

# 真机测试原始记录（2026-10-16）—— 角色 A1

> **用途**：A1 交付里"**测试记录**"这一项的可复核原始证据（对应项目计划书 A1 成果的"测试记录"、
> [`上板自检清单.md`](../../docs/design_hardware/上板自检清单.md) §10 的"实测数据 / 观测 CSV"两类）。
> **原则**：本目录只放**机器跑出来的原文**（工具 stdout + CSV），不手工誊抄；结论写在
> [`../../docs/design_hardware/上板测试记录.md`](../../docs/design_hardware/上板测试记录.md) 里并回指到本目录。
> **有效性**：文件名里带 `未加使能` 的那份是**无效数据**（见 §四 的坑 1），**只有 `05`/`07`/`08` 是"车在平衡状态"下的有效观测**。

---

## 一、测试环境

| 项 | 值 |
|---|---|
| 时间 | **2026-10-16 16:49–17:3x**（北京时间）|
| 板子 | 重做的底板（嘉立创 `8942344A_Y2`）+ STM32F405RGT6 控制板 |
| 固件 | 版本字节 **`0xAF` = 10-15**（`0x16` 状态位 bit3 = 1，即"新特性构建"）|
| 链路 | **有线**（板载 CH340G）→ `COM3`，115200 8N1，DTR=高/RTS=低（运行态）|
| 台架 | 只有 MQ-135 模块（插 `J13`，`J10` 空）；DHT11 正常；电池 **11.5 V** |
| 车体 | **两段状态**：① 前半段"车不在平衡位（俯仰 ≈ −79°）且已安全锁存"；② 后半段**车被立起、正常平衡中**（俯仰 ≈ 0°，安全=正常、预热中）|
| 工具 | `host/build-release/host.exe`（Qt 6.11.2）、`tools/fw_prep/tune.py`（系统 Python 3.13 + pyserial 3.5）|

---

## 二、跑了什么（可原地复跑）

```powershell
# ① 参数全量回读（0x24 只读，不写 Flash）
python tools\fw_prep\tune.py -p COM3 --dump

# ② 只读探测 12 s + 0x24 全量回读对照（★ 不发任何运动指令）
host\build-release\host.exe --probe COM3 --probe-seconds 12 --probe-readback -platform offscreen

# ③ 蓝牙 SPP 端口探测（各 8 s，只读）
host\build-release\host.exe --probe COM4 --probe-seconds 8 -platform offscreen
host\build-release\host.exe --probe COM5 --probe-seconds 8 -platform offscreen

# ④ ★ 观测**正在平衡的车**：必须加 --enable（见 §四 坑 1）
python tools\fw_prep\tune.py -p COM3 --observe 20 --enable --csv hardware\test_records\05_observe_balance_20s.csv

# ⑤ 带心跳的只读探测（保活但**不解锁**；用于看已锁存状态）
host\build-release\host.exe --probe COM3 --probe-seconds 10 --probe-readback --probe-heartbeat -platform offscreen
```

> `host.exe` 是动态链接 Qt 的：跑之前把 `D:\0_APP\QT\6.11.2\mingw_64\bin` 加进 `PATH`。

---

## 三、文件清单与"这份数据说明了什么"

| 文件 | 内容 | 有效性 / 关键数 |
|---|---|---|
| [`01_param_dump.txt`](01_param_dump.txt) | `tune.py --dump`：7 个 PID 参数实际生效值 | ✅ **`300 / 1 / +80 / +0.4 / 0.5 / 52 / 0.5`**（与决策 77/78 一致）|
| [`02_observe_20s_未加使能_车被锁存.csv`](02_observe_20s_未加使能_车被锁存.csv) / [`.txt`](02_observe_20s_未加使能_车被锁存.txt) | 第一次观测（**没加 `--enable`**）| ❌ **无效数据**：进观测模式后 500 ms 无下行帧 ⇒ 固件安全锁存 ⇒ **车被"探停"**，之后采到的是"电机已停"的俯仰（std 3.89°、峰峰 17.19° 是车被扶住/晃动，不是平衡质量）。**留着当"坑"的证据**（见 §四 坑 1）|
| [`03_probe_readback.txt`](03_probe_readback.txt) | 只读探测 + 0x24 全量回读 | ✅ 链路：收 9401 B / **解帧 611 · 丢帧 0**；格式错帧 0、协议外命令 0、重复帧 0；上行 `0x10/11/12` ≈ **14.8 Hz**；当时**已安全锁存** |
| [`04_probe_bt_COM4.txt`](04_probe_bt_COM4.txt)、[`04_probe_bt_COM5.txt`](04_probe_bt_COM5.txt) | 两个蓝牙 SPP 端口的只读探测 | ✅ **端口能打开、8 s 收 0 B**（Windows 现在能枚举 SPP 端口，但数据未通）|
| [`05_observe_balance_20s.csv`](05_observe_balance_20s.csv) / [`.txt`](05_observe_balance_20s.txt) | ★ **有效平衡观测**（`--enable`，20 s）| ✅ 1561 帧 / 20.24 s ≈ **77 Hz**；俯仰 均值 **+0.86°**、标准差 **0.79°**、峰峰 **3.70°**；**过均值线 35 次 ≈ 0.86 Hz 摆动**（CSV 8 列）|
| [`06_probe_balance_readback.txt`](06_probe_balance_readback.txt) | 带心跳的只读探测（当时车已锁存）| ✅ 记录锁存态下的 `0x16`：`Bal −2055 / Vel 0 / Turn 0`、**Moto −2055 → CCR 838**（保护态下比例不可用，见 §四 坑 3）|
| [`07_observe_balance_enabled.csv`](07_observe_balance_enabled.csv) / [`.txt`](07_observe_balance_enabled.txt) | ★ **带使能观测 30 s**（每 100 ms 发 `0x20 使能=1`，同时记录 `0x16`）| ✅ **23 个 `0x16` 样点、0 个保护位置位**；**`CCR/\|Moto\|` 中位数 = 1.168**（20 个未保护样点，最小 1.167 / 最大 1.170）⇒ **既有"≈1.17"口径被真机证实** |
| [`08_observe_enabled_10s.csv`](08_observe_enabled_10s.csv) / [`.txt`](08_observe_enabled_10s.txt) | `--enable` 选项的验证跑（10 s）| ✅ 俯仰 均值 +0.14°、标准差 **0.87°**、峰峰 4.27° |

---

## 四、本次踩到/修掉的坑（都直接影响"数据能不能用"）

| # | 现象 | 根因 | 处置 |
|---|---|---|---|
| 1 | **`tune.py --observe` 会把正在平衡的车"探停"**：观测窗口里后半段全是"电机已停"的数据，而工具照常给出统计量 | 固件规定 **500 ms 无下行帧 ⇒ 安全锁存**；`--observe` 只在进/出观测模式时各发一帧，中间 20 s 一声不响 ⇒ 0.5 s 后就被锁存 | ✅ 给 `tune.py` 加 **`--keepalive`**（每 200 ms 发 `0x1F` 心跳，保活**不解锁**）与 **`--enable`**（每 100 ms 发 `0x20 使能=1` 零速度，保活**并解锁**）；不加则打印警告。**观测运行中的车必须加 `--enable`** |
| 2 | **"零穿越"统计永远是 0**（车明显在摆，工具报"0 次 / 0.0 Hz"），没法用它判断振荡 | 用"一阶差分乘积 < 0"数局部极值；而 `0x10` 姿态与 `0x11` 运动都是 20 Hz、相邻两行常取到**同一个** pitch ⇒ 极值点两侧必有一个差分为 0 ⇒ 乘积 = 0 ⇒ 一次都数不到（根子上还有一处 off-by-one 已在修这个统计时一并改掉）| ✅ 换成经典定义：**信号穿过均值线的次数**，摆动频率 ≈ 过线次数 / 2 / 时长（`05` 的 35 次 ⇒ **0.86 Hz**，与观察到的摆动相符）|
| 3 | `host --probe-readback` 的 `0x16` 判读在**保护态**下会给出无意义的比例（`Moto −8200 → CCR 471`，比值 0.057；`Moto −2055 → CCR 838`，比值 0.408），却仍判"✔ 已执行" | 保护中（`Flag_Stop`/锁存）时 `Moto` 是"算出来的"、`CCR` 是"被执行/被截断的"，两者本来就不成 1.17 比例 | ⏳ **待 B 侧确认判据**：建议"保护位置位时不按 1.17 判"。**真机反证**：带使能观测（`07`）里 20 个未保护样点的比例稳定在 **1.167–1.170** ⇒ "1.17"本身是对的，只是**只在未保护时可作判据** |
| 4 | `0x16` 的 `Bal` 与 `0x10` 的俯仰量级不一致（如 `Bal −2055` vs 俯仰 −6.41°）| 待查（`Bal` 的零点/标度） | ⏳ 记入待确认（不影响本次结论）|

---

## 五、由原始值反推的一处交叉验证（MQ-135 到底有没有在工作）

分压网络 `AO —[10 kΩ]—┬— PA5 —[15 kΩ]— GND`，分压比 **0.600**（[`电路设计说明文档.md`](../../docs/design_hardware/电路设计说明文档.md) §6.1）：

```
V(PA5) = 122 / 4095 × 3.3 V ≈ 0.098 V
V(AO)  = 0.098 / 0.600      ≈ 0.16 V     ← MQ-135 模块 AO 实测（换算值）
```

对照"MQ-135 洁净空气 AO 常见 0.1–0.3 V"（外部资料，见 [`上板测试记录.md`](../../docs/design_hardware/上板测试记录.md) §6.1 的参考表），
**0.16 V 正落在该区间** ⇒ **模块在测、分压通路正常、ADC 通道没接错**。
（ADC 12 位 / 3.3 V 参考；0.098 V 只有约 122 个码，量化误差约 ±0.008 V ⇒ 只看量级，不看小数后两位。）

---

## 六、本次没做、需要人或场地才能做的

| 项 | 为什么没做 | 需要什么 |
|---|---|---|
| **完整任务链记录**（上电→预热→待机→下发任务→巡检含一次气体报警→返航→完成）| 需要车能自主行驶 + 场地 + 演示气源；本次只做了"静止平衡观测" | 人扶正/清场 + 演示气源（酒精棉球）|
| **三条安全通道的真机复现**（拔链路 500 ms 停 / 急停 `0x2F` / 低压·倾角保护）| 会改变车的运行状态，需有人在车旁 | 人在场 + 车能跑 |
| **PID 整定前后对比** | 只取到"当前基线"（`01`），没有"调整后" | 一次现场整定（前后各 `--dump` 一次）|
| 蓝牙端到端 | COM4/COM5 打开后 0 B | 确认模块处于 SPP 从机并已"连接"、或继续用有线 |

> ⚠️ **每次测试结束后的状态**：我们一停手，链路就静默 ⇒ **500 ms 后板子按设计锁存安全停车**（车会停、可能倾倒）。
> 要继续跑：在**上位机界面点"使能"或"下发任务"**解除锁存（或重新上电）。

---

> **项目归属**：中国石油大学（华东） 专业生产实习课程项目<br>
> **范围说明**：本项目不涉及 MiniBalance 控制板（STM32F405RGT6 版本）的硬件设计与改版；控制板直接沿用，A1 仅重做主底板。<br>
> **许可**：原创代码与文档采用 MIT License；第三方组件遵循各自原始许可证。
