pierrotto12138-code/balance-car-inspection-robot/hardware/eda_export_20261016/TestPoint_PCB2_2026-10-16.xlsx

Sheet: Summary
网络总数 | 65
有测试点的网络 | 0
无测试点的网络 | 65
测试点覆盖率 | 0%
顶面测试点 | 0
底面测试点 | 0
测试点统计 | Testpoints Count
网络总数 | Net Count

Sheet: Nets Count
Net Name | Quanatity
POWER_GNDREF | 0
PA7 | 0
POWER_+3.3V | 0
PC5 | 0
POWER_+5V | 0
PA5 | 0
MQ2_AO | 0
MQ135_AO | 0
PA6 | 0
VIN_SW | 0
SW_NODE | 0
LED_3V3 | 0
LED_5V | 0
POWER_+12V | 0
MB_OUT1 | 0
MB_OUT2 | 0
MA_OUT1 | 0
MA_OUT2 | 0
LED_12V | 0
PB1 | 0
PA8 | 0
PA12 | 0
PB4 | 0
PA2 | 0
PB3 | 0
PB12 | 0
PA3 | 0
PC4 | 0
PC3 | 0
PB7 | 0
PB6 | 0
PB0 | 0
PA0 | 0
PC1 | 0
PA11 | 0
PA1 | 0
PA15 | 0
PB5 | 0
PC13 | 0
PC14 | 0
PC15 | 0
PC0 | 0
PC2 | 0
PA4 | 0
PB10 | 0
PB11 | 0
PB9 | 0
PB8 | 0
PD2 | 0
PC12 | 0
PC11 | 0
PC10 | 0
PA14 | 0
CANL | 0
CANH | 0
PA13 | 0
PA10 | 0
PA9 | 0
PC9 | 0
PC8 | 0
PC7 | 0
PC6 | 0
PB15 | 0
PB14 | 0
PB13 | 0

Sheet: Testpoints Count
Number | Net | Center X | Center Y | Layer | Hole Size
