pierrotto12138-code/balance-car-inspection-robot/docs/protocol/test_vectors.tsv

# name | cmd_hex | data_hex | frame_hex
0x10 姿态数据 | 10 | 7b0038fed21e0c00deff3800 | aa55100c007b0038fed21e0c00deff38005afa
0x11 运动状态 | 11 | fa0006ffb004550003 | aa55110900fa0006ffb0045500036ef2
0x12 任务状态 | 12 | 01032d0200 | aa5512050001032d02003933
0x13 事件告警 | 13 | 0640e20100 | aa551305000640e201006874
0x14 环境与气体 | 14 | d204290937027a03000162020f010000 | aa55141000d204290937027a03000162020f0100004392
0x1F 心跳 | 1f |  | aa551f00004006
0x20 运动控制 | 20 | 2c016aff01 | aa552005002c016aff012705
0x21 任务指示 | 21 | 0102e803c800 | aa552106000102e803c800f4fa
0x22 控制模式 | 22 | 02 | aa5522010002da5d
0x23 巡检参数 | 23 | e8032c01f401010103000000 | aa55230c00e8032c01f401010103000000ad28
0x24 PID 调参 | 24 | 01000040a043 | aa5524060001000040a043182f
0x24 扩展·全量回读 | 24 | ff0000000000 | aa55240600ff000000000035d4
0x24 扩展·存 Flash | 24 | 000000000000 | aa5524060000000000000021db
0x24 扩展·重新载入 | 24 | fe0000000000 | aa55240600fe00000000003405
0x24 扩展·调参观测模式 | 24 | fd000000803f | aa55240600fd000000803f15e6
0x2F 紧急停机 | 2f |  | aa552f00004009
# crc_cases | input_hex | expected_crc
CRC | 313233343536373839 | 4b37
CRC | 10 | 8cbe
CRC | 100c | 750c
CRC | 100c00 | 0575
# stream_cases | name | chunks(read内逗号, read间分号) | expect_cmds
STREAM | 逐字节喂入（最恶劣分片） | aa55100c007b0038fed21e0c00deff38005afa | 10
STREAM | 一包内含两帧 | aa551f00004006aa552f00004009 | 1f,2f
STREAM | 垃圾字节 + 伪帧头后重新同步 | 00ffaa1377aaaa551305000640e201006874 | 13
STREAM | 坏 CRC 整帧丢弃 | aa5512050001032d02003900
STREAM | 长度异常（32767）整帧作废 | aa5514ff7f
STREAM | AA AA 55 前缀容错 | aaaaaa551f00004006 | 1f
