pierrotto12138-code/balance-car-inspection-robot/firmware/tests/sensor_vectors.csv

# 传感器算法测试向量（由 tools/fw_prep/gen_sensor_vectors.py 的 Python 独立实现生成）
# 固件侧由 firmware/tests/sensor_test.c 逐条比对（tools/fw_prep/run_sensor_test.py 驱动）
# 格式：KIND | payload...
CALIB | mq2 | 439.343507 | 2580 | 2600 | 2620
GAS | mq2 | 0 | 25 | 50 | 1 | 439.286045 | 0.000000 | 0.000000 | 0.000000000 | 0.000000000 | 0.000000
GAS | mq2 | 0 | 19.37 | 33 | 1 | 439.286045 | 0.000000 | 0.000000 | 0.000000000 | 0.000000000 | 0.000000
GAS | mq2 | 0 | 5 | 90 | 1 | 439.286045 | 0.000000 | 0.000000 | 0.000000000 | 0.000000000 | 0.000000
GAS | mq2 | 0 | 40 | 10 | 1 | 439.286045 | 0.000000 | 0.000000 | 0.000000000 | 0.000000000 | 0.000000
GAS | mq2 | 0 | 25 | 50 | 0 | 439.286045 | 0.000000 | 0.000000 | 0.000000000 | 0.000000000 | 0.000000
GAS | mq2 | 1 | 25 | 50 | 1 | 439.286045 | 1.343101 | 37217272.727273 | 84722.183157895 | 93716.119108763 | 0.000000
GAS | mq2 | 1 | 19.37 | 33 | 1 | 439.286045 | 1.343101 | 37217272.727273 | 84722.183157895 | 84703.352332121 | 0.000000
GAS | mq2 | 1 | 5 | 90 | 1 | 439.286045 | 1.343101 | 37217272.727273 | 84722.183157895 | 72683.598704473 | 0.000000
GAS | mq2 | 1 | 40 | 10 | 1 | 439.286045 | 1.343101 | 37217272.727273 | 84722.183157895 | 93144.289845747 | 0.000000
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
