pierrotto12138-code/balance-car-inspection-robot/hardware/test_records/02_observe_20s_未加使能_车被锁存.csv

t_s | pitch_deg | gx_dps | gz_dps | speedL_mms | speedR_mms | pwm | dist_cm
0.0560 | -79.07 | -36.00 | -20.00 | 0 | 0 | -8200 | 0
0.0560 | -79.07 | -36.00 | -20.00 | 0 | 0 | -8200 | 0
0.0560 | -79.07 | -40.00 | -19.00 | 0 | 0 | -8200 | 0
0.0560 | -79.07 | -40.00 | -19.00 | 0 | 0 | -8200 | 0
0.1085 | -79.07 | -40.00 | -21.00 | 0 | 0 | -8200 | 0
0.1086 | -79.07 | -40.00 | -21.00 | 0 | 0 | -8200 | 0
0.1086 | -79.07 | -38.00 | -20.00 | 0 | 0 | -8200 | 0
0.1086 | -79.07 | -38.00 | -20.00 | 0 | 0 | -8200 | 0
0.1594 | -79.07 | -38.00 | -20.00 | 0 | 0 | -8200 | 0
0.1594 | -79.07 | -38.00 | -20.00 | 0 | 0 | -8200 | 0
0.1594 | -79.07 | -37.00 | -18.00 | 0 | 0 | -8200 | 0
0.1594 | -79.07 | -37.00 | -18.00 | 0 | 0 | -8200 | 0
0.2094 | -79.06 | -39.00 | -20.00 | 0 | 0 | -8200 | 0
0.2094 | -79.06 | -39.00 | -20.00 | 0 | 0 | -8200 | 0
0.2094 | -79.07 | -37.00 | -20.00 | 0 | 0 | -8200 | 0
0.2095 | -79.07 | -37.00 | -20.00 | 0 | 0 | -8200 | 0
0.2095 | -79.07 | -38.00 | -19.00 | 0 | 0 | -8200 | 0
0.2596 | -79.07 | -38.00 | -19.00 | 0 | 0 | -8200 | 0
0.2596 | -79.07 | -40.00 | -20.00 | 0 | 0 | -8200 | 0
0.2596 | -79.07 | -40.00 | -20.00 | 0 | 0 | -8200 | 0
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
