pierrotto12138-code/balance-car-inspection-robot/hardware/test_records/05_observe_balance_20s.csv

t_s | pitch_deg | gx_dps | gz_dps | speedL_mms | speedR_mms | pwm | dist_cm
0.0550 | 0.00 | 0.00 | 0.00 | 0 | 0 | -524 | 0
0.0551 | -1.10 | -91.00 | -16.00 | 0 | 0 | -572 | 0
0.0551 | -1.10 | -91.00 | -16.00 | 0 | 0 | -572 | 0
0.0551 | -1.19 | -81.00 | -18.00 | 0 | 0 | -589 | 0
0.1101 | -1.19 | -81.00 | -18.00 | 0 | 0 | -589 | 0
0.1101 | -1.27 | -54.00 | -16.00 | 0 | 0 | -586 | 0
0.1101 | -1.27 | -54.00 | -16.00 | 0 | 0 | -586 | 0
0.1637 | -1.28 | -13.00 | -17.00 | 0 | 0 | -552 | 0
0.1638 | -1.28 | -13.00 | -17.00 | 0 | 0 | -552 | 0
0.1638 | -1.23 | -11.00 | -18.00 | 0 | 0 | -531 | 0
0.1638 | -1.23 | -11.00 | -18.00 | 0 | 0 | -531 | 0
0.2139 | -1.17 | -37.00 | -18.00 | 0 | 0 | 529 | 0
0.2139 | -1.17 | -37.00 | -18.00 | 0 | 0 | 529 | 0
0.2139 | -1.19 | -57.00 | -16.00 | -13 | -26 | 696 | 0
0.2139 | -1.19 | -57.00 | -16.00 | -13 | -26 | 696 | 0
0.2139 | -0.90 | -241.36 | -53.00 | -40 | -40 | 408 | 0
0.2690 | -0.90 | -241.36 | -53.00 | -40 | -40 | 408 | 0
0.2690 | -0.23 | 276.00 | 30.00 | -13 | 0 | 188 | 0
0.2690 | -0.23 | 276.00 | 30.00 | -13 | 0 | 188 | 0
0.2690 | 0.06 | 40.00 | 50.00 | -13 | 0 | 275 | 0
0.3191 | 0.06 | 40.00 | 50.00 | -13 | 0 | 275 | 0
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
