pierrotto12138-code/balance-car-inspection-robot/hardware/test_records/07_observe_balance_enabled.csv

t_s | pitch_deg | roll_deg | gx_dps | gy_dps | gz_dps | Bal | Vel | Turn | Moto1 | Moto2 | CCR_A | CCR_B | EncL | EncR | statusBits | spdL_mms | spdR_mms | pwm | dist_cm
1.049 | 6.65 | -1.76 | 242.36 | -20.0 | -22.0 | 736 | -1549 | 0 | 813 | 813 | 951 | 951 | -8 | -8 | 12 | -134 | -121 | 559 | 0
2.34 | -0.71 | -0.7 | -144.0 | -18.0 | -19.0 | -535 | 196 | 0 | 339 | 339 | 396 | 396 | 0 | 0 | 12 | 0 | 0 | 333 | 0
3.601 | -1.07 | -0.53 | -114.0 | -14.0 | -49.0 | -602 | 139 | 0 | 463 | 463 | 541 | 541 | 0 | -1 | 12 | 0 | 0 | 436 | 0
4.872 | 1.79 | -0.63 | -156.0 | -18.0 | 260.0 | -4 | 554 | 0 | -550 | -550 | 643 | 643 | 2 | 4 | 12 | 0 | 53 | -655 | 0
6.209 | -0.39 | -0.86 | 42.0 | -15.0 | -16.0 | -125 | 162 | 0 | -37 | -37 | 43 | 43 | 0 | 0 | 12 | 0 | 0 | 75 | 0
7.473 | -0.77 | -1.5 | -72.0 | -9.0 | -160.0 | -405 | 35 | 0 | 370 | 370 | 432 | 432 | 0 | -2 | 12 | 0 | -40 | 438 | 0
8.795 | -1.01 | -0.8 | -9.0 | -12.0 | -151.0 | -454 | 21 | 0 | 433 | 433 | 506 | 506 | 0 | -3 | 12 | 0 | -26 | 432 | 0
10.07 | 0.83 | -2.11 | -157.0 | -19.0 | 134.0 | -121 | 496 | 0 | -375 | -375 | 438 | 438 | 1 | 4 | 12 | 13 | 40 | -432 | 0
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
