pierrotto12138-code/balance-car-inspection-robot/hardware/test_records/08_observe_enabled_10s.csv

t_s | pitch_deg | gx_dps | gz_dps | speedL_mms | speedR_mms | pwm | dist_cm
0.0508 | 0.00 | 0.00 | 0.00 | 0 | 0 | -769 | 0
0.0508 | -1.88 | -44.00 | -16.00 | 0 | 0 | -762 | 0
0.0508 | -1.88 | -44.00 | -16.00 | 0 | 0 | -762 | 0
0.0508 | -1.88 | -18.00 | -17.00 | 0 | 0 | -734 | 0
0.1057 | -1.88 | -18.00 | -17.00 | 0 | 0 | -734 | 0
0.1058 | -1.86 | -7.00 | -16.00 | 0 | 0 | -719 | 0
0.1058 | -1.86 | -7.00 | -16.00 | 0 | 0 | -719 | 0
0.1058 | -1.81 | 8.00 | -17.00 | 0 | 0 | -686 | 0
0.1572 | -1.81 | 8.00 | -17.00 | 0 | 0 | -686 | 0
0.1572 | -1.74 | 11.00 | -15.00 | 0 | 0 | -666 | 0
0.1572 | -1.74 | 11.00 | -15.00 | 0 | 0 | -666 | 0
0.1572 | -1.65 | 3.00 | -18.00 | -13 | -26 | 691 | 0
0.2094 | -1.65 | 3.00 | -18.00 | -13 | -26 | 691 | 0
0.2094 | -1.60 | 227.00 | -142.00 | -26 | -26 | 651 | 0
0.2094 | -1.60 | 227.00 | -142.00 | -26 | -26 | 651 | 0
0.2094 | -0.81 | -314.36 | -22.00 | -26 | -40 | 328 | 0
0.2094 | -0.81 | -314.36 | -22.00 | -26 | -40 | 328 | 0
0.2658 | -0.29 | 283.00 | -35.00 | -26 | -40 | 294 | 0
0.2658 | -0.29 | 283.00 | -35.00 | -26 | -40 | 294 | 0
0.2658 | 0.07 | 105.00 | -56.00 | -13 | -13 | 278 | 0
0.2658 | 0.07 | 105.00 | -56.00 | -13 | -13 | 278 | 0
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
