pierrotto12138-code/balance-car-inspection-robot/hardware/eda_export_20261016/SCH_Schematic2_2026-10-16.pdf

| | | 1 | | | | | | | | | 2 | | | | | | | | 3 | | | | 4 | | | | | | | | | | | | 5 | | | | | | 6
A | | PA1 | | | | 11 11 | 12 12 | | | PA2 | | PA14 | | | 13 13 | 14 | 14 | | CANL | | | | | | | | | | | | 100nF C3 | | | | R5 | | | | | | | | | | | | A

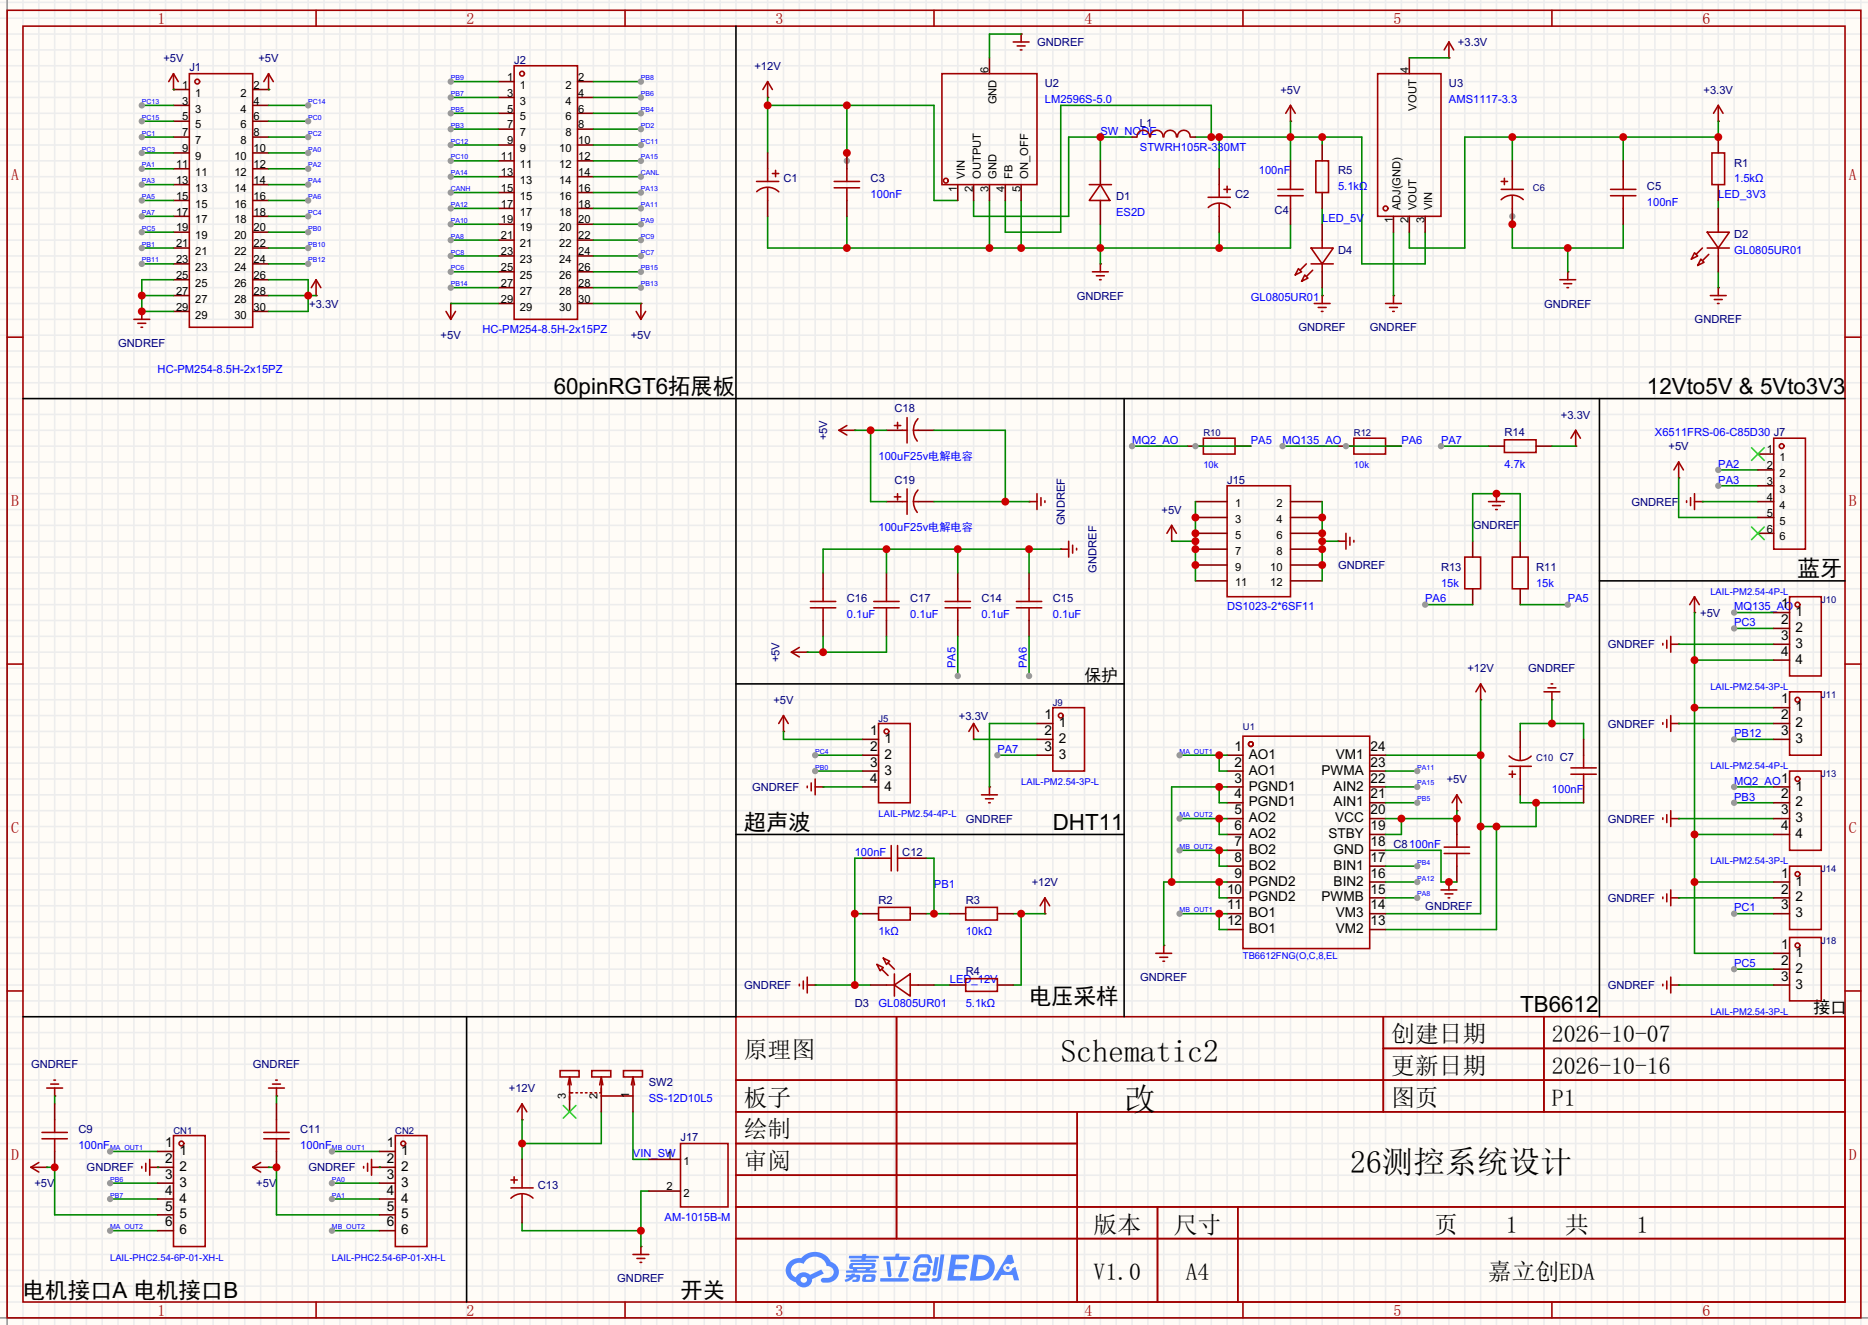
[picture p75: page 1]

GNDREF | | | | | | | | | | | | | | | +3.3V

PC13 | | | 3 | 3 | | 4 4 | | PC14 | | PB5 | | 5 | 3 | 4 | 6 | | PB4 | | | | LM2596S-5.0 | | | | | | | | | | | | | | | AMS1117-3.3
PC15 | | | 5 | 5 | | 6 6 | | PC0 | | PB3 | | 7 | 5 | 6 | 8 | | PD2 | | | | | | | SW_NODE | | L1
PC1 | | | 7 | 7 | | 8 8 | | PC2 | | PC12 | | 9 | 7 | 8 10 | 10 | | PC11 | | | | | | | | | STWRH105R-330MT
PC3 | | | 9 | 9 | 10 10 | | | PA0 | | PC10 | | | 9 11 11 | 12 | 12 | | PA15 | | | | | | | | | | | | | | | | | | | | | | | | | | | R1

PA3 | | | | 13 13 | 14 14 | | | PA4 | | CANH | | | | | | | PA13 | | C1 | | | | | | | | C2 | | | | | | 5.1kΩ | | | | C6 | | C5 | | | | | 1.5kΩ
PA5 | | | | | 18 18 15 15 16 16 | | | PA6 | | PA12 | | | 17 17 | 18 16 | 18 15 15 16 | | PA11 | | | 100nF | | | | | D1 | | | | | C4 | | | | | | | | | 100nF | | | | LED_3V3

PA7 | | | | 17 17 | | | | PC4 | | PA10 | | | 19 19 | 20 | 20 | | PA9 | | | | | | | | ES2D | | | | | | | LED_5V
PC5 | | | | 19 19 | 20 20 | | | PB0 | | PA8 | | | 21 21 | 22 | 22 | | PC9 | | | | | | | | | | | | | | | | | | | | | | | | | | | D2
PB1 | | | | 21 21 | 22 22 | | | PB10 | | PC8 | | | 23 23 | 24 | 24 | | PC7 | | | | | | | | | | | | | | | | D4 | | | | | | | | | | | GL0805UR01
PB11 | | | | 23 23 | 24 24 | | | PB12 | | PC6 | | | 25 25 | 26 | 26 | | PB15
25 25 | 26 26 | | | | | PB14 | | | 27 27 | 28 | 28 | | PB13
27 27 | 28 28 | | | +3.3V | | | | | 29 29 | 30 | 30 | | | | | | | | GNDREF | | | | | GL0805UR01 | | | | | | | | | | GNDREF
29 29 | 30 30 | | | | | | | | | | | | | | | | | | | | | | | | | | | | | | | | | | | | GNDREF

+5V | | HC-PM254-8.5H-2x15PZ | | | | | +5V | | | | | | | | | | | | | | | GNDREF | | | | GNDREF

GNDREF

60pinRGT6拓展板 | | | 12Vto5V & 5Vto3V3

MQ2_AO | | | R10 | | PA5 | | MQ135_AO | | | R12 | | PA6 | PA7 | | | R14 | | | | | X6511FRS-06-C85D30 J7 | +5V

100uF25v电解电容 | | | | | | | | | | | | | | | | | | | | | | | | | | | 4.7k | | | | | | | | PA2 | | | 1 | 1
C19 | | | | | | | | | | | | | 10k | J15 | | | | | | 10k | | | | | | | | | | | | | | PA3 | | | 2 | 2

B | | | | | | | | | | | | | | | | | | | +5V | | | 1 | | | 2 | | | | | | | | | | | | | GNDREF | | | | | | | 4 | 4 | | | B

100uF25v电解电容 | | | | | | | | | | | | | | | 3 | | | 4 | | | | | | | GNDREF | | | | | | | | | | 5 | 5

9 | | 10 | | | | GNDREF | | | R13 | | | | R11 | | | | | | | | | | | 蓝牙
11 | | 12 | | | | | | | 15k | | | | 15k

C16 | | | C17 | | C14 | | | C15 | | | | | | | | DS1023-2*6SF11 | | | | | | | | PA6 | | | | | | PA5 | | | | | LAIL-PM2.54-4P-L | MQ135_AO | | | 1 | | J10
0.1uF | | | 0.1uF | | 0.1uF | | | 0.1uF | | | | | | | | | | | | | | | | | | | | | | | | | | +5V | | PC3 | | | 2 | 1

GNDREF | | | | | | | | 4 | 3

+12V | | | GNDREF | | | | | | | | | | | 4

+5V | | | | | | | | | | | | | | | | | | | | | | | | | | | | | | | | | | | | | | LAIL-PM2.54-3P-L | | | | | 1 | | J11

1 | J5 | | | | | | | | 1 | | | | | | | | U1 | | | | | | | | | | | | | | GNDREF | | | | | | | | 3 | 2
1 | | | | | | | | 2 | | | | | | | | | | | | | | | | | | | | | | | | | | | PB12 | | | | 3

PC4 | | | | 2 | | | | PA7 | | | | 3 | | | | | MA_OUT1 | | | AO1 1 AO1 2 | | | | | | | | | | | C10 | | C7
PB0 | | | | 3 | | | | | | | | | | | | | | | | PGND1 3 | | | | | | | PA11 | +5V | | | | | | | | | LAIL-PM2.54-4P-L | | MQ2_AO | | | 1 | | J13

BO1 12 AO2 5 | | | | VM2 | 13 VM3 14 PWMB 15 BIN2 16 BIN1 17 GND 18 STBY 19 VCC 20 AIN1 21 AIN2 22 PWMA 23 VM1 | | PB5 | | | | | | | | | | | | | | | 3 | 2

GNDREF | | | | | | 4 | | | | | | LAIL-PM2.54-3P-L | | | | | | | | | | PGND1 4 | | | | | | | PA15 | | | | | 100nF | | | | | | | PB3 | | | 2 | 1

C | 超声波 | | | | | | | LAIL-PM2.54-4P-L | | | GNDREF | | | | | DHT11 | | | | MA_OUT2 | | | | | | | | | | | | | | | | | | GNDREF | | | | | | | | 4 | 3 | | C

100nF | | | C12 | | | | | | | | | | | MB_OUT2 | | | | BO2 8

PGND2 9 | PB4 | | LAIL-PM2.54-3P-L | | 1 | | J14

R2 | | R3 | | | | PA8 GNDREF | GNDREF | | | | | 3 | 2

PB1 | | +12V | | PGND2 10 | PA12 | | | | 2 | 1

MB_OUT1 | BO1 11 | | | | PC1 | | | | 3

TB6612FNG(O,C,8,EL | | | | PC5 | | 2 | 2

GNDREF | | | LED_12V | R4 | | GNDREF | | | GNDREF | | | | 3 | 3

D3 | GL0805UR01 | | 5.1kΩ | 电压采样 | | | TB6612

LAIL-PM2.54-3P-L | | | | | 接口

原理图 | Schematic2 | 创建日期 | 2026-10-07

GNDREF | GNDREF | | | | | 更新日期 | 2026-10-16

D | | 100nF | | MA_OUT1 | 2 | 1 | | 100nF | | MB_OUT1 | 2 | 1 | | VIN_SW | 1 | 1 | | 审阅 | | | 26测控系统设计 | | | | | D

GNDREF | | 3 | 2 | | | GNDREF | | 3 | 2

PB7 | 5 | 4 | | | | PA1 | 5 | 4
5 | | | | | 6 | 5 | | | | AM-1015B-M | | | 版本 | 尺寸 | | 页 | 1 | 共 | 1
LAIL-PHC2.54-6P-01-XH-L | | LAIL-PHC2.54-6P-01-XH-L | | | | | | V1.0 | A4 | | 嘉立创EDA

MA_OUT2 | | 6 | | | | MB_OUT2 | | 6

电机接口A 电机接口B | | | | | | 开关
