pierrotto12138-code/balance-car-inspection-robot/firmware/App/Config/app_config.h

#ifndef APP_CONFIG_APP_CONFIG_H
#define APP_CONFIG_APP_CONFIG_H

/*
 * 应用层**集中配置**（B，2026-10-09）
 *
 * 为什么单独放一个头文件：
 *   固件里有很多"到货后要按实测调整"的量（轮径、编码器线数、告警阈值、周期…）。
 *   把它们集中在一处，联调时只改这一个文件，不用在几千行里翻；
 *   同时它也是**给上位机/C 的接口说明**：这些量的含义与单位都在注释里。
 *
 * ★ 标 [待实测] 的项必须在板子到货后按实际测量值修正。
 */

/* ============================================================================
 * 一、链路
 * ==========================================================================*/
#define CFG_BAUD_BLUETOOTH   115200u   /* USART2（蓝牙 SPP，协议主链路）*/
#define CFG_BAUD_WIRE        115200u   /* USART1（有线调试链路，同协议；USB-TTL 接 PA9/PA10）*/
#define CFG_TX_TIMEOUT_LOOPS 2000000u  /* 串口发送等待上限（防死等）*/

/* ============================================================================
 * 二、整车标定 [待实测]
 * ==========================================================================*/
#define CFG_ENCODER_COUNTS_PER_REV  1560   /* 13 线霍尔四倍频后每圈计数（决策记录 §6）[待实测] */
#define CFG_WHEEL_DIAMETER_MM       67     /* 轮径 mm —— **必须实测**（决定 mm/s 是否可信）[待实测] */
#define CFG_ENCODER_PERIOD_MS       10     /* 编码器读取周期（控制中断 10 ms 分支）*/

/* 编码器计数 → 轮速 mm/s 的换算系数：(周长 mm / 每圈计数) / 周期 s */
#define CFG_MM_PER_COUNT  (3.14159265f * (float)CFG_WHEEL_DIAMETER_MM / (float)CFG_ENCODER_COUNTS_PER_REV)
#define CFG_MS_PER_ENCODER_PERIOD ((float)CFG_ENCODER_PERIOD_MS / 1000.0f)

/* ============================================================================
 * 三、任务周期与栈（1 字 = 4 B）
 * ==========================================================================*/
#define CFG_COMM_TICK_MS       20    /* 通信任务基准节拍 */
#define CFG_COMM_TICK_TUNE_MS   5    /* 调参观测模式下的节拍（更细的定时粒度）*/
#define CFG_GAS_POLL_MS        50
#define CFG_STATE_TICK_MS     100
#define CFG_UI_TICK_MS        100

#define CFG_STACK_COMM   384
#define CFG_STACK_GAS    384
#define CFG_STACK_STATE  320
#define CFG_STACK_UI     512

/* 上行周期 */
#define CFG_TX_TELEMETRY_MS    50    /* 0x10/0x11/0x12：20 Hz */
#define CFG_TX_TELEMETRY_TUNE_MS 10  /* 调参观测模式：100 Hz（0x10/0x11）*/
#define CFG_TX_HEARTBEAT_MS   200    /* 0x1F：5 Hz */
#define CFG_TX_EVENT_IMMEDIATE  1    /* 事件触发即发 */

/* 0x14（环境与气体）上行周期：跟随采样档位 */
#define CFG_TX_ENV_FAST_MS    200    /* 异常档 5 Hz */
#define CFG_TX_ENV_WARMUP_MS 1000    /* 预热档 1 Hz */
#define CFG_TX_ENV_MIN_MS     100    /* 下限（防止 0x23 把采样周期设得过小把链路灌满）*/

/* ============================================================================
 * 四、采样与研判
 * ==========================================================================*/
#define CFG_GAS_ADC_AVG          8     /* 每次采样做几次 ADC 平均 */
#define CFG_GAS_CALIB_SAMPLES   60     /* 清洁空气标定累加次数（预热期 2 Hz → 约 30 s）*/
#define CFG_DHT_PERIOD_MS     1000     /* DHT11 最快 1 Hz */
#define CFG_GAS_SAMPLE_FAST_MS 200     /* 异常档采样周期：5 Hz */
#define CFG_GAS_SAMPLE_WARM_MS 500     /* 预热期采样周期：2 Hz */
#define CFG_GAS_SAMPLE_MIN_MS   50     /* 采样周期下限（0x23 可改采样周期，防止设得过小）*/
#define CFG_ADC_CONV_GUARD 2000000u    /* ADC"等 EOC"的忙等上限：硬件异常时不死等 */

/* ---- 固件版本字节（2026-10-13 新增，随 0x16 的保留字节上报）----
 * 取值 = (月 << 4) | 日：**改代码当天就把这里改成当天日期**，例如 10 月 15 日 = 0xAF。
 * 为什么需要它：真机联调时"到底烧没烧上"曾扯皮一整轮（我读到的现象与用户以为的版本不符）。
 * 有了它，上位机/工具一读就知道板上跑的是哪一天的固件 —— 这是**可验证性**的基础设施。*/
/* ---- 转向环极性（2026-10-15）：速度环用编码器"和"、转向环用"差"，
   翻编码器对修速度环时会连带把转向环翻反 ⇒ 偏航正反馈 ⇒ 原地转圈。
   本开关单独把转向环翻回来（等效：把 Turn_Kp/Turn_Kd 设为负值，可在线试）。*/
#define CFG_TURN_INVERT        0


/* ---- 调试期"出厂增益"覆盖（2026-10-15）----
 * 为什么要有它：远程写 0x24 **不可靠**（今晚多次"无回显"/被拒），而每次复位/重新连接
 * PC 都会从 Flash 重新载入参数 ⇒ 远程改动会被抹掉、转圈等毛病反复出现。
 * 这里做成**编译期出厂值**：上电时（ParamStore_Load 之后）强制覆盖，烧一次即长期有效。
 * 调试完成、参数定型后把 CFG_DEBUG_PARAM_OVERRIDE 置 0 即可。
 *
 * 当前取值（用户明确要求"先不要转圈"）：转向环 0（无权限 ⇒ 不可能转圈）、
 * 速度环 0（无位置调节 ⇒ 不会跑飞，但也无法抑制漂移）。*/
#define CFG_DEBUG_PARAM_OVERRIDE 1
#define CFG_OVR_BALANCE_KP       300.0f   /* 平衡环 P（厂商默认 300）*/
#define CFG_OVR_BALANCE_KD       1.0f     /* 平衡环 D（过冲大就先加它：1→1.5）*/
#define CFG_OVR_VELOCITY_KP      -80.0f    /* ★ 本轮恢复：速度环 P（抑制漂移；若跑飞改 -80）*/
#define CFG_OVR_VELOCITY_KI      -0.4f     /* ★ 本轮恢复：速度环 I（若跑飞改 -0.4）*/
#define CFG_OVR_ZHONGZHI         0.5f     /* 角度中值（怀疑重心偏后 ⇒ 可 ±0.3~0.5 试）*/
#define CFG_OVR_TURN_KP          52.0f    /* ★ 2026-10-15 启用转向环（用户要求"解放转圈"）：
                                               厂商默认 52。原先置 0 是为了避免"原地转圈"，
                                               而那次故障的真因是 `control.c` 里**裸 if 缺花括号**
                                               （已修，见铁律 37）—— 不是转向环本身的问题。
                                               ★ 现在可以在上位机调参页用 0x24 在线改（±500），
                                               嫌猛/嫌弱直接在上面调，不必重烧。*/
#define CFG_OVR_TURN_KD          0.5f     /* 厂商默认 0.5；仅"前后运动中转向"时参与
                                               （`turn()` 原地转时有意把 Kd 置 0）*/

#define CFG_FW_BUILD_ID        0xAF    /* 2026-10-15 */

/* ---- 固件特性位（写进 0x16 状态位的 bit3；2026-10-15 晚新增）----
 * 为什么要它：同一天可能有多次构建，而 `CFG_FW_BUILD_ID` 只能表达到"日"
 * ⇒ 现场"到底烧进去的是哪版"全靠猜（本项目为此白折腾过一轮）。
 * 现在 bit3 = 1 表示这版包含 10-15 晚间的改动：
 *   · 左右倾角/角速度上报（0x10 的 roll/gy 不再写死 0）
 *   · 转向环启用（TURN_KP/KD = 52/0.5）
 *   · 前进档 Target_Velocity 110 → 150
 *   · MQ-135 角色指派到 J13（sensor_adc.h）
 * 上位机读到 bit3 = 0 时，会明确提示"板子是旧构建，请重烧"。 */
#define CFG_FW_FEATURE_BITS    0x08u

/* ---- 姿态轴向映射：0x10 的"左右倾角/左右角速度"取哪一对量（2026-10-15，已按实测更正）----
 * 背景（**实测 + 代码双证据**）：本机 `Way_Angle = 2`（卡尔曼，见 main.c:8），
 * 而 `Get_Angle()` 里**只有 `way==1` 才会调用 `Read_DMP()`** ⇒ DMP 输出的
 * `Pitch / Roll / gyro[] / accel[]` **从不更新、恒为 0** —— 真机"横滚恒 0.00"正是此因。
 * （我最初按"车靠 -Roll 平衡 ⇒ Pitch 是左右倾"的推理取了 Pitch，方向对但**取不到值**。）
 * 因此默认改走**加速度计**：`Angle_LR = atan2(Accel_X, Accel_Z)`（与厂商用 Y/Z 算平衡角
 * 正交同构），角速度取**陀螺仪 Y 轴** —— 与 `Way_Angle` 无关，任何算法下都生效。
 *   0 = 加速度计静态角（**默认，推荐**；⚠ 仅加速度计、未做陀螺仪融合 ⇒ 运动时噪声大）
 *   1 = DMP 四元数 `Pitch`（仅当 Way_Angle==1 走 DMP 时才有值）
 * 若真机实测"左右倾"正负号相反，改 `CFG_IMU_LR_SIGN`（不必动别处）。 */
#define CFG_IMU_LR_SOURCE      0
#define CFG_IMU_LR_SIGN       (+1.0f)   /* -1.0f 可翻转左右倾角符号 */

/* ---- 调试开关：上电即把速度环置 0（2026-10-13）----
 * 用途：单独验证"平衡环方向"。速度环是正反馈结构且权重是平衡环的 13 倍，
 * 它符号一错就会让车轮跑飞、把平衡环的表现完全盖住 ⇒ 调试时先摘掉它再看。
 * 为什么做成编译期开关而不是远程改参数：远程写 0x24 会触发"失联计时"，
 * 之后只要工具静默 500 ms 板子就锁存安全停车（按键也解不开），反而更麻烦。
 * 调试完成、方向确认后，把这个改回 0。*/
#define CFG_DEBUG_DISABLE_VELOCITY 0    /* 2026-10-15 */

/* ---- 0x20 运动指令（2026-10-13 起真正实现）----
 * 厂商的运动模型是"**方向标志 + 固定速度档**"（Flag_Qian/Hou/Left/Right），
 * 所以协议里的连续量 linMmS/angDpsX10 只做**方向判定**（阈值以下当作不走/不转）。
 * ★ 安全：超过 CFG_MOTION_TIMEOUT_MS 没收到新的运动指令 → **自动全部清零**，
 *   避免"上位机崩了/线断了，车还按最后一条指令一直跑"。*/
#define CFG_MOTION_LIN_MIN_MMS    50u    /* |线速度| ≥ 此值才判为前进/后退 */
#define CFG_MOTION_ANG_MIN_DPS10 100u    /* |角速度| ≥ 此值(0.1dps)才判为左/右转 */
#define CFG_MOTION_TIMEOUT_MS    500u    /* 运动指令超时（ms）→ 自动停 */

/* ---- 电池低压保护（2026-10-13 真机联调修正；详见 app_tasks.c state_task 里的说明）----
 * 血泪教训：原判据只要"电压 > 0"就进入低压判定，结果**分压网络悬空拾到几毫伏噪声**
 * 被当成"电池 0.x V 低于 11.1 V" → 误锁存硬件故障 → `Turn_Off()` 恒为 1 →
 * `Set_pwm()` 永不被调用 → **电机完全没有输出、车根本不能平衡**
 * （真机现象：一上电就 stage=FAULT、fault=0x04，怎么都动不了）。
 * 现在分三级：先过"有电池"门槛 → 再连续确认 → 才认低压。*/
#define CFG_BAT_PRESENT_MIN    600u    /* 0.01V 单位 → 6.00 V：低于此值视为"没接电池/读数无效" */
#define CFG_BAT_LOW_LIMIT     1110u    /* 0.01V 单位 → 11.10 V：3S 锂电的低压保护线 */
#define CFG_BAT_LOW_CONFIRM      5u    /* 连续 5 拍（100 ms/拍 = 0.5 s）低于阈值才确认 */

/* ---- 电机/编码器方向：**分侧**开关（2026-10-13 真机数据定案）----
 * 实测证据（tools/fw_prep/out/tilt.log）：前后倾时 `spd L` 与 `spd R`
 * **幅值几乎相等、符号永远相反**（前倾 −115/+115，后倾 +484/−485）——
 * 平衡车前倾时两轮应当**同向往前追**，现在是"原地对拧" ⇒ 车只会扭转、重心继续倒，
 * 这正是"奔着跌倒去"的根源。它不是"整体符号翻一个"的问题，而是
 * **左右两侧彼此不一致**（一侧的电机或编码器相对另一侧接反）。
 * 顺带：左右压（转向）时两轮反向是**正常**的，所以问题只在共模动作上。
 *
 * 接线约定（用户实测）：CN1 = 左轮 → Moto1；CN2 = 右轮 → Moto2。
 * 处置顺序（一次只动一个，动完烧一次做倾斜测试）：
 *   ① 两轮**反向对拧**（一个往前一个往后） ⇒ 电机有一侧反 ⇒ 翻 CFG_MOTOR_*_INVERT
 *   ② 两轮**同向**但车往反方向跑（前倾却往后走） ⇒ 编码器有一侧反 ⇒ 翻 CFG_ENCODER_*_INVERT
 * 当前取值：右轮电机翻向（按"最可能是一侧电机接线反了"先试这个）。*/
#define CFG_MOTOR_LEFT_INVERT   1
#define CFG_MOTOR_RIGHT_INVERT  1
/* ★ 2026-10-13 由真机二次判据唯一的解（纯逻辑推导，不再试）：
 *   初始(0,0)：两轮**反向** ⇒ 两侧物理极性恰好**一个是反的**；
 *   试(0,1)：变成"**同向但整体反**"（情况 3）⇒ 说明反的是**左**侧，
 *            翻右侧等于把两侧一起弄反了；
 *   ⇒ 唯一正确解：**翻左、右回 0** = (1,0)。
 *   此后：固件正命令 → 两轮物理同向且为"前" ⇒ 前倾时轮子往前追（能开始平衡）。*/
#define CFG_ENCODER_LEFT_INVERT 0
#define CFG_ENCODER_RIGHT_INVERT 1/* ★ 2026-10-13 实测更正：上面先置 1，真机倾斜判据给出反的答案 ——
 *   "车向前倾倒时轮子把车往后送"= 前倾时轮子应**往前追**（去追重心），
 *   而置 1 时仍是反的 ⇒ 本机接线下**不应翻向**，故回到 0。
 *   教训：电机方向的唯一可靠判据是**倾斜测试**（前倾→轮子往前追），
 *   不能凭"感觉反了"就翻 —— 翻错一次会同时改变速度环的等效反馈方向，白烧一轮。*/

/* ---- 编码器方向（2026-10-13：翻电机方向后仍"奔着跌倒去"）----
 * 为什么这是**独立**的一路符号：本项目的速度环是"正反馈"结构
 *   （厂商注释原文：速度反馈是正反馈，小车快的时候要慢下来就需要再跑快一点），
 *   它的符号取决于**编码器极性**；而平衡环的符号取决于**电机极性**。
 *   两路各自独立 —— 翻电机方向会同时改变速度环的等效反馈方向，
 *   所以必须分别确认，不能靠"翻一个试试"。
 * 判据（**不用烧录就能测**，见 docs/design_firmware/真机联调问题清单.md）：
 *   把车**用手往前推**，看上位机 0x11 的 spd L/R —— 应为**正**；若为负，就把这里改成 1。*/
#define CFG_ENCODER_DIR_INVERT 0


/* 协议 §4.1 的默认巡检参数（可被 0x23 覆盖）*/
/* ★ 告警阈值怎么定的（2026-10-09 定值；可被 0x23 在线改）
 *
 *   把**清洁空气**的 `Rs/R0` 代进 ppm 估计式 `ppm = a·ratio^b`，得到"本底估计值"：
 *       MQ-2   （LPG 曲线 a=574.25, b=-2.222；清洁空气 ratio=9.83）→ ≈ **3.6 ppm**
 *       MQ-135（NH3 曲线 a=102.2,  b=-2.473；清洁空气 ratio=3.60）→ ≈ **4.3 ppm**
 *   于是取：
 *       MQ-2   30.0 ppm ≈ 本底 8 倍  → 对应 ratio ≈ 3.8（Rs 掉到清洁空气的 38%）
 *       MQ-135 50.0 ppm ≈ 本底 12 倍 → 对应 ratio ≈ 1.34（Rs 掉到 37%）
 *
 *   为什么是"本底的 8~12 倍"：仓库里香烟/酒精/清洁剂都会让读数抬升，
 *   阈值太低会天天误报；太高则漏掉早期泄漏。8~12 倍是"明显异常但不易误报"的折中。
 *
 *   ⚠️ 这是**估计值**：`R0` 与 `RL` 实测标定后应复核（见 §七 与 gas.c 的 RL 说明）。
 *   ⚠️ MQ-135 幂律指数很陡（b=-2.47），其阈值在 ratio 上离本底不远、对 R0 漂移更敏感，
 *      标定完建议先空场观察 24 h 再定稿。
 */
#define CFG_DEF_SAMPLE_MS        1000
#define CFG_DEF_MQ2_THRESH_X10    300   /* 30.0 ppm ≈ 清洁空气本底(3.6)的 8 倍 */
#define CFG_DEF_MQ135_THRESH_X10  500   /* 50.0 ppm ≈ 清洁空气本底(4.3)的 12 倍 */
#define CFG_DEF_ADAPTIVE            1
#define CFG_DEF_TEMP_COMP           0   /* 温湿度补偿默认关（决策 39）*/
#define CFG_DEF_CONFIRM_FRAMES      3

/* ============================================================================
 * 五、状态机 / 安全（与协议 §5 一致）
 * ==========================================================================*/
/* 预热时长（2026-10-09 定值）
 *   MQ 的"上电老化"（24~48 h）已由用户完成，所以开机**不需要**再等几小时，
 *   这里等的只是**热平衡**（加热丝把敏感体升到工作温度、读数稳定），经验在 1~3 min。
 *   取 120 s 的理由：① 标定需要 ≥60 个样本（2 Hz → 30 s），120 s 有 4 倍余量；
 *   ② DHT11/ADC 顺带稳定；③ 再长没有收益，只会拖慢演示。
 *   ★ 若标定样本不足（例如传感器没插），到期会"拿现有样本收尾"，不会卡在预热
 *     （见 app_tasks.c 的标定收尾逻辑 + AGENTS 铁律 27）。*/
#define CFG_WARMUP_MS        120000u

/* 异常驻留时长（2026-10-09 定值）
 *   报警后在该点加密采样（5 Hz）看趋势：5 Hz × 10 s = 50 个样本，
 *   足够区分"一次性尖峰"与"持续上升"，也不至于让巡检进度明显变慢。*/
#define CFG_DWELL_MS          10000u

#define CFG_LINK_TIMEOUT_MS     500u   /* 协议 §5：500 ms 未收到下行帧 → 安全停车 */
#define CFG_TASK_TIMEOUT_MS 1800000u   /* 30 min 任务总超时 */
#define CFG_TOTAL_WAYPOINTS       4    /* 巡检点数量 */

/* 巡检点判据 = **编码器里程**（不依赖红外：底板 J11/J14 红外是 DNP、未焊排针）。
 * 相邻两点距离（mm）—— [待实测] 量出场地标线间距后只改这一处即可。
 * 置 0 = 不启用里程判据（waypointReached 恒为 0，车按指令/时间推进）。*/
#define CFG_WAYPOINT_SPACING_MM   0    /* [待实测] 例如 800（0.8 m）*/

/* ============================================================================
 * 六、PID 默认值（与厂商基线一致；未被 0x24 修改/未从 Flash 载入时生效）
 * ==========================================================================*/
#define CFG_PID_BALANCE_KP    300.0f
#define CFG_PID_BALANCE_KD      1.0f
#define CFG_PID_VELOCITY_KP    80.0f
#define CFG_PID_VELOCITY_KI     0.4f
#define CFG_PID_ZHONGZHI        1.0f
#define CFG_PID_TURN_KP        52.0f   /* 厂商 turn() 内局部常量 */
#define CFG_PID_TURN_KD         0.5f   /* 厂商：仅前后运动时取 0.5 */

/* ============================================================================
 * 七、参数持久化（Flash）
 * ==========================================================================*/
#define CFG_PARAM_FLASH_ADDR  0x08040000u  /* 扇区 6（128 KB）起始；本工程代码仅 60 KB，不会自撞 */
#define CFG_PARAM_MAGIC       0x50494431u  /* 'PID1'，用于判断 Flash 里是否已有有效参数 */

#endif /* APP_CONFIG_APP_CONFIG_H */
