pierrotto12138-code/balance-car-inspection-robot/firmware/App/Control/param_store.c

#include "param_store.h"
#include "app_config.h"
#include "board_state.h"
#include "stmflash.h"

/* 见 param_store.h：Flash 持久化（整扇区擦除 → 只在保存时调用）。
 *
 * ★ "参数表 ↔ 厂商全局量"的同步放在本文件（STM32 侧），
 *   这样 param_pack.c 保持纯逻辑、可在 PC 上单测。
 * ★ P2 结构整改（2026-10-13）：具体的厂商全局量读写委托给 `board_state.c` ——
 *   本文件不再 include `sys.h`、也不再自己碰 `Balance_Kp` 之类的全局量，
 *   App 层访问厂商状态**只有 board_state 一个出口**。 */

static ParamSet s_params;

/* 参数表 → 厂商全局量（控制中断下一拍即生效）*/
static void params_to_globals(const ParamSet *p)
{
	Board_SyncPidParams(p->balanceKp, p->balanceKd, p->velocityKp, p->velocityKi,
						p->zhongzhi, p->turnKp, p->turnKd);
}

/* 厂商全局量 → 参数表（保存时以"实际生效值"为准）*/
static void params_from_globals(ParamSet *p)
{
	Board_CapturePidParams(&p->balanceKp, &p->balanceKd, &p->velocityKp, &p->velocityKi,
							&p->zhongzhi, &p->turnKp, &p->turnKd);
}

void ParamStore_InitDefaults(void)
{
	ParamPack_Default(&s_params);
	params_to_globals(&s_params);
}

int ParamStore_Load(void)
{
	static uint32_t words[PARAM_WORDS + 4];
	ParamSet loaded;

	/* 读多几个字，便于将来扩展时保持兼容 */
	STMFLASH_Read(CFG_PARAM_FLASH_ADDR, words, PARAM_WORDS + 4);
	if (ParamPack_Unpack(words, PARAM_WORDS + 4, CFG_PARAM_MAGIC, &loaded) != 0)
	{
		return -1;                          /* 未写过或无效：保持默认值 */
	}
	s_params = loaded;
	params_to_globals(&s_params);
	return 0;
}

int ParamStore_Save(void)
{
	static uint32_t words[PARAM_WORDS + 4];

	params_from_globals(&s_params);         /* 以"实际生效值"为准保存 */
	if (ParamPack_Pack(&s_params, CFG_PARAM_MAGIC, words, PARAM_WORDS + 4) == 0)
	{
		return -1;
	}
	STMFLASH_Write(CFG_PARAM_FLASH_ADDR, words, PARAM_WORDS + 4);

	/* 回读校验：写 Flash 有失败可能，这里当场确认，避免"以为存了"。
		★ 2026-10-09 复查发现：这里原先只 `Unpack` 一次、**从未与 `s_params` 比对** ——
			等于"看起来验证了、其实没有"（正是 AGENTS 铁律 29 说的那类错）。
			现在逐字段比对，内容不一致就明确返回失败。*/
	{
		static uint32_t check[PARAM_WORDS + 4];
		ParamSet verify;
		STMFLASH_Read(CFG_PARAM_FLASH_ADDR, check, PARAM_WORDS + 4);
		if (ParamPack_Unpack(check, PARAM_WORDS + 4, CFG_PARAM_MAGIC, &verify) != 0)
		{
			return -1;
		}
		if (!ParamPack_Equal(&verify, &s_params))
		{
			return -1;                      /* 读回来的 ≠ 刚写下去的 → 报失败，别让调用方以为成功 */
		}
	}
	return 0;
}

/* ★ 2026-10-13 新增：按参数的范围校验（审计 P1，"最容易补也最该补"的一条）。
   原先 `ParamPack_Set` 只检查 ID 是否合法、**不检查数值**，而 Unpack 的合理性检查是
   `|v| < 1.0e6` —— 也就是一条**合法帧**就能把车调飞：
     · Balance_Kp = 999999 ⇒ 输出立刻打满（|bias|>0.008° 就饱和）；
     · Zhongzhi   = 180    ⇒ Turn_Off 的 ±40° 判据错乱（"倾角保护"形同虚设）。
   上界依据：① 物理可用的量级（对照厂商默认值与调参常识）；
             ② `Velocity_Ki` 的上界取 0.82 = 限幅 8200 / 积分限幅 10000
                —— 超过它，**积分一项就能把输出顶到限幅**（windup，越调越差）。*/
typedef struct { uint8_t id; float lo; float hi; } ParamRange;

static const ParamRange s_range[] = {
	{ PARAM_BALANCE_KP,    0.0f,  1500.0f },
	{ PARAM_BALANCE_KD,    0.0f,    50.0f },
	{ PARAM_VELOCITY_KP,   0.0f,   500.0f },
	{ PARAM_VELOCITY_KI,   0.0f,     0.82f },
	{ PARAM_ZHONGZHI,    -20.0f,    20.0f },
	{ PARAM_TURN_KP,    -500.0f,   500.0f },
	{ PARAM_TURN_KD,     -10.0f,    10.0f },
};

int ParamStore_SetOne(uint8_t id, float value)
{
	unsigned i;

	/* NaN 一律拒绝（NaN 与任何比较都为假，会绕过下面的区间判断）*/
	if (!(value == value))
	{
		return -2;
	}
	for (i = 0; i < sizeof(s_range) / sizeof(s_range[0]); i++)
	{
		if (s_range[i].id == id)
		{
			if (value < s_range[i].lo || value > s_range[i].hi)
			{
				return -2;      /* 越界：拒绝，且**不改动**当前生效值 */
			}
			break;
		}
	}
	if (ParamPack_Set(&s_params, id, value) != 0)
	{
		return -1;
	}
	/* 立即同步到厂商全局量：控制中断下一拍就会用到新值（对齐 float 写是原子的）*/
	params_to_globals(&s_params);
	return 0;
}

int ParamStore_GetOne(uint8_t id, float *value)
{
	return ParamPack_Get(&s_params, id, value);
}
