pierrotto12138-code/balance-car-inspection-robot/(commit log)

2026-10-09 测控系统综合设计（第1组）—— 基于平衡小车的仓储环境安全巡检机器人
    硬件
    原理图 104 元件 / 52 位号 / 65 网络；全部有封装与立创料号；DRC 致命错误 0
    PCB 523 走线段 / 76 过孔 / 双面实心 GND 铺铜；DRC 零错误、零未连接
    板框 100 x 60 mm；保留 MiniBalance V5.0 控制板，重做底板
    文档
    README.md 项目总览
    AGENTS.md 工程协作与工具链说明
    docs/handoff/ 项目交接说明
    docs/ 决策记录、硬件设计、固件架构、通信协议、调研记录
    软件
    host/ Qt 6 上位机（协议层 13 项单元测试通过）
    tools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
2026-10-10 B 阶段：固件工程（GCC+FreeRTOS）+ 程序说明文档 + 调参/上位机接口
    工程骨架（firmware/）
    - arm-none-eabi-gcc + Makefile，一条 make 产出 .hex（FlyMcu 串口 ISP 可烧）
    - 厂商 FWLIB 基线与 5ms/10ms 平衡控制中断**时序零改动**；USE_RTOS=0 提供裸机对照
    - FreeRTOS-Kernel V11.1.0 vendor 入库（heap_4，24 KB 堆）；GCC 启动文件与链接脚本按 IRQn 生成
    协议层（与 host/ 逐字段对齐）
    - CRC-16/MODBUS（含增量版）、帧编解码、SPSC 环形缓冲 + 流式解帧状态机（带 100ms 超时）
    - 与上位机三方交叉验证一致：Python 独立实现 ↔ C 侧真实代码 ↔ 固件（CRC 4 + 帧 16 + 流式 6）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
2026-10-13 仓库通用化：脚本不写死安装路径，文档去掉机器相关痕迹
    背景：仓库要能让别人克隆到任意目录、装到任意盘符后照文档直接用，
    不能带某台机器特有的安装路径与措辞。
    脚本（这是重点：换机器必须能跑）
    - 新增 fw_prep/toolchain.py：统一探测工具链，不写死任何路径
    · PC 端 C 编译器：FW_HOST_CC → PATH(gcc/cc/clang) → QTDIR 下的 MinGW
    · 交叉工具链：FW_ARM_BIN / STM32CUBECLT → PATH → 常见安装根
    · 找不到时打印可直接照抄的环境变量设置指引
    · child_env()：把编译器目录带进子进程 PATH（MinGW 的 cc1 需要同目录 DLL，
    否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
2026-10-13 修复安全停车未接到电机 + OLED 显示页/按键 + 有线调参工具 + 通用化收尾
    ★ 安全链路修复（本轮最严重的问题）
    - 复查发现 Patrol_MotorsDisabled() 的返回值**没有任何地方使用** ——
    500 ms 失联只把标志置位、**电机照转**，安全功能形同虚设
    - 修复：TaskTask 把该结果写入 volatile u8 App_MotorDisable，
    控制中断每拍据此强制 Flag_Stop=1（厂商 Turn_Off() 随即把 PWM 置 0）
    - 同时堵住两条**绕过安全锁存**的旁路：
    · 单击启停：锁存期间按键无效
    · Put_Down() 放下自动使能：锁存期间不再自动使能
    - 显式使能（0x21 任务=巡航 或 0x20 使能=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
2026-10-13 清理：核验脚本产物目录 out/ 移出版本控制并加进 .gitignore
    - tools/fw_prep/out/ 里全是脚本生成的 exe/o/elf/hex/map（约 90 个文件、几十 MB）
    - 之前只有 demo_log.txt 被误跟踪；顺手把整个目录忽略，避免以后误提交
2026-10-13 数值定稿（阈值/预热/驻留）+ 巡检点判据落地（编码器里程）+ 硬件到货
    数值定稿（决策 50，依据已写进代码注释）
    - 告警阈值保持 MQ-2 30.0 ppm / MQ-135 50.0 ppm，但补齐**为什么是这个数**：
    由 ppm = a·ratio^b 反推清洁空气本底（MQ-2 ≈ 3.6 ppm、MQ-135 ≈ 4.3 ppm），
    阈值取"本底的 8~12 倍"（太低会被香烟/清洁剂误报，太高会漏早期泄漏），
    并给出对应 ratio（3.8 / 1.34）；同时标注 MQ-135 幂律陡、对 R0 漂移更敏感
    - 预热 180 s → 120 s：老化已由用户完成，只需热平衡；标定需 ≥60 样本（2 Hz→30 s），
    120 s 是 4 倍余量；并说明"样本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
2026-10-13 补齐 A 侧交付物（BOM/电路设计说明/人机界面说明/上板自检清单）+ 修 9 项跨文档矛盾
    新增交付文档（任务书 A1/A2 提交材料）
    - docs/design_hardware/BOM表.md + hardware/bom/BOM_主底板.csv
    · 由 tools/bom_export.py 从完工快照 .epcb2 **离线导出**（位号 ↔ COMPONENT ↔ META 器件库）
    · 52 位号 / 合并 27 行 / 52 项全有立创料号（与"104 元件 52 位号"口径吻合）
    · 位号首字母分布 C21/J12/R10/D4/U3/L1/S1；CSV 带厂商与描述，可直接下单
    · 标注两处需人工复核：C18/C19（本地自建器件、厂商字段空）、D1（料号写进了器件名）
    - docs/design_hardware/电路设计说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
2026-10-13 修 OLED 页 1 档位 FAST 与页码的 2px 重叠 + 人机界面文档同步到修正后坐标
    - 排布复核发现：档位取 FAST 时 x=90..121 与页码 x=120..127 重叠 2 px
    → FAST 改 x=88（88..119），页 1 三种档位全部给页码让位
    - 独立复核脚本（按页 + 互斥分支）确认：页 1（含 DHT 无效变体）与页 2（含锁存）
    全部字段**无重叠、无越界**（最大右边界 120 px）
    - 人机界面设计说明.md：示意图改为按坐标生成、字段表同步新坐标、
    §3.6 结论更新为'已修正、无重叠'
    - 全量核验 9 项通过；38 个文档 163 条链接断链 0
2026-10-13 代码质量整改（依复查报告）：修 3 处真缺陷 + make strict + 编码规范
    真缺陷（都能被现有测试覆盖）
    - 4 个只读 getter 里只有 1 个加了临界区，与 app_api.h 的承诺不符：
    App_GetGas/GetPatrol/GetDiag 补短临界区（堆查询留在临界区外）
    - 0x14 载荷（就绪位 + ppm×10）有两套等价实现，且测试只覆盖了没人调用的那份：
    统一由 SensorReport_FillEnvGas() 计算，App_GetGas() 复用它
    - ParamStore_Save() 的"回读校验"只 Unpack、从不比对 = 假校验（与铁律 29 同型）：
    新增 ParamPack_Equal() 逐字段比对 + 5 条断言（参数打包 24 → 29 条）
    规范整改
    - 周期/超时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
2026-10-13 P2 结构整改：厂商量单一出口 + 打破 delay→App 反向依赖 + 清死代码
    结构（P2）
    - 新增 App/Board/board_state.{h,c}：App 层访问厂商全局量的唯一出口
    Board_ReadRaw（内部短临界区取一致快照）/ Board_Read|WriteVendorStop /
    Board_Sync|CapturePidParams；app_tasks.c 与 param_store.c 不再直接读写厂商量
    - System/delay 改回调注入 Delay_SetMsHook()：delay.c 不再 extern App_*，
    依赖方向恢复单向 App→System；App_Start 在 vTaskStartScheduler 前一行注入
    - 统一使能真相：App_MotorDisable 权威、Flag_Stop 仅执行器（仅 control.c 与
    board_state.c 会写它）
    清理（P1 收尾）
    - 删死代码 Param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
2026-10-13 P3 排版统一：头文件守卫规范化 + 空白规范化器 + .clang-format
    守卫（决策 54）
    - 46 个头文件守卫 __XXX_H → 模块前缀_文件名_H（APP_/BSP_/SYS_）
    修掉真实隐患：App/Sensor/MPU6050/mpu6050.h 与 System/usart/usart.h 历史上
    同名 __USART_H，后 include 的头文件会被整体静默跳过
    - User/stm32f4xx* 属 ST 官方文件保持原样；厂商目录（FWLIB/CMSIS/Middlewares/
    DMP/DataScope）零改动
    空白规范化（新增工具）
    - tools/fw_prep/normalize_whitespace.py：行尾统一 LF + 去尾随空白 +
    混合缩进折算（Tab 数 + ceil(空格数/4)，纯空格缩进行保留）
    - 作用域由脚本内白名单硬限定；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
2026-10-13 .clang-format：按 clang-format 23 实测校准配置（只改配置文件，不动源码）
    背景：本机原来没有 clang-format，本轮把它装上了（pip 包 clang-format 23.1.3，
    用户级安装，路径 %APPDATA%\Python\Python313\Scripts\clang-format.exe），
    然后用实测把配置逐项校准到"本项目既有风格 + 零无谓 diff"。
    实测踩到的三个坑（都写进配置文件注释了）：
    1. clang-format 20.x 起键名有变更：EndOfLine → LineEnding；
    KeepEmptyLinesAtTheStartOfBlocks 已不存在。原配置会直接报错拒绝加载。
    2. BreakBeforeBraces: Allman 在 20.x 起不再等于"函数大括号另起一行"，
    必须用 Custom + BraceWra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
2026-10-13 4.3：厂商类型泄漏收尾（app_tasks 不再依赖 sys.h）
    - board_state 新增 Board_LedSet()：把厂商位带宏 LED（PB13，低电平点亮）包成
    on/off 语义，业务代码不必记极性；厂商 Led_Flash() 的中断闪烁逻辑不受影响
    - app_tasks.c 去掉最后一个厂商依赖：LED = 1 → Board_LedSet(1)，
    App_MotorDisable 由 u8 改为 uint8_t（control.c 侧签名仍写 u8，同类型兼容），
    并删除 #include "sys.h"
    - 至此 App 层（Task/Board/Comms/Sensor/Control/Ui）对厂商全局量、类型与位带宏
    的访问全部收敛到 App/Board/board_state.{h,c}
    - 未动 control.h / pages.h 里的 u8：那是厂商函数签名（Turn_Off/Get_Angl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
2026-10-13 文档对齐（4.4）：把实测数据与结构变更同步到全仓文档
    起因：P0~P3 的代码规整化改变了资源占用与模块结构，但若干文档仍写着旧数字/旧结构。
    本轮做了一轮机械扫描 + 逐条更正，**只改文档，未动任何源码**。
    机械扫描结果：
    - 全仓 39 个 md 的**相对链接断链 0 处**（扫描脚本覆盖 http/# 之外的本地链接）
    - 陈旧符号引用（ParamStore_Current / Buzzer_IsOn / App_SchedulerRunning / App_DelayMs /
    __USART_H / "每字符 6 px"）仅剩**历史说明与事故对照**中的刻意引用，均已确认是有意保留
    本轮更正（6 个文件）：
    1. firmware/README.md：构建实测 64,9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
2026-10-13 收尾子代理未完成的编辑器工具链改动 + 修一个真回归（默认构建目标被改掉）
    ★ 修回归（本轮最要紧）
    - 未提交的半成品把 compile_commands 目标插在 all 之前，而 Make 的默认目标是
    "文件里第一个目标" → 裸跑 make 变成只生成 JSON、**不再构建固件**（不报错、很隐蔽）
    - 修法：加 .DEFAULT_GOAL := all 兜底，并把该目标移到 all 之后；
    实测恢复：make → Flash 65,724 B / RAM 32,816 B；make USE_RTOS=0 → 49,196 B / 5,176 B
    修 gen_compile_commands.py 的正则（原本抓不到任何命令）
    - 原正则 `-c\s+\S+\.c` 与 Makefile 实际写法不符（$(CC) -c $(CFLAGS) $<，-c 后面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
2026-10-13 格式规范定稿 + 快照精简 + 编辑器配置共享（按用户决定收尾）
    格式规范（决策 55：不执行 .clang-format）
    - .clang-format 从"风格单一真相"降级为**参考配置（未强制执行）**，写明不跑全量格式化的两条理由
    （会把真实逻辑改动淹没在格式 diff 里；控制代码刚调好、正处答辩期）
    - 编码规范 §5.1 新增"实际执行的格式规范"表：能机器保证的（LF/去尾随空白/末尾换行/混合缩进
    → 已由 normalize_whitespace.py 落地并幂等）标 ✅；需要审美判断的（行宽、括号前空格、
    include 排序）明确标"不强制、不做"；Tab 缩进与 Allman 大括号标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
2026-10-13 C 侧事宜定稿（协议 v1.1 冻结）+ 安全通道事件码 + C 部分调研与计划
    一、C 侧悬置事项由 B 代拟会签并定稿（决策 57）
    - 协议升为 v1.1 冻结版，C 侧据此开发，不再阻塞
    - 0x24 的 4 个扩展 ID（0xFF 全量回读 / 0x00 保存 / 0xFE 载入 / 0xFD 100 Hz 观测）会签通过：
    它们是向后兼容的纯增量（上位机不认识也能不发），已实现、已进冻结向量，不值得为它卡开发
    - 新增协议 §七「给上位机的显示约定」10 条：ppm×10 必须 /10、姿态 0.01°、0x11 的 N=9、
    PWM 千分比、float32 小端、双链路用法（应答回请求链路）、心跳可用任意下行帧、
    0x12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
2026-10-13 C 部分 P0（通信链路）完成：io 层 + 通信诊断面板 + 假源回放
    新增 io 层（host/src/io/，只依赖 Qt6::Core + SerialPort，可被无界面单测直接驱动）
    - link.h/.cpp：LinkBase 抽象（帧/原始字节/状态/统计四类信号）+ LinkKind/LinkState/LinkStats
    - serial_link.h/.cpp：QSerialPort + **工作线程阻塞读**（照 Qt 官方 Blocking Receiver 范式）
    · 解帧在工作线程里做，界面只收成品帧；跨线程只传值类型
    · 发送走"互斥锁 + 写队列"，由读循环每轮取走（读循环阻塞，排队调用送不进来）
    · 出错自动重连（可配间隔），统计含重连次数
    - replay_link.h/.cpp：假源/回放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
2026-10-13 P0 界面可用性修复（截图发现的三处真问题）+ 演示模式
    一、--demo 演示模式（新增）
    - `host.exe --demo`：两条链路都切假源并自动连接，打开就有数据在跑
    （板子没到、答辩现场硬件故障时的应急预案，见 C 部分方案与计划 §八）
    - `--selftest N`：无界面自检（已有），退出码 0/1
    二、截图后发现并修掉的三处真问题
    1. **--demo 无效**：P0Panel 构造时用下拉框默认值（第 0 项=真实串口）反向覆盖了
    main() 里设好的假源模式 → 启动即报"错误 未选择串口"。
    修法：下拉框初值**取自 LinkManager 当前模式**（单一来源），再连信号。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
2026-10-13 C 侧交互功能吸收：对照厂商 PC 波形工具 + 手机 App（含 v1.0 源码）确认协议并并入 12 项功能
    来源与仓库卫生
    - v1.0 App 源码（用户提供）解到**仓库外** ..\260921Task_私有资料\vendor_ref\MiniBalanceV1_app\
    第三方源码不入公开仓库（已核验 git ls-files 无 BalanceV1/.apk/.rar）
    - 只看协议与功能，不搬代码、不抄观感
    从源码确认的事实（可直接依赖）
    - 手机 App 用**经典蓝牙 SPP**（UUID 00001101-…）→ 与 J7 上的透传模块天然匹配，不需要 BLE
    - 遥控协议：摇杆 8 方向 = 单字节 'A'~'H'；**松手/回中 = 'Z'**；自定义键 = 'J'/'K'；另有文本透传（聊天框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
2026-10-15 调试前修 3 处会误导判读的缺陷（测 DHT11 前必须先清掉）
    1) tune.py 的 ENV 显示不区分「未就绪」与「真实 0 值」
    固件在 DHT11 / 气体读不到时发的是 0，原显示成 'T 0.0C H 0.0%'，看起来像"0 度"
    现按 0x14 就绪位分别显示：bit0 MQ-2 / bit1 MQ-135 / bit2 DHT11 / bit3 补偿
    → 未就绪显示 'T/H N/A（DHT11 未就绪）'、未标定显示 '未标定'，并打印就绪位与补偿状态
    2) tune.py --replay 的格式识别把空格分隔的 hex 当二进制 → 解析出 0 帧
    原正则要求 6 个连续 hex 字符，而本项目普遍用 'AA 55 14 10 …' 写法（连续最多 2 个）
    → 改为「去掉注释与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
2026-10-15 真机联调第一轮：修 4 处真缺陷 + 协议 v1.2 诊断帧（让"看不见的"变成可测）
    一、修掉的 4 处真缺陷（都来自首次上板实测）
    1) ★ 低压误触发 → 车根本不能平衡（最严重）
    原判据 `电压>0 且 <11.10V`：分压网络悬空时拾到的**几毫伏噪声**被当成"电池 0.x V"，
    于是上电即误判硬件故障 → 状态机进 FAULT 并锁存 → `Turn_Off()` 恒返回 1 →
    厂商主循环里的 `Set_pwm()` **永远不会被调用** → 电机完全没有输出（现象：stage=FAULT、
    fault=0x04、怎么调都不动）。
    改为三级判据：先过"有电池"门槛（>6.00 V，3S 锂电远高于此、悬空噪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
2026-10-15 全量正确性审计（三路独立）+ 修 3 处真缺陷 + 汇总问题清单
    一、为什么要做这一轮
    用户指出："既然查出错误了，那就全量检查一下代码，别光顾着规范、把正确性减少了。"
    于是派了三路**互相独立、只读**的审计（厂商文件差异 / 自研代码正确性 / 按上板症状反推），
    要求每条结论都带 文件:行 与证据、并明确区分"会炸 / 会错 / 隐患"，不采信彼此结论。
    二、审计纠正了我此前两个说法（记录在案，避免以讹传讹）
    1) 厂商基线是「库函数版（卡尔曼滤波版）」而非 DMP 版：
    Way_Angle=2、Zhongzhi=1、stmflash 的 0X08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
2026-10-15 修 OLED 换页残影（用户实测：第三页像两页重合）
    现象与机理：厂商 oled_show() 只覆盖它自己固定坐标的字段、从不整屏清，
    而自研页 1/2 用的 x/y 与它不同 → 从自研页切回厂商页时，厂商页没写到
    的地方留着上一页的残字，看起来就是两页重合。
    修法：把清屏放在 ui_task 里、**只在换页那一拍**做（s_lastPage 标记），
    并从 Pages_Show() 去掉每拍清屏 —— 放 Pages_Next() 不行：它在控制中断里被调用，
    整屏软 SPI 刷新要 1~2 ms，会拖坏 5 ms 控制节拍；每拍清屏则会 10 Hz 闪烁。
    实机 0x15 诊断帧同时确认：电压 11.85V / DHT11 有效（中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
2026-10-15 加蓝牙/串口端口自动识别脚本；决策 61：该能力列为上位机 P1 必备
    bt_scan.py：Windows 蓝牙 SPP 口号随机、描述不可信，
    判据改为『这个口上有没有 CRC 通过的整帧』；显式驱动 DTR=高/RTS=低（陷阱 33）。
    修正处：帧格式是 AA 55|cmd|len(2,LE)|data|crc(2,LE)，CRC 覆盖 cmd+len+data ——
    我先前把 byte2 当长度、把 AA55 算进 CRC，导致『帧头一堆、合法帧 0』。
    实测：COM3 识别为我们的设备；当前只有 COM3（蓝牙未配对）。
2026-10-15 加蓝牙工具：bt_scan.py（按合法帧识别端口）+ bt_at.py（AT 配置，自动探波特率与方言）
    bt_scan.py：Windows 蓝牙 SPP 口号随机、描述不可信，判据改为『这个口上有没有 CRC 通过的整帧』；
    显式驱动 DTR=高/RTS=低（陷阱 33）。修正处：帧格式是 AA 55|cmd|len(2,LE)|data|crc(2,LE)，
    CRC 覆盖 cmd+len+data —— 先前我按 byte2=len、CRC 含头来算，导致『帧头一堆、合法帧 0』。
    bt_at.py：自动探 AT 波特率并试老式/新式两种方言，改完回读确认。
    实测该模块为老式 HC-06 方言（AT+NAME<x>/AT+PIN<x>），已定名 PierrotBalance、密码 6667、通信波特率 115200
    （与固件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
2026-10-15 修 B1：气体 R0 标定接受无效样本 → 通道失效却报出'看着合理'的假 ppm
    真机坐实：J10 未插模块（raw=1~2，AO≈0），上位机却报 17~24 ppm。
    机理：Rs=(VCC·RL)/Vao−RL 在 Vao→0 时得到极大值 → r0 是个大数 → 比值/ppm 看着合理。
    修法（gas.c）：
    · Gas_CalibrateAdd 拒绝三类物理上不可能的样本：近零(vao<50mV / raw<=20)、
    饱和(raw>=4080)、Rs 无意义(<=0) —— 不计入也不增加 r0Count；
    · Gas_CalibrateFinish 在样本全无效时把 r0 明确置 0，
    使 sensor_report 的就绪位判据(r0>0)自然为假 → 不上报'就绪+ppm'。
    原则：判据不是'有没有读数'，而是'读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
2026-10-15 文档：标注当前台架配置（只有 MQ-135 挂 J13、J10 空、MQ-2 待补）
    - 真机联调问题清单.md 新增 §6：气体通道现状、DHT11/蓝牙/电压状态、
    以及读数解释提醒（在 MQ-2 装回 J10 前，上位机名为 MQ2 的那一路才是真在工作的）
    - 记录 J10/J13 四脚电气相同、插错座不损坏，只是名字对不上
2026-10-15 修 A5：Turn_Off 的低压判据由瞬时改为迟滞+连续确认（平衡直接相关）
    问题：Turn_Off() 每拍读的 Voltage 是每 100 拍(0.5s)才更新一次的均值，
    且原判据 voltage<1110 无迟滞、无连续确认 → 一旦均值落到 1110 以下，
    接下来 0.5 s 内 Set_pwm() 整段不被调用、方向脚清零 → 电机 0.5 s 完全无力矩，
    电压回升又立刻恢复 → 平衡车周期性抽搐（"能平衡却莫名摔倒"的典型成因）。
    改法：低于 11.10V 需连续 50 拍(0.25s)才锁存；回升到 11.60V 以上才解除（0.5V 迟滞）。
    状态机放在 Turn_Off 内：它是中断每拍的执行端，低压必须在这层生效才真关得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
2026-10-15 修 P0（平衡审查结论："只改一处"就选它）：速度环积分状态清理时机
    三件事叠在一起，机理是"速度环积分满幅 K_i×10000 = 4000 PWM，而平衡环 P 项 1° 才 300 PWM"
    —— 积分一旦朝错误方向饱和，平衡环整个工作范围都扳不回来（"速度环一调大就必摔"的根因）：
    ① 顺序错：原来只在函数末尾 if(Turn_Off()||Flag_Stop) Encoder_Integral=0 清零，
    而这一拍在此之前**已经用旧积分算过 Velocity**（先用了再清）。
    ② Encoder / Encoder_Least 从不清零：停机期间挪过轮子后重新使能，第一拍按"停机前的
    滤波速度"出力 → 起步抽一下（现场极易误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
2026-10-15 按当前接线翻电机方向（修"上电后试图摔倒而不是平衡"）
    现象机理：平衡环算出该往哪边驱动之后，若两轮实际转向与固件约定相反，修正就变成正反馈
    → 车不是站住而是加速倒下（并且控制器直接打满，看起来"太猛烈"）。
    改法：新增 CFG_MOTOR_DIR_INVERT（app_config.h，当前=1），在真正调用 Set_Pwm 处翻两轮。
    为什么在调用处而不是 Set_Pwm 内部：三环计算值（上报给上位机调参用）仍保持固件约定语义，
    只有执行端翻向，调参时看到的正负号不会被这层翻转搞混。
    为什么只翻两轮就够：前进/后退是共模量（取反即翻向），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
2026-10-15 加编码器方向开关（翻电机后仍"奔着跌倒去"，指向第二路独立符号）
    机理：本项目速度环是"正反馈"结构（厂商注释：速度反馈是正反馈，快的时候要慢下来就得再跑快一点），
    它的符号取决于**编码器极性**；而平衡环的符号取决于**电机极性**。两路独立 ——
    翻电机方向会同时改变速度环的等效反馈方向，所以必须分别确认，不能靠"翻一个试试"。
    新增：CFG_ENCODER_DIR_INVERT（app_config.h，当前=0），在读编码器处翻向；
    判据不用烧录就能测：用车**用手往前推**，看 0x11 的 spd L/R 应为**正**，为负则置 1。
    验证：Flash 65,632 B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
2026-10-15 按倾斜实测把电机方向改回 0（上次翻向翻错了）
    真机判据：车向前倾倒时，轮子必须**往前追**（去把重心追回来）；用户实测"前倾时轮子把车往后送"
    ⇒ 置 CFG_MOTOR_DIR_INVERT=1 时仍是反的 ⇒ 回到 0。
    教训（写进注释）：电机方向的唯一可靠判据是倾斜测试，不能凭"感觉反了"就翻 ——
    翻错一次会同时改变速度环的等效反馈方向，白烧一轮固件。
2026-10-15 按真机数据把方向控制改成**分侧**开关（两轮在前后倾时"原地对拧"）
    实测证据（tools/fw_prep/out/tilt.log）：前后倾时 spd L 与 spd R 幅值几乎相等、符号永远相反
    （前倾 -115/+115，后倾 +484/-485）。平衡车前倾时两轮应**同向往前追**，现在是原地对拧
    ⇒ 车只会扭转、重心继续倒 —— 这正是"奔着跌倒去"的根源。
    它不是"整体符号翻一个"的问题，而是**左右两侧彼此不一致**（一侧电机或编码器相对另一侧接反）。
    （左右压/转向时两轮反向是正常的，所以问题只在共模动作上。）
    改动：CFG_MOTOR_DIR_INVERT → 分侧 CFG_MOTOR_LEFT/RIGHT_INV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
2026-10-15 按真机二次判据定案：翻左侧电机、右侧回 0（唯一解）
    推导（纯逻辑，不再试）：
    初始(0,0) 两轮反向 ⇒ 两侧物理极性恰好一个是反的；
    试(0,1) 变成"同向但整体反"（情况 3）⇒ 反的是**左侧**，翻右侧等于把两侧一起弄反了；
    ⇒ 唯一解 (1,0)。
    此后固件正命令 → 两轮物理同向且为"前" ⇒ 前倾时轮子往前追，可以开始平衡。
    验证：Flash 65,632 B；make strict 0 条。
2026-10-15 工具修复：tune.py 打开串口加重试退避（Windows 句柄释放延迟）
    现象：同一条命令里连续调用 tune.py（--set 后接着 --monitor）会抛
    PermissionError(13) 拒绝访问 —— Windows 在关闭句柄后有短暂释放延迟。
    这会让"在线调参 + 立刻回读"这类连续操作随机失败。
    改法：open_port 里对 Serial(...) 重试 12 次 × 0.3 s，仍失败则明确提示
    "端口被占用：请关掉 FlyMcu / 串口助手 / 其它监视窗口"。
    验证：连续三次调用（--set 3=0 / --set 4=0 / --monitor）全部成功。
    同时确认了一条真机结论：拔掉 J13（空插座）后 fault 由 0x02 归零、stage 回到 WARMUP
    —— 证实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
2026-10-15 方向定案（第三次、且这次是唯一变量下的判据）：左=0 / 右=1
    推理链（每次只动一个变量）：
    1) 初始(0,0)：两轮**反向** ⇒ 两侧物理极性恰好一个是反的。
    2) 速度环开着时试(0,1)：表现为"同向但整体反"(当时称之为情况 3) ——
    但那次是**速度环失控掩盖了平衡环的真实符号**，不能作为判据。
    3) 把速度环在线摘掉(Velocity_Kp=Ki=0，不烧录)后试(1,0)：
    两轮**同向但向后** ⇒ 共模方向反 ⇒ 两侧需一起翻。
    4) ⇒ 解 = (左=0, 右=1)：相对一致性保持（两侧各翻一次）、共模翻正。
    预期：前倾时两轮同向**往前追**。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
2026-10-15 新增上行 0x16 三环实况（把"靠现象猜"变成"看数字判"）
    为什么必须做（今天反复绕圈的真实原因）：调平衡时唯一可见的现象是"轮子往哪转"，
    而 Balance_Pwm/Velocity_Pwm/Turn_Pwm 三个分量**固件里没有任何上报**，0x11.pwm 报的
    还是 (Moto1+Moto2)/2（±Turn 在求和时互相抵消），**实际输出(CCR)也没有**。
    于是"速度环 13 倍权重掩盖平衡环"这类问题在现象层无法区分，只能反复"翻一个试试"。
    本帧（N=20，1 Hz，新增命令、不改任何已有帧）：三分量 + Moto1/Moto2 +
    **真实 CCR(TIM1->CCR4/CCR1)** + 编码器原始计数 + 状态位（Flag_Stop /
    App_MotorDisable / **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
2026-10-15 按编码器推车判据定案：只翻左侧编码器，撤回两次电机翻转
    证据（0x16 实况 + 手推测试）：
    · 手推前进时 Enc L=-6.8 / Enc R=+6.9 ⇒ **左侧编码器极性反**（右侧正为基准）
    · 0x16 显示 CCR = 1.17×|Moto| 完全吻合、状态位"本拍调了Set_pwm" ⇒ 之前"往后蹬"是**编码器反导致速度环瞎 + 转向环反**，不是电机方向问题
    ⇒ 最终配置：CFG_ENCODER_LEFT_INVERT=1，其余三个都回 0。
    复盘（为什么白翻三次）：最早那次"两轮反向"的观测来自 spd（=编码器读数），
    本质是编码器极性不一致，却当成电机方向问题去翻 —— 用电机补编码器的错，越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
2026-10-15 修 0x16 之后的开关嵌套 bug：分侧编码器开关被外层旧开关编译掉了
    现象：把手推前进判据的结论（左侧编码器反）写进 CFG_ENCODER_LEFT_INVERT=1 后，
    0x16 里 Enc 仍 100% 反号 —— 翻了一侧却完全没生效。
    根因：上一轮把"整体翻向"改成"分侧"时，分侧开关被嵌在旧的
    #if CFG_ENCODER_DIR_INVERT（=0）里 ⇒ **整段被预处理掉**。
    修复：去掉外层旧开关，两个分侧开关互不嵌套；修的过程中脚本误删内层 #endif
    导致 #if 未闭合（编译立刻报错），已一并修正并重新编译通过。
    教训（写进提交说明）：**开关不要套开关** —— 条件编译嵌套时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
2026-10-15 ★★ 根因定案：control.c 没包含 app_config.h，导致所有 CFG_* 开关静默失效
    今晚一直"翻了方向却没变化""确定烧的是最新版"的真正原因：
    control.c 的 include 列表里**没有 app_config.h**，也没有任何它包含的头间接包含
    ⇒ 该文件里 CFG_ENCODER_LEFT/RIGHT_INVERT、CFG_MOTOR_LEFT/RIGHT_INVERT
    在预处理时全部按"未定义 = 0"处理
    ⇒ 所有 #if CFG_xxx 块**整段被跳过**
    ⇒ **开关写什么值都不生效，而运行现象上完全看不出来**。
    （只有 A5 的低压迟滞生效了，因为那处阈值我写成了字面量、不依赖宏 —— 纯属幸运。）
    证据（权威判据 = 预处理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
2026-10-15 上位机开工前的接口补齐三件（版本字节 / 0x24 范围校验 / A1 运动链路）
    ① 固件版本字节（0x16 偏移 19，不动帧长）
    取值 (月<<4)|日（本版 0xAF = 10 月 15 日），定义在 app_config.h 的 CFG_FW_BUILD_ID。
    动机：今晚"到底烧没烧上"扯皮一整轮（工具读到的现象与用户以为的版本不符）；
    有了它，上位机/工具一读即知板上版本 —— 可验证性的基础设施。tune.py 已显示该字节。
    ② 0x24 参数范围校验（审计 P1，"最容易补也最该补"）
    原先只校验 ID、不校验数值（Unpack 的门槛是 |v|<1e6）⇒ 一条合法帧就能把车调飞。
    现按参数给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
2026-10-15 上电跑飞的两条原因 + 处置（编码器成对翻转 + 调试期关速度环）
    现象：烧入含"编码器极性修复"的固件后，一上电两个轮子就以 ±90 左右持续跑。
    原因（两件事叠加）：
    ① **厂商设计本就会自动启动**：Put_Down() 在控制中断里每拍都跑，只要车平放、轮子不动
    就 Flag_Stop=0（"放下了就启动电机"）⇒ 上电后几拍内电机自动使能，不是新 bug。
    ② **编码器修复让速度环第一次"看得见"速度**，而"电机符号 × 编码器符号"的乘积此前
    从未被验证 ⇒ 乘积是反的 ⇒ 速度环成为正反馈 ⇒ 车轮越跑越快。
    ★ 因此"跑飞"恰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
2026-10-15 文档同步：第二轮真机联调结论（2026-10-15）
    · 决策记录：新增 62（条件编译开关静默失效的根因与铁律）、63（方向类问题的正确解法与顺序）、
    64（上位机开工前的接口补齐）；编号 1~64 连续无缺。
    · 真机联调问题清单：新增 §7（R1~R4 根因与证据、可观测性设施、当晚状态与下一步判据、
    给上位机的 6 条同步清单）。
    · AGENTS：新增铁律 36（方向类问题：先确认观测量来源 → 摘无关环 → 一次只动一个符号），
    铁律 35/36 顺序已整理，决策编号更新为 64。
2026-10-15 C-P1(1/3)：domain 层落地（单位换算/帧解析/状态聚合）+ 假源补齐 0x13/0x15/0x16
    - domain/units：协议定点量的**唯一**换算与格式化处（ppm×10、0.01°、0.01V、千分比），
    定小数位 + 消负零（数值跳动不抖列）
    - domain/frames：8 类上行帧结构体 + 精确长度校验的解析 + 名称表；
    新增 0x15 诊断、0x16 三环实况（协议 v1.2 增量），事件码补 0x08/0x09/0x0A
    - domain/vehicle_state：多链路合并（值取最新、来源可查）、每链路帧计数与新鲜度、
    格式错帧/协议外命令计数、低压判定（11.10 V 报警线）、安全锁存（0x08/0x0A 置位、
    0x09 或 0x15 bit1 解除）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
2026-10-15 翻电机成对（平衡环方向反 → 成对翻一次；此时速度环已摘、不受影响）
    现象：速度环由编译期开关摘掉后做倾斜测试，车轮动作与倾角的关系是**反的**
    （+ 时向后、- 时向前）⇒ 平衡环的作用方向反 ⇒ 按"电机符号 × 角度约定"这一对，翻**电机成对**。
    为什么此刻翻最安全：速度环反馈极性 = 电机符号 × 编码器符号，翻电机会**同时**影响它；
    但当前 CFG_DEBUG_DISABLE_VELOCITY=1（速度环已摘）⇒ 现在只动平衡环这一个符号，变量唯一。
    顺序（一次只动一个符号）：
    ①（本次）电机成对翻 → 倾斜应"往前追"；
    ② 确认后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
2026-10-15 修我引入的回归：裸机对照版编不过（g_pwmApplied 定义落在条件块里）
    问题：control.c 里 g_pwmApplied（0x16 的"本拍是否真的调了 Set_pwm"断言位）的**定义**
    被我放进了 #ifdef USE_FREERTOS 块内（当时以 App_MotorDisable 的 extern 为锚点，
    而那个位置正好在条件块里）⇒ make USE_RTOS=0 只剩引用没有定义 ⇒ 编不过。
    影响：**"先烧裸机版对照"是本项目排查时序问题的标准退路**（上板自检清单 §3.3），被自己弄断。
    修法：把定义提到**无条件**位置（紧跟 app_config.h 之后）。
    规则（已写进代码注释）：**被两种构建共用的全局量，定义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
2026-10-15 修"原地转圈"：转向环极性单独可翻（+ 放宽 0x24 范围允许负增益）
    现象：修好速度环（翻编码器对）之后，电机一转就"原地转圈"。
    根因（我的疏漏）：**速度环与转向环共用同一对编码器** —— 速度环用"和"(Enc_L+Enc_R)、
    转向环用"差"(Enc_L−Enc_R)。我为了修速度环的正反馈翻了"编码器对"，
    这在修正速度环极性的同时**把转向环也翻反了** ⇒ 偏航正反馈 ⇒ 原地转圈。
    （这也解释了此前"不使能也在转"：只要电机在转，转向环就在自己转圈。）
    教训：**共用的观测量，改它之前要把所有使用它的环都过一遍**（速度环"和"、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
2026-10-15 按用户要求撤回方向类开关（回到厂商电气约定）
    背景：用户反馈"接上 PC 两个模式都在转圈"，要求撤回本轮方向改动。
    撤回内容（全部置 0）：CFG_MOTOR_LEFT/RIGHT_INVERT、CFG_ENCODER_LEFT/RIGHT_INVERT、CFG_TURN_INVERT。
    保留 CFG_DEBUG_DISABLE_VELOCITY=1（这是**安全**方向：摘掉速度环可避免一使能就跑飞）。
    澄清（重要，避免误判成本轮改动）：**接上 PC 时 MCU 会被 DTR 复位**
    （本板 CH340 的 DTR 接复位，见 AGENTS 陷阱 33），复位后厂商 Put_Down() 每拍都跑，
    车平放即 Flag_Stop=0 **自动使能电机** ⇒ 若环的极性/增益不对，一连 PC 就会自己转。
    因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
2026-10-15 C-P1 文档与截图收尾：P1 完成记录、真机实测发现、决策 65/66
    §十三 记录 P1 证据（ctest 4/4、假源自检退出码 0、真机 --probe 解帧 375/丢帧 0/格式错帧 0）与两条待 B 确认的实测现象（上行速率≈15.3 Hz；0x15 电压 4.16 V），并记下本轮踩到的坑（排队信号退出、数值牌裁字、QStringList 误导报错）。README 补 P1 用法/纪律/验收步骤；决策记录新增 65（domain 唯一口径 + 界面三条纪律）、66（假源必须覆盖全部帧与安全剧本）；重出两张界面截图（暗色主题）。
2026-10-15 恢复"能平衡的那一版"开关组合 + 修转向环 + USER 键停得住（用户要求，不回滚）
    用户反馈与要求：
    · 上一版（f5eda91 的开关组合）**能平衡**，我按"撤回"改成的全 0 版**不能平衡** ⇒ 恢复；
    · USER 键要恢复正常（停得住）；
    · 平衡后总有**向后倒的趋势**（平衡指水平角 0）。
    ① 恢复能平衡的开关组合（= f5eda91）：
    CFG_MOTOR_LEFT/RIGHT_INVERT = 1,1 （平衡环作用方向）
    CFG_ENCODER_LEFT/RIGHT_INVERT = 0,1 （速度环反馈极性）
    CFG_DEBUG_DISABLE_VELOCITY = 1 （先只留平衡环，安全）
    ② 新增并置 CFG_TURN_INVERT = 1：**单独翻转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
2026-10-15 强制出厂增益覆盖（调试期），彻底消除"转圈"
    为什么必须这样做（用户质问"为什么不早这么做"，我的方法错误）：
    远程写 0x24 **今晚多次被拒/无回显**，而每次复位或重连 PC 都会从 Flash 重新载入参数
    ⇒ 远程改动被抹掉、转圈反复出现，白耗了用户好几轮烧录。
    正确做法本该第一次写入失败时就切换到"编译期出厂值"。
    做法：新增 CFG_DEBUG_PARAM_OVERRIDE + CFG_OVR_* 四个增益，在 ParamStore_Load() 之后
    强制覆盖（无论 Flash 里存什么）⇒ 烧一次即长期有效：
    Velocity_Kp/Ki = 0（不跑飞）、Turn_Kp/Kd = 0（**无转向权限 ⇒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
2026-10-15 ★★ 紧急修正我引入的严重缺陷：裸 if 未加花括号 ⇒ 停车保护被绕过 + 原地转圈
    现场（control.c 主循环）：
    if(Turn_Off(Angle_Balance,Voltage)==0) ← 裸 if，没有花括号
    Moto1 = -Moto1; ← 只有这一句受 if 保护
    Moto2 = -Moto2; ← 无条件执行
    Set_Pwm(Moto1,Moto2); ← 无条件执行
    两个后果（今晚的现象全部由此解释）：
    ① **原地转圈**：`Flag_Stop=1`（未使能）时 Turn_Off()==1 ⇒ Moto1 不翻、Moto2 翻，
    且 Set_Pwm 仍被调用 ⇒ 两轮拿到**相反命令** ⇒ 疯狂转圈。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
2026-10-15 恢复速度环（七参数出厂值覆盖）+ 记录"裸 if"铁律
    用户怀疑"重心偏后"，并同意恢复速度环。判断：**重心偏后正是"平衡后向后倒"的典型原因**，
    而抑制它的正确手段就是速度环（车会朝重心方向的反方向持续出力，把位置拉回）——
    所以本轮把七个参数全部做成**出厂值覆盖**（一次烧录、长期有效，摆脱被拒的远程写）：
    Balance_Kp/Kd = 300 / 1（厂商默认；若过冲大先加 Kd：1→1.5）
    Velocity_Kp/Ki = 80 / 0.4（★ 本轮恢复，抑制漂移；若一使能就跑飞 ⇒ 改 -80 / -0.4）
    Zhongzhi = 1（角度中值；若仍有残余偏移，可 ±0.3~0.5 试）
    T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
2026-10-15 速度环改负增益（用户反馈：开速度环后"越跑越快然后摔倒"）
    现象与判断：
    · 速度环 OFF 时：只会缓慢向后漂（重心偏后的典型表现），不会跑飞；
    · 速度环 ON （+80/+0.4）时：倾角稍大就"越跑越快然后摔倒"。
    ⇒ 跑飞来自速度环；而速度环是厂商明确的"正反馈结构"（注释原文：速度反馈是正反馈），
    因此**极性反**是第一嫌疑。本次把出厂值改为 -80 / -0.4 验证。
    （若仍跑飞 ⇒ 说明极性本来就对、跑飞是积分饱和 windup：下一步把 Ki 置 0、Kp 减半。）
    同时保留：Balance 300/1、Zhongzhi 1、Turn 0/0（不转圈）；花括号修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
2026-10-15 C-P2：曲线与告警（QCustomPlot 内置 + alarm 迟滞 + 事件流）+ 跨链路去重修正
    domain/alarm：连续确认(默认3帧)+迟滞(气体回差0.9、低压11.10→11.40)+状态跃变才报；低压方向显式声明(lowIsBad)，修掉'高=坏'写死导致低压保护静默失效。data/event_log：0x13 与本机告警同轴，0x0A/0x08→0x09 成对给出停车时长。ui：third_party/qcustomplot(2.1.1, 未改动, 只对本目标关告警)+scope_plot(唯一封装)+curve_panel(四张通道独立曲线:阈值线/告警标记/十字定标/缩放/暂停/末端读数)+event_panel(过滤+量化统计)；主窗五页导航、F11 截图、空格暂停、窗口置顶、假源水印。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
2026-10-15 Zhongzhi 1.0 → 2.0（针对"平衡稳当但持续向后倒"）
    用户反馈：上一版（速度环 -80/-0.4）**能稳当平衡**，但仍有向后倒趋势 ⇒ 建议调 Zhongzhi。
    USB 未插（COM3 不存在），远程 0x24 不可用 ⇒ 走编译期出厂值（一次烧录）。
    机理说明（为什么 Zhongzhi 正是这个旋钮）：
    重心在轮轴**后方** ⇒ 无外力时车向后倾；
    要"站住不动"，必须让重心落到轮轴正上方 ⇒ 车需要**保持一个前倾角 θ**，
    而固件正是"让倾角收敛到 Zhongzhi" ⇒ **把 Zhongzhi 设为该 θ** 即可消除后漂。
    （这就是"重心偏后"在软件上的正确补偿方式；纯机械前移当然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
2026-10-15 Zhongzhi 2.0 → 0.0（2.0 使后漂加重 ⇒ 反方向调）
    用户实测：2.0 比 1.0 **加重**（后漂更明显）⇒ 说明 Zhongzhi 增大是错方向，
    本次回到 0.0（与上一次相同的 1° 步长，便于对比判断）。
    若 0.0 仍然后漂，继续往负值走（-1.0 / -2.0 …）—— 注意厂商卡尔曼版原码的默认值本就是 -4，
    所以负值是正常取值域（我们的 0x24 范围校验允许 ±20）。
    判据（一次 1 度）：0.0 比 1.0 减轻 ⇒ 继续 -1.0；加重 ⇒ 回到 1.0 附近微调（1.5 / 0.5）。
    其余出厂值不变：Balance 300/1、Velocity -80/-0.4、Turn 0/0。
    验证：make strict 0 条；一键核验 9 项全通过。
2026-10-15 C-P3：巡检可视化与任务控制（commands/keepalive/patrol_panel + 操作员动作留档）
    domain/commands：下行数据段唯一出处（0x20/0x21/0x22/0x23/0x24/0x2F/0x1F），带 int16/uint16 钳位（回绕会把'全速前进'变成'后退'）、ppm×10 换算、0x24 float32 小端且拒绝 NaN/Inf、安全影响分类（0x2F 锁存 / 0x20·0x21 可能解除锁存）。domain/keepalive：保活引擎（默认心跳 0x1F·200 ms，链路不通不发，打开/链路恢复立刻发第一条，失败不计入已发）。ui/panels/patrol_panel：阶段时间轴（故障单列红牌）+ 任务下发(0x21)/急停(0x2F)/重下任务解除锁存 + 保活控制（使能模式红字告警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
2026-10-15 Zhongzhi 0.0 → 0.5（用"夹逼"定位最佳值）
    实测序列：
    1.0 → 持续向后漂
    0.0 → 变为向前倾（越过最佳点）
    ⇒ 最佳值落在 (0.0, 1.0) 之间，取中点 0.5。
    机理印证：重心偏后 ⇒ 车需保持一个"前倾角"才能让重心落到轮轴正上方，
    而固件的控制目标就是"倾角收敛到 Zhongzhi" ⇒ Zhongzhi 就是那个前倾角。
    0.0 时前倾过度、1.0 时不足，正是"重心偏后约 0.5°"的量化表现。
    后续（若 0.5 仍略有偏差）：按 0.1° 步长细调（0.4 / 0.6 …）——
    Zhongzhi 是 float、遥测 0.01° 分辨率，够细。
    参考：厂商卡尔曼版原码默认 Zhongzhi = -4（负值属正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
2026-10-15 ★★ 找到"漂移治不好"的真因：速度环一直被调试开关强制关闭
    0x16 日志（38 帧）证据：
    · **Vel = 0 全部帧** ⇒ 速度环在运行期**输出恒 0**；
    · 启动顺序显示：`CFG_DEBUG_PARAM_OVERRIDE`（设 Vel=-80/-0.4）**在前**，
    而 `CFG_DEBUG_DISABLE_VELOCITY`（把 Vel 清 0）**在后** ⇒ **后者把前者覆盖掉**。
    ⇒ 从 5a01035 起，速度环**从未真正运行**；"向后漂"从来没有位置环在管。
    ⇒ 这也是"调 Zhongzhi 忽前忽后"的原因：没有位置环时，车只能在角度上平衡，
    漂向哪边受地面微斜/轮胎打滑影响，与 Zhongzhi 无稳定关系。
    修：CFG_DEBUG_DISABLE_VELO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
2026-10-15 文档整合：B 部分收工（2026-10-15）
    固件侧（本次的重点）：
    · 真机联调问题清单 新增 §8「B 部分收工」：出厂参数定稿表、方向/极性软件补偿表、
    三个"看不见的正确性问题"的 现象→真因→修法（缺 app_config.h / 裸 if 未加花括号 /
    启动期多段覆盖后者胜）、"把中间量上报出来"的方法论（0x15/0x16）、遗留待办 5 条。
    · 程序说明文档 新增「附 A. 出厂参数与调试开关（定稿）」：生效链路顺序、
    CFG_OVR_* 出厂值表、方向开关表、现场判据（复现验收用）。
    · firmware/README.md 新增「B 部分收工状态」：最终参数、开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
2026-10-15 新增《给 C 侧：固件接口与判读口径》（B→C 接口交接，2026-10-15）
    用户要求"整理一下"：把 B 部分收工后的接口语义与判读口径整理成一份可直接交给 C 侧的文档。
    内容：
    1. 固件版本识别（0x16 偏移 19 = (月<<4)|日 = 0xAF）—— 排查"版本不符"的唯一可靠手段；
    2. 0x15/0x16 字段表 + **判读口径**，含三个"一眼定位故障"的组合：
    Turn=0 而 moto1≠moto2（差速/极性 bug）、|moto| 大而 ccr=0（算了没执行）、CCR 贴顶（限幅越界）；
    并注明当前 0x16 的 moto 是"翻向后"的值（B 侧待办）；
    3. 下行语义：**0x24 允许负值**（本机正确值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
2026-10-15 C-P4：调参与记录（0x24 全流程 + CSV/SQLite 记录回放）+ 按 B 侧接口文档对齐真机口径
    domain：0x24 回显解析（PidTuneData + decodePidTune，含扩展 ID 回执）、LoopData 增加 executionState()（算了没执行要分'保护中/真故障'）与 differentialWithoutTurn()、电池'有没有电池'6V 门槛与低压解除线 11.6V、PWM 千分比范围判据。data/param_store：7 个 PID 参数定义（范围按 B 侧口径改为允许负值：Velocity ±500/±0.82、Turn ±500/±10，默认值填本机定稿 −80/−0.4/0.5/0/0）、下发前校验、下发↔回读配对与不一致留痕、巡检参数账本。data/recorder：CsvRecorder（42 列自描述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
2026-10-15 C-P5：一键打包（便携目录 37.4 MB）+ 三份交付文档 + 文档断链检查工具
    打包：host/package.ps1 —— Release 树（host.exe 3.2 MB，Debug 树 41.5 MB）→ windeployqt → 瘦身（109 → 37.4 MB，删 D3D12/D3D11 着色器编译器、QML/Network/SVG、多余 SQL 驱动、图片格式插件，删一项验一项）→ **干净 PATH（Qt/MinGW 全部移除）下四项校验**：① 无头自检退出码 0 ② 界面真起来 4 s 不异常退出 ③ 截图链路 PNG 落盘 ④ 录制链路 CSV 1900 行 + **SQLite 会话库 20 KB**。产出 host/dist/上位机/ 12 文件。main.cpp 新增 --db（指定会话库位置，便携/U 盘用法）；.gitignore 增加 host/bui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
2026-10-15 以已烧录固件为准：修正超声距离单位（mm，C 侧原放大 10 倍）+ 参数范围/锁存/0x22 等口径，并按代码更正协议与接口文档
    【审计】对 firmware/App 全量核对代码 vs 文档，确认 8 处文档错/缺失并逐条更正（详见 docs/protocol/communication_protocol.md §3.9 与 docs/handoff/给C侧_固件接口与判读口径.md）。\n【最要紧的发现】Velocity_Kp/Ki 的编译期定稿值 −80/−0.4 一直被**参数范围校验拒绝**（param_store.c 的 s_range 下限写成 0.0f ⇒ SetOne 返回 -2 且调用处 (void) 未查）⇒ 实际生效一直是默认 +80/+0.4，与真机 --probe-readback 读数完全一致；先前'Flash 旧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
2026-10-15 AGENTS 铁律 43 补第⑤条：别用睡固定秒数判定外部进程完成（同一轮打包里假失败两次）
2026-10-15 清理：删除被误提交的临时录制产物（t_rec.csv/db，来自一次手工调试）
2026-10-16 探测/自检输出增加气体两路的 ADC 原始值（判断传感器是否真的在测的铁证；与 OLED 同源）
2026-10-16 让 MQ-135 真的是 MQ-135：固件按台架现状指派「气体角色 ↔ 座」，上位机/文档同步
    问题：台架只有 MQ-135 模块，物理插在 J13（板上丝印是 MQ-2 座），J10 空 —— 于是上位机/OLED 上'M0-135'那路一直是 0，而真传感器的数据出现在'MQ-2'那路（张冠李戴）。\n改法（先核实再改）：① 两个座的分压网络完全相同（R10/R11 = R12/R13 = 10k/15k ⇒ ×0.600、满量程 3.00 V）⇒ 软件按角色取哪一路**不需要任何标度补偿**；② 算法层本来就分 Gas_DefaultCfg_MQ2/MQ135（清洁空气比值 9.83/3.6 + 各自曲线）⇒ 只需换'哪一路 ADC 喂给哪一路气体'。所以在 App/Senso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
2026-10-16 修遥控（按住必须 10 Hz 重发，否则撞固件 500ms 看门狗）+ PWM 改成带符号估算占空比（负值不报警）
    【遥控：真 bug】上位机原来'按下只发一条 0x20'，而固件对 0x20 有 CFG_MOTION_TIMEOUT_MS=500 的看门狗（app_tasks.c:624 超时清方向标志）⇒ 现象'按一下车只动半秒'，用户报'遥控不行'。修法：新增 startMotion/stopMotion + 100 ms(10 Hz) 重发定时器（协议本来就规定 0x20 是 10 Hz），松手立即发 enable=0；顺带把方向按钮设为 NoFocus，避免点过按钮后 W/A/S/D 不再送到面板。\n【PWM 显示：真 bug】0x11 偏移 4 实为**带符号电机输出均值**（±8200，真机 −157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
2026-10-16 解放转圈（启用转向环）+ 提高前进档 + 修全屏裁切（窗口自适应屏幕 + 每页可滚动）
    【转向：启用】根因是 CFG_OVR_TURN_KP/KD=0（B 为避开'原地转圈'把转向环关了），而那次转圈的真因是裸 if 缺花括号（已修，铁律 37）⇒ 恢复厂商默认 52/0.5；现在也能在上位机调参页用 0x24 在线调（±500），嫌猛嫌弱直接调不必重烧。⚠ 更正我先前说错的一条：Turn_Kd 并非硬编码无效 —— control.c:264 是 if(Flag_Qian||Flag_Hou) Kd=Turn_Kd; else Kd=0;，原地转向时有意不用陀螺仪纠正，前后运动中转向才用 D 项。\n【前进速度】Target_Velocity 110 → 150（Movement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
2026-10-16 修回深色背景：滚动区 viewport/页面显式定色（原生样式下不再露白底）+ 记录铁律 44
    现象：用户报「背景变白、浅字看不清」，而我的离屏截图完全正常。
    复现命令：host.exe --shot x.png -style windows
    —— 原生 Windows 样式 + 浅色系统调色板下，页面底变浅灰而卡片仍深色，
    文字（我设的浅灰 #E6E9ED）几乎不可见。
    根因：把每页套进 QScrollArea 之后，**滚动区里的页面与它的 viewport 都是裸 QWidget**，
    而 QSS 只给 QStackedWidget/QScrollArea 定了底色 ⇒ 原生样式下这两个裸 QWidget
    去用系统调色板（浅色主题 = 白底）。main.cpp 里虽然已 setStyl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
2026-10-16 固件上报左右倾角/角速度 + 界面文案精简（1366×768 全屏不再需要滚动条）
    【固件：0x10 的 roll / gy 不再写死 0】
    用户反馈"左右倾角还是不行"。查清：app_tasks.c 两个填充点都写着 pose.roll = 0;
    pose.yaw = 0; pose.gy = 0 —— 不是上位机不显示，是固件根本没上报。
    轴向怎么定的（有硬证据，不是猜）：厂商 Read_DMP 只算 Pitch/Roll 两个角
    （MPU6050.c:312-313，没有偏航角），而本工程把 Angle_Balance = -Roll 当平衡角
    （control.c:408）。两轮平衡车**不可能**靠"左右倒"保持平衡 ⇒ Roll 必是前后倾、
    正交的 Pitch 即左右倾；角速度同轴映射：前后 = -g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
2026-10-16 加"固件特性位"，让"板上到底是哪版固件"一眼可判（本项目为此猜过一轮）
    背景：同一天可能有多次构建（MQ-135 角色指派 → 转向环/提速 → 左右倾角上报），
    而 CFG_FW_BUILD_ID 只能表达到"日"（0xAF = 10-15）⇒ 现场无法分辨板子上跑的是哪一版。
    结果：用户报"遥控不行 / 左右倾角还是不行 / 转向没反应"，我一度只能猜是不是没烧进去。
    实机判据（新增后测得）：0x16 状态位 bit3 = 0 ⇒ 板上是旧构建（只含 MQ-135 角色指派那次，
    不含转向环/提速/左右倾角）—— 三个现象因此全部说得通：左右倾角 0（写死）、Turn 0
    （Turn_Kp=0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
2026-10-16 左右倾角改走加速度计（DMP 路径在卡尔曼模式下从不执行）+ 界面文字按用户要求删干净
    【左右倾角：真因确定（实测 + 代码双证据）】
    用户烧的确实是最新固件（0x16 状态位 bit3=1，我先前读到 0 是烧之前的旧数据，已更正）。
    但"横滚"仍恒 0.00 —— 真因：main.c:8 `Way_Angle = 2`（卡尔曼），而 Get_Angle() 里
    **只有 way==1 才会调用 Read_DMP()** ⇒ DMP 输出的 Pitch/Roll/gyro[]/accel[] **从不更新、恒 0**。
    我最初按"车靠 -Roll 平衡 ⇒ Pitch 是左右倾"的推理取了 Pitch：方向对，但**取不到值**。
    改法（与 Way_Angle 无关，任何算法下都有效）：
    ·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
2026-10-16 收尾整合：全仓库文档与最终代码对齐（含 6 处会讲错的结论）+ 补平衡参数整定步骤
    本轮只改文档（14 个文件），目的：让"文档说的"与"已烧录/已交付的代码"完全一致，
    并补上现场真正需要的操作步骤。**全部为同步与补充，不改任何代码逻辑。**
    【一、更正 6 处与最终代码不一致的实质结论（不改会讲错）】
    1. docs/protocol/communication_protocol.md 的 0x10 行：原先写"横滚填四元数 Pitch"
    —— 那是中途方案；真因是本机 Way_Angle=2（卡尔曼）时 Get_Angle() 的 DMP 分支
    从不执行、DMP 的 Pitch/Roll 恒 0。现改为：横滚/左右倾角取**加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
2026-10-16 A1 交付物留档：Gerber(脱敏)/全套制造数据/实物照片/真机测试记录/采购记录 + 文档同步
    - hardware/gerber/：下单 Gerber 的脱敏版（GTO 姓名笔画已移除，逐行比对 2730 行一致）+ 工艺参数(1.6mm/1oz/有铅喷锡) + 隐私处理登记表
    - hardware/eda_export_20261016/：EDA 一次性导出 13 件（原理图 PDF/PNG/SVG、PCB 出图、Gerber、STEP、DXF、iBOM、坐标、网表、IPC-356A、epro2）
    - hardware/photos/：新版底板 4 张（丝印姓名块已打码，打码区坐标可复核）
    - hardware/test_records/：tune.py/host.exe 真机原始输出与观测 CSV（含一次无效数据反例）
    - hardware/bom/：立创商城实际采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
2026-10-16 B(程序)报告用流程图：新增纯 PIL 绘制工具 + 7 张图（替代 ASCII 流程图）
    - tools/gen_flowcharts.py：方框 / 圆角框 / 菱形判断 / 折线箭头，只用黑体+宋体，不依赖 graphviz
    - docs/design_firmware/图/：软件分层与任务划分、上电初始化、控制中断（5/10 ms 分支）、通信收发、
    气体采集与研判、巡检状态机迁移、解帧状态机
    - 程序说明文档 §4 每小节接入对应流程图（原 ASCII 流程图保留作文字版对照），并补 §4.6 解帧状态机
    - 同步更正 §11 的过期结论：USE_RTOS=0 裸机对照此前记的"编不过"已不再复现，
    实测 make USE_RTOS=0 可编可通过（Flash 4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
2026-10-16 工具与上位机修复：观测期间保活（避免把车探停）、振荡统计口径、回读判据表
    - tools/fw_prep/tune.py：新增 --keepalive（每 200 ms 发 0x1F 心跳：保活但不解锁）与
    --enable（每 100 ms 发 0x20 使能=1 零速度：保活并解除安全锁存）；两者都不加时打印警告。
    根因：固件规定 500 ms 无下行帧即安全锁存，而 --observe 中途不发帧，会把正在平衡的车探停，
    工具却照常输出"姿态统计"，采到的是电机已停的数据（真机实测踩到）
    - tune.py：振荡统计由"一阶差分乘积<0 数局部极值"（0x10/0x11 同频、相邻样点重复时乘积恒为 0，
    永远数出 0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
2026-10-16 C（上位机）审校：5 处事实错误 + 界面文案严谨精简 + 控制台编码统一
    事实错误（已用实测/协议原文核准）：
    - 界面把 0x12 标成 5 Hz（overview/patrol 两处），与协议 §三③ 及软件设计说明「与 0x10/0x11 同频（20 Hz）」矛盾
    - 参数说明里 Turn_Kp 写「定稿 0 / 未启用转向环」，与决策 78 已启用的 52/0.5 矛盾
    - host/README 用例分解（链路 8 + 界面 11 + 告警 13 + 命令 13 + 记录 13）与实测 92 项不符
    - 软件设计说明 §2/§5.2/§5.4 写「链路 8 项、data 12 项」，实测为 9 / 14
    - host/README 的 P1 验收仍写 ctest 4/4，已注明现为 7/7
    界面文案（抽出 143 处真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
2026-10-16 C（系统）交付物补齐：提交包 + 交接口径同步
    - 提交包（仓库外，<组长姓名>+<项目名称>\C_上位机\）：软件设计说明 19 页（docx/pdf/md）、
    用户操作手册 15 页（docx/pdf/md）、上位机程序工程（五层源码 + 7 套件单测 + 打包脚本 + QCustomPlot）、
    免装 Qt 便携版（12 文件 / 37.4 MB）、界面截图 6 张、测试与验证记录（ctest 92 项 / 离线自检 / 真机只读探测 / 打包四项校验）
    - 报告与手册沿用与 A1/B 同一套格式要求（黑体标题、宋体正文小四、表格小四、可跳转目录、页脚页码、仅三种字体）
    - 附录 C 的用例清单由测试二进制 -functions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
2026-10-16 A2 开工支持：离线导出机械接口数据（板框/孔位/52 器件坐标）
    - 新增 tools/mech_export.py：直接解析完工快照 PCB2.epcb2，输出板框 100.00×65.00 mm、
    四角 R5.0、3×⌀3.2 安装孔 @ (6.00,6.10)/(94.00,6.10)/(6.00,58.91)（原点=板左下角），
    以及全部 52 个器件的中心坐标与旋转 —— 与 A1《上板测试记录》§5 的五路互证值完全一致
    - 特点：**不需要打开 EDA**（离线），A2 画外壳/装配图时随时可复跑、可复核
    - tools/README.md 补该行；删除此前试写的半成品 tools/eda_mech_export.js（板框点解析不完整）
    - 坐标表与图纸清单（_A2审阅/）在仓库外：A2_需要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
2026-10-16 mech_export.py 支持指定 .epcb2 路径（可用于厂商原板 PCB1 的孔位对照）
    - 用法：python tools/mech_export.py [<某个 .epcb2>]（默认仍是完工快照 PCB2.epcb2）
    - 用途：A2 画结构时不必猜底盘固定孔位 —— 我们的板是厂商原板 PCB1 的改板，
    PCB1 的孔位即底盘柱位：4×Φ3.2 @ (6.00,6.10)/(94.00,6.10)/(6.00,58.91)/(94.00,58.91)，
    板框两边一致（100.00×65.00、R5.0）；改板只保留了其中 3 个（右上角让给气体座区）
2026-10-16 新增离线 3D 工具链：读 IGES/STEP/STL、量尺寸、检孔位、出视图（A2 用，无需装 CAD）
    - tools/mesh_tools.py：STL/OBJ/PLY/GLB/STEP 读入（单位自适应、保留分件）→
    info（尺寸/体积/水密/分件/孔位）、render（等轴测+三视图）、holes、check（与主板 3 孔对齐/干涉）、drawing（零件图 PDF）
    - tools/iges_read.py：IGES/STEP 实体清单与曲面细分导出（OpenCASCADE/OCP）；
    纯曲面 IGES（SOLID 0）会明确报出"不能打印/不能干涉检查"
    - 依赖：trimesh / cascadio / manifold3d / ezdxf / matplotlib / shapely / rtree（pip 安装，已实测可用）
    - 实测：本项目 3D_PCB2 STEP 读到 53 个零件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
2026-10-16 A2 外壳起点件：基于本组 PCB 3D 自动生成（下壳 + 上壳毛坯）
    - tools/a2_shell_starter.py：按坐标表 + PCB 3D 生成壳体（STEP/STL），参数集中在文件顶部
    - tools/mesh_tools.py 修三处关键 bug：
    ① STEP 场景变换按 graph.nodes_geometry 逐节点取（原按 geometry 字典顺序配 T 会错位，
    表现为"多数零件停在原点、中心坐标全是 (0,0)"，曾据此误判 STEP 是别的板）
    ② 新增 find_board()：按几何特征（XY 最大 / Z 最薄）认主板，不依赖零件名
    ③ detect_holes 返回元组后，cmd_info/cmd_check/cmd_drawing 三处调用同步解包
    - tools/iges_read.py：三角面按面 Orientation 翻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
2026-10-16 新增 tools/step_intake.py：外来 STEP/IGES 一条命令出「体检 + 对照」报告
    - 控制台：零件清单（尺寸/体积/水密）、壳体类中位壁厚、板类件孔位与跨距、
    与**我们板**（100×65、3×Φ3.2、跨距 88.00/52.81/102.63）的自动对照；
    曲面模型（不水密 + 体积为负）会明确提示"不是实体，不能打印/布尔校验"
    - 同时输出 <前缀>_四视图.png 与 <前缀>_摘要.json（机器可读，便于后续脚本直接吃）
    - 用途：对方把 SolidWorks 工程转成 STEP 后，到手即可一次性给出全部结论
    - 自检：本项目 3D_PCB2 STEP 跑通（53 零件；板 99.97×64.97×1.60）
2026-10-17 A2 外壳 v2：补全装配结构（M3 外凸耳 / 加强筋 / 走线孔 / 顶部通气），壁厚按参考件标定
    - tools/a2_shell.py（v2，取代 a2_shell_starter.py 的作用）：
    ① 上下壳可对拧：下壳 4 个 M3 外凸耳（Φ7 / Φ2.7 自攻预孔），上壳对应 Φ3.4 通孔
    ★ 凸耳中心取"角点内侧 1.7 mm"：Φ7 圆与板 R5 圆角恰好外切（留 0.41 mm），
    同时切进壳壁 ⇒ 与壳一体、与板不干涉、打印免支撑
    ② 加强筋（下壳底面 / 上壳顶面内侧） ③ 底面 Φ8 走线孔 ④ 顶部通气栅格（气体传感器正上方）
    ⑤ 壁厚 2.0 → 2.4 mm（依据：参考件壳类件中位壁厚实测 2.38/2.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
2026-10-17 A2 外壳 v3 + 整车：按用户给定空间要求落值，并接入参考件电机/电池
    - 空间要求（已逐项校核，数据见 A2_空间确认.json 与 A2_空间确认_三项.md）：
    · 板面向上：内腔 36.5 ⇒ 顶面加强筋下净高恰 35.0（其余 36.5），满足"处处 ≥35"
    · 向下：板下净空 6.6（板底器件 5.6+1.0），壳底到车底盘 M3 铜柱 25.0（四角凸耳 Φ3.2 通孔）
    · 超声波 J5：上下壳同尺寸口袋 20（左右）×15（前后）；CN1/CN2 取消顶墙开口（电机线走腔内→底面 Φ8 走线孔）
    · OLED：控制板 J1/J2 之间上半部分（板坐标 48~96×29~65）不设加强筋（截面实测筋在 y=34.4 截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
2026-10-17 修正整车布局：轮轴沿 Y、两轮在左右两侧（原错放在前后两端，轮子穿进底盘板）
    - 依据参考件数据反推：`底盘+双轮` 包络 181 × 68.8 × 65.4 ⇒ 68.8 = 两轮外宽、65.4 = 轮径、轮轴沿 Y，
    两轮应在 ±Y 两侧、底盘板夹于两轮之间 —— 原先按 ±X 摆放，导致 ⌀67 轮（半径 33.5）与底盘板在 X 向重叠
    - 新布局：底盘板 150×80×4（含左右电机凸台）+ 轮 Φ67×26 于 y=-13.5 / y=89.3（内侧面贴壳侧外）
    + 参考电机坐在凸台上、轴朝外（±Y）+ 电池居中 + M3 铜柱 25×4
    - 整车包络 150 × 136.8 × 109.5（X/Y/Z），轮底 z=-69.0、壳顶 z=+40.5
    - 明细栏与《A2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
2026-10-17 再修正：轮子装到窄侧（两条 65 mm 边）——两轮共轴、轴向沿 X
    - 用户指正："轮子应该在小车的窄侧"；前一版把两轮放在 ±Y（长边外侧），方向错
    - 现布局：两轮装在 ±X 两端（窄侧）、共轴、轴向沿 X ⇒ 前进方向沿 Y；
    底盘板 110×116×4（X 向夹在两轮之间、Y 向加长承托电池）；电机坐在左右凸台上、轴朝外（±X）；电池沿 Y 摆
    - 整车包络 171.8 × 116.0 × 109.5，轮底 z=-69.0、壳顶 z=+40.5
    - 明细栏与《A2_空间确认_三项.md》同步更新
2026-10-17 新增 tools/a2_car_step.py：整车导出为 STEP（真 B-rep，供云 CAD / SolidWorks 打开）
    - 组装内容：本组下壳/上壳（读 STEP）+ 本组主控板（读 PCB 3D STEP，按 (x+11.4, y+64.3) 平移到壳坐标）
    + 参考件电机 ×2（居中后按轴朝 ±X 就位）+ 电池（参考件为曲面，改按包络 94.5×28.5×13.2 建实体盒）
    + 参数化件：底盘板 110×116×4、车轮 Φ67×26 ×2、M3 铜柱 25 ×4
    - 合成方式用 **TopoDS_Compound**（不做布尔，避免 149 个器件实体的布尔运算与失效）
    - 两个产物：
    · A2-10_整车.step 169 实体 / 133.6 MB（含 149 个板载器件细节）
    · A2-10_整车_轻量.step 22 实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
2026-10-17 整车 STEP 增加「装配」格式：XCAF 带零件名与颜色（云 CAD / SolidWorks 可直接看到装配树）
    - tools/a2_car_step.py 增 --xcaf：用 TDocStd_Document + XCAFDoc_ShapeTool/ColorTool + STEPCAFControl_Writer
    写 AP214 装配，零件名走 ASCII（下壳 → lower_shell 等，README §6 有中英对照表）
    - 产物：A2-10_整车_装配_轻量.step（14 件 / 1.2 MB，带名字与颜色）
    A2-10_整车_装配_完整.step（13 件 / 134 MB，含板上 149 器件）
    另有单件多实体版 A2-10_整车[_轻量].step（22 / 169 实体）
    - 校验：回读 STEP 文本，PRODUCT 条目 14 个，名字为 lower_shell/upper_shell/pcb_board_outline/
    ctrl_bo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
2026-10-17 新增 tools/sw_com.ps1：SolidWorks COM 封装（统一动词 + 护栏）
    - 动词：info / open / mass / export / close
    - 护栏：优先附加已运行实例（不新起进程、不抢界面与许可）；一律不保存；只关自己打开的文档
    - 现状（2026-10-17，本机 SW 2026 SP04.1 已激活）：COM 暂不可达
    · PowerShell 7 已移除 Marshal.GetActiveObject（.NET 5+）⇒ 必须用 powershell.exe 5.1 附加
    · PS 5.1 的 GetActiveObject 与 New-Object -ComObject 均返回 0x8002802B（TYPE_E_ELEMENTNOTFOUND）
    · 现象：ROT 里找不到 SldWorks.Application；疑似有粘在对话框里的旧实例占着单实例互斥（12:27:53 那个是我早前中断的测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
2026-10-17 A2 结构进展与待办（新增 docs/design_mechanical/）
    - 汇总 A2 已完成项（外壳 B-rep 实体 / 装配结构 / 立墙开孔 / 超声波口袋 20×15 / OLED 预留区 /
    板面向上 35 mm、铜柱 25 mm / 整车装配）与关键接口口径（原点=板左下角、板面 z=0、板 100×65、3×Φ3.2 跨距 88.00×52.81）
    - 列出待办 6 项（控制板叠层实测→回填内腔高、上壳开窗、外观造型、总装图、打印试装、交付物整理）
    - 声明工具偏差：A2 侧用 OpenCASCADE 离线几何 + 标准 STEP，需在结构设计说明中写明
2026-10-17 A2 补全：孔位试印件 + A2 工具章节 + SolidWorks 会话打通
    ① tools/a2_print_coupon.py：打整壳前先打 20 cm³ 的底板段（3 安装柱 + 4 外凸耳 + 内腔轮廓），实测输出跨距 88.00x52.81 / 107.40x72.40；② tools/README 新增「A2 结构工具」整章（含本机两个 Python 坑）；③ A2 进展文档：待办改成带状态的表、补 SolidWorks 会话开启方式；④ 更正凸耳跨距旧值（106.6/71.6 -> 107.40/72.40）
2026-10-17 A2 修正：装配 STEP 真的长出装配树 + 外壳装配不再是布尔并成一个实体
    ① 新增 tools/step_assembly.py：复合体 -> AddShape(makeAssembly=True) -> 逐组件 GetReferredShape 命名，才写出 NAUO；自带 selftest（按 STEP 文本断言 PRODUCT=件数+1 / NAUO=件数）。旧写法 AddShape(shape,False) 只加自由件，NAUO=0，打开看不到装配树。② a2_shell.py 的外壳装配由 fuse(下壳,上壳) 改成真装配（PRODUCT 3 / NAUO 2 / 实体 2）。③ a2_car_step.py --xcaf 同步改用新写法（PRODUCT 25 / NAUO 24，14 个命名件）。④ 文档补两个名不副实的坑 + 本机 SW 打不开 STEP 的实测边界。
2026-10-17 卸载 SolidWorks 集成后同步文档口径
    - A2 进展 5 改为已卸载：删了哪些目录、留了什么归档、为何不能再用 mcp__solidworks__* 那套启动方式；待办里依赖该通道的条目同步改成无通道/随集成下线。
    - tools/README 8.3 保留「本机 SW 打不开任何 STEP」的实测结论，并注明量的是 SolidWorks 本体、与已卸载的桥无关。
2026-10-17 更正：SW 打不开 STEP 是国内自动化调用的限制，不是安装/文件问题
    实测双击打开：A2-00_外壳装配.step -> 装配（2 组件 upper_shell/lower_shell）；A2-10_整车_装配_轻量.step -> 14 个命名件 + 电机子实体。
    2097152 = swFileRequiresRepairError 只出现在 ISldWorks::OpenDoc6 开外来格式时（连长方体、SW 自己导出的 STEP 也一样）；GUI 走 3D Interconnect 正常，产出 .step.SLDASM/.SLDPRT 链接文档。
    故：A2 进展 7 与 tools/README 8.3 的旧结论（"本机 SW 打不开任何 STEP"）改正，并记下链接文档要断开链接才能编辑/交付。
2026-10-17 A2 归档：SolidWorks 整车装配（SLDASM + 零件版 + STEP）与交付清单
2026-10-17 A2 清理旧壳：删除旧 OCC 外壳与备份，交付清单改为待补文件清单
2026-10-17 A2 渲染：由 STEP 离线出等轴测/四视图/透明底 4 张图
2026-10-17 A2 补：BOM 草表、整机 STL、实体索引、结构设计说明初稿
2026-10-17 A2 补：9 个候选分件 STL（8/9 水密）与分件说明
2026-10-17 A2 按确认收口：上下壳缺失、MiniBalance R1 车架、装配图 PDF、原色六视图入公开仓库
2026-10-17 A2 检查：11 对间隙/干涉（无穿透）+ 箱体分离示意
2026-10-17 交付整理：演示视频、A2 六视图精简、PCB 3D 包络脚本；README 更新为完成状态
2026-10-18 docs: 重写 README 为项目主页；统一课程归属、控制板范围与 MIT 许可
2026-10-18 文档页脚空行修正
2026-10-26 docs: 明确 3D 模型仅为作业要求完成、未验证且不可直接打印
